o7-machinehum/Blackpants/README.md

# Blackpants
The Blackpants are a carrier board for the [Flipper Blackhat](https://github.com/o7-machinehum/flipper-blackhat). They remove the need for the Flipper Zero itself. This repository was forked from the WHY2025 badge.
