o7-machinehum/Blackpants/docs/a523/A523_hwref/原理图/开发板资料/开发板用户指南/A523_EVB开发板用户指南_V1.0.pdf

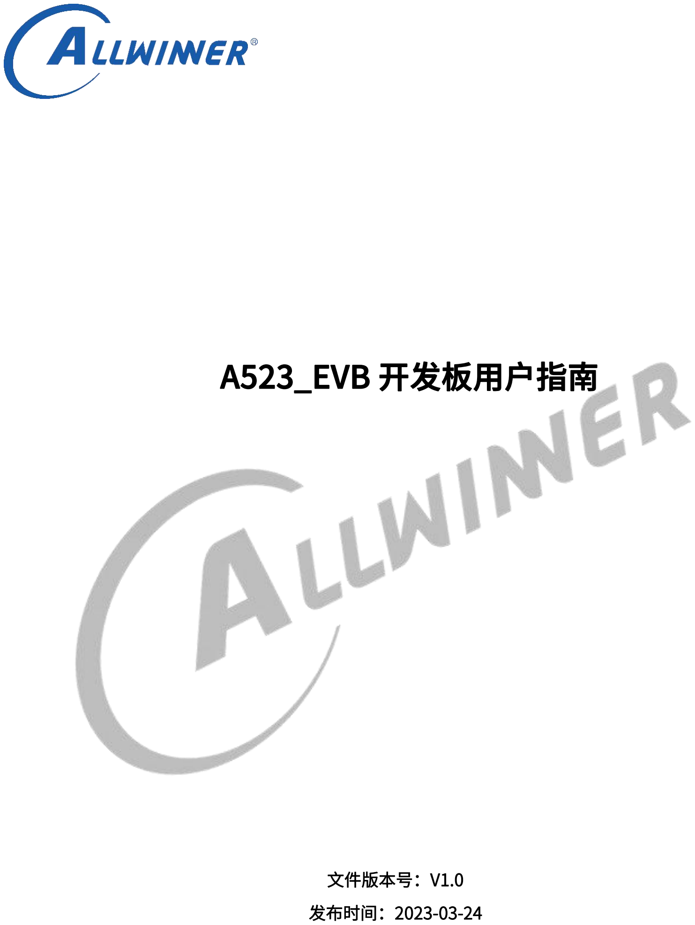
[picture p198: page 1]

# A523_EVB 开发板用户指南

文件版本号：V1.0
发布时间：2023-03-24

文档密级：秘密


版权所有©珠海全志科技股份有限公司。保留一切权利 | i

# 版本历史

版本 | 日期 | 责任人 | 版本描述
1.0 | 2023.3.24 | AW2062 | INIT

密级：秘密

全志科技版权所有，侵权必究
Copyright © 2023 by Allwinner. All rights reserved | Page ii of 42

目录

Copyright © 2023 by Allwinner. All rights reserved | Page iii of 42

Copyright © 2023 by Allwinner. All rights reserved | Page iv of 42

# 图片目录

图 3-1 A523_EVB 开发板功能框图 | 10
图 3-2 A523_EVB 电源拓扑结构 | 11
图 3-3 A523_EVB 正反面接口结构图 | 11
图 4-1 5VDC 电源接口 | 18
图 4-2 5V USB 电源接口 | 18
图 4-3 A55 debug 串口接口线序 | 18
图 4-4 CPUS debug 串口接口线序 | 19
图 4-5 BOOT-SEL 启动选择 | 19
图 4-6 BOOT-SEL 电阻位置 | 20
图 4-7 PhonenixSutit 工具 | 20
图 4-8 uboot 按键和 usb | 21
图 4-9 PhoneixCard 工具 | 22
图 4-10 PhoneixCard 工具制作卡量产 | 22
图 4-11 TF 卡接口 | 23
图 4-12 卡量产烧录打印 | 23
图 4-13 flash 接口 | 23
图 4-14 FLASH 接口原理图图示 | 24
图 4-15 FLASH IO 电平更改 | 25
图 4-16 mipi-CSI 接座 | 26
图 4-17 全志 IMX386 摄像头子板接线图 | 26
图 4-18 摄像头子板电源硬件配置 | 27
图 4-19 IMX319 摄像头模组接线图 | 28
图 4-20 S5K5E8YX 摄像头模组接线图 | 29
图 4-21 JV1 接座原理图图示 | 29
图 4-22 JV6 接座原理图图示 | 29
图 4-23 MIPI-DSI 原理图图示 | 31
图 4-24 配套 LCD 屏与开发板接线图 | 31
图 4-25 CTP 原理图图示 | 32
图 4-26 RGB 屏接口 | 32
图 4-27 RGB 接口原理图图示 | 31

Copyright © 2023 by Allwinner. All rights reserved | Page v of 42

Copyright © 2023 by Allwinner. All rights reserved | Page vi of 42

# 图表目录

Copyright © 2023 by Allwinner. All rights reserved | Page vii of 42

# 表格目录

Copyright © 2023 by Allwinner. All rights reserved | Page 8 of 42

# 1 前言

## 1.1 文档简介

本文档主要用于介绍 A523 开发板的硬件结构特点以及接口说明，方便使用者快速了解和入门使用开发板。

## 1.2 目标读者

本文档主要适用于:
- 硬件设计工程师
- 软件设计工程师
- 技术支持工程师

## 1.3 适用范围

软硬件系统设计领域、产品方案设计领域。

## 1.4 文档约定

标志说明
本文档采用各种醒目的标志来表示在操作过程中应该特别注意的地方，这些标志的含义如下：
标识 | 说明
注意 | 提醒操作中应注意的事项。不当的操作可能会损坏器件，影响可靠性、降低性能等。
说明 | 为准确理解文中指令、正确实施操作而提供的补充或强调信息。

Copyright © 2023 by Allwinner. All rights reserved | Page 9 of 42

# 2 概述

### 2.1 简介

A523 开发板是全志科技专门针对 A523 系列多核处理器芯片开发的演示板，用于给客户展示 A523 强大的多 媒体功能和智能视频处理能力，A523 开发板提供了丰富的接口，客户前期亦可以在 A523 开发板上做前期软件 开发工作。A523 开发板同时为客户硬件设计提供参考，客户只需要对 A523 开发板电路进行增减即可完成硬件 设计。

## 2.2 交付清单

A523 开发板硬件基础交付清单包括：
✓ A523 EVB 单板：A523_EVB_AXP717C_LPDDR4_4X_V2_0
✓ 电源：输入 100V~240V AC，输出 5V，2A，DC 或 Type-C 适配器 ✓ 摄像头子板：V5 CARMERA CONVERT BOARD-V163、EF5046FA-V1.0 ✓ 显示屏模组（不带触摸）：SQ101D-LCD 显示屏模组

## 2.3 其他组件

以下组件不包括在 A523 开发板硬件交付包中,但是客户在调试过程中可能会用到,例如: ✓ 网线
✓ 串口线
✓ 音视频输出线材
✓ SD 卡

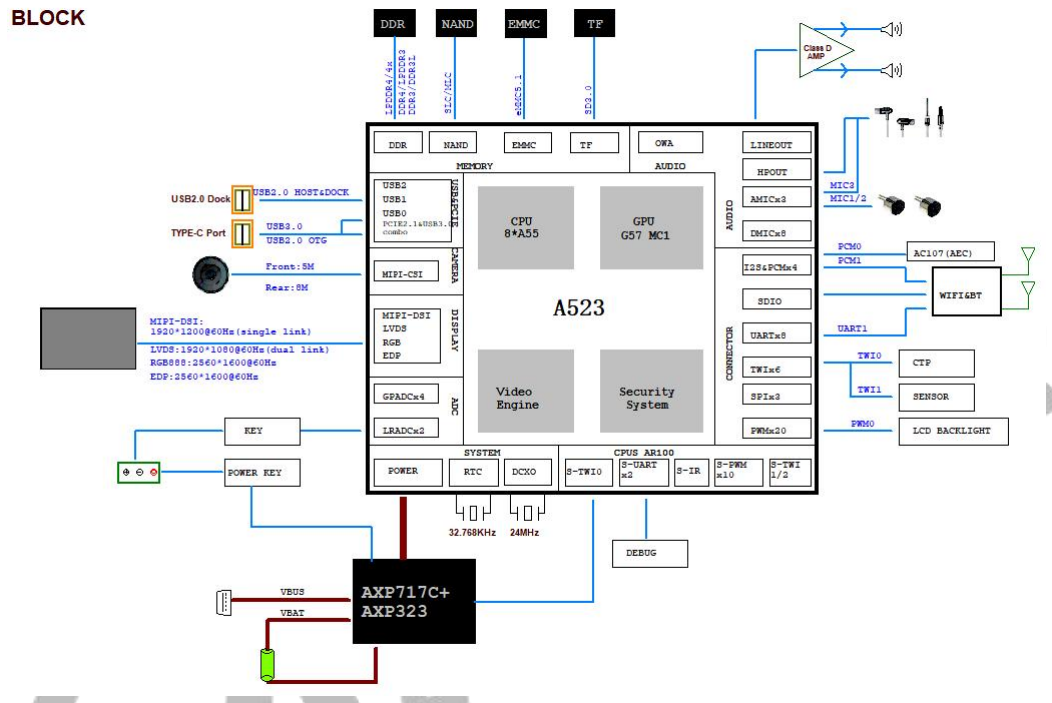
[picture p199: figure]

Copyright © 2023 by Allwinner. All rights reserved | Page 10 of 42

# 3 A523_EVB 开发板硬件介绍

## 3.1 功能框图

A523_EVB 开发板功能框图如图 3-1 所示：
图 3-1 A523_EVB 开发板功能框图

## 3.2 电源拓扑结构

A523_EVB 电源拓扑结构如图 3-2 所示：

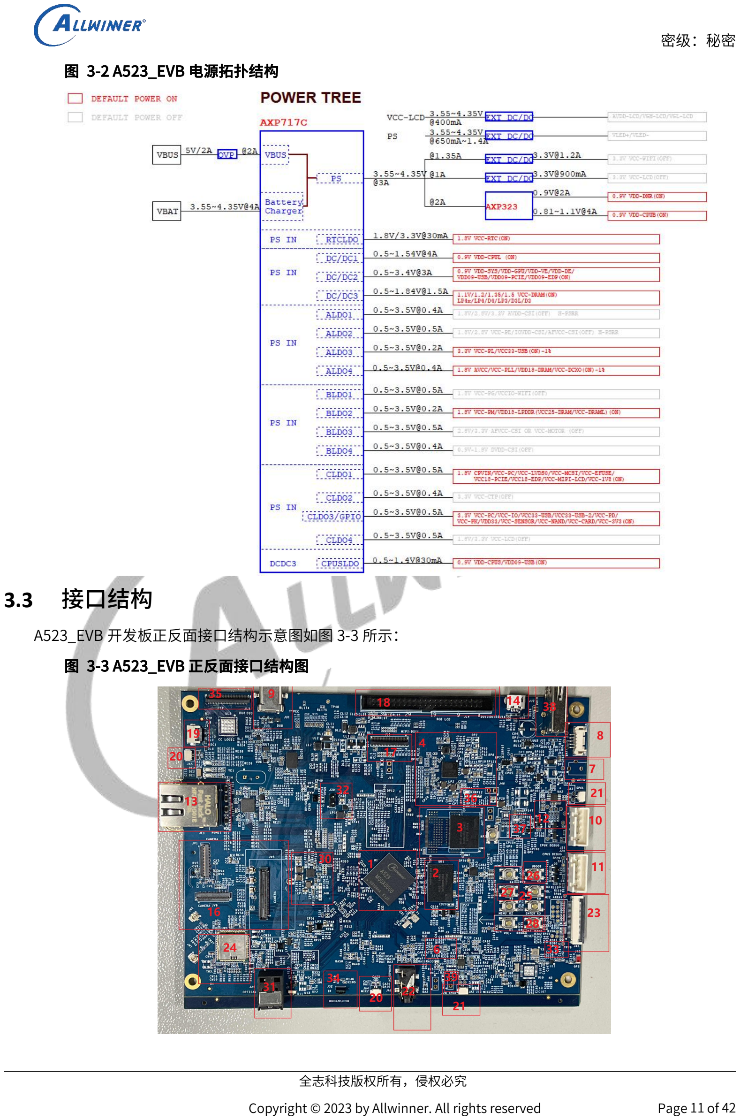
[picture p200: page 12]

Copyright © 2023 by Allwinner. All rights reserved | Page 11 of 42

图 3-2 A523_EVB 电源拓扑结构

## 3.3 接口结构

A523_EVB 开发板正反面接口结构示意图如图 3-3 所示： 图 3-3 A523_EVB 正反面接口结构图

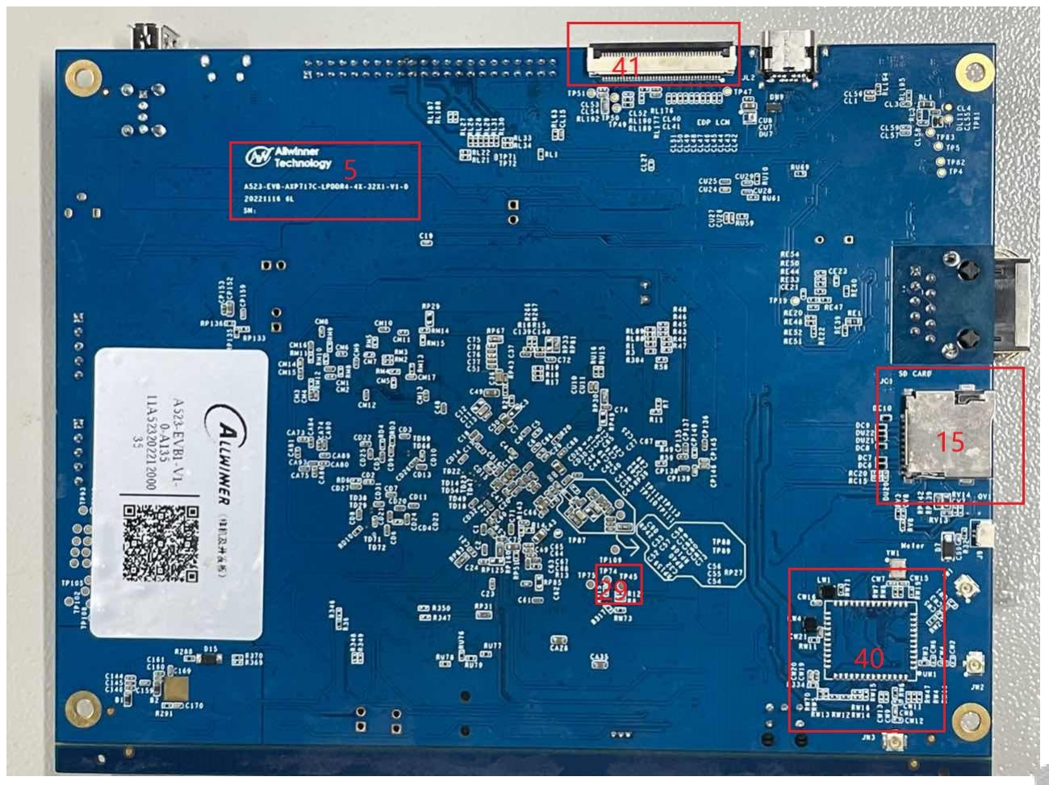
[picture p201: figure]

Copyright © 2023 by Allwinner. All rights reserved | Page 12 of 42

开发板上各接口功能说明如表 3-1 所示：
表格 3-1 A523_EVB 各接口功能说明表
编号 | 说明
1 | SOC 主控 A523 芯片
2 | 16 位 DDR3 颗粒，默认贴 4Gb DDR3
3 | Flash 颗粒，默认贴 GD 256bit SPI NOR
4 | PMU 717C 电源供电区域
5 | 开发板型号丝印以及板编号
6 | G-SENSOR 模块，默认型号 ICM-42670-P
7 | 5V DC 电源接口
8 | 电池接口
9 | TYPE-C 接口，同时可作为 5V 供电接口
10 | UART0，A55 CPUX 调试接口
11 | CPUS 调试接口
12 | JTAG 接口触点(PB 口)
13 | 网口

Copyright © 2023 by Allwinner. All rights reserved | Page 13 of 42
14 | Micro USB 接口
15 | TF 卡接口
16 | MIPI CSI sensor 接口
17 | MIPI DSI LCD 接口
18 | RGB LCD 接口
19 | CTP 接口
20 | 双 MIC
21 | 喇叭接口
22 | LINE-IN 接口
23 | TWI2、CPUS-JTAG、LRADC、DMIC 接口
24 | WIFI 模块(AW869A)
25 | GPADC0 功能按键
26 | UBOOT（FEL）烧录按键
27 | PWRON 按键
28 | RESET 按键
29 | GPADC0~3 接口
30 | AXP323 电源供电区域
31 | OWA 接口
32 | JTAG-SEL 接口
33 | GND 测试接口
34 | IR 接口
35 | 触屏接口
36 | 电源指示灯
37 | 快充指示灯
38 | USBA 接口

## 3.4 GPIO 分配

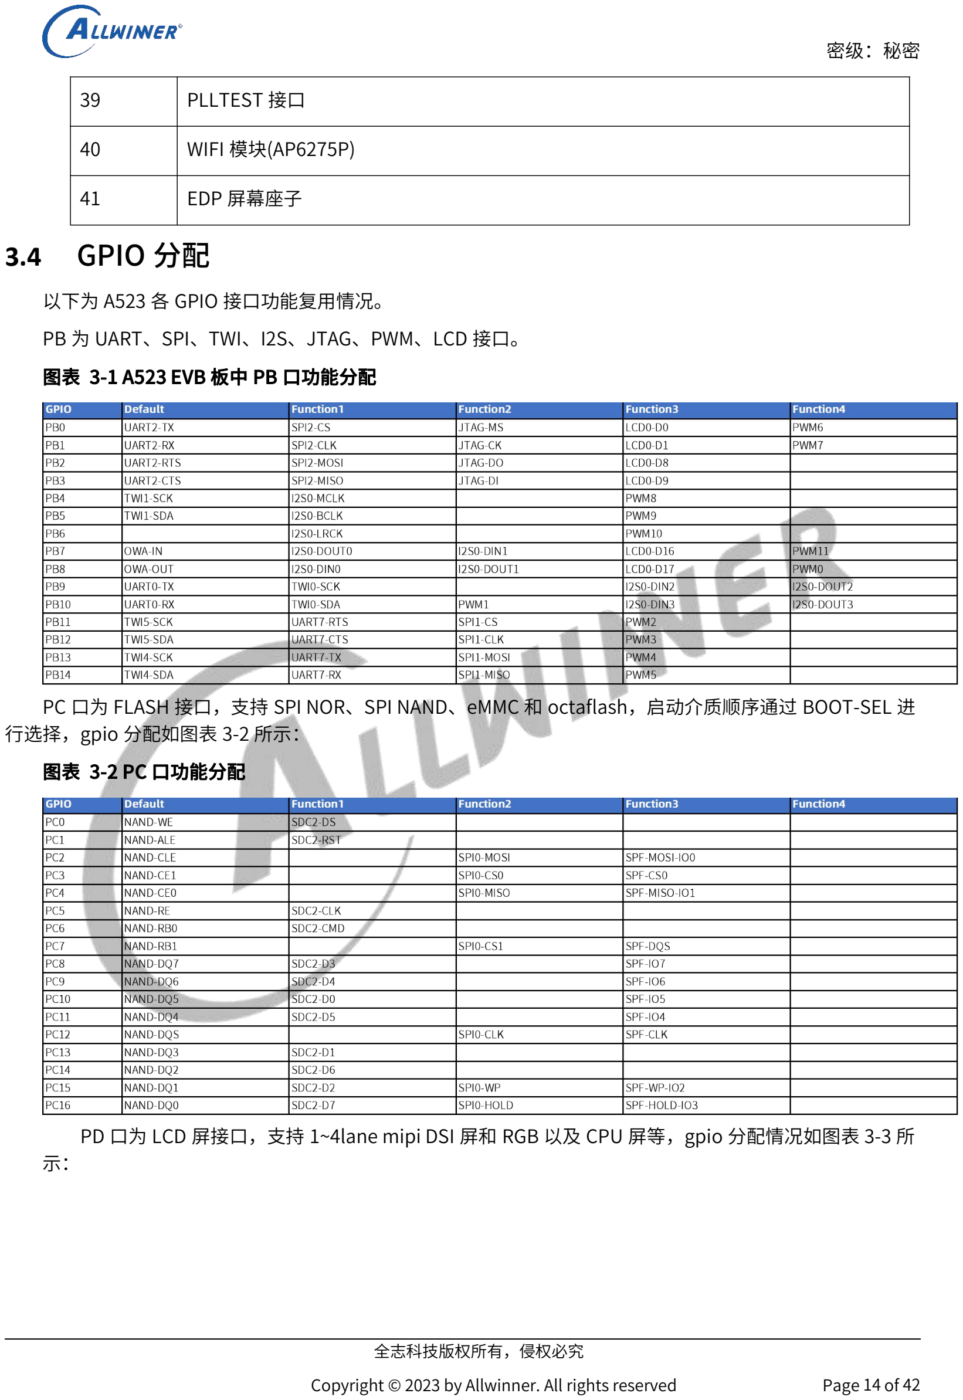
[picture p202: page 15]

Copyright © 2023 by Allwinner. All rights reserved | Page 14 of 42
39 | PLLTEST 接口
40 | WIFI 模块(AP6275P)
41 | EDP 屏幕座子

以下为 A523 各 GPIO 接口功能复用情况。
PB 为 UART、SPI、TWI、I2S、JTAG、PWM、LCD 接口。 图表 3-1 A523 EVB 板中 PB 口功能分配

PC 口为 FLASH 接口，支持 SPI NOR、SPI NAND、eMMC 和 octaflash，启动介质顺序通过 BOOT-SEL 进 行选择，gpio 分配如图表 3-2 所示：
图表 3-2 PC 口功能分配

PD 口为 LCD 屏接口，支持 1~4lane mipi DSI 屏和 RGB 以及 CPU 屏等，gpio 分配情况如图表 3-3 所 示：

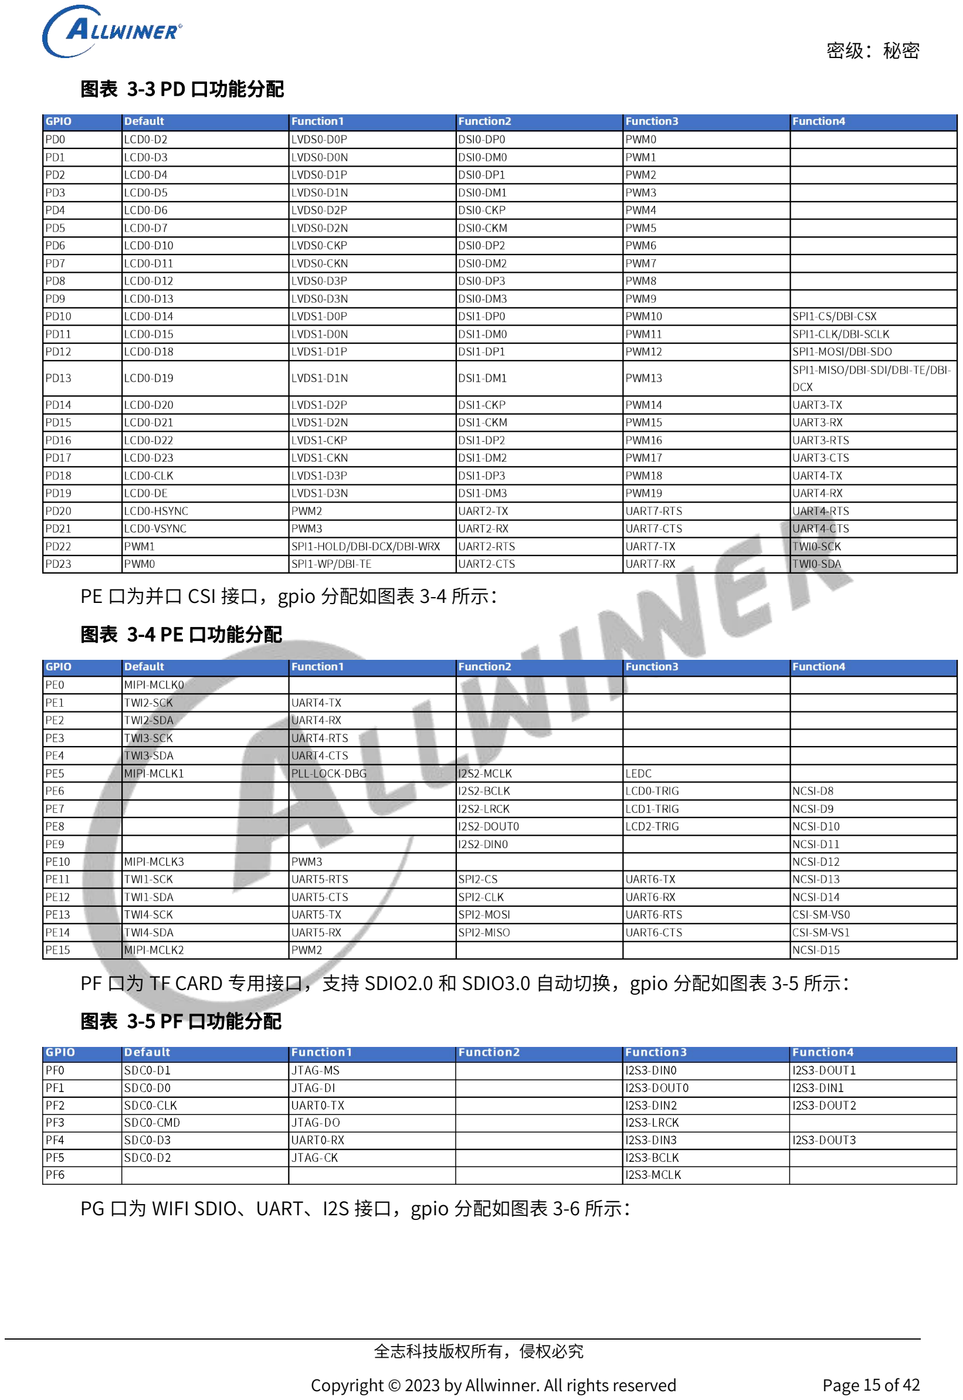
[picture p203: page 16]

Copyright © 2023 by Allwinner. All rights reserved | Page 15 of 42

图表 3-3 PD 口功能分配

PE 口为并口 CSI 接口，gpio 分配如图表 3-4 所示： 图表 3-4 PE 口功能分配

PF 口为 TF CARD 专用接口，支持 SDIO2.0 和 SDIO3.0 自动切换，gpio 分配如图表 3-5 所示： 图表 3-5 PF 口功能分配

PG 口为 WIFI SDIO、UART、I2S 接口，gpio 分配如图表 3-6 所示：

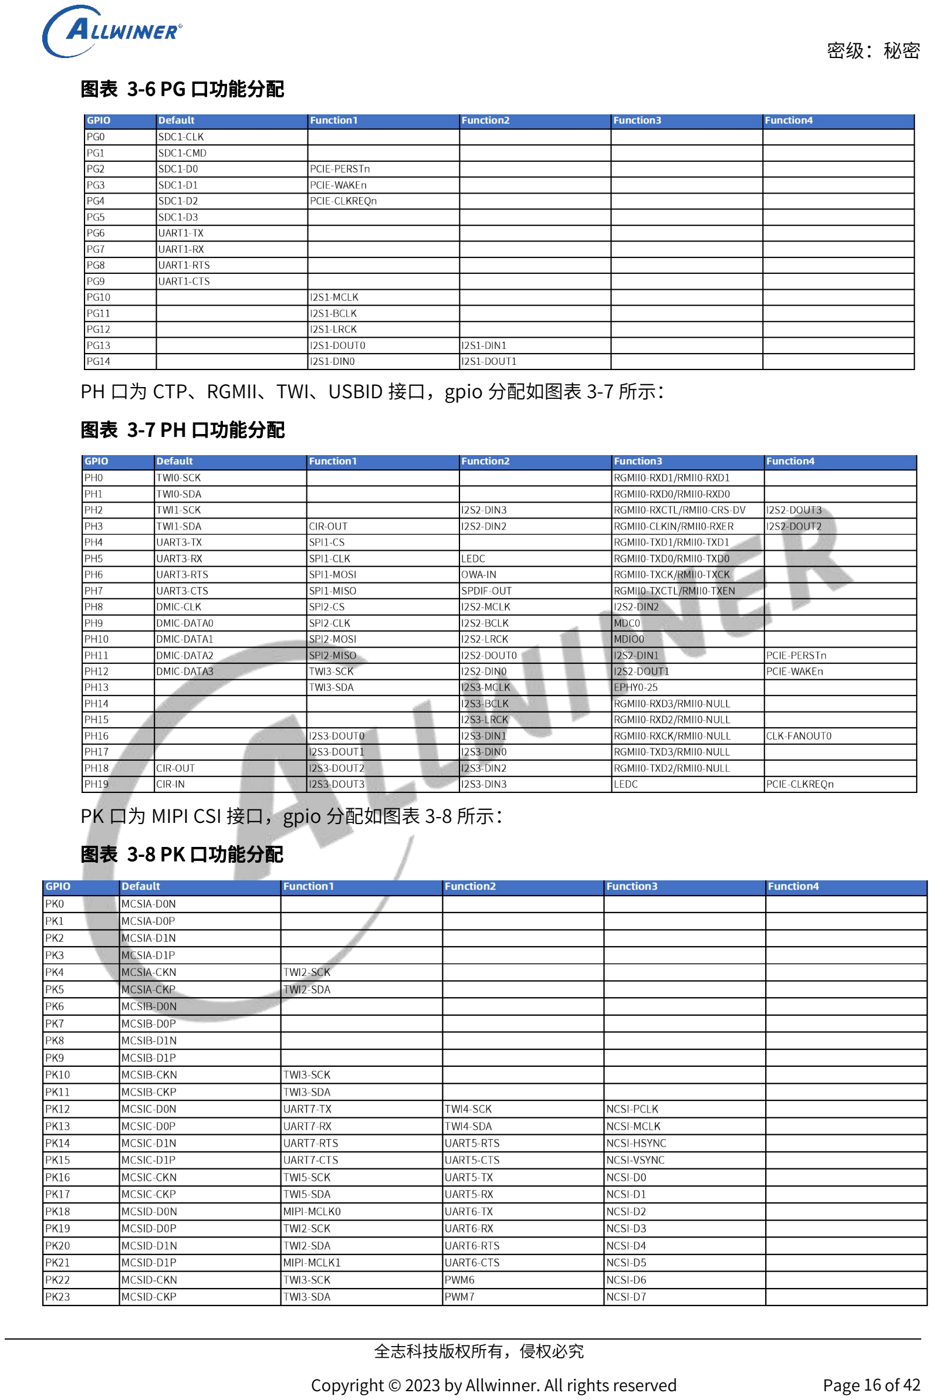
[picture p204: page 17]

Copyright © 2023 by Allwinner. All rights reserved | Page 16 of 42

图表 3-6 PG 口功能分配

PH 口为 CTP、RGMII、TWI、USBID 接口，gpio 分配如图表 3-7 所示： 图表 3-7 PH 口功能分配

PK 口为 MIPI CSI 接口，gpio 分配如图表 3-8 所示： 图表 3-8 PK 口功能分配

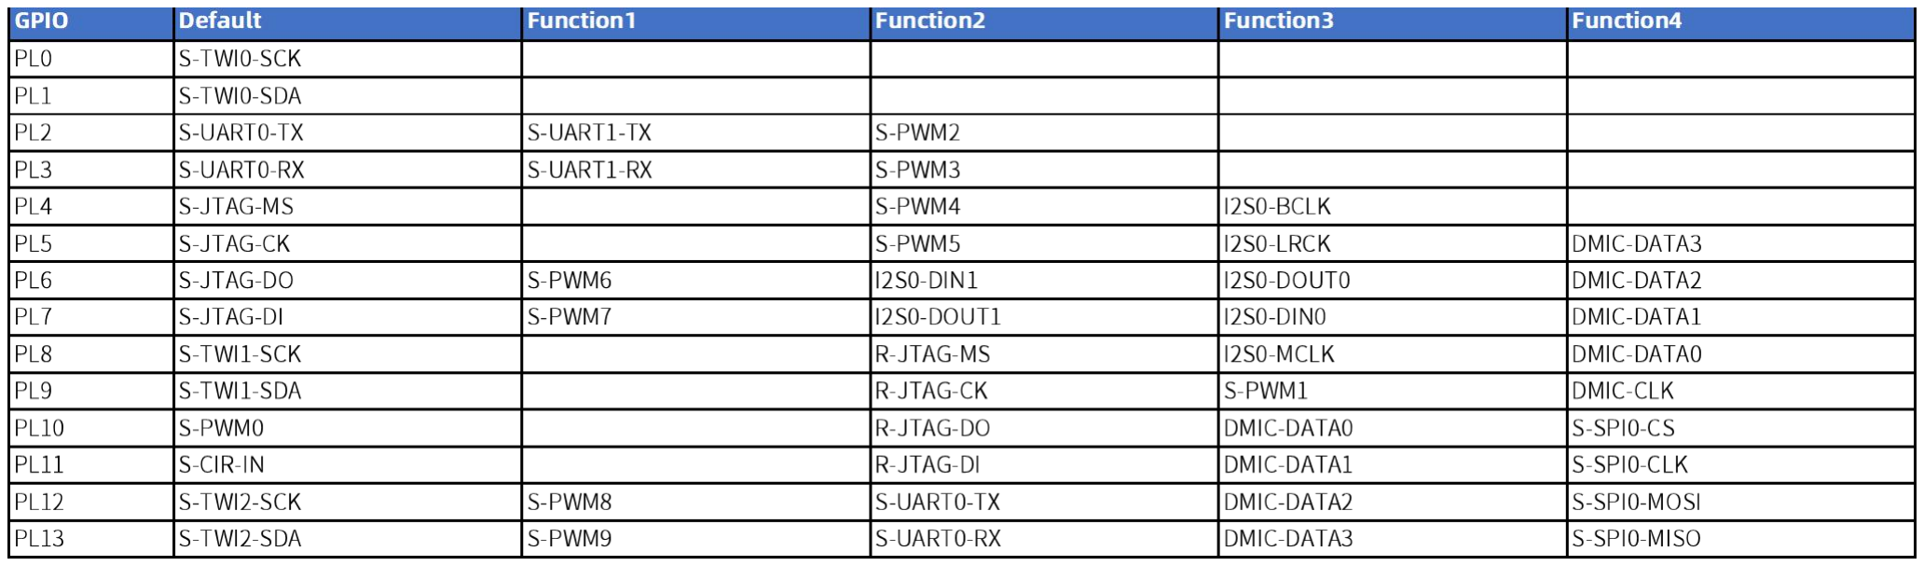
[picture p205: figure]
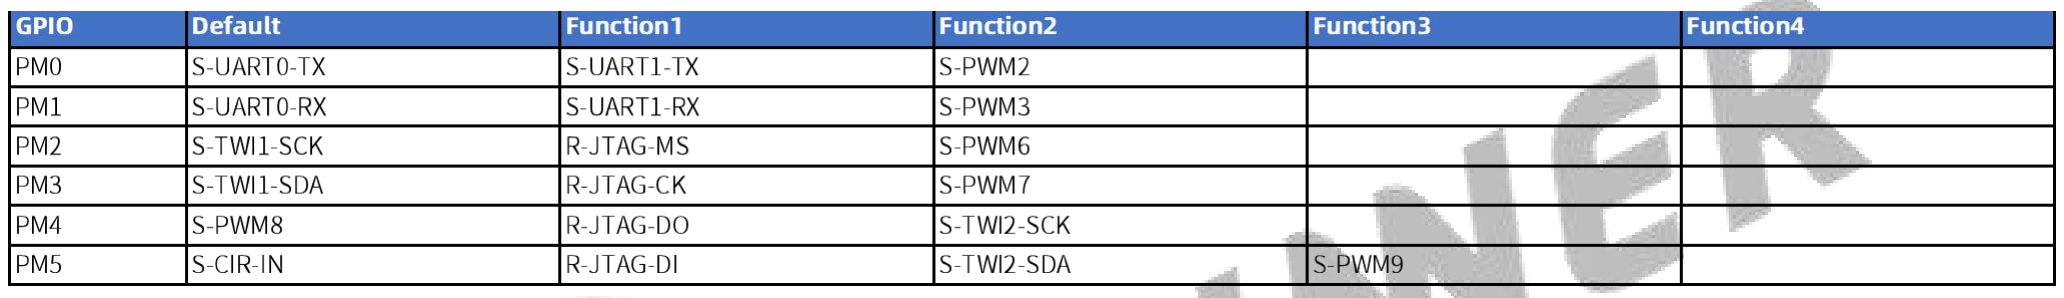
[picture p206: figure]

Copyright © 2023 by Allwinner. All rights reserved | Page 17 of 42

PL 口固定为 3.3V 的 IO 口，可作为外设 3.3V 接口需求，包括 RV 的 debug 接口都默认从 PL 口出，gpio 分配如图表 3-9 所示：
图表 3-9 PL 口功能分配

PM 口为 UART、PWM、中断接口，主要为用作外设唤醒接口，gpio 分配如图表 3-10 所示： 图表 3-10 PM 口功能分配

Copyright © 2023 by Allwinner. All rights reserved | Page 18 of 42

# 4 操作指南

### 4.1 上电

在 5V DC 接口上接 5V 直流电源或者在 5V USB 接口上接 5V 电源可上电开机，接口如图 4-1 和图 4-2 所示： 图 4-1 5VDC 电源接口

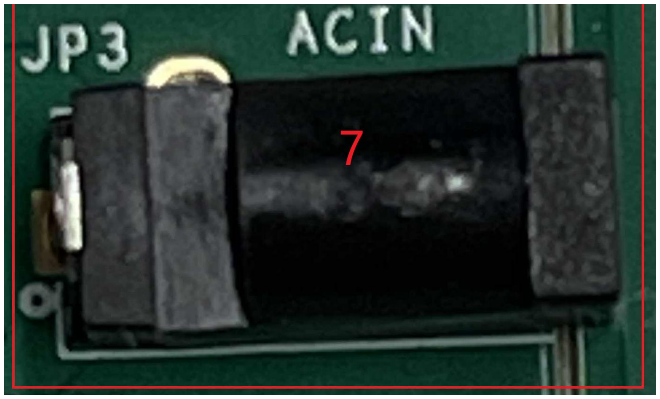
[picture p207: figure]
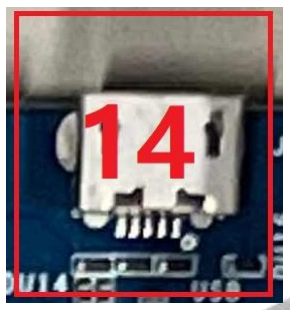
[picture p208: figure]

图 4-2 5V USB 电源接口

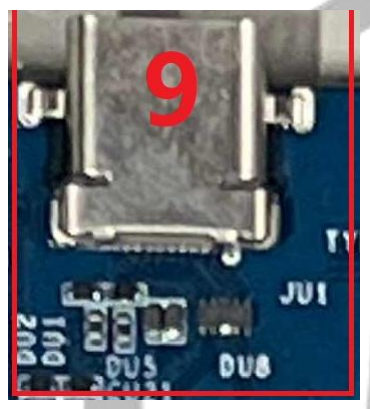
[picture p209: figure]

## 4.2 Debug 串口

UART0 为 A55 的默认 debug 串口，串口线直接接该座子即可，接口线序如图 4-3 所示：
图 4-3 A55 debug 串口接口线序

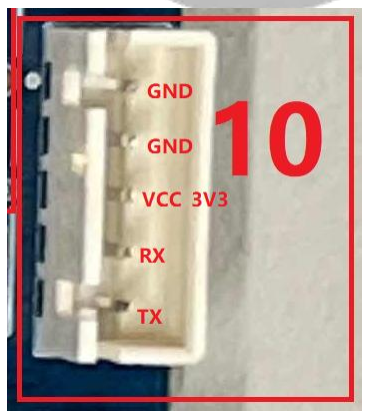
[picture p210: figure]

UART3 为 CPUS 的 debug 串口，接口线序如图 4-4 所示：

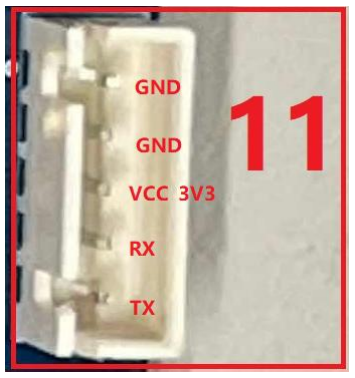
[picture p211: figure]
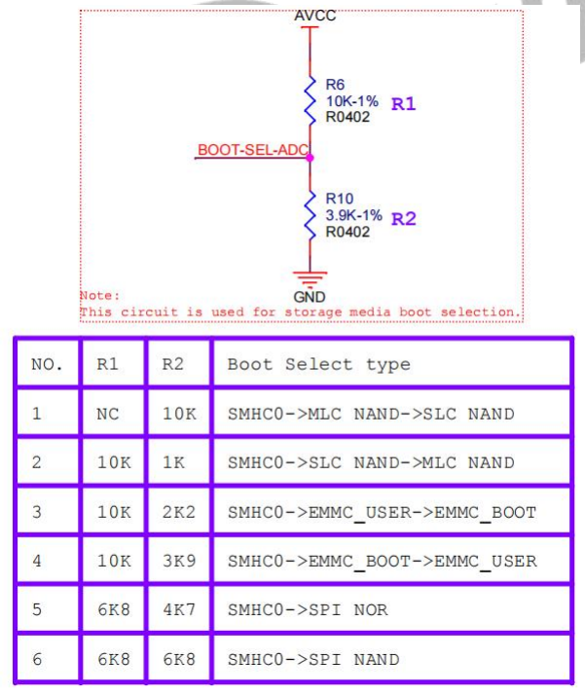
[picture p212: figure]

Copyright © 2023 by Allwinner. All rights reserved | Page 19 of 42

图 4-4 CPUS debug 串口接口线序

## 4.3 启动介质选择

全志开发板兼容 SPI NOR，SPI NAND，eMMC、flash 介质，但不可同时使用，只可同时贴片使用一种 flash 介质。
开发板启动除了以上 flash 介质外也支持通过 SDC0 接口启动即 TF 卡启动，启动介质顺序通过硬件 BOOT-SEL 接口可选择，如图 4-5 所示：
图 4-5 BOOT-SEL 启动选择

对应开发板默认贴第四组参数。

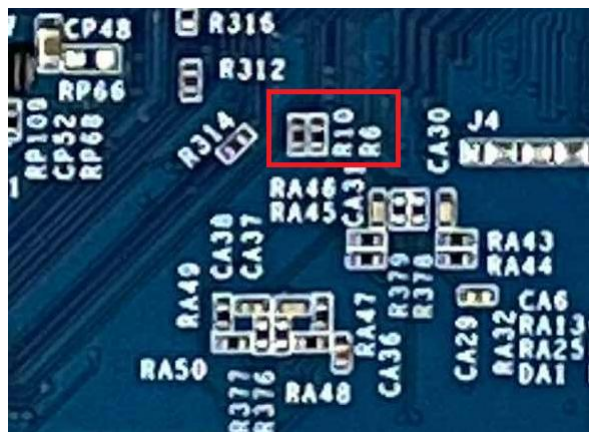
[picture p213: figure]
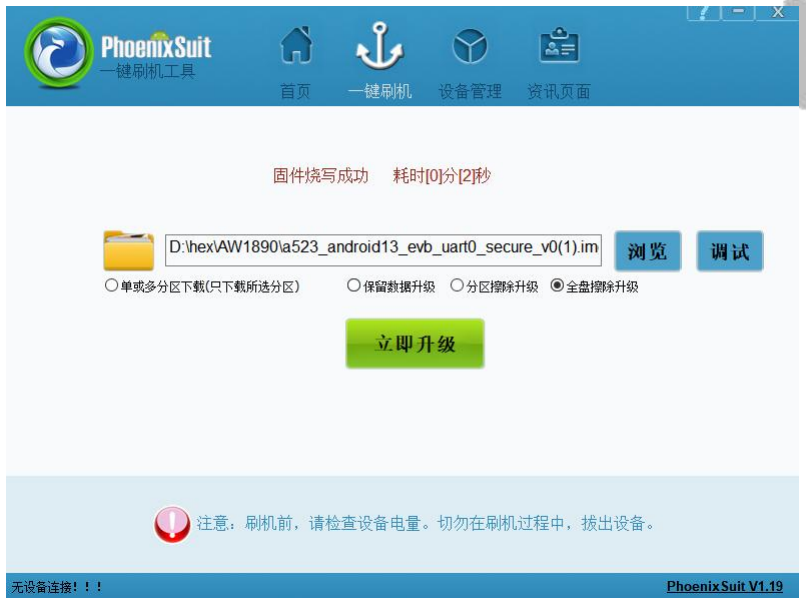
[picture p214: figure]

Copyright © 2023 by Allwinner. All rights reserved | Page 20 of 42

图 4-6 BOOT-SEL 电阻位置

### 4.4 烧录

全志开发板可支持两种软件烧录方式，分别是 usb 烧录和卡量产烧录。

### 4.4.1 USB 烧录

USB 烧录采用全志发布的 PhoenixSuit 工具作为 USB 烧写工具，如图 4-7 所示：
图 4-7 PhonenixSutit 工具

打开软件后选择一键刷机，点击浏览选择对应要烧写的 img 固件。
接着先断开开发板电源，按下 26：UBOOT 按键不要放开，然后使用 miniusb 口的 usb 线接到 14：usb 口 上，并接到电脑 usb 口上，直到电脑工具界面出现进度条后可放开 uboot 按键，等待进度条结束即可烧写成功， 烧写过程中可接着串口查看烧写过程打印。

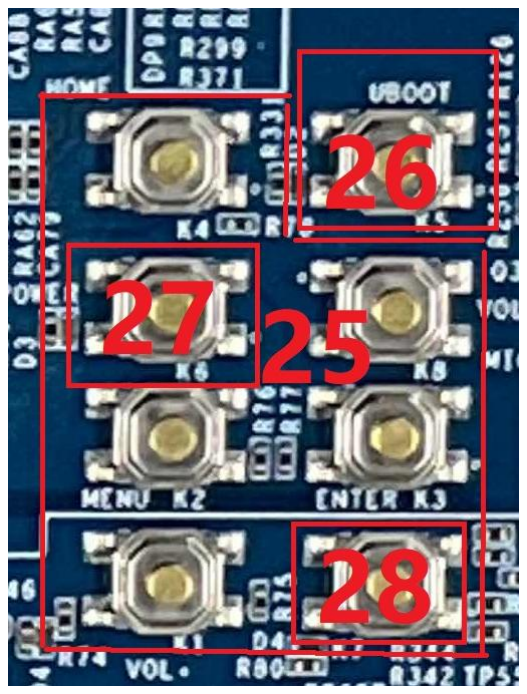
[picture p215: figure]

Copyright © 2023 by Allwinner. All rights reserved | Page 21 of 42

图 4-8 uboot 按键和 usb

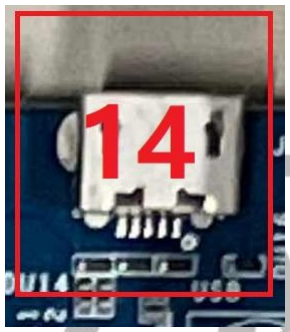
[picture p216: figure]

### 4.4.2 卡量产烧录

卡烧录需要使用全志发布的卡量产工具 PhoneixCard，如图 4-9 所示

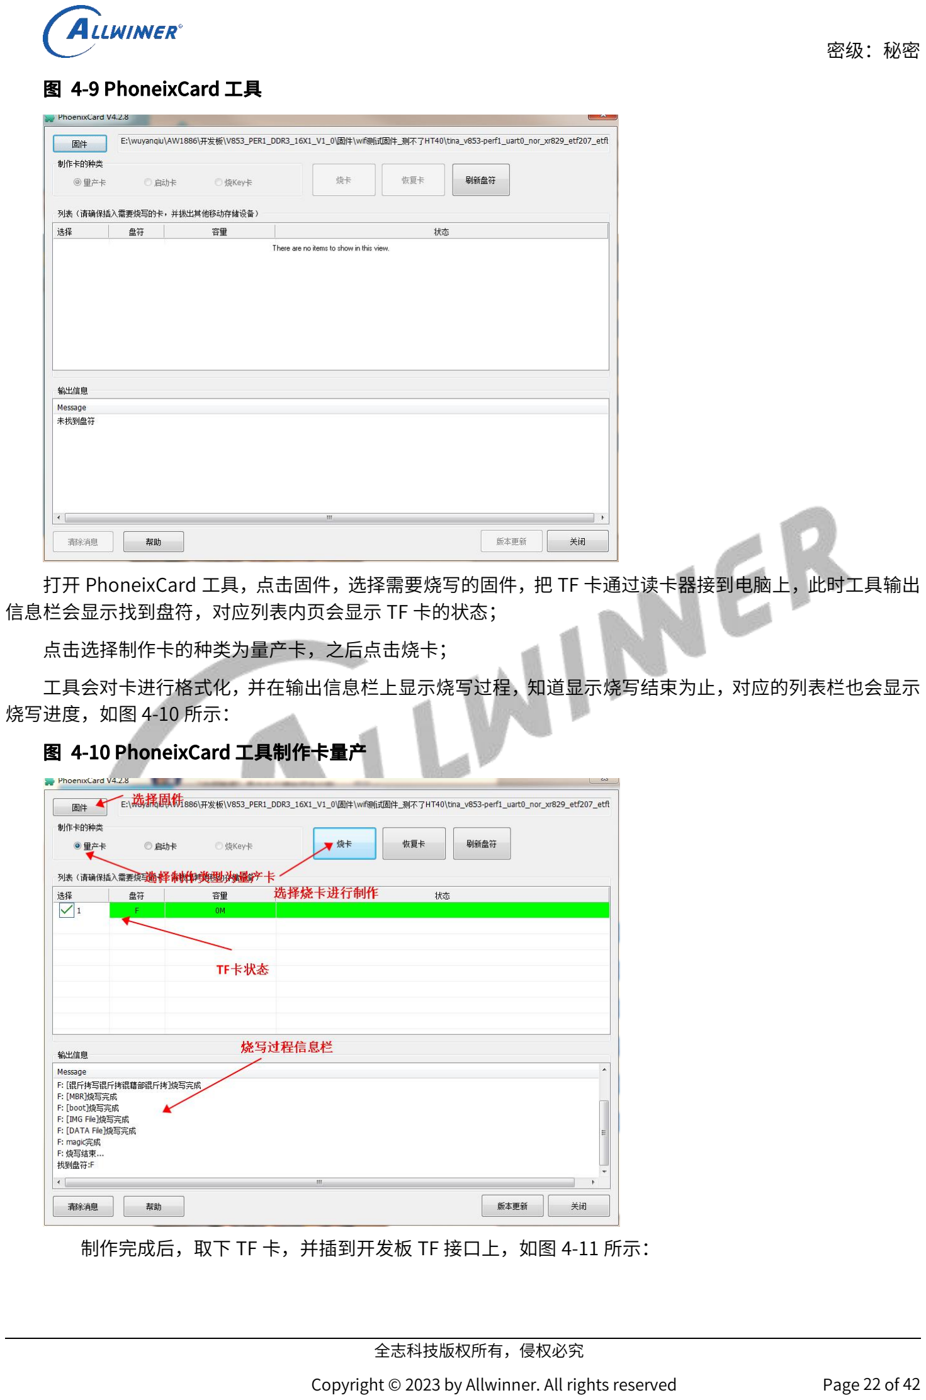
[picture p217: page 23]

Copyright © 2023 by Allwinner. All rights reserved | Page 22 of 42

图 4-9 PhoneixCard 工具

打开 PhoneixCard 工具，点击固件，选择需要烧写的固件，把 TF 卡通过读卡器接到电脑上，此时工具输出 信息栏会显示找到盘符，对应列表内页会显示 TF 卡的状态； 点击选择制作卡的种类为量产卡，之后点击烧卡；
工具会对卡进行格式化，并在输出信息栏上显示烧写过程，知道显示烧写结束为止，对应的列表栏也会显示 烧写进度，如图 4-10 所示：
图 4-10 PhoneixCard 工具制作卡量产

制作完成后，取下 TF 卡，并插到开发板 TF 接口上，如图 4-11 所示：

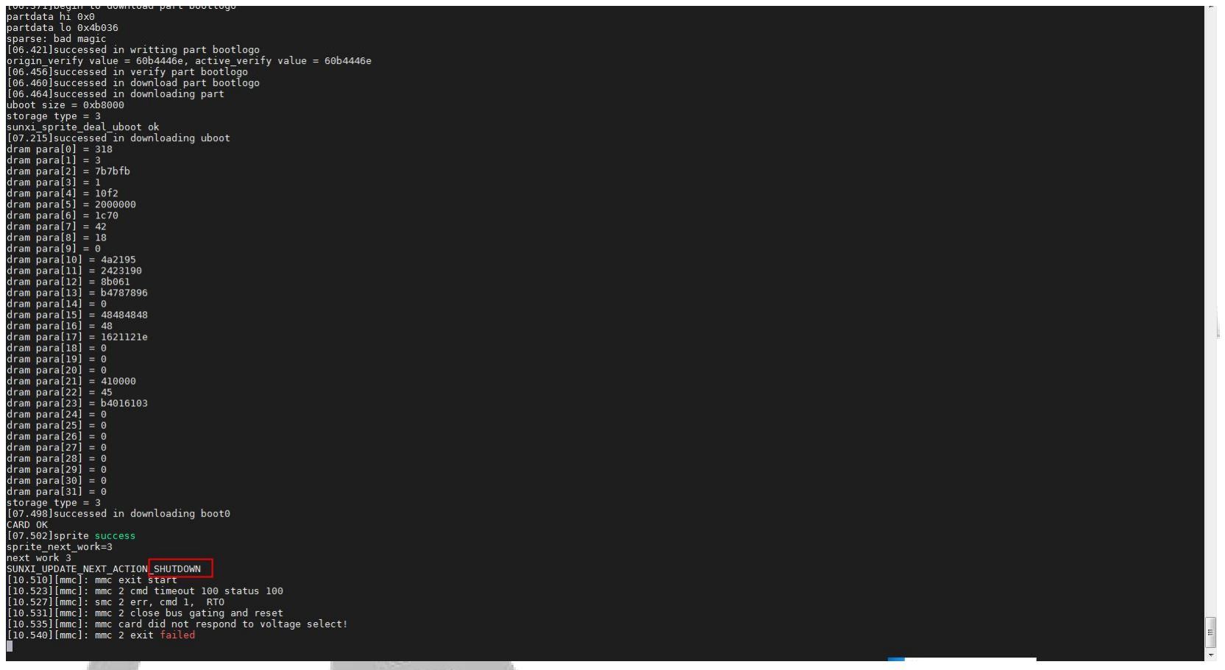
[picture p218: figure]
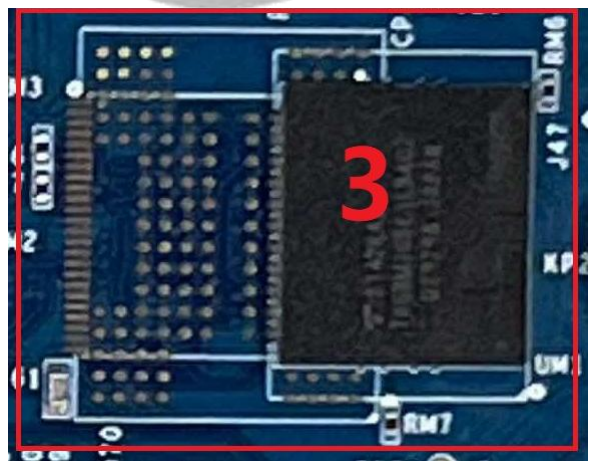
[picture p219: figure]

Copyright © 2023 by Allwinner. All rights reserved | Page 23 of 42

图 4-11 TF 卡接口

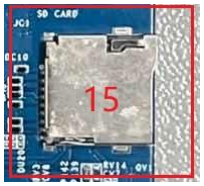
[picture p220: figure]

然后对开发板进行上电，通过开发板的串口，可以看到烧写过程，烧写结束后，串口会有打印 SHUTDOWN 等关机字样，表示已经烧写完成并关机，如图 4-12 所示：
图 4-12 卡量产烧录打印

此时软件固件已经烧写到开发板的 flash 中了，断开电源，并拔除 TF 卡，然后重新上电即可正常开机。

## 4.5 FLASH 接口使用说明

全志开发板 FLASH 接口可以支持三种 flash 类型，分别是 SPI FLASH、eMMC、actaflash 等三种封装形式 的 flash，对应开发板位置如图 3-13 所示：
图 4-13 flash 接口

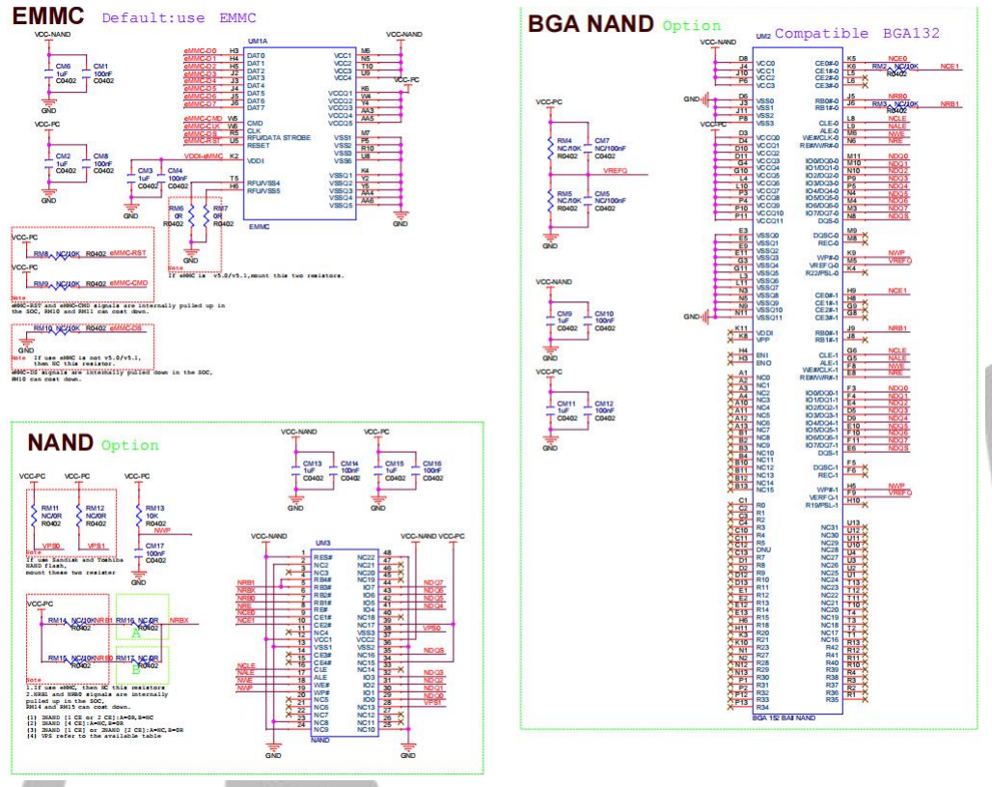
[picture p221: figure]

Copyright © 2023 by Allwinner. All rights reserved | Page 24 of 42

开发板设计同时兼容，但注意不可能同时使用两种及以上的 flash，可根据需要，自行更换所需的 flash 介 质进行开发调试，如图 4-14 所示为开发板 flash 电路设计，值得注意的是使用 eMMC 时，IO 电平会影响 eMMC 速率，50M 速率 IO 电平可 3.3V 和 1.8V，50M 以上速率 IO 电平需固定为 1.8V，开发板上为兼容 SPI FLASH 物 料，默认 IO 电平为 3.3V，因此有 50M 以上速率的 eMMC 验证需求需要更改 VCC-PC 的 IO 电平为 1.8V，如图 4-15 所示，RP13 电阻需移除，RP42 需上件。
图 4-14 FLASH 接口原理图图示

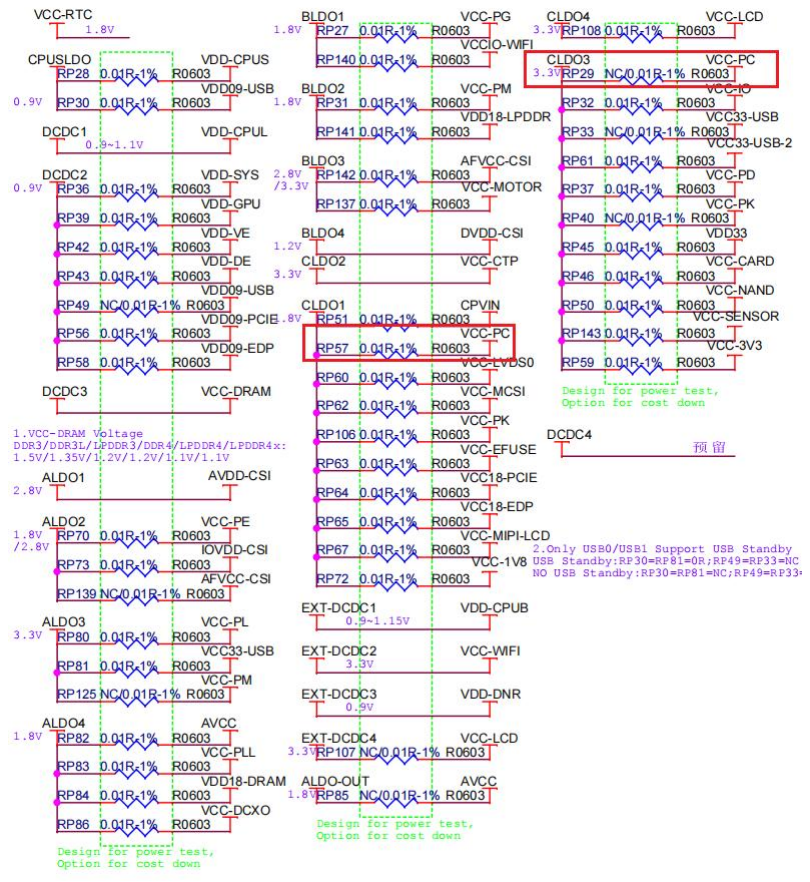
[picture p222: figure]
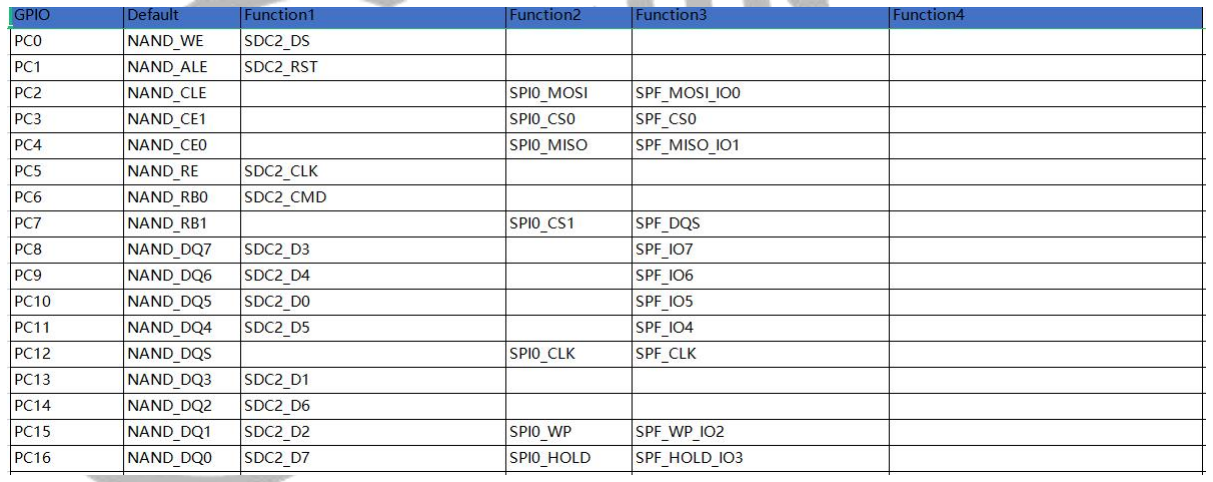
[picture p223: figure]

Copyright © 2023 by Allwinner. All rights reserved | Page 25 of 42

图 4-15 FLASH IO 电平更改

FLASH 接口 gpio 配置如图表 4-1 所示： 图表 4-1 FLASH 接口 gpio 配置

## 4.6 MIPI-CSI 接口使用

全志开发板 MIPI-CSI 接口预留有三个接座用以支持单个摄像头子板，单个摄像头模组和一路 2lane mipi 摄 像头和一路 4lane mipi 摄像头，对应开发板位置如图 4-16 所示：

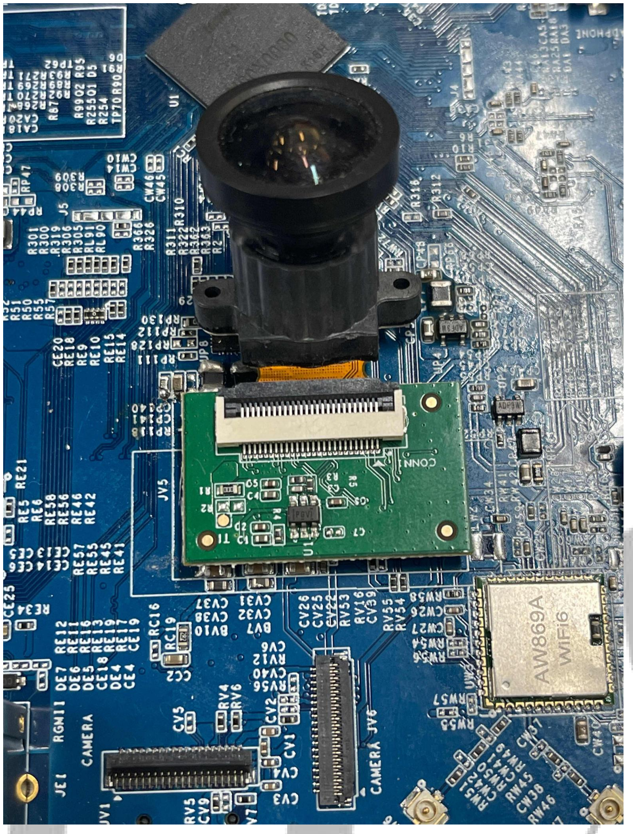
[picture p224: figure]

Copyright © 2023 by Allwinner. All rights reserved | Page 26 of 42

图 4-16 mipi-CSI 接座

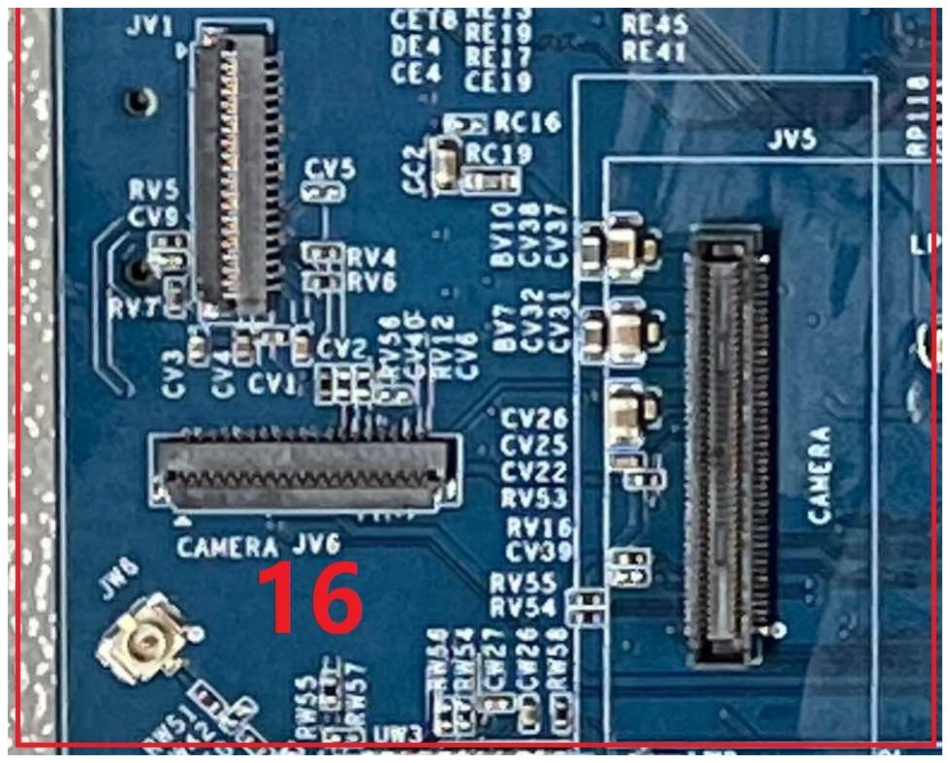
[picture p225: figure]

### 4.6.1 全志配套摄像头子板使用

全志开发板配套的 IMX386 摄像头通过子板与开发板通过连接器连接到 JV5 插座上，连接图如图 4-17 所示： 图 4-17 全志 IMX386 摄像头子板接线图

摄像头子板电源采用的是开发板上的电源供电，因此开发板上要保证 DVDD-CSI、AVDD-CSI、IOVDD-CSI 这三路供电正常，同时不要带电插拔，注意方向，如图 4-18 所示：

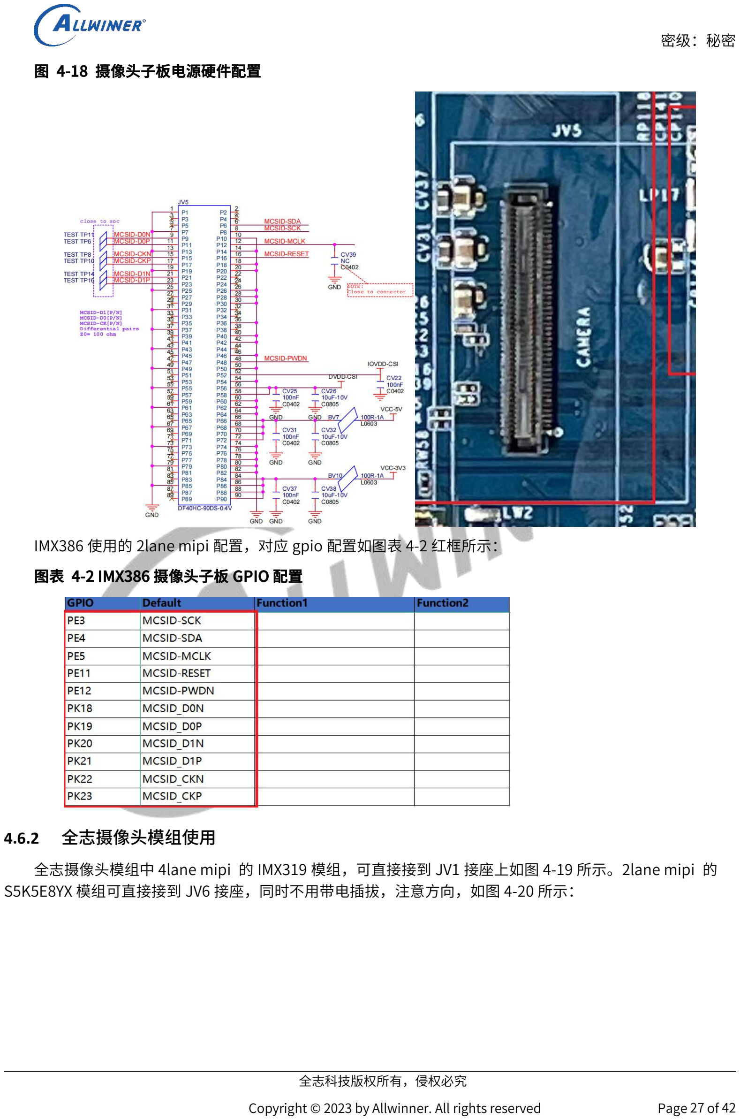
[picture p226: page 28]

Copyright © 2023 by Allwinner. All rights reserved | Page 27 of 42

图 4-18 摄像头子板电源硬件配置

IMX386 使用的 2lane mipi 配置，对应 gpio 配置如图表 4-2 红框所示： 图表 4-2 IMX386 摄像头子板 GPIO 配置

### 4.6.2 全志摄像头模组使用

全志摄像头模组中 4lane mipi 的 IMX319 模组，可直接接到 JV1 接座上如图 4-19 所示。2lane mipi 的 S5K5E8YX 模组可直接接到 JV6 接座，同时不用带电插拔，注意方向，如图 4-20 所示：

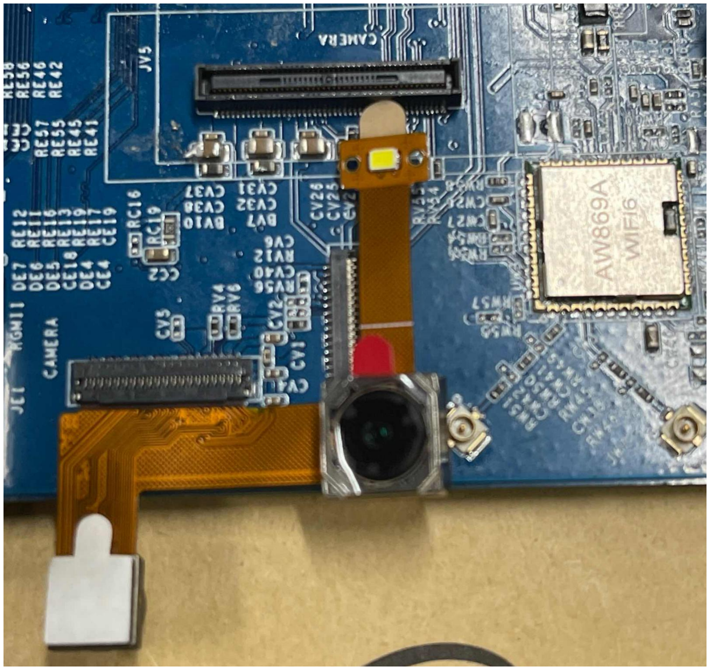
[picture p227: figure]
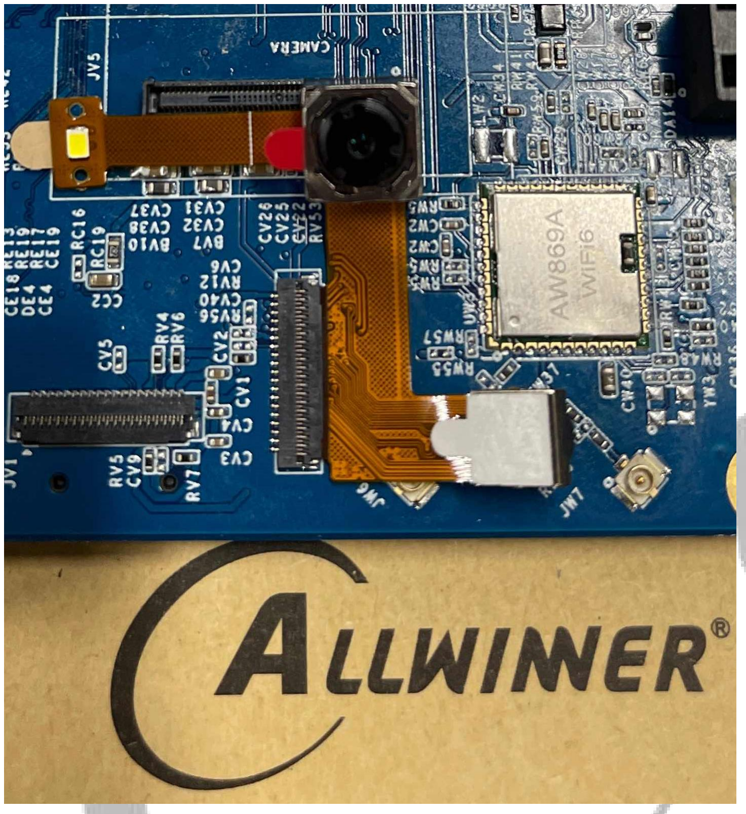
[picture p228: figure]

Copyright © 2023 by Allwinner. All rights reserved | Page 28 of 42

图 4-19 IMX319 摄像头模组接线图

图 4-20 S5K5E8YX 摄像头模组接线图

摄像头模组供电采用开发板上 DVDD-CSI、AVDD-CSI、IOVDD-CSI 供电，软件和硬件上需要保证这三路电 源供电正常，IMX319 摄像头对应接口原理图如图 4-21 所示，S5K5E8YX 摄像头对应接口原理图如图 4-22 所示：

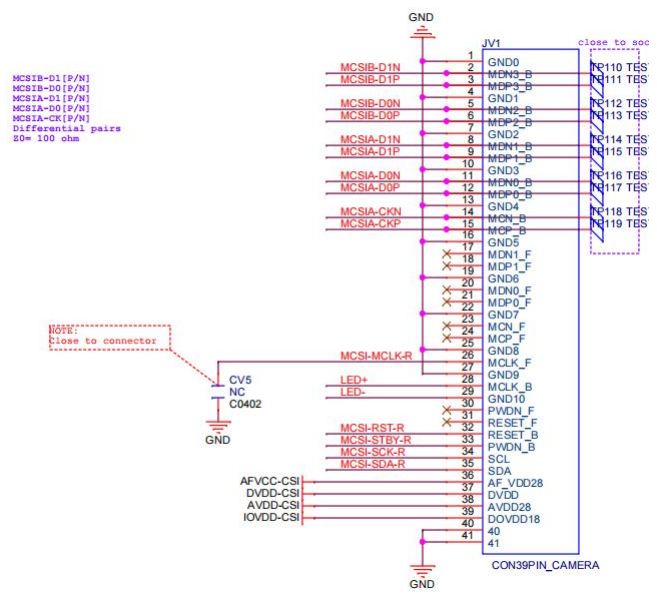
[picture p229: figure]
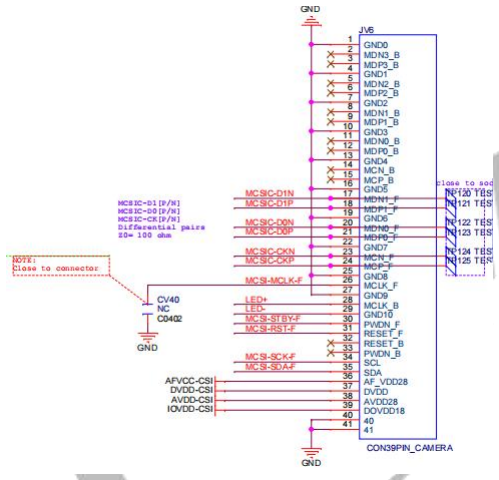
[picture p230: figure]

Copyright © 2023 by Allwinner. All rights reserved | Page 29 of 42

图 4-21 JV1 接座原理图图示

摄像头三路电源供电默认使用 PMU 供电，对应原理图位置如图 4-22 所示： 图 4-22 JV6 接座原理图图示

IMX319 摄像头模组对应 gpio 配置如图表 4-3 绿框所示，S5K5E8YX 摄像头模组如红框所示：

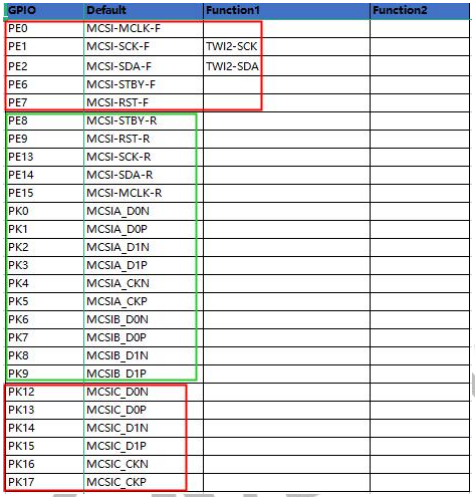
[picture p231: figure]

Copyright © 2023 by Allwinner. All rights reserved | Page 30 of 42

图表 4-3 摄像头模组 gpio 配置

## 4.7 LCD 接口使用

全志开发板 LCD 接口支持 MIPI-DSI 和 RGB 两种接口方式，开发板上默认配套使用的是 MIPI-DSI 屏。

### 4.7.1 MIPI-DSI 接口使用

如图 4-23 所示为开发板 MIPI-DSI 接口原理图，最大可支持 4lane MIPI DSI，但不支持 LVDS。

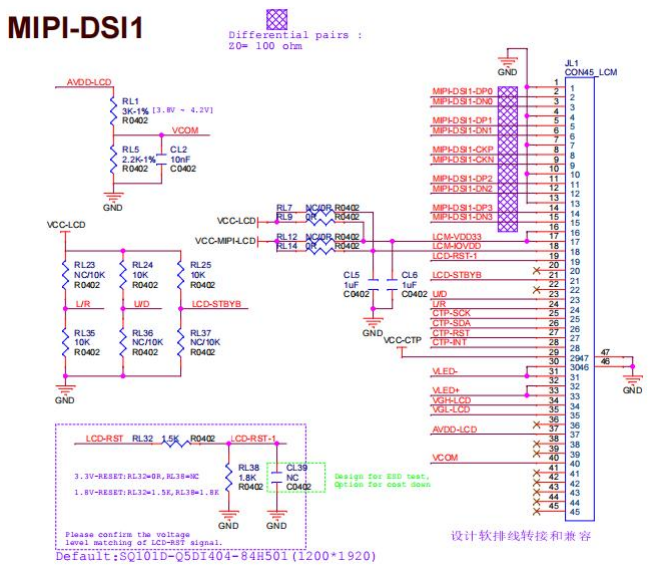
[picture p232: figure]
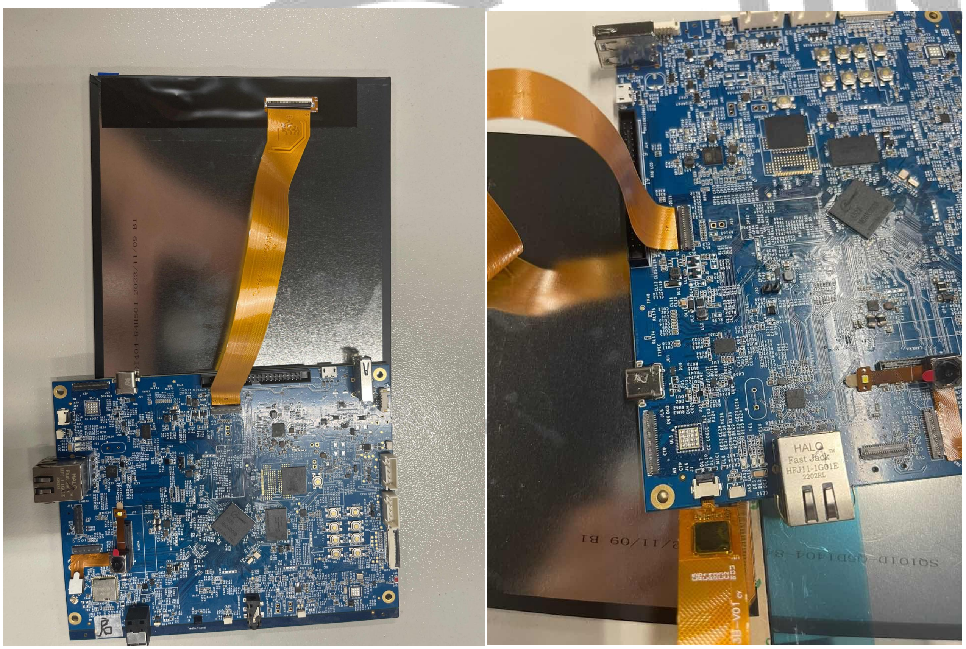
[picture p233: figure]

Copyright © 2023 by Allwinner. All rights reserved | Page 31 of 42

图 4-23 MIPI-DSI 原理图图示

全志开发板配套的屏为 4lane MIPI DSI 接口的屏幕，注意由于屏功耗较大，电脑 usb 口供电能力不足，容 易出现无法开机现象，因此使用该屏时需要使用外部适配器进行供电，与开发板的接线方式如图 4-24 所示，对 应触摸 CTP 部分原理图如图 4-25 所示，注意不要带电插拔，注意方向。
图 4-24 配套 LCD 屏与开发板接线图

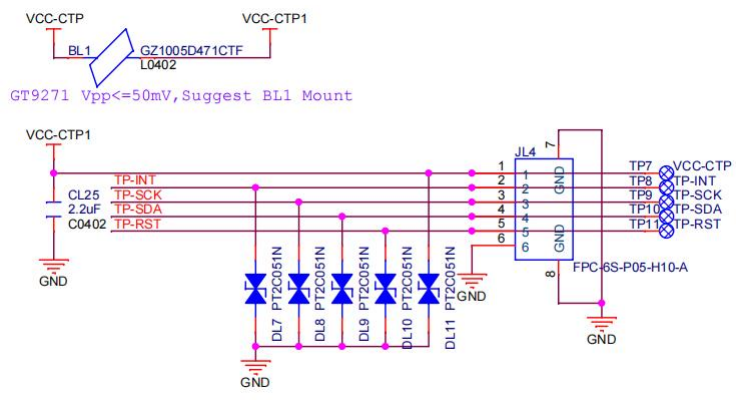
[picture p234: figure]
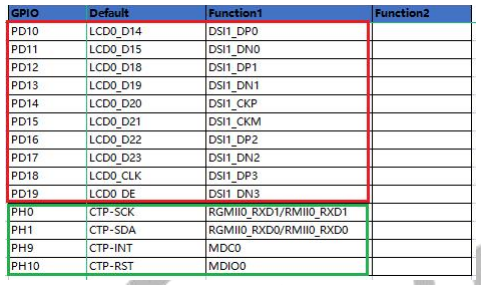
[picture p235: figure]
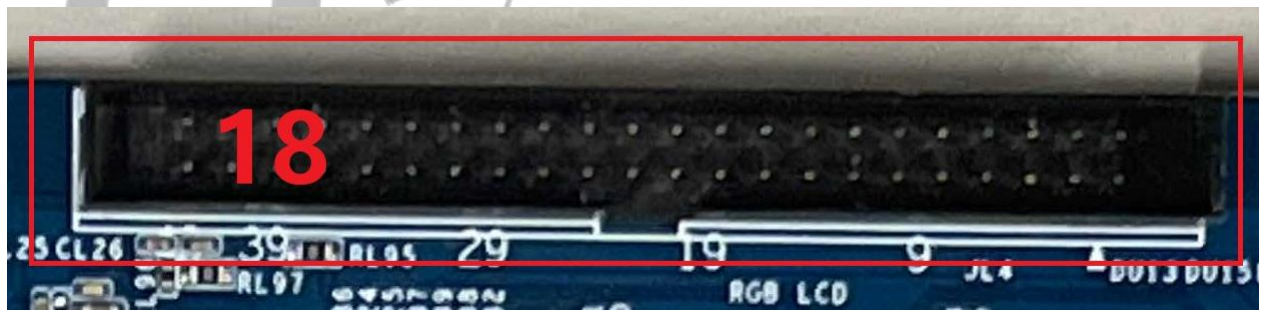
[picture p236: figure]

Copyright © 2023 by Allwinner. All rights reserved | Page 32 of 42

图 4-25 CTP 原理图图示

对应 gpio 配置如图表 4-4 红框所示：
图表 4-4 MIPI-DSI 和 CTP gpio 配置

### 4.7.2 RGB 接口使用

RGB 屏接口在开发板上通过 JL4 座子连接，注意不要带电插拔，注意方向。对应开发板位置如图 4-26 所示： 图 4-26 RGB 屏接口

对应原理图如图 4-27 所示：

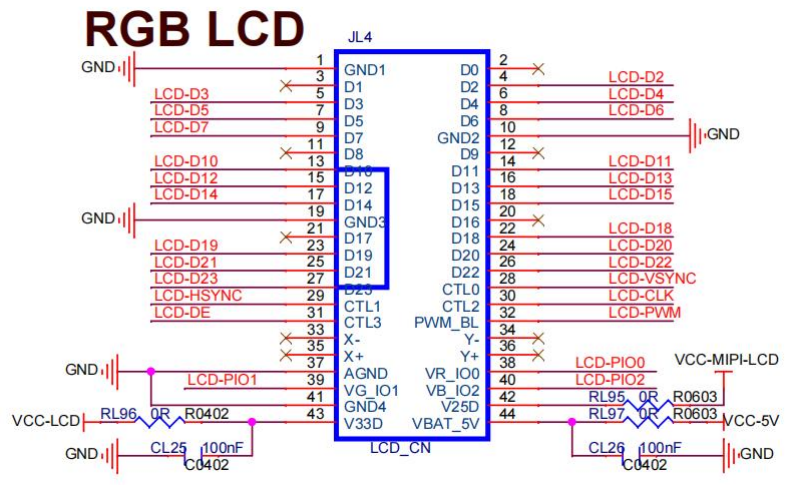
[picture p237: figure]
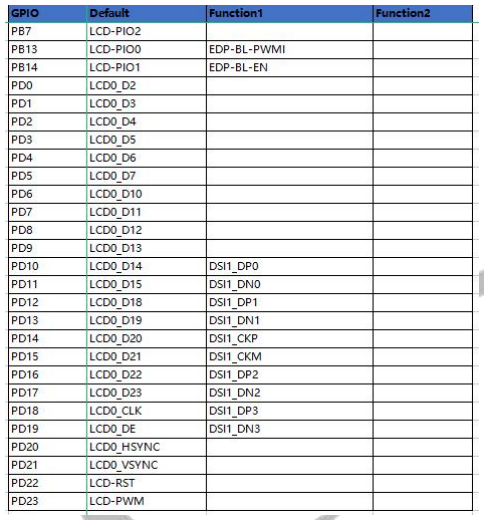
[picture p238: figure]

Copyright © 2023 by Allwinner. All rights reserved | Page 33 of 42

图 4-27 RGB 接口原理图图示

对应 gpio 配置如图表 4-5 所示：
图表 4-5 RGB 屏 gpio 配置

### 4.7.3 EDP 屏接口使用

EDP 屏通过 JL2 座子经过排线和 EDP 屏幕连接，注意不要带电插拔，注意方向。使用时需要将原理图中 EDP LCM 页中的 RL187、RL188 贴上，去掉对应开发板上的位置如图 4-28 所示：

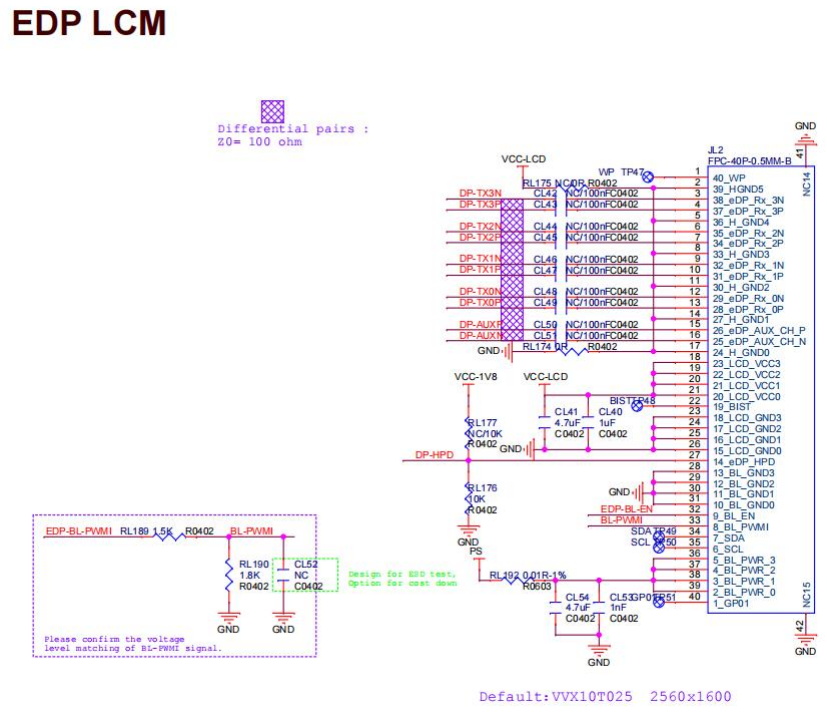
[picture p239: figure]
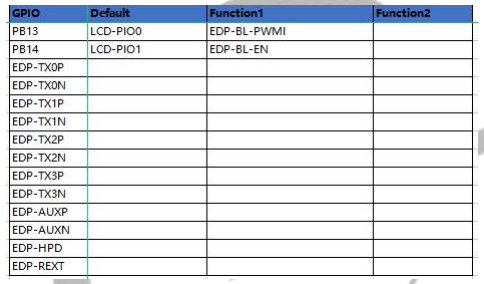
[picture p240: figure]
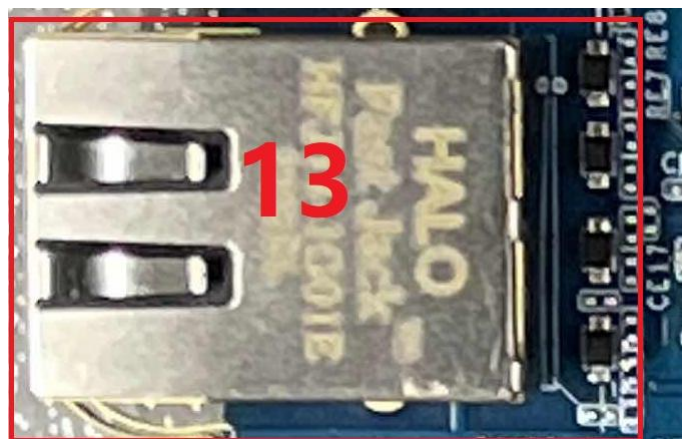
[picture p241: figure]

Copyright © 2023 by Allwinner. All rights reserved | Page 34 of 42

图 4-28 EDP 屏接口

对应 gpio 配置如图表 4-9 所示：
图表 4-6 EDP 屏 gpio 配置

## 4.8 千兆网口使用

全志开发板支持千兆网接口，千兆网接口对应 JE1，使用时需要注意将 RGMII 功能选通电阻 R41 至 R59（见 丝印位号图）贴上，同时去掉表 4-7 中的 Default 功能的连接电阻 R1、R2、R3、RL88、RL89、R310、R311、 R319、R322、R301、R300、R304、R305、R306、R307（见丝印位号图），gpio 配置如图表 4-7 所示：
图 4-29 千兆网接口

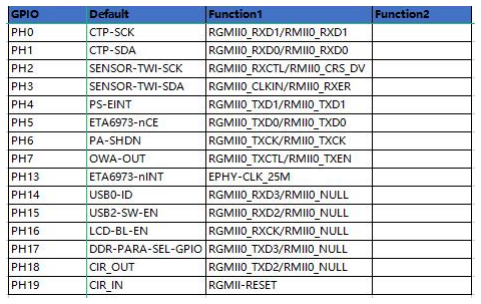
[picture p242: figure]
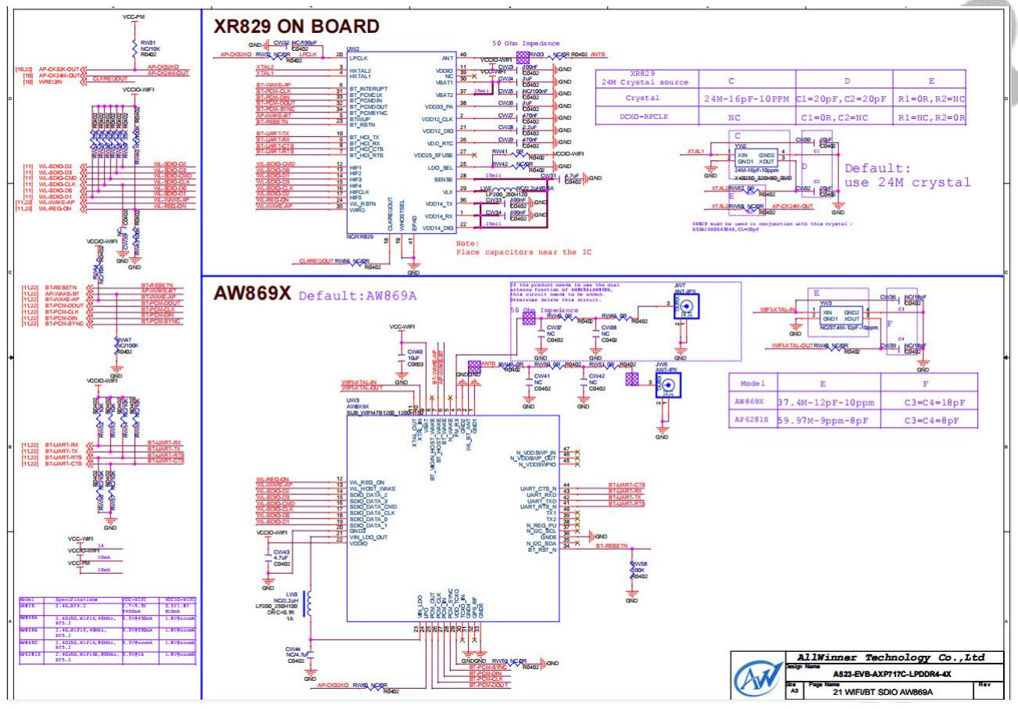
[picture p243: figure]

Copyright © 2023 by Allwinner. All rights reserved | Page 35 of 42

图表 4-7 千兆网 gpio 配置

## 4.9 Wifi 和 BT 使用

全志开发板兼容 XR829 on board 设计以及双频 wifi 模组设计，开发板上默认使用 AW869A，有使用需求时， 根据使用的 wifi 型号设计要求对应修改开发板周边器件，对应设计原理图如图 4-30 所示：
图 4-30 wifi 设计原理图

对应开发板接口位置如图 4-31 所示：

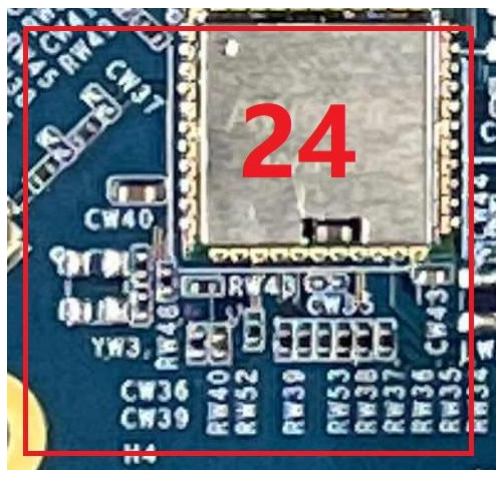
[picture p244: figure]
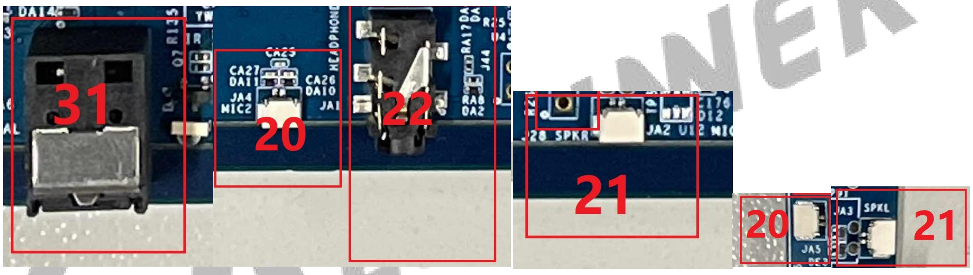
[picture p245: figure]

Copyright © 2023 by Allwinner. All rights reserved | Page 36 of 42

图 4-31 wifi 和 BT 接口

## 4.10 Audio 模块接口

A523 EVB 板上留有两个 MIC 接口、一个 LINE IN，两个 SPEAKER、一个 OWA 接口如图 4-32 所示为开发板 上 Audio 接口位置。
图 4-32 Audio 接口

Audio 模块接口设计如图 4-33 所示，值得注意的是 SPEAKER 开发板上兼容了两种方式，分别是单端和差 分，开发板默认贴片使用差分方式，对应的喇叭接口为 J72。

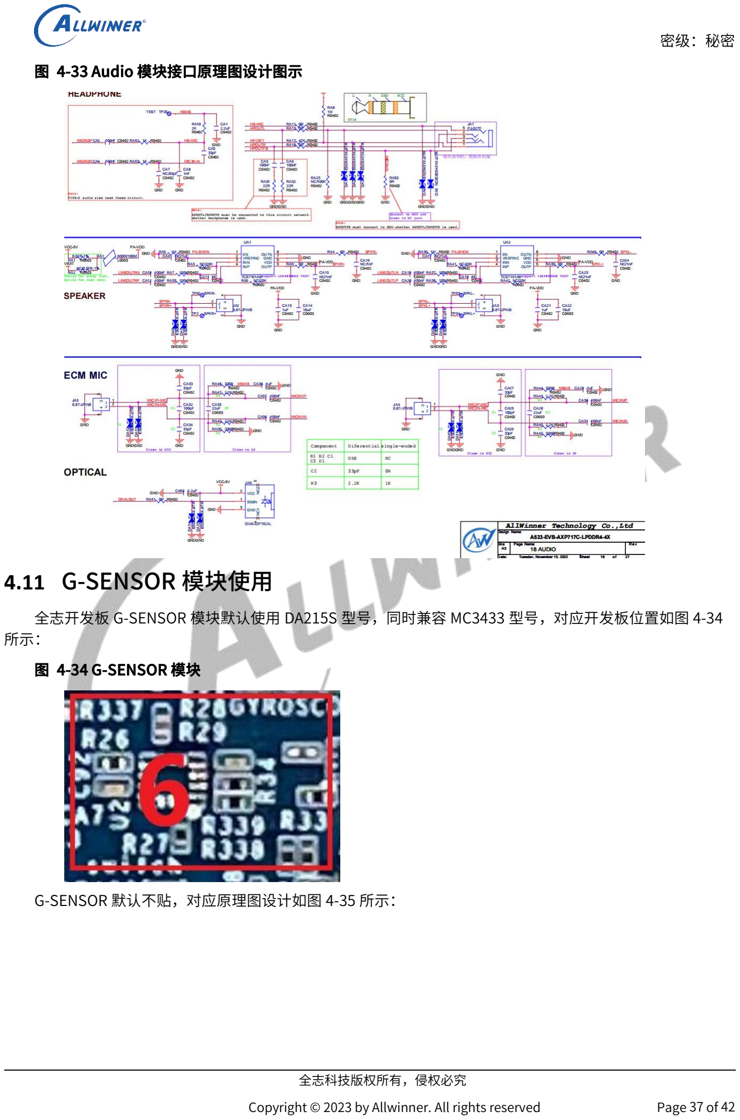
[picture p246: page 38]

Copyright © 2023 by Allwinner. All rights reserved | Page 37 of 42

图 4-33 Audio 模块接口原理图设计图示

## 4.11 G-SENSOR 模块使用

全志开发板 G-SENSOR 模块默认使用 DA215S 型号，同时兼容 MC3433 型号，对应开发板位置如图 4-34 所示：
图 4-34 G-SENSOR 模块

G-SENSOR 默认不贴，对应原理图设计如图 4-35 所示：

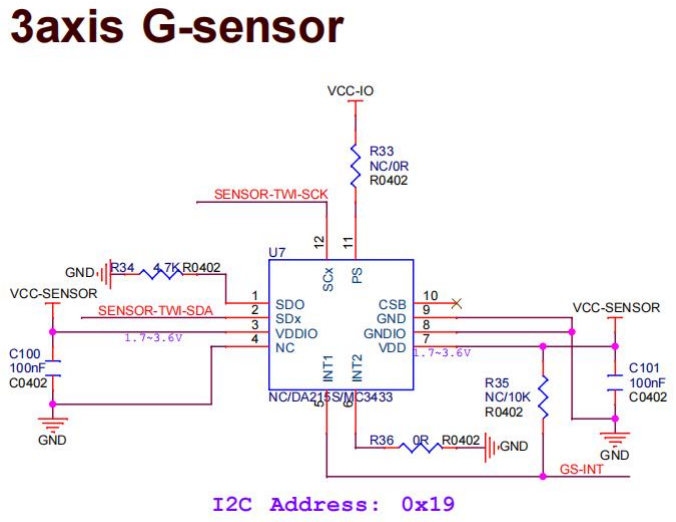
[picture p247: figure]
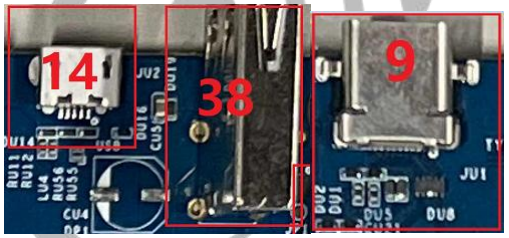
[picture p248: figure]

Copyright © 2023 by Allwinner. All rights reserved | Page 38 of 42

图 4-35 G-SENSOR 模块原理图设计图示

G-SENOR 模块 gpio 配置如图表 4-8 所示：
图表 4-8 G-SENSOR 模块 gpio 配置

## 4.12 USB OTG

A523 EVB 板上有三个 usb 接口，micro USB、Type-A 接口支持 OTG 功能，Type-C 接口支持 Type-C 音频、 快充、正反插等功能，如图 4-36 所示；
图 4-36 USB 接口

图 4-36 中 14、9 接口支持 usb OTG 功能，其中 14 通过 USB-ID 进行识别，若 ID 检测到低电平，则主控识 别为 usb 外设插入，usb0 工作为 Host 模式，此时开发板需要对外部设备进行供电，软件上通过拉高 USB-DRVVBUS 电平，使 usb 口有对外的 5V 供电，注意由于需要 usb 对外部设备供电，因此此模式下开发板必 须通过 5V 电源进行供电，反之，ID 检测到高电平，则 usb0 工作为 Device 模式，开发板无需对外部设备进行 供电，USB-DRVVBUS 电平拉低，此时开发板通过 usb 和 5V 电源供电都可以。Type-C 接口的设备识别通过 CC 逻辑来识别，支持 Type-C 音频对应原理图设计如图 4-37 所示：

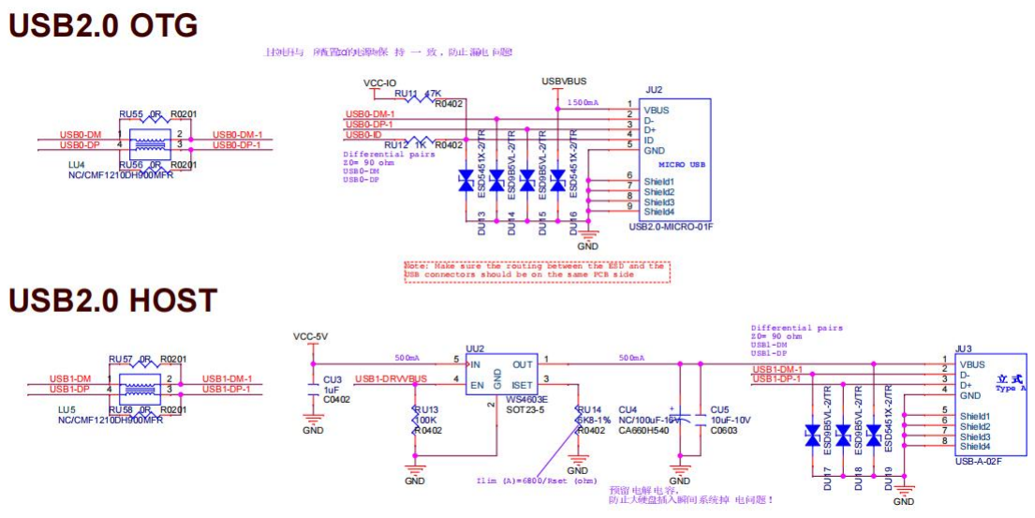
[picture p249: figure]
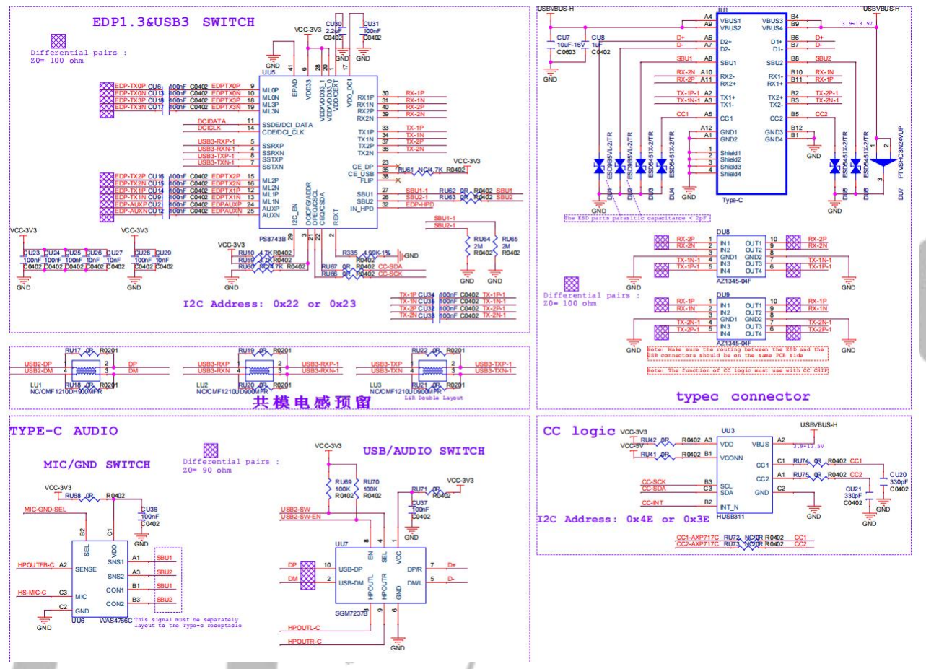
[picture p250: figure]

Copyright © 2023 by Allwinner. All rights reserved | Page 39 of 42

图 4-37 usb 原理图设计图示

Micro USB 的 gpio 配置如图表 4-9 红框所示： 图表 4-9 Micro USB gpio 配置

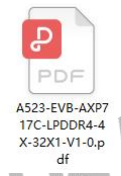
[picture p251: figure]

Copyright © 2023 by Allwinner. All rights reserved | Page 40 of 42

# 5 附件

1.A523_EVB 开发板原理图

2.A523_EVB 开发板 PCB 丝印位号图

Copyright © 2023 by Allwinner. All rights reserved | Page 41 of 42

著作权声明
版权所有©2023 珠海全志科技股份有限公司。保留一切权利。 本文档及内容受著作权法保护，其著作权由珠海全志科技股份有限公司（“全志”）拥有并保留一切权利。 本文档是全志的原创作品和版权财产，未经全志书面许可，任何单位和个人不得擅自摘抄、复制、修改、发表或 传播本文档内容的部分或全部，且不得以任何形式传播。
商标声明
、 | 、 | 、 | （不完全列举）均为珠海全志科技股份有限公司
的商标或者注册商标。在本文档描述的产品中出现的其它商标，产品名称，和服务名称，均由其各自所有人拥有。 免责声明
您购买的产品、服务或特性应受您与珠海全志科技股份有限公司（“全志”）之间签署的商业合同和条款的约束。 本文档中描述的全部或部分产品、服务或特性可能不在您所购买或使用的范围内。使用前请认真阅读合同条款和 相关说明，并严格遵循本文档的使用说明。您将自行承担任何不当使用行为（包括但不限于如超压，超频，超温 使用）造成的不利后果，全志概不负责。
本文档作为使用指导仅供参考。由于产品版本升级或其他原因，本文档内容有可能修改，如有变更，恕不另行通 知。全志尽全力在本文档中提供准确的信息，但并不确保内容完全没有错误，因使用本文档而发生损害（包括但 不限于间接的、偶然的、特殊的损失）或发生侵犯第三方权利事件，全志概不负责。本文档中的所有陈述、信息 和建议并不构成任何明示或暗示的保证或承诺。
本文档未以明示或暗示或其他方式授予全志的任何专利或知识产权。在您实施方案或使用产品的过程中，可能需 要获得第三方的权利许可。请您自行向第三方权利人获取相关的许可。全志不承担也不代为支付任何关于获取第 三方许可的许可费或版税（专利税）。全志不对您所使用的第三方许可技术做出任何保证、赔偿或承担其他义务。
