o7-machinehum/Blackpants/docs/a523/A523_PINOUT_V1.4.xlsx

Sheet: Revision History
Revision History
Revision | Date | Author | Description
1.0 | 2023-03-30 | AWA1896 | Initial Release Version
1.1 | 2023-07-05 | AWA1896 | Update some pin characteristics and signal descriptions.
1.2 | 2023-11-16 | AWA1896 | 1. Add notes for I2S0, I2S2, S-I2S0, DMIC, and S-DMIC signals in section GPIO multiplex function. 2. Update the name of PWM external signals.
1.3 | 2024-03-22 | AWA1896 | 1. Add LCD0-TRIG signal and LCD1-TRIG signal in Sheet "2 GPIO multiplex function". 2. Update unmodified names of PWM external signals in version1.2. 3. Update the description of PCIE0-PERSTN signal in Sheet "3 Signal Description".
1.4 | 2024-07-24 | AWA1896 | Modify "PWM3" to "PWM0-3" in Sheet "2 GPIO multiplex function".

Sheet: 1 Pin Characteristics
Ball#[1] | Pin Name[2] | Type[3] | Ball Reset State[4] | Pull Up/Down[5] | Default Buffer Strength[6] | I/O Power Supply[7]
SDRAM
AF29 | SA0 | O | N/A | N/A | N/A | VCC-DRAM/VCC-DRAML
AC26 | SA1 | O | N/A | N/A | N/A | VCC-DRAM/VCC-DRAML
AE29 | SA2 | O | N/A | N/A | N/A | VCC-DRAM/VCC-DRAML
AG23 | SA3 | O | N/A | N/A | N/A | VCC-DRAM/VCC-DRAML
AD21 | SA4 | O | N/A | N/A | N/A | VCC-DRAM/VCC-DRAML
AF23 | SA5 | O | N/A | N/A | N/A | VCC-DRAM/VCC-DRAML
AJ23 | SA6 | O | N/A | N/A | N/A | VCC-DRAM/VCC-DRAML
AH29 | SA7 | O | N/A | N/A | N/A | VCC-DRAM/VCC-DRAML
AG21 | SA8 | O | N/A | N/A | N/A | VCC-DRAM/VCC-DRAML
AE27 | SA9 | O | N/A | N/A | N/A | VCC-DRAM/VCC-DRAML
AC25 | SA10 | O | N/A | N/A | N/A | VCC-DRAM/VCC-DRAML
AE28 | SA11 | O | N/A | N/A | N/A | VCC-DRAM/VCC-DRAML
AG27 | SA12 | O | N/A | N/A | N/A | VCC-DRAM/VCC-DRAML
AF25 | SA13 | O | N/A | N/A | N/A | VCC-DRAM/VCC-DRAML
AH24 | SA14 | O | N/A | N/A | N/A | VCC-DRAM/VCC-DRAML
AJ25 | SA15 | O | N/A | N/A | N/A | VCC-DRAM/VCC-DRAML
AE23 | SA16 | O | N/A | N/A | N/A | VCC-DRAM/VCC-DRAML
AE26 | SA17 | O | N/A | N/A | N/A | VCC-DRAM/VCC-DRAML
AG25 | SACT | O | N/A | N/A | N/A | VCC-DRAM/VCC-DRAML
AF21 | SBA0 | O | N/A | N/A | N/A | VCC-DRAM/VCC-DRAML
AE21 | SBA1 | O | N/A | N/A | N/A | VCC-DRAM/VCC-DRAML
AJ22 | SBG0 | O | N/A | N/A | N/A | VCC-DRAM/VCC-DRAML
AH23 | SBG1 | O | N/A | N/A | N/A | VCC-DRAM/VCC-DRAML
AH27 | SCKE0 | O | N/A | N/A | N/A | VCC-DRAM/VCC-DRAML
AH26 | SCKP | O | N/A | N/A | N/A | VCC-DRAM/VCC-DRAML
AJ26 | SCKN | O | N/A | N/A | N/A | VCC-DRAM/VCC-DRAML
AJ28 | SCS0 | O | N/A | N/A | N/A | VCC-DRAM/VCC-DRAML
AH28 | SCS1 | O | N/A | N/A | N/A | VCC-DRAM/VCC-DRAML
AA24 | SDQ0 | I/O | N/A | N/A | N/A | VCC-DRAM/VCC-DRAML
AA23 | SDQ1 | I/O | N/A | N/A | N/A | VCC-DRAM/VCC-DRAML
AC28 | SDQ2 | I/O | N/A | N/A | N/A | VCC-DRAM/VCC-DRAML
AD29 | SDQ3 | I/O | N/A | N/A | N/A | VCC-DRAM/VCC-DRAML
AA26 | SDQ4 | I/O | N/A | N/A | N/A | VCC-DRAM/VCC-DRAML
Y28 | SDQ5 | I/O | N/A | N/A | N/A | VCC-DRAM/VCC-DRAML
AA27 | SDQ6 | I/O | N/A | N/A | N/A | VCC-DRAM/VCC-DRAML
Y29 | SDQ7 | I/O | N/A | N/A | N/A | VCC-DRAM/VCC-DRAML
W23 | SDQ8 | I/O | N/A | N/A | N/A | VCC-DRAM/VCC-DRAML
W24 | SDQ9 | I/O | N/A | N/A | N/A | VCC-DRAM/VCC-DRAML
W26 | SDQ10 | I/O | N/A | N/A | N/A | VCC-DRAM/VCC-DRAML
W27 | SDQ11 | I/O | N/A | N/A | N/A | VCC-DRAM/VCC-DRAML
U29 | SDQ12 | I/O | N/A | N/A | N/A | VCC-DRAM/VCC-DRAML
U27 | SDQ13 | I/O | N/A | N/A | N/A | VCC-DRAM/VCC-DRAML
U24 | SDQ14 | I/O | N/A | N/A | N/A | VCC-DRAM/VCC-DRAML
U23 | SDQ15 | I/O | N/A | N/A | N/A | VCC-DRAM/VCC-DRAML
AH21 | SDQ16 | I/O | N/A | N/A | N/A | VCC-DRAM/VCC-DRAML
AJ21 | SDQ17 | I/O | N/A | N/A | N/A | VCC-DRAM/VCC-DRAML
AD19 | SDQ18 | I/O | N/A | N/A | N/A | VCC-DRAM/VCC-DRAML
AF19 | SDQ19 | I/O | N/A | N/A | N/A | VCC-DRAM/VCC-DRAML
AG19 | SDQ20 | I/O | N/A | N/A | N/A | VCC-DRAM/VCC-DRAML
AH18 | SDQ21 | I/O | N/A | N/A | N/A | VCC-DRAM/VCC-DRAML
AJ17 | SDQ22 | I/O | N/A | N/A | N/A | VCC-DRAM/VCC-DRAML
AC17 | SDQ23 | I/O | N/A | N/A | N/A | VCC-DRAM/VCC-DRAML
AC15 | SDQ24 | I/O | N/A | N/A | N/A | VCC-DRAM/VCC-DRAML
AD15 | SDQ25 | I/O | N/A | N/A | N/A | VCC-DRAM/VCC-DRAML
AF15 | SDQ26 | I/O | N/A | N/A | N/A | VCC-DRAM/VCC-DRAML
AG15 | SDQ27 | I/O | N/A | N/A | N/A | VCC-DRAM/VCC-DRAML
AH17 | SDQ28 | I/O | N/A | N/A | N/A | VCC-DRAM/VCC-DRAML
AG17 | SDQ29 | I/O | N/A | N/A | N/A | VCC-DRAM/VCC-DRAML
AF17 | SDQ30 | I/O | N/A | N/A | N/A | VCC-DRAM/VCC-DRAML
AD17 | SDQ31 | I/O | N/A | N/A | N/A | VCC-DRAM/VCC-DRAML
AA29 | SDQM0 | I/O | N/A | N/A | N/A | VCC-DRAM/VCC-DRAML
W28 | SDQM1 | I/O | N/A | N/A | N/A | VCC-DRAM/VCC-DRAML
AH20 | SDQM2 | I/O | N/A | N/A | N/A | VCC-DRAM/VCC-DRAML
AJ16 | SDQM3 | I/O | N/A | N/A | N/A | VCC-DRAM/VCC-DRAML
AB28 | SDQS0P | I/O | N/A | N/A | N/A | VCC-DRAM/VCC-DRAML
AB29 | SDQS0N | I/O | N/A | N/A | N/A | VCC-DRAM/VCC-DRAML
V28 | SDQS1P | I/O | N/A | N/A | N/A | VCC-DRAM/VCC-DRAML
V29 | SDQS1N | I/O | N/A | N/A | N/A | VCC-DRAM/VCC-DRAML
AH19 | SDQS2P | I/O | N/A | N/A | N/A | VCC-DRAM/VCC-DRAML
AJ19 | SDQS2N | I/O | N/A | N/A | N/A | VCC-DRAM/VCC-DRAML
AH15 | SDQS3P | I/O | N/A | N/A | N/A | VCC-DRAM/VCC-DRAML
AJ15 | SDQS3N | I/O | N/A | N/A | N/A | VCC-DRAM/VCC-DRAML
AG28 | SODT0 | O | N/A | N/A | N/A | VCC-DRAM/VCC-DRAML
AG29 | SODT1 | O | N/A | N/A | N/A | VCC-DRAM/VCC-DRAML
AC19 | SRST | O | N/A | N/A | N/A | VCC-DRAM/VCC-DRAML
U25 | SZQ | AI | N/A | N/A | N/A | VCC-DRAM/VCC-DRAML
T20, T21, T22, U21, V21, W21, Y21 | VCC-DRAM | P | N/A | N/A | N/A | N/A
Y14, Y15, Y16, Y17, Y19 | VCC-DRAML | P | N/A | N/A | N/A | N/A
AA21 | VDD18-DRAM | P | N/A | N/A | N/A | N/A
System
E12 | FEL | I | PU | PU | N/A | VCC-IO
F12 | JTAG-SEL | I | PU | PU | N/A | VCC-IO
AE1 | TEST | I | PD | PD | N/A | VCC-RTC
AD11 | NMI | I/O, OD | N/A | N/A | N/A | VCC-RTC
AC11 | RESET | I/O, OD | N/A | N/A | N/A | VCC-RTC
RTC&PLL
AG11 | X32KFOUT | AO, OD | N/A | N/A | N/A | VCC-PM
AH12 | X32KIN | AI | N/A | N/A | N/A | VCC-RTC
AH11 | X32KOUT | AO | N/A | N/A | N/A | VCC-RTC
AD13 | PLLTEST | AO, OD | N/A | N/A | N/A | VCC-PLL
AA10 | VCC-RTC | P | N/A | N/A | N/A | N/A
AB13 | VCC-PLL | P | N/A | N/A | N/A | N/A
DCXO
AH13 | DXIN | AI | N/A | N/A | N/A | VCC-DCXO
AJ13 | DXOUT | AO | N/A | N/A | N/A | VCC-DCXO
AH14 | REFCLK-OUT | AO | N/A | N/A | N/A | VCC-DCXO
AE13 | WREQIN | I | N/A | N/A | N/A | VCC-PG
AA12 | VCC-DCXO | P | N/A | N/A | N/A | N/A
USB2.0 DRD
A18 | USB0-DP | A I/O | N/A | N/A | N/A | VCC33-USB
B18 | USB0-DM | A I/O | N/A | N/A | N/A | VCC33-USB
E18 | USB0-REXT | AO | N/A | N/A | N/A | VCC33-USB
H17 | VCC33-USB | P | N/A | N/A | N/A | N/A
H18 | VCC33-18-USB | P | N/A | N/A | N/A | N/A
H15 | VDD09-USB | P | N/A | N/A | N/A | N/A
USB2.0 Host
D20 | USB1-DP | A I/O | N/A | N/A | N/A | VCC33-USB
E20 | USB1-DM | A I/O | N/A | N/A | N/A | VCC33-USB
D18 | USB1-REXT | AO | N/A | N/A | N/A | VCC33-USB
PCIe2.1&USB3.1 DRD
B17 | USB2-DP | A I/O | N/A | N/A | N/A | VCC33-UAB-2
C17 | USB2-DM | A I/O | N/A | N/A | N/A | VCC33-UAB-2
D16 | USB2-REXT | AO | N/A | N/A | N/A | VCC33-UAB-2
B14 | PCIE-REF-CLKP | A I/O | N/A | N/A | N/A | VCC18-PCIE
C14 | PCIE-REF-CLKN | A I/O | N/A | N/A | N/A | VCC18-PCIE
E14 | PCIE-REXT | AO | N/A | N/A | N/A | VCC18-PCIE
A16 | PCIE-RX0-DP/USB3-RXP | AI | N/A | N/A | N/A | VCC18-PCIE
B16 | PCIE-RX0-DN/USB3-RXN | AI | N/A | N/A | N/A | VCC18-PCIE
B15 | PCIE-TX0-DP/USB3-TXP | AO | N/A | N/A | N/A | VCC18-PCIE
C15 | PCIE-TX0-DN/USB3-TXN | AO | N/A | N/A | N/A | VCC18-PCIE
J15 | VCC33-USB-2 | P | N/A | N/A | N/A | N/A
E16 | VCC33-18-USB-2 | P | N/A | N/A | N/A | N/A
H12 | VCC18-PCIE | P | N/A | N/A | N/A | N/A
H14 | VDD09-PCIE | P | N/A | N/A | N/A | N/A
eDP1.3
B23 | EDP-AUXP | A I/O | N/A | N/A | N/A | VCC18-EDP
C23 | EDP-AUXN | A I/O | N/A | N/A | N/A | VCC18-EDP
E22 | EDP-HPD | AI | N/A | N/A | N/A | VCC18-EDP
D22 | EDP-REXT | AO | N/A | N/A | N/A | VCC18-EDP
B19 | EDP-TX0P | AO | N/A | N/A | N/A | VCC18-EDP
C19 | EDP-TX0N | AO | N/A | N/A | N/A | VCC18-EDP
A20 | EDP-TX1P | AO | N/A | N/A | N/A | VCC18-EDP
B20 | EDP-TX1N | AO | N/A | N/A | N/A | VCC18-EDP
B21 | EDP-TX2P | AO | N/A | N/A | N/A | VCC18-EDP
C21 | EDP-TX2N | AO | N/A | N/A | N/A | VCC18-EDP
A22 | EDP-TX3P | AO | N/A | N/A | N/A | VCC18-EDP
B22 | EDP-TX3N | AO | N/A | N/A | N/A | VCC18-EDP
H20 | VCC18-EDP | P | N/A | N/A | N/A | N/A
H21 | VDD09-EDP | P | N/A | N/A | N/A | N/A
Audio Codec
AA2 | MICIN1P | AI | N/A | N/A | N/A | AVCC
AA1 | MICIN1N | AI | N/A | N/A | N/A | AVCC
AB2 | MICIN2P | AI | N/A | N/A | N/A | AVCC
AB1 | MICIN2N | AI | N/A | N/A | N/A | AVCC
AC2 | MICIN3P | AI | N/A | N/A | N/A | AVCC
AC1 | MICIN3N | AI | N/A | N/A | N/A | AVCC
AD2 | LINEOUTLP | AO | N/A | N/A | N/A | AVCC
AD1 | LINEOUTLN | AO | N/A | N/A | N/A | AVCC
AE2 | LINEOUTRP | AO | N/A | N/A | N/A | AVCC
AE1 | LINEOUTRN | AO | N/A | N/A | N/A | AVCC
AH1 | HPOUTL | AO | N/A | N/A | N/A | CPVIN
AJ2 | HPOUTR | AO | N/A | N/A | N/A | CPVIN
AH2 | HPOUTFB | AI | N/A | N/A | N/A | CPVIN
AF1 | MIC-DET | AI | N/A | N/A | N/A | AVCC
AF2 | HP-DET | AI | N/A | N/A | N/A | AVCC
AG1 | MBIAS | AO | N/A | N/A | N/A | VDD33
AG2 | HBIAS | AO | N/A | N/A | N/A | VDD33
AC4 | VRA1 | AO | N/A | N/A | N/A | AVCC
AC3 | VRA2 | AO | N/A | N/A | N/A | AVCC
AE5 | CPVDD | P | N/A | N/A | N/A | N/A
AC5 | CPVEE | P | N/A | N/A | N/A | N/A
AG3 | CPVIN | P | N/A | N/A | N/A | N/A
W7 | AVCC | P | N/A | N/A | N/A | N/A
AE3 | ALDO-OUT | P | N/A | N/A | N/A | N/A
AA5 | VDD33 | P | N/A | N/A | N/A | N/A
AE4 | VEE | P | N/A | N/A | N/A | N/A
AA4 | VRP | P | N/A | N/A | N/A | N/A
AA3 | AGND | G | N/A | N/A | N/A | N/A
GPADC
W2 | GPADC0 | AI | N/A | N/A | N/A | AVCC
W3 | GPADC1 | AI | N/A | N/A | N/A | AVCC
W4 | GPADC2 | AI | N/A | N/A | N/A | AVCC
W5 | GPADC3 | AI | N/A | N/A | N/A | AVCC
U6 | VCM-ADC | A I/O | N/A | N/A | N/A | AVCC
U7 | VREFN-ADC | P | N/A | N/A | N/A | N/A
W6 | VREFP-ADC | P | N/A | N/A | N/A | N/A
LRADC
Y1 | LRADC0 | AI | N/A | N/A | N/A | AVCC
Y2 | LRADC1 | AI | N/A | N/A | N/A | AVCC
Port B
J24 | PB0 | I/O | Z | PU/PD | 4 mA | VCC-IO
J25 | PB1 | I/O | Z | PU/PD | 4 mA | VCC-IO
H27 | PB2 | I/O | Z | PU/PD | 4 mA | VCC-IO
H28 | PB3 | I/O | Z | PU/PD | 4 mA | VCC-IO
J27 | PB4 | I/O | Z | PU/PD | 4 mA | VCC-IO
J28 | PB5 | I/O | Z | PU/PD | 4 mA | VCC-IO
J29 | PB6 | I/O | Z | PU/PD | 4 mA | VCC-IO
K27 | PB7 | I/O | Z | PU/PD | 4 mA | VCC-IO
K28 | PB8 | I/O | Z | PU/PD | 4 mA | VCC-IO
L24 | PB9 | I/O | Z | PU/PD | 4 mA | VCC-IO
PB10 | PB10 | I/O | Z | PU/PD | 4 mA | VCC-IO
PB11 | PB11 | I/O | Z | PU/PD | 4 mA | VCC-IO
PB12 | PB12 | I/O | Z | PU/PD | 4 mA | VCC-IO
PB13 | PB13 | I/O | Z | PU/PD | 4 mA | VCC-IO
PB14 | PB14 | I/O | Z | PU/PD | 4 mA | VCC-IO
Port C
R24 | PC0 | I/O | Z | PU/PD | 4 mA | VCC-PC
T27 | PC1 | I/O | Z | PU/PD | 4 mA | VCC-PC
N26 | PC2 | I/O | Z | PU/PD | 4 mA | VCC-PC
N25 | PC3 | I/O | Z | PU | 4 mA | VCC-PC
N24 | PC4 | I/O | Z | PU | 4 mA | VCC-PC
T28 | PC5 | I/O | Z | PU/PD | 4 mA | VCC-PC
R29 | PC6 | I/O | Z | PU | 4 mA | VCC-PC
R25 | PC7 | I/O | Z | PU | 4 mA | VCC-PC
R28 | PC8 | I/O | Z | PU/PD | 4 mA | VCC-PC
R27 | PC9 | I/O | Z | PU/PD | 4 mA | VCC-PC
P28 | PC10 | I/O | Z | PU/PD | 4 mA | VCC-PC
P27 | PC11 | I/O | Z | PU/PD | 4 mA | VCC-PC
N29 | PC12 | I/O | Z | PU/PD | 4 mA | VCC-PC
N28 | PC13 | I/O | Z | PU/PD | 4 mA | VCC-PC
N27 | PC14 | I/O | Z | PU/PD | 4 mA | VCC-PC
M28 | PC15 | I/O | Z | PU/PD | 4 mA | VCC-PC
M27 | PC16 | I/O | Z | PU/PD | 4 mA | VCC-PC
N22 | VCC-PC | P | N/A | N/A | N/A | N/A
Port D
A24 | PD0 | I/O | Z | PU/PD | 4 mA | VCC-PD/VCC-LVDS0
B24 | PD1 | I/O | Z | PU/PD | 4 mA | VCC-PD/VCC-LVDS0
A25 | PD2 | I/O | Z | PU/PD | 4 mA | VCC-PD/VCC-LVDS0
B25 | PD3 | I/O | Z | PU/PD | 4 mA | VCC-PD/VCC-LVDS0
A26 | PD4 | I/O | Z | PU/PD | 4 mA | VCC-PD/VCC-LVDS0
B26 | PD5 | I/O | Z | PU/PD | 4 mA | VCC-PD/VCC-LVDS0
A27 | PD6 | I/O | Z | PU/PD | 4 mA | VCC-PD/VCC-LVDS0
B27 | PD7 | I/O | Z | PU/PD | 4 mA | VCC-PD/VCC-LVDS0
A28 | PD8 | I/O | Z | PU/PD | 4 mA | VCC-PD/VCC-LVDS0
B28 | PD9 | I/O | Z | PU/PD | 4 mA | VCC-PD/VCC-LVDS0
C28 | PD10 | I/O | Z | PU/PD | 4 mA | VCC-PD/VCC-LVDS0
C29 | PD11 | I/O | Z | PU/PD | 4 mA | VCC-PD/VCC-LVDS0
D28 | PD12 | I/O | Z | PU/PD | 4 mA | VCC-PD/VCC-LVDS0
D29 | PD13 | I/O | Z | PU/PD | 4 mA | VCC-PD/VCC-LVDS0
E28 | PD14 | I/O | Z | PU/PD | 4 mA | VCC-PD/VCC-LVDS0
E29 | PD15 | I/O | Z | PU/PD | 4 mA | VCC-PD/VCC-LVDS0
E26 | PD16 | I/O | Z | PU/PD | 4 mA | VCC-PD/VCC-LVDS0
E25 | PD17 | I/O | Z | PU/PD | 4 mA | VCC-PD/VCC-LVDS0
F29 | PD18 | I/O | Z | PU/PD | 4 mA | VCC-PD/VCC-LVDS0
F28 | PD19 | I/O | Z | PU/PD | 4 mA | VCC-PD/VCC-LVDS0
G28 | PD20 | I/O | Z | PU/PD | 4 mA | VCC-PD
G29 | PD21 | I/O | Z | PU/PD | 4 mA | VCC-PD
G25 | PD22 | I/O | Z | PU/PD | 4 mA | VCC-PD
G26 | PD23 | I/O | Z | PU/PD | 4 mA | VCC-PD
J23 | VCC-PD | P | N/A | N/A | N/A | N/A
K21 | VCC-LVDS0 | P | N/A | N/A | N/A | N/A
Port E
J1 | PE0 | I/O | Z | PU/PD | 4 mA | VCC-PE
J2 | PE1 | I/O | Z | PU/PD | 4 mA | VCC-PE
K2 | PE2 | I/O | Z | PU/PD | 4 mA | VCC-PE
K1 | PE3 | I/O | Z | PU/PD | 4 mA | VCC-PE
L1 | PE4 | I/O | Z | PU/PD | 4 mA | VCC-PE
L2 | PE5 | I/O | Z | PU/PD | 4 mA | VCC-PE
M1 | PE6 | I/O | Z | PU/PD | 4 mA | VCC-PE
M2 | PE7 | I/O | Z | PU/PD | 4 mA | VCC-PE
J4 | PE8 | I/O | Z | PU/PD | 4 mA | VCC-PE
J5 | PE9 | I/O | Z | PU/PD | 4 mA | VCC-PE
N1 | PE10 | I/O | Z | PU/PD | 4 mA | VCC-PE
N2 | PE11 | I/O | Z | PU/PD | 4 mA | VCC-PE
L4 | PE12 | I/O | Z | PU/PD | 4 mA | VCC-PE
L5 | PE13 | I/O | Z | PU/PD | 4 mA | VCC-PE
N4 | PE14 | I/O | Z | PU/PD | 4 mA | VCC-PE
N5 | PE15 | I/O | Z | PU/PD | 4 mA | VCC-PE
J6 | VCC_PE | P | N/A | N/A | N/A | N/A
Port F
C13 | PF0 | I/O | Z | PU/PD | 4 mA | VCC-IO/VCC-MCSI
B13 | PF1 | I/O | Z | PU/PD | 4 mA | VCC-IO/VCC-MCSI
B12 | PF2 | I/O | Z | PU/PD | 4 mA | VCC-IO/VCC-MCSI
A12 | PF3 | I/O | Z | PU/PD | 4 mA | VCC-IO/VCC-MCSI
C11 | PF4 | I/O | Z | PU/PD | 4 mA | VCC-IO/VCC-MCSI
B11 | PF5 | I/O | Z | PU/PD | 4 mA | VCC-IO/VCC-MCSI
C12 | PF6 | I/O | Z | PU/PD | 4 mA | VCC-IO/VCC-MCSI
Port G
R1 | PG0 | I/O | Z | PU/PD | 4 mA | VCC-PG
R2 | PG1 | I/O | Z | PU | 4 mA | VCC-PG
P3 | PG2 | I/O | Z | PU | 4 mA | VCC-PG
P2 | PG3 | I/O | Z | PU | 4 mA | VCC-PG
T3 | PG4 | I/O | Z | PU | 4 mA | VCC-PG
T2 | PG5 | I/O | Z | PU | 4 mA | VCC-PG
R5 | PG6 | I/O | Z | PU/PD | 4 mA | VCC-PG
U3 | PG7 | I/O | Z | PU/PD | 4 mA | VCC-PG
R4 | PG8 | I/O | Z | PU/PD | 4 mA | VCC-PG
U4 | PG9 | I/O | Z | PU/PD | 4 mA | VCC-PG
U1 | PG10 | I/O | Z | PU/PD | 4 mA | VCC-PG
U2 | PG11 | I/O | Z | PU/PD | 4 mA | VCC-PG
V2 | PG12 | I/O | Z | PU/PD | 4 mA | VCC-PG
V3 | PG13 | I/O | Z | PU/PD | 4 mA | VCC-PG
U5 | PG14 | I/O | Z | PU/PD | 4 mA | VCC-PG
N6 | VCC-PG | P | N/A | N/A | N/A | N/A
Port H
F10 | PH0 | I/O | Z | PU/PD | 4 mA | VCC-IO
E10 | PH1 | I/O | Z | PU/PD | 4 mA | VCC-IO
D10 | PH2 | I/O | Z | PU/PD | 4 mA | VCC-IO
B10 | PH3 | I/O | Z | PU/PD | 4 mA | VCC-IO
A10 | PH4 | I/O | Z | PU/PD | 4 mA | VCC-IO
B9 | PH5 | I/O | Z | PU/PD | 4 mA | VCC-IO
C9 | PH6 | I/O | Z | PU/PD | 4 mA | VCC-IO
F8 | PH7 | I/O | Z | PU/PD | 4 mA | VCC-IO
E8 | PH8 | I/O | Z | PU/PD | 4 mA | VCC-IO
D8 | PH9 | I/O | Z | PU/PD | 4 mA | VCC-IO
B8 | PH10 | I/O | Z | PU/PD | 4 mA | VCC-IO
A8 | PH11 | I/O | Z | PU/PD | 4 mA | VCC-IO
C7 | PH12 | I/O | Z | PU/PD | 4 mA | VCC-IO
B7 | PH13 | I/O | Z | PU/PD | 4 mA | VCC-IO
A6 | PH14 | I/O | Z | PU/PD | 4 mA | VCC-IO
B6 | PH15 | I/O | Z | PU/PD | 4 mA | VCC-IO
A5 | PH16 | I/O | Z | PU/PD | 4 mA | VCC-IO
B5 | PH17 | I/O | Z | PU/PD | 4 mA | VCC-IO
D6 | PH18 | I/O | Z | PU/PD | 4 mA | VCC-IO
E6 | PH19 | I/O | Z | PU/PD | 4 mA | VCC-IO
Port K
A4 | PK0 | I/O | Z | PU/PD | 4 mA | VCC-PK/VCC-MCSI
B4 | PK1 | I/O | Z | PU/PD | 4 mA | VCC-PK/VCC-MCSI
A3 | PK2 | I/O | Z | PU/PD | 4 mA | VCC-PK/VCC-MCSI
B3 | PK3 | I/O | Z | PU/PD | 4 mA | VCC-PK/VCC-MCSI
B2 | PK4 | I/O | Z | PU/PD | 4 mA | VCC-PK/VCC-MCSI
B1 | PK5 | I/O | Z | PU/PD | 4 mA | VCC-PK/VCC-MCSI
C5 | PK6 | I/O | Z | PU/PD | 4 mA | VCC-PK/VCC-MCSI
C4 | PK7 | I/O | Z | PU/PD | 4 mA | VCC-PK/VCC-MCSI
E5 | PK8 | I/O | Z | PU/PD | 4 mA | VCC-PK/VCC-MCSI
E4 | PK9 | I/O | Z | PU/PD | 4 mA | VCC-PK/VCC-MCSI
G5 | PK10 | I/O | Z | PU/PD | 4 mA | VCC-PK/VCC-MCSI
G4 | PK11 | I/O | Z | PU/PD | 4 mA | VCC-PK/VCC-MCSI
C2 | PK12 | I/O | Z | PU/PD | 4 mA | VCC-PK/VCC-MCSI
C1 | PK13 | I/O | Z | PU/PD | 4 mA | VCC-PK/VCC-MCSI
D2 | PK14 | I/O | Z | PU/PD | 4 mA | VCC-PK/VCC-MCSI
D1 | PK15 | I/O | Z | PU/PD | 4 mA | VCC-PK/VCC-MCSI
E2 | PK16 | I/O | Z | PU/PD | 4 mA | VCC-PK/VCC-MCSI
E1 | PK17 | I/O | Z | PU/PD | 4 mA | VCC-PK/VCC-MCSI
F1 | PK18 | I/O | Z | PU/PD | 4 mA | VCC-PK/VCC-MCSI
F2 | PK19 | I/O | Z | PU/PD | 4 mA | VCC-PK/VCC-MCSI
G2 | PK20 | I/O | Z | PU/PD | 4 mA | VCC-PK/VCC-MCSI
G1 | PK21 | I/O | Z | PU/PD | 4 mA | VCC-PK/VCC-MCSI
H2 | PK22 | I/O | Z | PU/PD | 4 mA | VCC-PK/VCC-MCSI
H1 | PK23 | I/O | Z | PU/PD | 4 mA | VCC-PK/VCC-MCSI
J7 | VCC-PK | P | N/A | N/A | N/A | N/A
H10 | VCC-MCSI | P | N/A | N/A | N/A | N/A
Port L
AJ7 | PL0 | I/O | Z | PU | 4 mA | VCC-PL
AH7 | PL1 | I/O | Z | PU | 4 mA | VCC-PL
AJ8 | PL2 | I/O | Z | PU/PD | 4 mA | VCC-PL
AH8 | PL3 | I/O | Z | PU/PD | 4 mA | VCC-PL
AH9 | PL4 | I/O | Z | PU/PD | 4 mA | VCC-PL
AJ9 | PL5 | I/O | Z | PU/PD | 4 mA | VCC-PL
AE9 | PL6 | I/O | Z | PU/PD | 4 mA | VCC-PL
AF9 | PL7 | I/O | Z | PU/PD | 4 mA | VCC-PL
AG10 | PL8 | I/O | Z | PU/PD | 4 mA | VCC-PL
AG9 | PL9 | I/O | Z | PU/PD | 4 mA | VCC-PL
AC9 | PL10 | I/O | Z | PU/PD | 4 mA | VCC-PL
AD9 | PL11 | I/O | Z | PU/PD | 4 mA | VCC-PL
AF7 | PL12 | I/O | Z | PU/PD | 4 mA | VCC-PL
AE7 | PL13 | I/O | Z | PU/PD | 4 mA | VCC-PL
AA9 | VCC-PL | P | N/A | N/A | N/A | N/A
Port M
AJ4 | PM0 | I/O | Z | PU/PD | 4 mA | VCC-PM
AJ3 | PM1 | I/O | Z | PU/PD | 4 mA | VCC-PM
AH5 | PM2 | I/O | Z | PU/PD | 4 mA | VCC-PM
AH4 | PM3 | I/O | Z | PU/PD | 4 mA | VCC-PM
AJ5 | PM4 | I/O | Z | PU/PD | 4 mA | VCC-PM
AH6 | PM5 | I/O | Z | PU/PD | 4 mA | VCC-PM
AC7 | VCC-PM | P | N/A | N/A | N/A | N/A
Power
J12 | VCC-IO | P | N/A | N/A | N/A | N/A
N23 | VCC-EFUSE | P | N/A | N/A | N/A | N/A
Y12 | VDD-CPUS | P | N/A | N/A | N/A | N/A
N16, N18, N19, P15, P16, P18, P19 | VDD-CPUB | P | N/A | N/A | N/A | N/A
T16, T18, U16, U18 | VDD-CPUL | P | N/A | N/A | N/A | N/A
M12, M14, M15 | VDD-SYS | P | N/A | N/A | N/A | N/A
K10, L10 | VDD-VE | P | N/A | N/A | N/A | N/A
K19, L18, L19 | VDD-DE | P | N/A | N/A | N/A | N/A
N8, N10, P9, P10 | VDD-GPU | P | N/A | N/A | N/A | N/A
U9, U10, V9, V10 | VDD-DNR | P | N/A | N/A | N/A | N/A
M19 | VDD-CPUBFB | P | N/A | N/A | N/A | N/A
V16 | VDD-CPULFB | P | N/A | N/A | N/A | N/A
L15 | VDD-SYSFB | P | N/A | N/A | N/A | N/A
W10 | VDD-DNRFB | P | N/A | N/A | N/A | N/A
Ground
A14 | AVSS | G | N/A | N/A | N/A | N/A
C16 | AVSS | G | N/A | N/A | N/A | N/A
C18 | AVSS | G | N/A | N/A | N/A | N/A
C20 | AVSS | G | N/A | N/A | N/A | N/A
C22 | AVSS | G | N/A | N/A | N/A | N/A
D14 | AVSS | G | N/A | N/A | N/A | N/A
F16 | AVSS | G | N/A | N/A | N/A | N/A
F18 | AVSS | G | N/A | N/A | N/A | N/A
F20 | AVSS | G | N/A | N/A | N/A | N/A
F22 | AVSS | G | N/A | N/A | N/A | N/A
H13 | AVSS | G | N/A | N/A | N/A | N/A
H16 | AVSS | G | N/A | N/A | N/A | N/A
H19 | AVSS | G | N/A | N/A | N/A | N/A
J13 | AVSS | G | N/A | N/A | N/A | N/A
J16 | AVSS | G | N/A | N/A | N/A | N/A
J18 | AVSS | G | N/A | N/A | N/A | N/A
J19 | AVSS | G | N/A | N/A | N/A | N/A
A1 | GND | G | N/A | N/A | N/A | N/A
A2 | GND | G | N/A | N/A | N/A | N/A
A29 | GND | G | N/A | N/A | N/A | N/A
B29 | GND | G | N/A | N/A | N/A | N/A
C3 | GND | G | N/A | N/A | N/A | N/A
C6 | GND | G | N/A | N/A | N/A | N/A
C8 | GND | G | N/A | N/A | N/A | N/A
C10 | GND | G | N/A | N/A | N/A | N/A
C24 | GND | G | N/A | N/A | N/A | N/A
C25 | GND | G | N/A | N/A | N/A | N/A
C26 | GND | G | N/A | N/A | N/A | N/A
C27 | GND | G | N/A | N/A | N/A | N/A
D12 | GND | G | N/A | N/A | N/A | N/A
E3 | GND | G | N/A | N/A | N/A | N/A
E24 | GND | G | N/A | N/A | N/A | N/A
E27 | GND | G | N/A | N/A | N/A | N/A
G3 | GND | G | N/A | N/A | N/A | N/A
G6 | GND | G | N/A | N/A | N/A | N/A
G7 | GND | G | N/A | N/A | N/A | N/A
G23 | GND | G | N/A | N/A | N/A | N/A
G24 | GND | G | N/A | N/A | N/A | N/A
G27 | GND | G | N/A | N/A | N/A | N/A
H9 | GND | G | N/A | N/A | N/A | N/A
H11 | GND | G | N/A | N/A | N/A | N/A
J3 | GND | G | N/A | N/A | N/A | N/A
J10 | GND | G | N/A | N/A | N/A | N/A
J22 | GND | G | N/A | N/A | N/A | N/A
J26 | GND | G | N/A | N/A | N/A | N/A
K9 | GND | G | N/A | N/A | N/A | N/A
K12 | GND | G | N/A | N/A | N/A | N/A
K15 | GND | G | N/A | N/A | N/A | N/A
K16 | GND | G | N/A | N/A | N/A | N/A
K18 | GND | G | N/A | N/A | N/A | N/A
L3 | GND | G | N/A | N/A | N/A | N/A
L6 | GND | G | N/A | N/A | N/A | N/A
L7 | GND | G | N/A | N/A | N/A | N/A
L9 | GND | G | N/A | N/A | N/A | N/A
L13 | GND | G | N/A | N/A | N/A | N/A
L16 | GND | G | N/A | N/A | N/A | N/A
L21 | GND | G | N/A | N/A | N/A | N/A
L23 | GND | G | N/A | N/A | N/A | N/A
M9 | GND | G | N/A | N/A | N/A | N/A
M10 | GND | G | N/A | N/A | N/A | N/A
M16 | GND | G | N/A | N/A | N/A | N/A
M21 | GND | G | N/A | N/A | N/A | N/A
N3 | GND | G | N/A | N/A | N/A | N/A
N7 | GND | G | N/A | N/A | N/A | N/A
N12 | GND | G | N/A | N/A | N/A | N/A
N13 | GND | G | N/A | N/A | N/A | N/A
N15 | GND | G | N/A | N/A | N/A | N/A
N21 | GND | G | N/A | N/A | N/A | N/A
P11 | GND | G | N/A | N/A | N/A | N/A
P13 | GND | G | N/A | N/A | N/A | N/A
R3 | GND | G | N/A | N/A | N/A | N/A
R6 | GND | G | N/A | N/A | N/A | N/A
R7 | GND | G | N/A | N/A | N/A | N/A
R15 | GND | G | N/A | N/A | N/A | N/A
R16 | GND | G | N/A | N/A | N/A | N/A
R23 | GND | G | N/A | N/A | N/A | N/A
R26 | GND | G | N/A | N/A | N/A | N/A
T9 | GND | G | N/A | N/A | N/A | N/A
T10 | GND | G | N/A | N/A | N/A | N/A
T12 | GND | G | N/A | N/A | N/A | N/A
T13 | GND | G | N/A | N/A | N/A | N/A
T19 | GND | G | N/A | N/A | N/A | N/A
U12 | GND | G | N/A | N/A | N/A | N/A
U15 | GND | G | N/A | N/A | N/A | N/A
U19 | GND | G | N/A | N/A | N/A | N/A
U20 | GND | G | N/A | N/A | N/A | N/A
U26 | GND | G | N/A | N/A | N/A | N/A
U28 | GND | G | N/A | N/A | N/A | N/A
V12 | GND | G | N/A | N/A | N/A | N/A
V13 | GND | G | N/A | N/A | N/A | N/A
V15 | GND | G | N/A | N/A | N/A | N/A
V18 | GND | G | N/A | N/A | N/A | N/A
V19 | GND | G | N/A | N/A | N/A | N/A
W1 | GND | G | N/A | N/A | N/A | N/A
W8 | GND | G | N/A | N/A | N/A | N/A
W9 | GND | G | N/A | N/A | N/A | N/A
W12 | GND | G | N/A | N/A | N/A | N/A
W14 | GND | G | N/A | N/A | N/A | N/A
W25 | GND | G | N/A | N/A | N/A | N/A
W29 | GND | G | N/A | N/A | N/A | N/A
AA6 | GND | G | N/A | N/A | N/A | N/A
AA7 | GND | G | N/A | N/A | N/A | N/A
AA11 | GND | G | N/A | N/A | N/A | N/A
AA17 | GND | G | N/A | N/A | N/A | N/A
AA18 | GND | G | N/A | N/A | N/A | N/A
AA19 | GND | G | N/A | N/A | N/A | N/A
AA20 | GND | G | N/A | N/A | N/A | N/A
AA25 | GND | G | N/A | N/A | N/A | N/A
AA28 | GND | G | N/A | N/A | N/A | N/A
AC13 | GND | G | N/A | N/A | N/A | N/A
AC21 | GND | G | N/A | N/A | N/A | N/A
AC24 | GND | G | N/A | N/A | N/A | N/A
AC27 | GND | G | N/A | N/A | N/A | N/A
AC29 | GND | G | N/A | N/A | N/A | N/A
AD7 | GND | G | N/A | N/A | N/A | N/A
AD23 | GND | G | N/A | N/A | N/A | N/A
AD28 | GND | G | N/A | N/A | N/A | N/A
AE15 | GND | G | N/A | N/A | N/A | N/A
AE17 | GND | G | N/A | N/A | N/A | N/A
AE19 | GND | G | N/A | N/A | N/A | N/A
AF11 | GND | G | N/A | N/A | N/A | N/A
AF13 | GND | G | N/A | N/A | N/A | N/A
AF28 | GND | G | N/A | N/A | N/A | N/A
AG5 | GND | G | N/A | N/A | N/A | N/A
AG7 | GND | G | N/A | N/A | N/A | N/A
AG12 | GND | G | N/A | N/A | N/A | N/A
AG13 | GND | G | N/A | N/A | N/A | N/A
AG14 | GND | G | N/A | N/A | N/A | N/A
AH3 | GND | G | N/A | N/A | N/A | N/A
AH10 | GND | G | N/A | N/A | N/A | N/A
AH16 | GND | G | N/A | N/A | N/A | N/A
AH22 | GND | G | N/A | N/A | N/A | N/A
AH25 | GND | G | N/A | N/A | N/A | N/A
AJ1 | GND | G | N/A | N/A | N/A | N/A
AJ6 | GND | G | N/A | N/A | N/A | N/A
AJ11 | GND | G | N/A | N/A | N/A | N/A
AJ18 | GND | G | N/A | N/A | N/A | N/A
AJ20 | GND | G | N/A | N/A | N/A | N/A
AJ24 | GND | G | N/A | N/A | N/A | N/A
AJ27 | GND | G | N/A | N/A | N/A | N/A
AJ29 | GND | G | N/A | N/A | N/A | N/A
Others
F14 | NC | N/A | N/A | N/A | N/A | N/A
[1] Ball#: Package ball numbers associated with each signal. [2] Pin Name: The name of the package pin. NC means these pins are not connected. [3] Type: Denotes the signal direction I (Input), O (Output), I/O (Input/Output), OD (Open-Drain), A (Analog), AI (Analog Input), AO (Analog Output), P (Power), G (Ground), N/A (Not Applicable) [4] Ball Reset State: The state of the terminal at reset. PU: Pull Up PD: Pull Down Z: High Impedance N/A: Not Applicable [5] Pull Up/Down: Denotes the presence of an internal pull-up or pull-down resistor. Pull-up and pull-down resistors can be enabled or disabled via software. PU: Internal pullup PD: Internal pulldown PU/PD: Internal pullup and pulldown N/A: Not Applicable [6] Default Buffer Strength: Defines the default drive strength of the associated output buffer. The maximum drive strength of each GPIO is 6 mA. N/A means Not Applicable. [7] I/O Power Supply: The voltage supplies for the IO buffers of the terminal. N/A means Not Applicable.

Sheet: 2 GPIO Multiplex Function
GPIO Groups | Pin Name | IO Type | Function2(1) | Function3(1) | Function4(1) | Function5(1) | Function6(1) | Function14(1)
Port B | PB0 | I/O | UART2-TX | SPI2-CS0 | JTAG-MS |  | PWM0-6 | PB-EINT0
 | PB1 | I/O | UART2-RX | SPI2-CLK | JTAG-CK |  | PWM0-7 | PB-EINT1
 | PB2 | I/O | UART2-RTS | SPI2-MOSI | JTAG-DO |  |  | PB-EINT2
 | PB3 | I/O | UART2-CTS | SPI2-MISO | JTAG-DI |  |  | PB-EINT3
 | PB4 | I/O | TWI1-SCK | I2S0-MCLK(2) |  | PWM0-8 |  | PB-EINT4
 | PB5 | I/O | TWI1-SDA | I2S0-BCLK(2) |  | PWM0-9 |  | PB-EINT5
 | PB6 | I/O |  | I2S0-LRCK(2) |  | PWM0-10 |  | PB-EINT6
 | PB7 | I/O | OWA-IN | I2S0-DOUT0(2) | I2S0-DIN1(2) | LCD0-D16 | PWM0-11 | PB-EINT7
 | PB8 | I/O | OWA-OUT | I2S0-DIN0(2) | I2S0-DOUT1(2) | LCD0-D17 | PWM0-0 | PB-EINT8
 | PB9 | I/O | UART0-TX | TWI0-SCK |  | I2S0-DIN2(2) | I2S0-DOUT2(2) | PB-EINT9
 | PB10 | I/O | UART0-RX | TWI0-SDA | PWM0-1 | I2S0-DIN3(2) | I2S0-DOUT3(2) | PB-EINT10
 | PB11 | I/O | TWI5-SCK | UART7-RTS | SPI1-CS0 | PWM0-2 |  | PB-EINT11
 | PB12 | I/O | TWI5-SDA | UART7-CTS | SPI1-CLK | PWM0-3 |  | PB-EINT12
 | PB13 | I/O | TWI4-SCK | UART7-TX | SPI1-MOSI | PWM0-4 |  | PB-EINT13
 | PB14 | I/O | TWI4-SDA | UART7-RX | SPI1-MISO | PWM0-5 |  | PB-EINT14
Port C | PC0 | I/O | NAND-WE | SDC2-DS |  |  |  | PC-EINT0
 | PC1 | I/O | NAND-ALE | SDC2-RST |  |  |  | PC-EINT1
 | PC2 | I/O | NAND-CLE |  | SPI0-MOSI | SPIF-MOSI |  | PC-EINT2
 | PC3 | I/O | NAND-CE1 |  | SPI0-CS0 | SPIF-CS0 |  | PC-EINT3
 | PC4 | I/O | NAND-CE0 |  | SPI0-MISO | SPIF-MISO |  | PC-EINT4
 | PC5 | I/O | NAND-RE | SDC2-CLK |  |  |  | PC-EINT5
 | PC6 | I/O | NAND-RB0 | SDC2-CMD |  |  |  | PC-EINT6
 | PC7 | I/O | NAND-RB1 |  | SPI0-CS1 | SPIF-DQS |  | PC-EINT7
 | PC8 | I/O | NAND-DQ7 | SDC2-D3 |  | SPIF-D7 |  | PC-EINT8
 | PC9 | I/O | NAND-DQ6 | SDC2-D4 |  | SPIF-D6 |  | PC-EINT9
 | PC10 | I/O | NAND-DQ5 | SDC2-D0 |  | SPIF-D5 |  | PC-EINT10
 | PC11 | I/O | NAND-DQ4 | SDC2-D5 |  | SPIF-D4 |  | PC-EINT11
 | PC12 | I/O | NAND-DQS |  | SPI0-CLK | SPIF-CLK |  | PC-EINT12
 | PC13 | I/O | NAND-DQ3 | SDC2-D1 |  |  |  | PC-EINT13
 | PC14 | I/O | NAND-DQ2 | SDC2-D6 |  |  |  | PC-EINT14
 | PC15 | I/O | NAND-DQ1 | SDC2-D2 | SPI0-WP | SPIF-WP |  | PC-EINT15
 | PC16 | I/O | NAND-DQ0 | SDC2-D7 | SPI0-HOLD | SPIF-HOLD |  | PC-EINT16
Port D | PD0 | I/O | LCD0-D2 | LVDS0-D0P | DSI0-D0P | PWM0-0 |  | PD-EINT0
 | PD1 | I/O | LCD0-D3 | LVDS0-D0N | DSI0-D0N | PWM0-1 |  | PD-EINT1
 | PD2 | I/O | LCD0-D4 | LVDS0-D1P | DSI0-D1P | PWM0-2 |  | PD-EINT2
 | PD3 | I/O | LCD0-D5 | LVDS0-D1N | DSI0-D1N | PWM0-3 |  | PD-EINT3
 | PD4 | I/O | LCD0-D6 | LVDS0-D2P | DSI0-CKP | PWM0-4 |  | PD-EINT4
 | PD5 | I/O | LCD0-D7 | LVDS0-D2N | DSI0-CKN | PWM0-5 |  | PD-EINT5
 | PD6 | I/O | LCD0-D10 | LVDS0-CKP | DSI0-D2P | PWM0-6 |  | PD-EINT6
 | PD7 | I/O | LCD0-D11 | LVDS0-CKN | DSI0-D2N | PWM0-7 |  | PD-EINT7
 | PD8 | I/O | LCD0-D12 | LVDS0-D3P | DSI0-D3P | PWM0-8 |  | PD-EINT8
 | PD9 | I/O | LCD0-D13 | LVDS0-D3N | DSI0-D3N | PWM0-9 |  | PD-EINT9
 | PD10 | I/O | LCD0-D14 | LVDS1-D0P | DSI1-D0P | PWM0-10 | SPI1-CS0/DBI-CSX | PD-EINT10
 | PD11 | I/O | LCD0-D15 | LVDS1-D0N | DSI1-D0N | PWM0-11 | SPI1-CLK/DBI-SCLK | PD-EINT11
 | PD12 | I/O | LCD0-D18 | LVDS1-D1P | DSI1-D1P | PWM0-12 | SPI1-MOSI/DBI-SDO | PD-EINT12
 | PD13 | I/O | LCD0-D19 | LVDS1-D1N | DSI1-D1N | PWM0-13 | SPI1-MISO/DBI-SDI/DBI-TE/DBI-DCX | PD-EINT13
 | PD14 | I/O | LCD0-D20 | LVDS1-D2P | DSI1-CKP | PWM0-14 | UART3-TX | PD-EINT14
 | PD15 | I/O | LCD0-D21 | LVDS1-D2N | DSI1-CKN | PWM0-15 | UART3-RX | PD-EINT15
 | PD16 | I/O | LCD0-D22 | LVDS1-CKP | DSI1-D2P | PWM1-0 | UART3-RTS | PD-EINT16
 | PD17 | I/O | LCD0-D23 | LVDS1-CKN | DSI1-D2N | PWM1-1 | UART3-CTS | PD-EINT17
 | PD18 | I/O | LCD0-CLK | LVDS1-D3P | DSI1-D3P | PWM1-2 | UART4-TX | PD-EINT18
 | PD19 | I/O | LCD0-DE | LVDS1-D3N | DSI1-D3N | PWM1-3 | UART4-RX | PD-EINT19
 | PD20 | I/O | LCD0-HSYNC | PWM0-2 | UART2-TX | UART7-RTS | UART4-RTS | PD-EINT20
 | PD21 | I/O | LCD0-VSYNC | PWM0-3 | UART2-RX | UART7-CTS | UART4-CTS | PD-EINT21
 | PD22 | I/O | PWM0-1 | SPI1-HOLD/DBI-DCX/DBI-WRX | UART2-RTS | UART7-TX | TWI0-SCK | PD-EINT22
 | PD23 | I/O | PWM0-0 | SPI1-WP/DBI-TE | UART2-CTS | UART7-RX | TWI0-SDA | PD-EINT23
Port E | PE0 | I/O | MCSI0-MCLK |  |  |  |  | PE-EINT0
 | PE1 | I/O | TWI2-SCK | UART4-TX |  |  |  | PE-EINT1
 | PE2 | I/O | TWI2-SDA | UART4-RX |  |  |  | PE-EINT2
 | PE3 | I/O | TWI3-SCK | UART4-RTS |  |  |  | PE-EINT3
 | PE4 | I/O | TWI3-SDA | UART4-CTS |  |  |  | PE-EINT4
 | PE5 | I/O | MCSI1-MCLK |  | I2S2-MCLK(3) | LEDC |  | PE-EINT5
 | PE6 | I/O |  |  | I2S2-BCLK(3) | LCD0-TRIG | NCSI-D8 | PE-EINT6
 | PE7 | I/O |  |  | I2S2-LRCK(3) | LCD1-TRIG | NCSI-D9 | PE-EINT7
 | PE8 | I/O |  |  | I2S2-DOUT0(3) |  | NCSI-D10 | PE-EINT8
 | PE9 | I/O |  |  | I2S2-DIN0(3) |  | NCSI-D11 | PE-EINT9
 | PE10 | I/O | MCSI3-MCLK | PWM0-3 |  |  | NCSI-D12 | PE-EINT10
 | PE11 | I/O | TWI1-SCK | UART5-RTS | SPI2-CS0 | UART6-TX | NCSI-D13 | PE-EINT11
 | PE12 | I/O | TWI1-SDA | UART5-CTS | SPI2-CLK | UART6-RX | NCSI-D14 | PE-EINT12
 | PE13 | I/O | TWI4-SCK | UART5-TX | SPI2-MOSI | UART6-RTS | CSI0-XVS-FSYNC | PE-EINT13
 | PE14 | I/O | TWI4-SDA | UART5-RX | SPI2-MISO | UART6-CTS | CSI1-XVS-FSYNC | PE-EINT14
 | PE15 | I/O | MCSI2-MCLK | PWM0-2 |  |  | NCSI-D15 | PE-EINT15
Port F | PF0 | I/O | SDC0-D1 | JTAG-MS |  | I2S3-DIN0 | I2S3-DOUT1 | PF-EINT0
 | PF1 | I/O | SDC0-D0 | JTAG-DI |  | I2S3-DOUT0 | I2S3-DIN1 | PF-EINT1
 | PF2 | I/O | SDC0-CLK | UART0-TX |  | I2S3-DIN2 | I2S3-DOUT2 | PF-EINT2
 | PF3 | I/O | SDC0-CMD | JTAG-DO |  | I2S3-LRCK |  | PF-EINT3
 | PF4 | I/O | SDC0-D3 | UART0-RX |  | I2S3-DIN3 | I2S3-DOUT3 | PF-EINT4
 | PF5 | I/O | SDC0-D2 | JTAG-CK |  | I2S3-BCLK |  | PF-EINT5
 | PF6 | I/O |  |  |  | I2S3-MCLK |  | PF-EINT6
Port G | PG0 | I/O | SDC1-CLK |  |  |  |  | PG-EINT0
 | PG1 | I/O | SDC1-CMD |  |  |  |  | PG-EINT1
 | PG2 | I/O | SDC1-D0 | PCIE0-PERSTN |  |  |  | PG-EINT2
 | PG3 | I/O | SDC1-D1 | PCIE0-WAKEN |  |  |  | PG-EINT3
 | PG4 | I/O | SDC1-D2 | PCIE0-CLKREQN |  |  |  | PG-EINT4
 | PG5 | I/O | SDC1-D3 |  |  |  |  | PG-EINT5
 | PG6 | I/O | UART1-TX |  |  |  |  | PG-EINT6
 | PG7 | I/O | UART1-RX |  |  |  |  | PG-EINT7
 | PG8 | I/O | UART1-RTS |  |  |  |  | PG-EINT8
 | PG9 | I/O | UART1-CTS |  |  |  |  | PG-EINT9
 | PG10 | I/O |  | I2S1-MCLK |  |  |  | PG-EINT10
 | PG11 | I/O |  | I2S1-BCLK |  |  |  | PG-EINT11
 | PG12 | I/O |  | I2S1-LRCK |  |  |  | PG-EINT12
 | PG13 | I/O |  | I2S1-DOUT0 | I2S1-DIN1 |  |  | PG-EINT13
 | PG14 | I/O |  | I2S1-DIN0 | I2S1-DOUT1 |  |  | PG-EINT14
Port H | PH0 | I/O | TWI0-SCK |  |  | RGMII0-RXD1/RMII0-RXD1 |  | PH-EINT0
 | PH1 | I/O | TWI0-SDA |  |  | RGMII0-RXD0/RMII0-RXD0 |  | PH-EINT1
 | PH2 | I/O | TWI1-SCK |  | I2S2-DIN3(3) | RGMII0-RXCTL/RMII0-CRS-DV | I2S2-DOUT3(3) | PH-EINT2
 | PH3 | I/O | TWI1-SDA | IR-TX | I2S2-DIN2(3) | RGMII0-CLKIN/RMII0-RXER | I2S2-DOUT2(3) | PH-EINT3
 | PH4 | I/O | UART3-TX | SPI1-CS0 |  | RGMII0-TXD1/RMII0-TXD1 |  | PH-EINT4
 | PH5 | I/O | UART3-RX | SPI1-CLK | LEDC | RGMII0-TXD0/RMII0-TXD0 |  | PH-EINT5
 | PH6 | I/O | UART3-RTS | SPI1-MOSI | OWA-IN | RGMII0-TXCK/RMII0-TXCK |  | PH-EINT6
 | PH7 | I/O | UART3-CTS | SPI1-MISO | OWA-OUT | RGMII0-TXCTL/RMII0-TXEN |  | PH-EINT7
 | PH8 | I/O | DMIC-CLK(4) | SPI2-CS0 | I2S2-MCLK(3) | I2S2-DIN2(3) |  | PH-EINT8
 | PH9 | I/O | DMIC-DATA0(4) | SPI2-CLK | I2S2-BCLK(3) | RGMII0-MDC |  | PH-EINT9
 | PH10 | I/O | DMIC-DATA1(4) | SPI2-MOSI | I2S2-LRCK(3) | RGMII0-MDIO |  | PH-EINT10
 | PH11 | I/O | DMIC-DATA2(4) | SPI2-MISO | I2S2-DOUT0(3) | I2S2-DIN1(3) | PCIE0-PERSTN | PH-EINT11
 | PH12 | I/O | DMIC-DATA3(4) | TWI3-SCK | I2S2-DIN0(3) | I2S2-DOUT1(3) | PCIE0-WAKEN | PH-EINT12
 | PH13 | I/O |  | TWI3-SDA | I2S3-MCLK | RGMII0-EPHY-25M |  | PH-EINT13
 | PH14 | I/O |  |  | I2S3-BCLK | RGMII0-RXD3/RMII0-NULL |  | PH-EINT14
 | PH15 | I/O |  |  | I2S3-LRCK | RGMII0-RXD2/RMII0-NULL |  | PH-EINT15
 | PH16 | I/O |  | I2S3-DOUT0 | I2S3-DIN1 | RGMII0-RXCK/RMII0-NULL | CLK-FANOUT0 | PH-EINT16
 | PH17 | I/O |  | I2S3-DOUT1 | I2S3-DIN0 | RGMII0-TXD3/RMII0-NULL |  | PH-EINT17
 | PH18 | I/O | IR-TX | I2S3-DOUT2 | I2S3-DIN2 | RGMII0-TXD2/RMII0-NULL |  | PH-EINT18
 | PH19 | I/O | IR-RX | I2S3-DOUT3 | I2S3-DIN3 | LEDC | PCIE0-CLKREQN | PH-EINT19
Port K | PK0 | I/O | MCSIA-D0N |  |  |  |  | PK-EINT0
 | PK1 | I/O | MCSIA-D0P |  |  |  |  | PK-EINT1
 | PK2 | I/O | MCSIA-D1N |  |  |  |  | PK-EINT2
 | PK3 | I/O | MCSIA-D1P |  |  |  |  | PK-EINT3
 | PK4 | I/O | MCSIA-CKN | TWI2-SCK |  |  |  | PK-EINT4
 | PK5 | I/O | MCSIA-CKP | TWI2-SDA |  |  |  | PK-EINT5
 | PK6 | I/O | MCSIB-D0N |  |  |  |  | PK-EINT6
 | PK7 | I/O | MCSIB-D0P |  |  |  |  | PK-EINT7
 | PK8 | I/O | MCSIB-D1N |  |  |  |  | PK-EINT8
 | PK9 | I/O | MCSIB-D1P |  |  |  |  | PK-EINT9
 | PK10 | I/O | MCSIB-CKN | TWI3-SCK |  |  |  | PK-EINT10
 | PK11 | I/O | MCSIB-CKP | TWI3-SDA |  |  |  | PK-EINT11
 | PK12 | I/O | MCSIC-D0N | UART7-TX | TWI4-SCK | NCSI-PCLK |  | PK-EINT12
 | PK13 | I/O | MCSIC-D0P | UART7-RX | TWI4-SDA | NCSI-MCLK |  | PK-EINT13
 | PK14 | I/O | MCSIC-D1N | UART7-RTS | UART5-RTS | NCSI-HSYNC |  | PK-EINT14
 | PK15 | I/O | MCSIC-D1P | UART7-CTS | UART5-CTS | NCSI-VSYNC |  | PK-EINT15
 | PK16 | I/O | MCSIC-CKN | TWI5-SCK | UART5-TX | NCSI-D0 |  | PK-EINT16
 | PK17 | I/O | MCSIC-CKP | TWI5-SDA | UART5-RX | NCSI-D1 |  | PK-EINT17
 | PK18 | I/O | MCSID-D0N | MCSI0-MCLK | UART6-TX | NCSI-D2 |  | PK-EINT18
 | PK19 | I/O | MCSID-D0P | TWI2-SCK | UART6-RX | NCSI-D3 |  | PK-EINT19
 | PK20 | I/O | MCSID-D1N | TWI2-SDA | UART6-RTS | NCSI-D4 |  | PK-EINT20
 | PK21 | I/O | MCSID-D1P | MCSI1-MCLK | UART6-CTS | NCSI-D5 |  | PK-EINT21
 | PK22 | I/O | MCSID-CKN | TWI3-SCK | PWM0-6 | NCSI-D6 |  | PK-EINT22
 | PK23 | I/O | MCSID-CKP | TWI3-SDA | PWM0-7 | NCSI-D7 |  | PK-EINT23
Port L | PL0 | I/O | S-TWI0-SCK |  |  |  |  | PL-EINT0
 | PL1 | I/O | S-TWI0-SDA |  |  |  |  | PL-EINT1
 | PL2 | I/O | S-UART0-TX | S-UART1-TX | MCU-PWM0-0 |  |  | PL-EINT2
 | PL3 | I/O | S-UART0-RX | S-UART1-RX | MCU-PWM0-1 |  |  | PL-EINT3
 | PL4 | I/O | S-JTAG-MS |  | MCU-PWM0-2 | S-I2S0-BCLK(2) |  | PL-EINT4
 | PL5 | I/O | S-JTAG-CK |  | MCU-PWM0-3 | S-I2S0-LRCK(2) | S-DMIC-DATA3(4) | PL-EINT5
 | PL6 | I/O | S-JTAG-DO | MCU-PWM0-4 | S-I2S0-DIN1(2) | S-I2S0-DOUT0(2) | S-DMIC-DATA2(4) | PL-EINT6
 | PL7 | I/O | S-JTAG-DI | MCU-PWM0-5 | S-I2S0-DOUT1(2) | S-I2S0-DIN0(2) | S-DMIC-DATA1(4) | PL-EINT7
 | PL8 | I/O | S-TWI1-SCK |  | S-RJTAG-MS | S-I2S0-MCLK(2) | S-DMIC-DATA0(4) | PL-EINT8
 | PL9 | I/O | S-TWI1-SDA |  | S-RJTAG-CK | S-PWM0-1 | S-DMIC-CLK(4) | PL-EINT9
 | PL10 | I/O | S-PWM0-0 |  | S-RJTAG-DO | S-DMIC-DATA0(4) | S-SPI0-CS0 | PL-EINT10
 | PL11 | I/O | S-IR-RX |  | S-RJTAG-DI | S-DMIC-DATA1(4) | S-SPI0-CLK | PL-EINT11
 | PL12 | I/O | S-TWI2-SCK | MCU-PWM0-6 | S-UART0-TX | S-DMIC-DATA2(4) | S-SPI0-MOSI | PL-EINT12
 | PL13 | I/O | S-TWI2-SDA | MCU-PWM0-7 | S-UART0-RX | S-DMIC-DATA3(4) | S-SPI0-MISO | PL-EINT13
Port M | PM0 | I/O | S-UART0-TX | S-UART1-TX | MCU-PWM0-0 |  |  | PM-EINT0
 | PM1 | I/O | S-UART0-RX | S-UART1-RX | MCU-PWM0-1 |  |  | PM-EINT1
 | PM2 | I/O | S-TWI1-SCK | S-RJTAG-MS | MCU-PWM0-4 |  |  | PM-EINT2
 | PM3 | I/O | S-TWI1-SDA | S-RJTAG-CK | MCU-PWM0-5 |  |  | PM-EINT3
 | PM4 | I/O | MCU-PWM0-6 | S-RJTAG-DO | S-TWI2-SCK |  |  | PM-EINT4
 | PM5 | I/O | S-IR-RX | S-RJTAG-DI | S-TWI2-SDA | MCU-PWM0-7 |  | PM-EINT5
(1) For each GPIO, Function0 is input function; Function1 is output function; Function7 to Function13 are reserved. (2) I2S0 signals and S-I2S0 signals cannot be connected simultaneously. (3)If I2S2 needs to be used, please ensure that the peripheral device connected to I2S2 signals will not be used with eDP interface simultaneously. If you have more questions, please contact Allwinner FAE. (4) DMIC signals and S-DMIC signals cannot be connected simultaneously.

Sheet: 3 Signal Description
Signal Name | Description | Type
Audio Codec
MICIN1P | Microphone Differential Positive Input 1 | AI
MICIN1N | Microphone Differential Negative Input 1 | AI
MICIN2P | Microphone Differential Positive Input 2 | AI
MICIN2N | Microphone Differential Negative Input 2 | AI
MICIN3P | Microphone Differential Positive Input 3 | AI
MICIN3N | Microphone Differential Negative Input 3 | AI
LINEOUTLP | Lineout Left Channel Positive Differential Output | AO
LINEOUTLN | Lineout Left Channel Negative Differential Output | AO
LINEOUTRP | Lineout Right Channel Positive Differential Output | AO
LINEOUTRN | Lineout Right Channel Negative Differential Output | AO
HPOUTL | Headphone Left Output | AO
HPOUTR | Headphone Right Output | AO
HPOUTFB | Pseudo Differential Headphone Ground Reference | AI
MIC-DET | Headphone MIC detect | AI
HP-DET | Headphone Jack detect | AI
MBIAS | First bias voltage output for main microphone | AO
HBIAS | Second bias voltage output for headset microphone | AO
VRA1 | Internal Reference Voltage | AO
VRA2 | Internal Reference Voltage | AO
CPVDD | Analog power for headphone charge pump | P
CPVEE | Charge pump negative voltage output | P
CPVIN | Analog power for LDO | P
AVCC | Power Supply for Analog Part | P
ALDO-OUT | Power Supply for AVCC | P
VDD33 | Power Supply for 3.3V Analog Part | P
VEE | Negative Voltage to Headphone | P
VRP | High Reference Voltage | P
AGND | Analog Ground | G
CIR_RX
IR-RX | Consumer Infrared Receiver | I
S-IR-RX | Consumer infrared Receiver | I
CIR_TX
IR-TX | Consumer Infrared Transmitter | O
DCXO
DXIN | Digital Compensated Crystal Oscillator Input | AI
DXOUT | Digital Compensated Crystal Oscillator Output | AO
REFCLK-OUT | Digital Compensated Crystal Oscillator Clock Fanout | AO
WREQIN | Request signal of REFCLK_OUT | I
VCC-DCXO | Digital Compensated Crystal Oscillator Power Supply | P
DMIC
DMIC-DATA[3:0] | Digital Microphone Data Input | I
DMIC-CLK | Digital Microphone Clock Output | O
S-DMIC-DATA[3:0] | Digital Microphone Data Input | I
S-DMIC-CLK | Digital Microphone Clock Output | O
eDP1.3
EDP-AUXP | AUX channel Positive Input/Output | A I/O
EDP-AUXN | AUX channel Negative Input/Output | A I/O
EDP-HPD | Hot Plug Detection Signal | AI
EDP-REXT | eDP External Reference Resistor | AO
EDP-TX0P | eDP Positive Output of Data Channel0 | AO
EDP-TX0N | eDP Negative Output of Data Channel0 | AO
EDP-TX1P | eDP Positive Output of Data Channel1 | AO
EDP-TX1N | eDP Negative Output of Data Channel1 | AO
EDP-TX2P | eDP Positive Output of Data Channel2 | AO
EDP-TX2N | eDP Negative Output of Data Channel2 | AO
EDP-TX3P | eDP Positive Output of Data Channel3 | AO
EDP-TX3N | eDP Negative Output of Data Channel3 | AO
VCC18-EDP | 1.8V Analog Supply | P
VDD09-EDP | 0.9V Digital Supply | P
GMAC
RGMII0-RXD0/RMII0-RXD0 | RGMII/RMII Receive Data0 | I
RGMII0-RXD1/RMII0-RXD1 | RGMII/RMII Receive Data1 | I
RGMII0-RXD2/RMII0-NULL | RGMII Receive Data2 | I
RGMII0-RXD3/RMII0-NULL | RGMII Receive Data3 | I
RGMII0-RXCK/ RMII0-NULL | RGMII Receive Clock | I
RGMII0-RXCTRL/RMII0-CRS-DV | RGMII Receive Control/RMII Carrier Sense Receive Data Valid | I
RGMII0-CLKIN/RMII0-RXER | RGMII Transmit Clock from External/RMII Receive Error | I
RGMII0-TXD0/RMII0-TXD0 | RGMII/RMII Transmit Data0 | O
RGMII0-TXD1/RMII0-TXD1 | RGMII/RMII Transmit Data1 | O
RGMII0-TXD2/RMII0-NULL | RGMII Transmit Data2 | O
RGMII0-TXD3/RMII0-NULL | RGMII Transmit Data3 | O
RGMII0-TXCK/RMII0-TXCK | RGMII/RMII Transmit Clock | I/O
 | For RGMII, IO type is output;
 | For RMII, IO type is input
RGMII0-TXCTRL/RMII0-TXEN | RGMII Transmit Control/RMII Transmit Enable | O
RGMII0-MDC | RGMII Management Data Clock | O
RGMII0-MDIO | RGMII Management Data Input/ Output | I/O
RGMII0-EPHY-25M | 25 MHz Output for GMAC PHY | O
GPADC
GPADC0 | General Purpose ADC Input Channel 0/ BROM Boot Select | AI
GPADC1 | General Purpose ADC Input Channel 1 | AI
GPADC2 | General Purpose ADC Input Channel 2 | AI
GPADC3 | General Purpose ADC Input Channel 3 | AI
VCM-ADC | External Capacitor Connection | A I/O
VREFP-ADC | GPADC Reference Voltage (Positive) | P
VREFN-ADC | GPADC Reference Voltage (Negative) | P
I2S/PCM
I2S0-DOUT[3:0] | I2S0/PCM0 Serial Data Output Channel [3:0] | O
I2S0-DIN[3:0] | I2S0/PCM0 Serial Data Input Channel [3:0] | I
I2S0-MCLK | I2S0 Master Clock | O
I2S0-LRCK | I2S0/PCM0 Sample Rate Clock/Sync | I/O
I2S0-BCLK | I2S0/PCM0 Bit Rate Clock | I/O
I2S1-DOUT[1:0] | I2S1/PCM1 Serial Data Output Channel [1:0] | O
I2S1-DIN[1:0] | I2S1/PCM1 Serial Data Input Channel [1:0] | I
I2S1-MCLK | I2S1 Master Clock | O
I2S1-LRCK | I2S1/PCM01Sample Rate Clock/Sync | I/O
I2S1-BCLK | I2S1/PCM1 Bit Rate Clock | I/O
I2S2-DOUT[3:0] | I2S2/PCM2 Serial Data Output Channel [3:0] | O
I2S2-DIN[3:0] | I2S2/PCM2 Serial Data Input Channel [3:0] | I
I2S2-MCLK | I2S2 Master Clock | O
I2S2-LRCK | I2S2/PCM2 Sample Rate Clock/Sync | I/O
I2S2-BCLK | I2S2/PCM2 Bit Rate Clock | I/O
I2S3-DOUT[3:0] | I2S3/PCM3 Serial Data Output Channel [3:0] | O
I2S3-DIN[3:0] | I2S3/PCM3 Serial Data Input Channel [3:0] | I
I2S3-MCLK | I2S3 Master Clock | O
I2S3-LRCK | I2S3/PCM3 Sample Rate Clock/Sync | I/O
I2S3-BCLK | I2S3/PCM3 Bit Rate Clock | I/O
S-I2S0-DIN[1:0] | S-I2S0/PCM0 Serial Data Input Channel [1:0] | I
S-I2S0-DOUT[1:0] | S-I2S0/PCM0 Serial Data Output Channel [1:0] | O
S-I2S0-MCLK | S-I2S0 Master Clock | O
S-I2S0-LRCK | S-I2S0/PCM0 Sample Rate Clock/Sync | I/O
S-I2S0-BCLK | S-I2S0/PCM0 Bit Rate Clock | I/O
JTAG
JTAG-MS | ARM CPU JTAG Mode Selection | I
JTAG-CK | ARM CPU JTAG Clock Signal | I
JTAG-DO | ARM CPU JTAG Data Output | O
JTAG-DI | ARM CPU JTAG Data Input | I
S-JTAG-MS | CPUS JTAG Mode Selection | I
S-JTAG-CK | CPUS JTAG Clock Signal | I
S-JTAG-DO | CPUS JTAG Data Output | O
S-JTAG-DI | CPUS JTAG Data Input | I
S-RJTAG-MS | RISC-V JTAG Mode Select | I
S-RJTAG-CK | RISC-V JTAG Clock Signal | I
S-RJTAG-DO | RISC-V JTAG Data Output | O
S-RJTAG-DI | RISC-V JTAG Data Input | I
LEDC
LEDC | Intelligent Control LED Signal Output | O
LRADC
LRADC0 | Low Rate ADC | AI
LRADC1 | Low Rate ADC | AI
MIPI CSI
MCSIA-D0P | MIPI CSI Controller A Data0 Positive Signal | AI
MCSIA-D0N | MIPI CSI Controller A Data0 Negative Signal | AI
MCSIA-D1P | MIPI CSI Controller A Data1 Positive Signal | AI
MCSIA-D1N | MIPI CSI Controller A Data1 Negative Signal | AI
MCSIA-CKP | MIPI CSI Controller A Clock Positive Signal | AI
MCSIA-CKN | MIPI CSI Controller A Clock Negative Signal | AI
MCSI0-MCLK | Master Clock for MIPI Sensor | O
MCSIB-D0P | MIPI CSI Controller B Data0 Positive Signal | AI
MCSIB-D0N | MIPI CSI Controller B Data0 Negative Signal | AI
MCSIB-D1P | MIPI CSI Controller B Data1 Positive Signal | AI
MCSIB-D1N | MIPI CSI Controller B Data1 Negative Signal | AI
MCSIB-CKP | MIPI CSI Controller B Clock Positive Signal | AI
MCSIB-CKN | MIPI CSI Controller B Clock Negative Signal | AI
MCSI1-MCLK | Master Clock for MIPI Sensor | O
MCSIC-D0P | MIPI CSI Controller C Data0 Positive Signal | AI
MCSIC-D0N | MIPI CSI Controller C Data0 Negative Signal | AI
MCSIC-D1P | MIPI CSI Controller C Data1 Positive Signal | AI
MCSIC-D1N | MIPI CSI Controller C Data1 Negative Signal | AI
MCSIC-CKP | MIPI CSI Controller C Clock Positive Signal | AI
MCSIC-CKN | MIPI CSI Controller C Clock Negative Signal | AI
MCSI2-MCLK | Master Clock for MIPI Sensor | O
MCSID-D0P | MIPI CSI Controller D Data0 Positive Signal | AI
MCSID-D0N | MIPI CSI Controller D Data0 Negative Signal | AI
MCSID-D1P | MIPI CSI Controller D Data1 Positive Signal | AI
MCSID-D1N | MIPI CSI Controller D Data1 Negative Signal | AI
MCSID-CKP | MIPI CSI Controller D Clock Positive Signal | AI
MCSID-CKN | MIPI CSI Controller D Clock Negative Signal | AI
MCSI3-MCLK | Master Clock for MIPI Sensor | O
CSI0-XVS-FSYNC | CSI Vertical SYNC/Frame SYNC | I/O
CSI1-XVS-FSYNC | CSI Vertical SYNC/Frame SYNC | I/O
VCC-MCSI | Power Supply for MIPI CSI | P
MIPI DSI
DSI0-D0P | DSI0 Differential Data0 Positive Signal | I/O
DSI0-D0N | DSI0 Differential Data0 Negative Signal | I/O
DSI0-D1P | DSI0 Differential Data1 Positive Signal | O
DSI0-D1N | DSI0 Differential Data1 Negative Signal | O
DSI0-D2P | DSI0 Differential Data2 Positive Signal | O
DSI0-D2N | DSI0 Differential Data2 Negative Signal | O
DSI0-D3P | DSI0 Differential Data3 Positive Signal | O
DSI0-D3N | DSI0 Differential Data3 Negative Signal | O
DSI0-CKP | DSI0 Differential Clock Positive Signal | O
DSI0-CKN | DSI0 Differential Clock Negative Signal | O
DSI1-D0P | DSI1 Differential Data0 Positive Signal | I/O
DSI1-D0N | DSI1 Differential Data0 Negative Signal | I/O
DSI1-D1P | DSI1 Differential Data1 Positive Signal | O
DSI1-D1N | DSI1 Differential Data1 Negative Signal | O
DSI1-D2P | DSI1 Differential Data2 Positive Signal | O
DSI1-D2N | DSI1 Differential Data2 Negative Signal | O
DSI1-D3P | DSI1 Differential Data3 Positive Signal | O
DSI1-D3N | DSI1 Differential Data3 Negative Signal | O
DSI1-CKP | DSI1 Differential Clock Positive Signal | O
DSI1-CKN | DSI1 Differential Clock Negative Signal | O
NAND Flash
NAND-WE | Nand Flash Write Enable | O
NAND-ALE | Nand Flash Address Latch Enable | O
NAND-CLE | Nand Flash Command latch Enable | O
NAND-CE[1:0] | Nand Flash Chip Select | O
NAND-RE | Nand Flash Read Enable | O
NAND-RB[1:0] | Nand Flash Ready/Busy Status Indicator Signal | I
NAND-DQ[7:0] | Nand Flash Data Bit | I/O
NAND-DQS | Nand Flash Data Strobe | I/O
OWA
OWA-IN | One Wire Audio Input | I
OWA-OUT | One Wire Audio Output | O
Parallel CSI
NCSI-PCLK | Parallel CSI Pixel Clock | I
NCSI-MCLK | Parallel CSI Master Clock | O
NCSI-HSYNC | Parallel CSI Horizontal Synchronous | I
NCSI-VSYNC | Parallel CSI Vertical Synchronous | I
NCSI-D[15:0] | Parallel CSI Data Bit | I
PCIe2.1&USB3.1 DRD
USB2-DP | USB2.0 Data Signal DP | A I/O
USB2-DM | USB2.0 Data Signal DM | A I/O
USB2-REXT | USB2.0 External Reference Resistor | AO
PCIE-REF-CLKP | PCIe2.1 Differential Signal REFCLK (Positive) | A I/O
PCIE-REF-CLKN | PCIe2.1 Differential Signal REFCLK (Negative) | A I/O
PCIE-REXT | PCIe2.1 External Reference Resistor | AO
PCIE-RX0-DP/USB3-RXP | PCIe2.1 Differential Signal of RX (Positive)/USB3.1 SuperSpeed Differential Signal of RX (Positive) | AI
PCIE-RX0-DN /USB3-RXN | PCIe2.1 Differential Signal of RX (Negative)/USB3.1 SuperSpeed Differential Signal of RX (Negative) | AI
PCIE-TX0-DP/USB3-TXP | PCIe2.1 Differential Signal of TX (Positive)/USB3.1 SuperSpeed Differential Signal of TX (Positive) | AO
PCIE-TX0-DN/USB3-TXN | PCIe2.1 Differential Signal of TX (Negative)/USB3.1 SuperSpeed Differential Signal of TX (Negative) | AO
PCIE0-PERSTN | PCIe2.1 Fundamental Reset | O
PCIE0-WAKEN | PCIe2.1 Wake Up | I
PCIE0-CLKREQN | PCIe2.1 Clock Request from PCIe Peripheral | I
VCC33-USB-2 | 3.3 V Power Supply for USB2.0 PHY | P
VCC33-18-USB-2 | 3.3 V Power Supply for USB2.0 PHY | P
VCC18-PCIE | 1.8 V Power Supply for PCIe2.1 | P
VDD09-PCIE | 0.9 V Power Supply for PCIe2.1 | P
PWM
PWM0-[15:0] | Pulse Width Modulation Output Channel [15:0] | I/O
PWM1-[3:0] | Pulse Width Modulation Output Channel [3:0] | I/O
S-PWM0-[1:0] | Pulse Width Modulation Output Channel [1:0] | I/O
MCU-PWM0-[7:0] | Pulse Width Modulation Output Channel [7:0] | I/O
RTC&PLL
X32KFOUT | 32.768 kHz clock Fanout | AO,OD
 | Provides low frequency clock for external devices
X32KIN | Clock Input of 32.768 kHz Crystal | AI
X32KOUT | Clock Output of 32.768 kHz Crystal | AO
PLLTEST | PLL Test Signal | AO, OD
VCC-RTC | RTC Power | P
VCC-PLL | Power Supply for System PLL | P
SDRAM
SA[17:0] | DRAM Address Signal to the Memory Device | O
SACT | DRAM Activation Command Output | O
SBA[1:0] | DRAM Bank Address Signal to the Memory Device | O
SBG[1:0] | DRAM Bank Group Address Signal to the Memory Device | O
SCKE | DRAM Clock Enable Signal to the Memory Device | O
SCKN | DRAM Active-Low Clock Signal to the Memory Device | O
SCKP | DRAM Active-High Clock Signal to the Memory Device | O
SCS[1:0] | DRAM Chip Select Signal to the Memory Device | O
SDQ[31:0] | DRAM Bidirectional Data Line to the Memory Device | I/O
SDQM[3:0] | DRAM Data Mask Signal to the Memory Device | I/O
SDQS[3:0]P | DRAM Active-High Bidirectional Data Strobes to the Memory Device | I/O
SDQS[3:0]N | DRAM Active-Low Bidirectional Data Strobes to the Memory Device | I/O
SODT[1:0] | DRAM On-Die Termination Output Signal | O
SRST | DRAM Reset Signal to the Memory Device | O
SZQ | DRAM ZQ Calibration(the signal connects to an external reference resistor which is used to calibrate DRAM input/output buffer) | AI
VCC-DRAM | Power Supply for DRAM IO | P
VCC-DRAML | Power Supply for DRAM IO | P
VDD18-DRAM | DRAM 1.8V Internal PAD Power | P
SPI&SPI_DBI
SPI0-CS[1:0] | SPI0 Chip Select Signal, Low Active | I/O
SPI0-CLK | SPI0 Clock Signal | I/O
 | Provides serial interface timing.
SPI0-MOSI | SPI0 Master Data Out, Slave Data In | I/O
SPI0-MISO | SPI0 Master Data In, Slave Data Out | I/O
SPI0-WP | SPI0 Write Protect, Low Active | I/O
 | Protects the memory area against all program or erase instructions.
 | It also can be used for serial data input and output for SPI Quad Input or Quad Output mode.
SPI0-HOLD | SPI0 Hold Signal | I/O
 | Pauses any serial communication with the device without deselecting or resetting it.
 | It also can be used for serial data input and output for SPI Quad Input or Quad Output mode.
SPI1-CS0 | SPI1 Chip Select Signal, Low Active | I/O
SPI1-CLK | SPI1 Clock Signal | I/O
 | Provides serial interface timing.
SPI1-MOSI | SPI1 Master Data Out, Slave Data In | I/O
SPI1-MISO | SPI1 Master Data In, Slave Data Out | I/O
SPI1-WP | SPI1 Write Protect, Low Active | I/O
 | Protects the memory area against all program or erase instructions.
 | It also can be used for serial data input and output for SPI Quad Input or Quad Output mode.
SPI1-HOLD | SPI1 Hold Signal | I/O
 | Pauses any serial communication with the device without deselecting or resetting it.
 | It also can be used for serial data input and output for SPI Quad Input or Quad Output mode.
SPI2-CS0 | SPI2 Chip Select Signal, Low Active | I/O
SPI2-CLK | SPI2 Clock Signal | I/O
 | Provides serial interface timing.
SPI2-MOSI | SPI2 Master Data Out, Slave Data In | I/O
SPI2-MISO | SPI2 Master Data In, Slave Data Out | I/O
DBI-CSX | Chip Select Signal, Low Active | I/O
DBI-SCLK | Serial Clock Signal | I/O
DBI-SDO | Data Output Signal | I/O
DBI-SDI | Data Input Signal | I/O
 | The data is sampled on the rising edge and the falling edge
DBI-TE | Tearing Effect Input | I/O
 | It is used to capture the external TE signal edge. The rising and falling edge is configurable.
DBI-DCX | DCX pin is the select output signal of data and command. | I/O
 | DCX = 0: register command;
 | DCX = 1: data or parameter.
DBI-WRX | When DBI operates in dual data lane format, the RGB666 format 2 can use WRX to transfer data | I/O
S-SPI0-CS0 | S-SPI0 Chip Select Signal, Low Active | I/O
S-SPI0-CLK | S-SPI0 Clock Signal | I/O
 | Provides serial interface timing.
S-SPI0-MOSI | S-SPI0 Master Data Out, Slave Data In | I/O
S-SPI0-MISO | S-SPI0 Master Data In, Slave Data Out | I/O
SPIFC
SPIF-CS 0 | SPI Peripheral Chip Select Signal, Low Active | O
SPIF-CLK | SPI Master Mode Clock Output | O
SPIF-MOSI | SPI Master Data Out, Slave Data In | I/O
SPIF-MISO | SPI Master Data In, Slave Data Out | I/O
SPIF-DQS | Data Strobe Signal | I
SPIF-D[7:4] | SPI Master Mode Data in Octal Mode | I/O
SPIF-WP | SPI Write Protect, Low Active | I/O
SPIF-HOLD | SPI Hold Signal | I/O
SMHC
SDC0-CMD | Command Signal for SD Card | I/O, OD
SDC0-CLK | Clock for SD Card | O
SDC0-D[3:0] | Data Input and Output for SD Card | I/O
SDC1-CMD | Command Signal for SDIO WIFI | I/O, OD
SDC1-CLK | Clock for SDIO WIFI | O
SDC1-D[3:0] | Data Input and Output for SDIO WIFI | I/O
SDC2-CMD | Command Signal for eMMC | I/O, OD
SDC2-CLK | Clock for eMMC | O
SDC2-D[8:0] | Data Input and Output for eMMC | I/O
SDC2-RST | Reset for eMMC | O
SDC2-DS | Data Strobe for eMMC | I
System
FEL | Boot Select | I
 | Jump to the Try Media Boot process when FEL is high level, or else enter into the mandatory upgrade process.
JTAG-SEL | JTAG mode select | I
 | The signal is used to select the port from which JTAG function outputs.
NMI | Non-Maskable Interrupt | I/O, OD
RESET | Reset Signal (Low Active) | I/O, OD
TCONLCD
LCD0-D[23:0] | LCD Data Input/Output | I/O
LCD0-CLK | LCD Clock | O
 | The pixel data are synchronized by this clock
LCD0-VSYNC | LCD Vertical Sync | O
 | It indicates one new frame
LCD0-HSYNC | LCD Horizontal Sync | O
 | It indicates one new scan line
LCD0-DE | LCD Data Output Enable | O
LCD0-TRIG | LCD0 Sync It is input from peripherals for sync | I
LCD1-TRIG | LCD1 Sync It is input from peripherals for sync | I
LVDS0-D[3:0]P | LVDS0 Positive Port of Data Channel [3:0] | AO
LVDS0-D[3:0]N | LVDS0 Negative Port of Data Channel [3:0] | AO
LVDS0-CKP | LVDS0 Positive Port of Clock | AO
LVDS0-CKN | LVDS0 Negative Port of Clock | AO
LVDS1-D[3:0]P | LVDS1 Positive Port of Data Channel [3:0] | AO
LVDS1-D[3:0]N | LVDS1 Negative Port of Data Channel [3:0] | AO
LVDS1-CKP | LVDS1 Positive Port of Clock | AO
LVDS1-CKN | LVDS1 Negative Port of Clock | AO
TWI
TWI0-SCK | TWI0 Serial Clock Signal | I/O
TWI0-SDA | TWI0 Serial Data Signal | I/O
TWI1-SCK | TWI1 Serial Clock Signal | I/O
TWI1-SDA | TWI1 Serial Data Signal | I/O
TWI2-SCK | TWI2 Serial Clock Signal | I/O
TWI2-SDA | TWI2 Serial Data Signal | I/O
TWI3-SCK | TWI3 Serial Clock Signal | I/O
TWI3-SDA | TWI3 Serial Data Signal | I/O
TWI4-SCK | TWI4 Serial Clock Signal | I/O
TWI4-SDA | TWI4 Serial Data Signal | I/O
TWI5-SCK | TWI5 Serial Clock Signal | I/O
TWI5-SDA | TWI5 Serial Data Signal | I/O
S-TWI0-SCK | S-TWI0 Serial Clock Signal | I/O
S-TWI0-SDA | S-TWI0 Serial Data Signal | I/O
S-TWI1-SCK | S-TWI1 Serial Clock Signal | I/O
S-TWI1-SDA | S-TWI1 Serial Data Signal | I/O
S-TWI2-SCK | S-TWI2 Serial Clock Signal | I/O
S-TWI2-SDA | S-TWI2 Serial Data Signal | I/O
USB2.0 DRD
USB0-DP | USB2.0 Data Signal DP | A I/O
USB0-DM | USB2.0 Data Signal DM | A I/O
USB0-REXT | USB2.0 External Reference Resistor | AO
VCC33-USB | 3.3 V Analog Power Supply for USB2.0 DRD and USB2.0 Host | P
VCC33-18-USB | 3.3 V Analog Power Supply for USB2.0 DRD and USB2.0 Host | P
VDD09-USB | 0.9V USB Digital Power Supply | p
USB2.0 Host
USB1-DP | USB2.0 Data Signal DP | A I/O
USB1-DM | USB2.0 Data Signal DM | A I/O
USB1-REXT | USB2.0 External Reference Resistor | AO
UART
UART0-TX | UART0 Data Transmitter | O
UART0-RX | UART0 Data Receiver | I
UART1-TX | UART1 Data Transmitter | O
UART1-RX | UART1 Data Receiver | I
UART1-CTS | UART1 Data Clear to Send | I
UART1-RTS | UART1 Data Request to Send | O
UART2-TX | UART2 Data Transmitter | O
UART2-RX | UART2 Data Receiver | I
UART2-CTS | UART2 Data Clear to Send | I
UART2-RTS | UART2 Data Request to Send | O
UART3-TX | UART3 Data Transmitter | O
UART3-RX | UART3 Data Receiver | I
UART3-CTS | UART3 Data Clear to Send | I
UART3-RTS | UART3 Data Request to Send | O
UART4-TX | UART4 Data Transmitter | O
UART4-RX | UART4 Data Receiver | I
UART4-CTS | UART4 Data Clear to Send | I
UART4-RTS | UART4 Data Request to Send | O
UART5-TX | UART5 Data Transmitter | O
UART5-RX | UART5 Data Receiver | I
UART5-CTS | UART5 Data Clear to Send | I
UART5-RTS | UART5 Data Request to Send | O
UART6-TX | UART6 Data Transmitter | O
UART6-RX | UART6 Data Receiver | I
UART6-CTS | UART6 Data Clear to Send | I
UART6-RTS | UART6 Data Request to Send | O
UART7-TX | UART7 Data Transmitter | O
UART7-RX | UART7 Data Receiver | I
UART7-CTS | UART7 Data Clear to Send | I
UART7-RTS | UART7 Data Request to Send | O
S-UART0-TX | S-UART0 Data Transmitter | O
S-UART0-RX | S-UART0 Data Receiver | I
S-UART1-TX | S-UART1 Data Transmitter | O
S-UART1-RX | S-UART1 Data Receiver | I

Sheet: 4 Pin Map
 | 1 | 2 | 3 | 4 | 5 | 6 | 7 | 8 | 9 | 10 | 11 | 12 | 13 | 14 | 15 | 16 | 17 | 18 | 19 | 20 | 21 | 22 | 23 | 24 | 25 | 26 | 27 | 28 | 29
A | GND | GND | PK2 | PK0 | PH16 | PH14 |  | PH11 |  | PH4 |  | PF3 |  | AVSS |  | PCIE-RX0-DP/USB3-RXP |  | USB0-DP |  | EDP-TX1P |  | EDP-TX3P |  | PD0 | PD2 | PD4 | PD6 | PD8 | GND | 1
B | PK5 | PK4 | PK3 | PK1 | PH17 | PH15 | PH13 | PH10 | PH5 | PH3 | PF5 | PF2 | PF1 | PCIE-REF-CLKP | PCIE-TX0-DP/USB3-TXP | PCIE-RX0-DN/USB3-RXN | USB2-DP | USB0-DM | EDP-TX0P | EDP-TX1N | EDP-TX2P | EDP-TX3N | EDP-AUXP | PD1 | PD3 | PD5 | PD7 | PD9 | GND | 2
C | PK13 | PK12 | GND | PK7 | PK6 | GND | PH12 | GND | PH6 | GND | PF4 | PF6 | PF0 | PCIE-REF-CLKN | PCIE-TX0-DN/USB3-TXN | AVSS | USB2-DM | AVSS | EDP-TX0N | AVSS | EDP-TX2N | AVSS | EDP-AUXN | GND | GND | GND | GND | PD10 | PD11 | 3
D | PK15 | PK14 |  |  |  | PH18 |  | PH9 |  | PH2 |  | GND |  | AVSS |  | USB2-REXT |  | USB1-REXT |  | USB1-DP |  | EDP-REXT |  |  |  |  |  | PD12 | PD13 | 4
E | PK17 | PK16 | GND | PK9 | PK8 | PH19 |  | PH8 |  | PH1 |  | FEL |  | PCIE-REXT |  | VCC33-18-USB-2 |  | USB0-REXT |  | USB1-DM |  | EDP-HPD |  | GND | PD17 | PD16 | GND | PD14 | PD15 | 5
F | PK18 | PK19 |  |  |  |  |  | PH7 |  | PH0 |  | JTAG-SEL |  | NC |  | AVSS |  | AVSS |  | AVSS |  | AVSS |  |  |  |  |  | PD19 | PD18 | 6
G | PK21 | PK20 | GND | PK11 | PK10 | GND | GND |  |  |  |  |  |  |  |  |  |  |  |  |  |  |  | GND | GND | PD22 | PD23 | GND | PD20 | PD21 | 7
H | PK23 | PK22 |  |  |  |  |  |  | GND | VCC-MCSI | GND | VCC18-PCIE | AVSS | VDD09-PCIE | VDD09-USB | AVSS | VCC33-USB | VCC33-18-USB | AVSS | VCC18-EDP | VDD09-EDP |  |  |  |  |  | PB2 | PB3 |  | 8
J | PE0 | PE1 | GND | PE8 | PE9 | VCC-PE | VCC-PK |  |  | GND |  | VCC-IO | AVSS |  | VCC33-USB-2 | AVSS |  | AVSS | AVSS |  |  | GND | VCC-PD | PB0 | PB1 | GND | PB4 | PB5 | PB6 | 9
K | PE3 | PE2 |  |  |  |  |  |  | GND | VDD-VE |  | GND |  |  | GND | GND |  | GND | VDD-DE |  | VCC-LVDS0 |  |  |  |  |  | PB7 | PB8 |  | 10
L | PE4 | PE5 | GND | PE12 | PE13 | GND | GND |  | GND | VDD-VE |  |  | GND |  | VDD-SYSFB | GND |  | VDD-DE | VDD-DE |  | GND |  | GND | PB9 | PB10 | PB11 | PB12 | PB13 | PB14 | 11
M | PE6 | PE7 |  |  |  |  |  |  | GND | GND |  | VDD-SYS |  | VDD-SYS | VDD-SYS | GND |  |  | VDD-CPUBFB |  | GND |  |  |  |  |  | PC16 | PC15 |  | 12
N | PE10 | PE11 | GND | PE14 | PE15 | VCC-PG | GND | VDD-GPU |  | VDD-GPU |  | GND | GND |  | GND | VDD-CPUB |  | VDD-CPUB | VDD-CPUB |  | GND | VCC-PC | VCC-EFUSE | PC4 | PC3 | PC2 | PC14 | PC13 | PC12 | 13
P |  | PG3 | PG2 |  |  |  |  |  | VDD-GPU | VDD-GPU | GND |  | GND |  | VDD-CPUB | VDD-CPUB |  | VDD-CPUB | VDD-CPUB |  |  |  |  |  |  |  | PC11 | PC10 |  | 14
R | PG0 | PG1 | GND | PG8 | PG6 | GND | GND |  |  |  |  |  |  |  | GND | GND |  |  |  |  |  |  | GND | PC0 | PC7 | GND | PC9 | PC8 | PC6 | 15
T |  | PG5 | PG4 |  |  |  |  |  | GND | GND |  | GND | GND |  |  | VDD-CPUL |  | VDD-CPUL | GND | VCC-DRAM | VCC-DRAM | VCC-DRAM |  |  |  |  | PC1 | PC5 |  | 16
U | PG10 | PG11 | PG7 | PG9 | PG14 | VCM-ADC | VREFN-ADC |  | VDD-DNR | VDD-DNR |  | GND |  |  | GND | VDD-CPUL |  | VDD-CPUL | GND | GND | VCC-DRAM |  | SDQ15 | SDQ14 | SZQ | GND | SDQ13 | GND | SDQ12 | 17
V |  | PG12 | PG13 |  |  |  |  |  | VDD-DNR | VDD-DNR |  | GND | GND |  | GND | VDD-CPULFB |  | GND | GND |  | VCC-DRAM |  |  |  |  |  |  | SDQS1P | SDQS1N | 18
W | GND | GPADC0 | GPADC1 | GPADC2 | GPADC3 | VREFP-ADC | AVCC | GND | GND | VDD-DNRFB |  | GND |  | GND |  |  |  |  |  |  | VCC-DRAM |  | SDQ8 | SDQ9 | GND | SDQ10 | SDQ11 | SDQM1 | GND | 19
Y | LRADC0 | LRADC1 |  |  |  |  |  |  |  |  |  | VDD-CPUS |  | VCC-DRAML | VCC-DRAML | VCC-DRAML | VCC-DRAML |  | VCC-DRAML |  | VCC-DRAM |  |  |  |  |  |  | SDQ5 | SDQ7 | 20
AA | MICIN1N | MICIN1P | AGND | VRP | VDD33 | GND | GND |  | VCC-PL | VCC-RTC | GND | VCC-DCXO |  |  |  |  | GND | GND | GND | GND | VDD18-DRAM |  | SDQ1 | SDQ0 | GND | SDQ4 | SDQ6 | GND | SDQM0 | 21
AB | MICIN2N | MICIN2P |  |  |  |  |  |  |  |  |  |  | VCC-PLL |  |  |  |  |  |  |  |  |  |  |  |  |  |  | SDQS0P | SDQS0N | 22
AC | MICIN3N | MICIN3P | VRA2 | VRA1 | CPVEE |  | VCC-PM |  | PL10 |  | RESET |  | GND |  | SDQ24 |  | SDQ23 |  | SRST |  | GND |  |  | GND | SA10 | SA1 | GND | SDQ2 | GND | 23
AD | LINEOUTLN | LINEOUTLP |  |  |  |  | GND |  | PL11 |  | NMI |  | PLLTEST |  | SDQ25 |  | SDQ31 |  | SDQ18 |  | SA4 |  | GND |  |  |  |  | GND | SDQ3 | 24
AE | LINEOUTRN | LINEOUTRP | ALDO-OUT | VEE | CPVDD |  | PL13 |  | PL6 |  | TEST |  | WREQIN |  | GND |  | GND |  | GND |  | SBA1 |  | SA16 |  |  | SA17 | SA9 | SA11 | SA2 | 25
AF | MIC-DET | HP-DET |  |  |  |  | PL12 |  | PL7 |  | GND |  | GND |  | SDQ26 |  | SDQ30 |  | SDQ19 |  | SBA0 |  | SA5 |  | SA13 |  |  | GND | SA0 | 26
AG | MBIAS | HBIAS | CPVIN |  | GND |  | GND |  | PL9 | PL8 | X32KFOUT | GND | GND | GND | SDQ27 |  | SDQ29 |  | SDQ20 |  | SA8 |  | SA3 |  | SACT |  | SA12 | SODT0 | SODT1 | 27
AH | HPOUTL | HPOUTFB | GND | PM3 | PM2 | PM5 | PL1 | PL3 | PL4 | GND | X32KOUT | X32KIN | DXIN | REFCLK-OUT | SDQS3P | GND | SDQ28 | SDQ21 | SDQS2P | SDQM2 | SDQ16 | GND | SBG1 | SA14 | GND | SCKP | SCKE0 | SCS1 | SA7 | 28
AJ | GND | HPOUTR | PM1 | PM0 | PM4 | GND | PL0 | PL2 | PL5 |  | GND |  | DXOUT |  | SDQS3N | SDQM3 | SDQ22 | GND | SDQS2N | GND | SDQ17 | SBG0 | SA6 | GND | SA15 | SCKN | GND | SCS0 | GND | 29

Sheet: Declaration
Copyright©2024 Allwinner Technology Co.,Ltd. All Rights Reserved. This documentation is the original work and copyrighted property of Allwinner Technology Co.,Ltd (“Allwinner”). No part of this document may be reproduced, modify, publish or transmitted in any form or by any means without prior written consent of Allwinner. Trademarks and Permissions Allwinner and the Allwinner logo (incomplete enumeration) are trademarks of Allwinner Technology Co.,Ltd. All other trademarks, trade names, product or service names mentioned in this document are the property of their respective owners. Important Notice and Disclaimer The purchased products, services and features are stipulated by the contract made between Allwinner Technology Co.,Ltd (“Allwinner”) and the customer. All or part of the products, services and features described in this document may not be within the purchase scope or the usage scope. Please read the terms and conditions of the contract and relevant instructions carefully before using, and follow the instructions in this documentation strictly. Allwinner assumes no responsibility for the consequences of improper use (including but not limited to overvoltage, overclock, or excessive temperature). The information in this document is provided just as a reference or typical applications, and is subject to change without notice. Every effort has been made in the preparation of this document to ensure accuracy of the contents. Allwinner is not responsible for any damage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
