o7-machinehum/Blackpants/ee/integrated/AXP/pinout.csv

part | pin | name | type | unit | x | y
AXP323 | 1 | DCDC2 | input | 1 | 25.4 | -38.1
AXP323 | 2 | VIN3 | power_in | 1 | -25.4 | -60.96
AXP323 | 3 | LX3 | passive | 1 | 25.4 | -60.96
AXP323 | 4 | DCDC3 | input | 1 | 25.4 | -68.58
AXP323 | 5 | SDA | bidirectional | 1 | -25.4 | -96.52
AXP323 | 6 | SCL | bidirectional | 1 | -25.4 | -101.6
AXP323 | 7 | RTCLDO | power_out | 1 | 25.4 | -101.6
AXP323 | 8 | VREF | passive | 1 | 25.4 | -111.76
AXP323 | 9 | GND | power_in | 1 | -25.4 | -106.68
AXP323 | 10 | NC | no_connect | 1 | -25.4 | -111.76
AXP323 | 11 | IRQ | bidirectional | 1 | -25.4 | -91.44
AXP323 | 12 | DLDO1 | power_out | 1 | 25.4 | -91.44
AXP323 | 13 | PWROK | bidirectional | 1 | -25.4 | -86.36
AXP323 | 14 | PWRON | input | 1 | -25.4 | -81.28
AXP323 | 15 | ALDO1 | power_out | 1 | 25.4 | -81.28
AXP323 | 16 | DCDC1 | input | 1 | 25.4 | -7.62
AXP323 | 17 | VIN1 | power_in | 1 | -25.4 | 0.0
AXP323 | 18 | LX1 | passive | 1 | 25.4 | 0.0
AXP323 | 19 | LX2 | passive | 1 | 25.4 | -30.48
AXP323 | 20 | VIN2 | power_in | 1 | -25.4 | -30.48
AXP323 | 21 | EP | power_in | 1 | -25.4 | -109.22
AXP717C | 1 | PWROK | bidirectional | 1 | 25.4 | -48.26
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
