o7-machinehum/Blackpants/docs/a523/A523_hwref/PCB参考/硬件DDR模板&叠层文件/A523-REF-LPDDR4-342BALL-S6L-V2-0/Changlist_20240327.txt

20240329
1、修正V1_0中SoC端ZQ上拉VCC-DRAML为VCC-DRAM
