o7-machinehum/Blackpants/docs/a523/A523_eMMC_支持列表.xls

Sheet: 1-封面
 | Allwinner Technology
 | eMMC Support List
 | V1.139
2023-03-29

Sheet: 2-Note
• Note Introduction
Status | Description
D/S | Datasheet Supported but Need Sample to Full Test
S/T | Sample Full Test Passed and Supported
√ | Supported and Mass Production
X | Not Supported
(Blank) | Not Recommended or in Testing
A3 | Automotive AEC-Q100 Grade3
A2 | Automotive AEC-Q100 Grade2
A1 | Automotive AEC-Q100 Grade1
I | Industrial Grade
C | Commercial Grade

Sheet: 3-补丁
• Attention
This support list is based on the specified SD/eMMC driver version which includes sdk version and eMMC patch.
IC | SD/eMMC Version | SDK Version | eMMC_patch
H3 | V1.01 | homlet4.4.2-h3-v1.0rc2 | NO
 | V2.01 | H3-linux4.4
 | V 3.01 | H3-linux4.9
R333 | V1.01 | R333-linux4.9 | NO
H8 | V1.00 | H8 V1.0 | NO
 | v2.01 | H8 linux4.4
A83 | V1.01 | A83-android4.4.4-v0.9rc1 | NO
A80 | V1.01 | A80-v1.0-onda-rc3 | NO
A23 | V1.10 | A23-Android4.2-V2.0 | A23_Android4.2_V2.0_Android4.4_V1.0&V2.0_emmc_patch_20140525
 |  | A23-Android4.4-V1.0
 |  | A23-Android4.4-V2.0
A31(S) | V1.60 | A31(S)-Android4.4 | A31(S)_Android4.4_V4.4&V4.5&V4.6_nand2.0&emmc_patch_20140707.tar.gz
 |  | A31(S)-Android4.2 | A31(S)_Android4.2_V3.0&V3.2&V3.3_nand2.0&emmc_patch_20140625.tar.gz
A33 | V1.01 | A33-Android4.4.2-V1.0 | NO
 | V2.01 | A33-Android7.1.2 | A33_Android7.1.2&emmc_patch_20170424&avoid_host_dat0_busy_state_isnot_consistent_with_cmd13_prg_state.patch
A20 | V1.60 | A20-Homlet-Android4.2.2-SDK V2.1rc3 | A20_homlet-sugar42-v2.1_update_mmc_driver_2015-10-10.rar
A64 | V1.01 | exdroid-6.0.1_r3-a64-v2.0rc2 | NO
 | V2.01 | A64-linux4.4 | NO
 | V3.01 | A64-linux4.9 | NO
G102/G202 | V1.01 |  | NO
V40/A20E | V1.01 |  | NO
 | V2.01 | T3-linux4.9 | NO
H5 | V1.01 |  | NO
H6 | V1.01 |  | NO
 | V2.01 | H6-linux4.9 | NO
A63 | V1.01 |  | NO
 | V2.01 | A63-linux4.9 | NO
V5 | V1.01 |  | NO
T7 | V1.01 |  | NO
 | V2.01 | linux4.9 | NO
A50 | V1.01 | A50-linux4.9 | NO
C600 | V1.01 | c600-linux3.10 | NO
V316 | V1.01 | v316-linux4.9 | NO
H616 | V1.01 | H616-linux4.9；H616-Uboot2018 | NO
T507 | V1.01 | T507-linux4.9；T507-Uboot2018 | NO
A100 | V1.01 | A100-linux4.9；A100-Uboot2018 | NO
R329 | V1.01 | R329-linux4.9；R329-Uboot2018 | NO

Sheet: 4-器件列表
• Support List
Vendor | Capacity (B) | Part Number | eMMC /SD | Cell&Process | Pkg Size (mm) | Grade | Operating Temperature (Deg.C) | A523 | Remark
 |  |  |  |  |  |  |  | V1.01
 |  |  |  |  |  |  |  | linux 5.15
Samsung | 8G | KLM8G1WE4A-A001 | v4.41 |  | 12*16-BGA169 |  |  |  | EOL
 | 16G | KLMAG2WE4A-A001 | v4.41 |  | 12*16-BGA169 |  |  |  | EOL
 | 4G | KLM4G1FE3B-B001 | v4.41 |  | 11.5*13-BGA153 |  |  |  | EOL
 | 4G | KLM4G1YEMD-B031 | v5.0 | TLC/19nm | 11.5*13-BGA153 |  |  |  | EOL
 | 8G | KLM8G1WEMB-B031 | v5.0 | TLC/19nm | 11.5*13-BGA153 |  |  |  | EOL
 | 16G | KLMAG2WEMB-B031 | v5.0 | TLC/19nm | 11.5*13-BGA153 |  |  |  | EOL
 | 32G | KLMBG4WEBC-B031 | v5.0 | TLC/19nm | 11.5*13-BGA153 |  |  |  | EOL
 | 16G | KLMAG2GEAC-B031 | v5.0 | MLC/19nm | 11.5*13-BGA153 |  |  |  | EOL
 | 8G | KLM8G1GEAC-B031 | v5.0 | MLC/19nm | 11.5*13-BGA153 |  |  |  | EOL
 | 4G | KLM4G1FEAC-B031 | v5.0 | MLC/19nm | 11*10-BGA153 |  |  |  | EOL
 | 32G | KLMBG4GEAC-B031 | v5.0 | MLC/19nm | 11.5*13-BGA153 |  |  |  | EOL
 | 32G | KLMBG4GE2A-A001 | V4.5 | MLC | 12*16-BGA169 |  |  |  | EOL
 | 16G | KLMAG2GEND-B031 | v5.0 | MLC/16nm | 11.5*13-BGA153 |  | -25~+85 | S/T
 | 32G | KLMBG4GEND-B031 | v5.0 | MLC/16nm | 11.5*13-BGA153 |  | -25~+85 | S/T
 | 8G | KLM8G1WEPD-B031 | v5.0 | TLC/16nm | 11.5*13-BGA153 |  | -25~+85 | S/T
 | 16G | KLMAG2WEPD-B031 | v5.0 | TLC/16nm | 11.5*13-BGA153 |  | -25~+85 | S/T
 | 32G | KLMBG4WEBD-B031 | v5.0 | TLC/16nm | 11.5*13-BGA153 |  | -25~+85 | S/T
 | 64G | KLMCG8GEND-B031 | v5.0 | MLC/16nm | 11.5*13-BGA153 |  | -25~+85 | S/T
 | 8G | KLM8G1GEND-B031 | v5.0 | MLC/16nm | 11.5*13-BGA153 |  | -25~+85 | S/T
 | 64G | KLMCG8WEBD-B031 | v5.0 | TLC/16nm | 11.5*13-BGA153 |  | -25~+85 | S/T
 | 4G | KLM4G1FEPD-B031 | v5.0 | MLC/16nm | 11*10-BGA153 |  | -25~+85 | S/T
 | 8G | KLM8G1GEME-B041 | v5.1 | MLC/14nm | 11.5*13-BGA153 |  | -25~+85 | S/T
 | 16G | KLMAG1JENB-B041 | v5.1 | MLC/14nm | 11.5*13-BGA153 |  | -25~+85 | S/T
 | 32G | KLMBG2JENB-B041 | v5.1 | MLC/14nm | 11.5*13-BGA153 |  | -25~+85 | S/T
 | 64G | KLMCG4JENB-B041 | v5.1 | MLC/14nm | 11.5*13-BGA153 |  | -25~+85 | S/T
 | 8G | KLM8G1GETF-B041 | v5.1 | MLC/14nm | 11.5*13-BGA153 |  | -25~+85 | S/T
 | 16G | KLMAG1JETD-B041 | v5.1 | MLC/14nm | 11.5*13-BGA153 |  | -25~+85 | S/T
 | 32G | KLMBG2JETD-B041 | v5.1 | MLC/14nm | 11.5*13-BGA153 |  | -25~+85 | S/T
 | 64G | KLMCG4JETD-B041 | v5.1 | MLC/14nm | 11.5*13-BGA153 |  | -25~+85 | S/T
 | 8G | KLM8G1GESD-B04P | v5.1 | MLC/16nm | 11.5*13-BGA153 | A3 | -40 ~ +85 | S/T
 | 16G | KLMAG2GESD-B04P | v5.1 | MLC/16nm | 11.5*13-BGA153 | A3 | -40 ~ +85
 | 8G | KLM8G1GEUF-B04P | v5.1 |  | 11.5*13-BGA153 | A3 | -40 ~ +85 | S/T
 | 16G | KLMAG2GEUF-B04P | v5.1 |  | 11.5*13-BGA153 | A3 | -40 ~ +85 | S/T
 | 64G | KLMCG2UCTB-B041 | v5.1 |  | 11.5*13-BGA153 |  | -40 ~ +85
Sandisk | 8G | SDIN7DP2-8G | v4.5 |  | 11.5*13-BGA153 |  | -25~+85 |  | EOL
 | 16G | SDIN7DU2-16G | v4.41 |  | 11.5*13-BGA153 |  | -25~+85 |  | EOL
 | 4G | SDIN7DP2-4G | v4.5 |  | 11.5*13-BGA153 |  | -25~+85 |  | EOL
 | 8G | SDIN8DE1-8G | v4.5 | MLC/19nm | 11.5*13-BGA153 |  | -25~+85 |  | EOL
 | 8G | SDIN8DE2-8G | v4.5 | MLC/19nm | 11.5*13-BGA153 |  | -25~+85 |  | EOL
 | 8G | SDIN8DR1-8G | v4.51 | TLC/1Ynm | 11.5*13-BGA153 |  |  |  | EOL
 | 16G | SDIN8DR1-16G | v4.51 | TLC/1Ynm | 11.5*13-BGA153 |  |  |  | EOL
 | 4G | SDIN8DE2-4G | v4.51 | MLC/19nm | 11.5*13-BGA153 |  | -25~+85 |  | EOL
 | 8G | SDIN7DU2-8G | v4.41 |  | 11.5*13-BGA153 |  | -25~+85 |  | EOL
 | 16G | SDIN7DP4-16G | V4.51 | MLC | 11.5*13-BGA153 |  | -25~+85 |  | EOL
 | 16G | SDIN8DE4-16G | v4.51 | MLC/19nm | 11.5*13-BGA153 |  | -25~+85 |  | EOL
 | 16G | SDIN8DE2-16G | v4.51 | MLC/19nm | 11.5*13-BGA153 |  | -25~+85 |  | EOL
 | 32G | SDIN8DE4-32G | v4.51 | MLC/19nm | 11.5*13-BGA153 |  | -25~+85 |  | EOL
 | 16G | SDIN9DW4-16G | v5.0 | MLC/19nm | 11.5*13-BGA153 |  | -25~+85 |  | EOL
 | 32G | SDIN9DW4-32G | v5.0 | MLC/19nm | 11.5*13-BGA153 |  | -25~+85 |  | EOL
 | 64G | SDIN9DW4-64G | v5.1 | MLC/20nm | 11.5*13-BGA154 |  | -25~+85 |  | EOL
 | 32G | SDIN9DS2-32G | v5.0 | TLC/1Ynm | 11.5*13-BGA153 |  | -25~+85 |  | IO电压不支持3.3V,EOL
 | 16G | SDIN9DS2-16G | v5.0 | TLC/1Ynm | 11.5*13-BGA153 |  | -25~+85 |  | IO电压不支持3.3V,EOL
 | 32G | SDINADF4-32G-L | v5.1 | TLC/1Ynm | 11.5*13-BGA153 |  |  |  | IO电压不支持3.3V
 | 8G | SDIN9DS2-8G | v5.0 | TLC/1Ynm | 11.5*13-BGA153 |  | -25~+85 |  | IO电压不支持3.3V,EOL
 | 32G | SDINADF4-32G-H | v5.1 | TLC/15nm | 11.5*13-BGA153 |  | -25~+85 |  | IO电压不支持3.3V
 | 16G | SDINADF4-16G-H | v5.1 | TLC/15nm | 11.5*13-BGA153 |  | -25~+85 |  | IO电压不支持3.3V
 | 8G | SDIN8DE1-8G-XI | v4.51 | MLC/1xnm | 11.5*13-BGA153 | I | -40 ~ +85 |  | EOL
 | 8G | SDIN8DE2-8G-XA | v4.51 | MLC/1xnm | 11.5*13-BGA153 | A3 | -40 ~ +85 |  | EOL
 | 8G | SDIN8DE1-8G-I | v4.51 | MLC/1xnm | 11.5*13-BGA153 | I | -40 ~ +85 |  | EOL
 | 8G | SDIN8DE2-8G-A | v4.51 | MLC/1xnm | 11.5*13-BGA153 | A3 | -40 ~ +85 |  | EOL
 | 8G | SDINBDG4-8G | v5.1 | MLC/1znm | 11.5*13-BGA153 |  |  | S/T
 | 8G | SDINBDG4-8G-B | v5.1 | MLC/1znm | 11.5*13-BGA153
 | 16G | SDINBDG4-16G | v5.1 | MLC/1znm | 11.5*13-BGA153
 | 32G | SDINBDG4-32G | v5.1 | MLC/1znm | 11.5*13-BGA153 |  |  | S/T
 | 64G | SDINBDG4-64G | v5.1 | MLC/1znm | 11.5*13-BGA153 |  |  | S/T
 | 16G | SDINBDG4-16G-H | v5.1 | MLC/1znm | 11.5*13-BGA153
 | 32G | SDINBDG4-32G-H | v5.1 | MLC/1znm | 11.5*13-BGA153 |  |  | S/T
 | 32G | SDINBDA4-32G | v5.1 | 3D TLC | 11.5*13-BGA153 |  |  | S/T
 | 64G | SDINBDA4-64G | v5.1 | 3D TLC | 11.5*13-BGA153 |  |  | S/T
 | 16G | SDINBDG4-16G-XA | v5.1 | MLC | 11.5*13-BGA153 | A3 | -40 ~ +85 | S/T
 | 16G | SDINBDA6-16G | v5.0 | 3D TLC | 11.5*13-BGA153 |  | -25 ~ +85 | S/T
 | 32G | SDINBDA6-32G | v5.1 | 3D TLC | 11.5*13-BGA153 |  | -25 ~+85 | S/T
 | 16G | SDINBDA2-16G | v5.1 | 3D TLC | 11.5*13-BGA153 |  | -25 ~+85
 | 32G | SDINBDV4-32G | v5.1 | 96L X3 TLC | 11.5*13-BGA153 |  | -25 ~+85
 | 64G | SDINBDV4-64G | v5.1 | 96L X3 TLC | 11.5*13-BGA153 |  | -25 ~+85
 | 128G | SDINBDV4-128G | v5.1 | 96L X3 TLC | 11.5*13-BGA153 |  | -25 ~+85
Micron | 4G | 3EA28-JW878 (MTFC4GLWAM-WT) | v4.5 |  | 11.5*13-BGA153 |  |  |  | EOL
 | 8G | 3CA28-JW879 (MTFC8GLWAM-WT) | v4.5 |  | 11.5*13-BGA153 |  |  |  | EOL
 | 4G | 1UA18-JW729 (MTFC4GMTEA-WT) | v4.41 |  | 11.5*13-BGA153 |  |  |  | EOL
 | 8G | 2GA28-JW686 (MTFC8GLSEA-IT) | v4.41 |  | 11.5*13-BGA153 |  |  |  | EOL
 | 8G | 3ZA28-JWA48 (MTFC8GACAAEA-WT) | v4.51 | MLC | 11.5*13-BGA153 |  | -30 ~ +85 | S/T
 | 4G | 3ZA28-JWA49 (MTFC4GACAAEA-WT) | v4.51 | MLC | 11.5*13-BGA153 |  | -30 ~ +85 | S/T
 | 8G | 5QA27-JY995 (MTFC8GAKAJCN-1WMT) | v5.0 | MLC | 11.5*13-BGA153 |  |  | S/T
 | 4G | 6FA27-JY976 (MTFC4GACAJCN-1MWT) | v5.0 | MLC | 11.5*13-BGA153 |  |  | S/T
 | 16G | 6FA28-JWB74 (MTFC16GAKAECN-2MWT) | v5.0 | MLC | 11.5*13-BGA153
 | 32G | 5SA28-JWB79 (MTFC32GAKAECN-3MWT) | v5.0 | MLC | 11.5*13-BGA153 |  |  | S/T
 | 64G | MTFC64GANALAM-WT | v5.1
Toshiba | 4G | THGBM5G5A1JBAIR | v4.5 | MLC/19nm | 11.5*13-BGA153 |  |  |  | EOL
 | 8G | THGBM5G6A2JBAIR | v4.5 | MLC/19nm | 11.5*13-BGA153 |  |  |  | EOL
 | 16G | THGBMAG7A2JBAIR | v4.5 | 19nm | 11.5*13-BGA153 |  |  |  | EOL
 | 4G | THGBMAG5A1JBAIR | v4.5 | MLC/19nm | 11.5*13-BGA153 |  |  |  | EOL
 | 16G | THGBMBG7D4KBAIR | v5.0 | A19nm | 11.5*13-BGA153 |  |  |  | EOL
 | 32G | THGBMBG8D4KBAIR | v5.0 | MLC/A19nm | 11.5*13-BGA153 |  |  |  | EOL
 | 8G | THGBMBG6D1KBAIL | v5.0 | MLC/A19nm | 11.5*13-BGA153 |  |  |  | EOL
 | 16G | THGBMBG7D2KBAIL | v5.0 | MLC/A19nm | 11.5*13-BGA153 |  |  |  | EOL
 | 16G | THGBM5G7A2JBAIM | v5.0 |  | 11.5*13-BGA153
 | 32G | THGBM5G8A4JBAIM | v5.0 |  | 11.5*13-BGA153 |  |  | S/T
 | 16G | THGBM6G7T2JBAIM | v4.41 |  | 11.5*13-BGA153 |  |  | S/T
 | 8G | THGBM6G6T1JBAIR | v4.41 |  | 11.5*13-BGA153 |  |  | S/T
 | 16G | THGBM5G7A2JBAIR | v4.5 | MLC/19nm | 11.5*13-BGA153 |  |  |  | EOL
 | 16G | THGBMFG7C1LBAIL | v5.0 | MLC/15nm | 11.5*13-BGA153
 | 4G | THGBMBG5D1KBAIL | v5.0 | MLC/A19nm | 11.5*13-BGA153 |  | -25~+85 | S/T
 | 32G | THGBMFG8C2LBAIL | v5.0 | MLC/15nm | 11.5*13-BGA153 |  |  | S/T
 | 8G | THGBMFG6C1LBAIL | v5.0 | MLC/15nm | 11.5*13-BGA153 |  | -25~+85 | S/T
 | 4G | THGBMDG5D1LBAIL | v5.1 | MLC/15nm | 11.5*13-BGA153 |  | -25~+85
 | 8G | THGBMHG6C1LBAIL | v5.1 | MLC/15nm | 11.5*13-BGA153 |  | -25~+85 | S/T
 | 16G | THGBMHG7C1LBAIL | v5.1 | MLC/15nm | 11.5*13-BGA153 |  | -25~+85 | S/T
 | 32G | THGBMHG8C2LBAIL | v5.1 | MLC/15nm | 11.5*13-BGA153 |  | -25~+85 | S/T
 | 64G | THGBMHG9C4LBAIL | v5.1 | MLC/15nm | 11.5*13-BGA153 |  | -25~+85 | S/T
 | 16G | THGBMAG7C2LBAW7 | v5.1 | MLC/15nm | 11.5*13-BGA153 | I | -40 ~ +85 | S/T
 | 16G | THGBMHG7C2LBAAR | v5.1 | MLC/15nm | 11.5*13-BGA153 | A3 | -40 ~ +85 | S/T
 | 8G | THGBMHG6C1LBAWL | v5.1 | MLC | 11.5*13-BGA153 | I | -40 ~ +85
 | 16G | THGBMHG7C2LBAW7 | v5.1 |  | 11.5*13-BGA153 | I | -40 ~ +85 | S/T
 | 4G | THGBMNG5D1LBAIL | V5.0 | MLC/15nm | 11.5*13-BGA153 |  |  | S/T
 | 8G | THGBMJG6C1LBAU7 | V5.1 |  | 11.5*13-BGA153 | I | -40 ~ +85
 | 8G | THGBMJG6C1LBAIL | V5.1 |  | 11.5*13-BGA153 |  | -25~+85
 | 8G | THGBMHG6C1LBAW6 | v5.1 | MLC | 11.5*13-BGA153 | I | -40 ~ +85
KIOXIA | 16G | THGAMRG7T13BAIL | v5.1 |  | 11.5*13-BGA153 |  | -25~+85 |  | eMMC not support 3.3V
 | 32G | THGAMRG8T13BAIL | v5.1 |  | 11.5*13-BGA153 |  |  |  | eMMC not support 3.3V
 | 64G | THGAMRG9T23BAIL | v5.1 |  | 11.5*13-BGA153 |  |  |  | eMMC not support 3.3V
 | 128G | THGAMRT0T43BAIR | v5.1 |  | 11.5*13-BGA153 |  |  |  | eMMC not support 3.3V
 | 64G | THGAMRG9T23BAA8 | v5.1 |  | 11.5*13-BGA153 | A3 | -40 ~ +85 |  | eMMC not support 3.3V
 | 4G | THGBMTG5D1LBAIL | v5.0 |  | 11.5*13-BGA153 | C | -25~+85
 | 64G | THGAMSG9T24BAIL | v5.1 | 3D TLC/BiCS4 | 11.5*13-BGA153 |  |  |  | eMMC not support 3.3V
SKhynix | 4G | H26M31003GMR | v4.51 | MLC/20nm | 11.5*13-BGA153 |  |  |  | EOL
 | 8G | H26M42003GMR | v4.51 | MLC/20nm | 11.5*13-BGA153 |  |  |  | EOL
 | 16G | H26M52003EQR | v4.51 | MLC/20nm | 12*16-BGA169 |  |  |  | EOL
 | 8G | H26M41103HPR | v5.0 | MLC/16nm | 11.5*13-BGA153 |  |  |  | EOL,LTB：Jun. 30th, 2019
 | 16G | H26M52103FMR | v5.0 | MLC/16nm | 11.5*13-BGA153 |  |  |  | EOL,LTB：Jun. 30th, 2019
 | 4G | H26M31001HPR | v4.5 | MLC/16nm | 11.5*13-BGA153 |  |  |  | EOL,LTB：Jun. 30th, 2019
 | 32G | H26M64103EMR | v5.0 | MLC/16nm | 11.5*13-BGA153 |  |  |  | EOL,LTB：Jun. 30th, 2019
 | 8G | H26M41103HPRL | v5.0 | MLC/16nm | 11.5*13-BGA153 |  |  |  | EOL,LTB：Jun. 30th, 2019
 | 8G | H26T43001HPR | v5.0 | TLC/16nm | 11.5*13-BGA153 |  |  |  | EOL
 | 16G | H26T55001FPR | v5.0 | TLC/16nm | 11.5*13-BGA153 |  |  |  | EOL
 | 32G | H26T65001EMR | v5.0 | TLC/16nm | 11.5*13-BGA153 |  |  |  | EOL
 | 16G | H26M52208FPR | v5.1 | MLC/16nm | 11.5*13-BGA153 |  |  |  | EOL,LTB：Jun. 30th, 2019
 | 8G | H26M41204HPR | v5.1 | MLC/16nm | 11.5*13-BGA153 |  |  |  | EOL
 | 32G | H26M64208EMR | v5.1 | MLC/16nm | 11.5*13-BGA153 |  |  |  | EOL,LTB：Jun. 30th, 2019
 | 32G | H26M64208EMRA | v5.1 |  | 11.5*13*1.0-153FBGA
 | 32G | H26M64208EMRQ | v5.1 |  | 11.5*13*1.0-153FBGA
 | 8G | H26M41208HPR | v5.1 | MLC/16nm | 11.5*13-BGA153 |  |  | S/T
 | 64G | H26M78208CMR | v5.1 | MLC/16nm | 11.5*13-BGA153 |  |  |  | EOL,LTB：Jun. 30th, 2019
 | 16G | H26M51002HPR | v5.1 | 3D V2 MLC | 11.5*13-BGA153
 | 32G | H26M62002GMR | v5.1 | 3D V2 MLC | 11.5*13-BGA153
 | 16G | H26M52208FPRI | v5.1 | MLC/1ynm | 11.5*13-BGA153 | I | -40 ~ +85
 | 16G | H26M51002KPR | v5.1 |  | 11.5*13*0.8-BGA153 |  |  |  | eMMC not support 3.3V
 | 32G | H26M62002JPR | v5.1 |  | 11.5*13*0.8-BGA153 |  |  |  | eMMC not support 3.3V
 | 8G | H26M41208HPRI | v5.1 | 1ynm/MLC | 11.5*13-BGA153 | I | -40 ~ +95 | S/T
 | 32G | H26M41208EMRA | v5.1 | 1ynm/MLC | 11.5*13-BGA153 | A3 | -40 ~ +95
Kingston | 4G | KE44B26BN | v4.41 |  | 12*16-BGA169 |  |  |  | EOL
 | 8G | KE4CV3H5A | v4.41 |  | 11.5*13-BGA153 |  |  |  | EOL
 | 16G | KE4CV4H5A | v4.41 |  | 11.5*13-BGA153 |  |  |  | EOL
 | 8G | KE4CN3K6A | v4.5 |  | 12*16-BGA169 |  |  |  | EOL
 | 4G | KE4CN2H5A | v4.5 |  | 11.5*13-BGA153 |  |  |  | EOL
 | 16G | KE4CN4K6A | v4.5 |  | 12*16-BGA169 |  |  |  | EOL
 | 16G | EMMC16G-V100 | v5.0 |  | 11.5*13-BGA153 |  |  |  | EOL
 | 8G | EMMC08G-V100 | v5.0 |  | 11.5*13-BGA153 |  |  |  | EOL
 | 8G | EMMC08G-M325 | v5.1 | MLC/15nm | 11.5*13-BGA153 |  |  | S/T
 | 8G | EMMC08G-ML36 | v5.1
 | 8G | EMMC08G-T227 | v5.0 | TLC/15nm | 11.5*13-BGA153 |  |  |  | Date code greater than 1627 (1st Jul)
 | 32G | EMMC32G-T527 | v5.0 | TLC/15nm | 11.5*13-BGA153 |  |  |  | EOL,Date code greater than 1627 (1st Jul)
 | 16G | EMMC16G-T527 | v5.0 | TLC/15nm | 11.5*13-BGA153 |  |  |  | EOL,Date code greater than 1627 (1st Jul)
 | 16G | EMMC16G-M525 | v5.1 | MLC/15nm | 11.5*13-BGA153
 | 4G | EMMC04G-M627 | v5.1 | MLC/15nm | 11.5*13-BGA153 |  | -25~+85 |  | Date code greater than 1627 (1st Jul)
 | 8G | EMMC08G-M728 | v5.0 | 3D MLC | 11.5*13-BGA153 |  |  | S/T
 | 16G | EMMC16G-W525 | v5.0 | MLC/T15nm | 11.5*13-BGA153 | I | -40 ~ +85 | S/T | Industrial
 | 32G | EMMC32G-W525 | v5.0 | MLC/T15nm | 11.5*13-BGA153 | I | -40 ~ +85 | S/T | Industrial
 | 64G | EMMC64G-W525 | v5.0 | MLC/T15nm | 11.5*13-BGA153 | I | -40 ~ +85 | S/T | Industrial
 | 16G | EMMC16G-TB28 | v5.1 | 3D TLC | 11.5*13-BGA153 |  |  | S/T
 | 4G | EMMC04G-MK27 | v5.0 |  | 11.5*13-BGA153
FORESEE | 32G | NCEFEH58-32G | V4.51 | MLC/16nm | 11.5*13.5-BGA153 |  |  |  | EOL
 | 8G | NCFSES78-08G | SD 2.0 | TLC/21nm | 11.5*13.5-BGA153 |  |  |  | EOL
 | 16G | NCEFEH58-16G | V4.51 | MLC/16nm | 11.5*13.5-BGA153 |  |  |  | EOL
 | 4G | NCEFES88-04G | v4.51 | TLC/21nm | 11.5*13.5-BGA153 |  |  |  | EOL
 | 8G | NCEFES78-08G | v4.51 | TLC/21nm | 11.5*13.5-BGA153 |  |  |  | EOL
 | 8G | NCFSESA8-08G | SD 2.0 | TLC/19nm | 11.5*13.5-BGA153 |  |  |  | fSD, EOL
 | 16G | NCEFBS98-16G | v4.5 | TLC/19nm | 12*16-BGA169 |  |  |  | 注1
 | 4G | NCEFEM48-04G | v4.5 | MLC/20nm | 11.5*13.5-BGA153
 | 16G | NCEMAH59-16G | v5.0 | MLC/16nm | 11.5*13-BGA153 |  |  | S/T
 | 32G | NCEMAH59-32G | v5.0 | MLC/16nm | 11.5*13-BGA153
 | 16G | NCEMBS99-16G | v5.0 | TLC/19nm | 12*16-BGA169
 | 32G | NCEMBS99-32G | v5.0 | TLC/19nm | 12*16-BGA169
 | 8G | NCEFAT28-08G | v4.51 | TLC/19nm | 11.5*13-BGA153 |  |  |  | 注1
 | 32G | NCEMBSF9-32G | v5.0 | TLC/16nm | 12*16-BGA169
 | 16G | NCEMBSF9-16G | v5.0 | TLC/16nm | 12*16-BGA169
 | 8G | NCEMASD9-08G | v5.0 | TLC/16nm | 11.5*13-BGA153 |  |  |  | 仅支持PRV版本4.3及之后版本
 | 16G | NCEMBD39-16G | v5.0 | MLC/15nm | 12*16-BGA169
 | 16G | NCEMAD6B-16G | v5.1 | TLC/15nm | 11.5*13-BGA153
 | 8G | NCEMAD7B-08G | v5.0 | TLC/15nm | 11.5*13-BGA153
 | 8G | NCEMAM6G-08G | v5.1 | MLC/16nm | 11.5*13-BGA153 |  |  | S/T
 | 16G | NCEMASKG-16G | v5.1 | TLC/14nm | 11.5*13-BGA153 |  |  | S/T
 | 32G | FSEWASLG-32G | v5.1 |  | 11.5*13-BGA153 | I | -40 ~ +85
 | 16G | NCEMAD99-16G | v5.0 |  | 11.5*13-BGA153
 | 32G | NCEMASLD-32G | v5.1 |  | 11.5*13.5-BGA153 | C | -25 ~ +85
 | 16G | NCEMAD9D-16G | v5.1 |  | 11.5*13.5-BGA153
 | 32G | FSEIASLD-32G | v5.1 |  | 11.5*13.5-BGA153 |  | -25~+85
 | 8G | NCEMAD9D-8G | v5.1 |  | 11.5*13.5-BGA153
 | 8G | FEMDNN008G-08A39 | v5.1 |  | FBGA 11.5*13.5*1.0 |  | -25~+85
 | 8G | FEMDRM008G-58A39 | v5.1 |  |  |  | -25~+85
 | 16G | FEMDNN016G-58A43 | v5.1 |  | FBGA 11.5*13.5*1.0 |  | -25~+85
 | 4G | FEMDNN004G-58A42 | v5.1 |  | FBGA 11.5*13.5*0.8 |  | -25~+85
 | 32G | FEMDNN032G-58A46 | v5.1 |  | FBGA 11.5*13.5*1.0 |  | -25~+85
 | 32G | FEMDRM032G-A3A55 | v5.1 |  | FBGA 11.5*13.5*1.0 |  | -25~+85
 | 128G | FEMDNN128G-A3A44 | v5.1 |  | FBGA 11.5*13.5*1.0 |  | -25~+85
AcSip | 8G | NCMMCS08G | v4.5 |  | 12*16-BGA169
 | 16G | NCMMCS16G | v4.5 |  | 12*16-BGA169
AVEXIR | 16G | AVEC016G-FA6 | v4.5 |  | 11.5*13-BGA153 |  |  | S/T
EUDAR | 8G | EMS1ASCBT1FC008 | v4.51 |  | 11.5*13-BGA153
 | 16G | EMS1ASCBT2FC016 | v4.51 |  | 11.5*13-BGA153
 | 16G | EMB1CTTD41FC016 | v5.1 |  | 11.5*13-BGA153
 | 32G | EMB1CTTD51FC032 | v5.1 |  | 11.5*13-BGA153
Barun | 4G | BEM04M5B50XA-A3CT | v4.51 | MLC/20nm | 11.5*13-BGA153 |  |  |  | EOL
 | 4G | BEM04S2B60XA-A3CT | v4.51 | TLC/19nm | 11.5*13-BGA153 |  |  |  | EOL
 | 8G | BEM08S1B60XA-A3CT | v4.51 | TLC/19nm | 11.5*13-BGA153 |  |  |  | EOL
 | 16G | BSB16GCDRS4EM-01 | v4.51 | TLC/16nm | 11.5*13-BGA153 |  | -25~+85 | S/T
 | 8G | BSA08GCDRS4EM-01 | v4.51 | TLC/16nm | 11.5*13-BGA153 |  | -25~+85 | S/T
 | 16G | BTA16GCFHAEET | v5.1 | TLC/15nm | 11.5*13-BGA153
Ramaxel | 16G | REMKDM316GDBB | v5.0 | MLC | 11.5*13-BGA153
 | 8G | REMKDM308GSBB | v5.0 | MLC | 11.5*13-BGA153
 | 16G | REMSAT416GDBB | v5.0 | TLC/A19nm | 11.5*13-BGA153 |  |  | S/T
 | 8G | REMSAT408GSBB | v5.0 | TLC/A19nm | 11.5*13-BGA153
 | 8G | REMPBT808GSBB | v5.0 | TLC/15nm | 11.5*13-BGA153 |  |  | S/T
 | 16G | REMPBT716GSBB | v5.0 | TLC/15nm | 11.5*13-BGA153 |  |  | S/T
Spansion/ SkyHigh | 8G | 40410081B1B1W00 | v4.51 | MLC | 11.5*13-BGA153 |  | -25~+85 |  | EOL,LTB:2016-10-5
 | 16G | 40410161B1B1W01 | v4.51 | MLC | 11.5*13-BGA153 |  | -25~+85 |  | EOL,LTB:2016-10-5
Gigadevice | 8G | GD9E8MUYNM-MA00 | v5.0 | MLC | 11.5*13-BGA153
 | 8G | GD9E8M00YNI | v5.0 | MLC | 11.5*13-BGA153
 | 4G | GD9E4M00YNI | v5.0 | MLC | 11.5*13-BGA153
 | 8G | GD9E8T00GNM-05 | v5.1 | TLC/T16nm | 11.5*13-BGA153
FDI | 4G | MC1M04M1L3AB | v4.51 | MLC | 11.5*13-BGA153 |  |  | S/T
 | 8G | MC1M08M2L3AB | v4.51 | MLC | 11.5*13-BGA153 |  |  | S/T
 | 16G | MC1M16M4L3AB | v4.51 | MLC | 11.5*13-BGA153 |  |  | S/T
SiS | 8G | TC008000AA | v5.0 | TLC/S16nm | 11.5*13-BGA153 |  |  |  | Don't support when EXT_CSD[261:254]=0x44010000000
 | 8G | MC008000AA | v5.0 | MLC/H16nm | 11.5*13-BGA153
 | 16G | MC016000AA | v5.0 | MLC/H16nm | 11.5*13-BGA153
 | 32G | MC032000AA | v5.0 | MLC/H16nm | 11.5*13-BGA153
Dosilicon | 16G | FMR16C1D0A-SB | v5.0 | H3D V2 MLC | 11.5*13-BGA153 |  |  | S/T
JSC | 32G | JSMC32BUA2HYAEA | v5.0 | H3D V2 MLC | 11.5*13-BGA153 |  |  | S/T
 | 16G | JSMC16AUA2HYAEA | v5.0 | H3D V2 MLC | 11.5*13-BGA153 |  |  | S/T
 | 8G | JSMC08AUM1ASAEA-H5 | v5.1 |  | 11.5*13-BGA153
ESSENCORE | 16G | ENEAGQ8BE1MR-HB | v5.1 |  |  |  | -20 ~ +60
 | 8G | I3E-8GTH7CMRE | v5.0 | MLC/T16nm | 11.5*13-BGA153
EOREX | 32G | EMMF5BA-032G | v5.1 |  | 11.5*13-BGA153
Biwin | 4G | BWCMARD11G04G | v5.0 |  |  |  | -25 ~ +85
 | 8G | BWCTASC11G08G | V5.0 |  | 9*11-BGA153
 | 8G | BWCMMQ511G08G | V5.0 |  | 11.5*13-BGA153
 | 16G | BWCTAK611G16G | V5.0 |  | 11.5*13-BGA153
 | 64G | BWCTARV11X64G | V5.1 |  | 11.5*13-BGA153 |  | -25 ~ +85
 | 8G | BWCE28NH-08G | V5.0 |  | 11.5*13*0.9
MXIC | 8G | MX52LM08A11XVI | V5.1 | MLC | 11.5*13-BGA153 | I | -40 ~ +85
TOPDISK | 16G | A121-16G | V5.1 |  | 11.5*13-BGA153
 | 32G | A132-32G | V5.1 |  | 11.5*13-BGA153
UniIC | 32G | UNMEN05GC1C31AS | v5.1 | 3D TLC | 11.5*13-BGA153 | C | -25 ~ +85 | S/T
 | 64G | UNMEN06GC2C31AS | v5.1 | 3D TLC | 11.5*13-BGA153 | C | -25 ~ +85
Artmem | 8G | AT70B08GT05C | v5.1 | 2D TLC/15nm | 11.5*13-BGA153 |  |  |  | 非工业
 | 16G | AT70B16G4T02C | v5.1 | 3D TLC/Bics3 | 11.5*13-BGA153 |  |  |  | 非工业
 | 16G | AT70B16G4T05C | v5.1 | 3D TLC/Bics3 | 11.5*13-BGA153 |  |  |  | 非工业
 | 32G | AT70B32GT01C | v5.1 | 3D TLC/Bics3 | 11.5*13-BGA153 |  |  |  | 非工业
 | 64G | AT70B64GT01C | v5.1 | 3D TLC/Bics3 | 11.5*13-BGA153 |  |  |  | 非工业
 | 16G | AT70B16G3S02C | v5.1 | 2D MLC/K9GDGD8U0B | 11.5*13-BGA153 |  |  |  | 非工业
 | 16G | AT70B16G3S06F | v5.1 |  | 11.5*13-BGA153
 | 32G | AT70B32G3S01C | v5.1 | 3D TLC/K9AFGD8H0A | 11.5*13-BGA153 |  |  |  | 非工业
 | 8G | AT70B08G3Y02F | v5.1 |  | 11.5x13x0.92 |  | -40 ~ +85
 | 8G | AT70B08G3Y02F2 | v5.1 |  |  |  | -40 ~ +85
 | 16G | AT70B16G3Y02F | v5.1 |  | 11.5x13x0.92 |  | -40 ~ +85
 | 8G | AT70B08G3S03F | v5.1 | MLC | 11.5*13-BGA153
 | 16G | AT70B16G4T06F | v5.1 |  | 11.5*13-BGA153
 | 16G | AT70B16GS10F | v5.1
 | 16G | AT70B16G4S10F | v5.1
 | 8G | AT70B8GY02F | v5.1
 | 32G | AT70B32G4Y01F | v5.1 |  | 11.5*13-BGA153 |  | -25 ~ +85
 | 64G | AT70B64G4Y01F | v5.1 |  | 11.5*13-BGA153 |  | -25 ~ +85
ISOCOM | 32G | MEMA032G-M0S00 | v5.1 |  | 11.5*13-BGA153 |  | -25 ~ +85
SCY | 4GB | E04GDML31ABE00 | v5.1 |  |  |  | -25 ~ +85
 | 32G | E32GDDF11ABE00 | v5.1 | TLC | 11.5*13-BGA153 |  | -25 ~ +85
YMTC | 32G | YMEC6A2TB1A2C3 | v5.1 | MLC | 11.5*13-BGA153 |  | -25 ~ +85
 | 64G | YMEC7A2TB2A2C3 | v5.1 | MLC | 11.5*13-BGA153 |  | -25 ~ +85
 | 64G | YMEC7B0TE1A2C3 | v5.1 | 3D TLC | 11.5*13-BGA153 |  | -25 ~ +85
 | 128G | YMEC8B0TE2A2C3 | v5.1 | 3D TLC | 11.5*13-BGA153 |  | -25 ~ +85
SkyHigh | 4G | S40FC004C1B1C | v5.1 | MLC | 11.5*13-BGA153 | I | -40 ~ +85
Konka Kowin | 8G | KAS03111 | v5.1 |  | 11.5*13-BGA153 |  | -25 ~ +85
 | 16G | KASG5111 | v5.1 |  | 11.5*13-BGA153 |  | -25 ~ +85
SiliconGo | 32G | SGM8100C-Y02BBG | v5.1 |  | 11.5*13-BGA153 |  | -40 ~ +85
 | 16G | SGM8000C-S21BAG | v5.1 |  | 11.5*13-BGA153 | I | -40 ~ +85
Core Storage | 8G | CME4A0TD-08GA | v5.1 | pMLC | FBGA153 11.5 x 13 x 1.0 |  | -40 ~ +85
Metorage | 32G | MIE3032CH7 | v5.1 |  | BGA153 |  | -25 ~ +85
 | 64G | MIE3064CH7 | v5.1 |  | BGA153 |  | -25 ~ +85
 | 8G | MPE3008EH7 | v5.1 | pSLC | BGA153 |  | -40 ~ +85
 | 16G | MPE3016EH7 | v5.1 | pSLC | BGA153 |  | -25 ~ +85
GOKE | 8G | XPA72EA0E-008 | v5.1 | MLC | 11.5*13-BGA153 |  | -25 ~ +85
 | 32G | XPB73EA0E-032 | v5.1 | TLC | 11.5*13-BGA153 |  | -25 ~ +85
HIKSEMI | 16G | HSEMSES2S2B16G | v5.1 |  | 11.5*13-BGA153 |  | -25 ~ +85
 | 32G | HSEMSDS6S2B32G | v5.1 |  | 11.5*13-BGA153 |  | -25 ~ +85
NanoWell | 64G | NW-EM064G | v5.1 |  | 11.5*13-BGA153 |  | -25 ~ +85
 | 128G | NW-EM128G | v5.1 |  | 11.5*13-BGA153 |  | -25 ~ +85
HKCS | 16G | D016C1YJCD-E00 | v5.1 |  |  |  | -25 ~ +85
 | 32G | D032C1YJCD-E00 | v5.1 |  |  |  | -25 ~ +85
注1：支持该eMMC需要将各环节MMC驱动更新到最新，并修改sys_config.fex让该eMMC工作在SDR模式下。

Sheet: 5-声明
• Declaration
This document is the original work and copyrighted property of Allwinner Technology (“Allwinner”). Reproduction in whole or in part must obtain the written approval of Allwinner and give clear acknowledgement to the copyright owner.
The information furnished by Allwinner is believed to be accurate and reliable. Allwinner reserves the right to make changes in circuit design and/or specifications at any time without notice. Allwinner does not assume any responsibility and liability for its use. Nor for any infringements of patents or other rights of the third parties which may result from its use. No license is granted by implication or otherwise under any patent or patent rights of Allwinner. This datasheet neither states nor implies warranty of any kind, including fitness for any particular application.
