o7-machinehum/Blackpants/docs/a523/Allwinnertech A523 DRAM Support List V1.3.xls

Sheet: Version History
Version | Date | Section/ Page | Author | Changes compared to previous issue
V1.0 | 2023-04-27 |  | LiJinbo | Initial version 1.Add support list for A523 2.update LPDDR4: H9HCNNNBKUMLXR-NEX、FLXC2004G-N1、KZDB42CAM-MD supported 3.update LPDDR4X: H9HCNNNBKUMLXR-NEX supported
V1.1 | 2023-05-21 |  | LiJinbo | 1.update LPDDR4: FLXC2004G-30、RS512M32LM4D2BDS-53BT、RS1G32LV4D2BDS-53BT、CXDB5CCBM-MJ-A、HG4XD04G-C2JA supported
V1.2 | 2023-06-02 |  | LiJinbo | 1.update LPDDR4: CXDBBCCBM-MK-B、KALXX5S43AY2-T40
V1.3 | 2023-06-26 |  | LiJinbo | 1.update LPDDR4: KALXX4S43AY2-T40、NT6AN512T32AV-J2、NT6AN1024F32AV-J2、GDB2D32MJ0-42M7、SM1G32Z32MD2DNQ-PG、SM1G32Z42MD2DNQ-PG A523 supported 2.update LPDDR4: CXDB3ABAM-MK-A，DDR4: H5AN8G6NDJR、EM60E16NWBB

Sheet: A523 DRAM Support List
Allwinnertech A523 DRAM Support List
General Description:
1.The purpose of this document is the guide of DDR seclection for customer using our solution.
2.There are some DDRs that not mentioned here. Since DDR is an universal device. So you can test it by yourself before mass production or send the sample to us for testing.
3. Since DDR is high speed device. Please directly copy AW PCB DRAM Part Template and follow our PCB Layout Guide.
Abbr. and Definition of Status:
 | Symbol | Definition |  |  |  | Abbr. | Definition
 | X | Do Not Support |  |  |  | STA | test status
 | D/S | Datasheet Support |  |  |  | freq | max frequency for MP. '/c' means compatible template
 | S/T | Sample Tested
 | √ | Sample Tested and Mass Production |  |  |  | STD | verification standard C: commercial; T: industrial
 | NOTE | Part Number 标暗灰代表EOL
Vendor | Part Number | Type | package | Density | Organization | A523
 |  |  |  |  |  | STA | Freq | STD
Hynix | H5AN8G6NDJR | DDR4 | FBGA96 | 8Gb | 512M×16
 | H9HCNNNBKUMLXR-NEX | LPDDR4 | FBGA200 | 16Gb | 512M×16×2CH | S/T | 1200 | C
 | H9HCNNNBKUMLXR-NEX | LPDDR4X | FBGA200 | 16Gb | 512M×16×2CH | S/T | 1200 | C
江波龙 | FLXC2004G-N1 | LPDDR4 | FBGA200 | 32Gb | 1G×16×2CH | S/T | 1200 | C
 | FLXC2004G-30 | LPDDR4 | FBGA200 | 32Gb | 1G×16×2CH | S/T | 1200 | C
晶存Rayson | RS512M32LM4D2BDS-53BT | LPDDR4 | FBGA200 | 16Gb | 512M×32 | S/T | 1200 | C
 | RS1G32LV4D2BDS-53BT | LPDDR4 | FBGA200 | 32Gb | 1G×32 | S/T | 1200 | C
长鑫CXMT | CXDB5CCBM-MJ-A | LPDDR4 | FBGA200 | 32Gb | 512M×16×2CH×2CS | S/T | 1200 | C
 | CXDBBCCBM-MK-B | LPDDR4 | FBGA200 | 24Gb | 384M×16×2CH×2CS | S/T | 1200 | C
 | CXDB3ABAM-MK-A | LPDDR4 | FBGA200 | 8Gb | 256M×16×2CH
宏芯宇 | HG4XD04G-C2JA | LPDDR4 | FBGA200 | 32Gb | 512M×32×2CH | S/T | 1200 | C
康盈KOWIN | KALXX5S43AY2-T40 | LPDDR4 | FBGA200 | 32Gb | 512M×16×2CH×2CS | S/T | 1200 | C
 | KALXX4S43AY2-T40 | LPDDR4 | FBGA200 | 16Gb | 256M×16×2CH×2CS | S/T | 1200 | C
南亚Nanya | NT6AN1024F32AV-J2 | LPDDR4 | FBGA200 | 32Gb | 1G×16×2CH | S/T | 1200 | C
 | NT6AN512T32AV-J2 | LPDDR4 | FBGA200 | 16Gb | 512M×16×2CH | S/T | 1200 | C
Kazoom | KZDB42CAM-MD | LPDDR4 | FBGA200 | 32Gb | 512M×32×2CS | S/T | 1200 | C
晶凯 | GDB2D32MJ0-42M7 | LPDDR4 | FBGA200 | 32Gb | 1G×16×2CH | S/T | 1200 | C
钰创Etron | EM60E16NWBB | DDR4 | FBGA96 | 4Gb | 256M×16
Micron | SM1G32Z32MD2DNQ-PG | LPDDR4 | FBGA200 | 32Gb | 1G×32 | S/T | 1200 | C
 | SM1G32Z42MD2DNQ-PG | LPDDR4 | FBGA200 | 32Gb | 1G×32 | S/T | 1200 | C
