o7-machinehum/Blackpants/docs/a523/A523_hwref/硬件checklist/全志客户PCB设计Checklist_V2.0.xlsx

Sheet: 版本管理
版本历史
版本 | 日期 | 修订人 | 审核人 | 版本描述
2.0 | 2022-04-12 | AWA1798 |  | 发布初版本
文档说明： 本文档用于指导客户PCB layout 设计进行自我检查，另外本司还有关于《PCB设计guide》，对于pcb 设计细节都有进行详细说明，用于指导客户如何设计，请详细查阅。

Sheet: PCB checklist
全志XXX 硬件平台客户PCB设计Checklist
客户名称 |  |  | 级别 | 总数 | "不通过"数量 | "不涉及"数量 | 通过率
文档名称 |  |  | 建议 | 9 | 0 | 0 | 100.00% | ”建议“：建议执行，”不满足“需要说明
设计者 |  |  | 规则 | 54 | 2 | 0 | 96.30% | ”规则“：原则要求强制执行，”不满足“需要详细说，且专家审核通过
审核人
审核结论 |  | 通过
分类 | 编号 | 检查项 | 级别 | 自检结论 | “不满足”说明 |  |  | 客户专家检查 | 备注说明
基本要求 | 1 | DRAM layout 设计是否完全复制全志公司提供的模板。走线、过孔、线宽线距、包地、电源平面、GND平面、阻容摆放都完全复制模板设计。 | 规则 | 满足 |  |  |  | 不通过
 | 2 | 如果DDR模板需改动，请先与全志工程师联系，确认修改满足全志DRAM设计guide，并通过SIPI仿真 | 规则 | 满足 |  |  |  | 不通过
 | 3 | PCB 的叠层参数与阻抗控制符合《全志叠层设计》说明。 | 规则 | 满足 |  |  |  | 通过
SOC | 4 | BGA 焊盘采用十字形连接，不要与GND铜箔全连接，焊接时防止散热过快，导致虚焊。（电源 ball 除外） | 建议 | 满足 |  |  |  | 通过
 | 5 | 晶振尽量靠近 IC 摆放，使 X24MI 和 X24MO 走线小于 600mil。 | 规则 | 满足 |  |  |  | 通过
 | 6 | 晶振及其走线区域的外围和相邻层，用 GND 屏蔽保护。晶体及其走线区域的相邻层，禁止其它走线。 | 规则 | 满足 |  |  |  | 通过
电源 | 7 | VDD_SYS，VDD_CPU，VDD_DRAM铜箔尽量宽，换层过孔是否足够，一般定义1oz铜厚，宽度40mil铜箔可通过1A电流，V8X16的Via过0.5A电流。 | 规则 | 满足 |  |  |  | 通过
 | 8 | VDD-CPUFB、VDD-SYSFB 为电压反馈信号，远离板边及远离 DDR、CSI、SD、CARD 等干扰信号走线，走 Power 层沿其电源平面一起走到负载。如果与其他信号并排走，需要包地保护或 8mil 间距。 | 规则 | 满足 |  |  |  | 通过
 | 9 | 电源芯片的位置摆放合理，靠近负载。 | 规则 | 满足 |  |  |  | 通过
 | 10 | Charger，DCDC(Buck, Boost)，LDO的相关电容，电感，采样电阻摆放靠近相关Pin。 | 规则 | 满足 |  |  |  | 通过
 | 11 | VBUS,ACIN，DCDC，Charger,LDO等功率走线铺大铜箔。 | 规则 | 满足 |  |  |  | 通过
 | 12 | Charger，DCDC的LX网络铺铜合理。 | 规则 | 满足 |  |  |  | 通过
 | 13 | 电压，电流反馈避开LX网络和其它跳变信号。 | 规则 | 满足 |  |  |  | 通过
WIFI BT GPS | 14 | 原理图布局天线馈线的匹配电容电阻，使馈线平滑，最短。无分支，无过孔，少拐角 | 规则 | 满足 |  |  |  | 通过
 | 15 | 天线传输线需尽量短，平顺，拐角处需走弧度线，需隔层参考的话注意相邻层挖空，WIFI天线尽量远离DRAM走线，高速信号及时钟信号，变化比较大的电源信号。 | 规则 | 满足 |  |  |  | 通过
 | 16 | 使用PCB走线作天线，请确保天线走线附近区域完全净空，净空区大于50mm²。天线本体至少距周围的金属1cm以上。 | 规则 | 满足 |  |  |  | 通过
 | 17 | GPS电路位置，远离电源、DDR、LCD电路、摄像头、马达、SPEAKER等易产生干扰的模块，间距至少20mm。 | 规则 | 满足 |  |  |  | 通过
 | 18 | TCXO对温度敏感，尽量远离PMU、CPU、PA、散热器等发热体。TCXO靠近GPS BB摆放。 | 规则 | 满足 |  |  |  | 通过
 | 19 | TCXO下方各层都必须净空 ( Bottom层除外 ) ，Bottom层以“网格形状”覆地，并且“网格形状”入地点要少一些，TCXO接地管脚单点入地 | 规则 | 满足 |  |  |  | 通过
eMMC | 20 | CLK和DS信号做包地处理，如果不能包地则保持12mil间距。 | 规则 | 满足 |  |  |  | 通过
 | 21 | D0~D7、DS相对CLK等长控制≤300mil； | 规则 | 满足 |  |  |  | 通过
 | 22 | CLK 串接 33R 电阻靠近主控摆放，串阻与主控 CLK 连接走线距离≤300mil。 | 规则 | 满足 |  |  |  | 通过
 | 23 | DS 下拉电阻靠近 EMMC 摆放。下拉电阻引入桩线长度≤200mil。 | 规则 | 满足 |  |  |  | 通过
 | 24 | 走线阻抗50 +/-10% ohm。参考平面完整。保持8mil间距。 | 规则 | 满足 |  |  |  | 通过
NAND | 25 | RE、WE、DQS信号做包地处理，如果不能包地则保持12mil间距。 | 建议 | 满足 |  |  |  | 通过
 | 26 | D0~D7、RE、WE相对于DQS等长控制≤300mil； | 规则 | 满足 |  |  |  | 通过
 | 27 | RE、WE、DQS信号串接电阻靠近主控摆放，串阻与主控 连接走线距离≤300mil。 | 规则 | 满足 |  |  |  | 通过
 | 28 | DS 下拉电阻靠近 EMMC 摆放。下拉电阻引入桩线长度≤200mil。 | 规则 | 满足 |  |  |  | 通过
 | 29 | 走线阻抗50 +/-10% ohm。参考平面完整。保持8mil间距。 | 规则 | 满足 |  |  |  | 通过
SD-SDIO | 30 | CLK做包地处理，如果不能包地则保持8mil间距。 | 建议 | 满足 |  |  |  | 通过
 | 31 | D0~D3相对CLK等长控制<500mil； | 规则 | 满足 |  |  |  | 通过
 | 32 | CLK 串接 电阻靠近主控摆放，串阻与主控 CLK 连接走线距离≤300mil。 | 规则 | 满足 |  |  |  | 通过
 | 33 | 走线阻抗50 +/-10% ohm。参考平面完整。保持2W间距。 | 规则 | 满足 |  |  |  | 通过
音频 | 34 | AVCC、VRP、VRA1、VRA2和AGND接地电容、电阻靠近主控摆放。 | 规则 | 满足 |  |  |  | 通过
 | 35 | AGND铜箔宽度≥20mil，AGND接地电阻连接到GND平面的过孔≥2个。 | 规则 | 满足 |  |  |  | 通过
 | 36 | CPVDD、CPVEE、VPP、VEE走线宽度≥10mil，长度≤300mil。 | 规则 | 满足 |  |  |  | 通过
 | 37 | CPVEE与VEE的走线在电容处形成星形连接，CPVDD与VPP的走线在电容处形成星型连接。 | 规则 | 满足 |  |  |  | 通过
 | 38 | MICxP、MICxN，类差分走线，线宽4mil，线距4mil，包地。 | 规则 | 满足 |  |  |  | 通过
 | 39 | MBIAS、HBIAS与MICxP/MICxN并行走线，线宽10mil。包地。 | 规则 | 满足 |  |  |  | 通过
 | 40 | LINEINL/R 、AXIL/R、FMINL/R 每队L、R信号分别包地，线宽4mil。走线及过孔远离高速信号及时钟信号。 | 规则 | 满足 |  |  |  | 通过
 | 41 | SPOLP/N 、SPORP/N、LINEOUTP/N、PHONEINP/N、PHONEOUTP/N每队P、N信号分别类差分走线，线宽4mil，线距4mil，包地。 | 规则 | 满足 |  |  |  | 通过
 | 42 | EAROUTP/N，信号类差分走线，线宽10mil，线距4mil，包地。 | 规则 | 满足 |  |  |  | 通过
 | 43 | HPL、HPCOM、HPCOMFB、HPR整组包地，线宽10 mil。HPL、HPR在两旁，HPCOM、HPCOMFB在中间，走线及过孔远离高速信号及时钟信号。 | 规则 | 满足 |  |  |  | 通过
CSI（非MIPI) | 44 | PCLK的对地电容靠近主控，串联电阻靠近模组； | 建议 | 满足 |  |  |  | 通过
 | 45 | MCLK的对地电容靠近模组，串联电阻靠近主控； | 建议 | 满足 |  |  |  | 通过
 | 46 | Hsync的对地电容靠近主控； | 规则 | 满足 |  |  |  | 通过
 | 47 | Vsync、Hsync、Data串联电阻靠近模组； | 建议 | 满足 |  |  |  | 通过
 | 48 | PCLK单线包地，如果不能包地则保持12mil间距。 | 规则 | 满足 |  |  |  | 通过
USB2.0 |  | 去耦电容和滤波电容，需要靠近IC摆放，接口ESD器件靠近连接器端摆放，且ESD器件与连接器的传输线长度要小于等于500mils。SS_TX串接的电容应靠近IC端摆放。 | 建议 | 满足 |  |  |  | 通过
USB3.0 | 51 | SSRX长度匹配调整处应靠近接口连接器；SSTX调整处应靠近SOC端。具体阻抗，等长需求见阻抗，等长需求表。 | 规则 | 满足 |  |  |  | 通过
EPHY | 52 | 变压器靠近RJ45座子摆放，以太网LED灯靠近座子摆放。RJ45及变压器下面所有层不铺铜，掏空距离40-80mil。 | 建议 | 满足 |  |  |  | 通过
 | 53 | 内置EPHY：RTX电阻，VCC-EPHY电容，VDD-EPHY电容靠近主控摆放。 | 建议 | 满足 |  |  |  | 通过
 | 54 | 外挂100M PHY ：PWFBOUT上连接电感电容靠近PHY芯片PWFBOUT管脚摆放。PWFBIN连接的电容靠近PHY芯片PWFBIN管脚摆放。 | 规则 | 满足 |  |  |  | 通过
 | 55 | 外挂1000M PHY： 1）REGOUT连接的电感，靠近PHY芯片摆放。 2）VDDREG连接的电容，靠近PHY芯片摆放。 3）RXCLK，CLK125滤波电路靠近PHY芯片摆放。 4）TXCLK滤波电路靠近主控摆放。 | 规则 | 满足 |  |  |  | 通过
RGB LVDS | 56 | 在RGB,LCD座子的附近，注意不要有一些往外凸出的接口，如VGA接口，CVBS接口，12V/5V电源接口，开关等接口。注意ESD元件摆放，参考平面完整，具体阻抗，等长需求见阻抗，等长需求表。 | 规则 | 满足 |  |  |  | 通过
MIPI | 57 | 在MIPI座子的附近，注意不要有一些往外凸出的接口，如VGA接口，CVBS接口，12V/5V电源接口，开关等接口。注意ESD元件摆放，参考平面完整，具体阻抗，等长需求见阻抗，等长需求表。 | 规则 | 满足 |  |  |  | 通过
eDP | 58 | 在EDP座子的附近，注意不要有一些往外凸出的接口，如VGA接口，CVBS接口，12V/5V电源接口，开关等接口。注意ESD元件摆放，参考平面完整，具体阻抗，等长需求见阻抗，等长需求表。 | 规则 | 满足 |  |  |  | 通过
ESD | 59 | CPU、DRAM、晶振器件远离外部金属接口≥20mm。 | 规则 | 满足 |  |  |  | 通过
 | 60 | 关键信号（RESET/NMI/Clock等）单线包地，远离板边≥50mil。避免与外部接口信号（USB/HDMI/SD/HP等）相邻并行走线。 | 规则 | 满足 |  |  |  | 通过
 | 61 | reset单线包地，1nF电容靠近主控摆放，电容接地端需用过孔加强连接。 | 规则 | 满足 |  |  |  | 通过
 | 62 | TOP层在CPU/DDR/晶体的外面预留屏蔽罩焊盘。BOTTOM层在CPU和DDR走线外面预留屏蔽罩焊盘。屏蔽罩的各边良好接地。 | 规则 | 满足 |  |  |  | 通过
 | 63 | 两层板时，尽量将走线放在TOP层，各模块CLK单线包地，各模块DATA两两包地。减少BOTTOM层走线，保持BOTTOM地平面的完整性。 | 规则 | 满足 |  |  |  | 通过
 | 64 | 四层板以上时，DDR走线不要走在BOTTOM层。 | 规则 | 满足 |  |  |  | 通过

Sheet: 阻抗，等长需求表
阻抗，等长需求表
 | 名称 需求 | 阻抗 ohm | 等长和长度需求 | 间距 | VIA | 元件底下掏空 | 级别 | 自检结论 | “不满足”说明 | 专家检查人 | 专家检查结论 | 备注说明
高速线阻抗，等长需求表 | USB2.0 | 90 | 对内<50mil，总长≤6000mil | 其它>10mil | ≤2 | 否 | 规则 | 满足 |  |  | 不通过
 | USB3.0 | 90 |  | 组内和其它>20mil， | ≤2 | 是 | 规则 | 满足 |  |  | 通过
 |  |  | USB3.0 TX,RX 对内≤5mil，总长≤5000mil | 板边≥50mil |  |  | 规则 | 满足 |  |  | 通过
 | PCIE2.1 | 100 | 对内≤5mil，总长≤5000mil | 组内和其它>20mil， | ≤2 | 是 | 规则 | 满足 |  |  | 通过
 |  |  |  | 板边≥50mil |  |  | 规则 | 满足 |  |  | 通过
 | MIPI-DSI |  | 对内<10mil，对间<160mil(1080P) | ≥15mil | ≤2 | 否 | 规则 | 满足 |  |  | 通过
 | MIPI-CSI | 100 | 对内<5mil，对间≤300mil | ≥15mil | clk≤2 | 否 | 规则 | 满足 |  |  | 通过
 | EDP | 100 | 对内≤5mil，总长≤3000mil | ≥12mil，包地 | ≤2 | 否 | 规则 | 满足 |  |  | 通过
 | LCD/LVDS | 100 |  | ≥10mil | ≤2 | 否 | 规则 | 满足 |  |  | 通过
 |  |  | 对内<10mil，对间<180mil（1080P) |  |  |  | 规则 | 满足 |  |  | 通过
 |  |  |  |  |  |  | 规则 | 满足 |  |  | 通过
 |  |  | 对内<20mil，对间<450mil(720P) |  |  |  | 规则 | 满足 |  |  | 通过
 | 内置EPHY | 100 | 对内<20mil，对间<200mil | ≥8mil | ≤2 | 否 | 规则 | 满足 |  |  | 通过
低速线阻抗，等长需求表 | NAND | 50 | ≤2000mil;D0~D7、RE、WE相对DQS等长控制≤300mil | ≥8mil | D0~D7上使用过孔的数量尽量相同 | 否 | 规则 | 满足 |  |  | 通过
 |  |  |  |  |  |  | 规则 | 满足 |  |  | 通过
 | EMMC | 50 | ≤2000mil;D0~D7、DS、CMD相对CLK等长控制≤300mil | ≥8mil | D0~D7上使用过孔的数量尽量相同 | 否 | 规则 | 满足 |  |  | 通过
 |  |  |  |  |  |  | 规则 | 满足 |  |  | 通过
 | SDIO | 50 | D0~D3、CMD相对CLK等长控制≤300mil | ≥8mil | D0~D3上使用过孔的数量尽量相同 | 否 | 规则 | 满足 |  |  | 通过
 | SD CARD | 50 | D0~D3、CMD相对CLK等长控制<500mil | ≥8mil | D0~D3上使用过孔的数量尽量相同 | 否 | 规则 | 满足 |  |  | 通过
