o7-machinehum/Blackpants/hardware/step/f32q_20pin_asm.stp

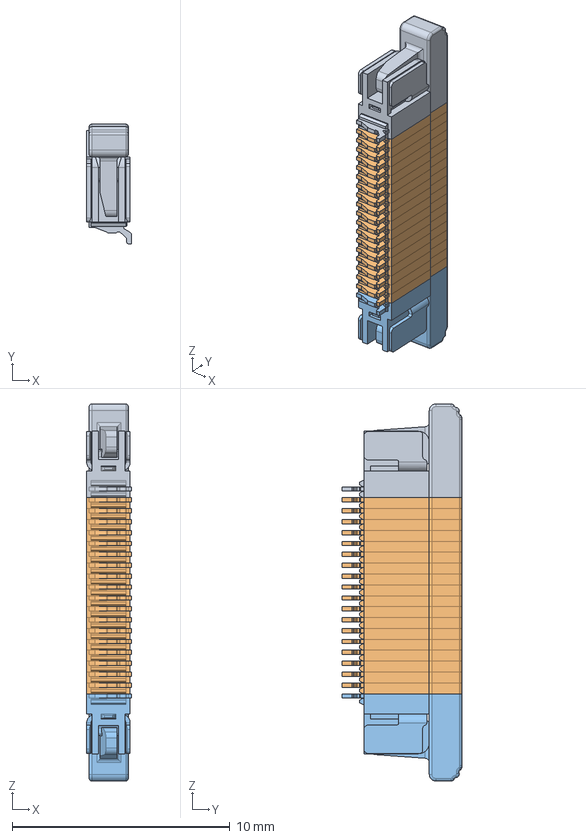
[picture p252: CAD file, 2025-09-18]
hardware/step/f32q_20pin_asm.stp
2.05 x 5.50 x 17.3 mm
F32Q_L
F32Q_M x 18
F32Q_R
