o7-machinehum/Blackpants/Spacer/lasercut/FINAL/lasercut_small_p2.dxf

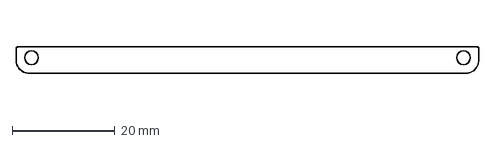
[picture p253: CAD file, 2025-07-25]
Spacer/lasercut/FINAL/lasercut_small_p2.dxf
90.0 x 5.10 mm
