o7-machinehum/Blackpants/hardware/step/usb1046-xx-0190-l-b-x_revb1.step

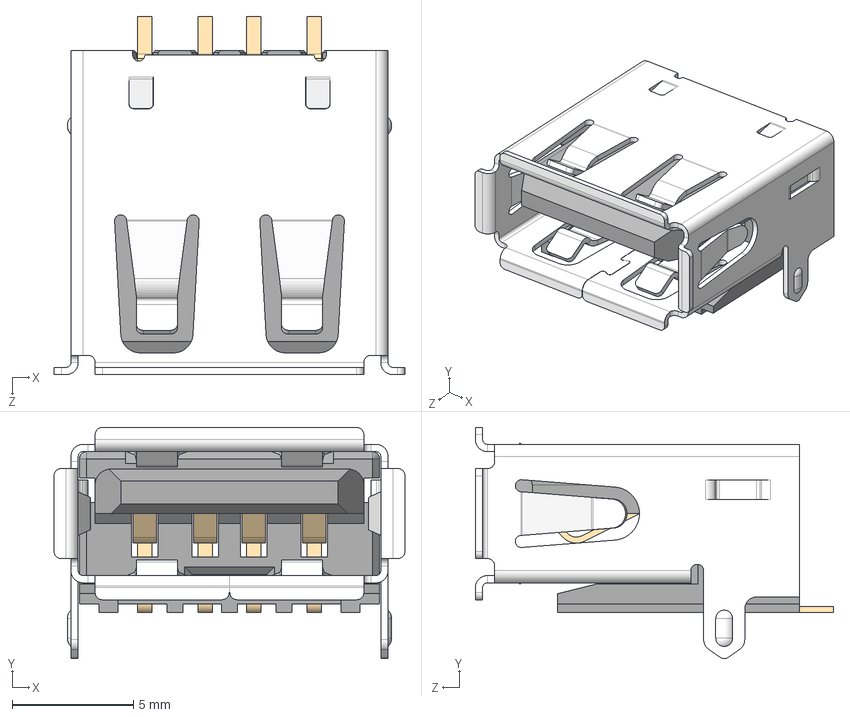
[picture p254: CAD file, 2025-09-15]
hardware/step/usb1046-xx-0190-l-b-x_revb1.step
14.5 x 9.55 x 14.8 mm
INS
USB1046 shell
USB1046 Contact x 4
