o7-machinehum/Blackpants/Spacer/lasercut/FINAL/lasercut_small_p1.dxf

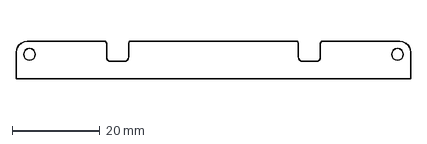
[picture p255: CAD file, 2025-07-25]
Spacer/lasercut/FINAL/lasercut_small_p1.dxf
90.0 x 8.58 mm
