o7-machinehum/Blackpants/hardware/step/M20-7911042R.STEP

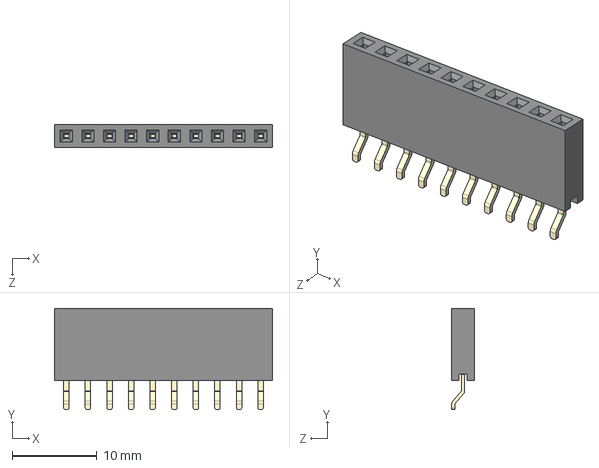
[picture p256: CAD file, 2025-08-21]
hardware/step/M20-7911042R.STEP
25.6 x 11.9 x 2.65 mm
