o7-machinehum/Blackpants/hardware/step/M20-7910842R.STEP

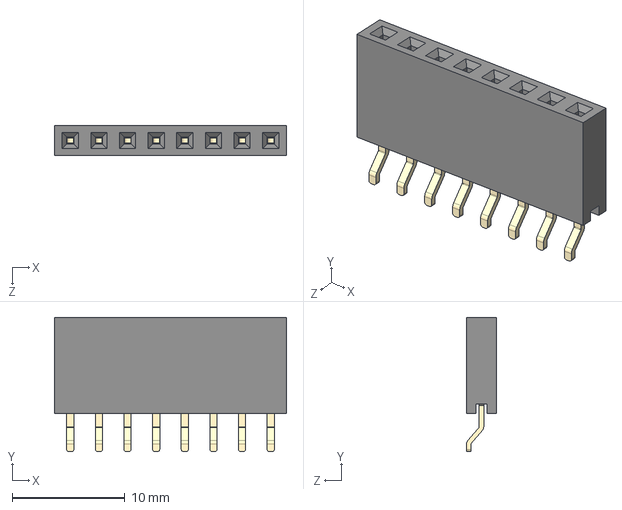
[picture p257: CAD file, 2025-08-21]
hardware/step/M20-7910842R.STEP
20.6 x 11.9 x 2.65 mm
