o7-machinehum/Blackpants/docs/EVB-USB2514B-FS_A1EvaluationBoardSchematicPDF.pdf

# EVB-USB2514B-FS

Customer Evaluation Design for USB2514,

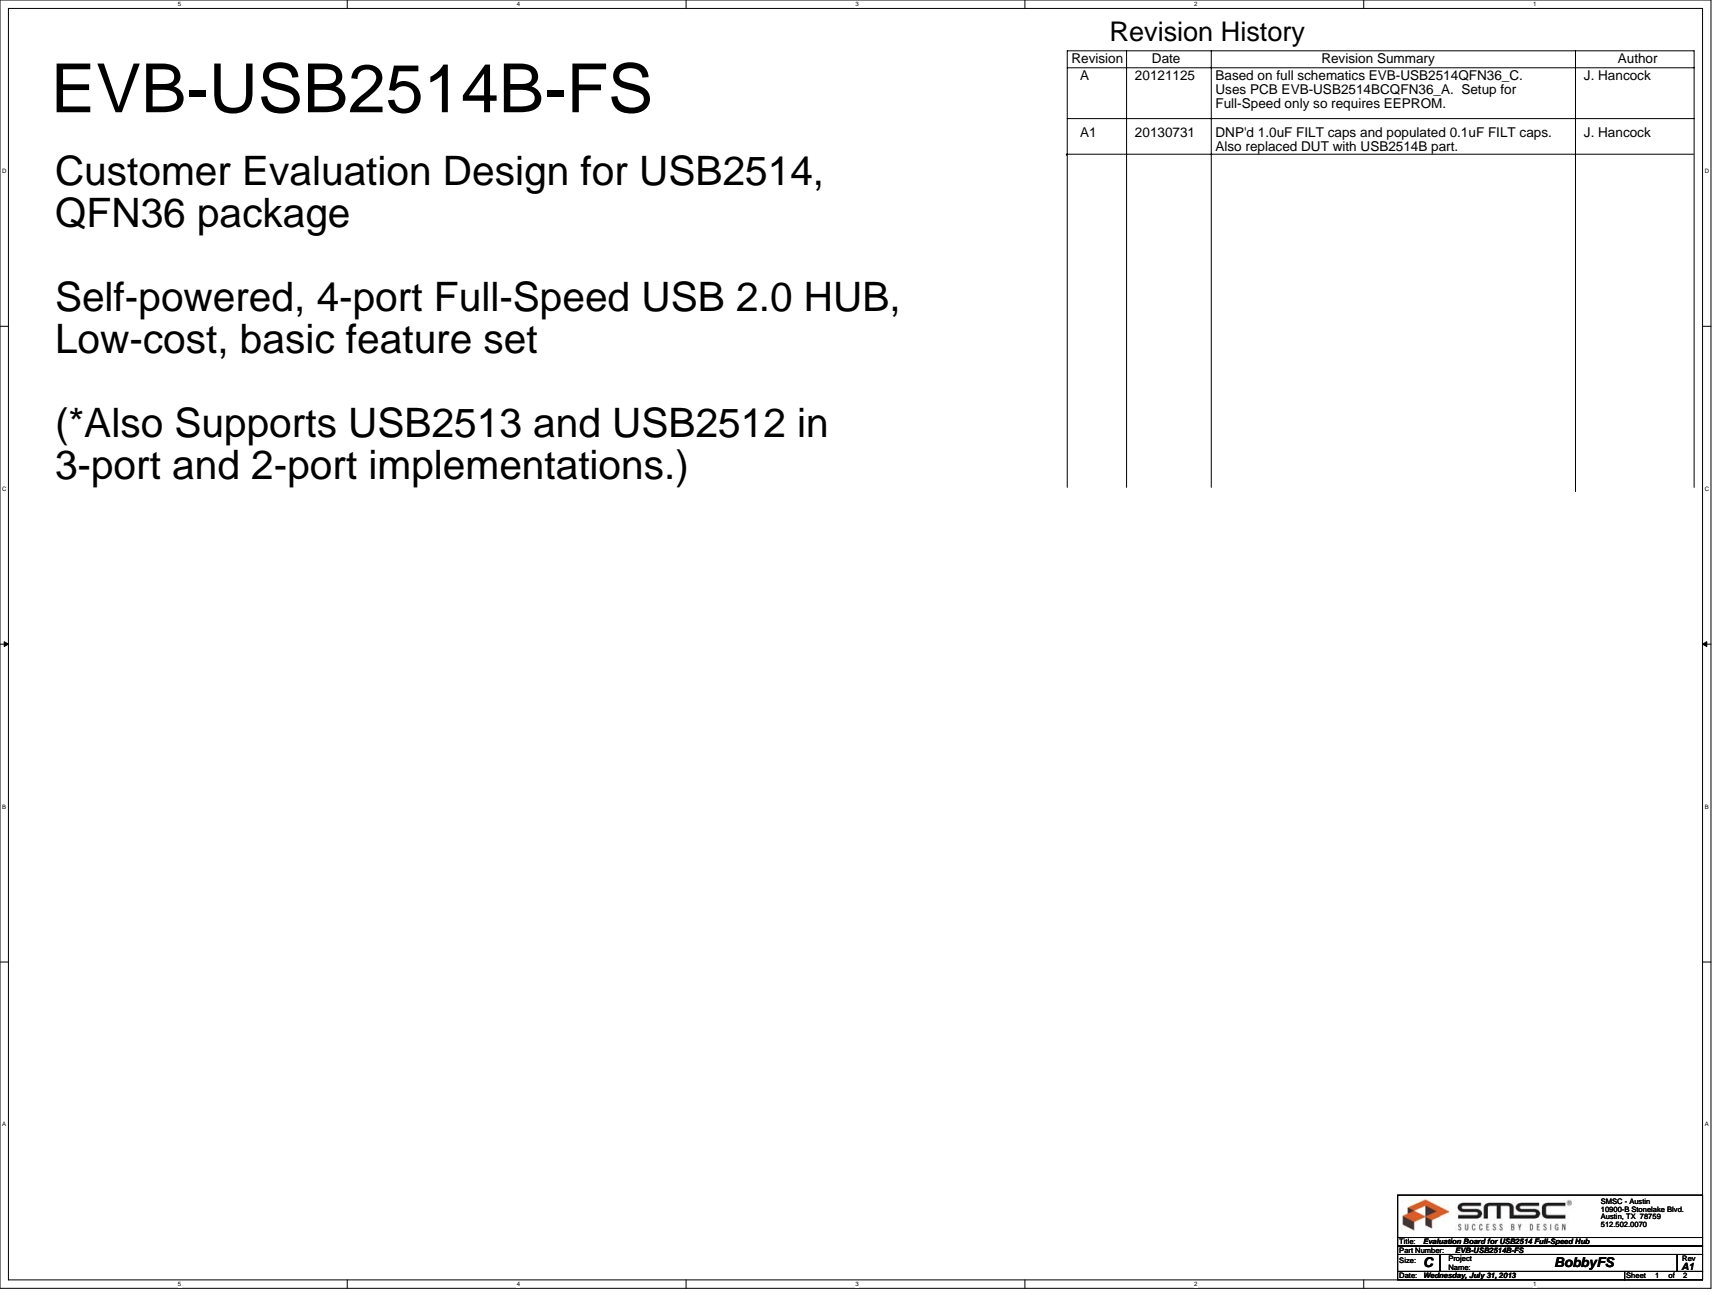
[picture p282: page 1]
Revision History; SMSC - Austin 10900-B Stonelake Blvd. Austin, TX 78759 512.502.0070; EVB-USB2514B-FS

Revision | Date | Revision Summary | Author
A | 20121125 | Based on full schematics EVB-USB2514QFN36_C. Uses PCB EVB-USB2514BCQFN36_A. Setup for Full-Speed only so requires EEPROM. | J. Hancock

A1 | 20130731 | DNP'd 1.0uF FILT caps and populated 0.1uF FILT caps. Also replaced DUT with USB2514B part. | J. Hancock

QFN36 package
Self-powered, 4-port Full-Speed USB 2.0 HUB,
Low-cost, basic feature set
(*Also Supports USB2513 and USB2512 in
3-port and 2-port implementations.)

Title:
Evaluation Board for USB2514 Full-Speed Hub
Part Number:

Size: Size: Size: C C C | Project Project Project BobbyFS BobbyFS BobbyFS Name: Name: Name: | Rev Rev Rev A1 A1 A1

Date: Date: Date: Wednesday, July 31, 2013 Wednesday, July 31, 2013 Wednesday, July 31, 2013 | Sheet Sheet Sheet 1 1 1 of of of 2 2 2

## Optional

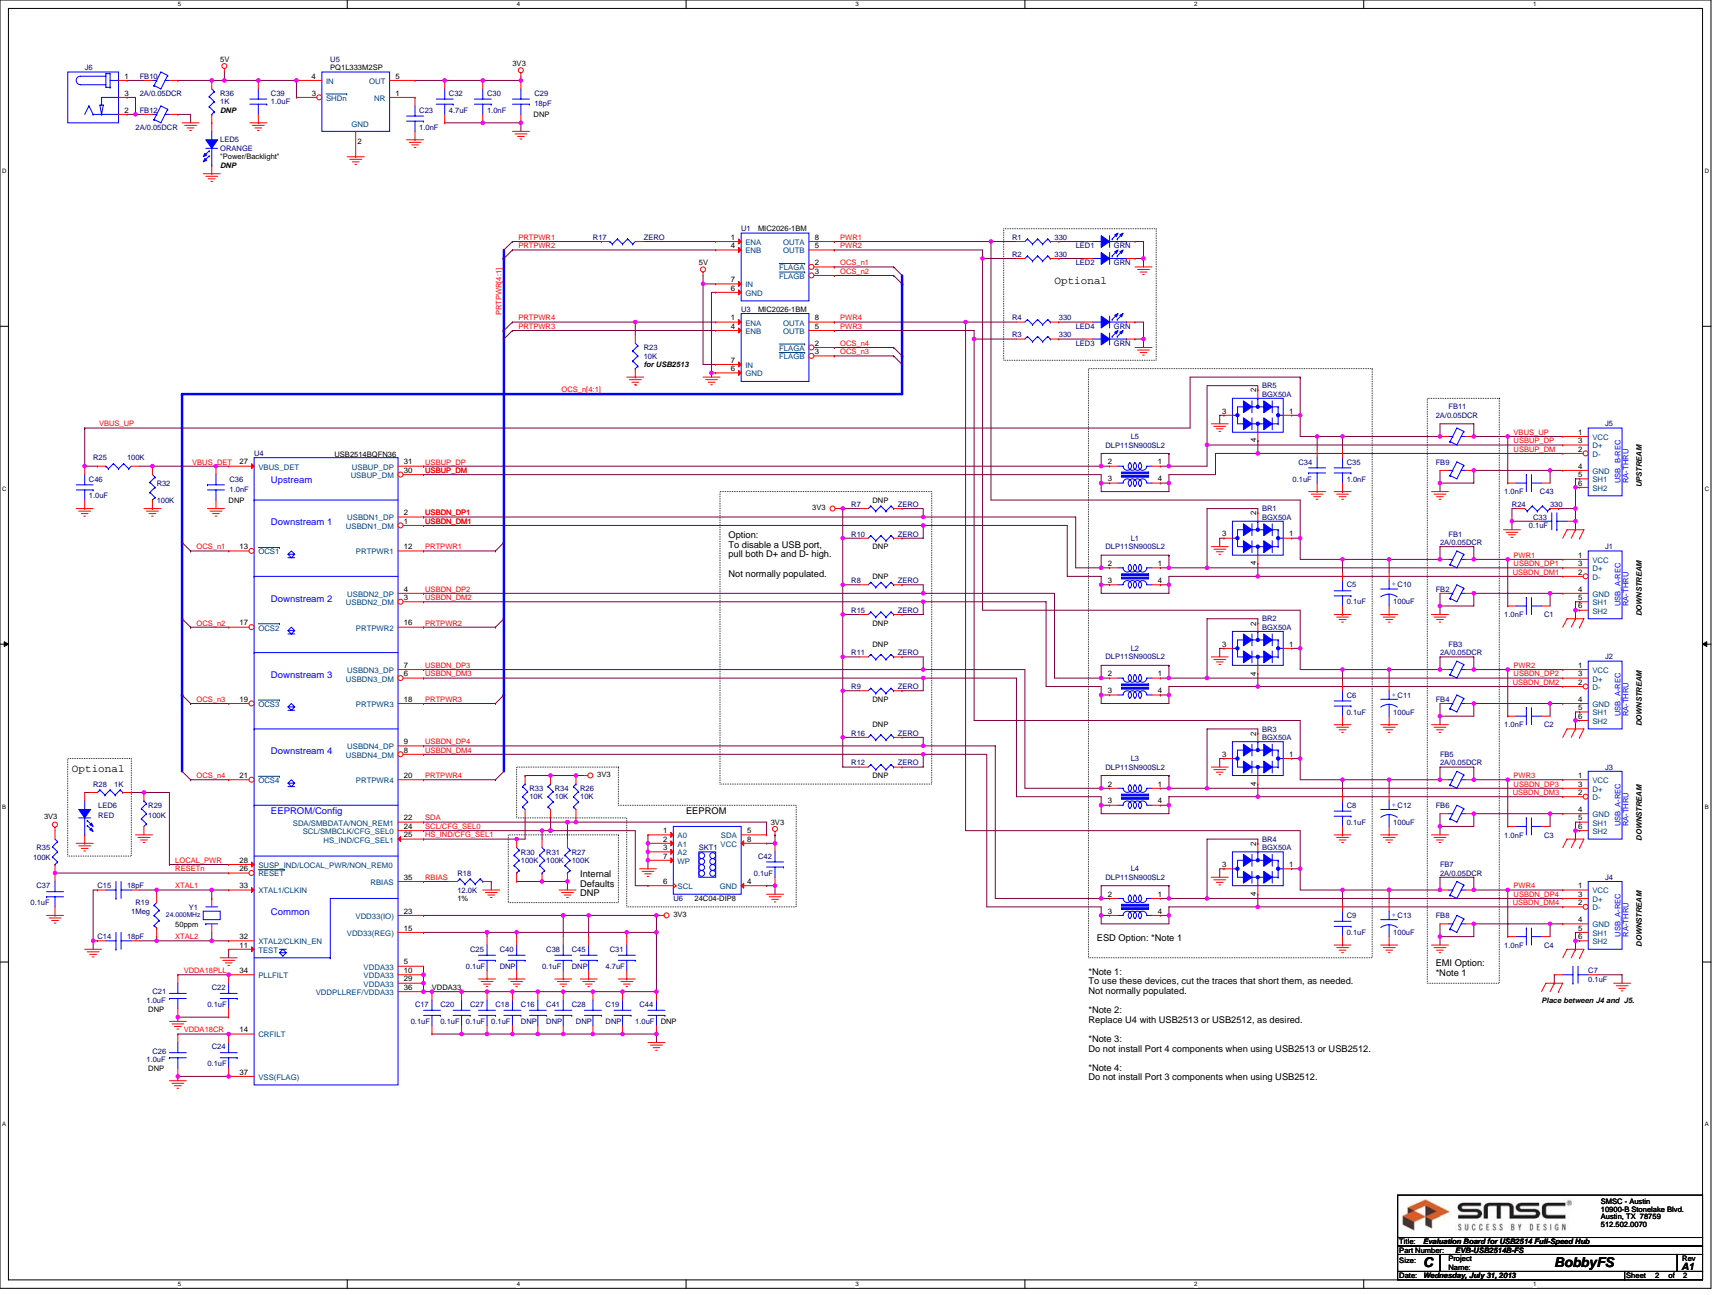
[picture p283: page 2]

USBUP_DM | GND 4 SH1 5

Option:
To disable a USB port,
pull both D+ and D- high.
Not normally populated.

DOWNSTREAM DOWNSTREAM

USBDN_DM4

DNP

USBDN_DM3 | GND 4 SH1 5

*Note 1:
To use these devices, cut the traces that short them, as needed.
*Note 2:
Replace U4 with USB2513 or USB2512, as desired.
*Note 3:
Do not install Port 4 components when using USB2513 or USB2512.

*Note 4:
Do not install Port 3 components when using USB2512.

Title:
Evaluation Board for USB2514 Full-Speed Hub
Part Number:

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

Date: Date: Date: Wednesday, July 31, 2013 Wednesday, July 31, 2013 Wednesday, July 31, 2013 | Sheet Sheet Sheet 2 2 2 of of of 2 2 2
