o7-machinehum/Blackpants/hardware/out/R0.1/blackpants.pdf

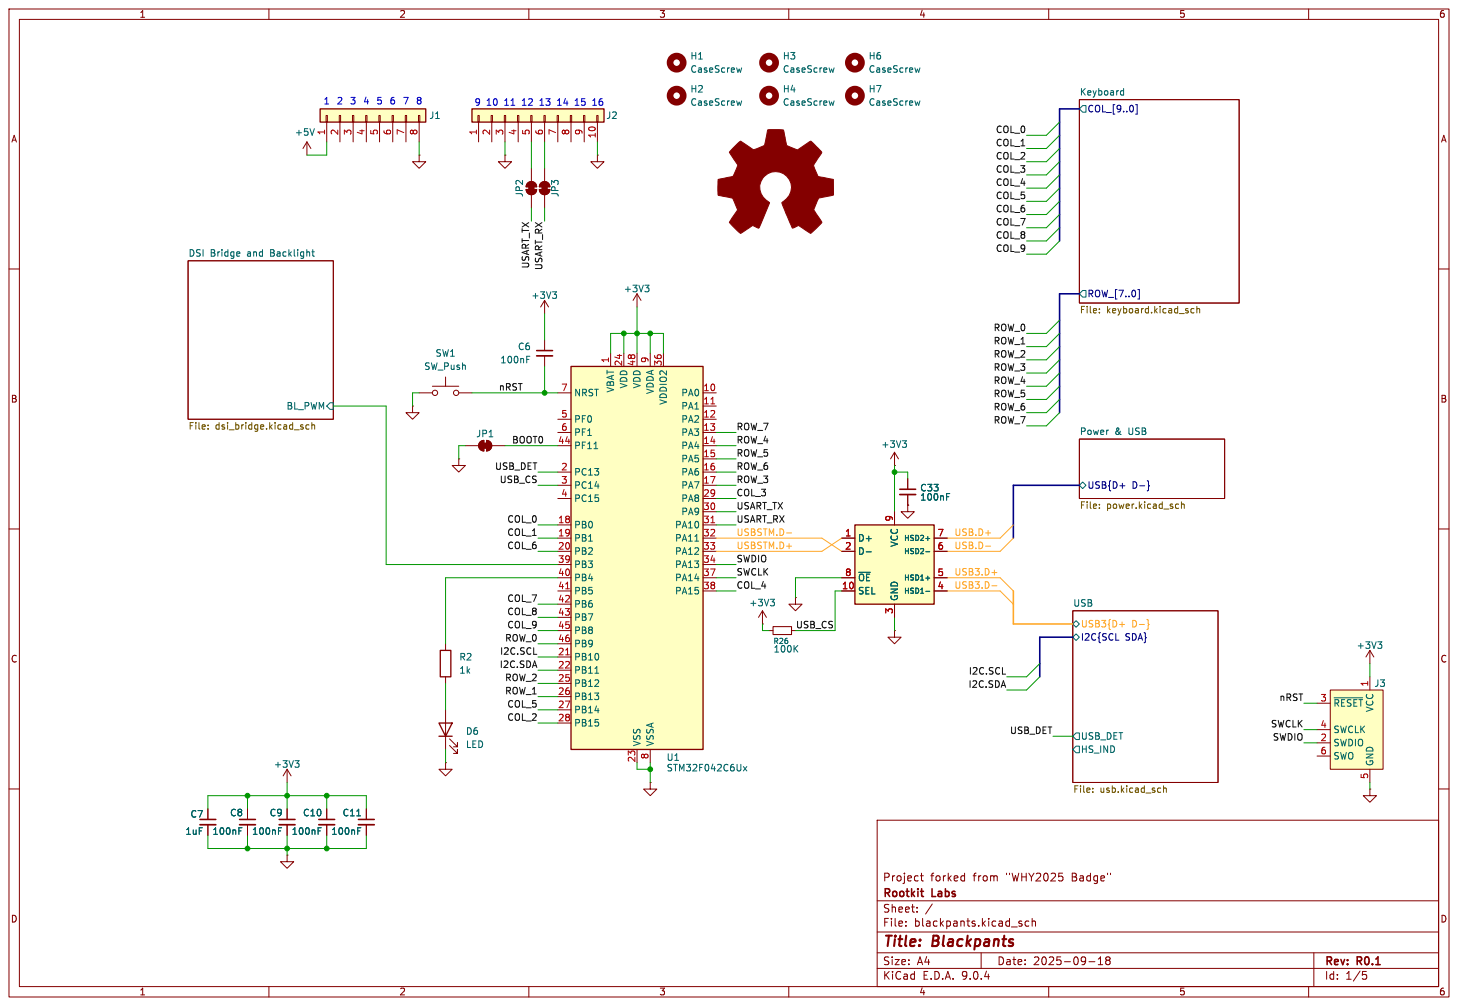
[picture p284: page 1]

DSI Bridge and Backlight File: dsi_bridge.kicad_sch

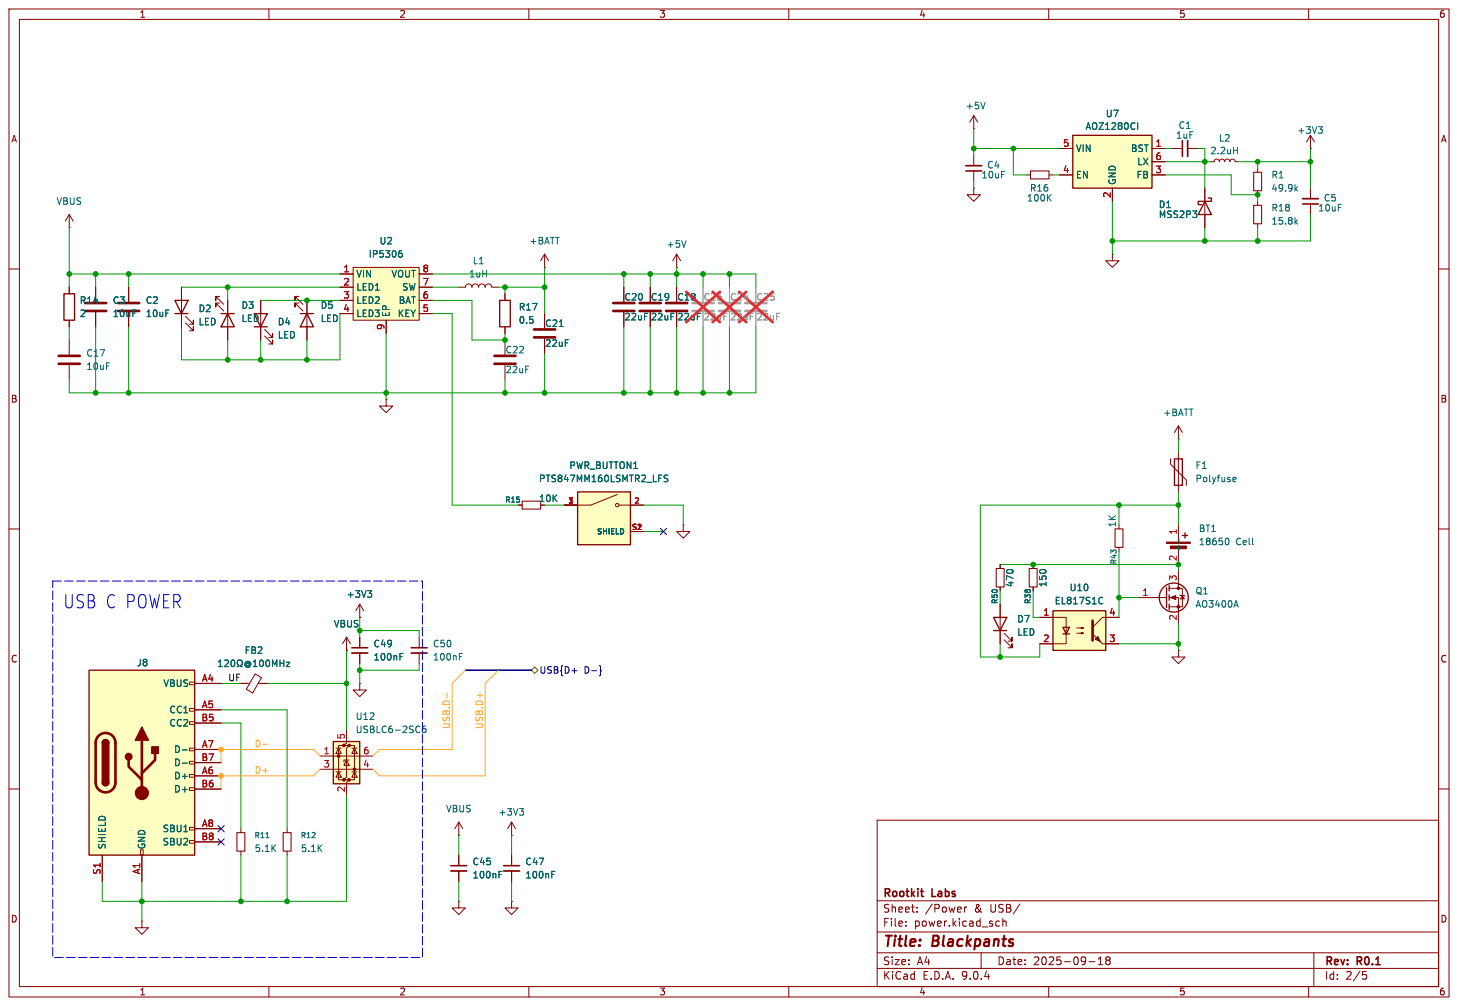
[picture p285: page 2]

9 VOUT 8 SW 7 BAT 6 KEY 5 R17

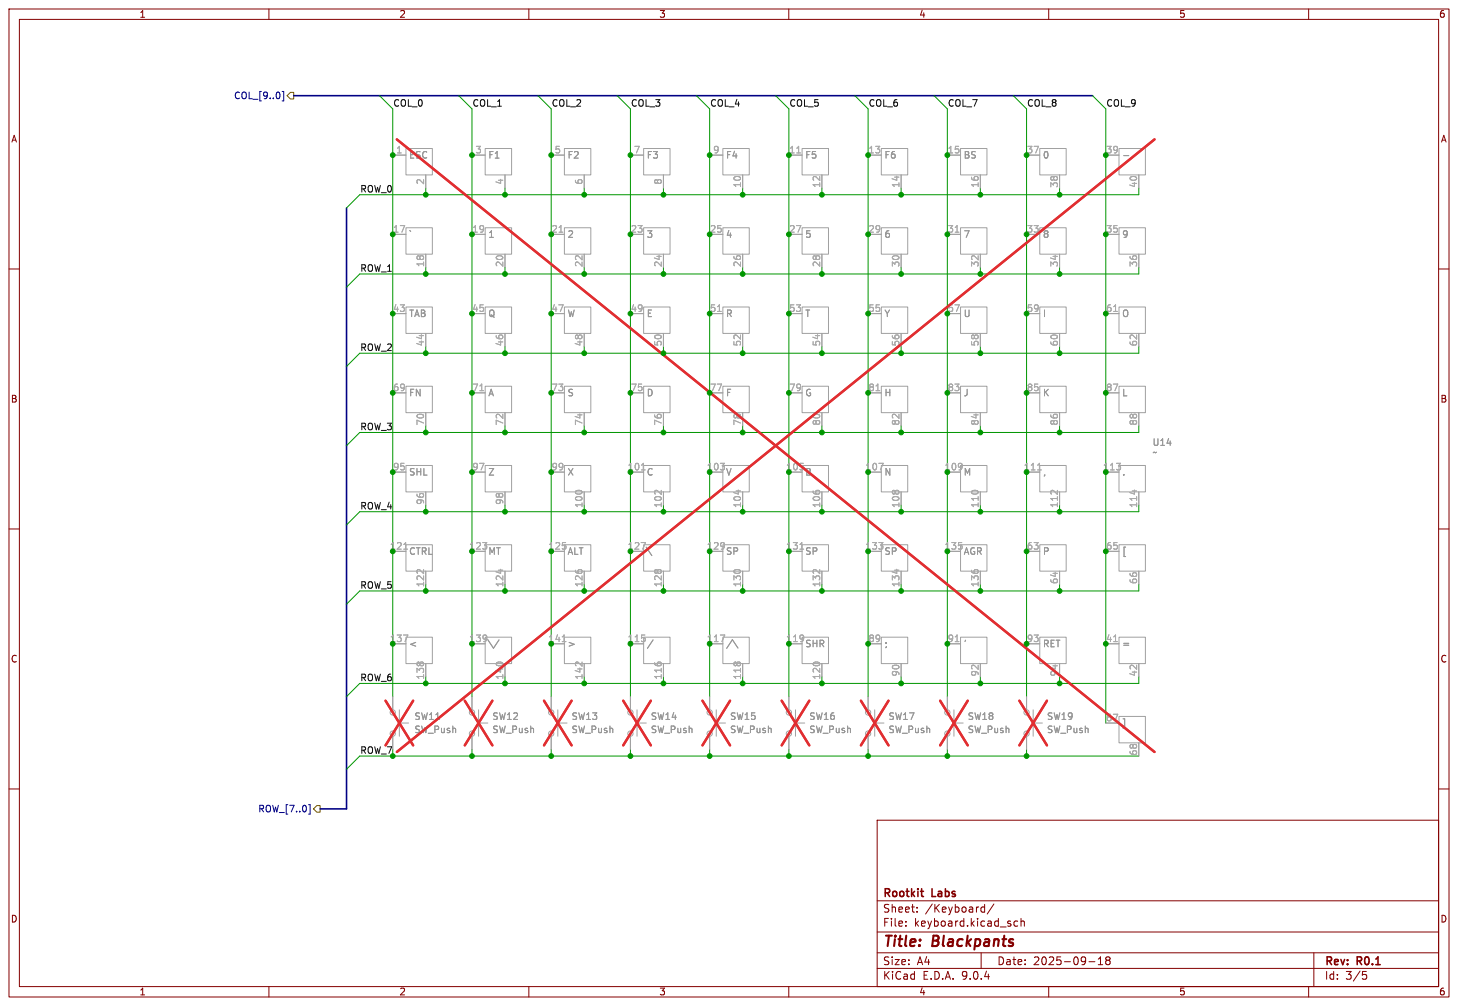
[picture p286: page 3]

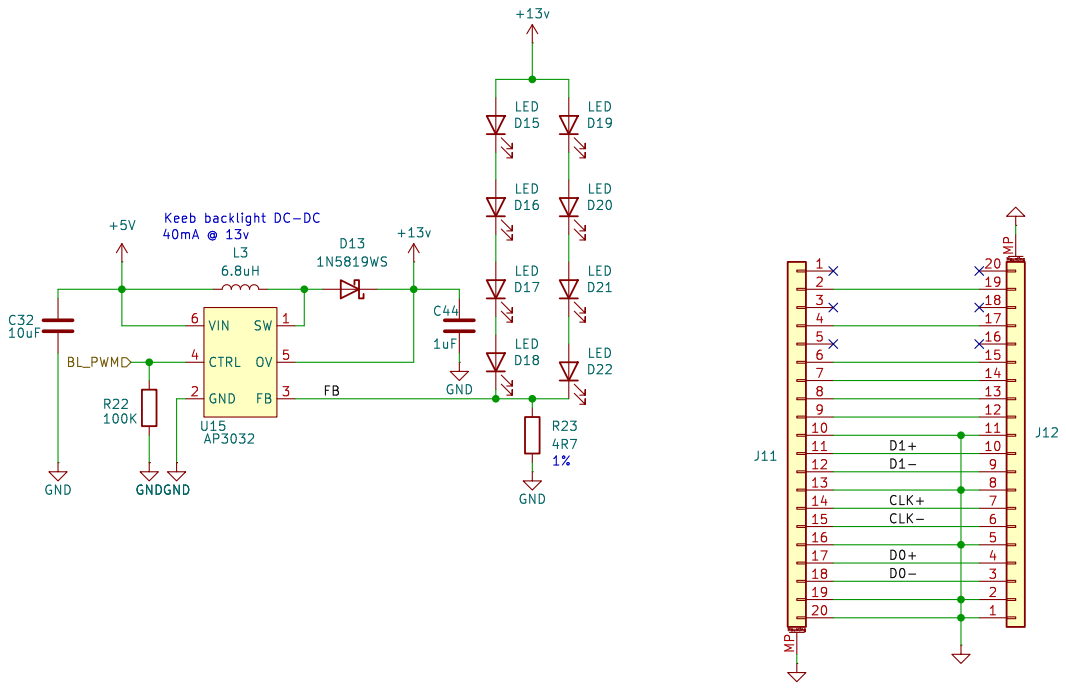
[picture p287: page 4]

11 | 10
12 | 9
13 | 8
14 | 7
15 | 6
16 | 5
17 | 4
18 | 3
19 | 2

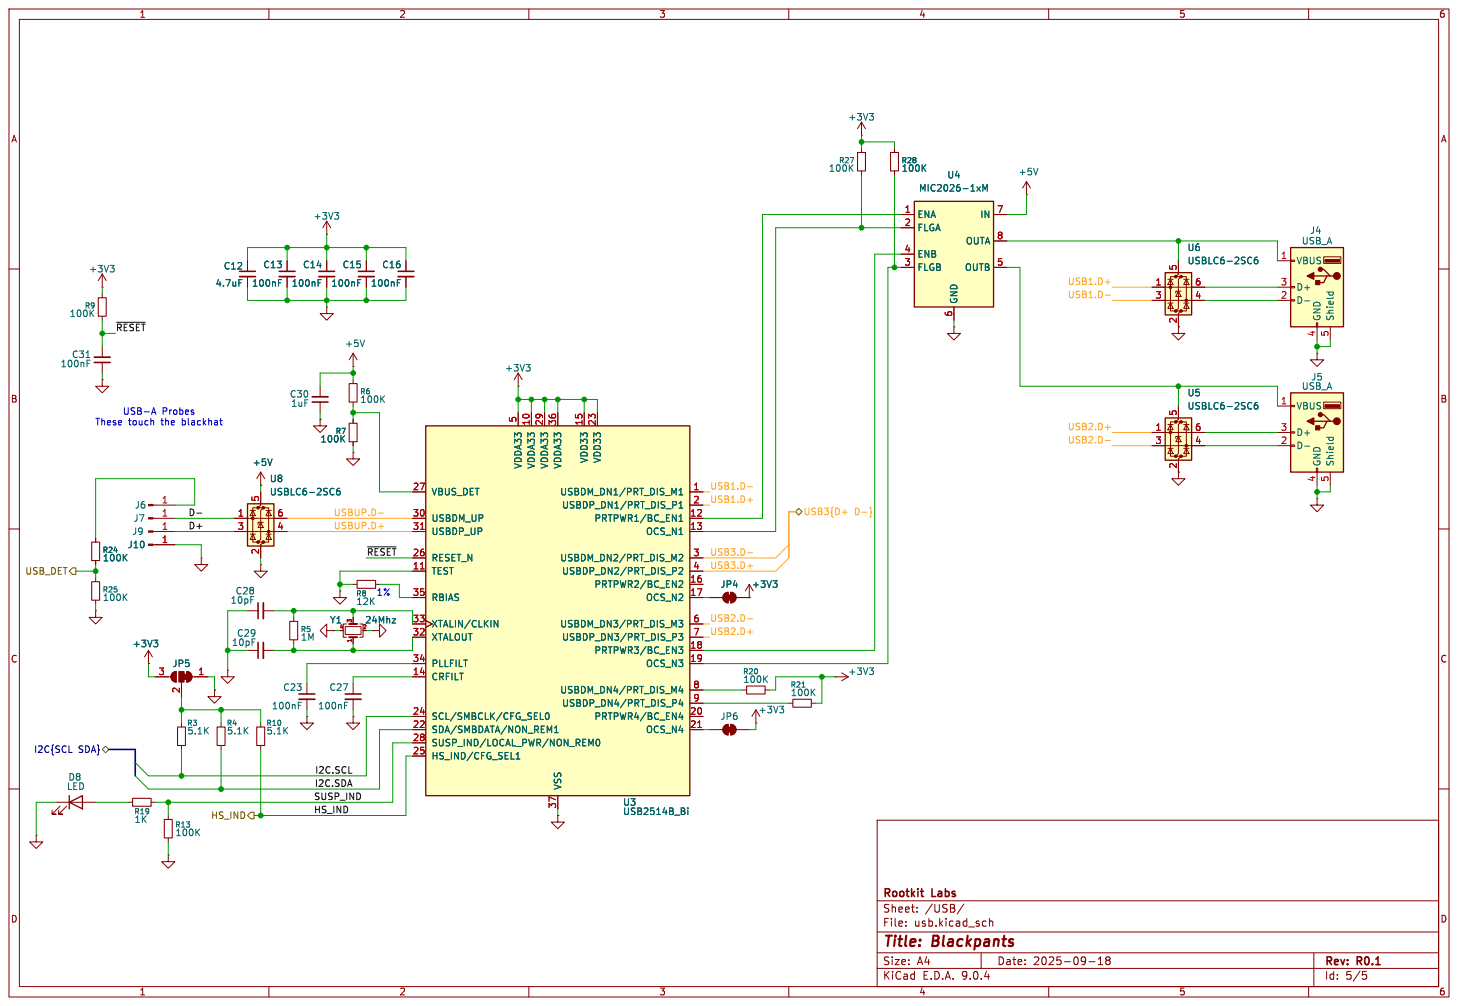
[picture p288: page 5]
