o7-machinehum/Blackpants/ee/integrated/AXP/review.pdf

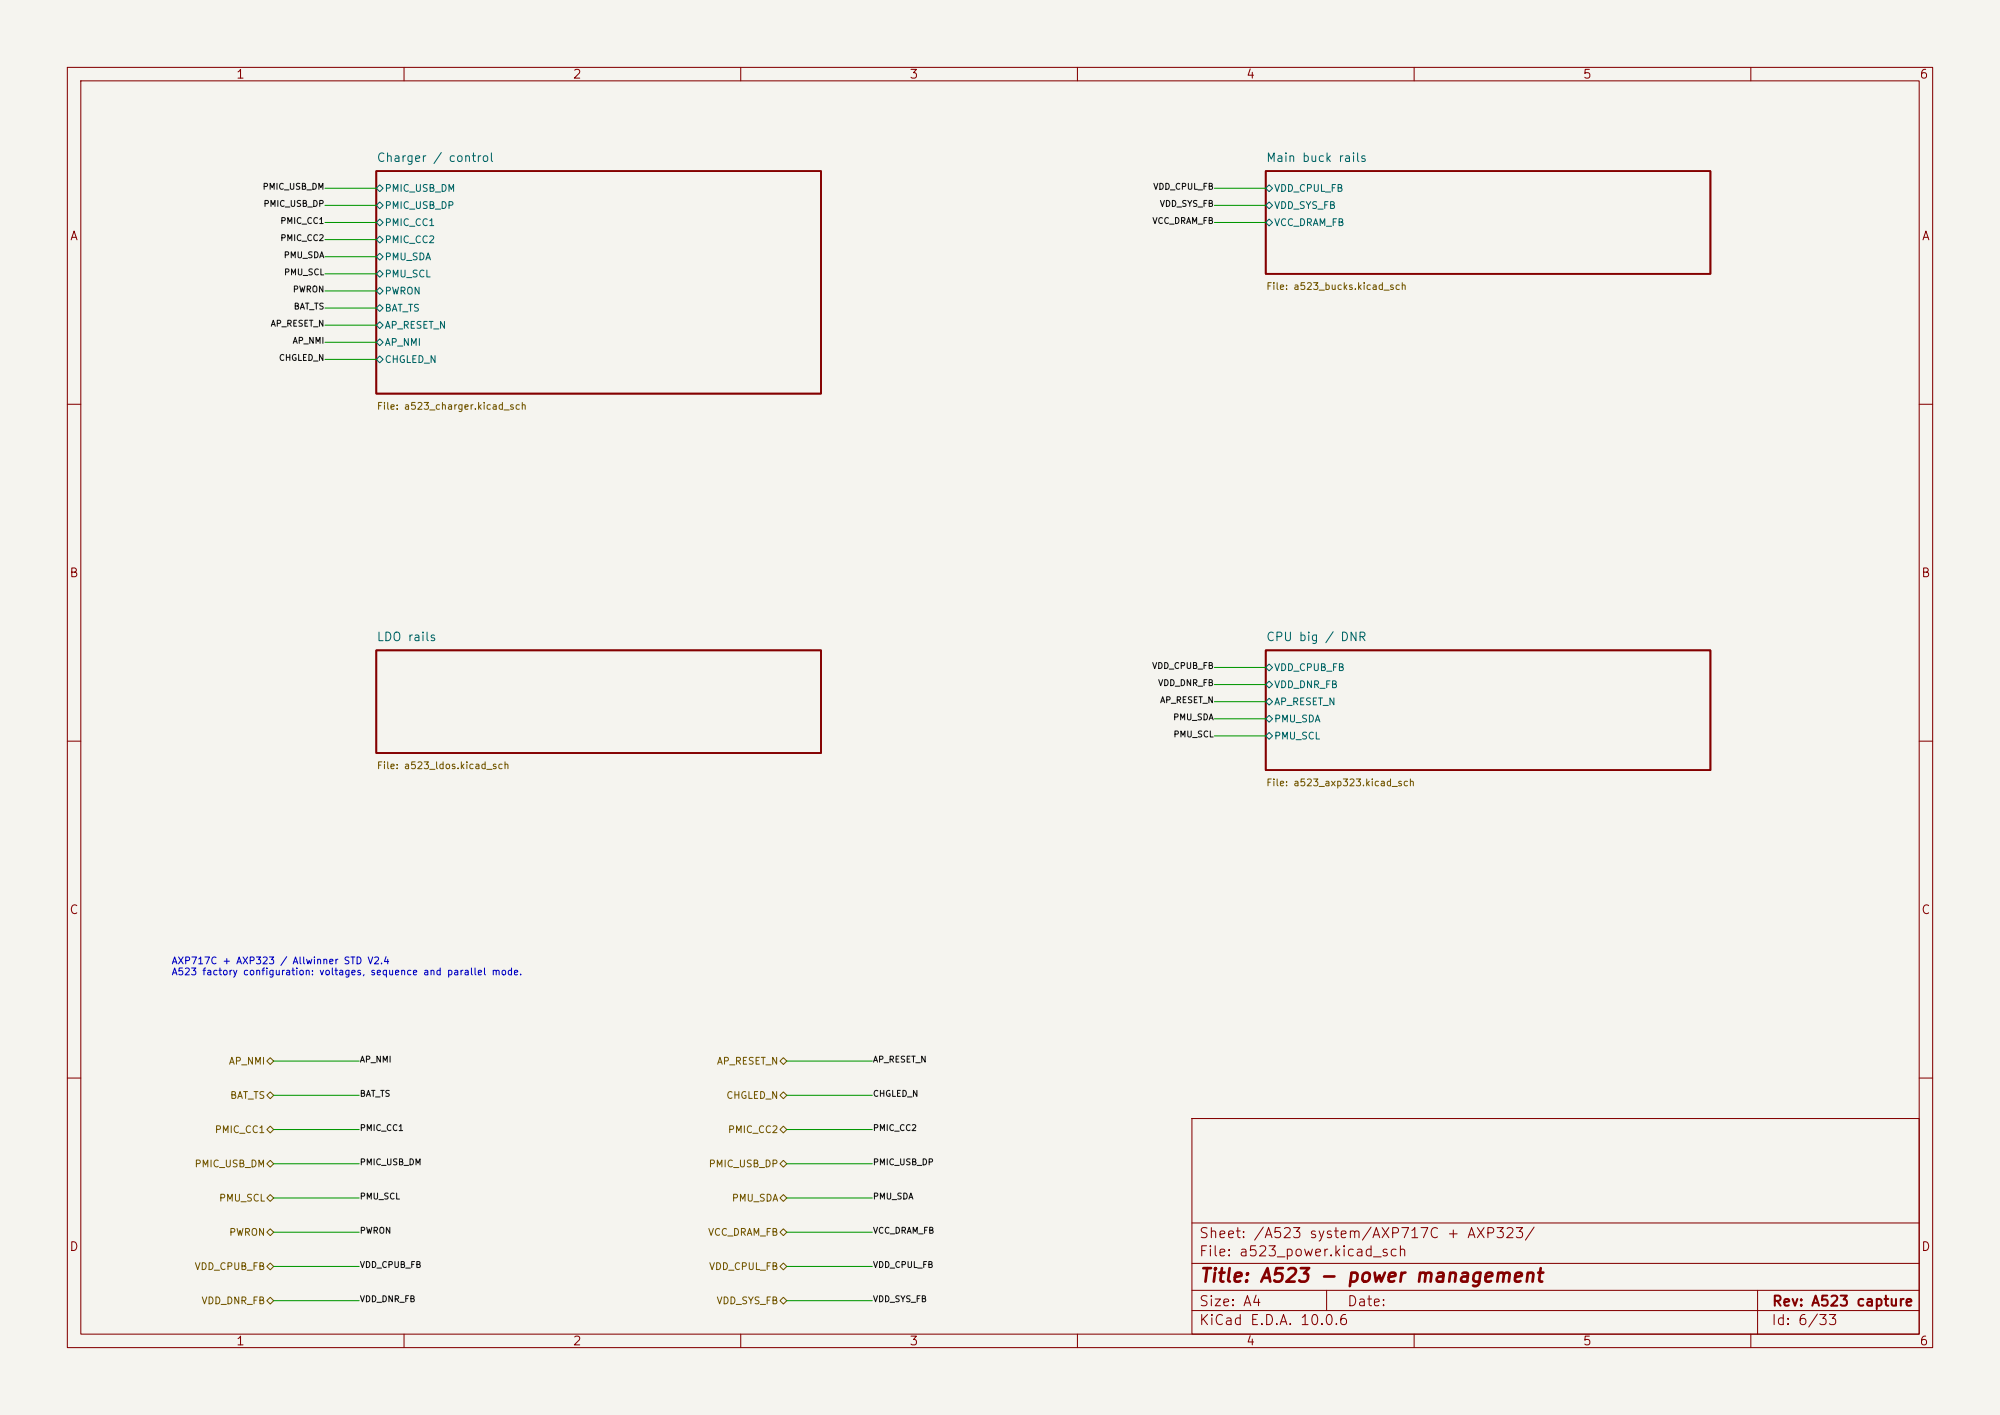
[picture p289: page 1]

AP_NMI CHGLED_N Charger / control File: a523_charger.kicad_sch LDO rails

AXP717C + AXP323 / Allwinner STD V2.4
A523 factory configuration: voltages, sequence and parallel mode.

Size: A4 | Rev: A523 capture
KiCad E.D.A. 10.0.6 | Id: 6/33

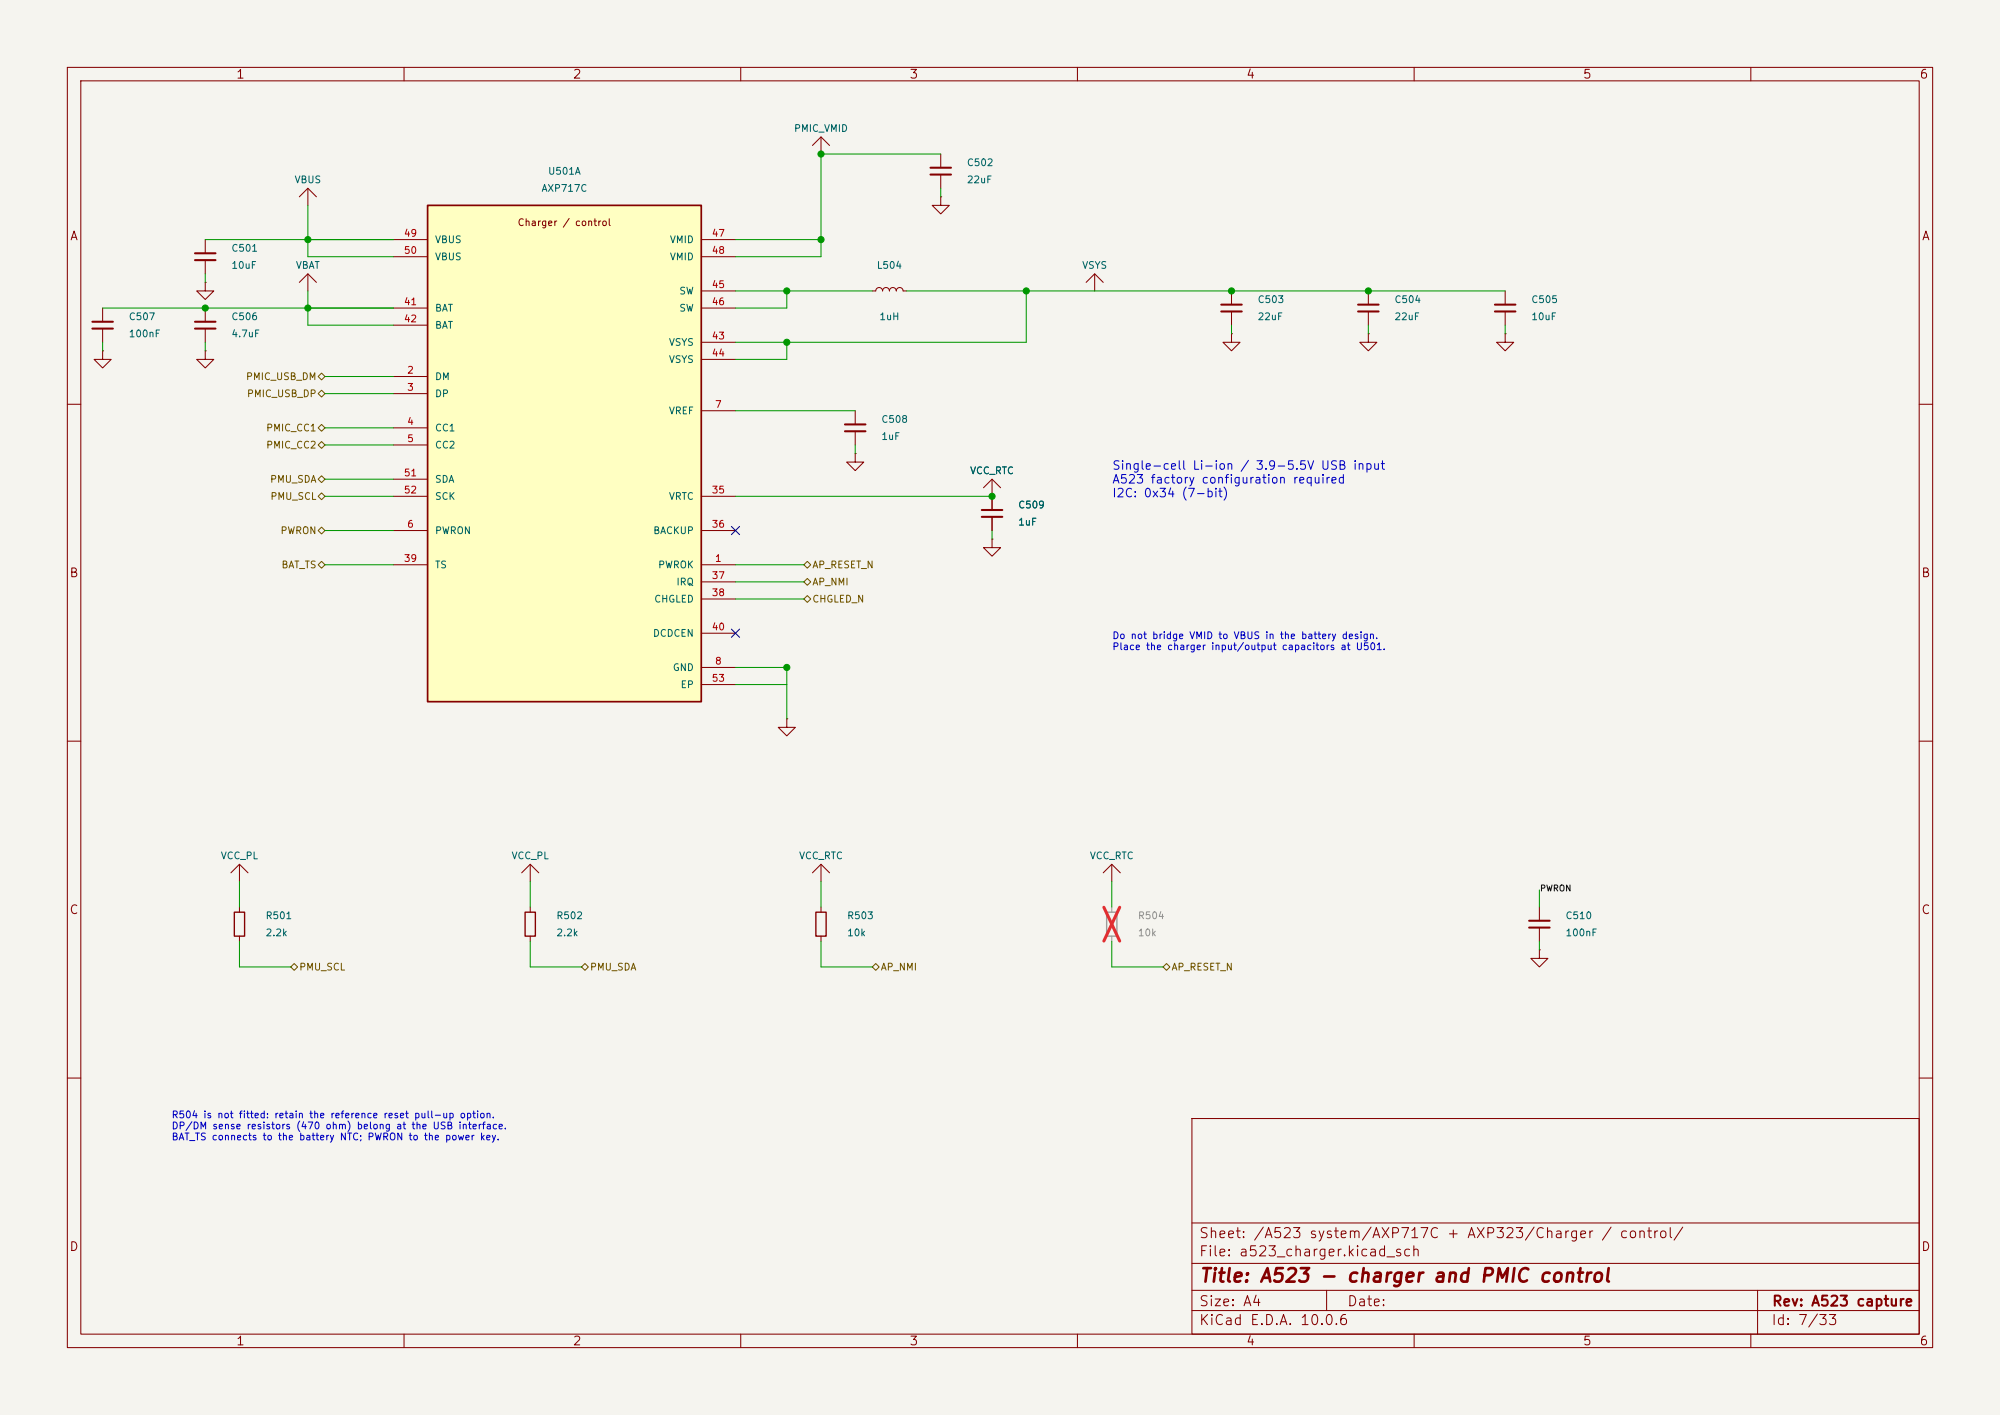
[picture p290: page 2]

Single-cell Li-ion / 3.9-5.5V USB input A523 factory configuration required

I2C: 0x34 (7-bit) Do not bridge VMID to VBUS in the battery design. Place the charger input/output capacitors at U501. C509

PWRON R504 is not fitted: retain the reference reset pull-up option. DP/DM sense resistors (470 ohm) belong at the USB interface. BAT_TS connects to the battery NTC; PWRON to the power key.

Sheet: /A523 system/AXP717C + AXP323/Charger / control/
File: a523_charger.kicad_sch
Title: A523 - charger and PMIC control

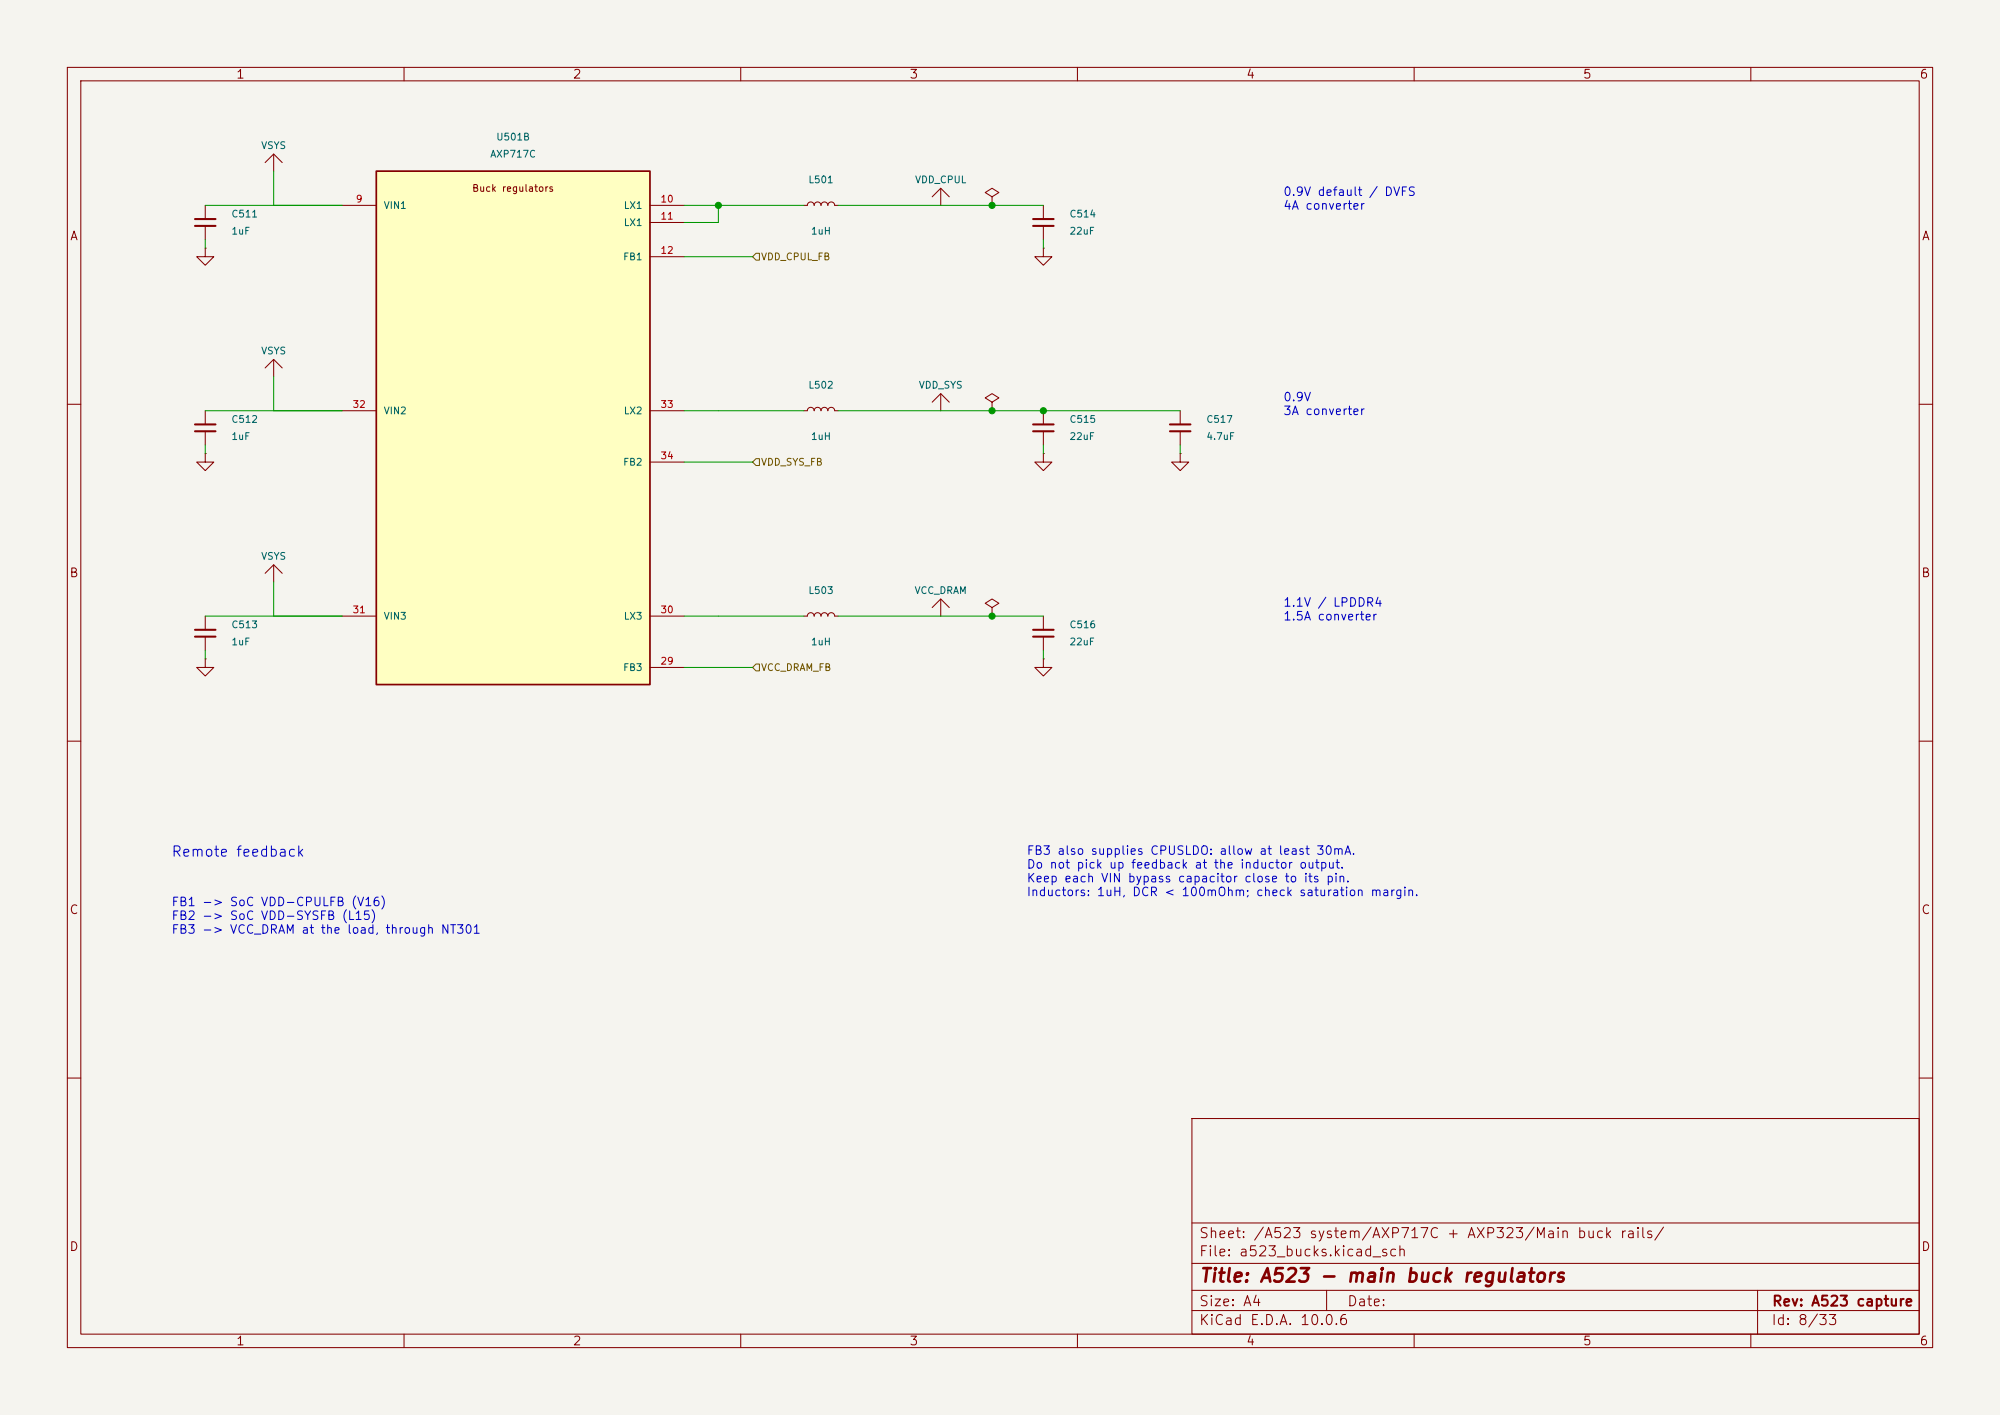
[picture p291: page 3]

4A converter FB1 -> SoC VDD-CPULFB (V16) FB2 -> SoC VDD-SYSFB (L15) FB3 -> VCC_DRAM at the load, through NT301

1.5A converter FB3 also supplies CPUSLDO: allow at least 30mA. Do not pick up feedback at the inductor output.

Keep each VIN bypass capacitor close to its pin.
Inductors: 1uH, DCR < 100mOhm; check saturation margin.

Sheet: /A523 system/AXP717C + AXP323/Main buck rails/
File: a523_bucks.kicad_sch
Title: A523 - main buck regulators

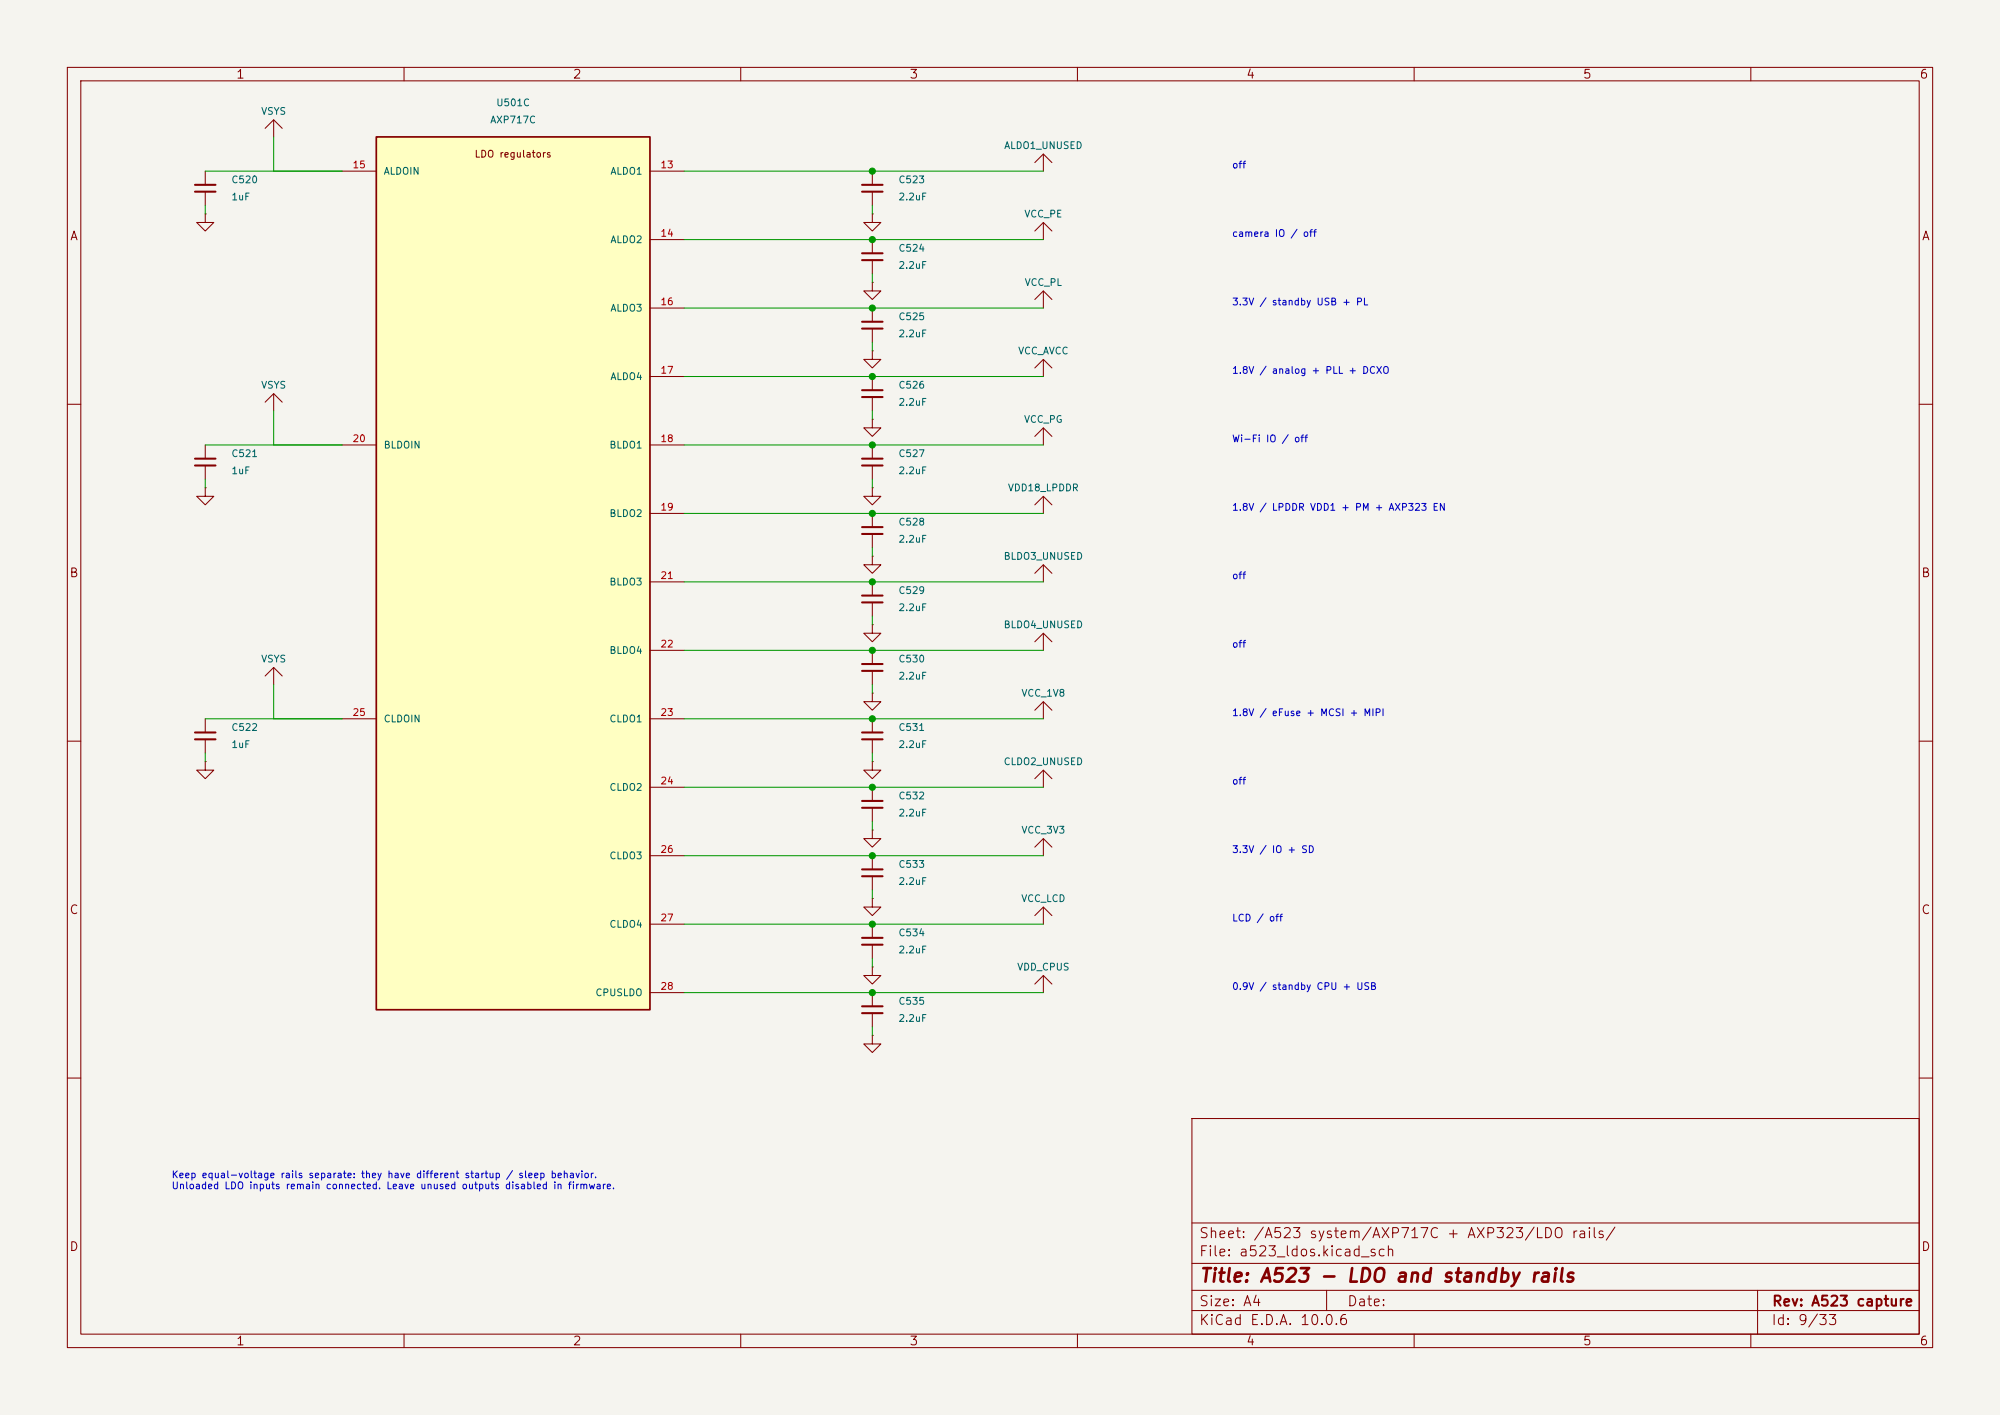
[picture p292: page 4]

VCC_PL ALDO1_UNUSED
off 1.8V / analog + PLL + DCXO

camera IO / off off

3.3V / standby USB + PL Wi-Fi IO / off 1.8V / LPDDR VDD1 + PM + AXP323 EN

Keep equal-voltage rails separate: they have different startup / sleep behavior. Unloaded LDO inputs remain connected. Leave unused outputs disabled in firmware.

Sheet: /A523 system/AXP717C + AXP323/LDO rails/
File: a523_ldos.kicad_sch
Title: A523 - LDO and standby rails

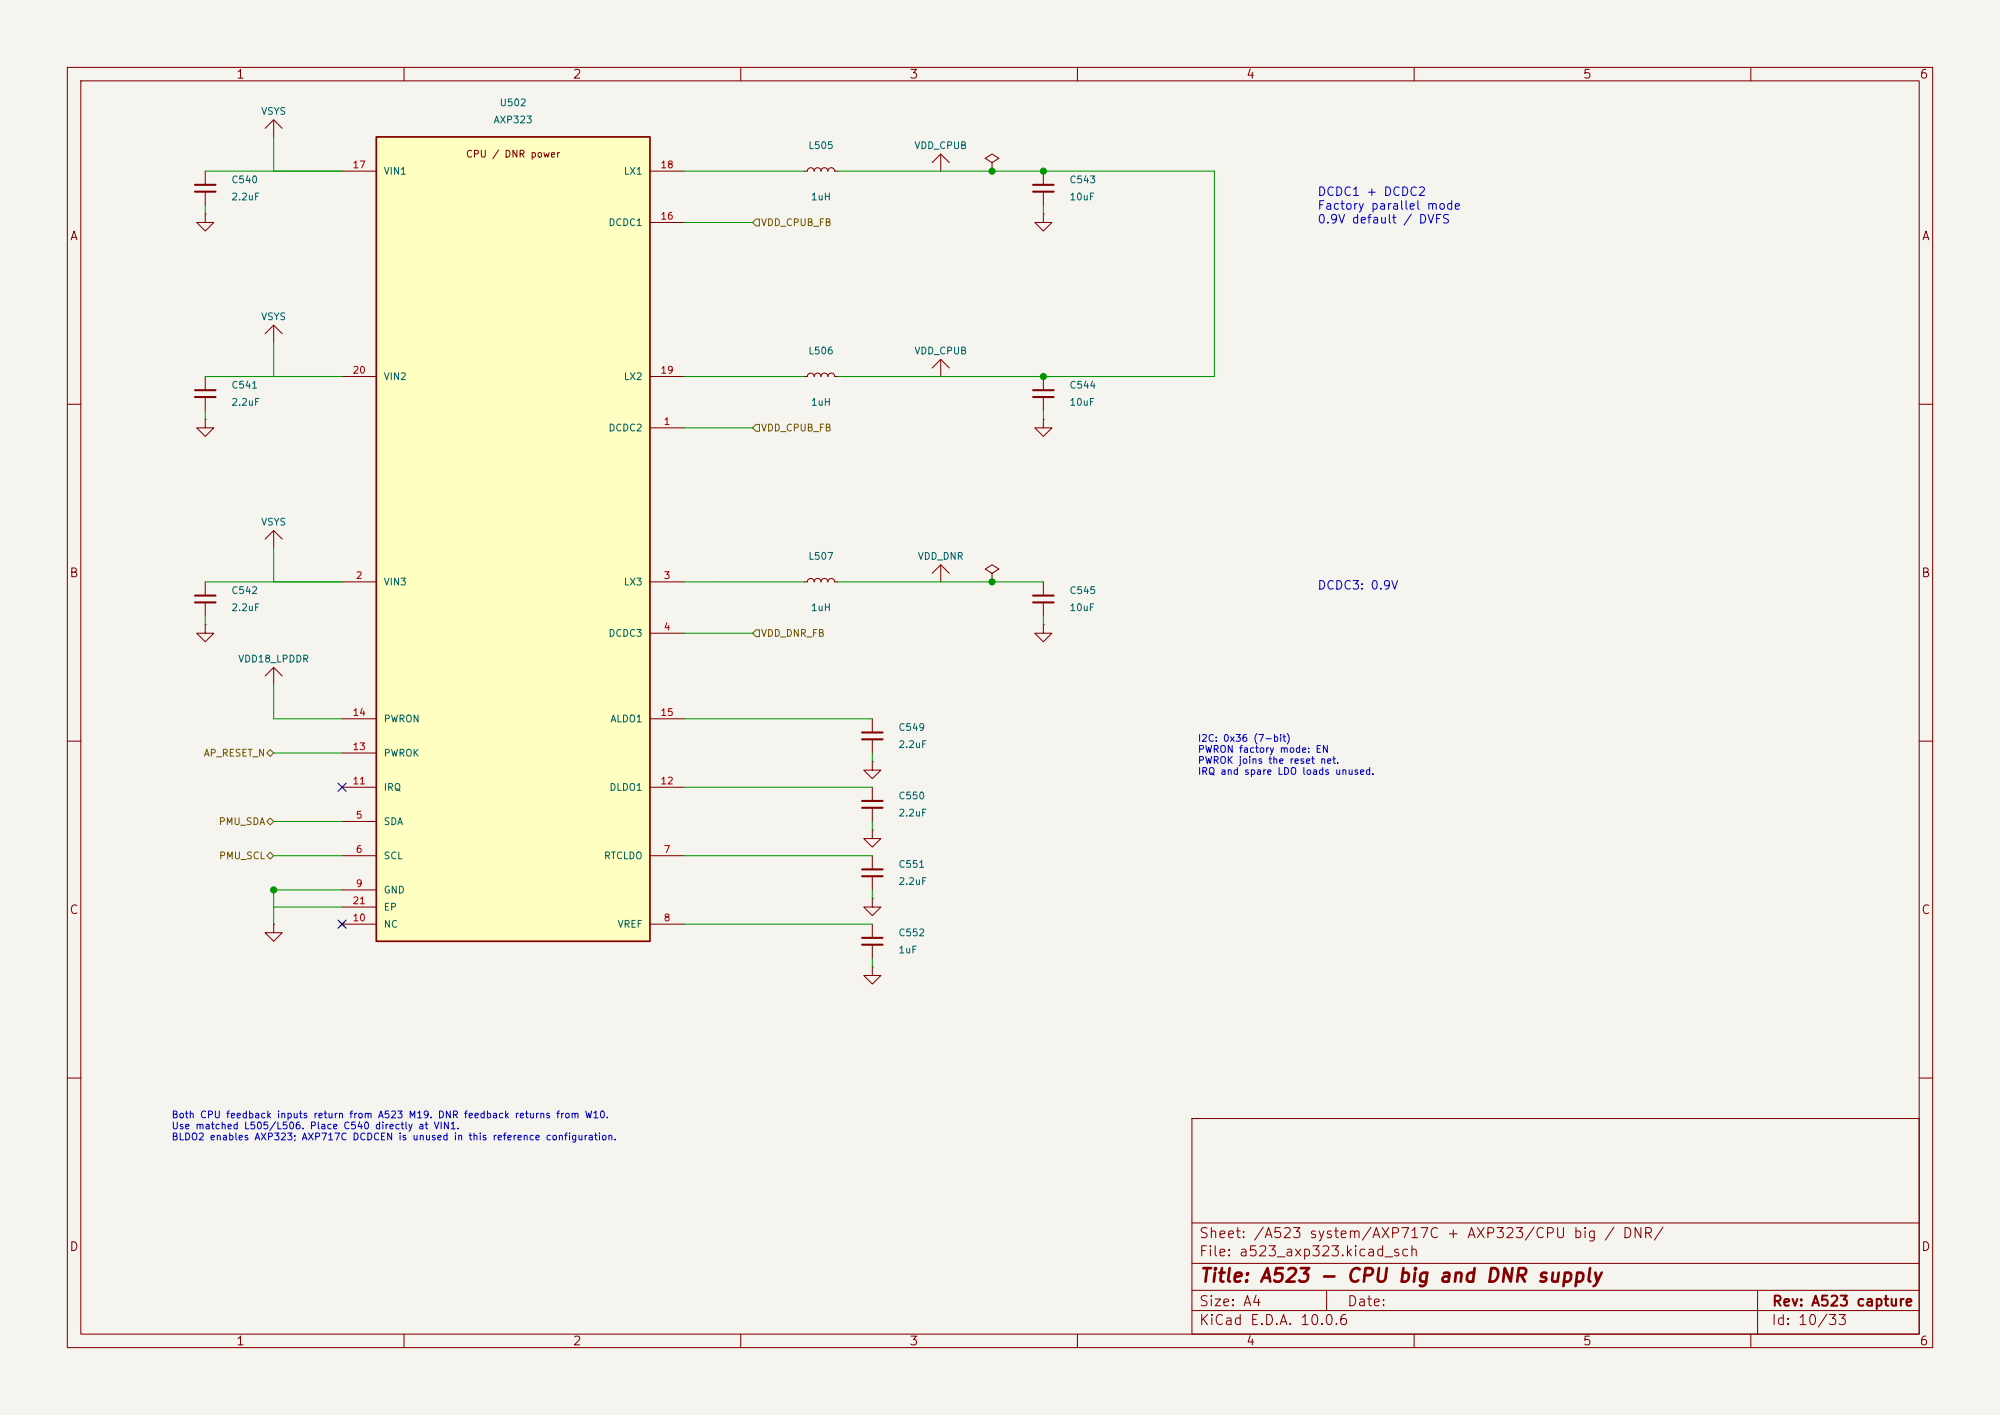
[picture p293: page 5]

VDD_CPUB
Factory parallel mode 0.9V default / DVFS DCDC3: 0.9V

I2C: 0x36 (7-bit) PWRON factory mode: EN

PWROK joins the reset net.
IRQ and spare LDO loads unused.

Both CPU feedback inputs return from A523 M19. DNR feedback returns from W10. Use matched L505/L506. Place C540 directly at VIN1. BLDO2 enables AXP323; AXP717C DCDCEN is unused in this reference configuration.

Sheet: /A523 system/AXP717C + AXP323/CPU big / DNR/
File: a523_axp323.kicad_sch
Title: A523 - CPU big and DNR supply
