o7-machinehum/Blackpants/ee/integrated/capture/review.pdf

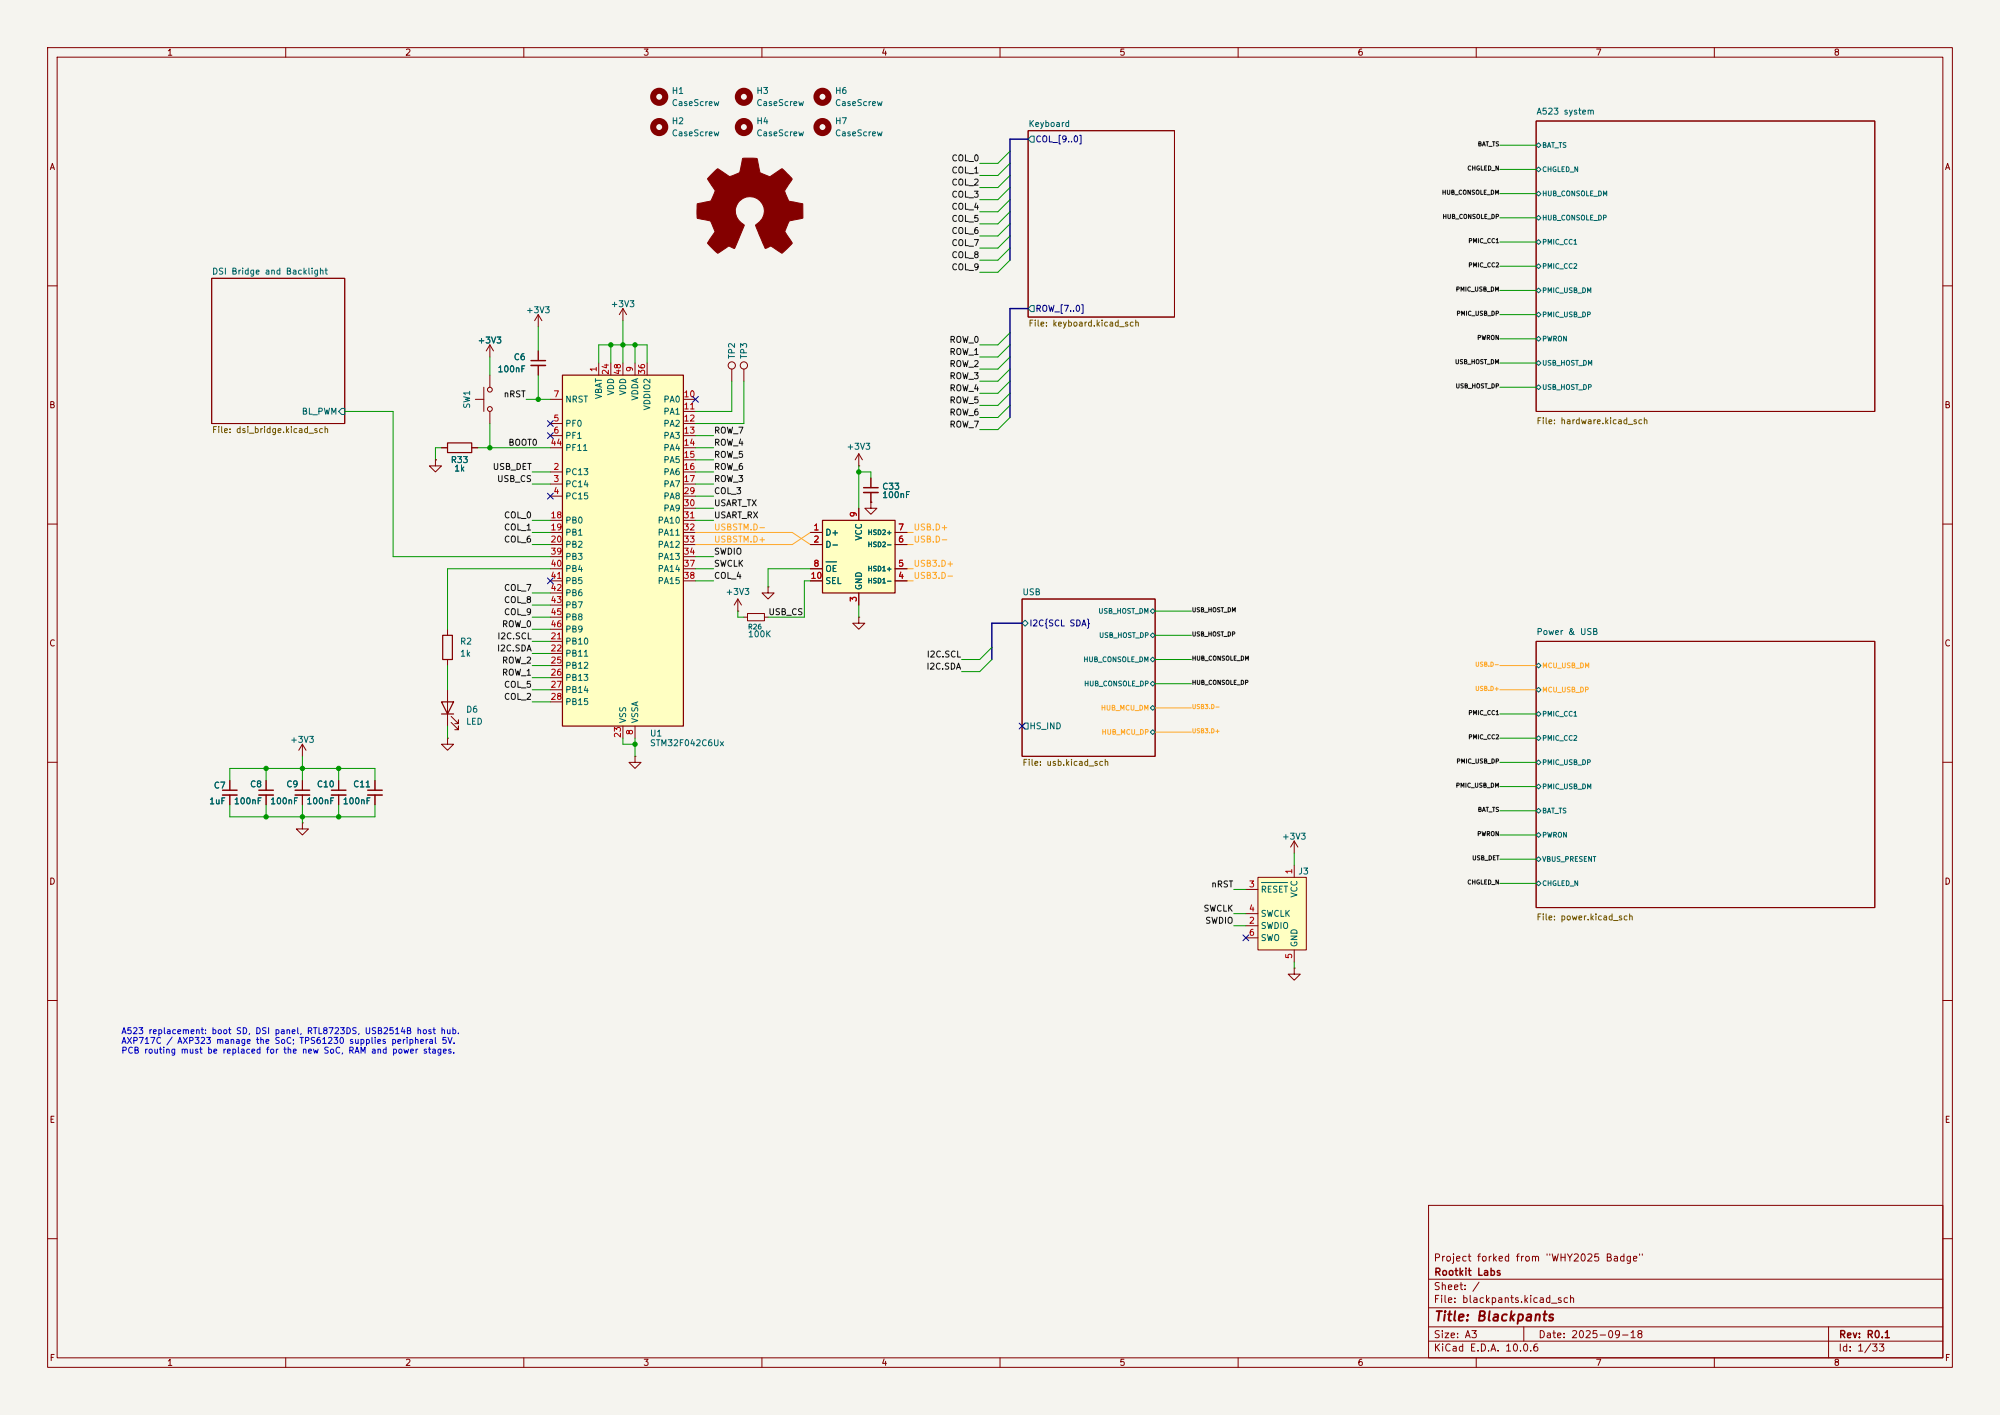
[picture p294: page 1]

DSI Bridge and Backlight File: dsi_bridge.kicad_sch

A523 replacement: boot SD, DSI panel, RTL8723DS, USB2514B host hub. AXP717C / AXP323 manage the SoC; TPS61230 supplies peripheral 5V. PCB routing must be replaced for the new SoC, RAM and power stages. C11

Project forked from "WHY2025 Badge"
Rootkit Labs
Sheet: /
File: blackpants.kicad_sch
Title: Blackpants

Size: A3 | Rev: R0.1 | F Date: 2025-09-18
KiCad E.D.A. 10.0.6 | Id: 1/33

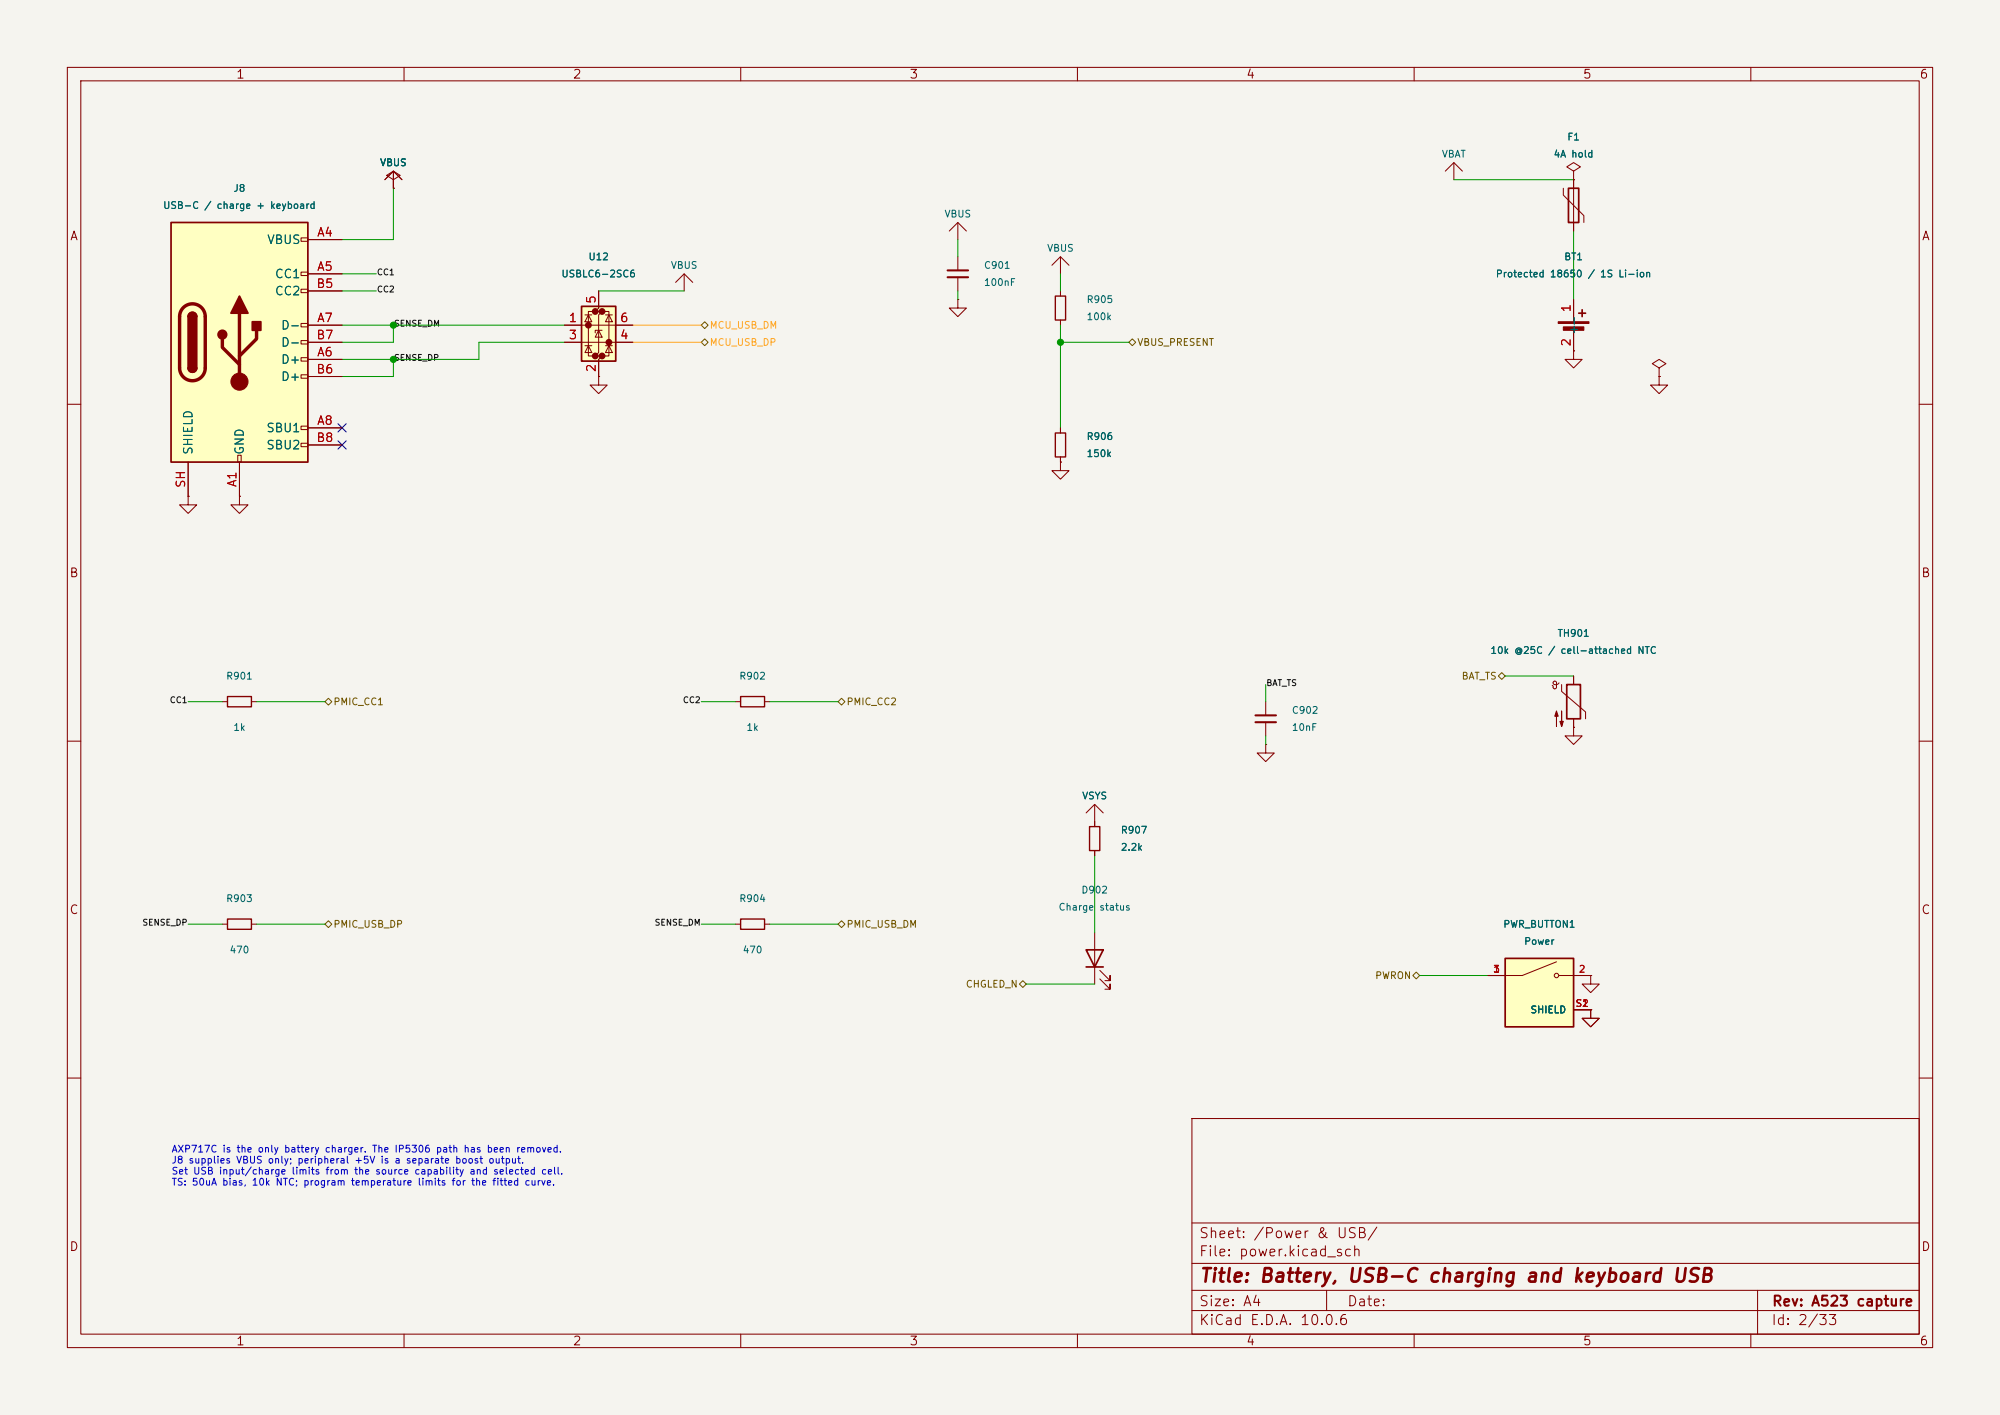
[picture p295: page 2]

J8 USB-C / charge + keyboard GND A1

AXP717C is the only battery charger. The IP5306 path has been removed. J8 supplies VBUS only; peripheral +5V is a separate boost output. Set USB input/charge limits from the source capability and selected cell. TS: 50uA bias, 10k NTC; program temperature limits for the fitted curve.

Sheet: /Power & USB/
File: power.kicad_sch
Title: Battery, USB-C charging and keyboard USB

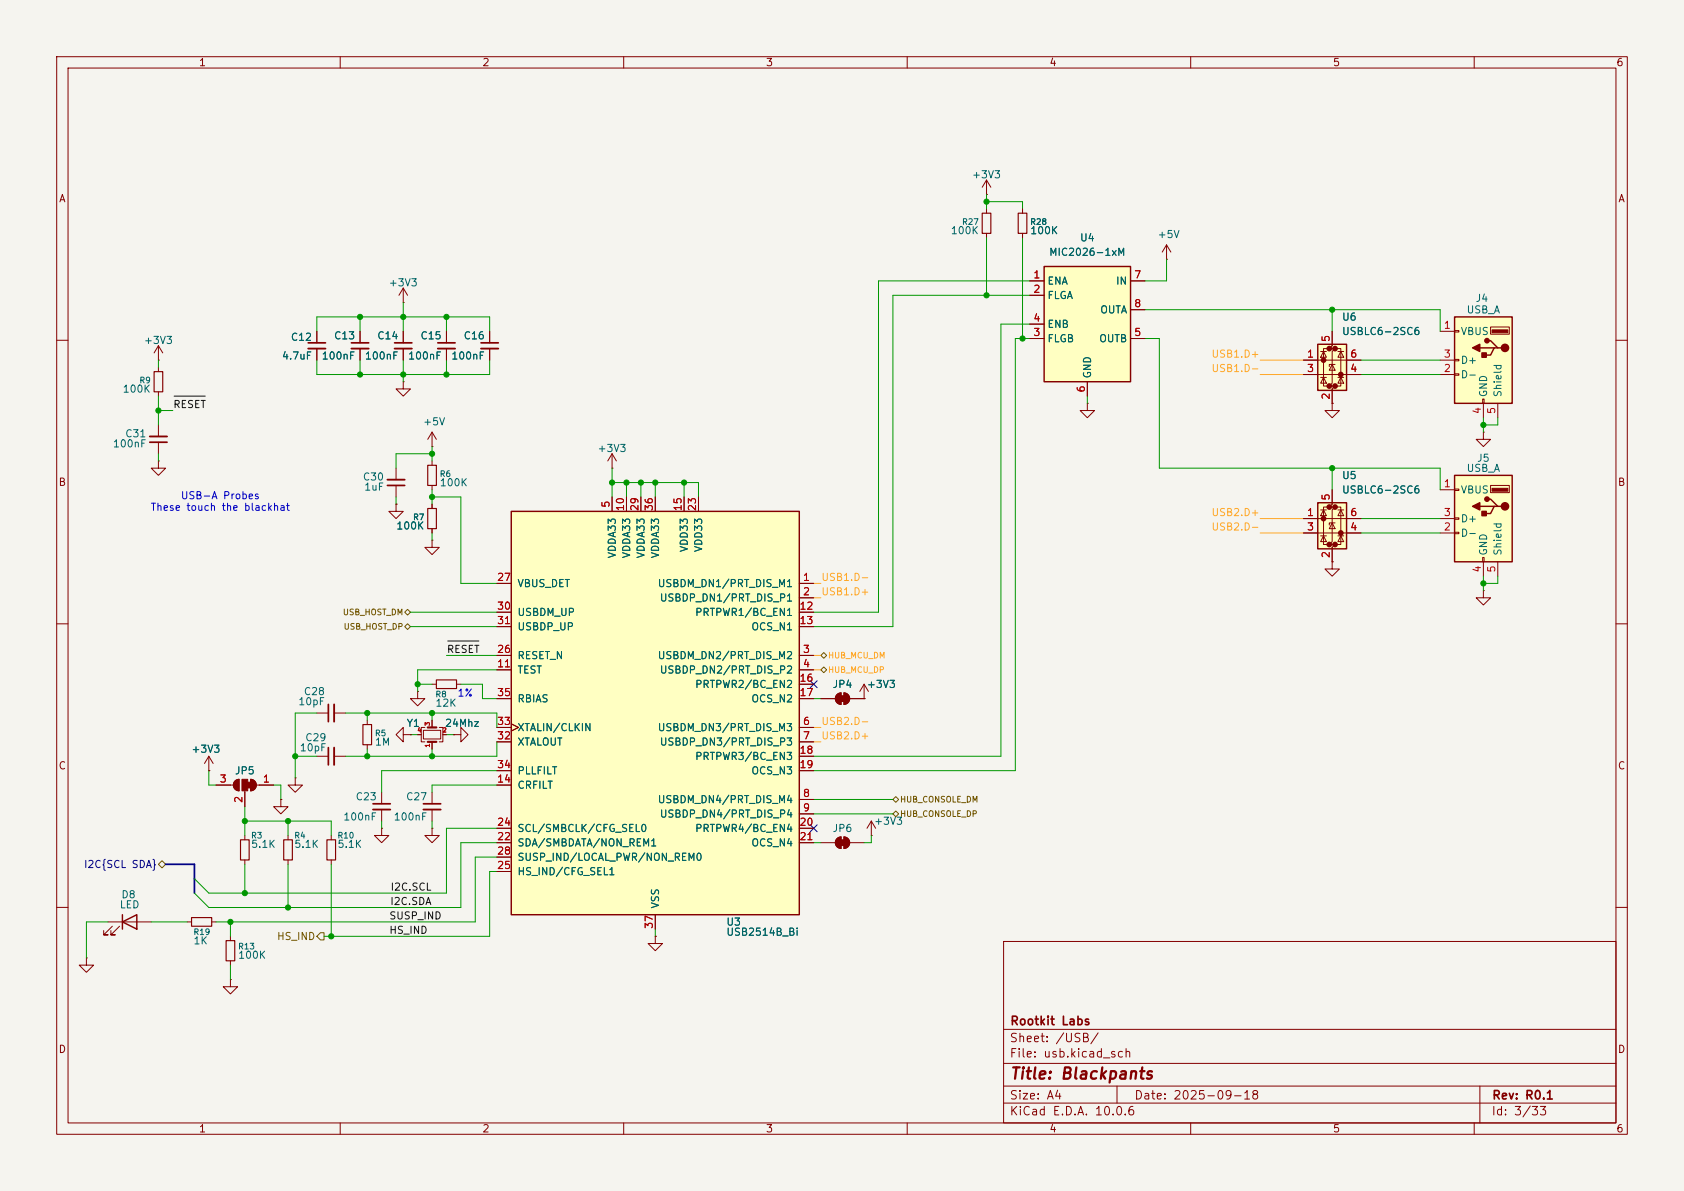
[picture p296: page 3]

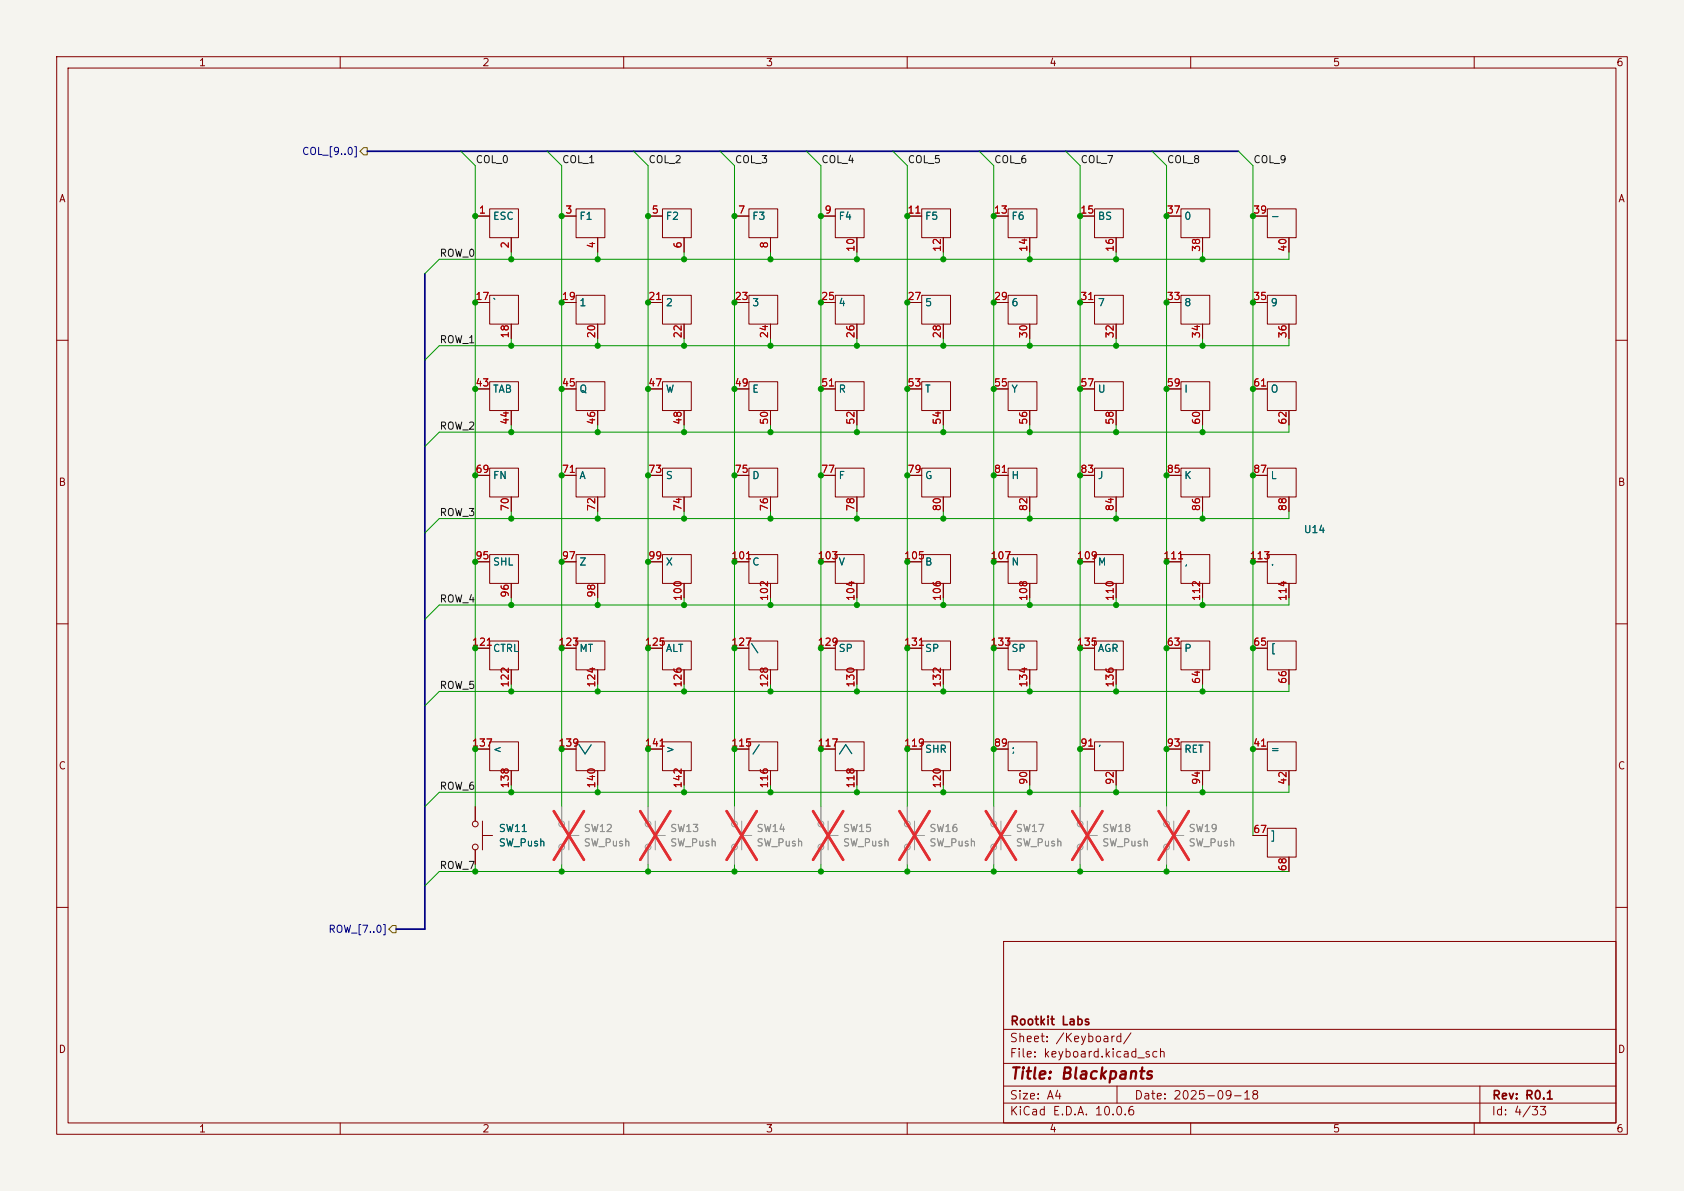
[picture p297: page 4]

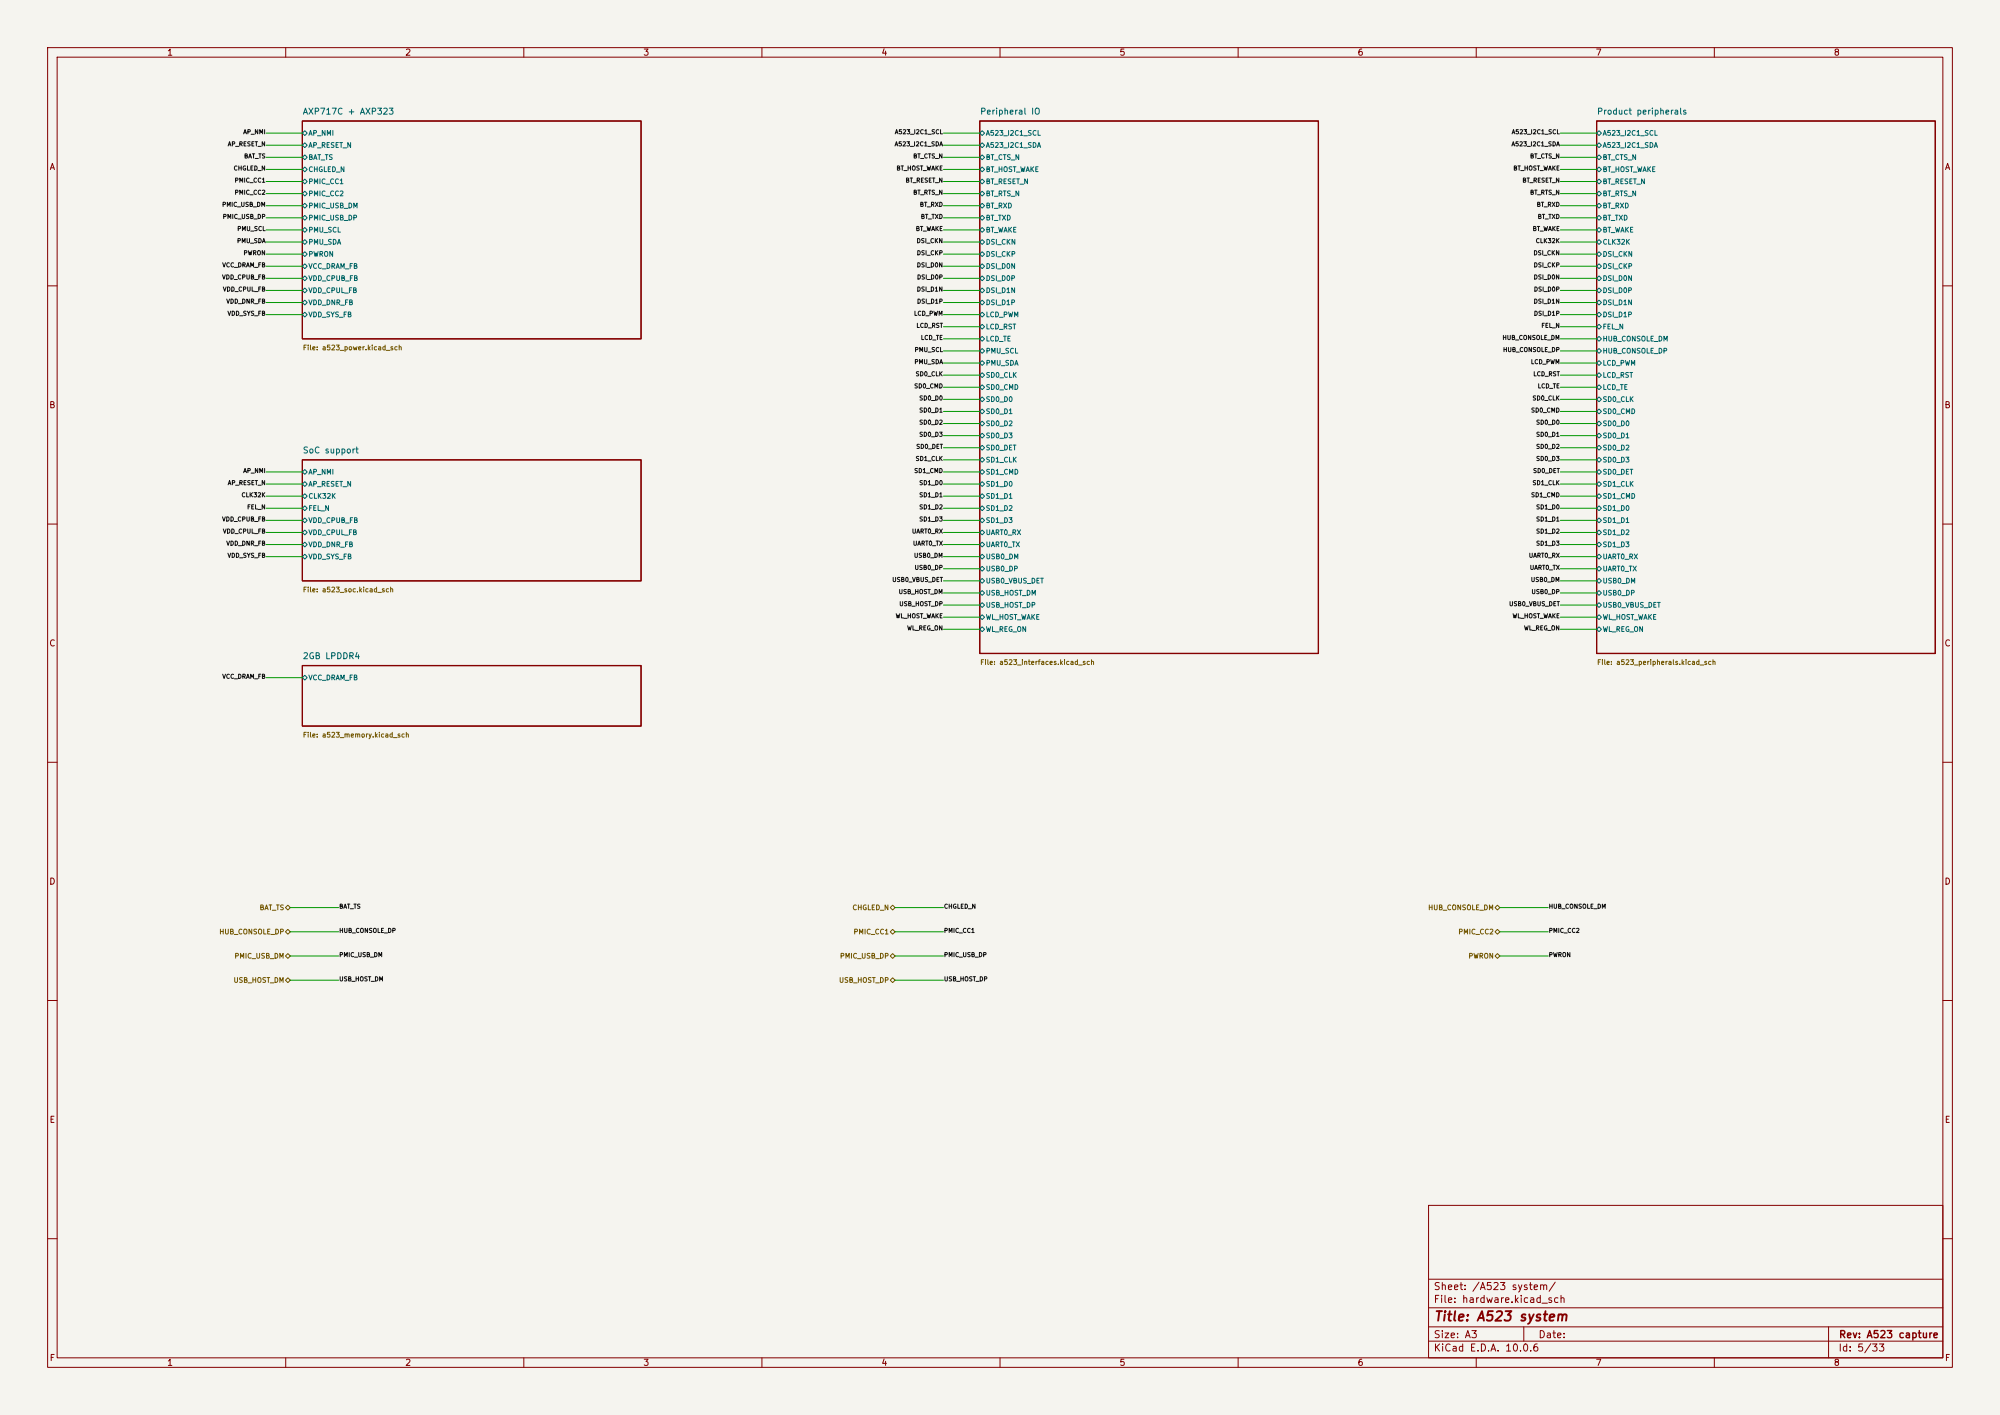
[picture p298: page 5]


AP_NMI CHGLED_N Charger / control File: a523_charger.kicad_sch LDO rails

AXP717C + AXP323 / Allwinner STD V2.4
A523 factory configuration: voltages, sequence and parallel mode.

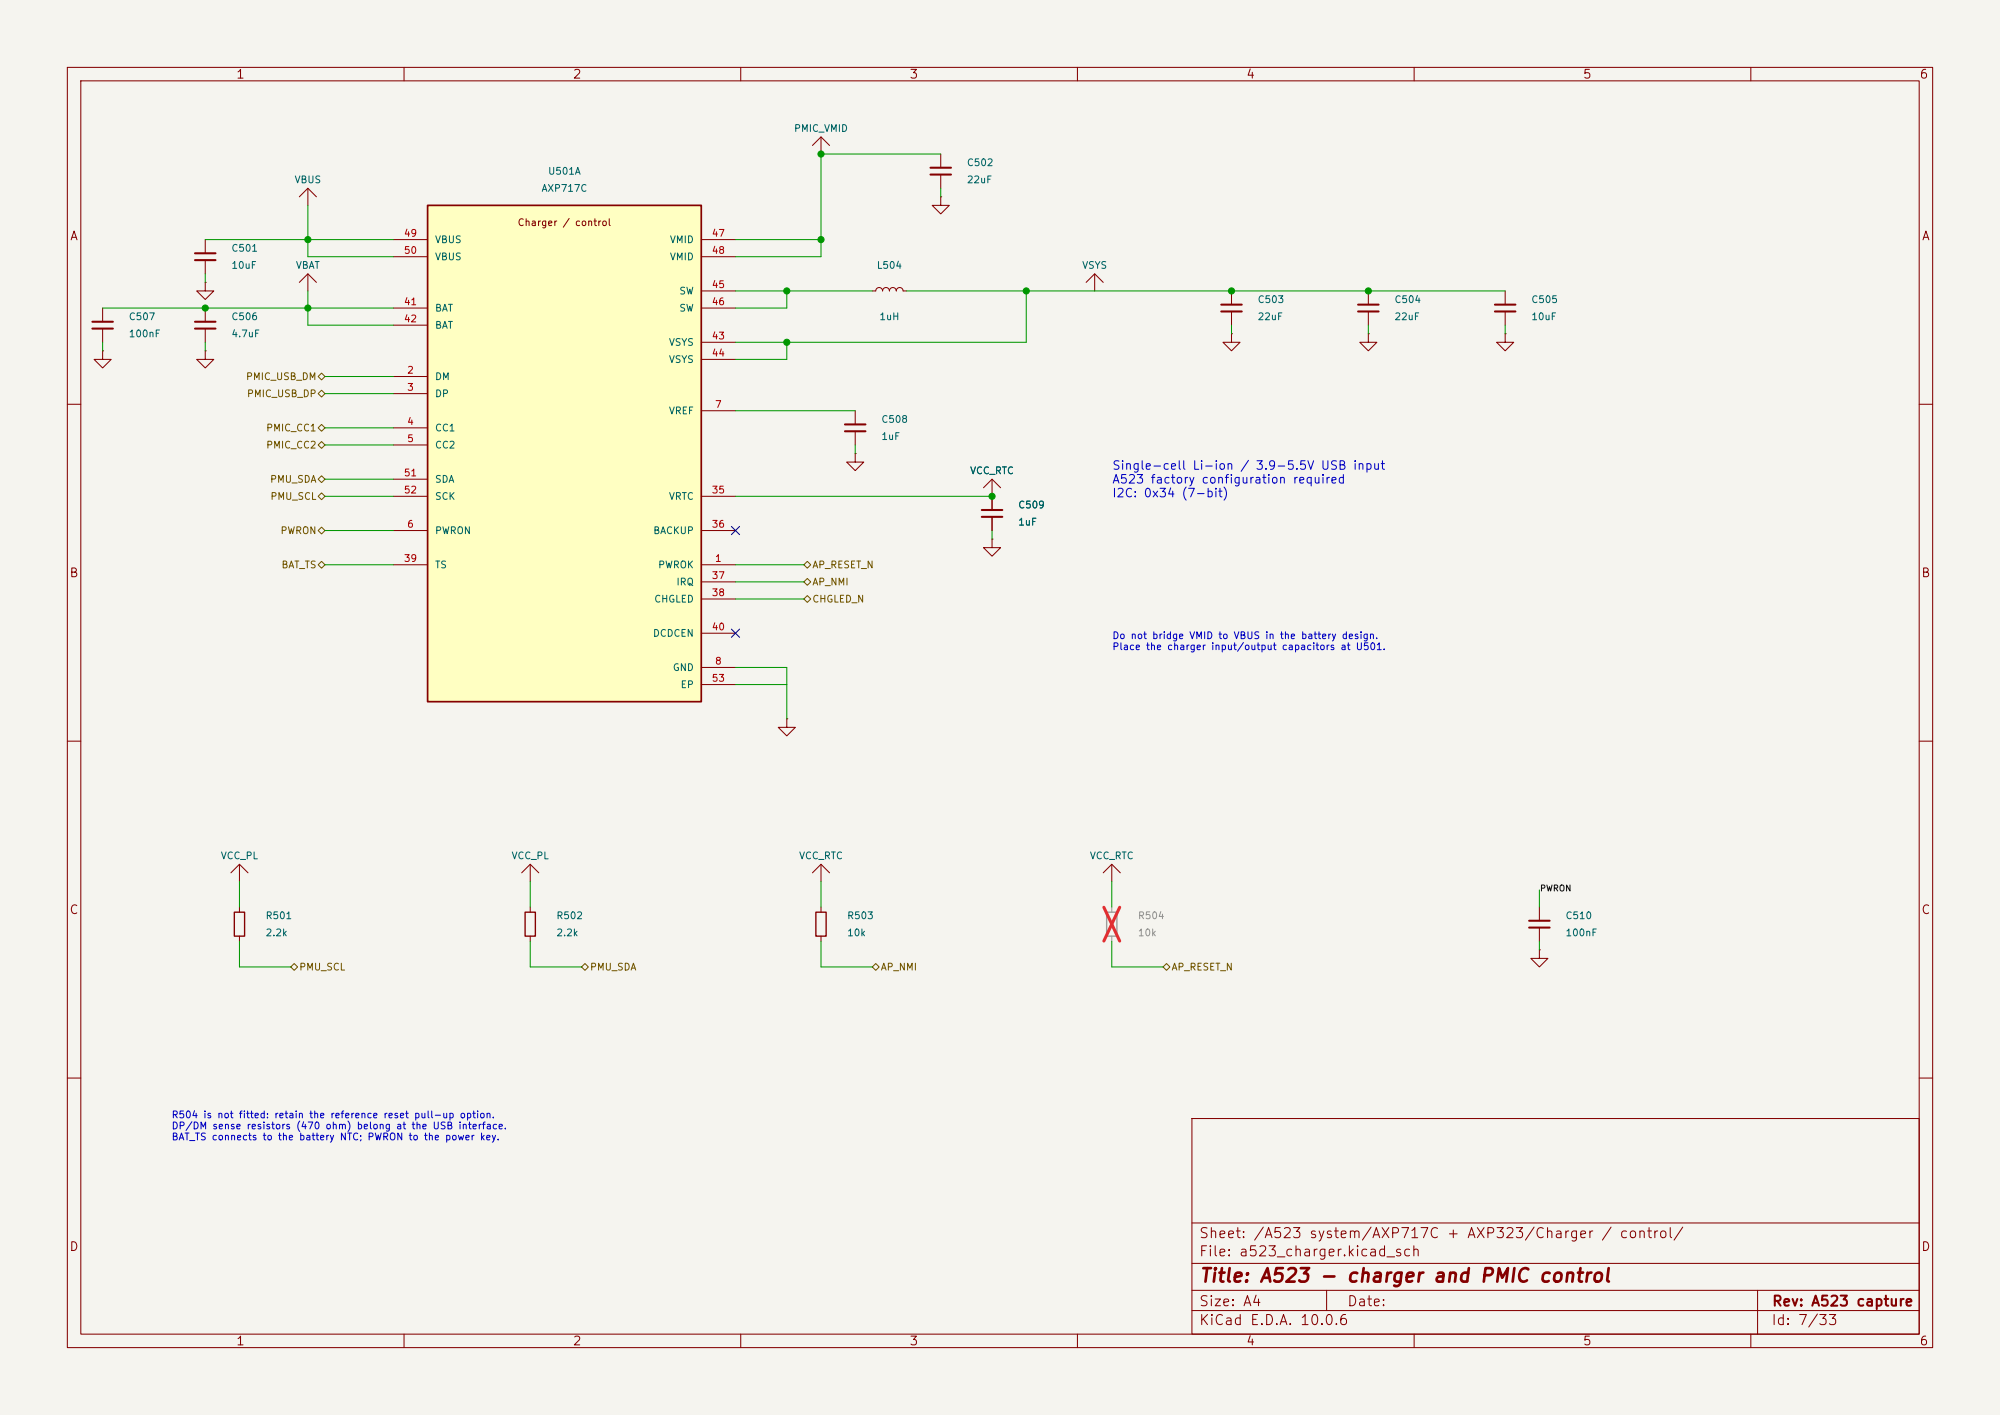
[picture p299: page 7]

Do not bridge VMID to VBUS in the battery design. Place the charger input/output capacitors at U501. Single-cell Li-ion / 3.9-5.5V USB input A523 factory configuration required

Sheet: /A523 system/AXP717C + AXP323/Charger / control/
File: a523_charger.kicad_sch
Title: A523 - charger and PMIC control

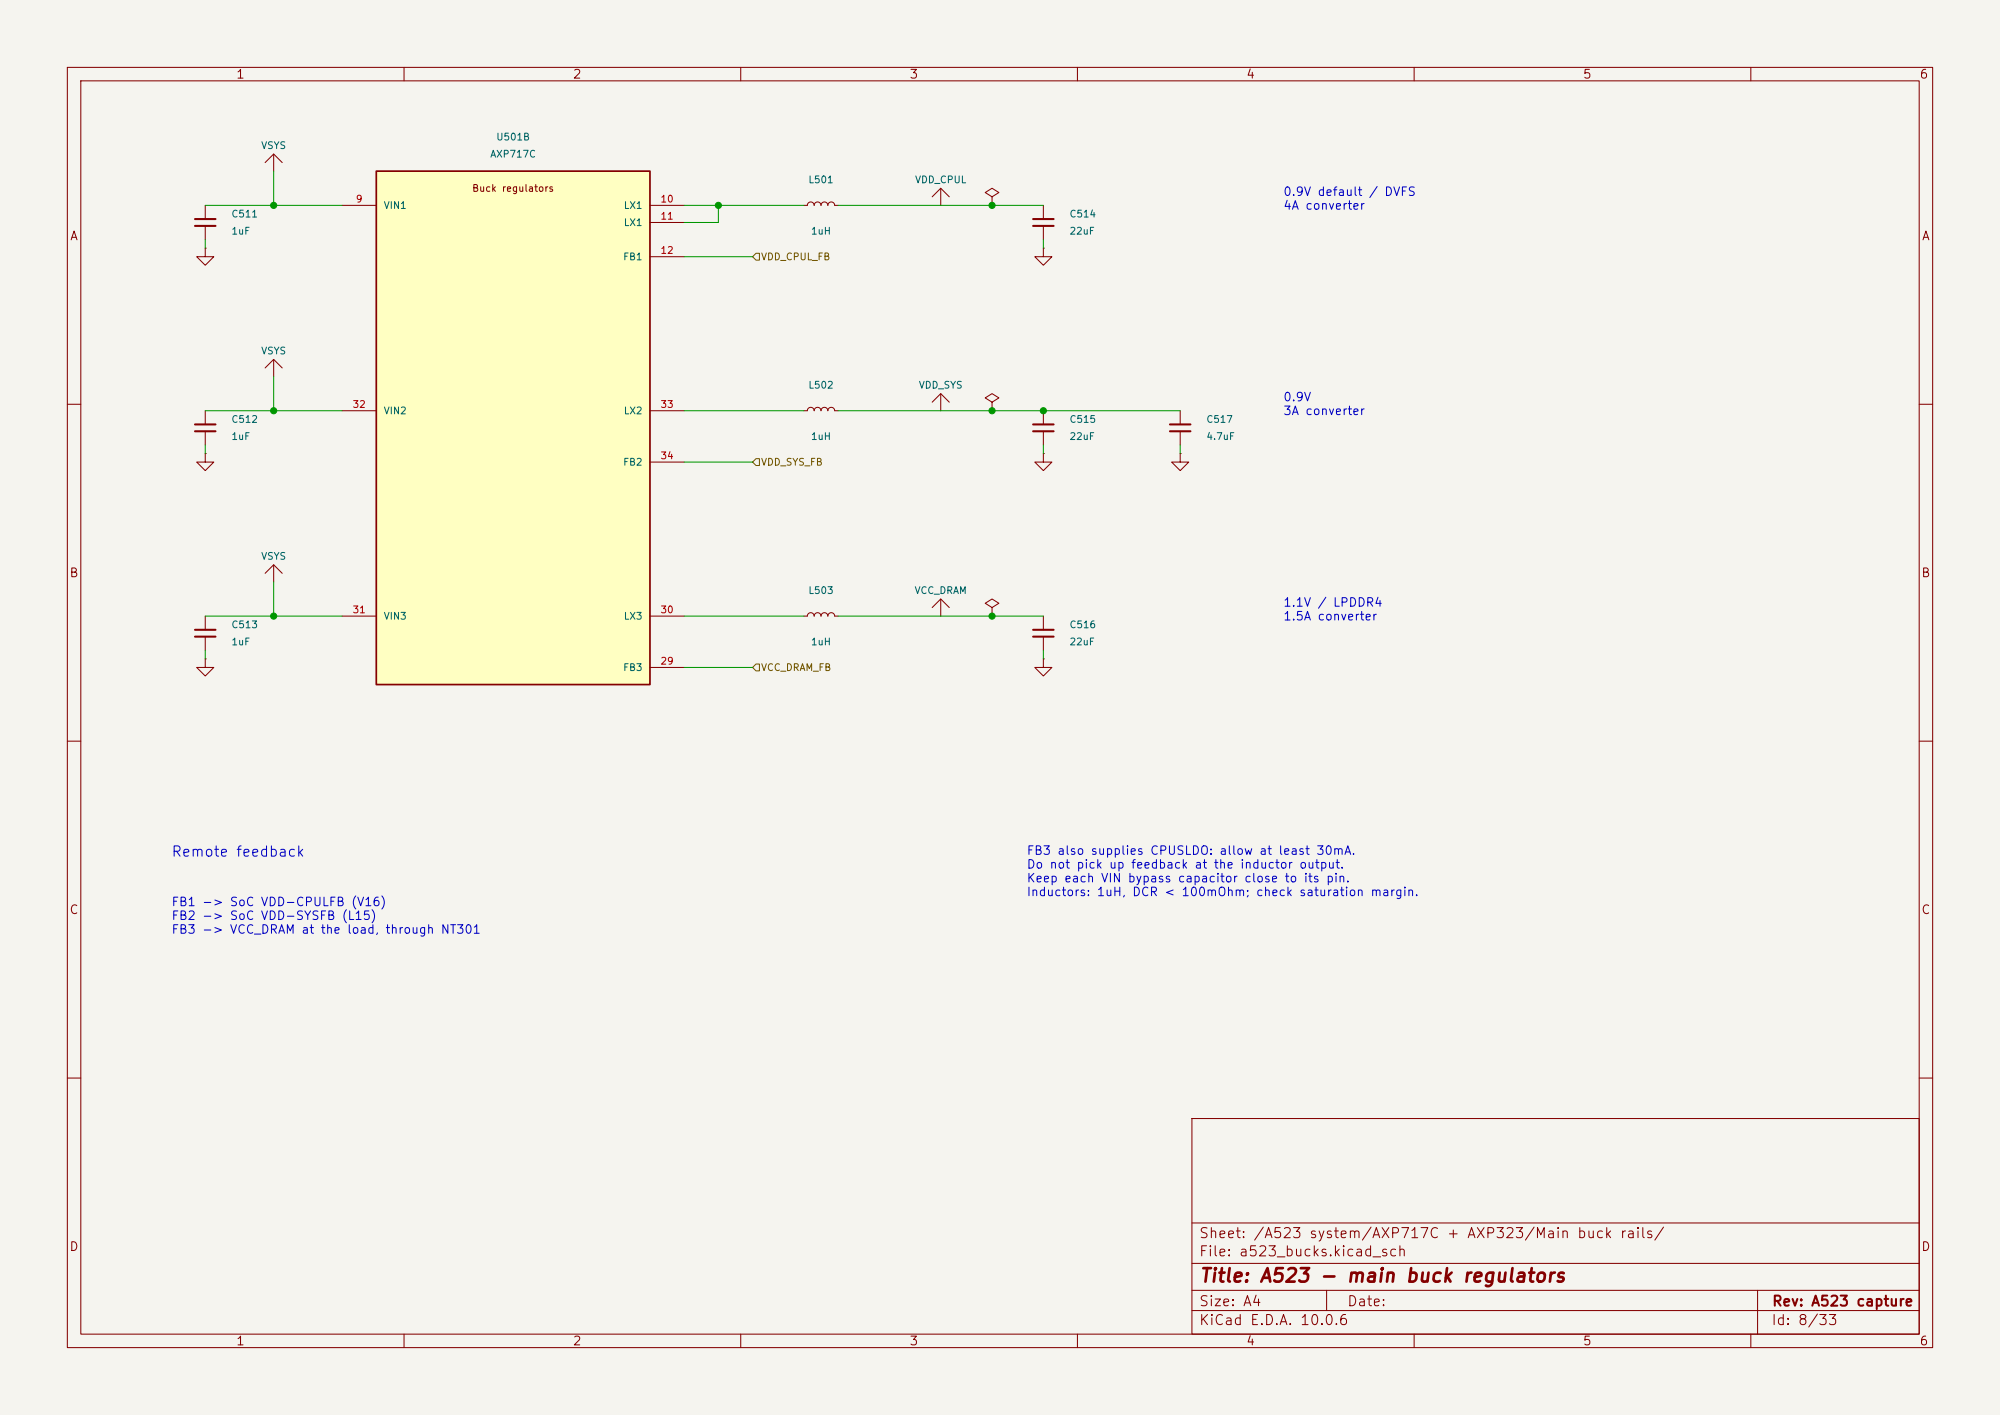
[picture p300: page 8]

1.5A converter FB3 also supplies CPUSLDO: allow at least 30mA. Do not pick up feedback at the inductor output.

Keep each VIN bypass capacitor close to its pin.
Inductors: 1uH, DCR < 100mOhm; check saturation margin.

FB1 -> SoC VDD-CPULFB (V16) FB2 -> SoC VDD-SYSFB (L15) FB3 -> VCC_DRAM at the load, through NT301

Sheet: /A523 system/AXP717C + AXP323/Main buck rails/
File: a523_bucks.kicad_sch
Title: A523 - main buck regulators

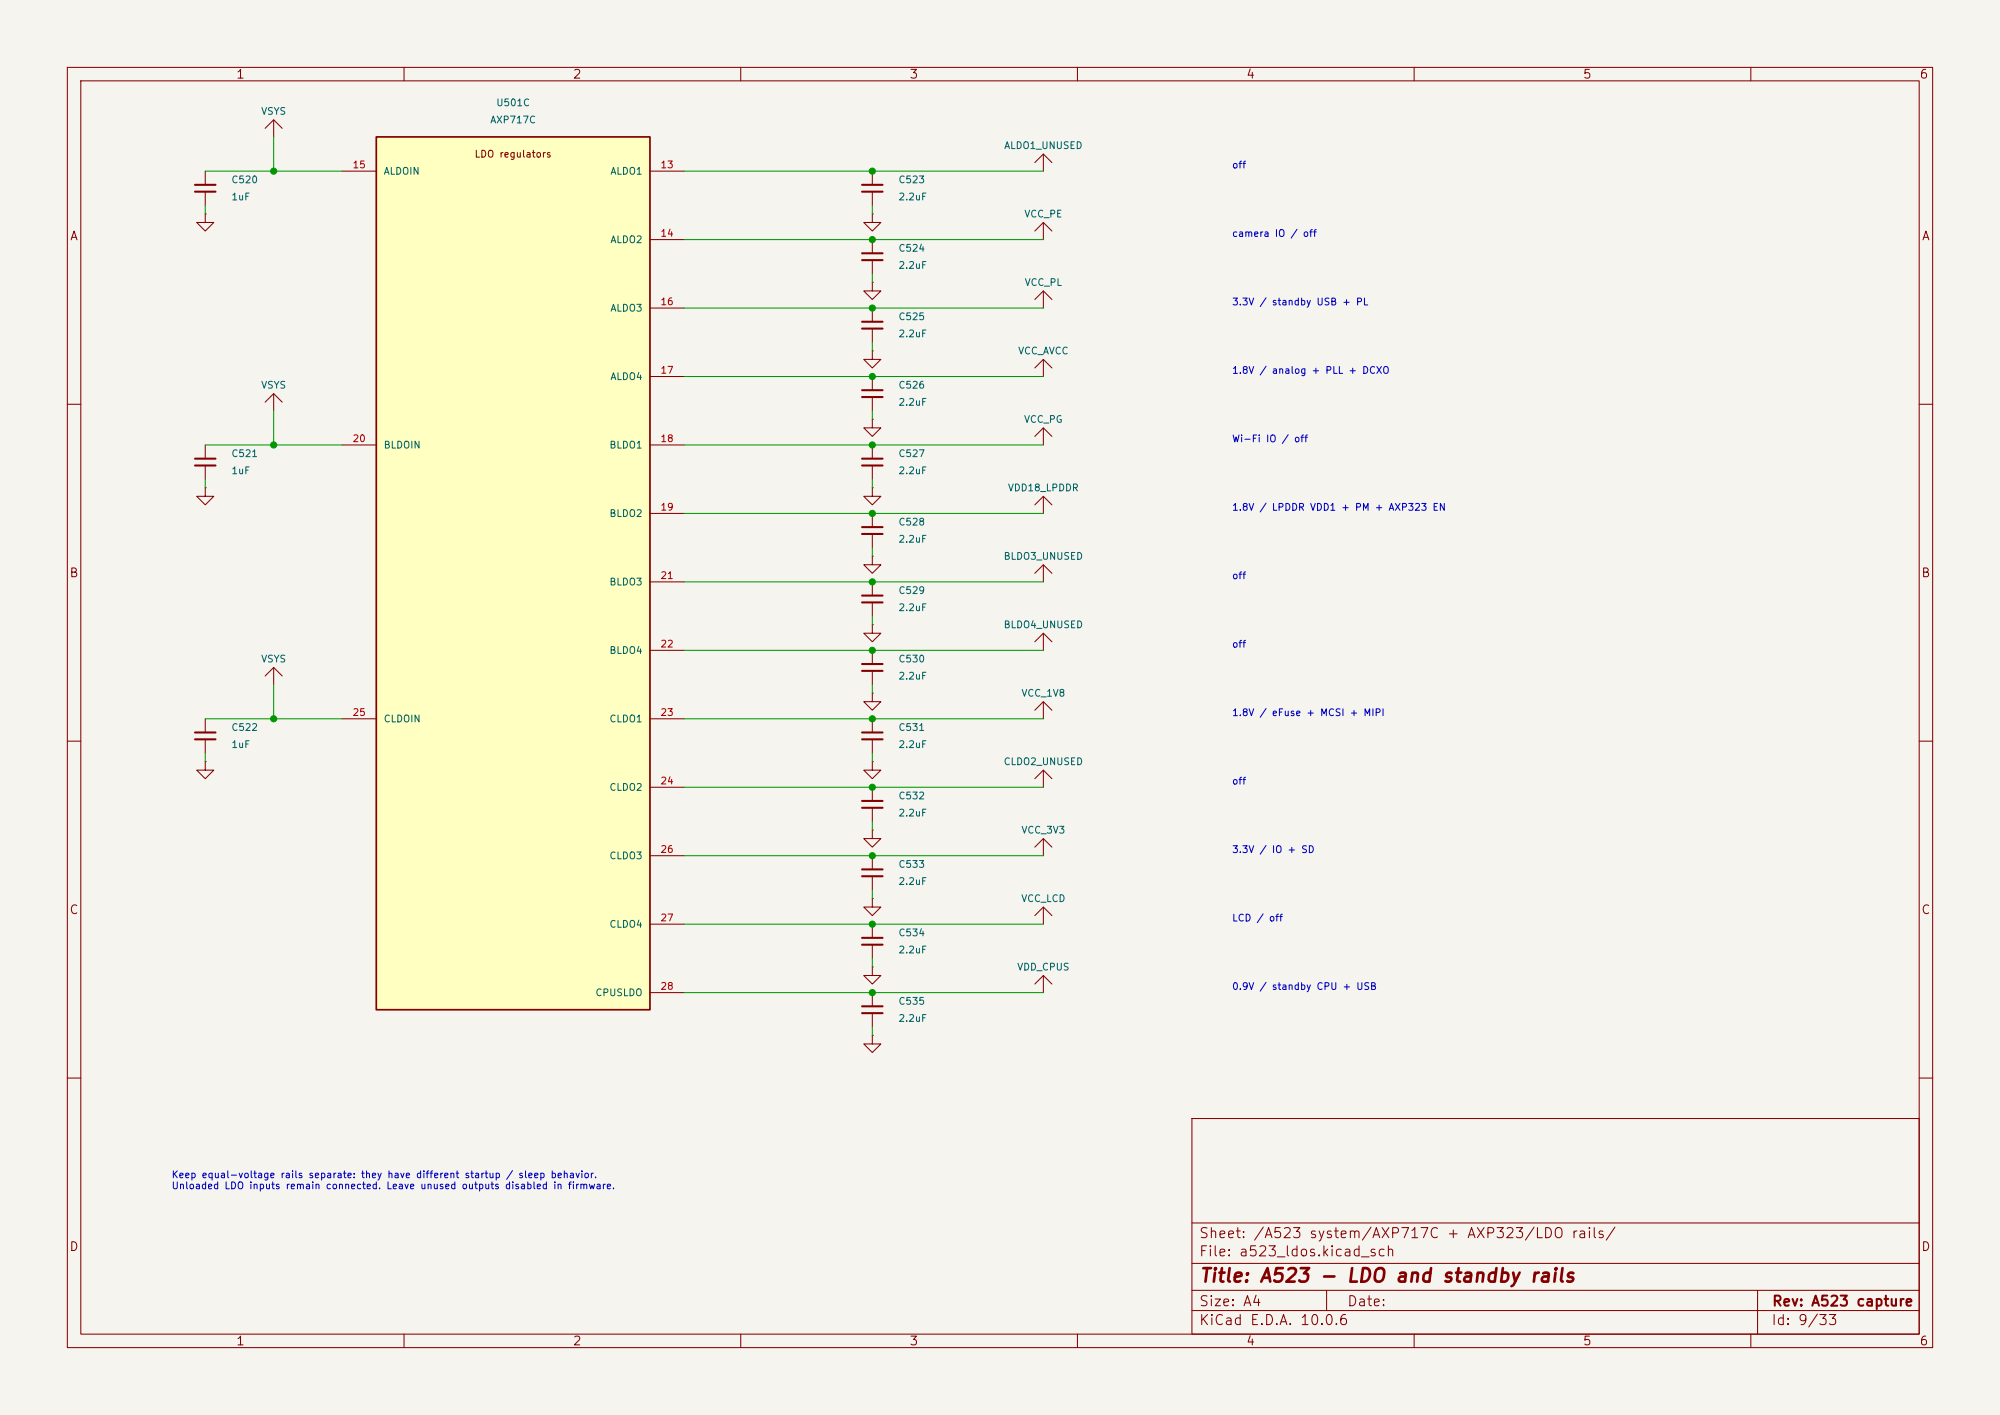
[picture p301: page 9]

off camera IO / off 1.8V / analog + PLL + DCXO

3.3V / standby USB + PL Wi-Fi IO / off off 1.8V / LPDDR VDD1 + PM + AXP323 EN

VCC_PG
off off 1.8V / eFuse + MCSI + MIPI 0.9V / standby CPU + USB

Sheet: /A523 system/AXP717C + AXP323/LDO rails/
File: a523_ldos.kicad_sch
Title: A523 - LDO and standby rails

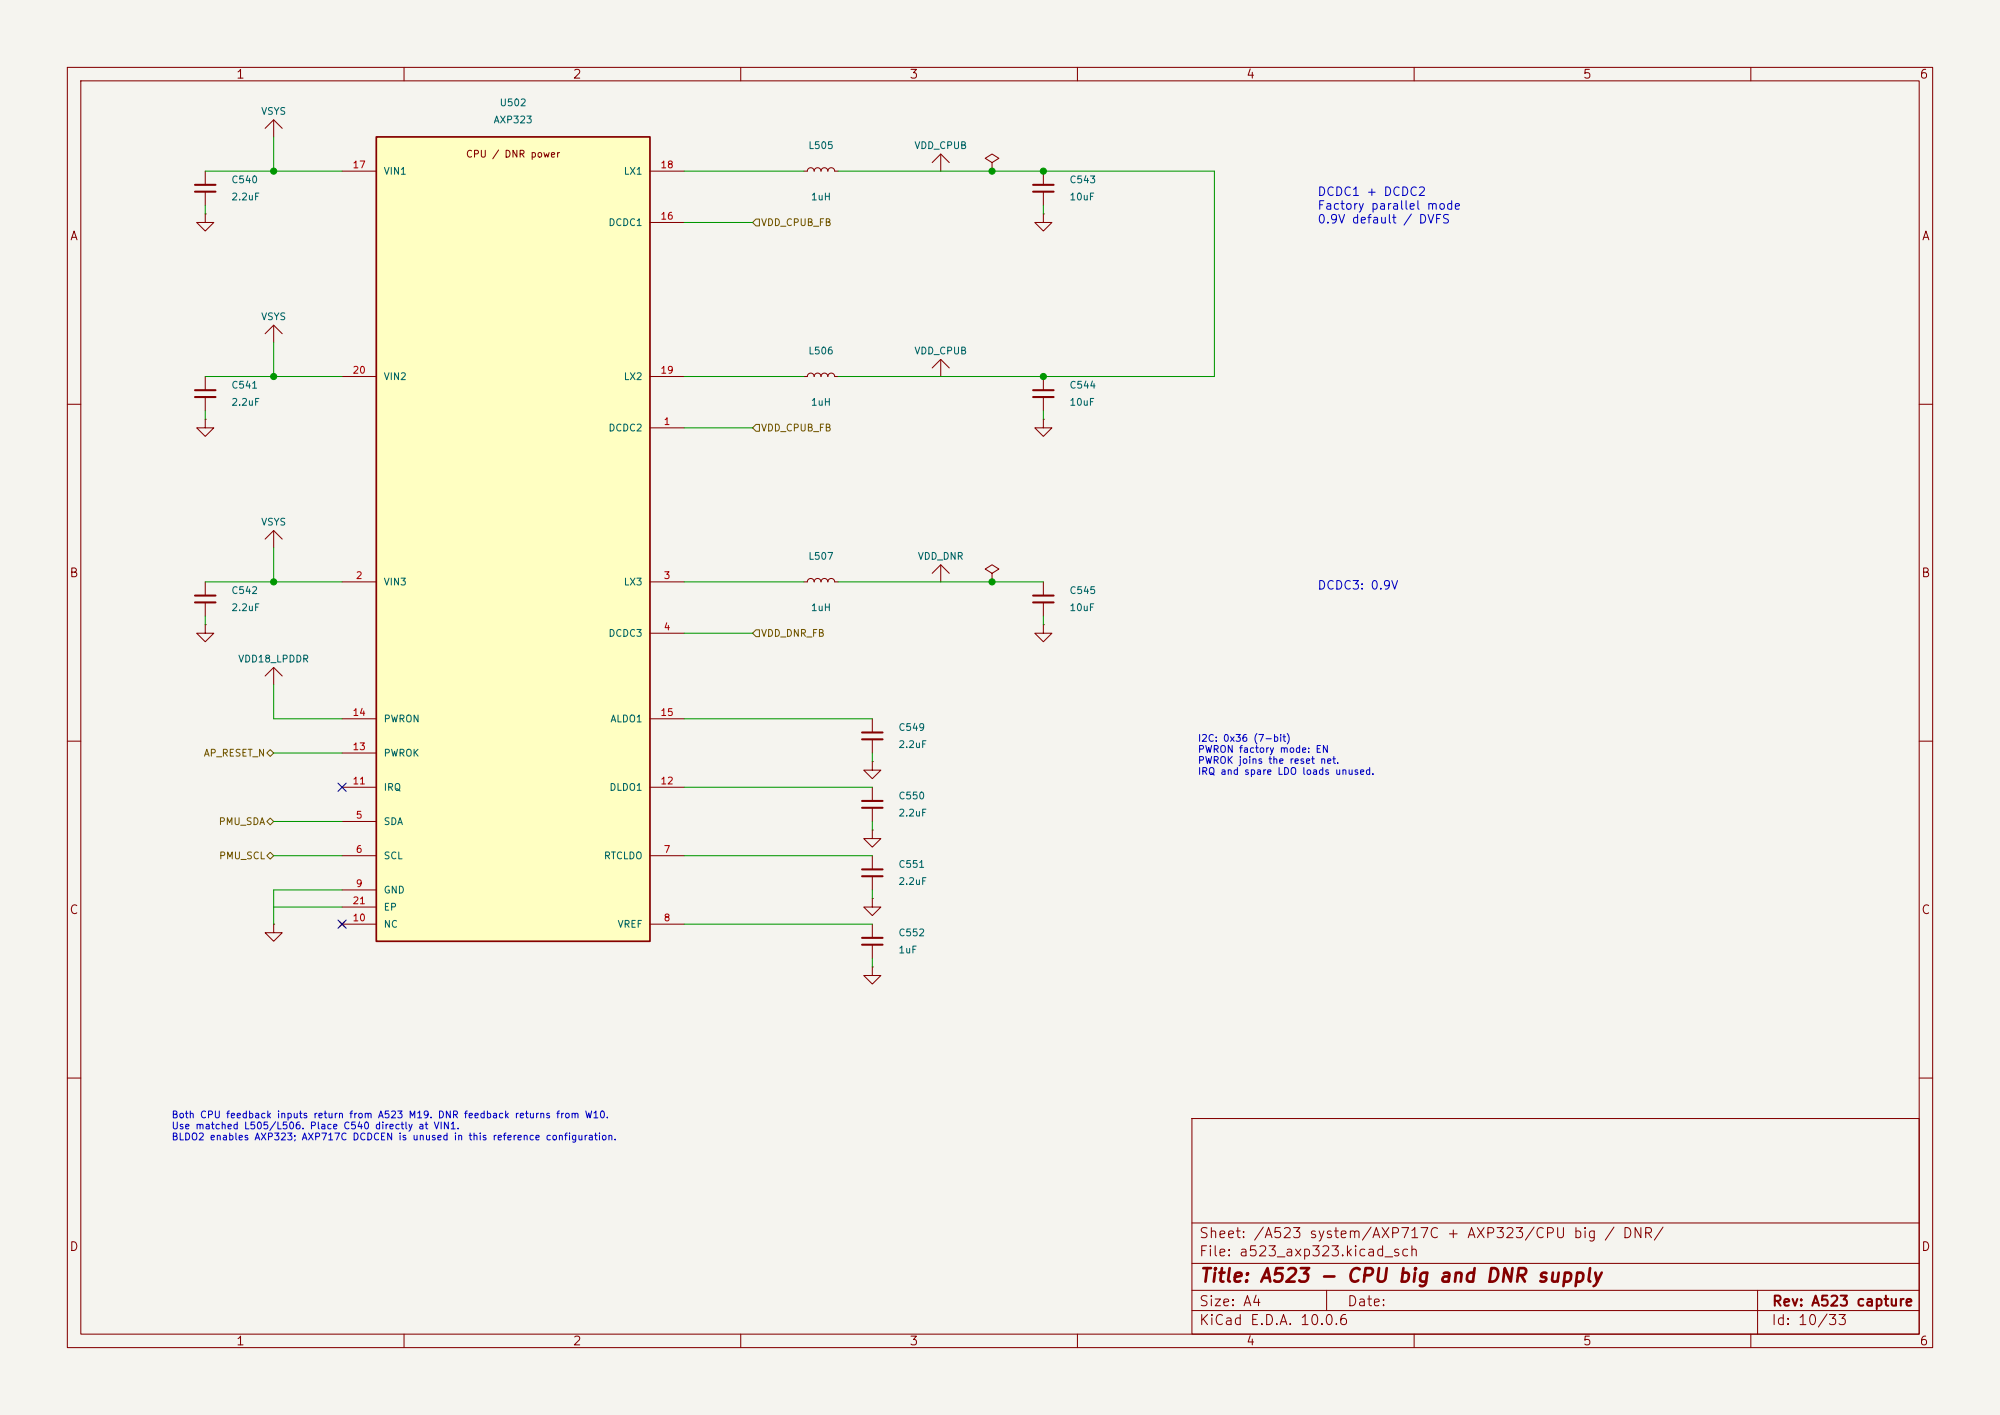
[picture p302: page 10]

IRQ and spare LDO loads unused. DCDC3: 0.9V DCDC1 + DCDC2

Factory parallel mode 0.9V default / DVFS

I2C: 0x36 (7-bit) PWRON factory mode: EN

PWROK joins the reset net.

PMU_SCL PMU_SDA Both CPU feedback inputs return from A523 M19. DNR feedback returns from W10. Use matched L505/L506. Place C540 directly at VIN1. BLDO2 enables AXP323; AXP717C DCDCEN is unused in this reference configuration.

Sheet: /A523 system/AXP717C + AXP323/CPU big / DNR/
File: a523_axp323.kicad_sch
Title: A523 - CPU big and DNR supply

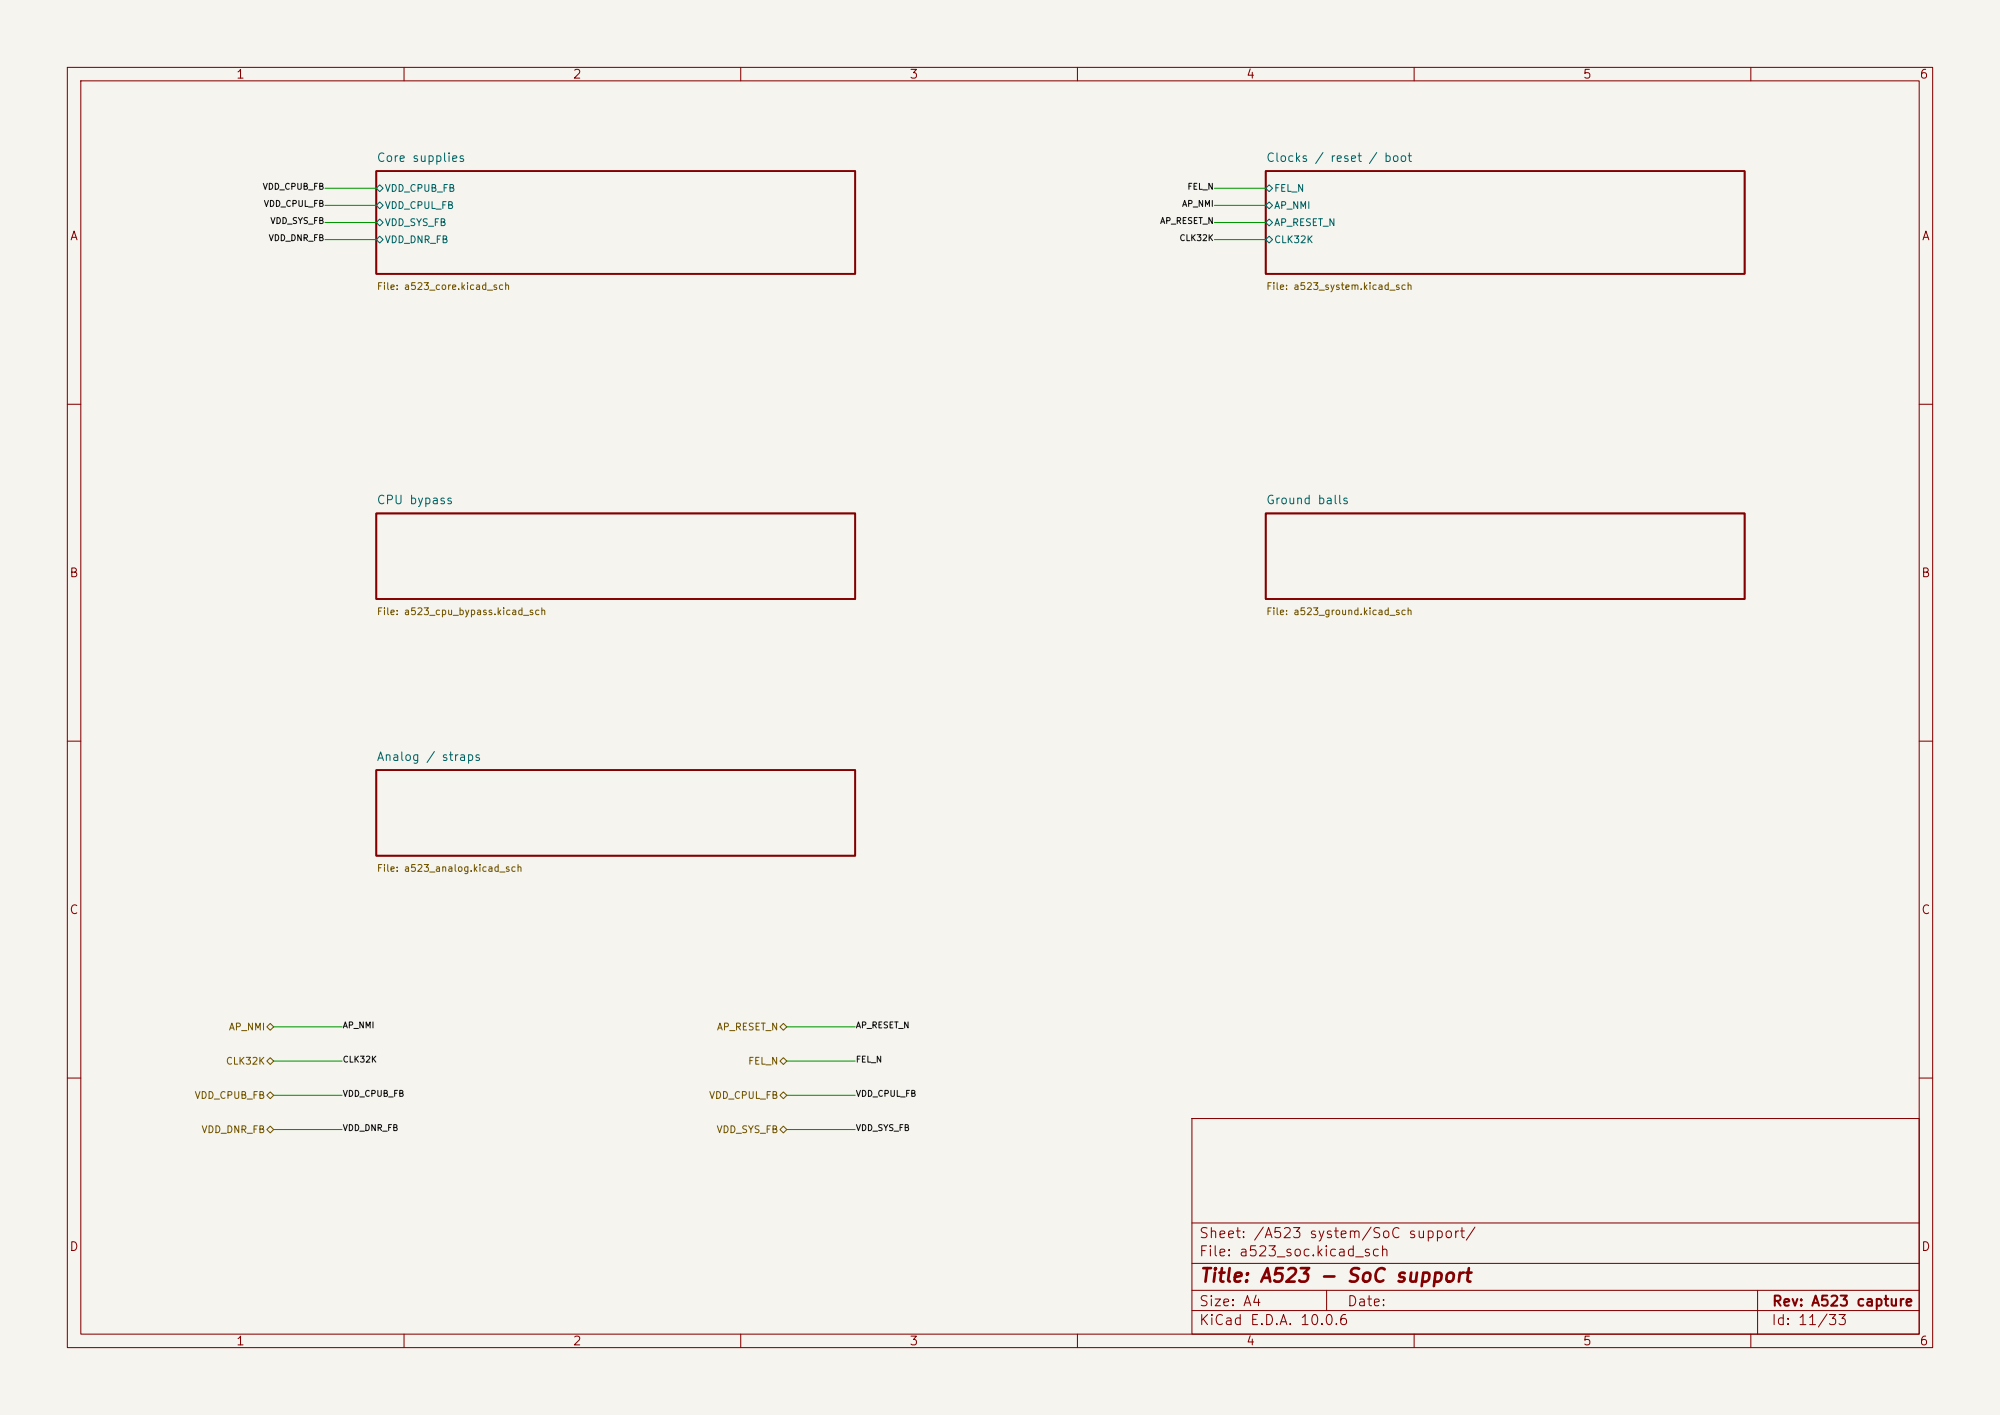
[picture p303: page 11]

CLK32K Clocks / reset / boot File: a523_system.kicad_sch Ground balls

Sheet: /A523 system/SoC support/
File: a523_soc.kicad_sch
Title: A523 - SoC support

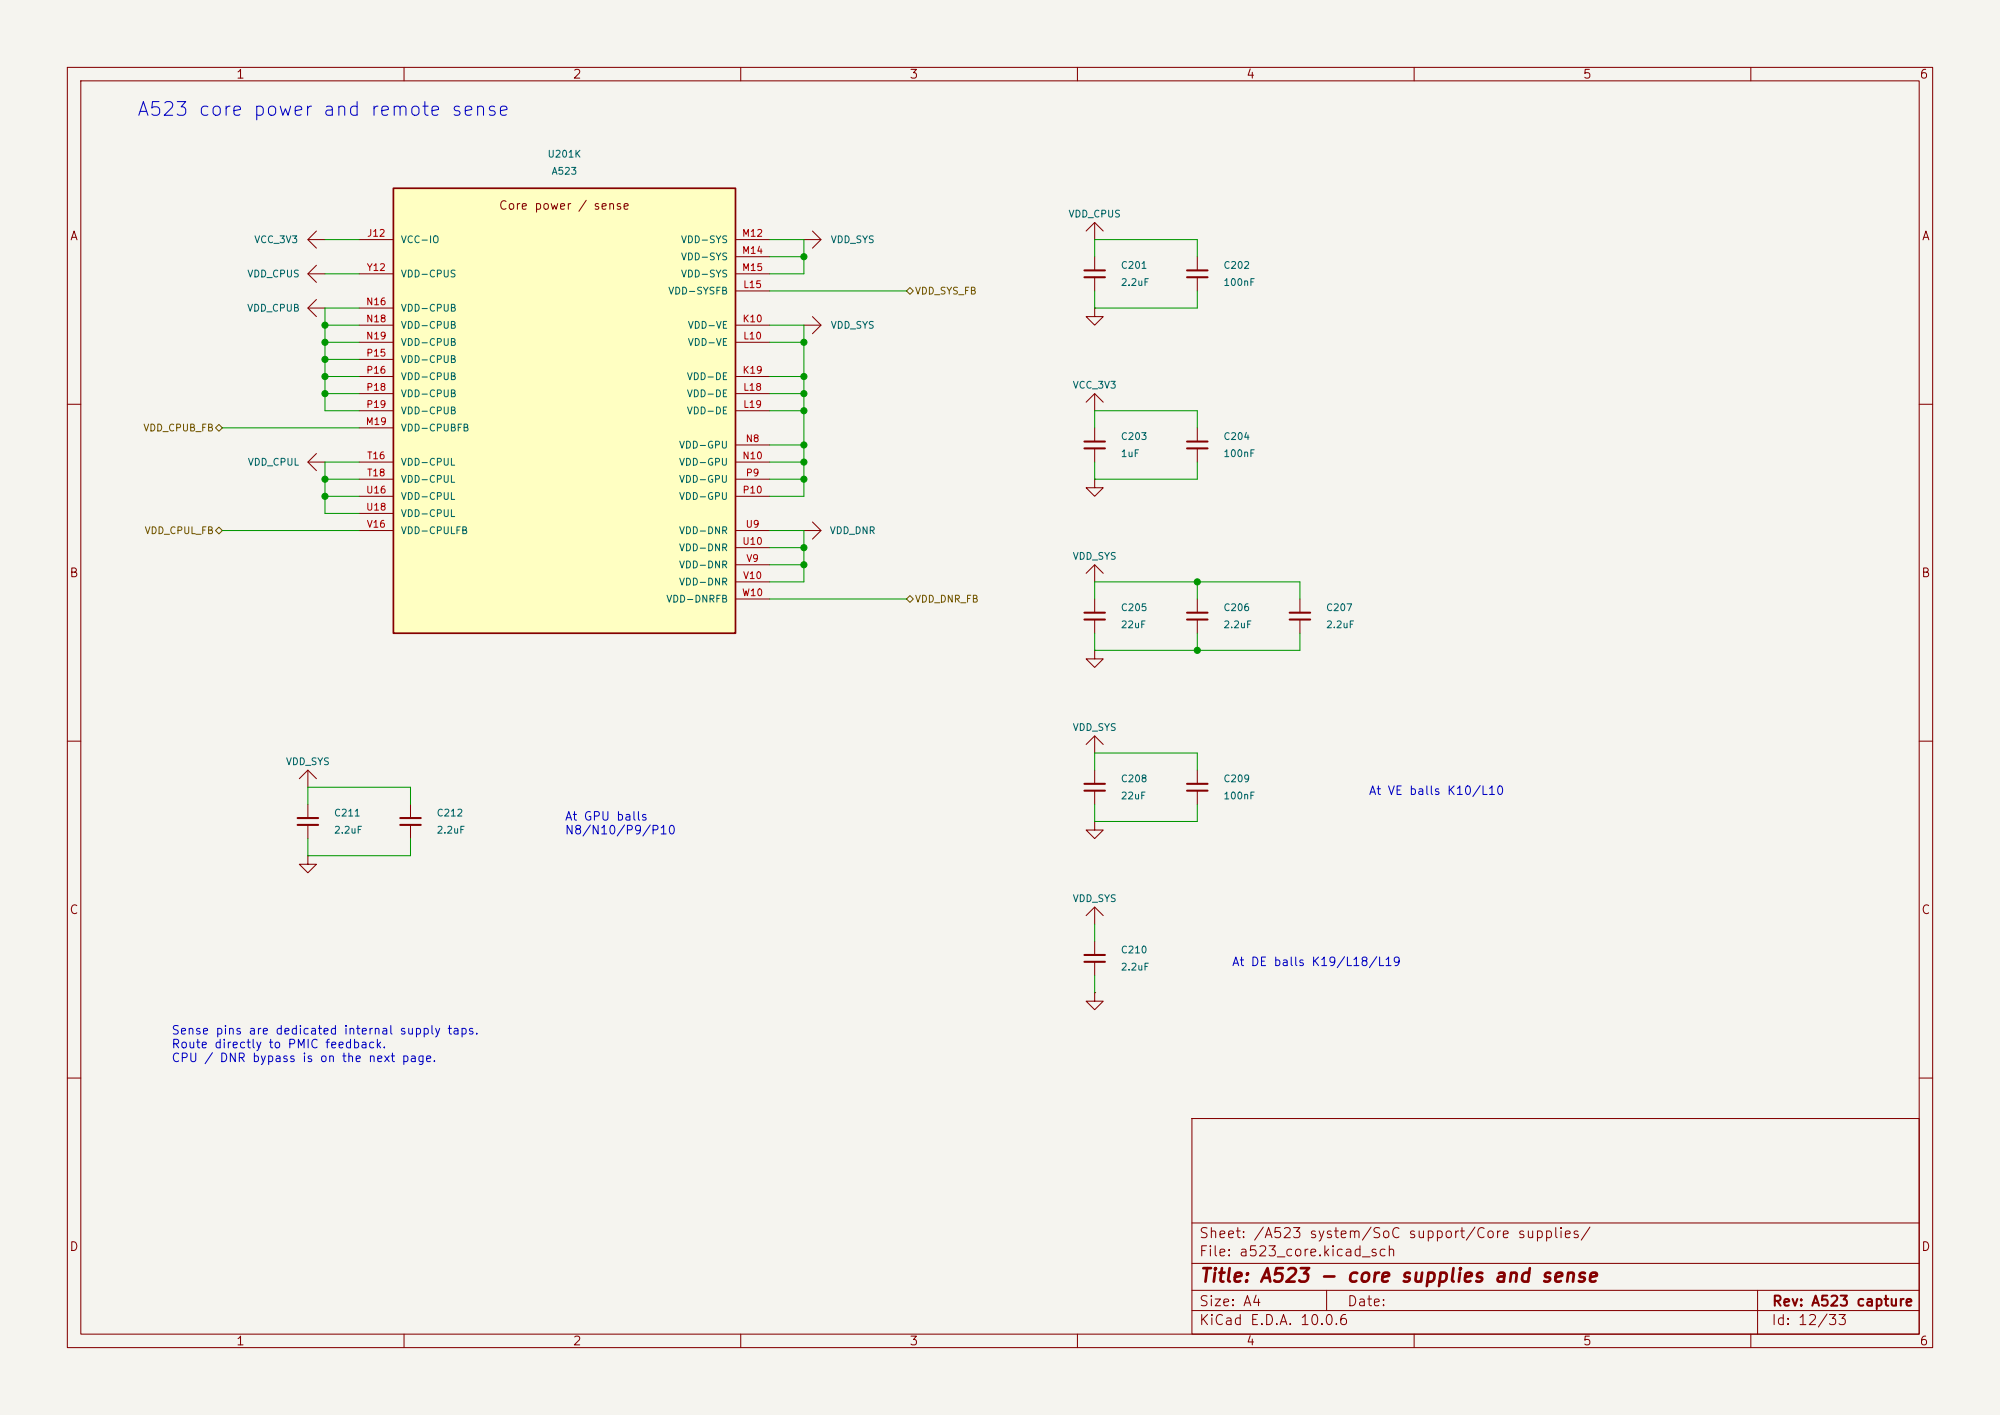
[picture p304: page 12]

VDD_CPUB_FB A523 core power and remote sense

Sheet: /A523 system/SoC support/Core supplies/
File: a523_core.kicad_sch
Title: A523 - core supplies and sense

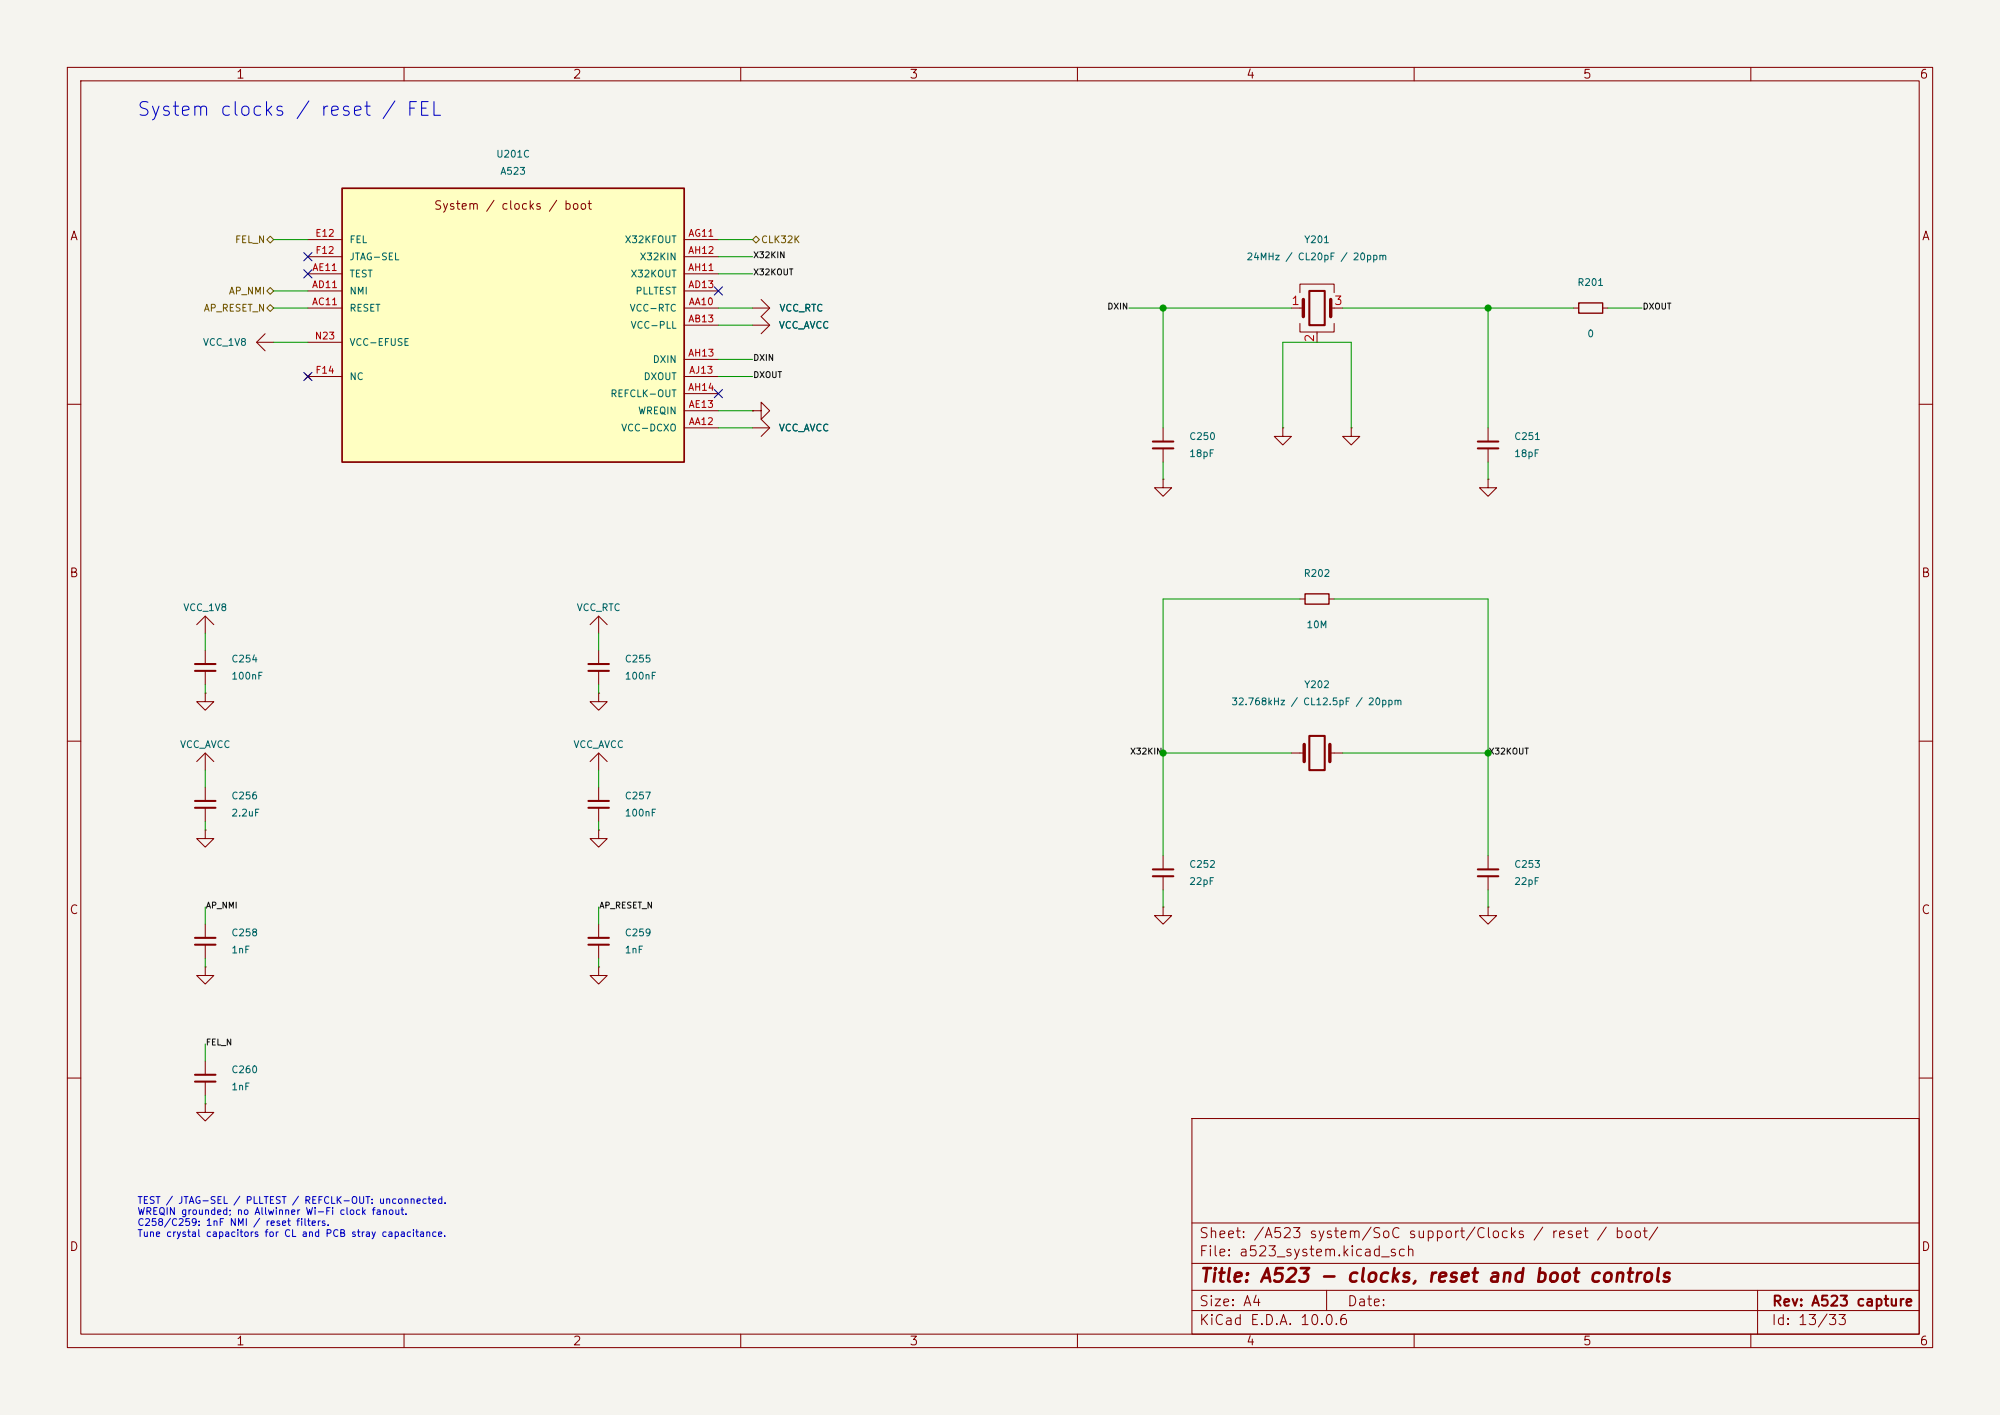
[picture p305: page 13]

System clocks / reset / FEL

TEST / JTAG-SEL / PLLTEST / REFCLK-OUT: unconnected. WREQIN grounded; no Allwinner Wi-Fi clock fanout. C258/C259: 1nF NMI / reset filters. Tune crystal capacitors for CL and PCB stray capacitance.

Sheet: /A523 system/SoC support/Clocks / reset / boot/
File: a523_system.kicad_sch
Title: A523 - clocks, reset and boot controls

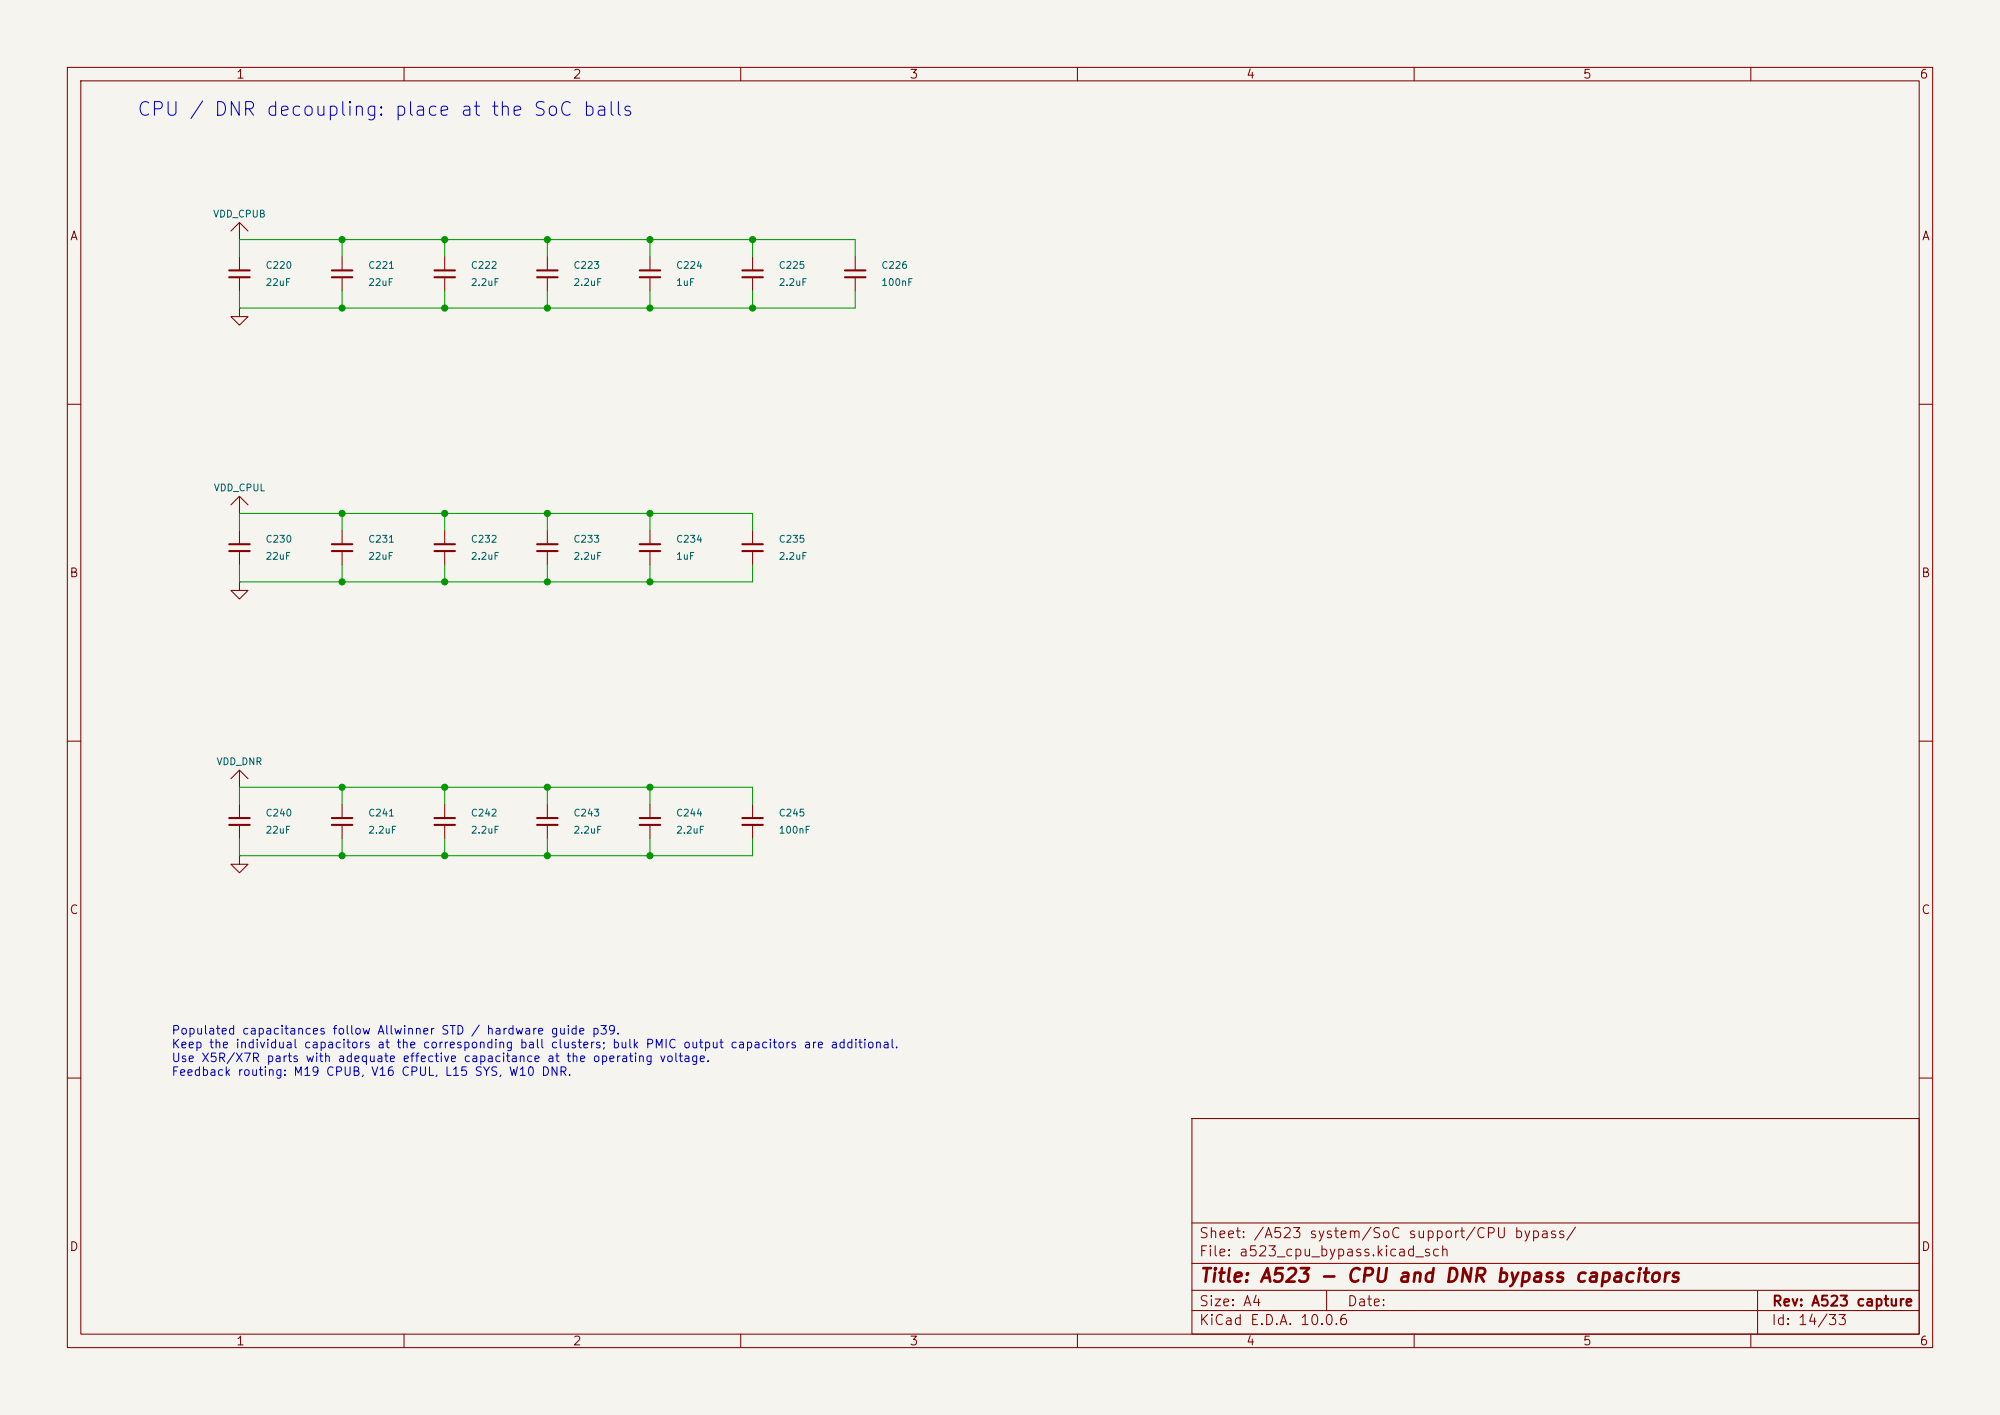
[picture p306: page 14]

22uF CPU / DNR decoupling: place at the SoC balls

Populated capacitances follow Allwinner STD / hardware guide p39.
Keep the individual capacitors at the corresponding ball clusters; bulk PMIC output capacitors are additional. Use X5R/X7R parts with adequate effective capacitance at the operating voltage. Feedback routing: M19 CPUB, V16 CPUL, L15 SYS, W10 DNR.

Sheet: /A523 system/SoC support/CPU bypass/
File: a523_cpu_bypass.kicad_sch
Title: A523 - CPU and DNR bypass capacitors

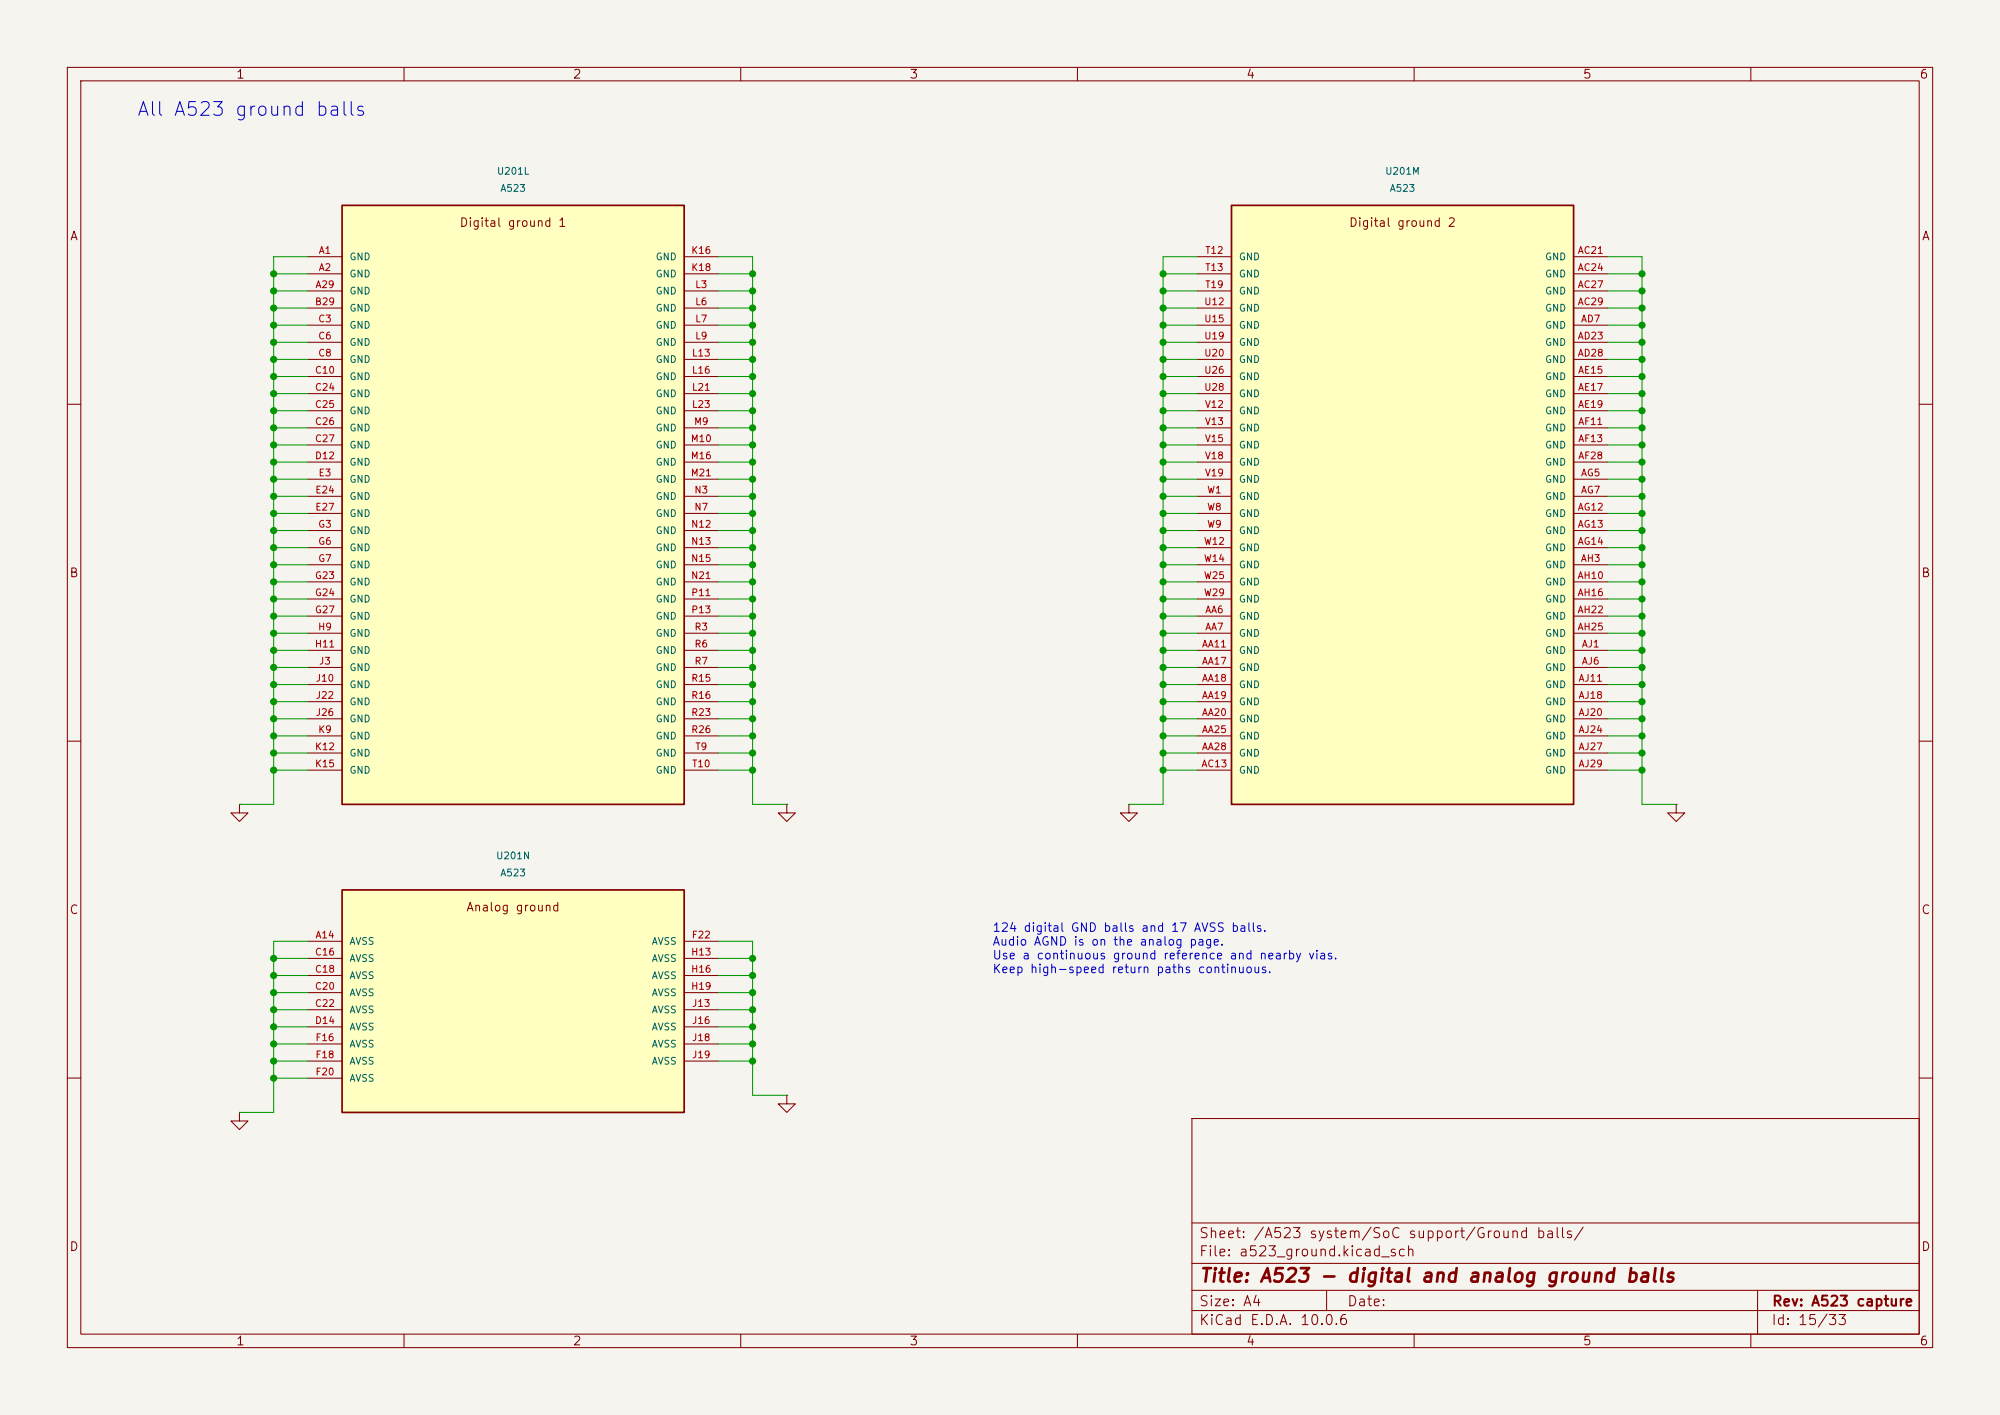
[picture p307: page 15]

Sheet: /A523 system/SoC support/Ground balls/
File: a523_ground.kicad_sch
Title: A523 - digital and analog ground balls

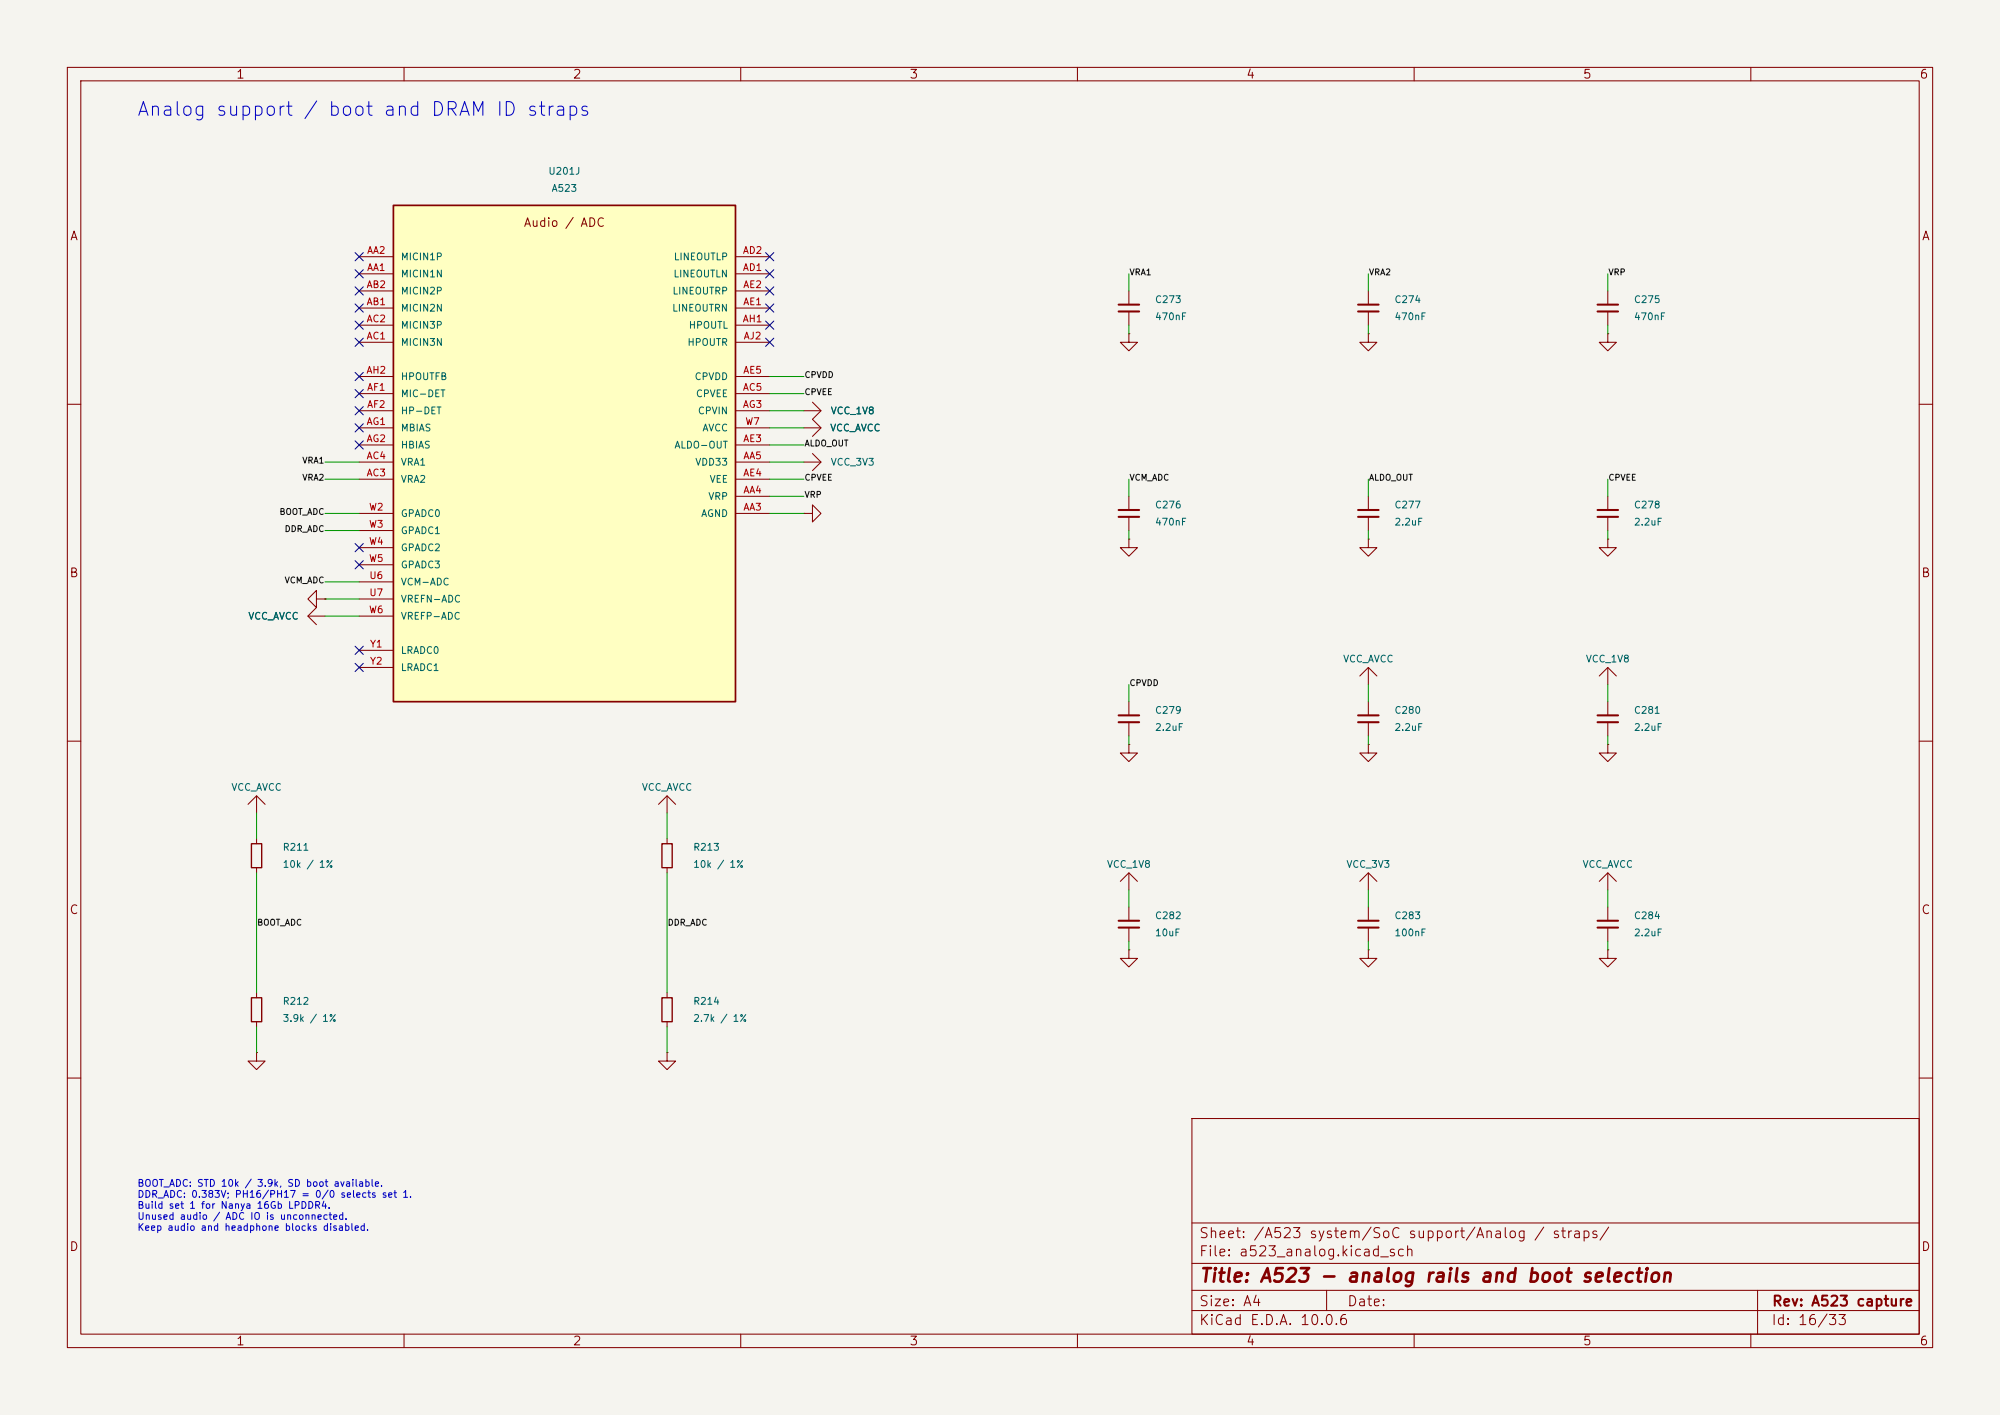
[picture p308: page 16]

CPVEE Analog support / boot and DRAM ID straps

BOOT_ADC: STD 10k / 3.9k, SD boot available. DDR_ADC: 0.383V; PH16/PH17 = 0/0 selects set 1. Build set 1 for Nanya 16Gb LPDDR4. Unused audio / ADC IO is unconnected. Keep audio and headphone blocks disabled.

Sheet: /A523 system/SoC support/Analog / straps/
File: a523_analog.kicad_sch
Title: A523 - analog rails and boot selection

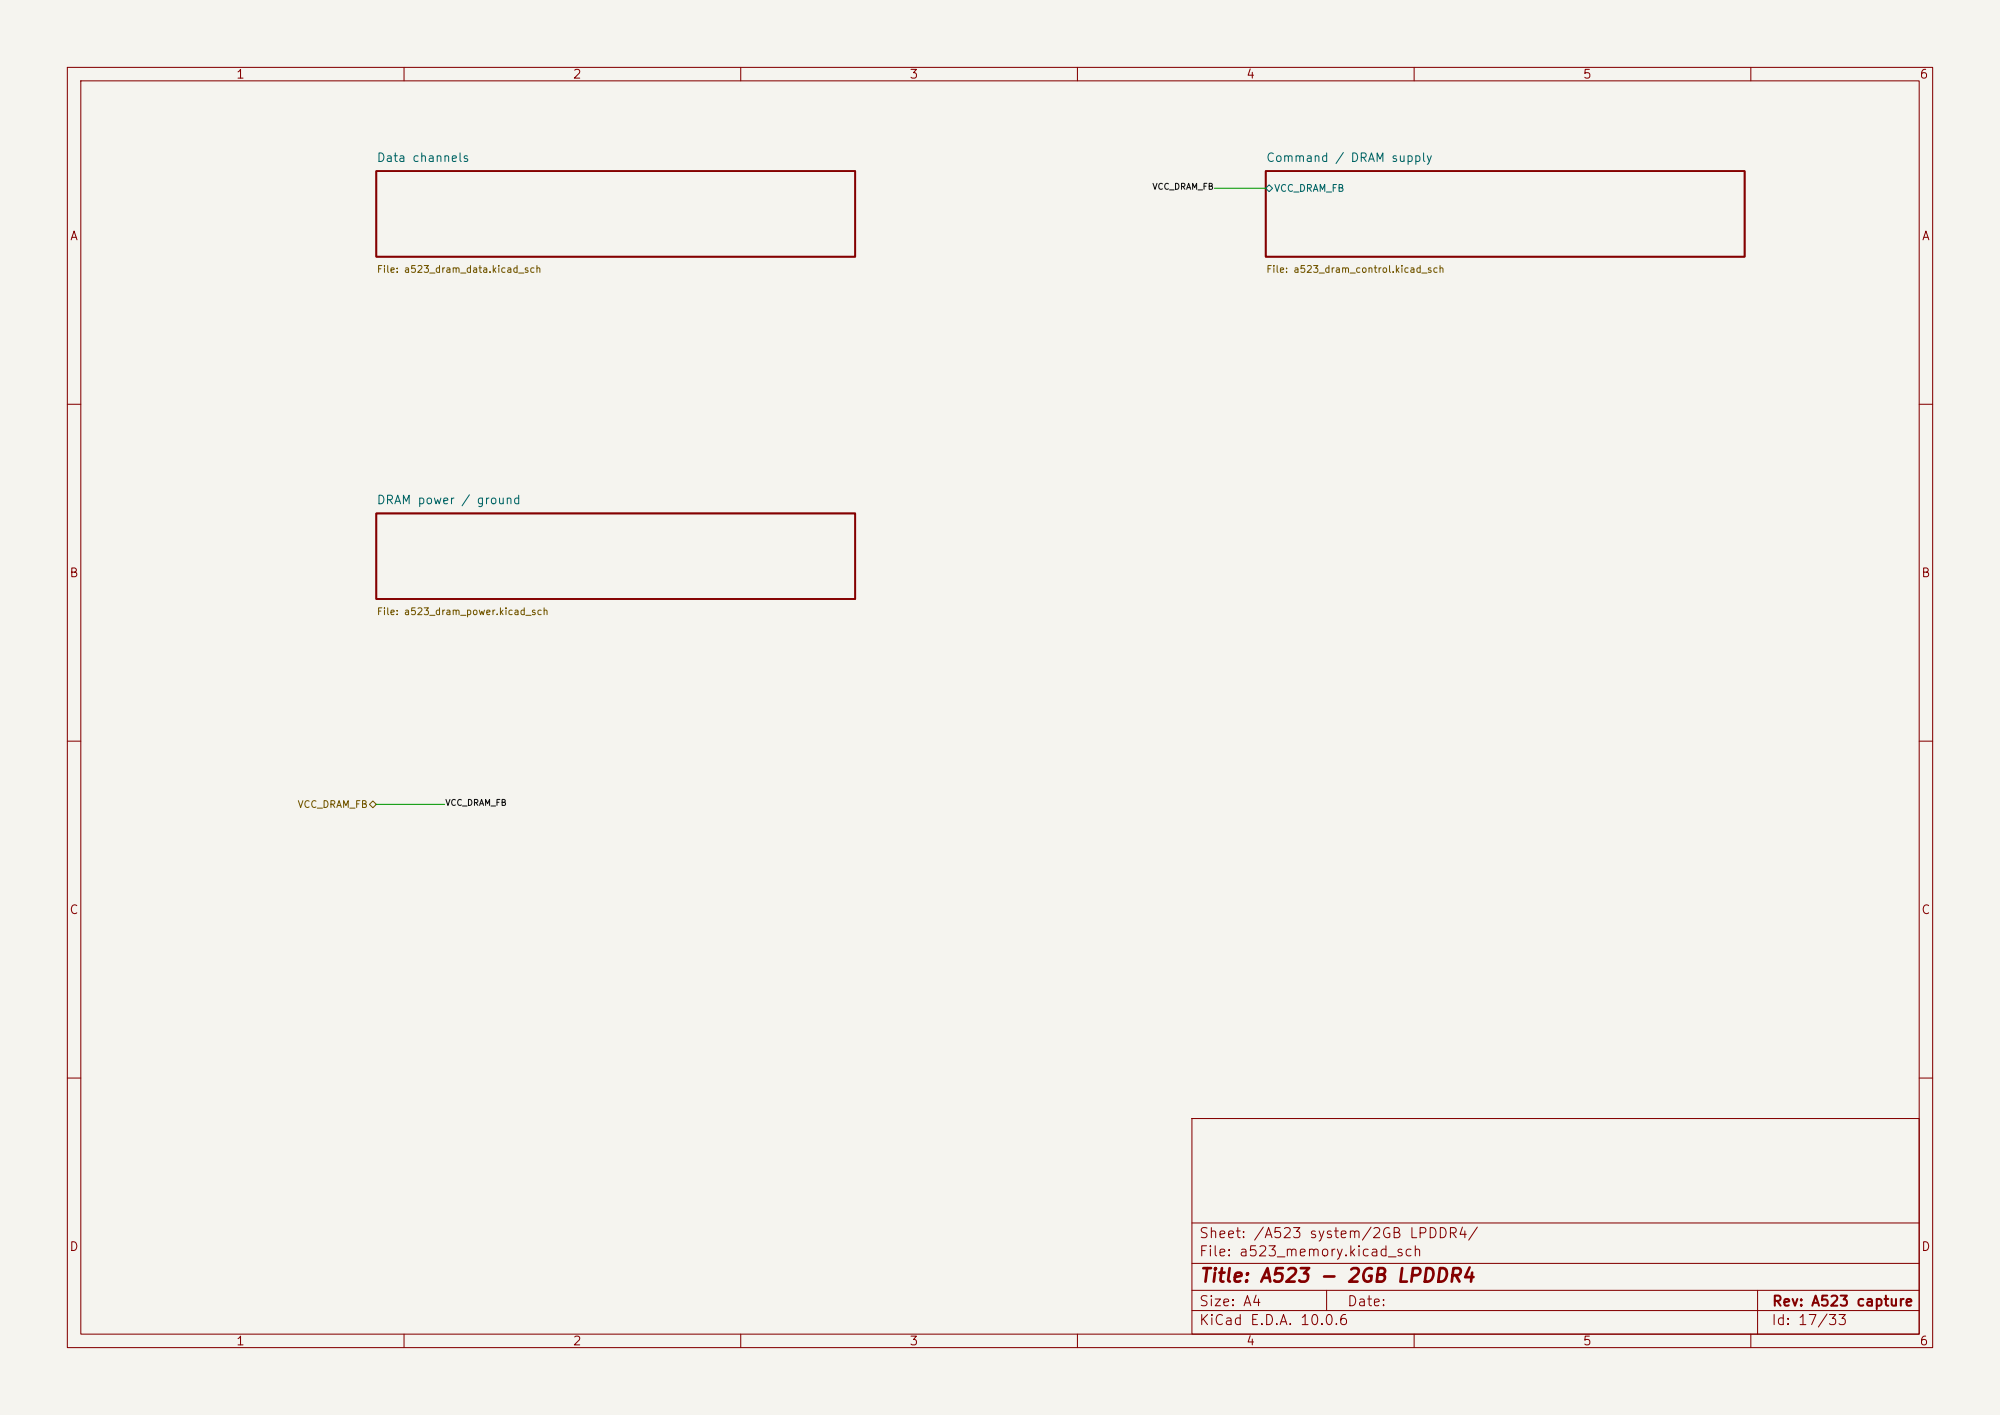
[picture p309: page 17]

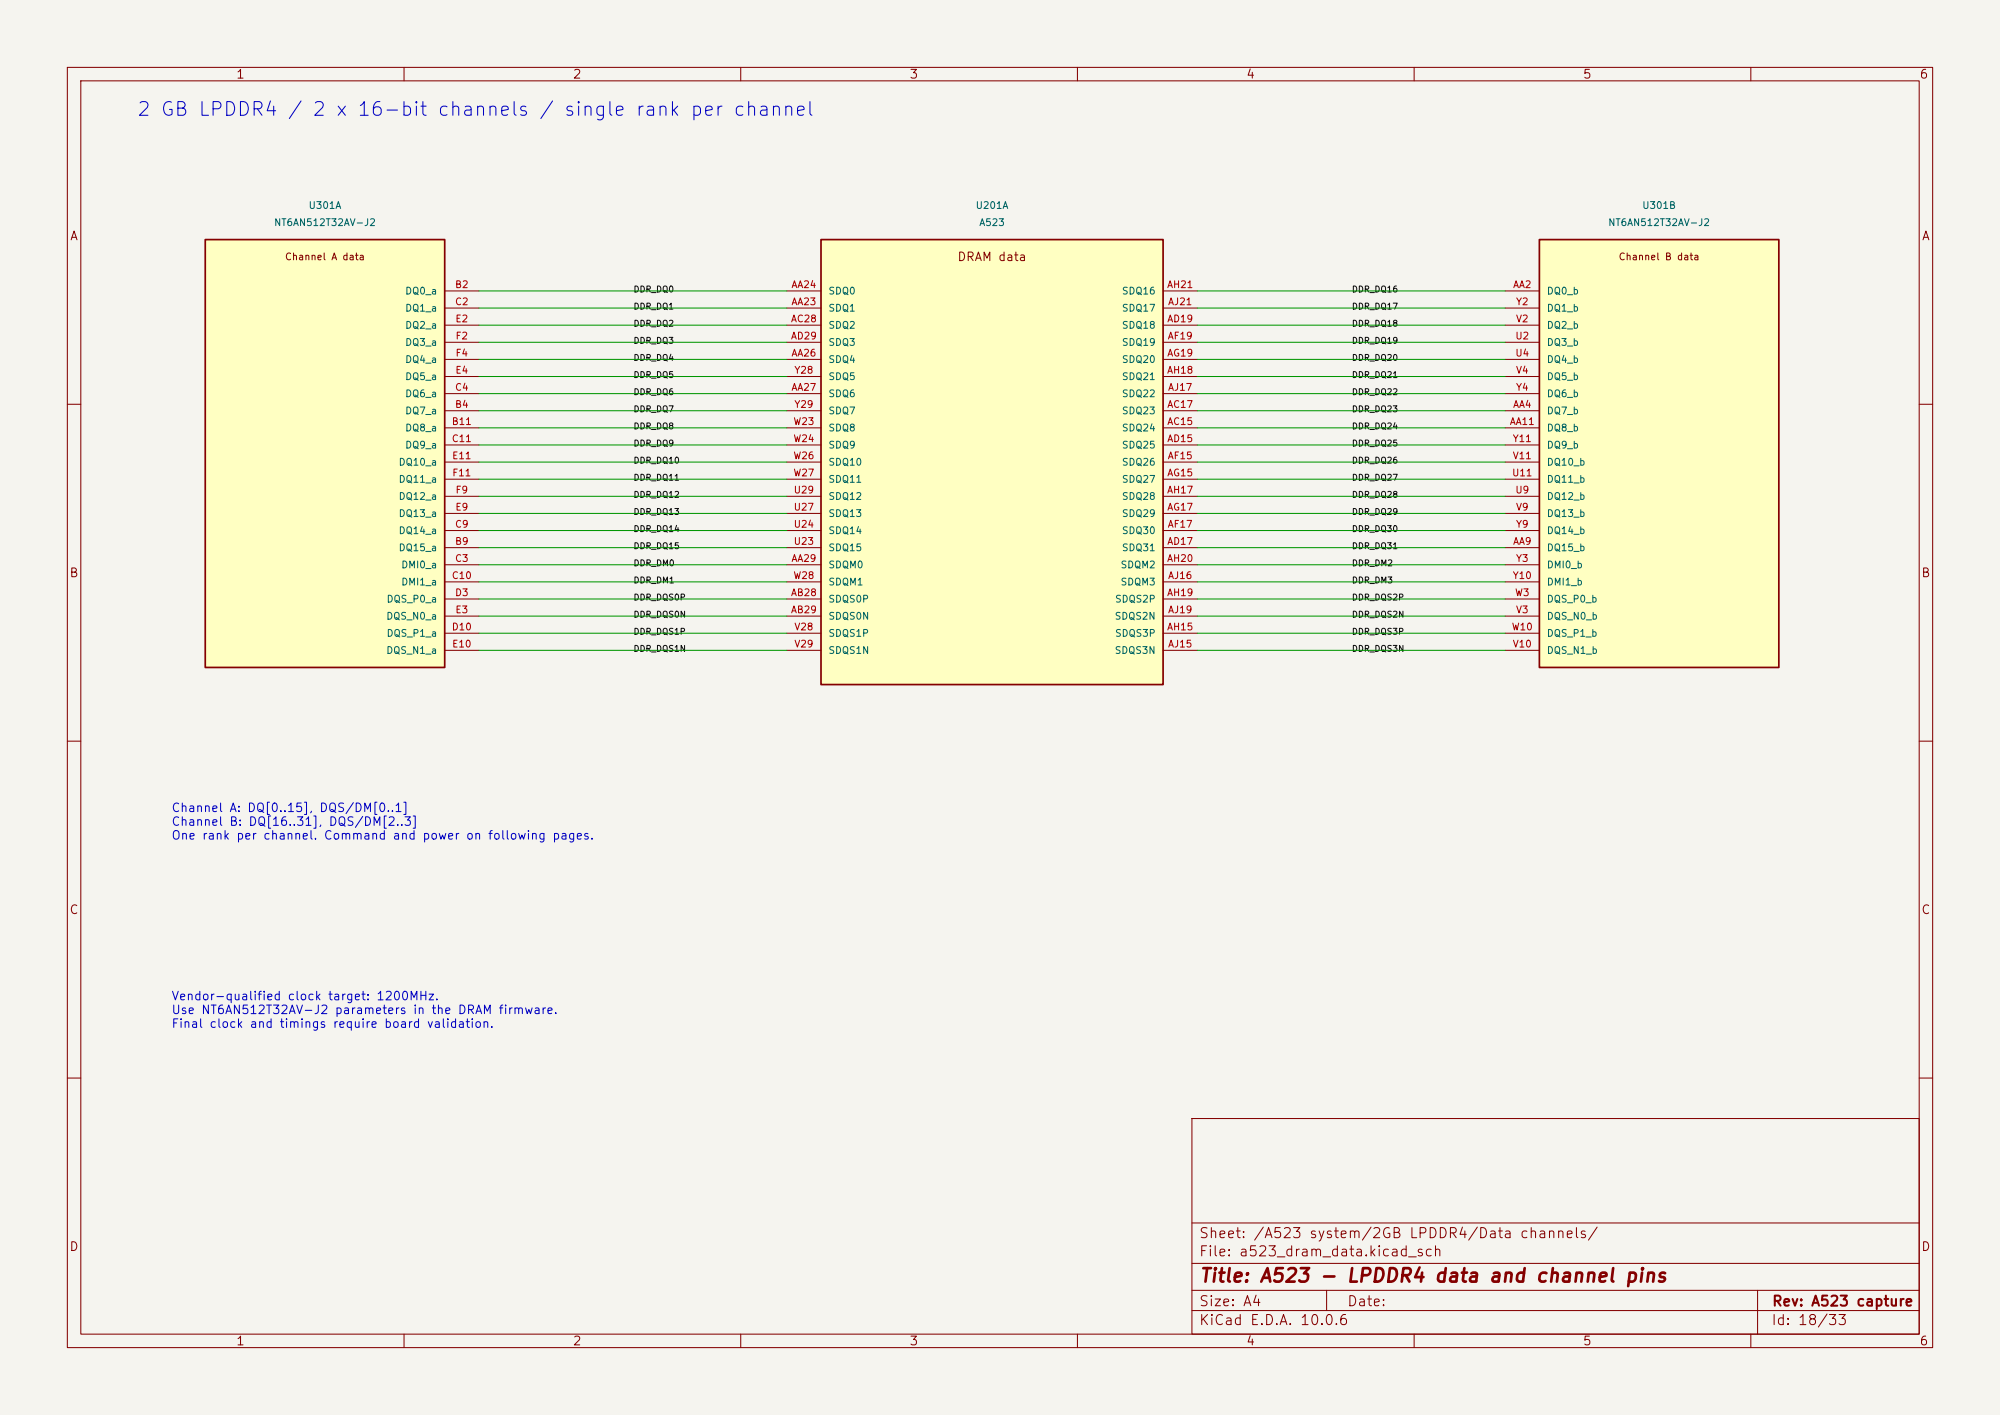
[picture p310: page 18]

2 GB LPDDR4 / 2 x 16-bit channels / single rank per channel Channel A: DQ[0..15], DQS/DM[0..1] Channel B: DQ[16..31], DQS/DM[2..3] One rank per channel. Command and power on following pages.

DDR_DM1 DDR_DQ13 DDR_DQ15 DDR_DQ14 Vendor-qualified clock target: 1200MHz. Use NT6AN512T32AV-J2 parameters in the DRAM firmware. Final clock and timings require board validation.

DDR_DQS0P | SDQS0P AB28 | DDR_DQS2P

DDR_DQS1P | SDQS1P V28 | DDR_DQS3P

Sheet: /A523 system/2GB LPDDR4/Data channels/
File: a523_dram_data.kicad_sch
Title: A523 - LPDDR4 data and channel pins

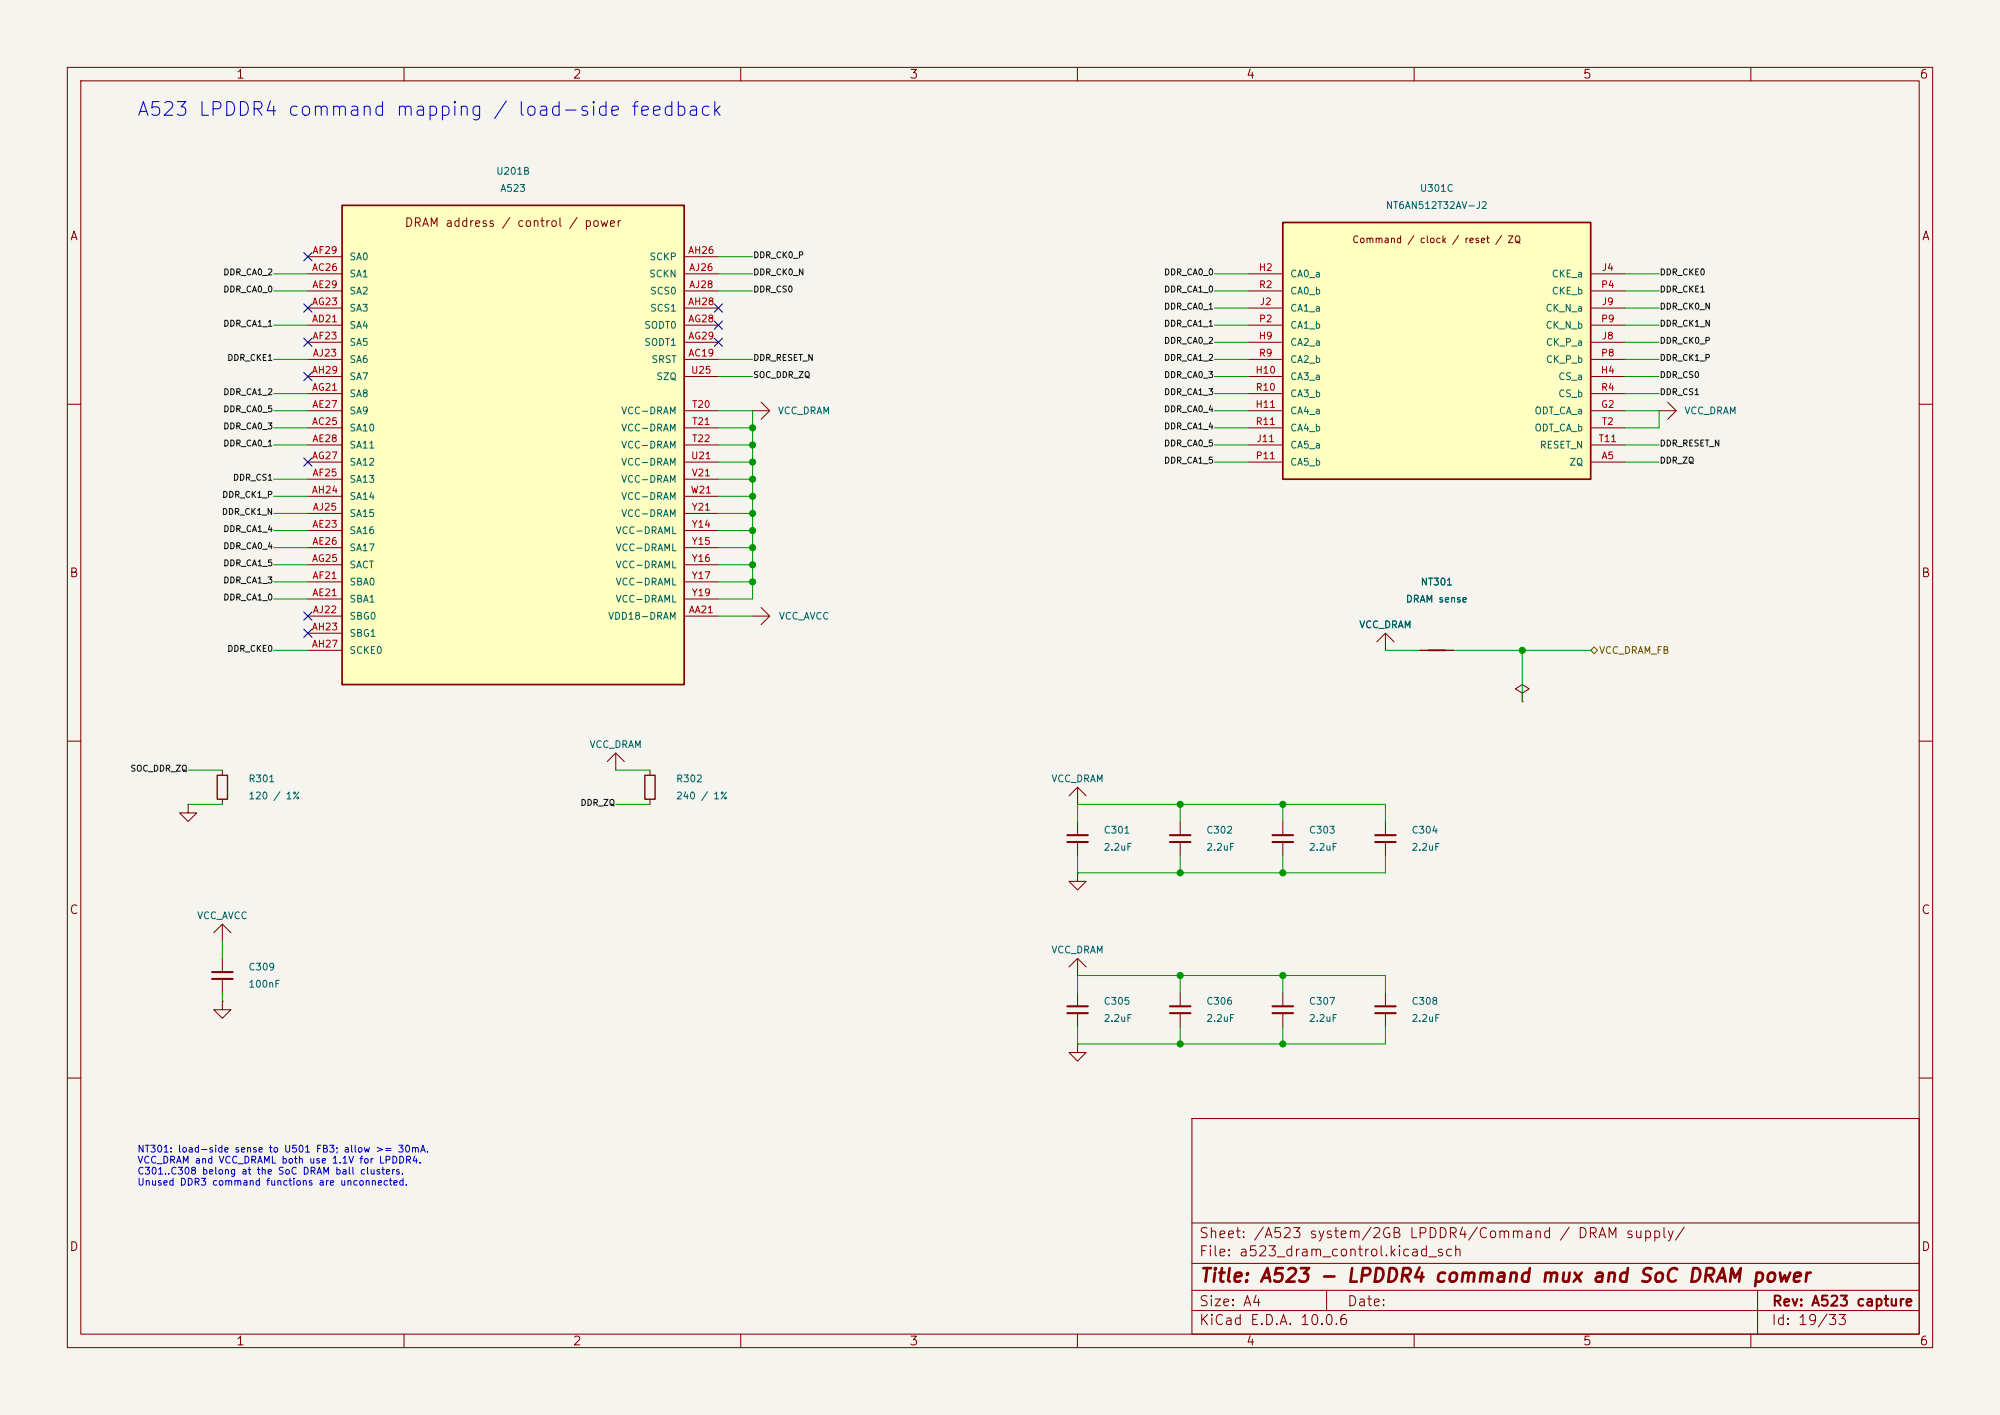
[picture p311: page 19]

DDR_CS0 DDR_CA0_1 DDR_CA0_3 DDR_CA0_2 A523 LPDDR4 command mapping / load-side feedback

Command / clock / reset / ZQ

NT301: load-side sense to U501 FB3; allow >= 30mA. VCC_DRAM and VCC_DRAML both use 1.1V for LPDDR4. C301..C308 belong at the SoC DRAM ball clusters. Unused DDR3 command functions are unconnected.

Sheet: /A523 system/2GB LPDDR4/Command / DRAM supply/
File: a523_dram_control.kicad_sch
Title: A523 - LPDDR4 command mux and SoC DRAM power

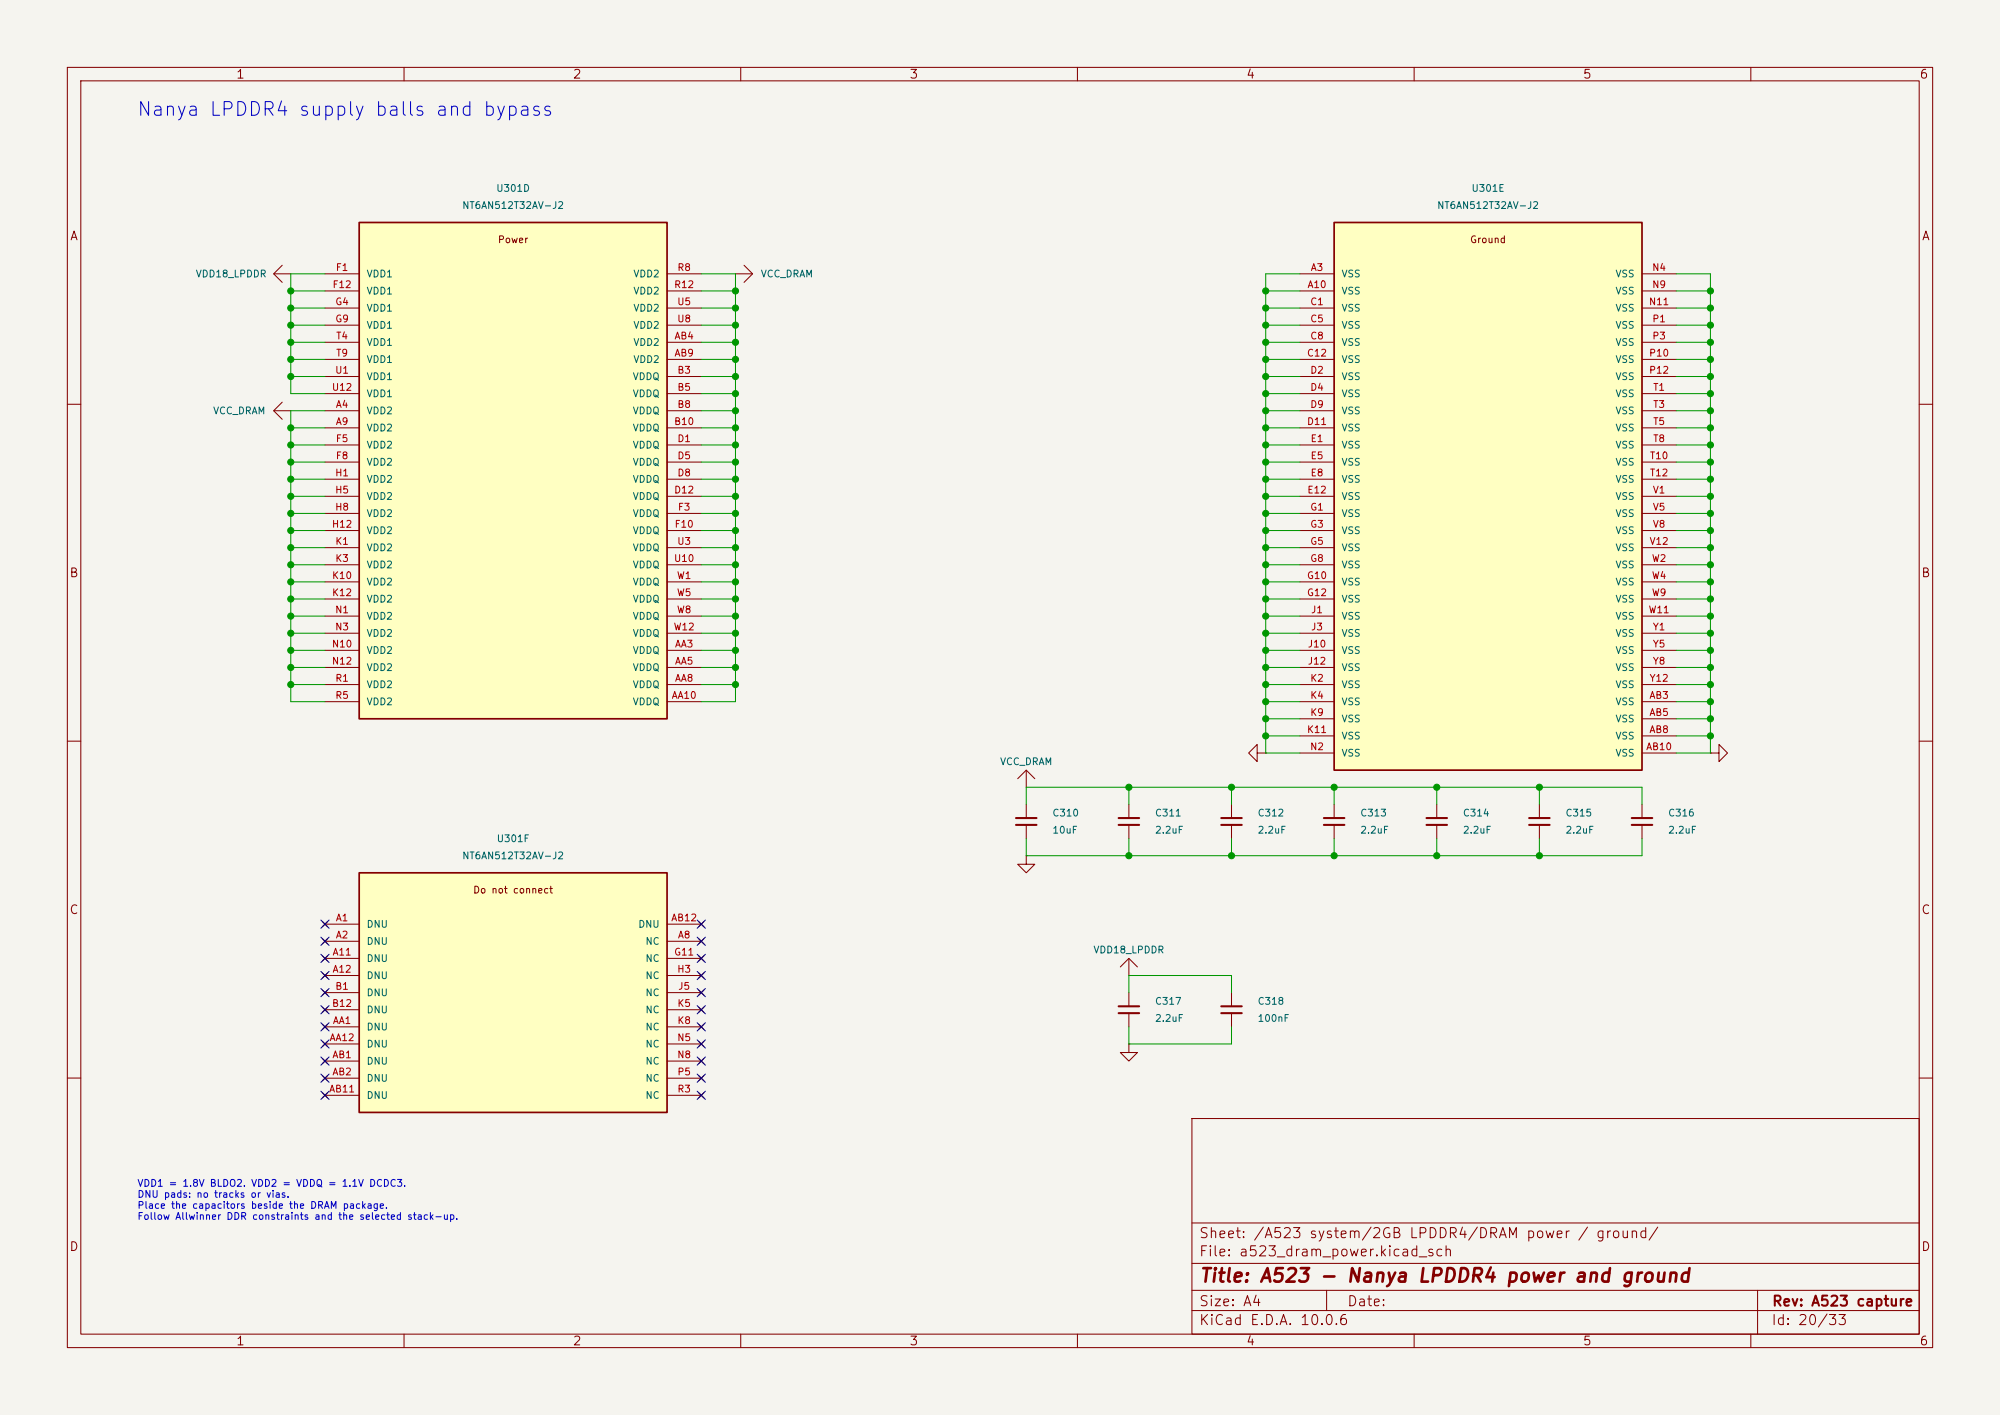
[picture p312: page 20]

100nF Nanya LPDDR4 supply balls and bypass

VDD1 = 1.8V BLDO2. VDD2 = VDDQ = 1.1V DCDC3. DNU pads: no tracks or vias. Place the capacitors beside the DRAM package. Follow Allwinner DDR constraints and the selected stack-up.

Sheet: /A523 system/2GB LPDDR4/DRAM power / ground/
File: a523_dram_power.kicad_sch
Title: A523 - Nanya LPDDR4 power and ground

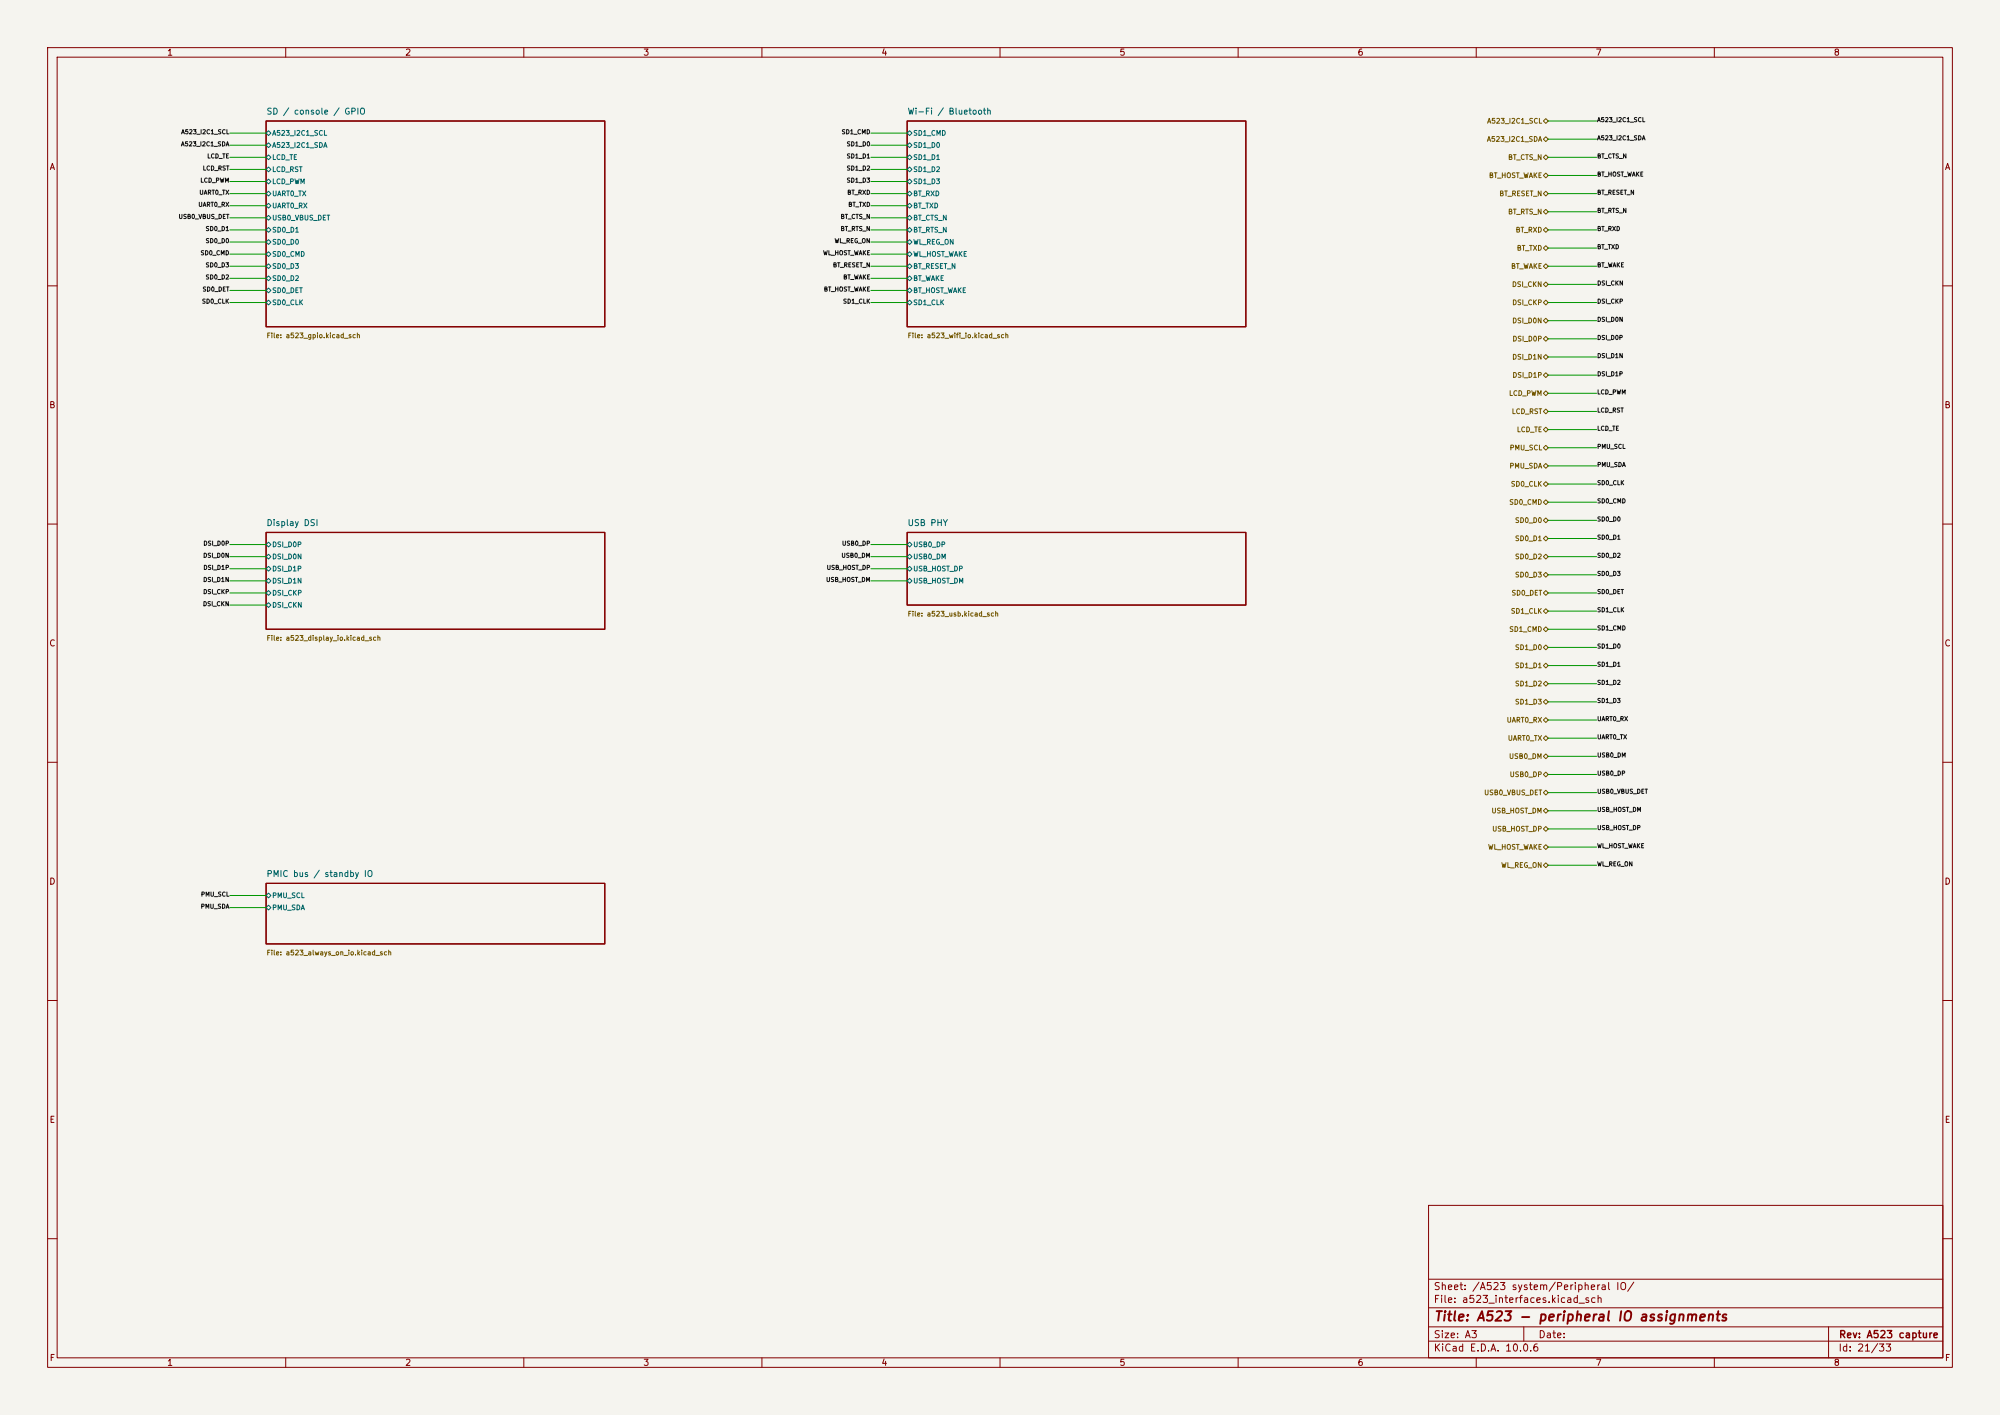
[picture p313: page 21]

File: a523_usb.kicad_sch PMU_SCL PMU_SDA PMIC bus / standby IO

Sheet: /A523 system/Peripheral IO/
File: a523_interfaces.kicad_sch
Title: A523 - peripheral IO assignments

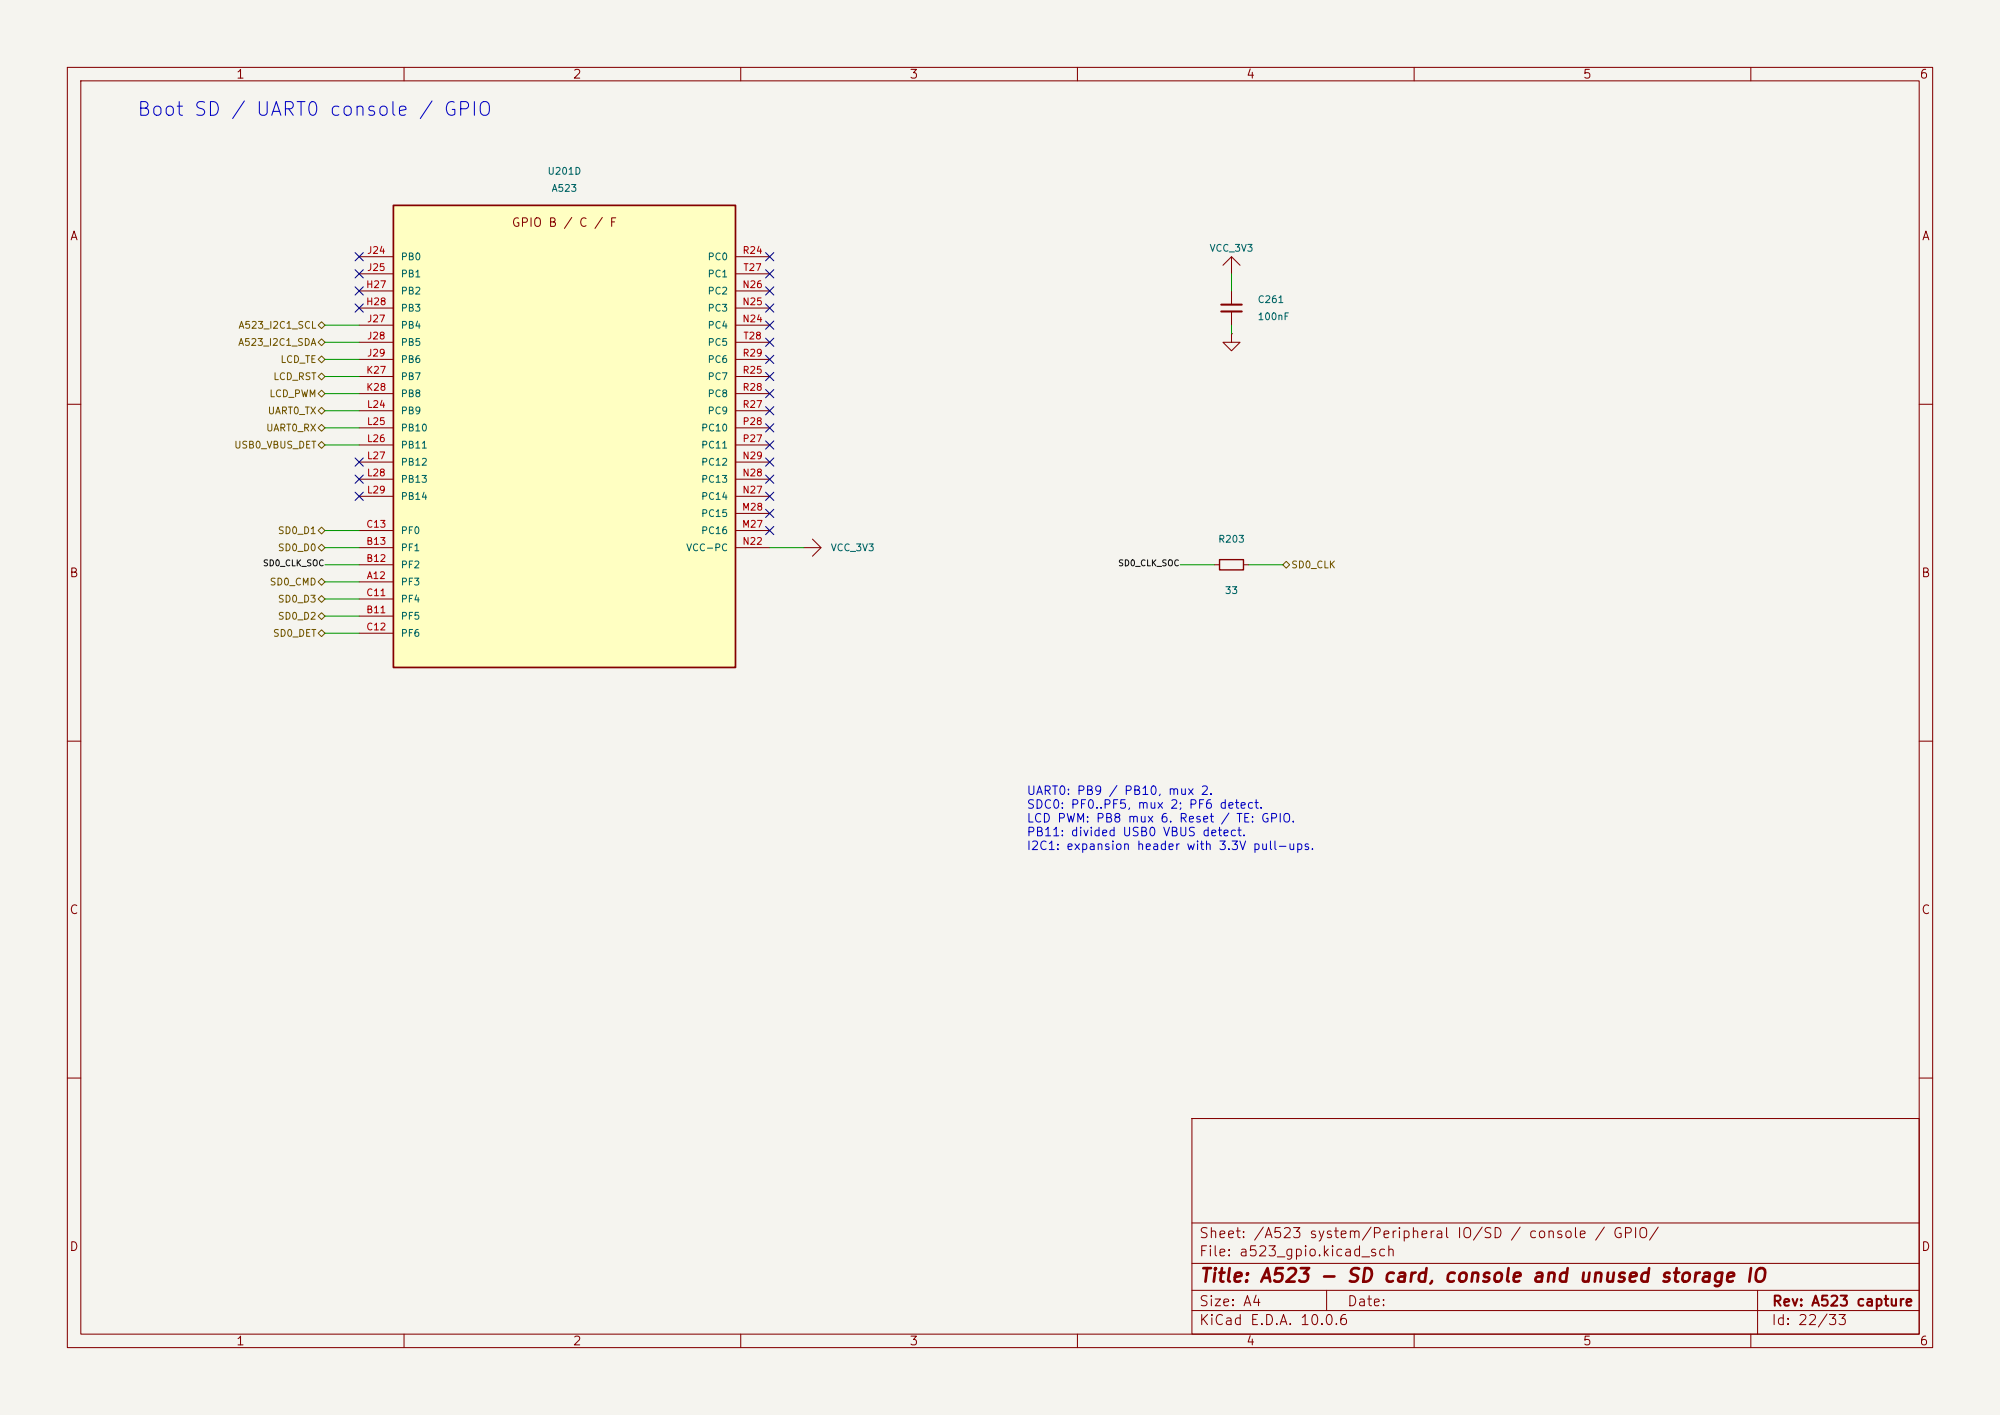
[picture p314: page 22]

Boot SD / UART0 console / GPIO

I2C1: expansion header with 3.3V pull-ups.

Sheet: /A523 system/Peripheral IO/SD / console / GPIO/
File: a523_gpio.kicad_sch
Title: A523 - SD card, console and unused storage IO

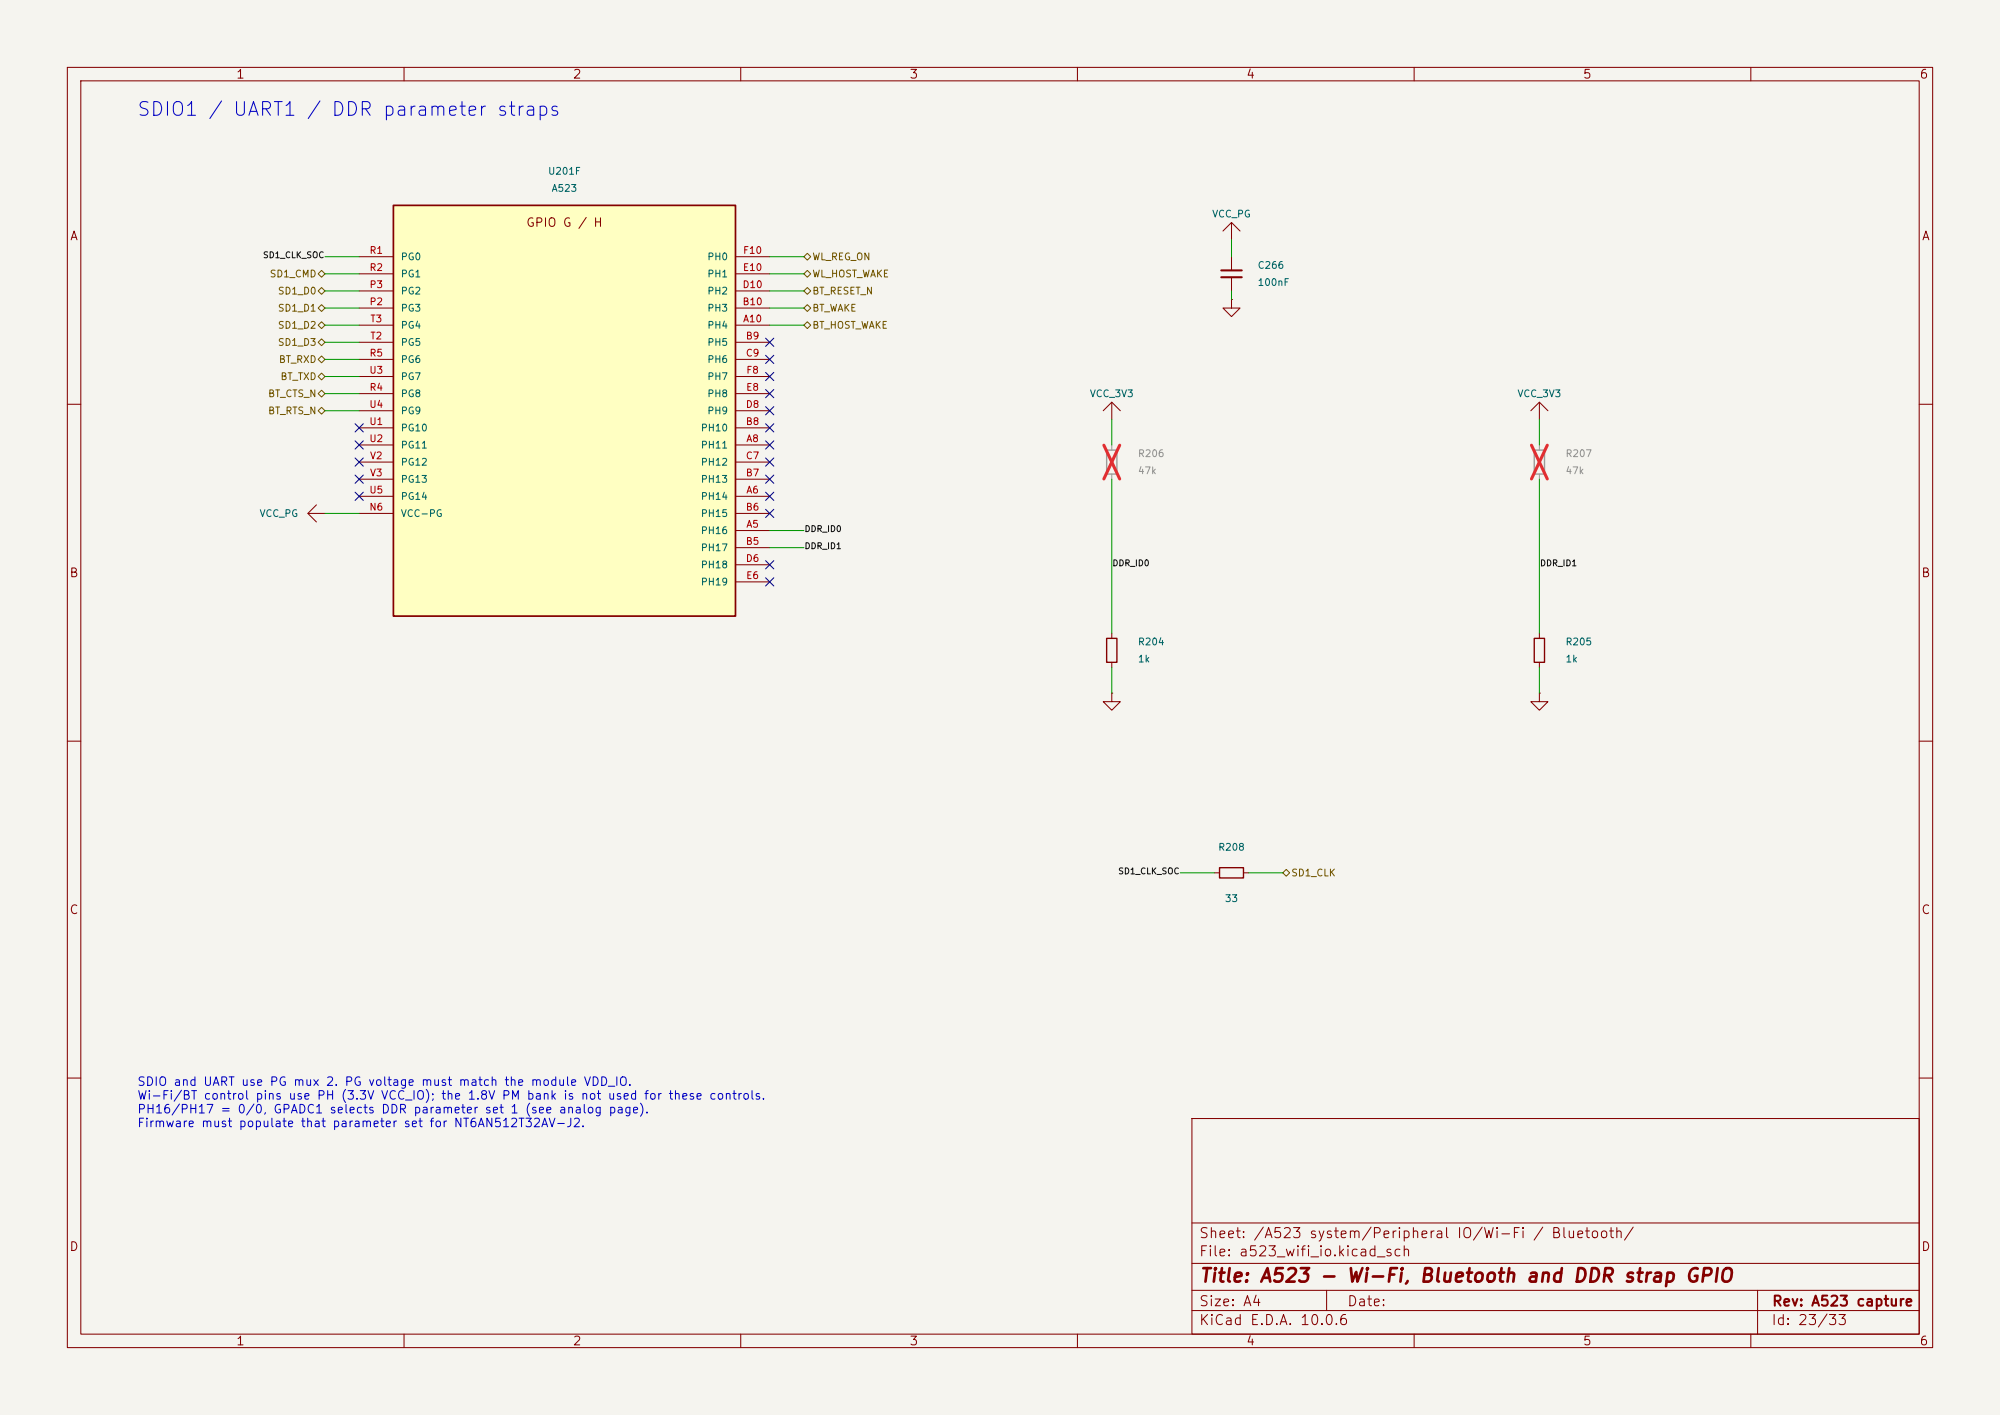
[picture p315: page 23]

SDIO and UART use PG mux 2. PG voltage must match the module VDD_IO. Wi-Fi/BT control pins use PH (3.3V VCC_IO); the 1.8V PM bank is not used for these controls. PH16/PH17 = 0/0, GPADC1 selects DDR parameter set 1 (see analog page). Firmware must populate that parameter set for NT6AN512T32AV-J2.

Sheet: /A523 system/Peripheral IO/Wi-Fi / Bluetooth/
File: a523_wifi_io.kicad_sch
Title: A523 - Wi-Fi, Bluetooth and DDR strap GPIO

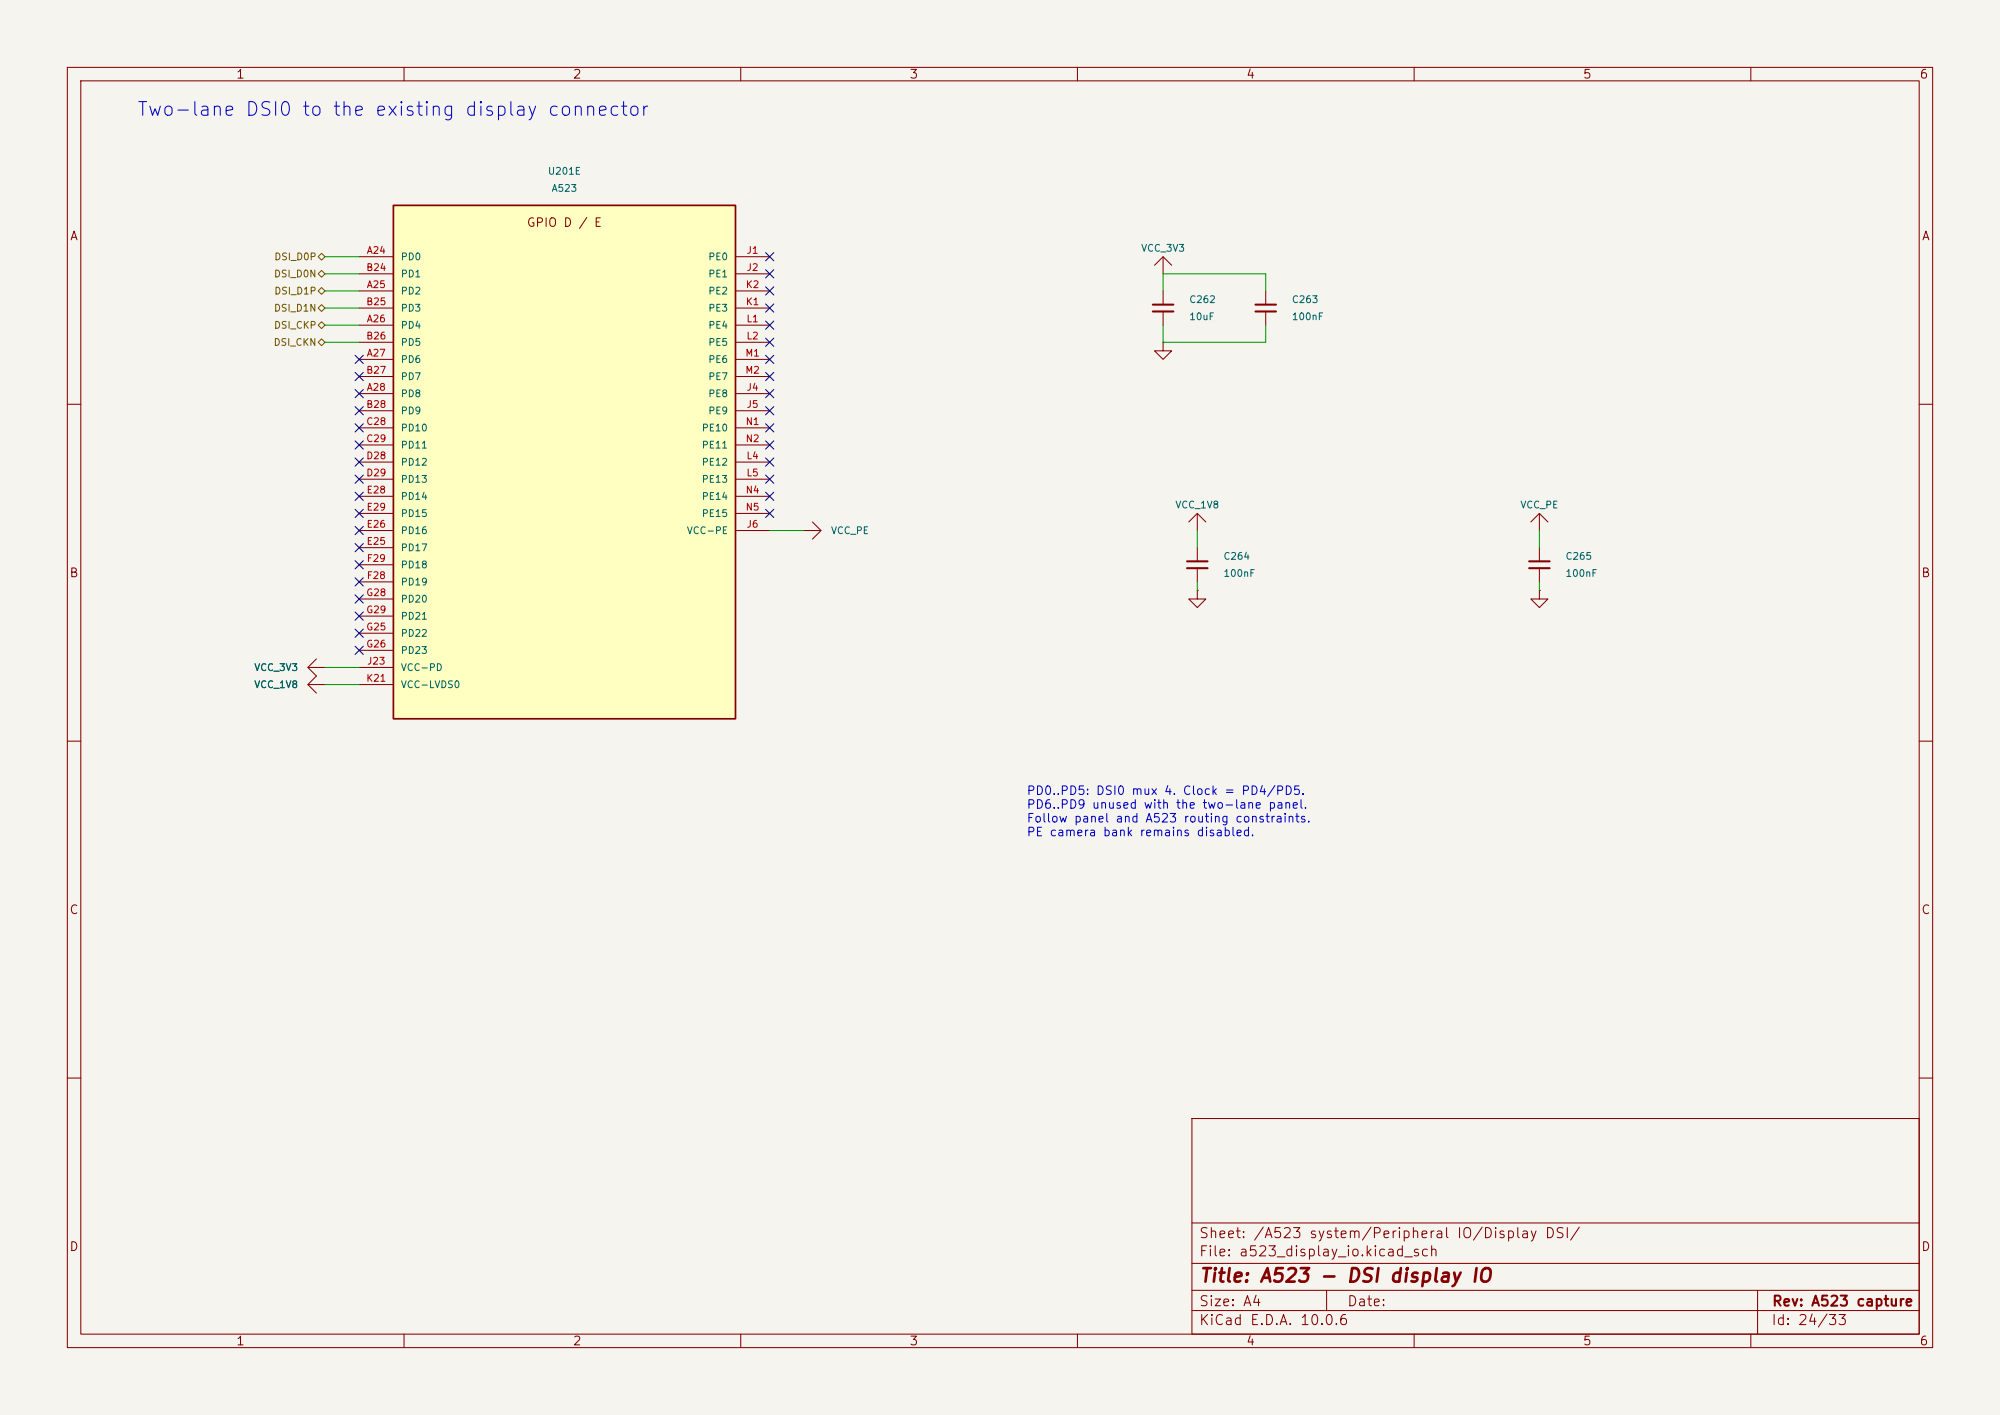
[picture p316: page 24]

Sheet: /A523 system/Peripheral IO/Display DSI/
File: a523_display_io.kicad_sch
Title: A523 - DSI display IO

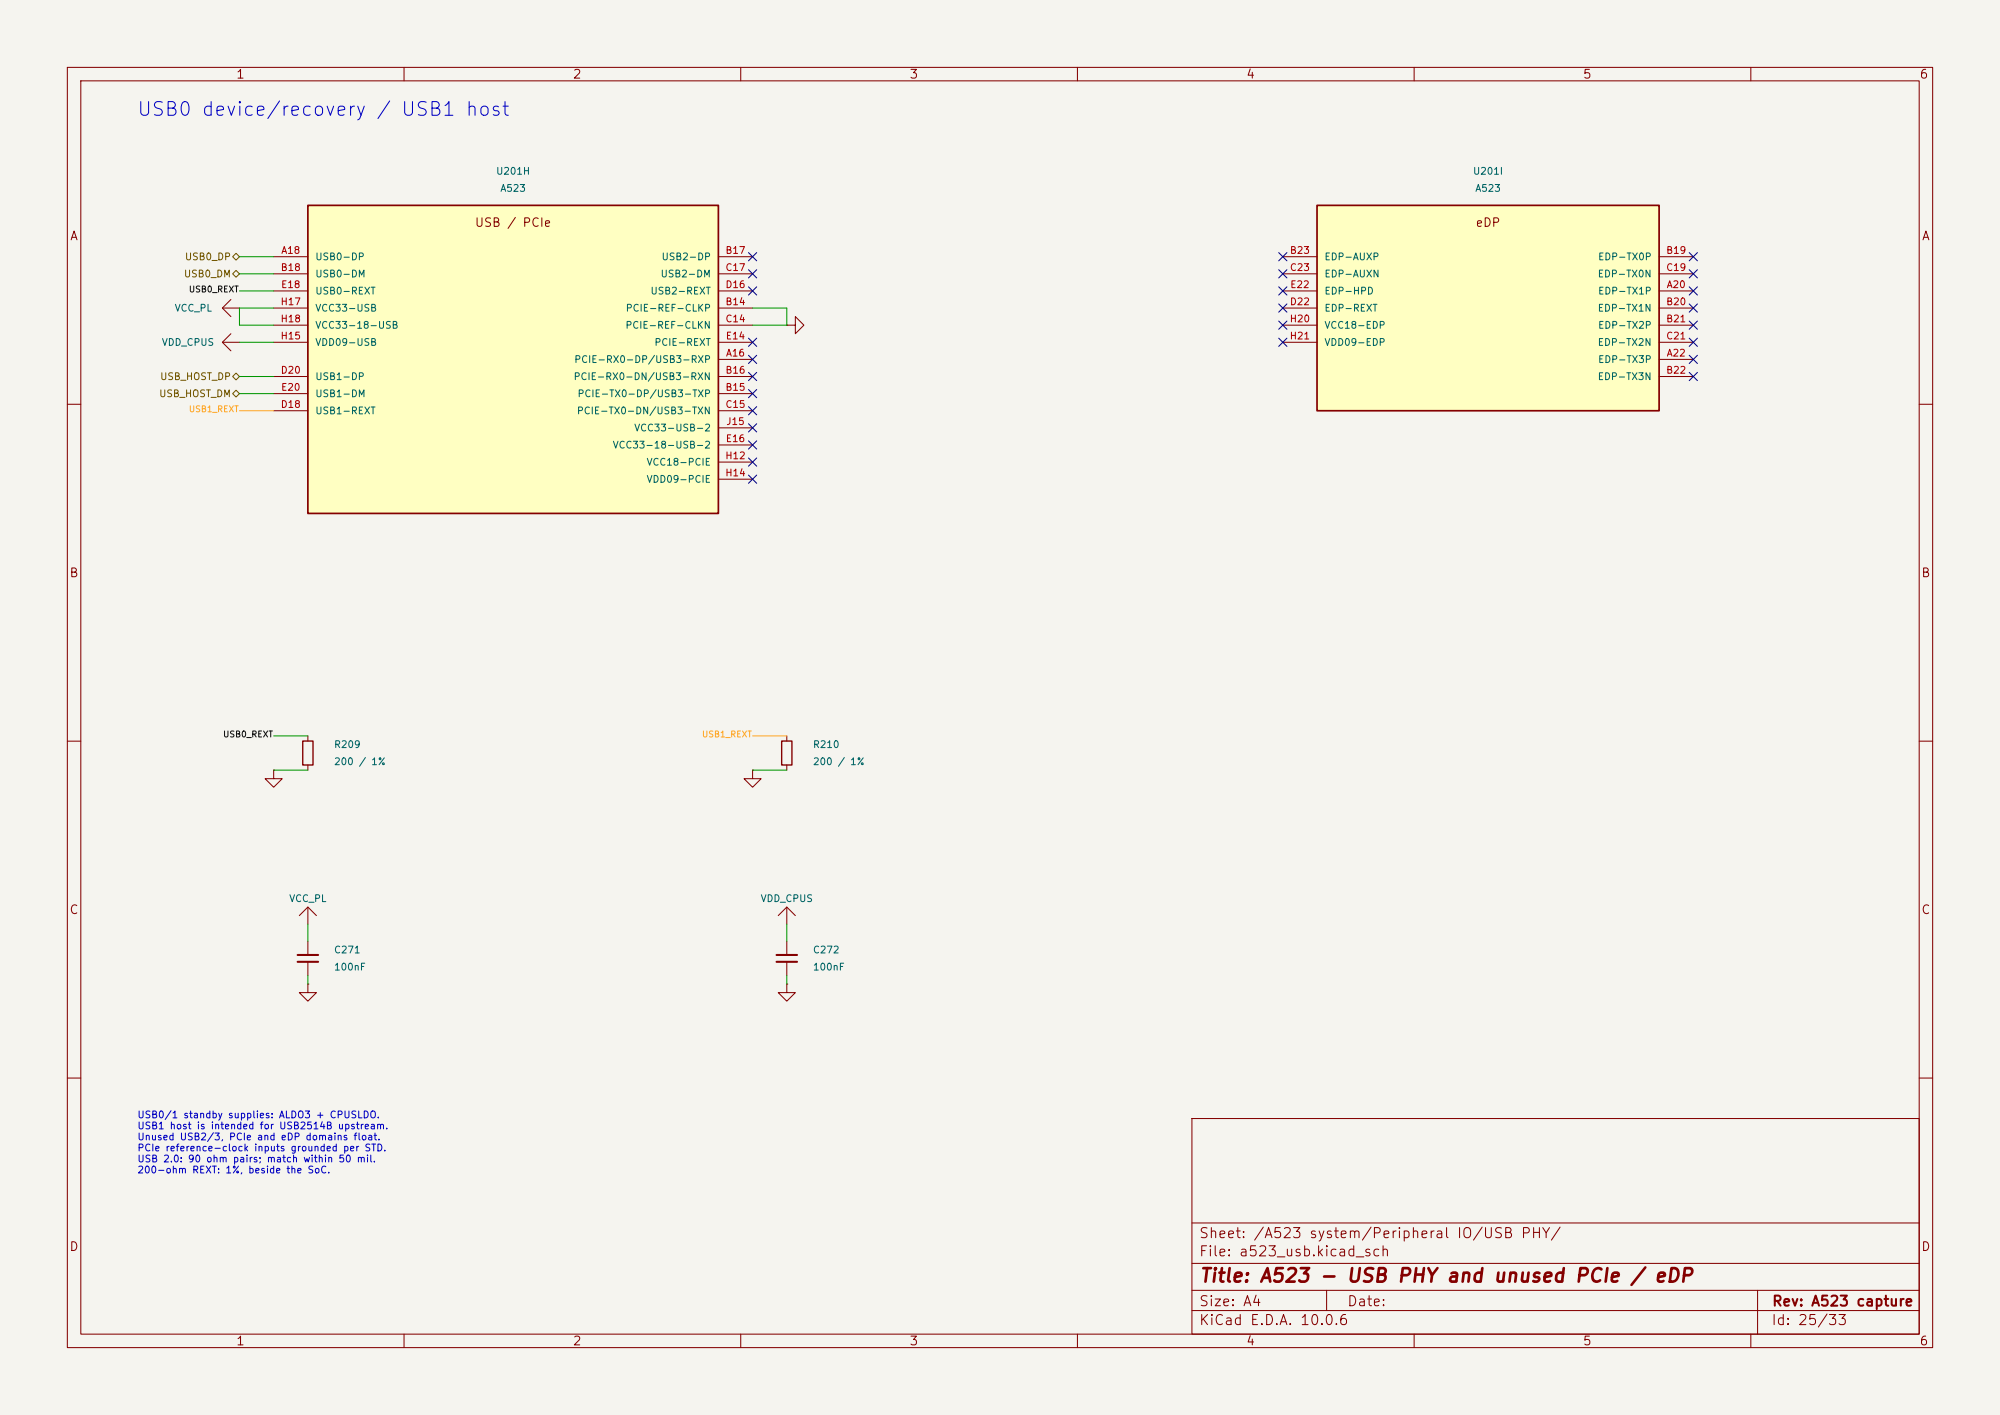
[picture p317: page 25]

USB0/1 standby supplies: ALDO3 + CPUSLDO. USB1 host is intended for USB2514B upstream. Unused USB2/3, PCIe and eDP domains float. PCIe reference-clock inputs grounded per STD. USB 2.0: 90 ohm pairs; match within 50 mil. 200-ohm REXT: 1%, beside the SoC.

Sheet: /A523 system/Peripheral IO/USB PHY/
File: a523_usb.kicad_sch
Title: A523 - USB PHY and unused PCIe / eDP

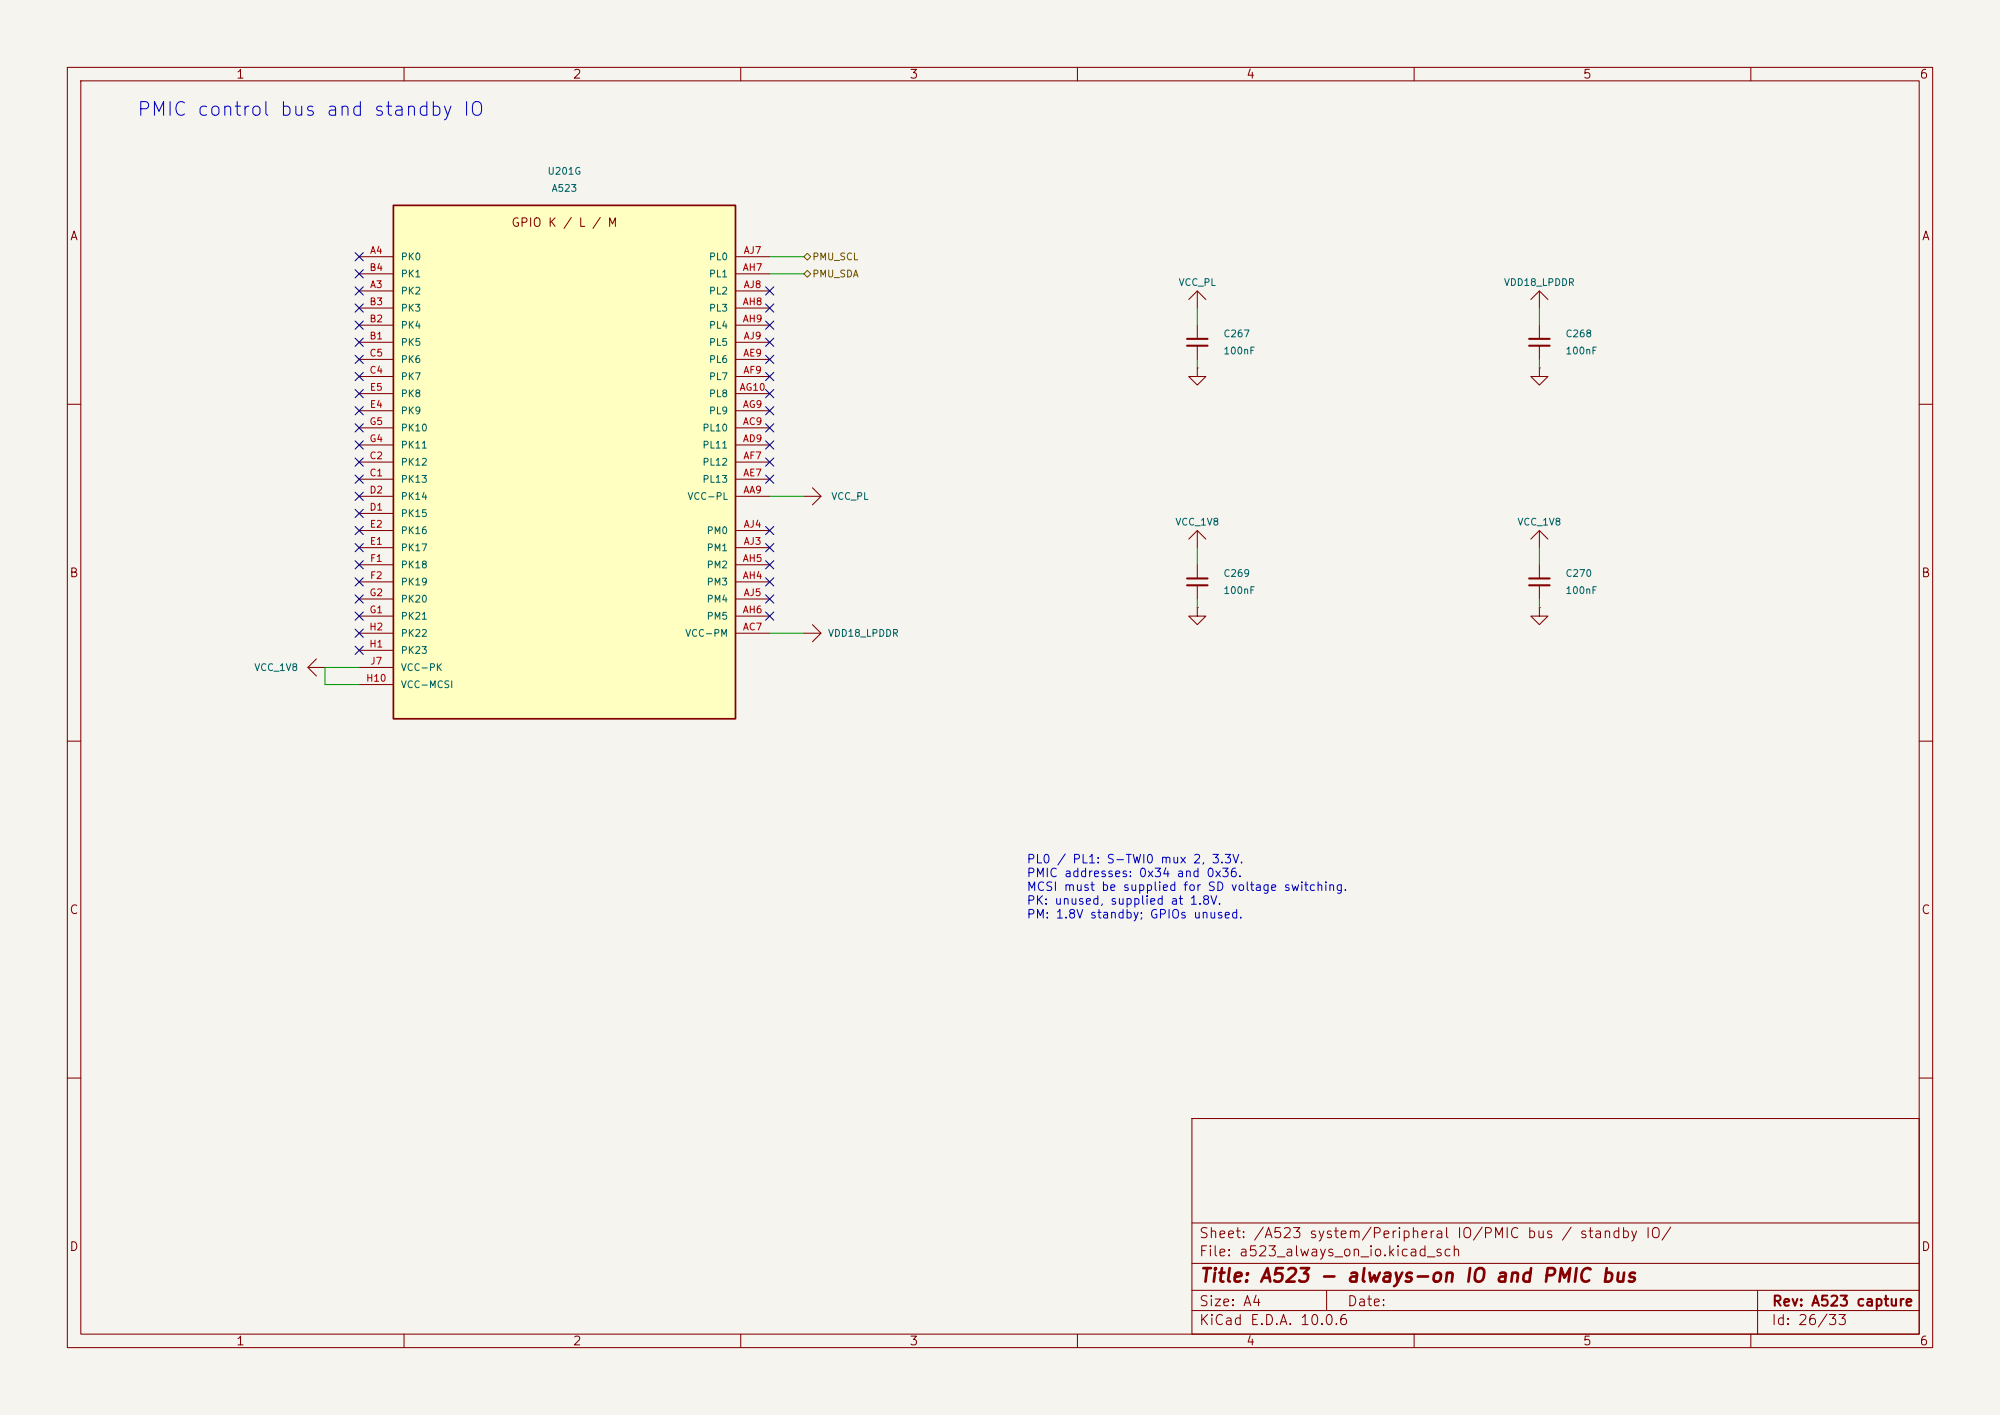
[picture p318: page 26]

PMU_SCL PMU_SDA PMIC control bus and standby IO

PL0 / PL1: S-TWI0 mux 2, 3.3V. PMIC addresses: 0x34 and 0x36. MCSI must be supplied for SD voltage switching. PK: unused, supplied at 1.8V. PM: 1.8V standby; GPIOs unused.

Sheet: /A523 system/Peripheral IO/PMIC bus / standby IO/
File: a523_always_on_io.kicad_sch
Title: A523 - always-on IO and PMIC bus

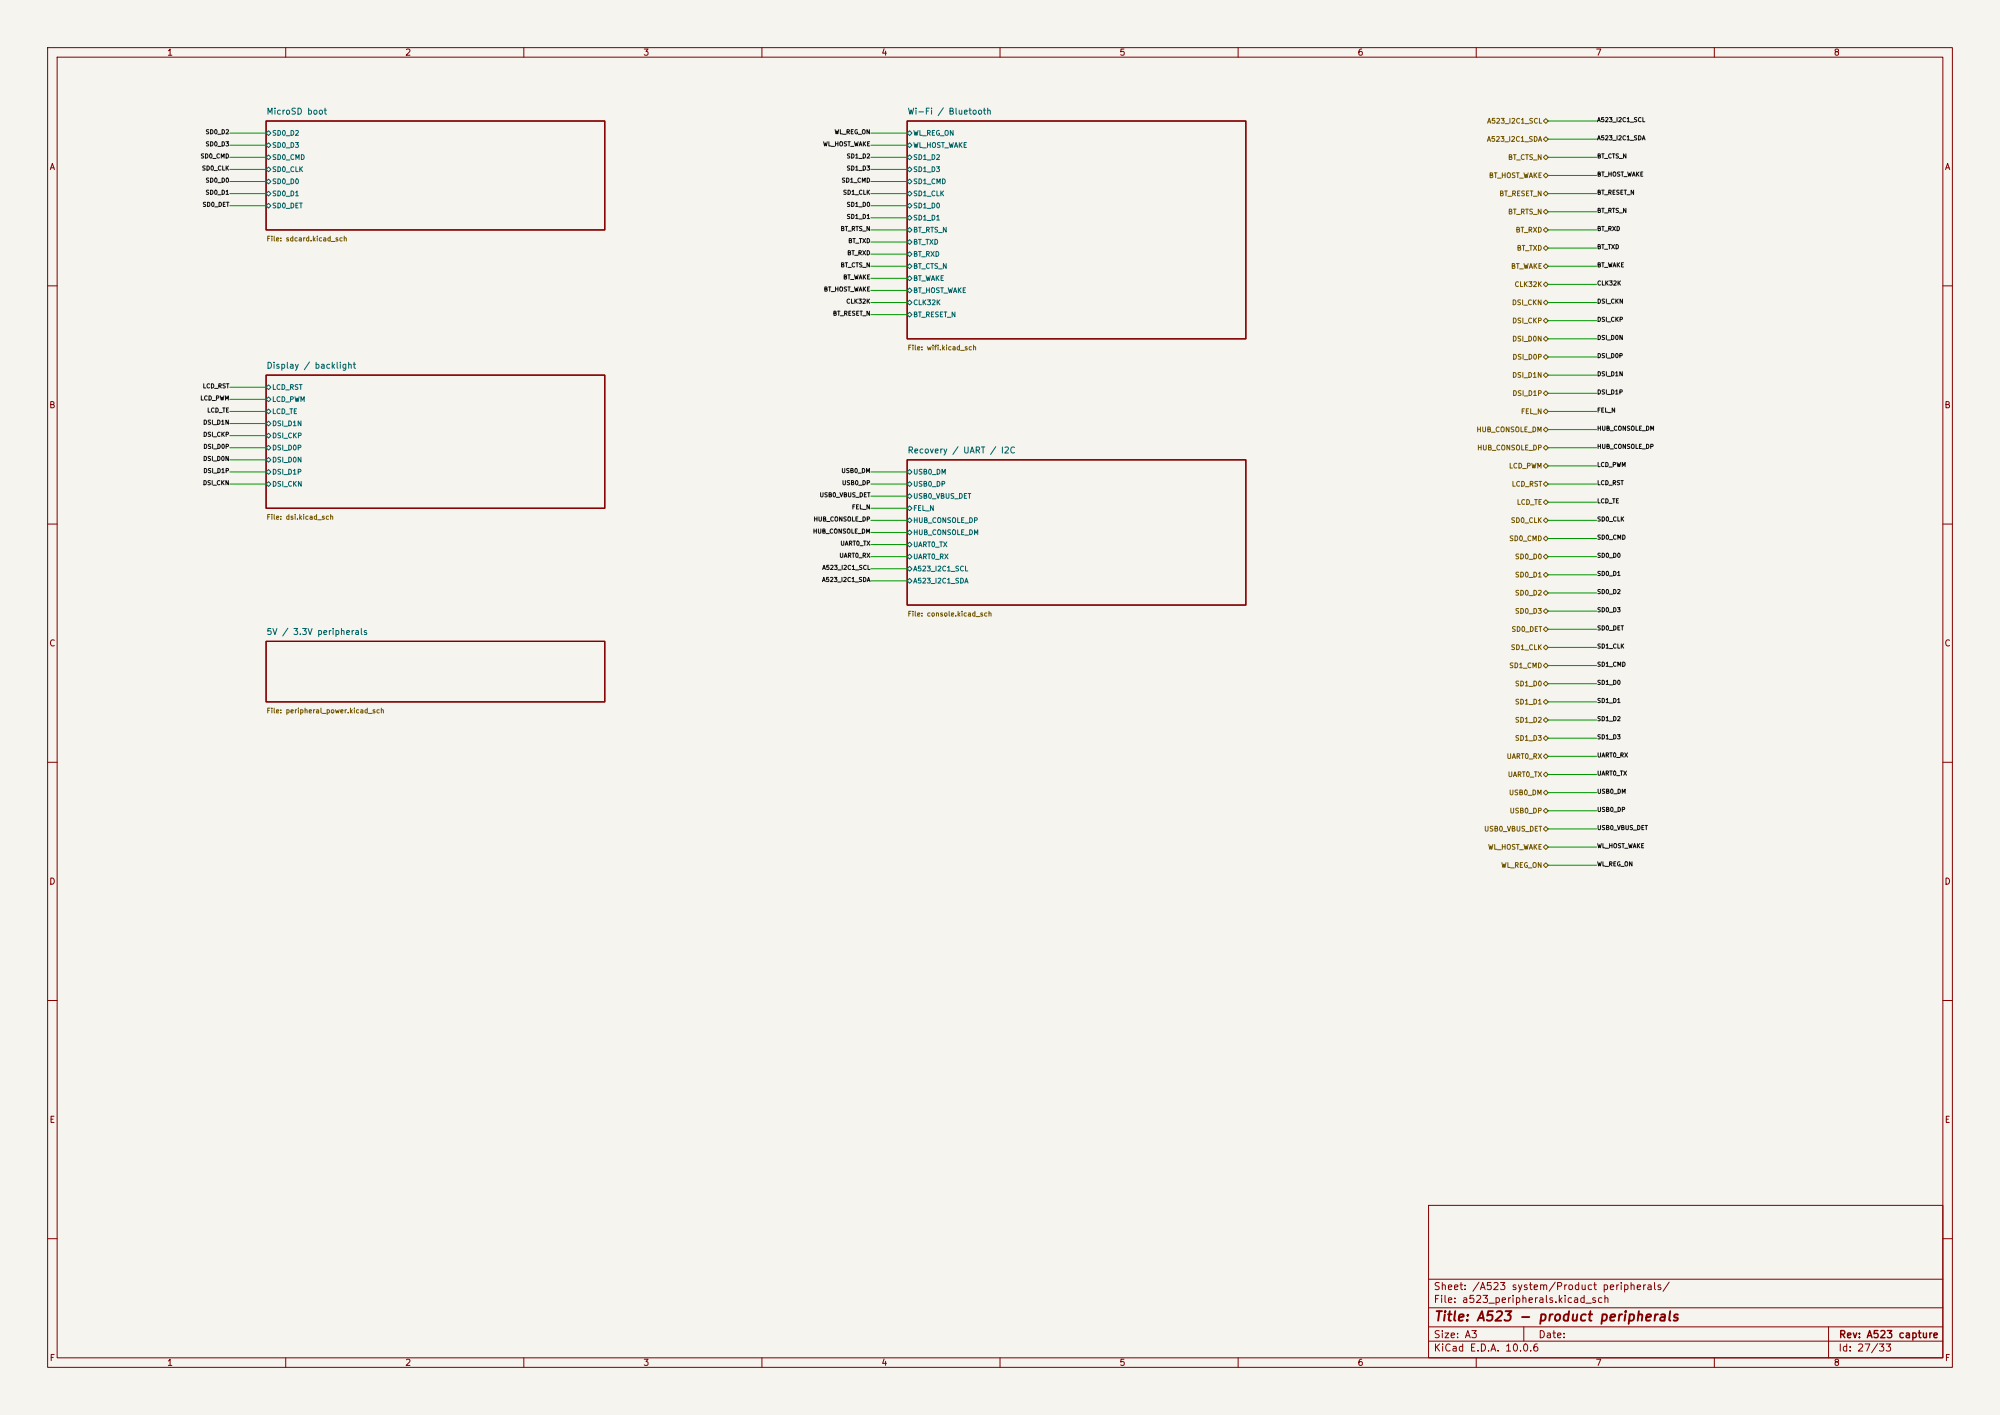
[picture p319: page 27]

SD0_DET MicroSD boot File: sdcard.kicad_sch 5V / 3.3V peripherals
SD0_D2 DSI_D0P

DSI_CKN Display / backlight File: dsi.kicad_sch

Sheet: /A523 system/Product peripherals/
File: a523_peripherals.kicad_sch
Title: A523 - product peripherals

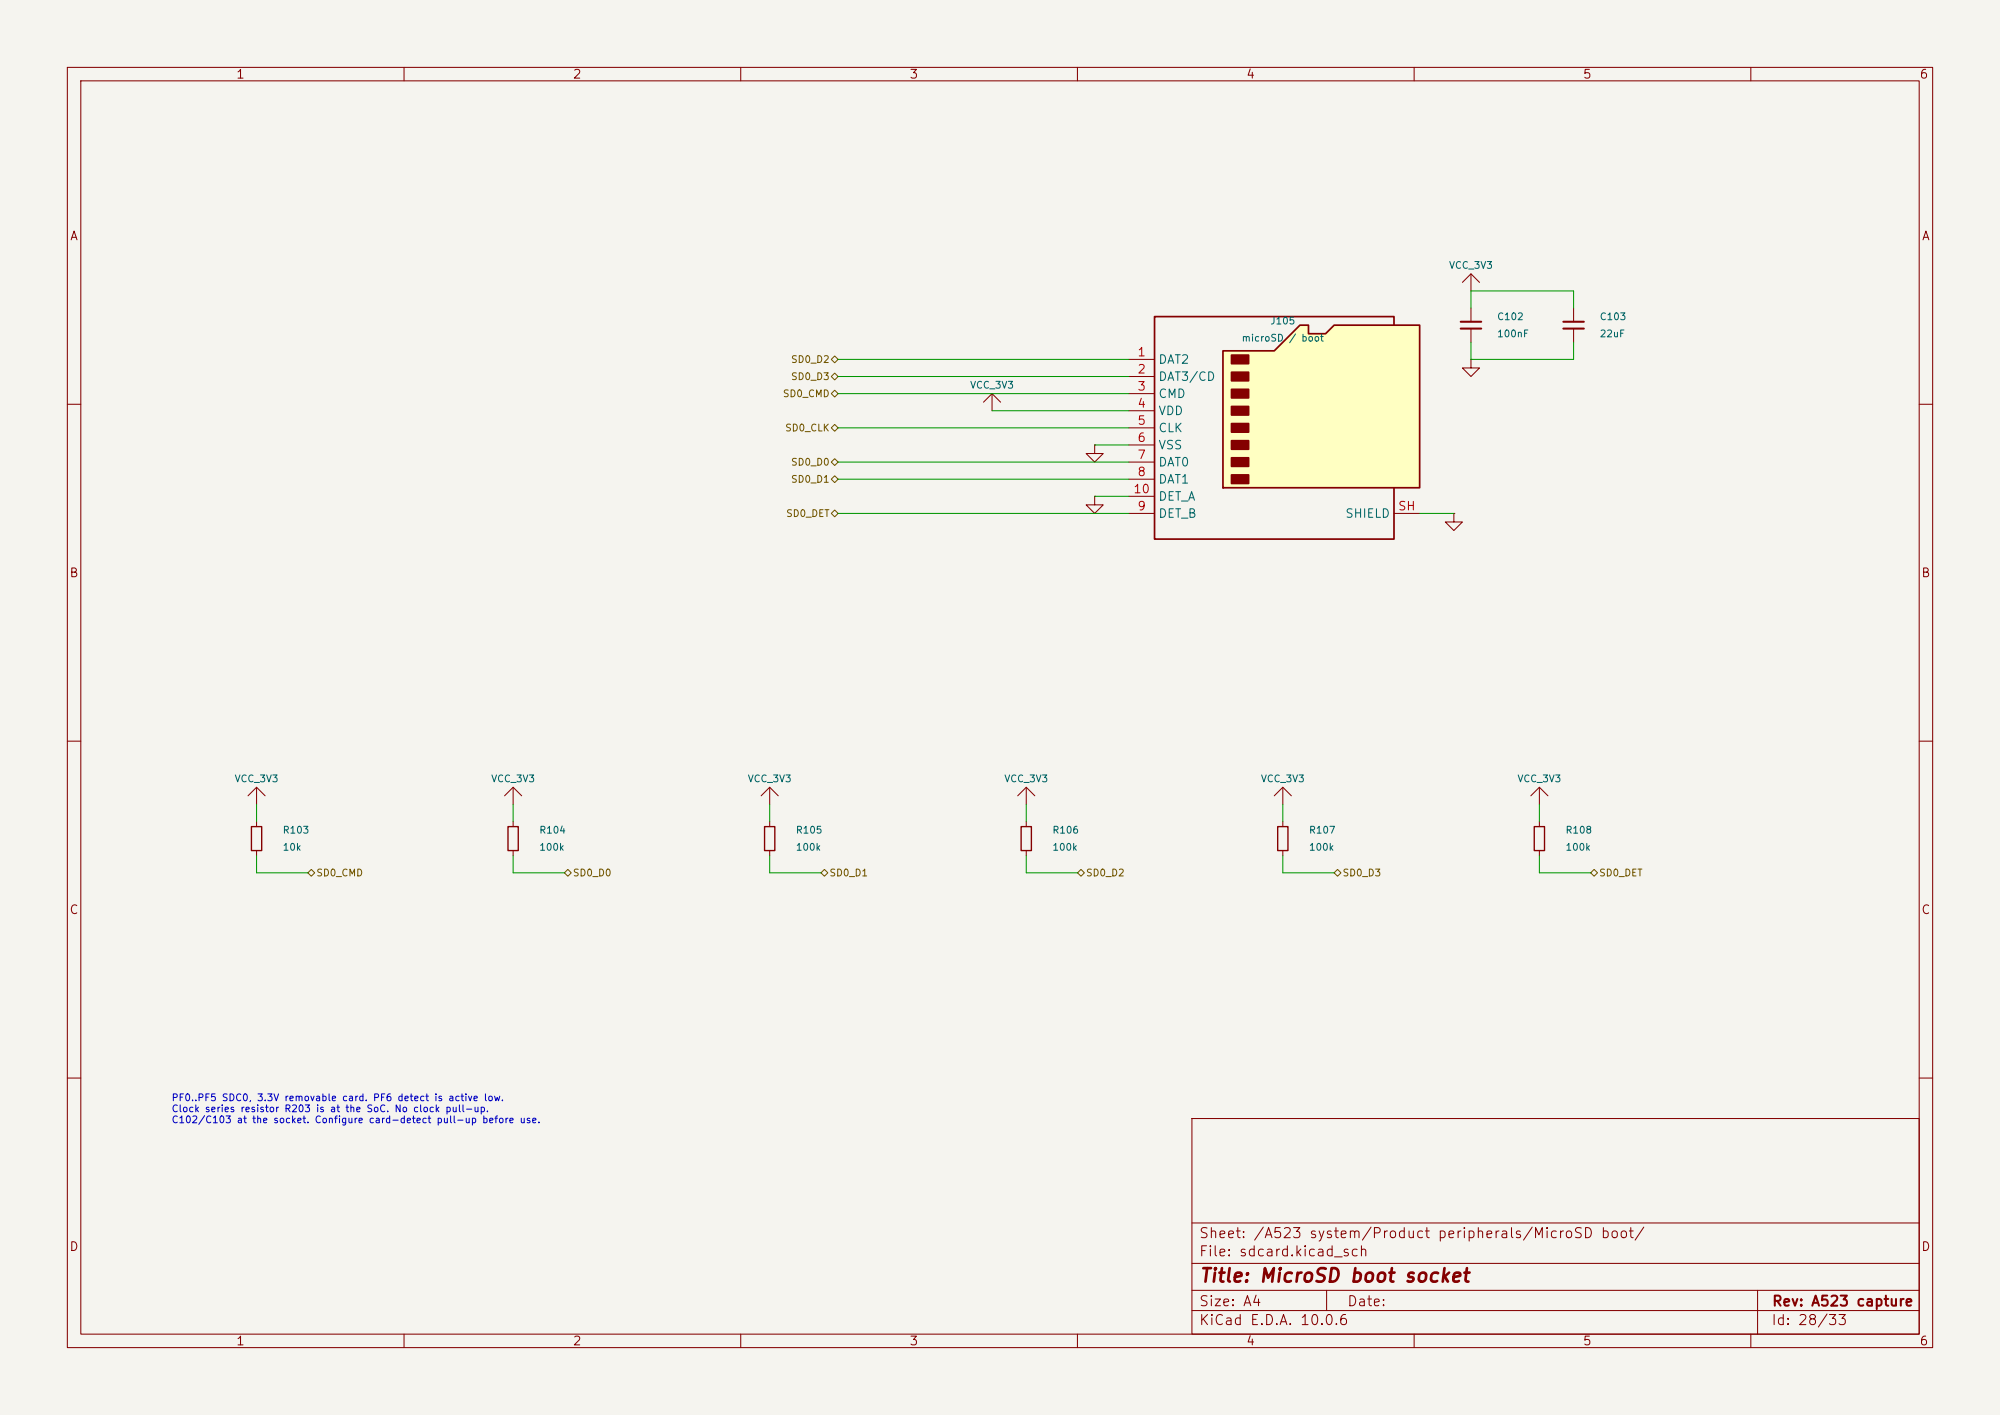
[picture p320: page 28]

PF0..PF5 SDC0, 3.3V removable card. PF6 detect is active low. Clock series resistor R203 is at the SoC. No clock pull-up. C102/C103 at the socket. Configure card-detect pull-up before use.

Sheet: /A523 system/Product peripherals/MicroSD boot/
File: sdcard.kicad_sch
Title: MicroSD boot socket

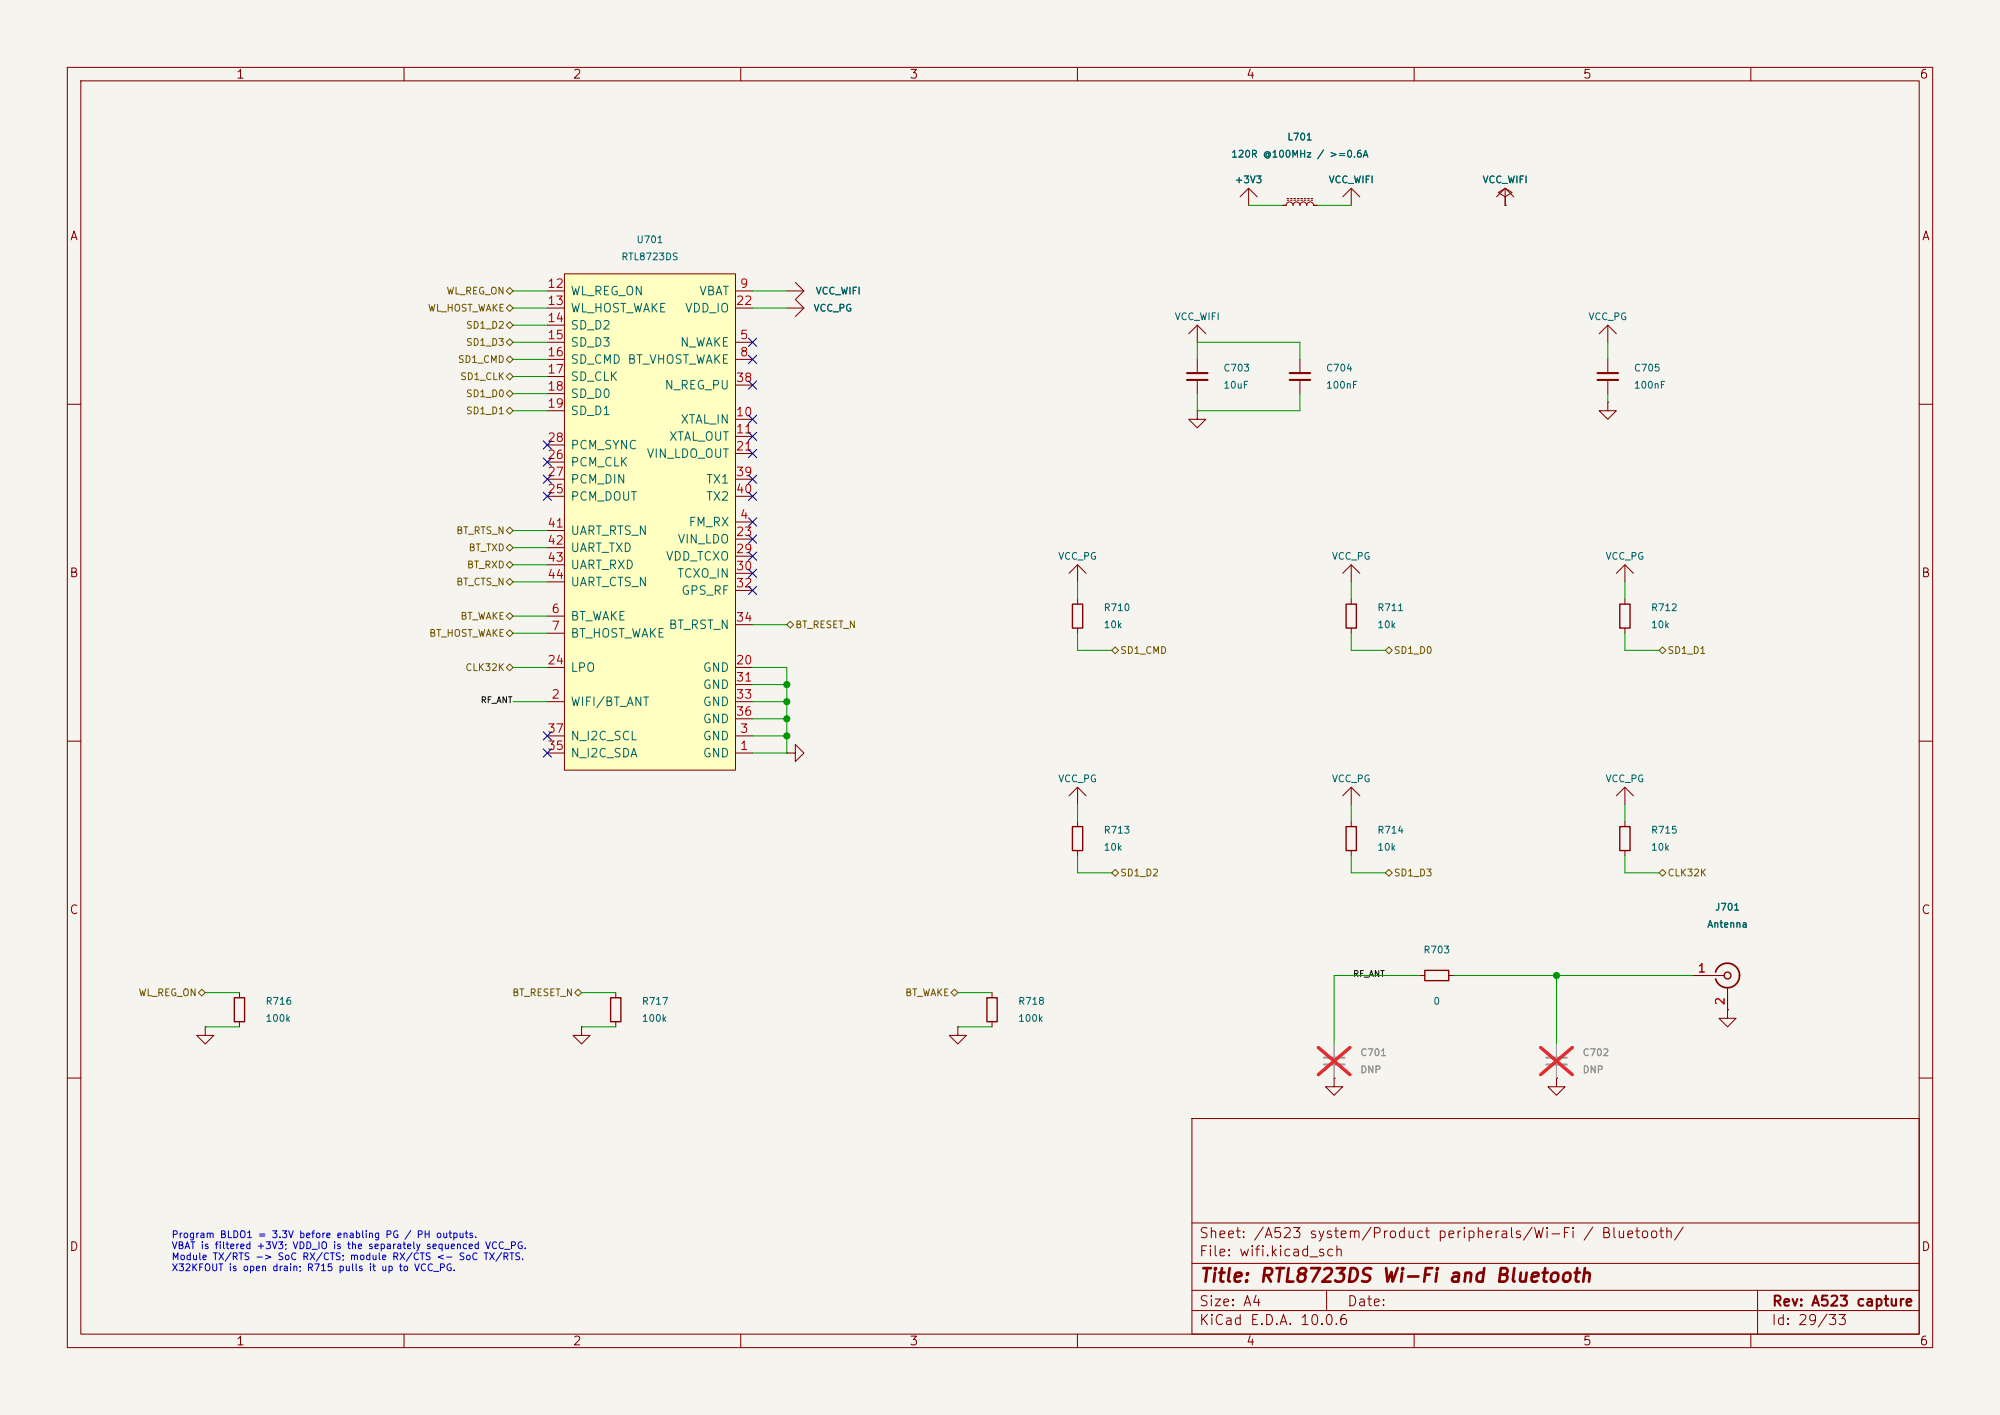
[picture p321: page 29]

Sheet: /A523 system/Product peripherals/Wi-Fi / Bluetooth/
File: wifi.kicad_sch
Title: RTL8723DS Wi-Fi and Bluetooth

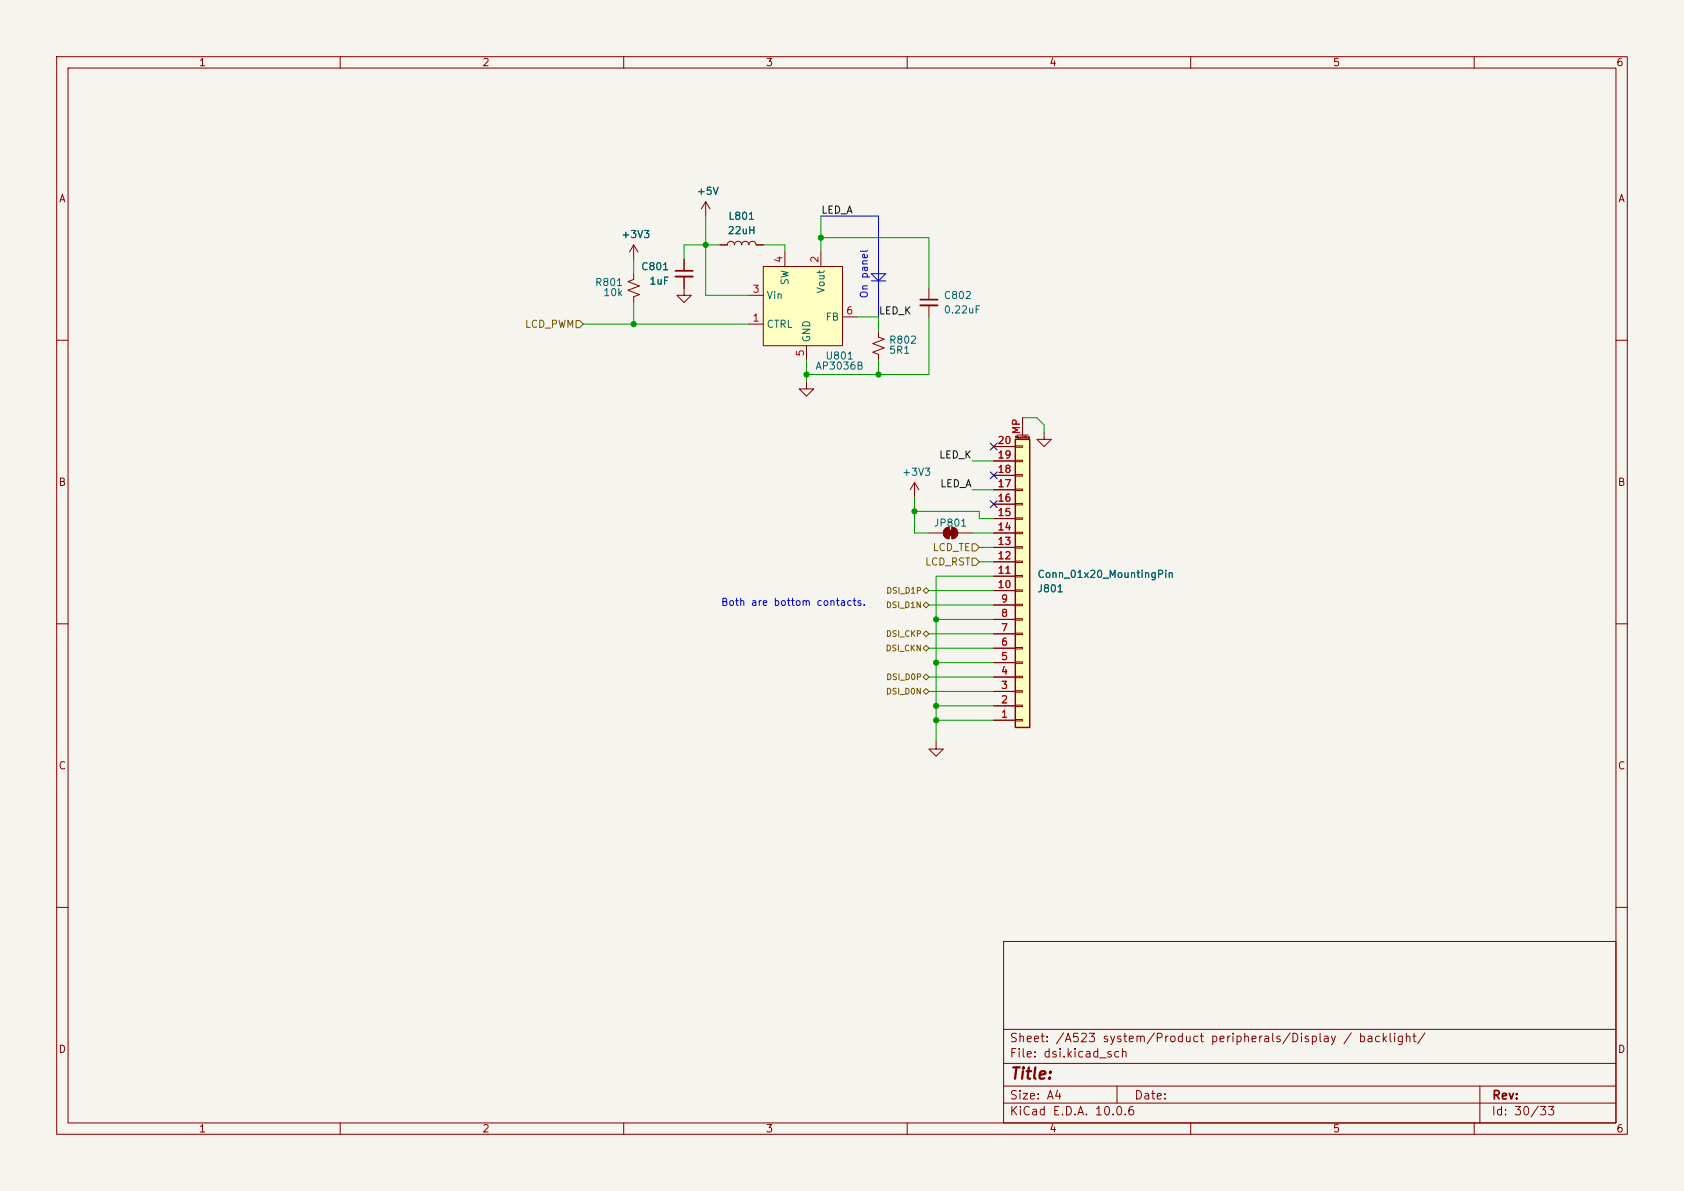
[picture p322: page 30]

LED_K On panel Both are bottom contacts. +3V3C801

Sheet: /A523 system/Product peripherals/Display / backlight/
File: dsi.kicad_sch
Title:

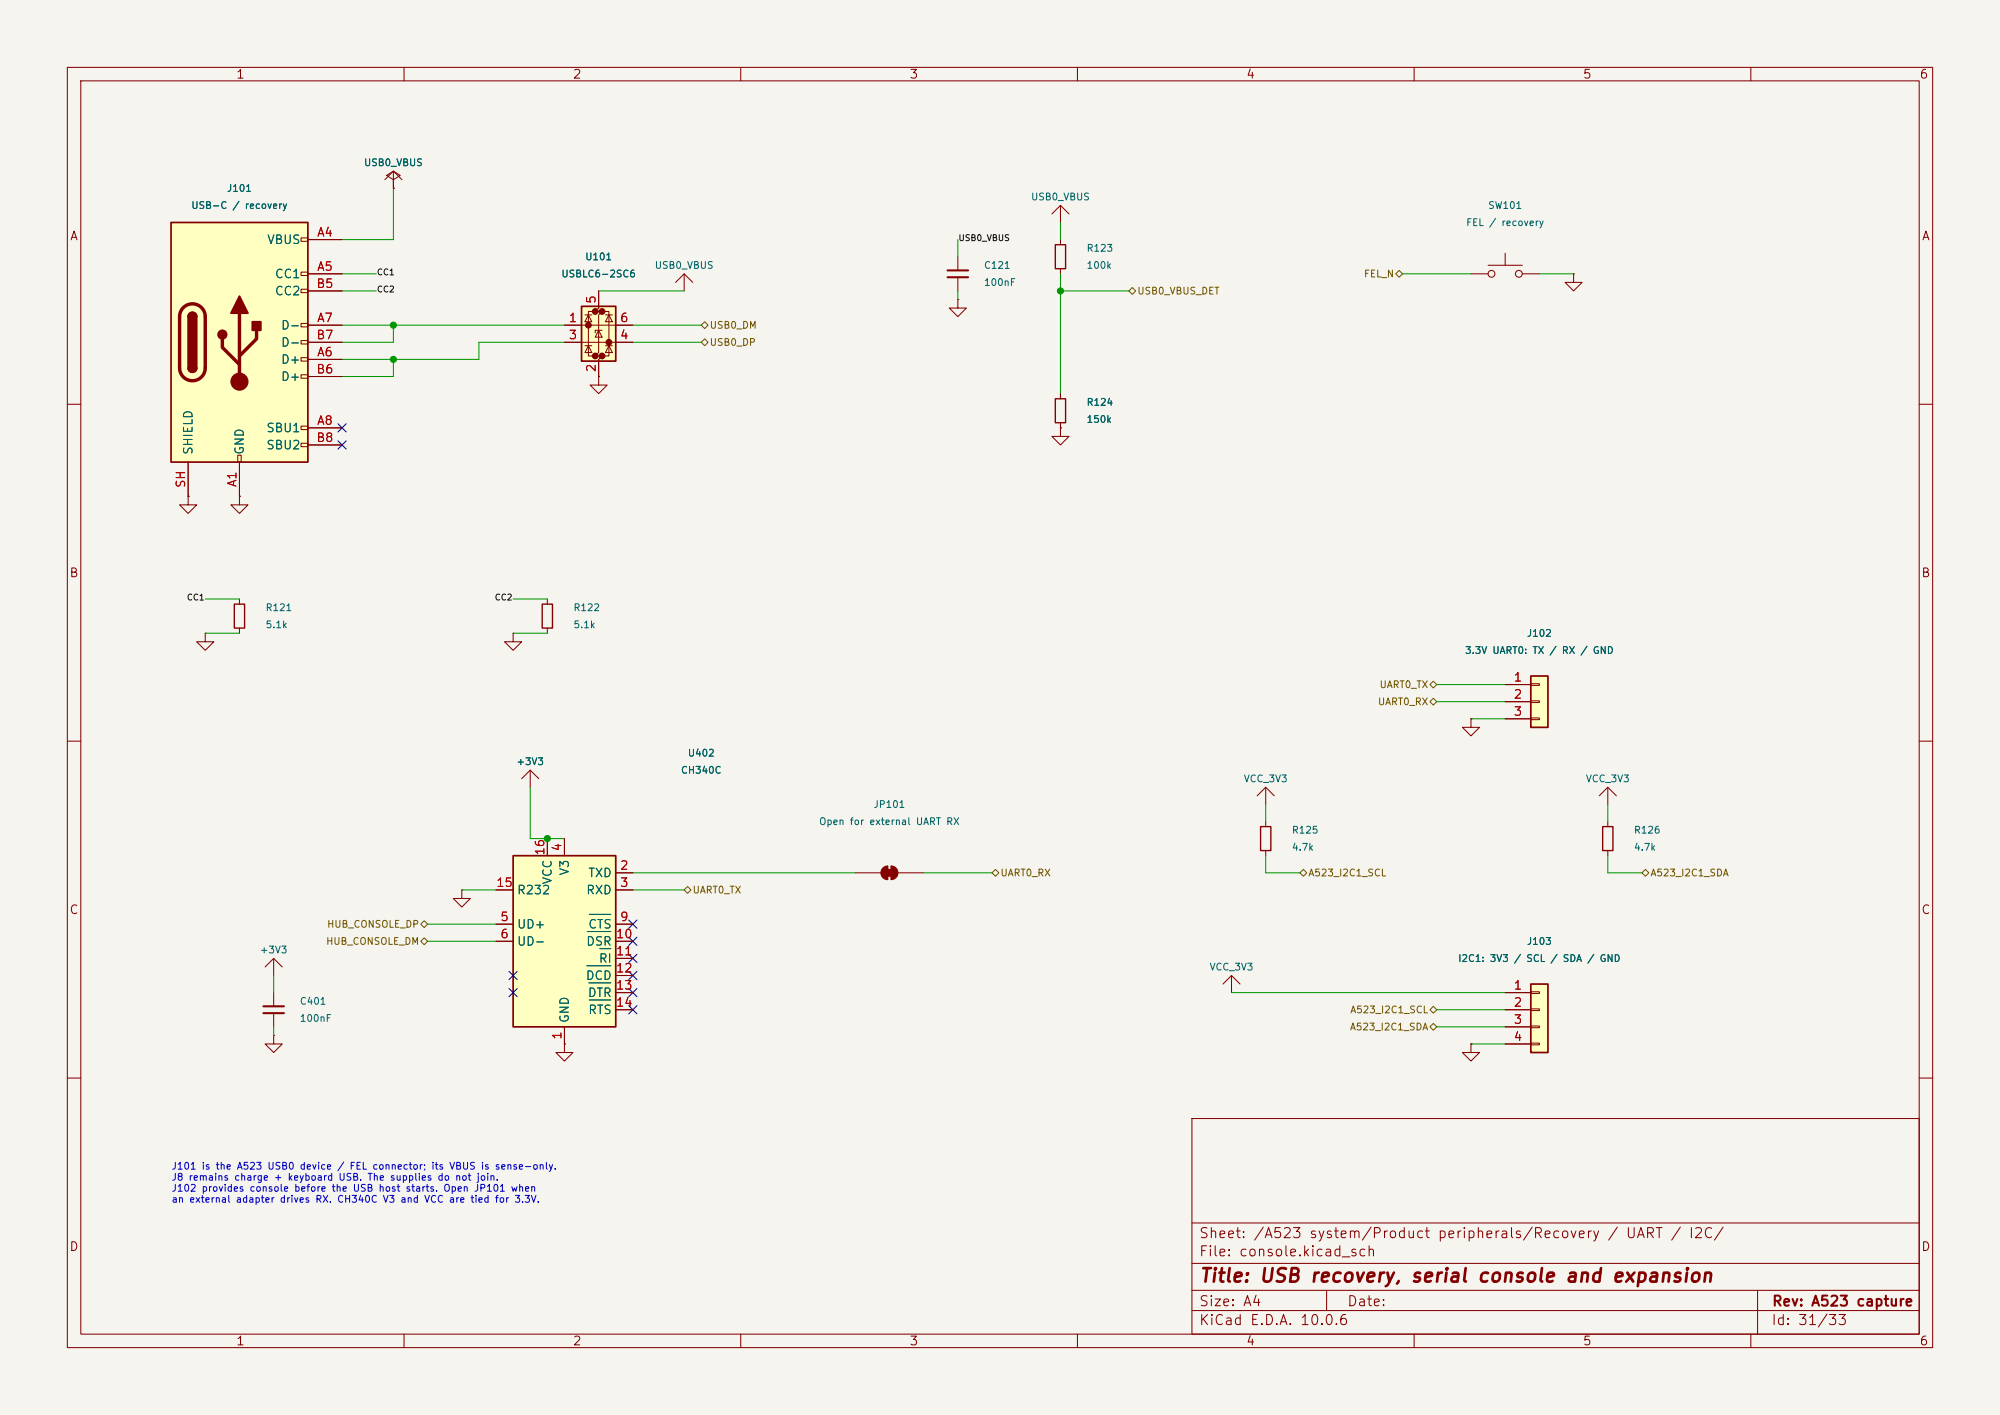
[picture p323: page 31]

JP101 Open for external UART RX

4 UD+ 5 UD- 6 CTS 9 DSR 10 RI 11 DCD 12 DTR 13 RTS 14 R232 15 VCC 16

J101 is the A523 USB0 device / FEL connector; its VBUS is sense-only. J8 remains charge + keyboard USB. The supplies do not join. J102 provides console before the USB host starts. Open JP101 when

an external adapter drives RX. CH340C V3 and VCC are tied for 3.3V.

Sheet: /A523 system/Product peripherals/Recovery / UART / I2C/
File: console.kicad_sch
Title: USB recovery, serial console and expansion

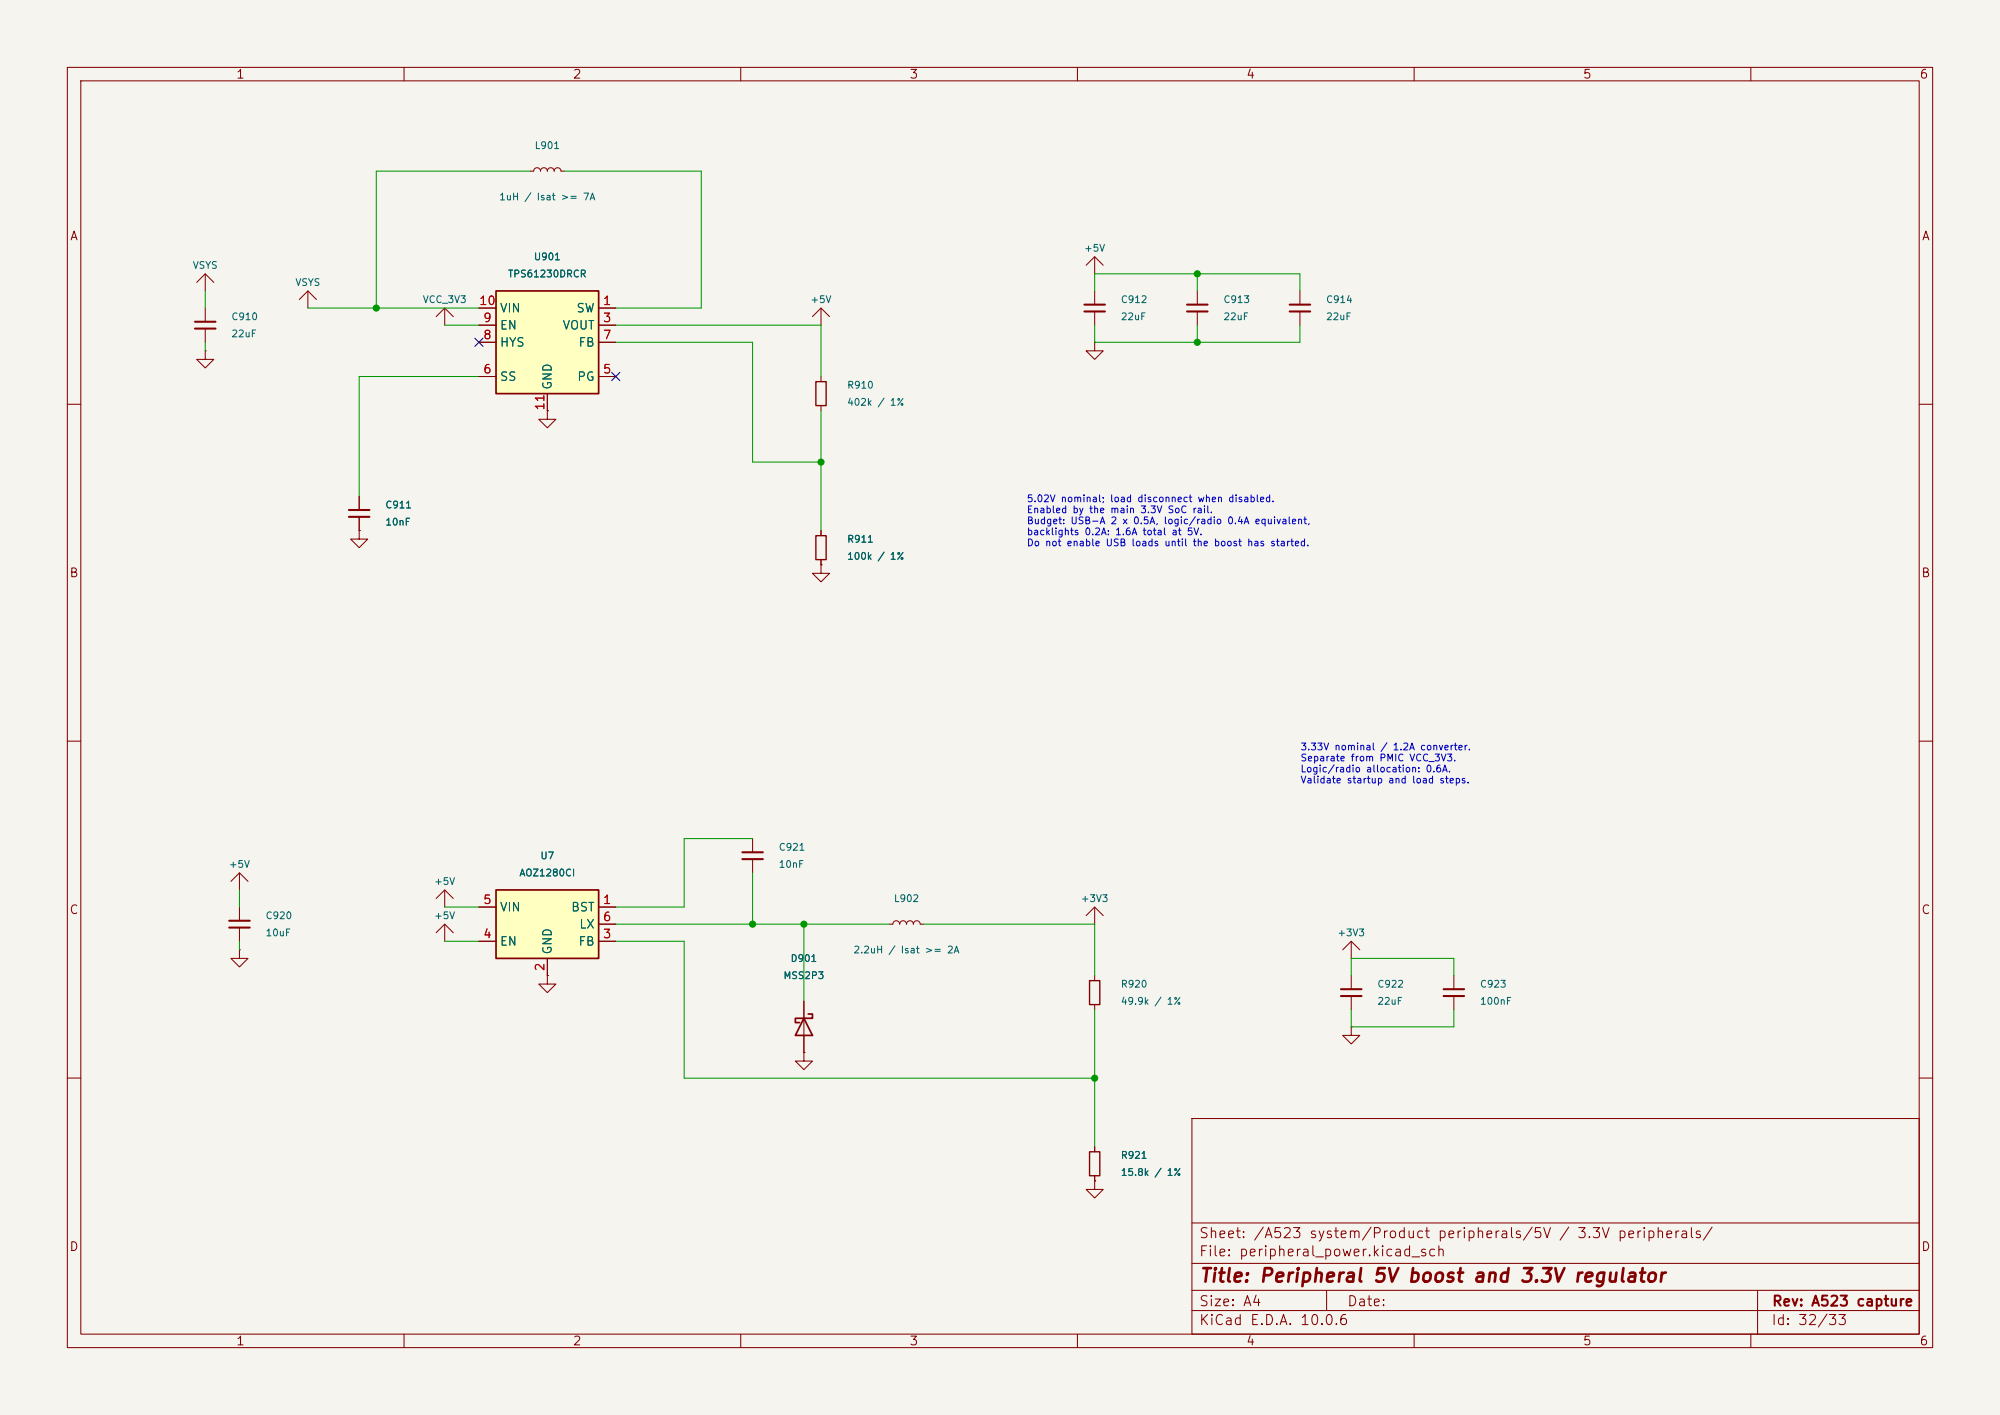
[picture p324: page 32]

5.02V nominal; load disconnect when disabled. Enabled by the main 3.3V SoC rail. Budget: USB-A 2 x 0.5A, logic/radio 0.4A equivalent, backlights 0.2A: 1.6A total at 5V. Do not enable USB loads until the boost has started. 3.33V nominal / 1.2A converter. Separate from PMIC VCC_3V3. Logic/radio allocation: 0.6A. Validate startup and load steps. R911

Sheet: /A523 system/Product peripherals/5V / 3.3V peripherals/
File: peripheral_power.kicad_sch
Title: Peripheral 5V boost and 3.3V regulator

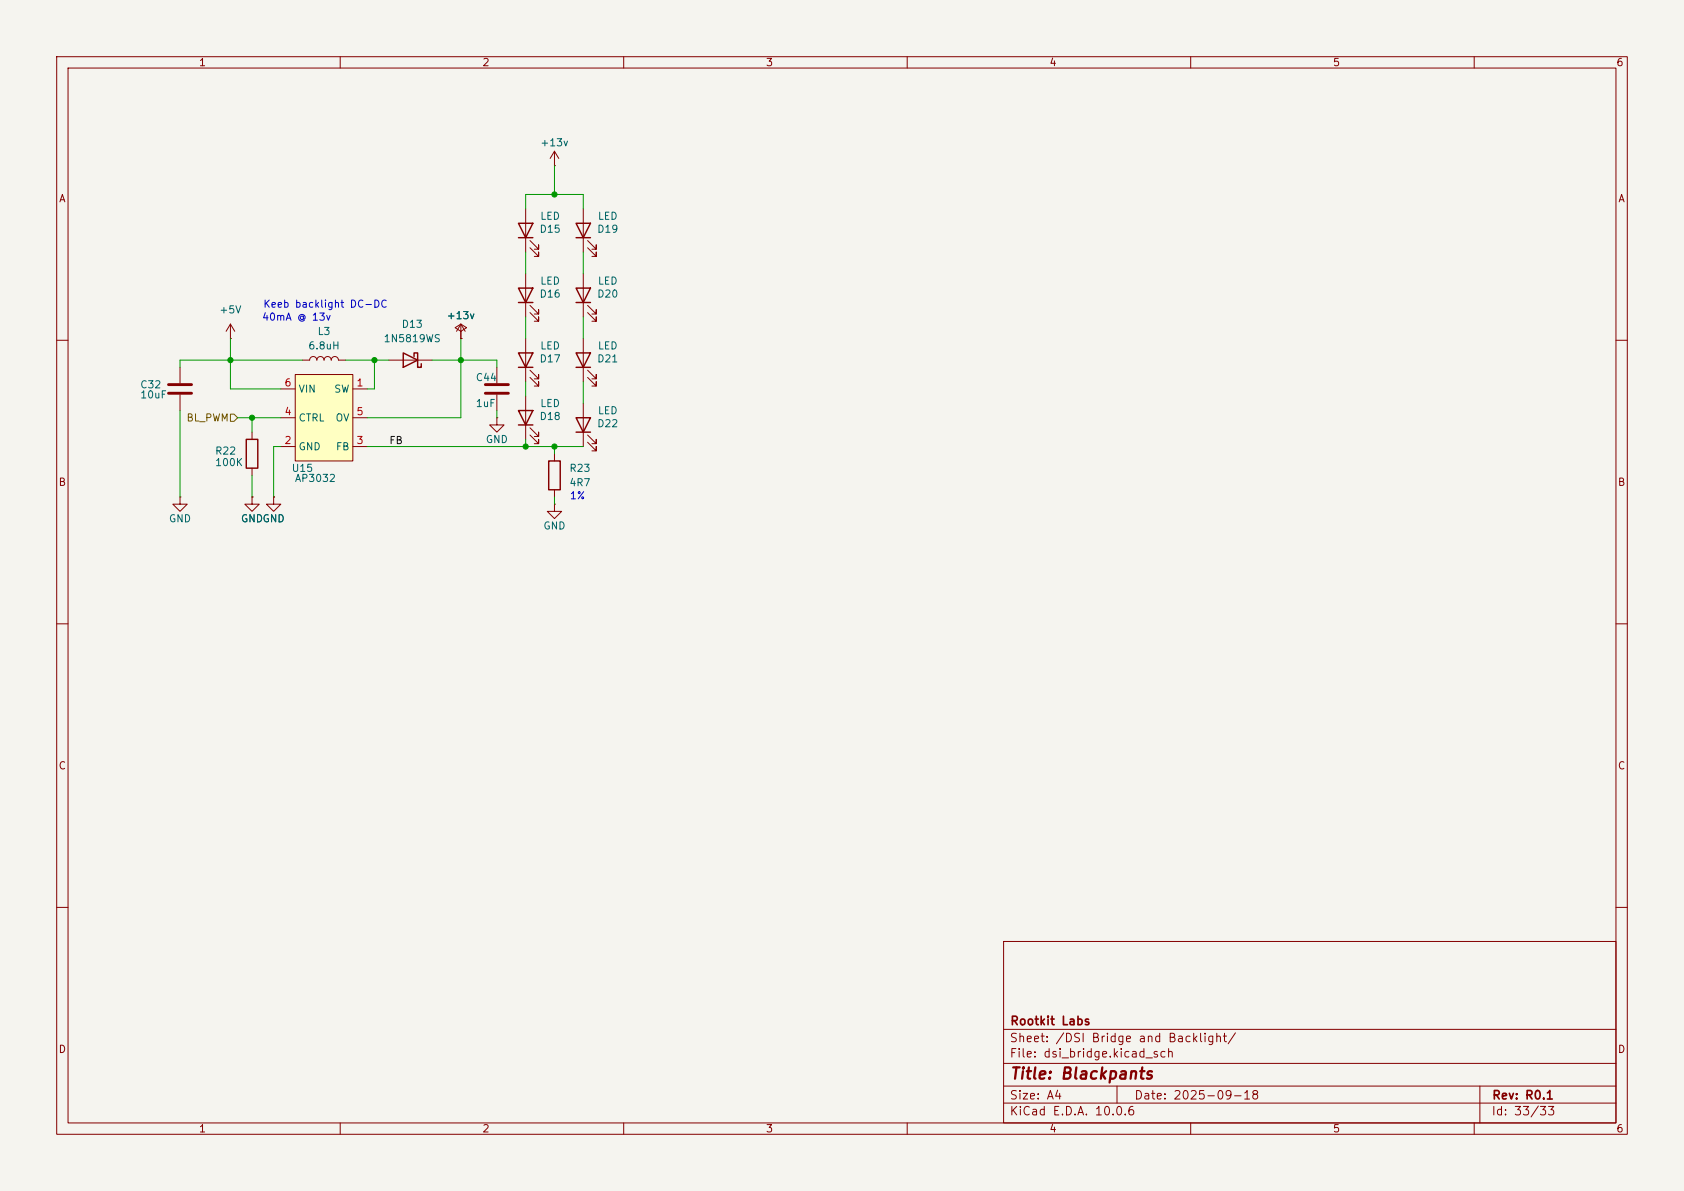
[picture p325: page 33]

Rootkit Labs
Sheet: /DSI Bridge and Backlight/
File: dsi_bridge.kicad_sch
Title: Blackpants
