o7-machinehum/Blackpants/docs/a523/A523_hwref/原理图/标案原理图/a523_std_axp717c_axp323_lpddr4_240712.pdf

# Index：

# Page1

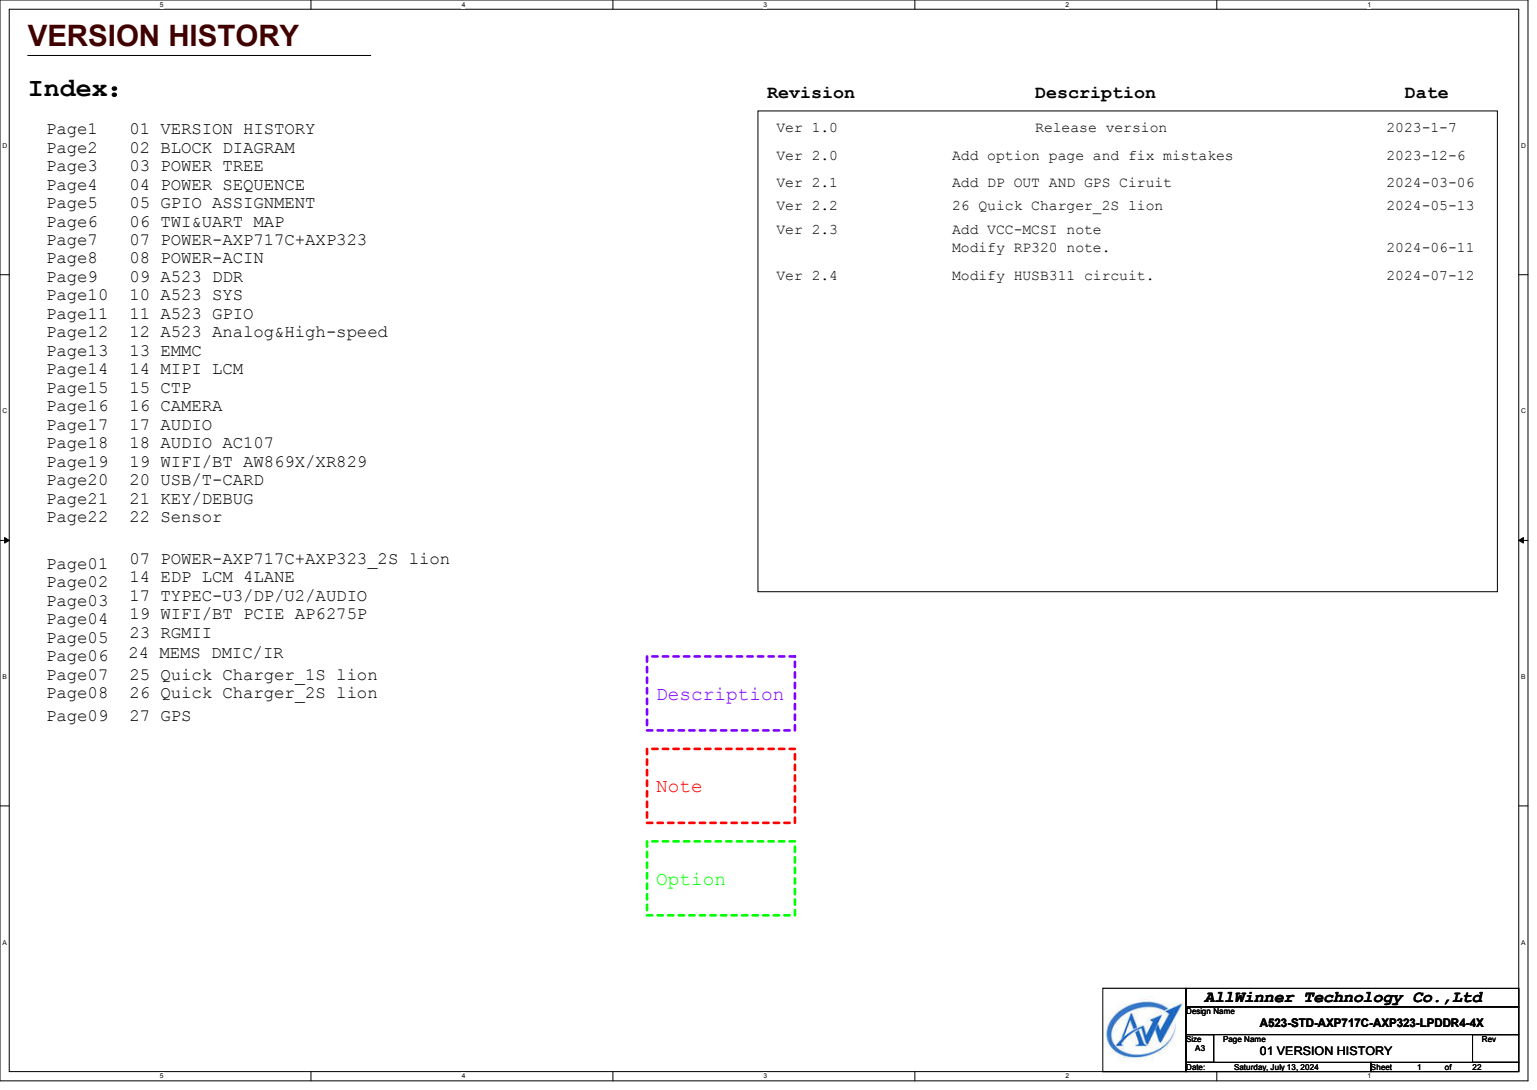
[picture p326: page 1]
VERSION HISTORY; Revision; Description; Date; 01 VERSION HISTORY; Ver 1.0; Release version; Page2 Page3 Page4 Page5 Page6 Page7 Page8 Page9 Page10; Page12; Page11; Page13 Page14 Page15; Page17; Page16; Page18 Page19 Page20 Page21 Page22; Note; Option; Ver 2.0; Add option page and fix mistakes; Page06 Page07 Page08; Page01; Page03 Page04 Page05; Page02; Ver 2.1; Add DP OUT AND GPS Ciruit; Page09; 27 GPS; Ver 2.2; 26 Quick Charger_2S lion; Ver 2.3; Add VCC-MCSI note; Modify RP320 note.; Ver 2.4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

02 BLOCK DIAGRAM
03 POWER TREE
04 POWER SEQUENCE
05 GPIO ASSIGNMENT
06 TWI&UART MAP
07 POWER-AXP717C+AXP323
08 POWER-ACIN
09 A523 DDR
10 A523 SYS
11 A523 GPIO
12 A523 Analog&High-speed
13 EMMC
14 MIPI LCM
15 CTP
16 CAMERA
17 AUDIO
18 AUDIO AC107
19 WIFI/BT AW869X/XR829
20 USB/T-CARD
21 KEY/DEBUG
22 Sensor

07 POWER-AXP717C+AXP323_2S lion
14 EDP LCM 4LANE
17 TYPEC-U3/DP/U2/AUDIO
19 WIFI/BT PCIE AP6275P
23 RGMII
24 MEMS DMIC/IR
25 Quick Charger_1S lion
26 Quick Charger_2S lion

AllWinner Technology Co.,Ltd

# BLOCK

## DDR

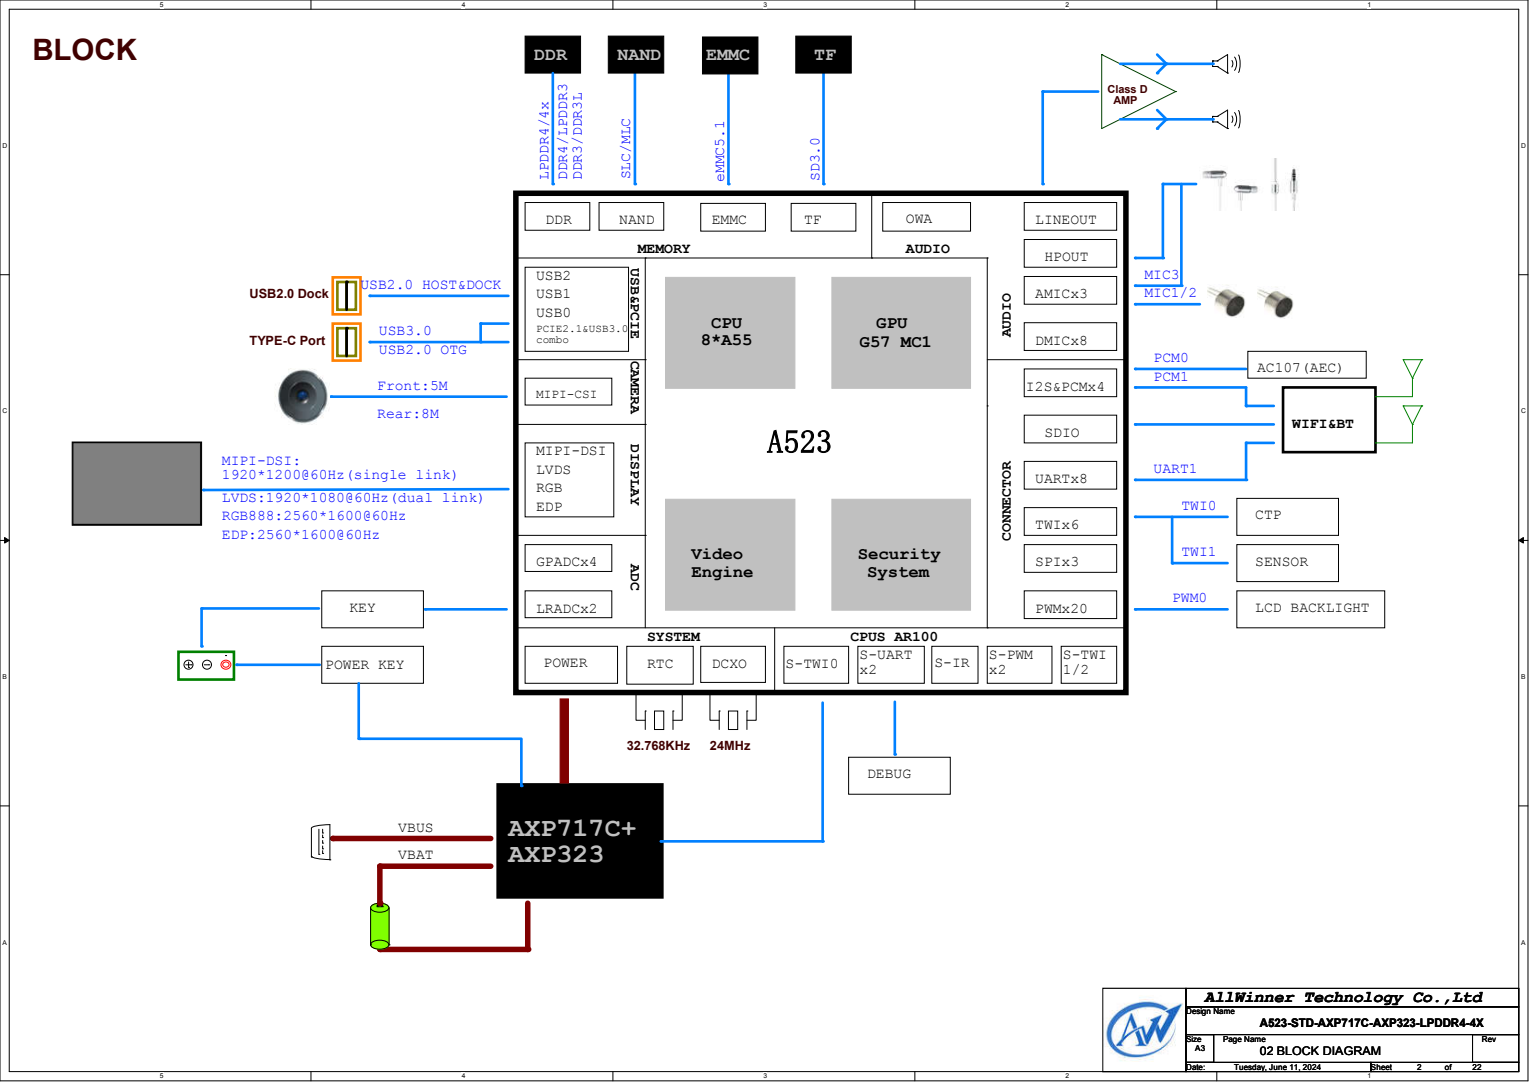
[picture p327: page 2]
CPU 8*A55; GPU G57 MC1; Video Engine; Security System; AXP717C+ AXP323; NAND; EMMC; GPADCx4; LVDS; MIPI-CSI; POWER; RTC; DCXO; SDIO; USB0; USB1; TWIx6; UARTx8; SPIx3; LRADCx2; SENSOR; DMICx8; HPOUT; AMICx3; LINEOUT; S-UART x2; S-PWM x2; I2S&PCMx4; S-TWI 1/2 S-IR; TYPE-C Port; USB2.0 OTG; DDR; Front:5M; MIPI-DSI: 1920*1200@60Hz(single link); LVDS:1920*1080@60Hz(dual link); RGB; MIPI-DSI; KEY; POWER KEY; VBAT; VBUS; 32.768KHz; 24MHz; MEMORY; AUDIO; CPUS AR100; CONNECTOR; DEBUG; Class D AMP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

ADC DISPLAY CAMERA USB&PCIE

AllWinner Technology Co.,Ltd

# DEFAULT POWER ON

# DEFAULT POWER OFF

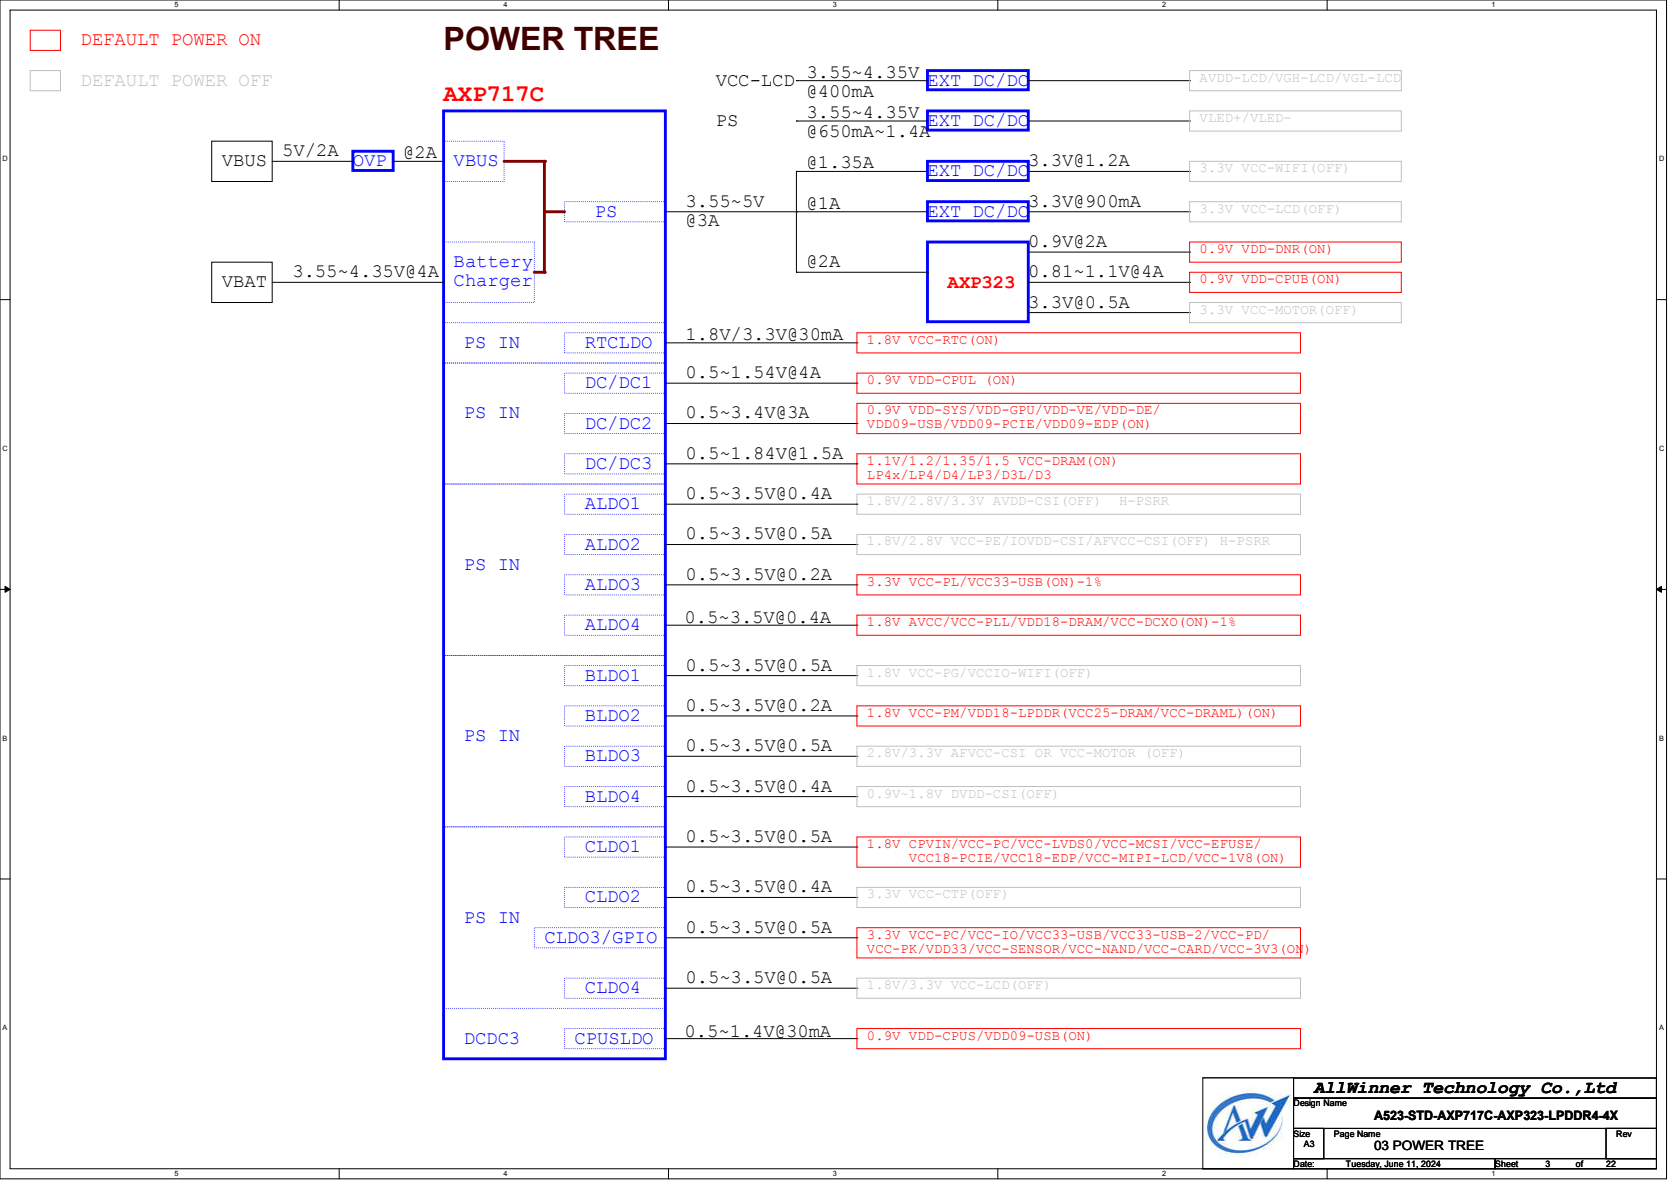
[picture p328: page 3]
VBUS; Battery Charger; ALDO1; ALDO3; ALDO2; BLDO2; BLDO3; CLDO1; BLDO4; CLDO2; CLDO3/GPIO; AXP717C; BLDO1; CPUSLDO; RTCLDO; 3.55~4.35V@4A VBAT; DCDC3; ALDO4; CLDO4; 1.8V/2.8V/3.3V AVDD-CSI(OFF); H-PSRR; 3.3V VCC-PC/VCC-IO/VCC33-USB/VCC33-USB-2/VCC-PD/; 3.3V VCC-WIFI(OFF); OVP 5V/2A; 3.3V@900mA EXT DC/DC; 3.3V VCC-LCD(OFF); VCC-LCD; VLED+/VLED-; POWER TREE; 3.3V VCC-MOTOR(OFF); 03 POWER TREE; Tuesday, June 11, 2024

EXT DC/DC

AVDD-LCD/VGH-LCD/VGL-LCD

0.9V VDD-DNR(ON) 0.9V@2A

0.9V VDD-CPUB(ON) 0.81~1.1V@4A AXP323

1.8V VCC-RTC(ON)

0.9V VDD-CPUL (ON)

0.9V VDD-SYS/VDD-GPU/VDD-VE/VDD-DE/
VDD09-USB/VDD09-PCIE/VDD09-EDP(ON)

1.1V/1.2/1.35/1.5 VCC-DRAM(ON)

1.8V/2.8V VCC-PE/IOVDD-CSI/AFVCC-CSI(OFF) H-PSRR

3.3V VCC-PL/VCC33-USB(ON)-1%

1.8V AVCC/VCC-PLL/VDD18-DRAM/VCC-DCXO(ON)-1%

1.8V VCC-PG/VCCIO-WIFI(OFF)

1.8V VCC-PM/VDD18-LPDDR(VCC25-DRAM/VCC-DRAML)(ON)

2.8V/3.3V AFVCC-CSI OR VCC-MOTOR (OFF) 0.5~3.5V@0.5A

0.9V~1.8V DVDD-CSI(OFF)

1.8V CPVIN/VCC-PC/VCC-LVDS0/VCC-MCSI/VCC-EFUSE/

VCC18-PCIE/VCC18-EDP/VCC-MIPI-LCD/VCC-1V8(ON)

3.3V VCC-CTP(OFF)

VCC-PK/VDD33/VCC-SENSOR/VCC-NAND/VCC-CARD/VCC-3V3(ON)

1.8V/3.3V VCC-LCD(OFF)

0.9V VDD-CPUS/VDD09-USB(ON)

AllWinner Technology Co.,Ltd

# POWER SEQUENCE

## 1.8V VCC-RTC(ON)

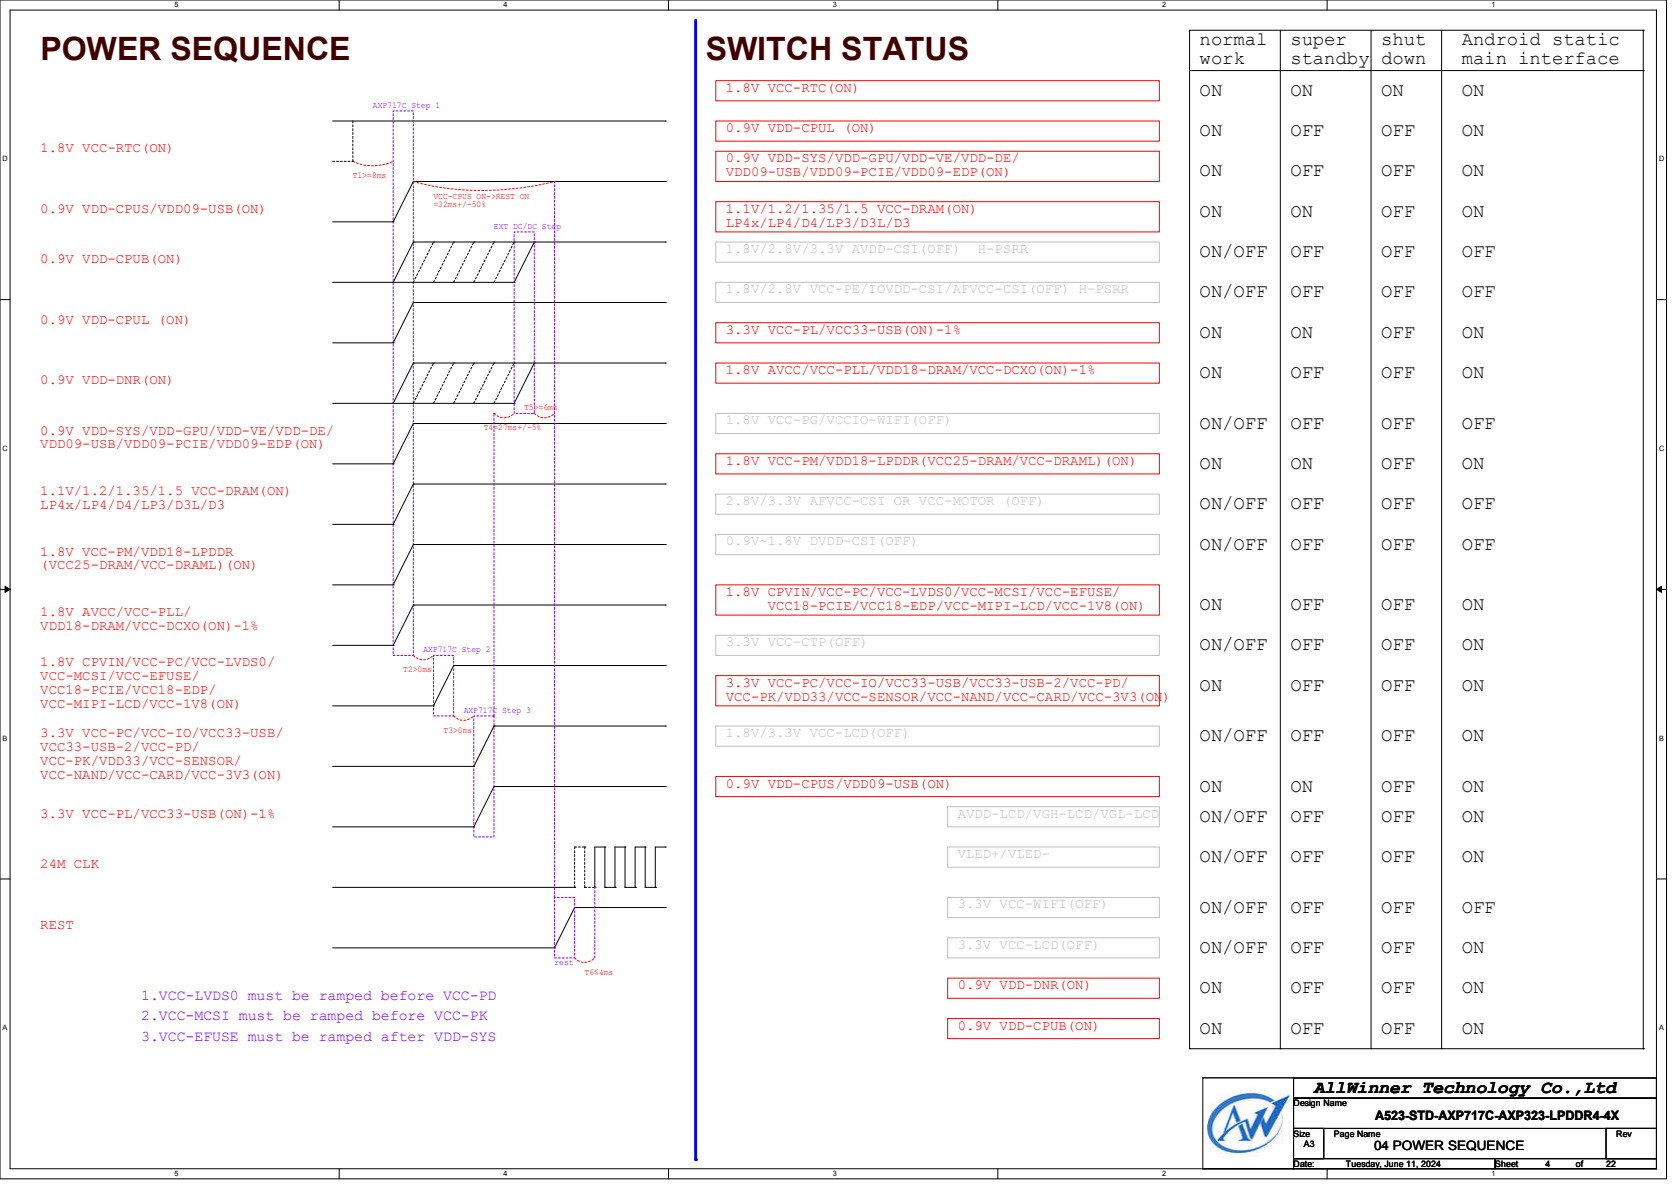
[picture p329: page 4]
REST; 24M CLK; AXP717C Step 1; AXP717C Step 2; AXP717C Step 3; rest; SWITCH STATUS; super; standby; normal work; shut down; Android static main interface; ON/OFF; OFF; VLED+/VLED-; 1.8V/2.8V/3.3V AVDD-CSI(OFF); H-PSRR; 04 POWER SEQUENCE; Tuesday, June 11, 2024

1.8V VCC-RTC(ON)

0.9V VDD-CPUL (ON)

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

VCC-CPUS ON->REST ON

0.9V VDD-CPUS/VDD09-USB(ON)

1.1V/1.2/1.35/1.5 VCC-DRAM(ON)

EXT DC/DC Step

0.9V VDD-CPUB(ON)

1.8V/2.8V VCC-PE/IOVDD-CSI/AFVCC-CSI(OFF) H-PSRR

3.3V VCC-PL/VCC33-USB(ON)-1%

0.9V VDD-DNR(ON)

1.8V AVCC/VCC-PLL/VDD18-DRAM/VCC-DCXO(ON)-1%

1.8V VCC-PG/VCCIO-WIFI(OFF)

1.8V VCC-PM/VDD18-LPDDR(VCC25-DRAM/VCC-DRAML)(ON)

2.8V/3.3V AFVCC-CSI OR VCC-MOTOR (OFF)

1.8V VCC-PM/VDD18-LPDDR
(VCC25-DRAM/VCC-DRAML)(ON)

0.9V~1.8V DVDD-CSI(OFF)

1.8V CPVIN/VCC-PC/VCC-LVDS0/VCC-MCSI/VCC-EFUSE/

1.8V AVCC/VCC-PLL/
VDD18-DRAM/VCC-DCXO(ON)-1%

VCC18-PCIE/VCC18-EDP/VCC-MIPI-LCD/VCC-1V8(ON)

3.3V VCC-CTP(OFF)

1.8V CPVIN/VCC-PC/VCC-LVDS0/
VCC-MCSI/VCC-EFUSE/
VCC18-PCIE/VCC18-EDP/
VCC-MIPI-LCD/VCC-1V8(ON)

3.3V VCC-PC/VCC-IO/VCC33-USB/VCC33-USB-2/VCC-PD/
VCC-PK/VDD33/VCC-SENSOR/VCC-NAND/VCC-CARD/VCC-3V3(ON)

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

1.8V/3.3V VCC-LCD(OFF)

AVDD-LCD/VGH-LCD/VGL-LCD

3.3V VCC-WIFI(OFF)

3.3V VCC-LCD(OFF)

1.VCC-LVDS0 must be ramped before VCC-PD
2.VCC-MCSI must be ramped before VCC-PK
3.VCC-EFUSE must be ramped after VDD-SYS

AllWinner Technology Co.,Ltd

# GPIO ASSIGNMENT

PIN | Define | CFG | Function

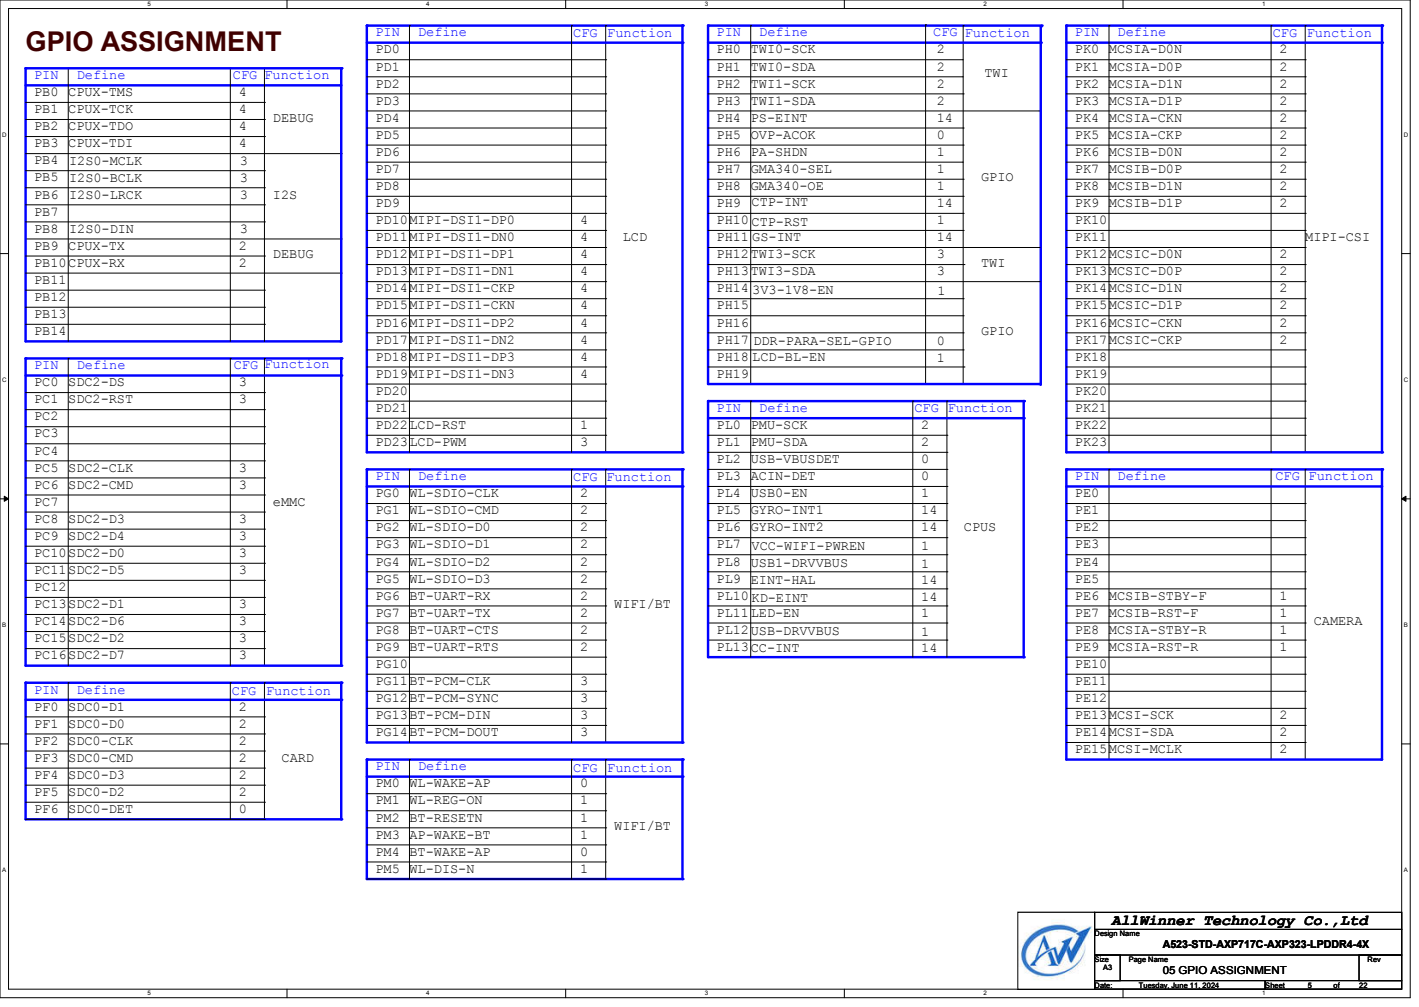
[picture p330: page 5]
CPUX-RX; PIN; Define; CFG; Function; MCSIA-D0P; MCSIA-D0N; MIPI-CSI; MCSIA-D1P; MCSIA-D1N; MCSIA-CKP; MCSIA-CKN; MCSIB-D0N; MCSIB-D0P; MCSIB-D1N; MCSIB-D1P; MCSIC-D0P; MCSIC-D0N; MCSIC-D1P; MCSIC-D1N; MCSIC-CKP; MCSIC-CKN; MIPI-DSI1-DN0; MIPI-DSI1-DP0; LCD; LCD-RST; LCD-PWM; MIPI-DSI1-DP1; MIPI-DSI1-DN1; MIPI-DSI1-CKP; MIPI-DSI1-CKN; MIPI-DSI1-DN2; MIPI-DSI1-DP2; MIPI-DSI1-DP3; MIPI-DSI1-DN3; TWI; GPIO; CTP-RST; CTP-INT; GS-INT; PA-SHDN; TWI0-SDA; TWI1-SCK; TWI0-SCK; TWI1-SDA; PS-EINT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

PB0 | CPUX-TMS | 4 | DEBUG
PB1 | CPUX-TCK | 4
PB2 | CPUX-TDO | 4
PB3 | CPUX-TDI | 4
PB4 | I2S0-MCLK | 3 | I2S
PB5 | I2S0-BCLK | 3
PB6 | I2S0-LRCK | 3
PB7
PB8 | I2S0-DIN | 3
PB9 | CPUX-TX | 2 | DEBUG

PB11
PB12
PB13
PB14

DDR-PARA-SEL-GPIO

PIN | Define | CFG | Function
PC0 | SDC2-DS | 3 | eMMC
PC1 | SDC2-RST | 3
PC2
PC3
PC4
PC5 | SDC2-CLK | 3
PC6 | SDC2-CMD | 3
PC7
PC8 | SDC2-D3 | 3
PC9 | SDC2-D4 | 3
PC10 | SDC2-D0 | 3
PC11 | SDC2-D5 | 3
PC12
PC13 | SDC2-D1 | 3
PC14 | SDC2-D6 | 3
PC15 | SDC2-D2 | 3
PC16 | SDC2-D7 | 3

PMU-SCK
PMU-SDA
USB-VBUSDET
ACIN-DET
USB0-EN
GYRO-INT1
GYRO-INT2
VCC-WIFI-PWREN
USB1-DRVVBUS
EINT-HAL
KD-EINT
LED-EN

WL-SDIO-CLK
WL-SDIO-CMD
WL-SDIO-D0
WL-SDIO-D1
WL-SDIO-D2
WL-SDIO-D3
BT-UART-RX
BT-UART-TX
BT-UART-CTS
BT-UART-RTS

PG10 | | | | | PE10
PG11 | BT-PCM-CLK | 3 | | | PE11
PG12 | BT-PCM-SYNC | 3 | | | PE12
PG13 | BT-PCM-DIN | 3 | | | PE13 | MCSI-SCK | 2
PG14 | BT-PCM-DOUT | 3 | | | PE14 | MCSI-SDA | 2

PF0 | SDC0-D1 | 2 | CARD
PF1 | SDC0-D0 | 2
PF2 | SDC0-CLK | 2
PF3 | SDC0-CMD | 2
PF4 | SDC0-D3 | 2
PF5 | SDC0-D2 | 2
PF6 | SDC0-DET | 0

PE15 | MCSI-MCLK | 2

PIN | Define | CFG | Function | AllWinner Technology Co.,Ltd AllWinner Technology Co.,Ltd AllWinner Technology Co.,Ltd 05 GPIO ASSIGNMENT 05 GPIO ASSIGNMENT 05 GPIO ASSIGNMENT Tuesday, June 11, 2024 Tuesday, June 11, 2024 Tuesday, June 11, 2024 5 5 5 22 22 22
PM0 | WL-WAKE-AP | 0 | WIFI/BT
PM1 | WL-REG-ON | 1
PM2 | BT-RESETN | 1
PM3 | AP-WAKE-BT | 1
PM4 | BT-WAKE-AP | 0
PM5 | WL-DIS-N | 1

# TWI1

PD

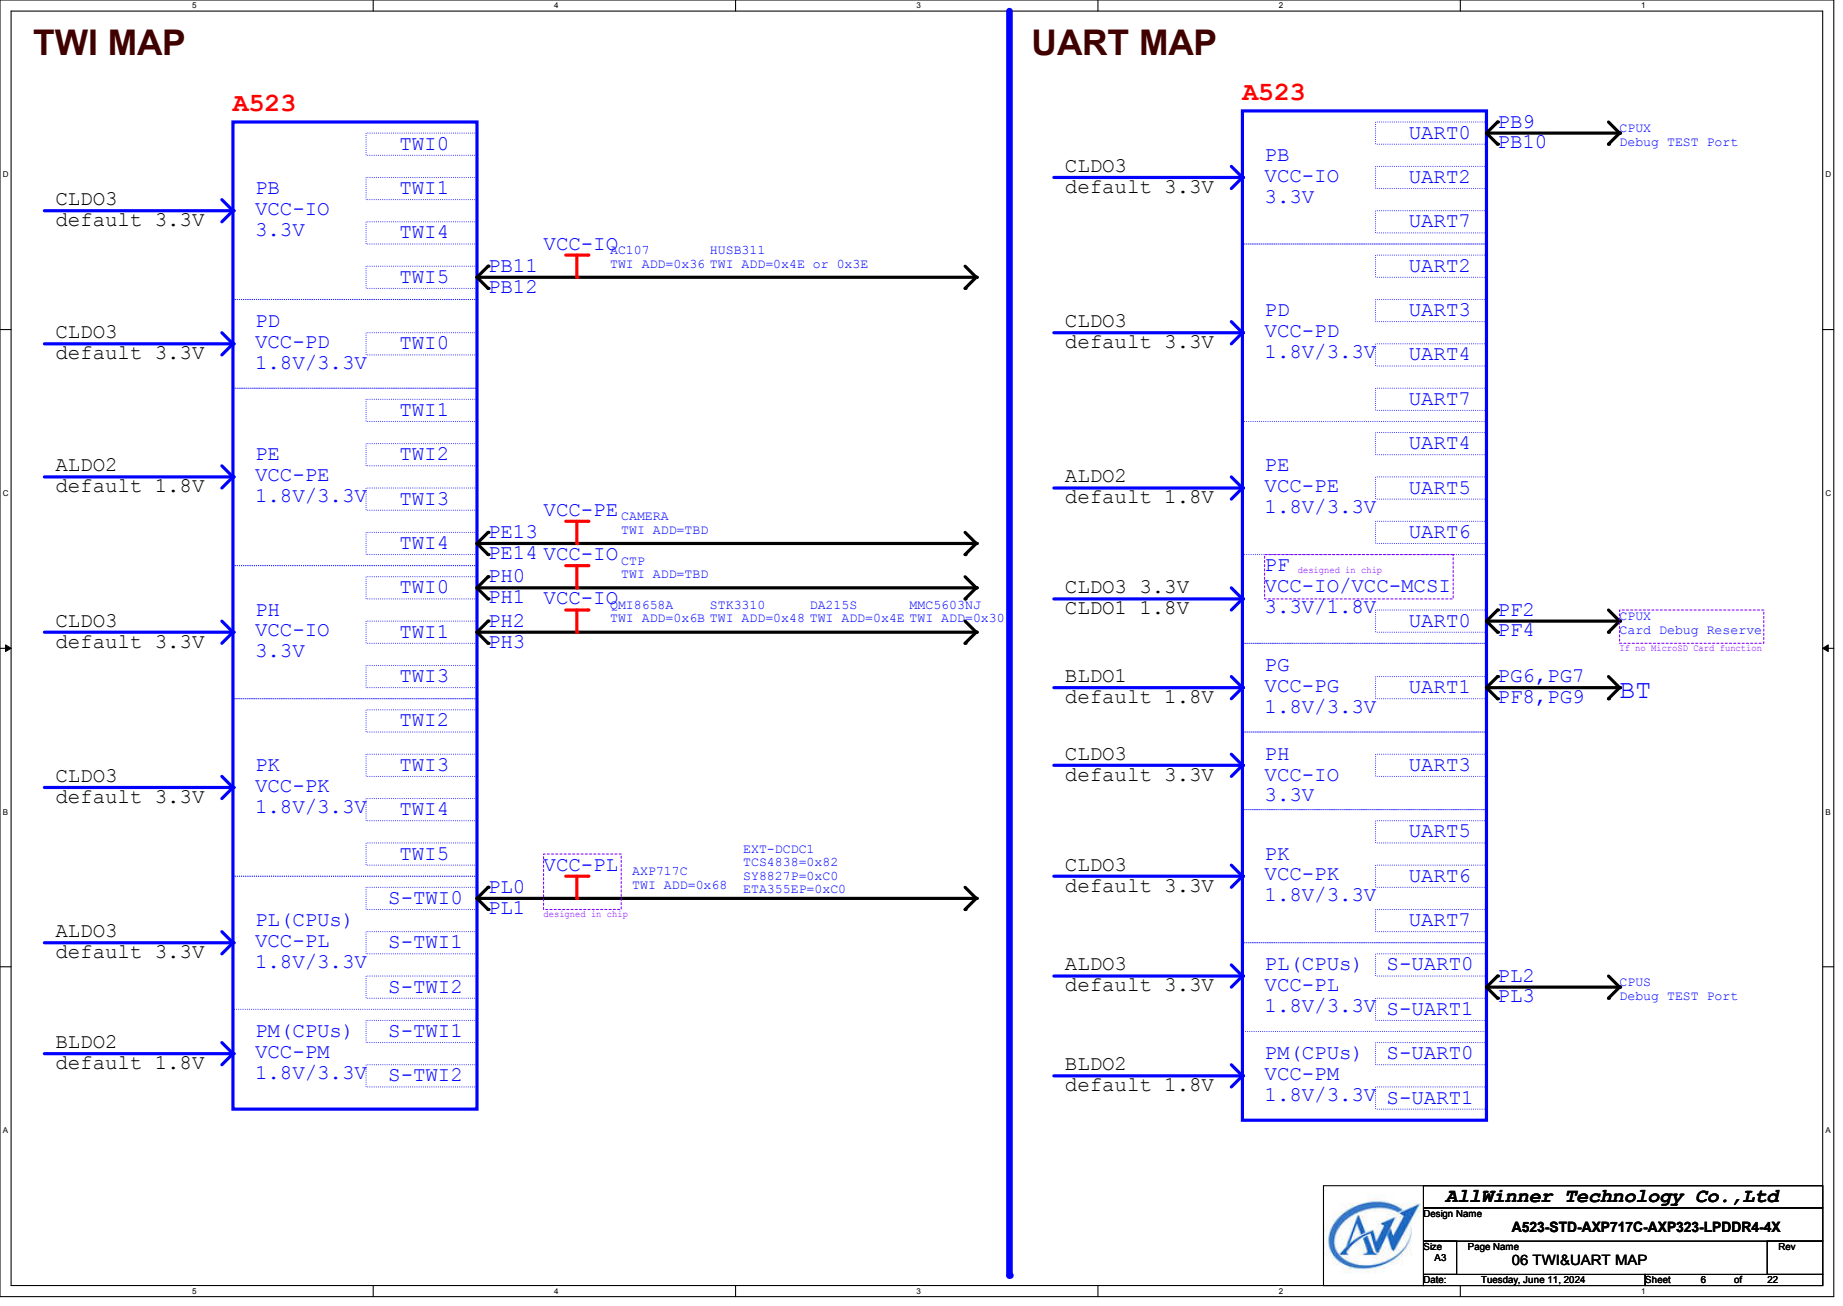
[picture p331: page 6]
VCC-PD 1.8V/3.3V; PH VCC-IO 3.3V; TWI1; TWI3; TWI2; TWI0; TWI4; TWI MAP; CLDO3; default 3.3V; TWI5; PB VCC-IO 3.3V; TWI0 CLDO3 default 3.3V; PE VCC-PE 1.8V/3.3V; ALDO2 default 1.8V; CLDO3 default 3.3V; PK VCC-PK 1.8V/3.3V; S-TWI1; S-TWI2; S-TWI0; PL(CPUs) VCC-PL 1.8V/3.3V; PM(CPUs) VCC-PM 1.8V/3.3V; ALDO3 default 3.3V; BLDO2 default 1.8V; PE13 PE14 PH0 PH1 VCC-IO PH2 PH3; VCC-PL; AXP717C TWI ADD=0x68; EXT-DCDC1 TCS4838=0x82 SY8827P=0xC0 ETA355EP=0xC0; UART2; PD VCC-PD 1.8V/3.3V; UART7; UART5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

Debug TEST Port

HUSB311
TWI ADD=0x4E or 0x3E

CAMERA
TWI ADD=TBD

CTP

VCC-IO/VCC-MCSI

designed in chip

Card Debug Reserve

If no MicroSD Card function

AllWinner Technology Co.,Ltd

06 TWI&UART MAP

# PMIC BAT

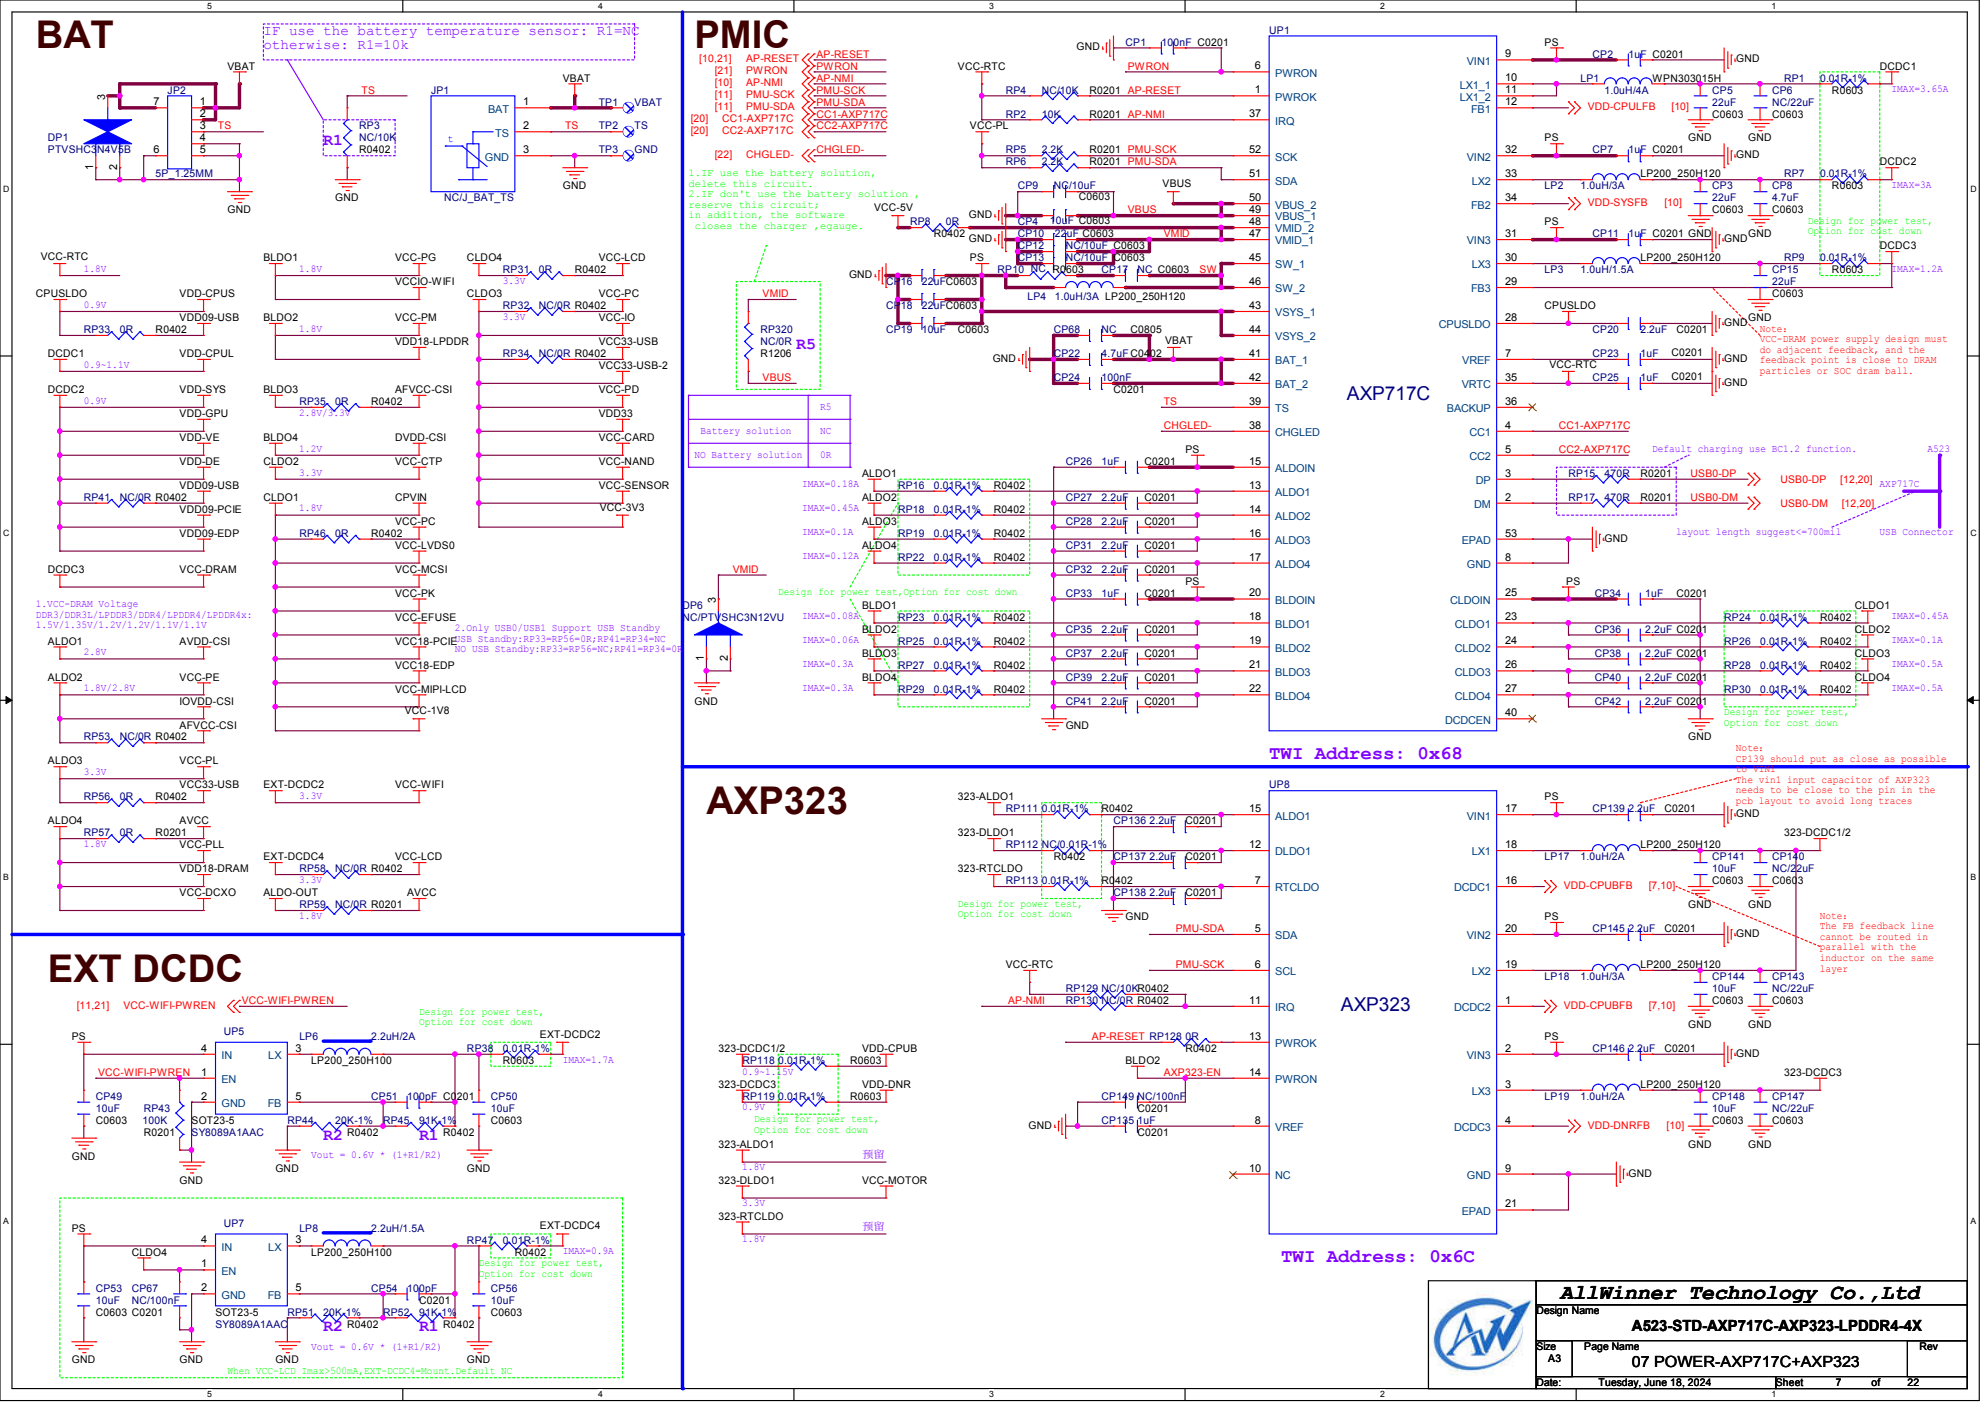
[picture p332: page 7]

IF use the battery temperature sensor: R1=NC
otherwise: R1=10k

1.IF use the battery solution,
delete this circuit.
2.IF don't use the battery solution ,
reserve this circuit;
in addition, the software
closes the charger ,egauge.

Design for power test,
Option for cost down

Note：
VCC-DRAM power supply design must
do adjacent feedback, and the
feedback point is close to DRAM
particles or SOC dram ball.

Default charging use BC1.2 function.

Design for power test,Option for cost down

2.Only USB0/USB1 Support USB Standby
USB Standby:RP33=RP56=0R;RP41=RP34=NC
NO USB Standby:RP33=RP56=NC;RP41=RP34=0R

CP139 should put as close as possible
to VIN1
The vin1 input capacitor of AXP323
needs to be close to the pin in the
pcb layout to avoid long traces
GND

The FB feedback line
cannot be routed in
parallel with the
inductor on the same
layer

AllWinner Technology Co.,Ltd

When VCC-LCD Imax>500mA,EXT-DCDC4=Mount.Default NC

# PMIC BAT

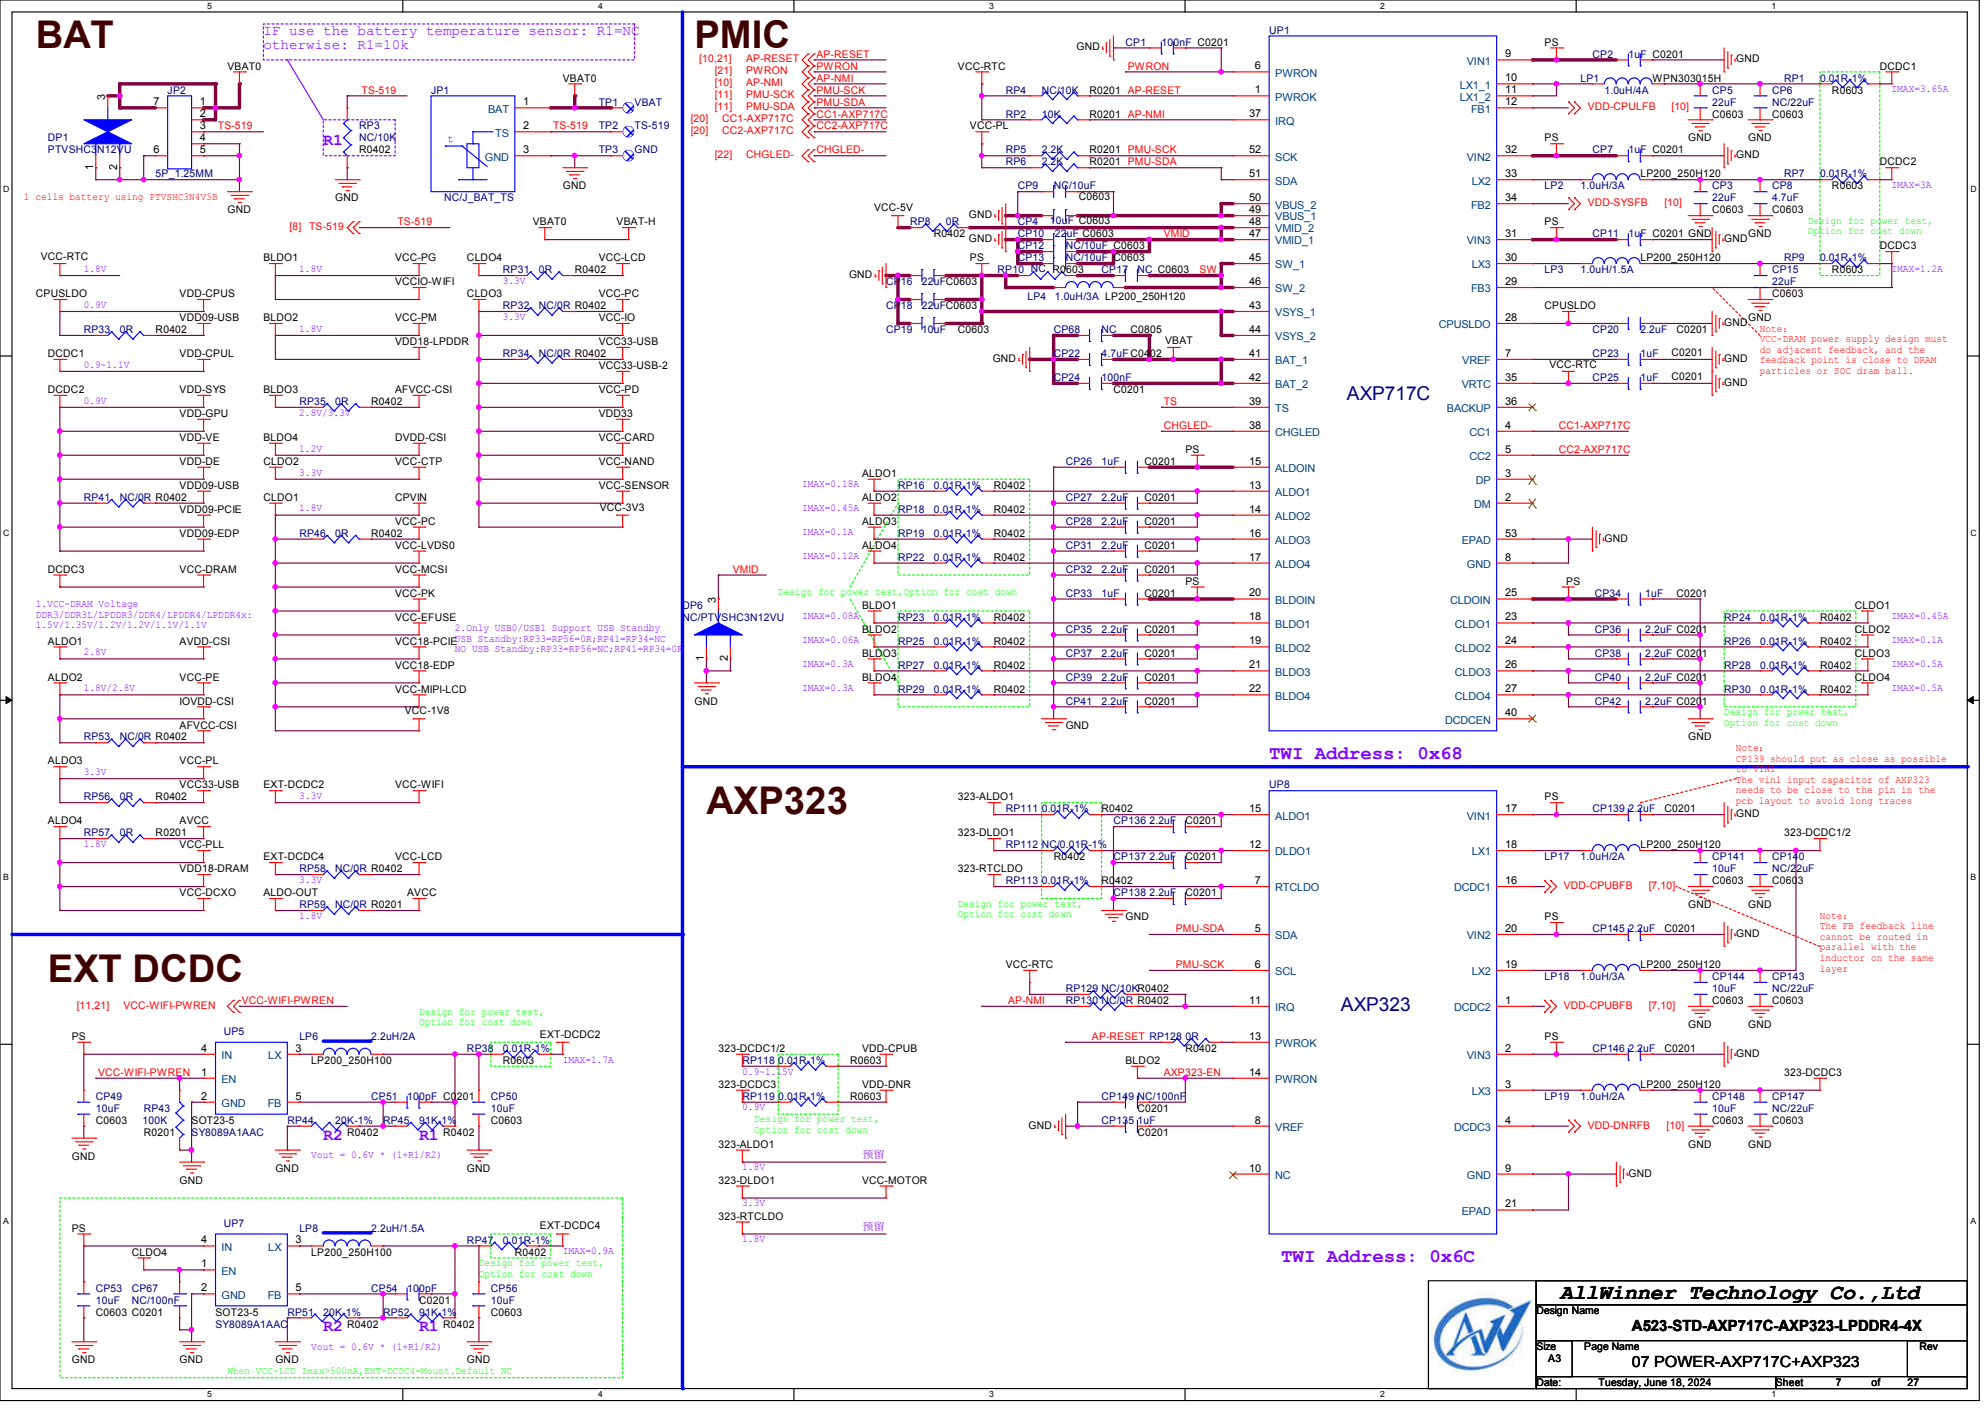
[picture p333: page 8]

IF use the battery temperature sensor: R1=NC
otherwise: R1=10k

Design for power test,
Option for cost down

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

Design for power test,Option for cost down

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

The FB feedback line
cannot be routed in
parallel with the
inductor on the same
layer

AllWinner Technology Co.,Ltd

When VCC-LCD Imax>500mA,EXT-DCDC4=Mount.Default NC

D

Circuit | ACIN | NOT ACIN,Support OVP

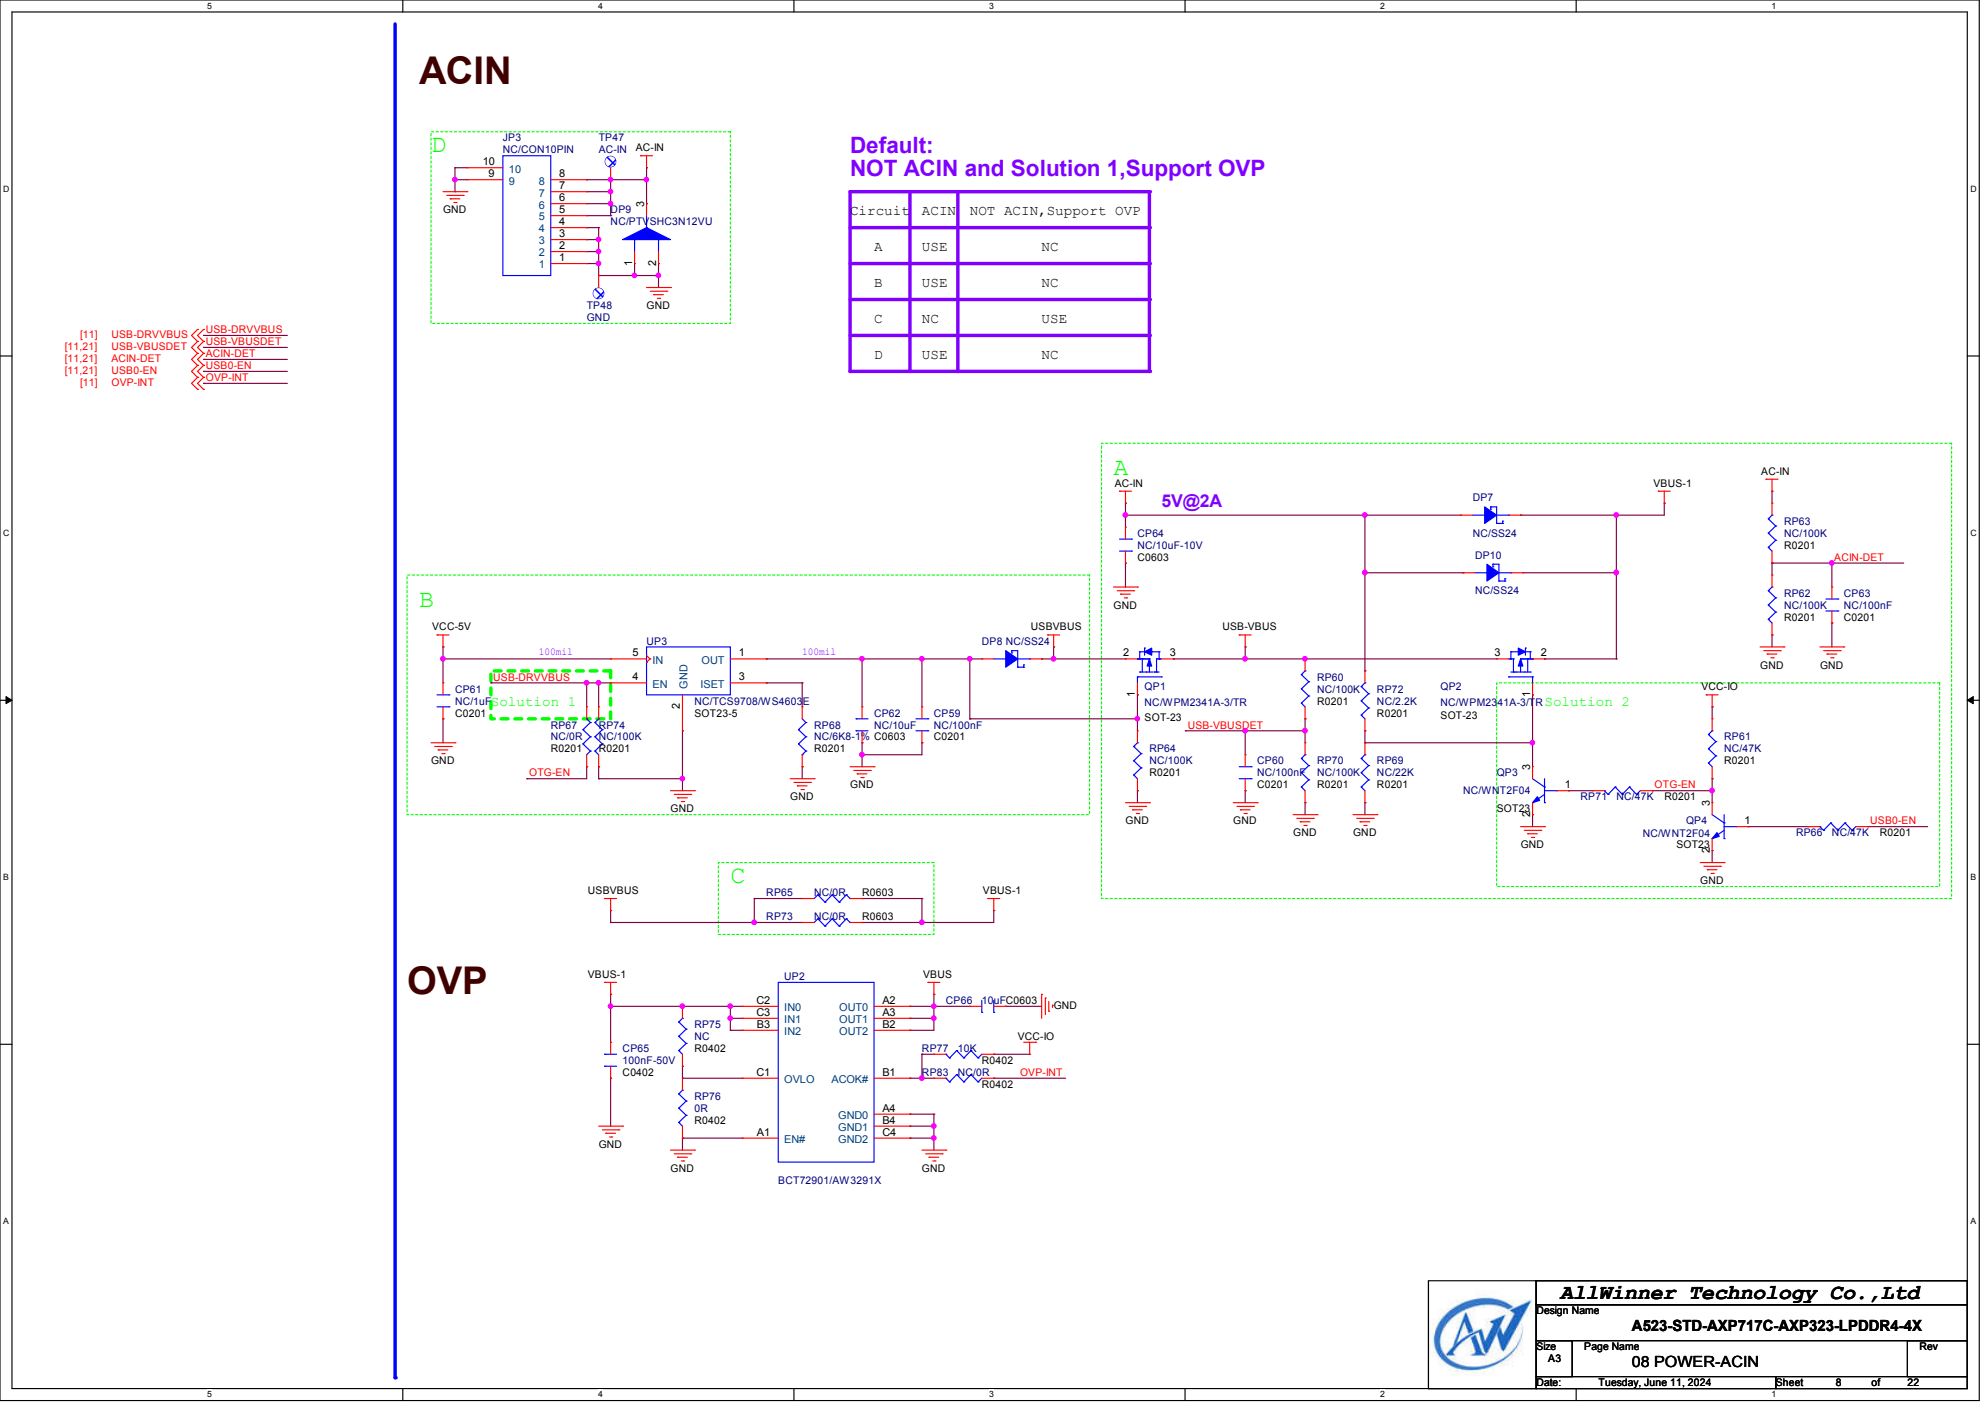
[picture p334: page 9]

Default:
NOT ACIN and Solution 1,Support OVP

A | USE | NC

B | USE | NC

C | NC | USE

D | USE | NC

AllWinner Technology Co.,Ltd

# LPDDR4-4X

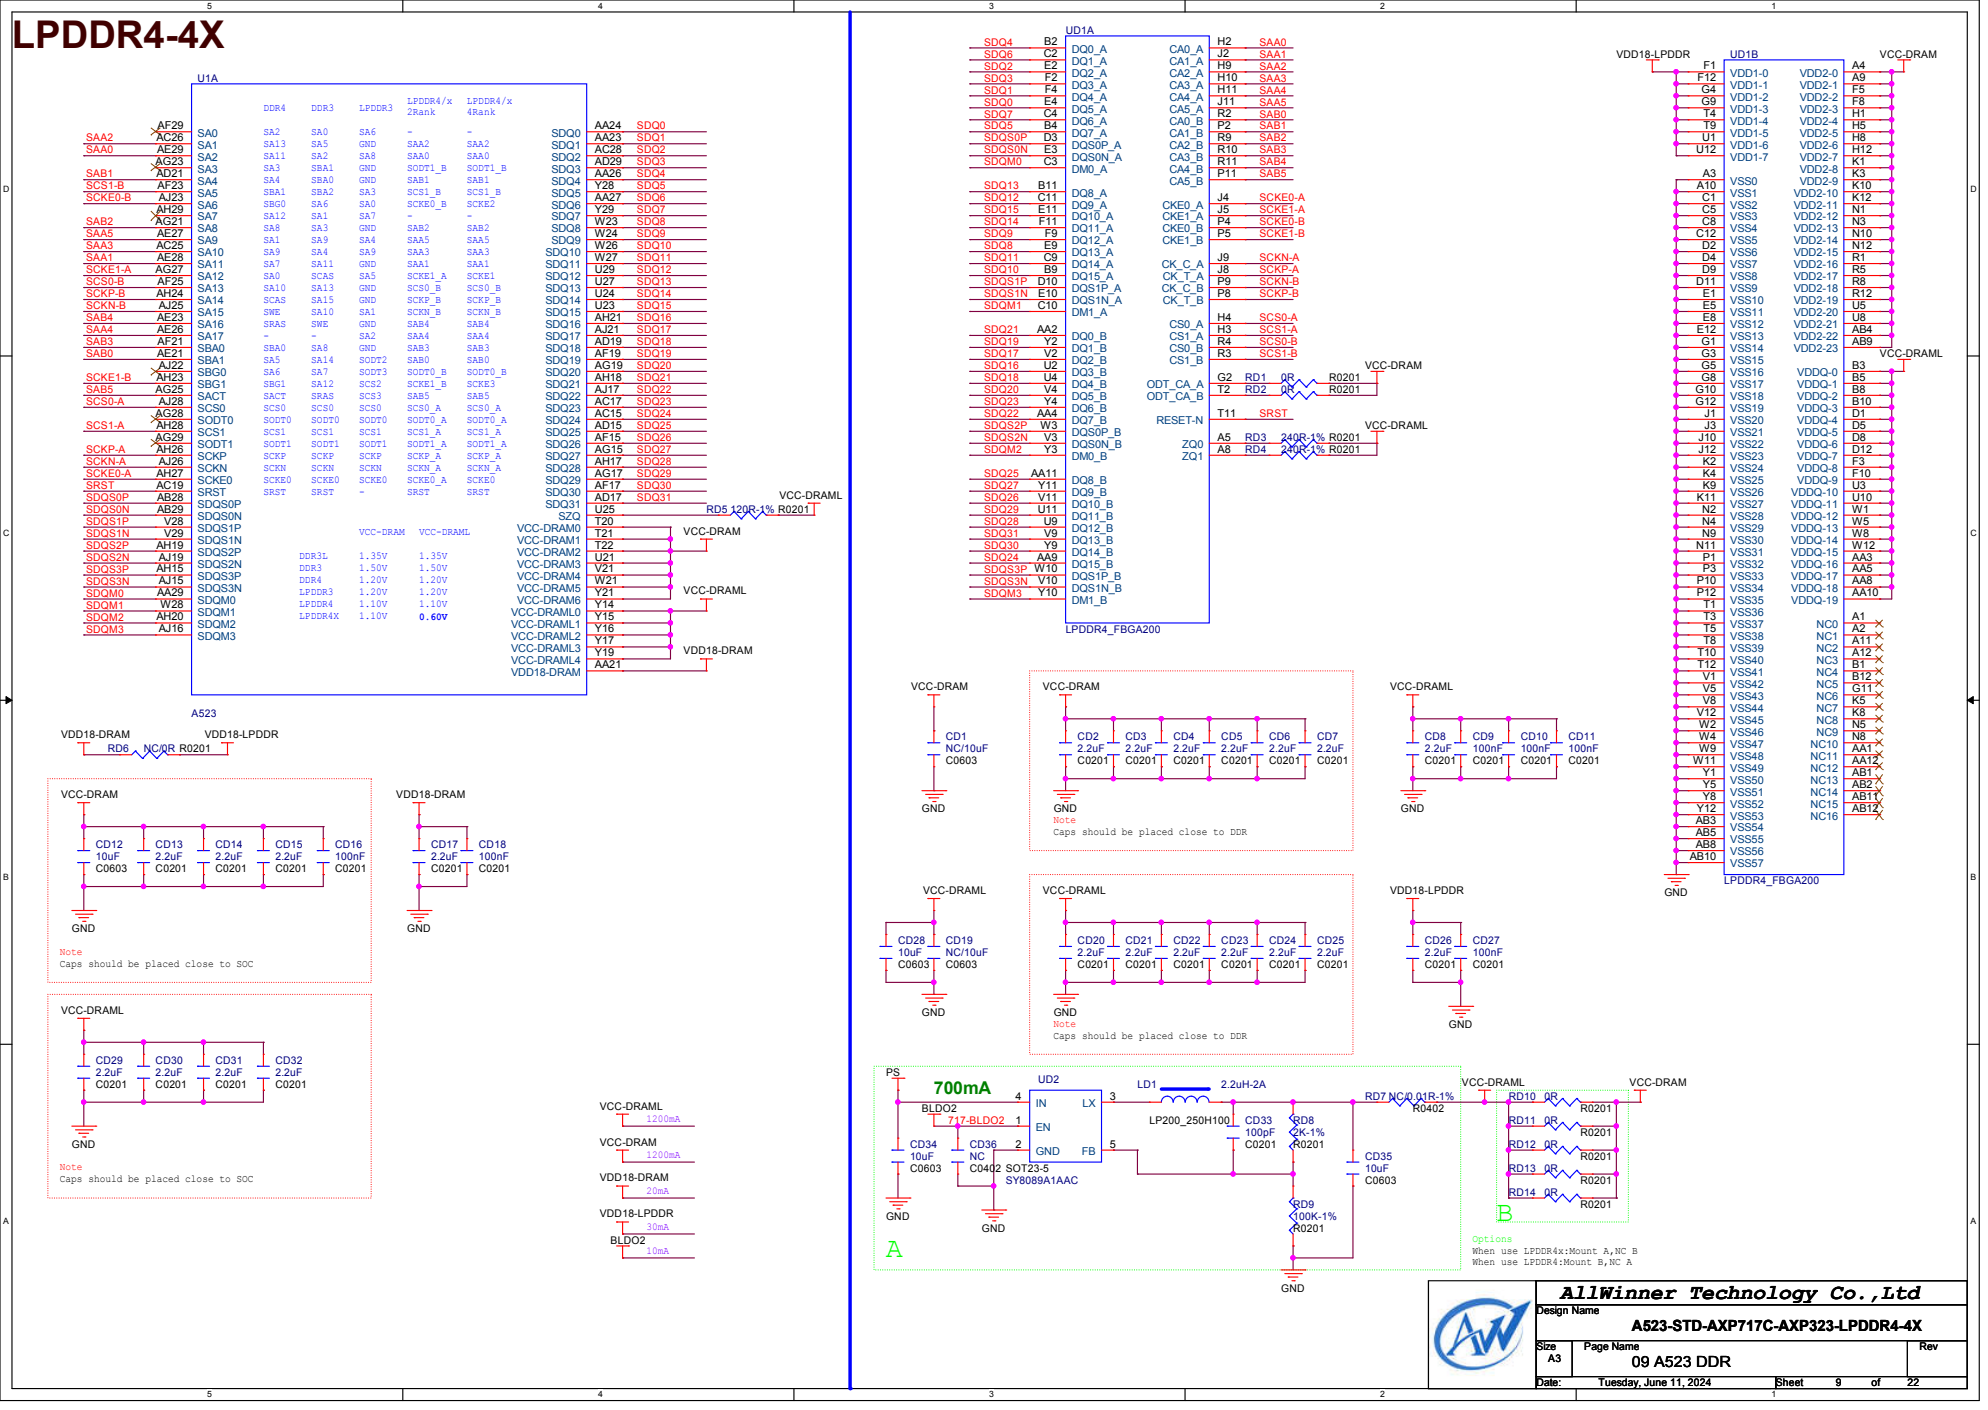
[picture p335: page 10]

GND
Note
Caps should be placed close to DDR

Caps should be placed close to SOC

When use LPDDR4:Mount B,NC A

AllWinner Technology Co.,Ltd

SYS | CORE POWER

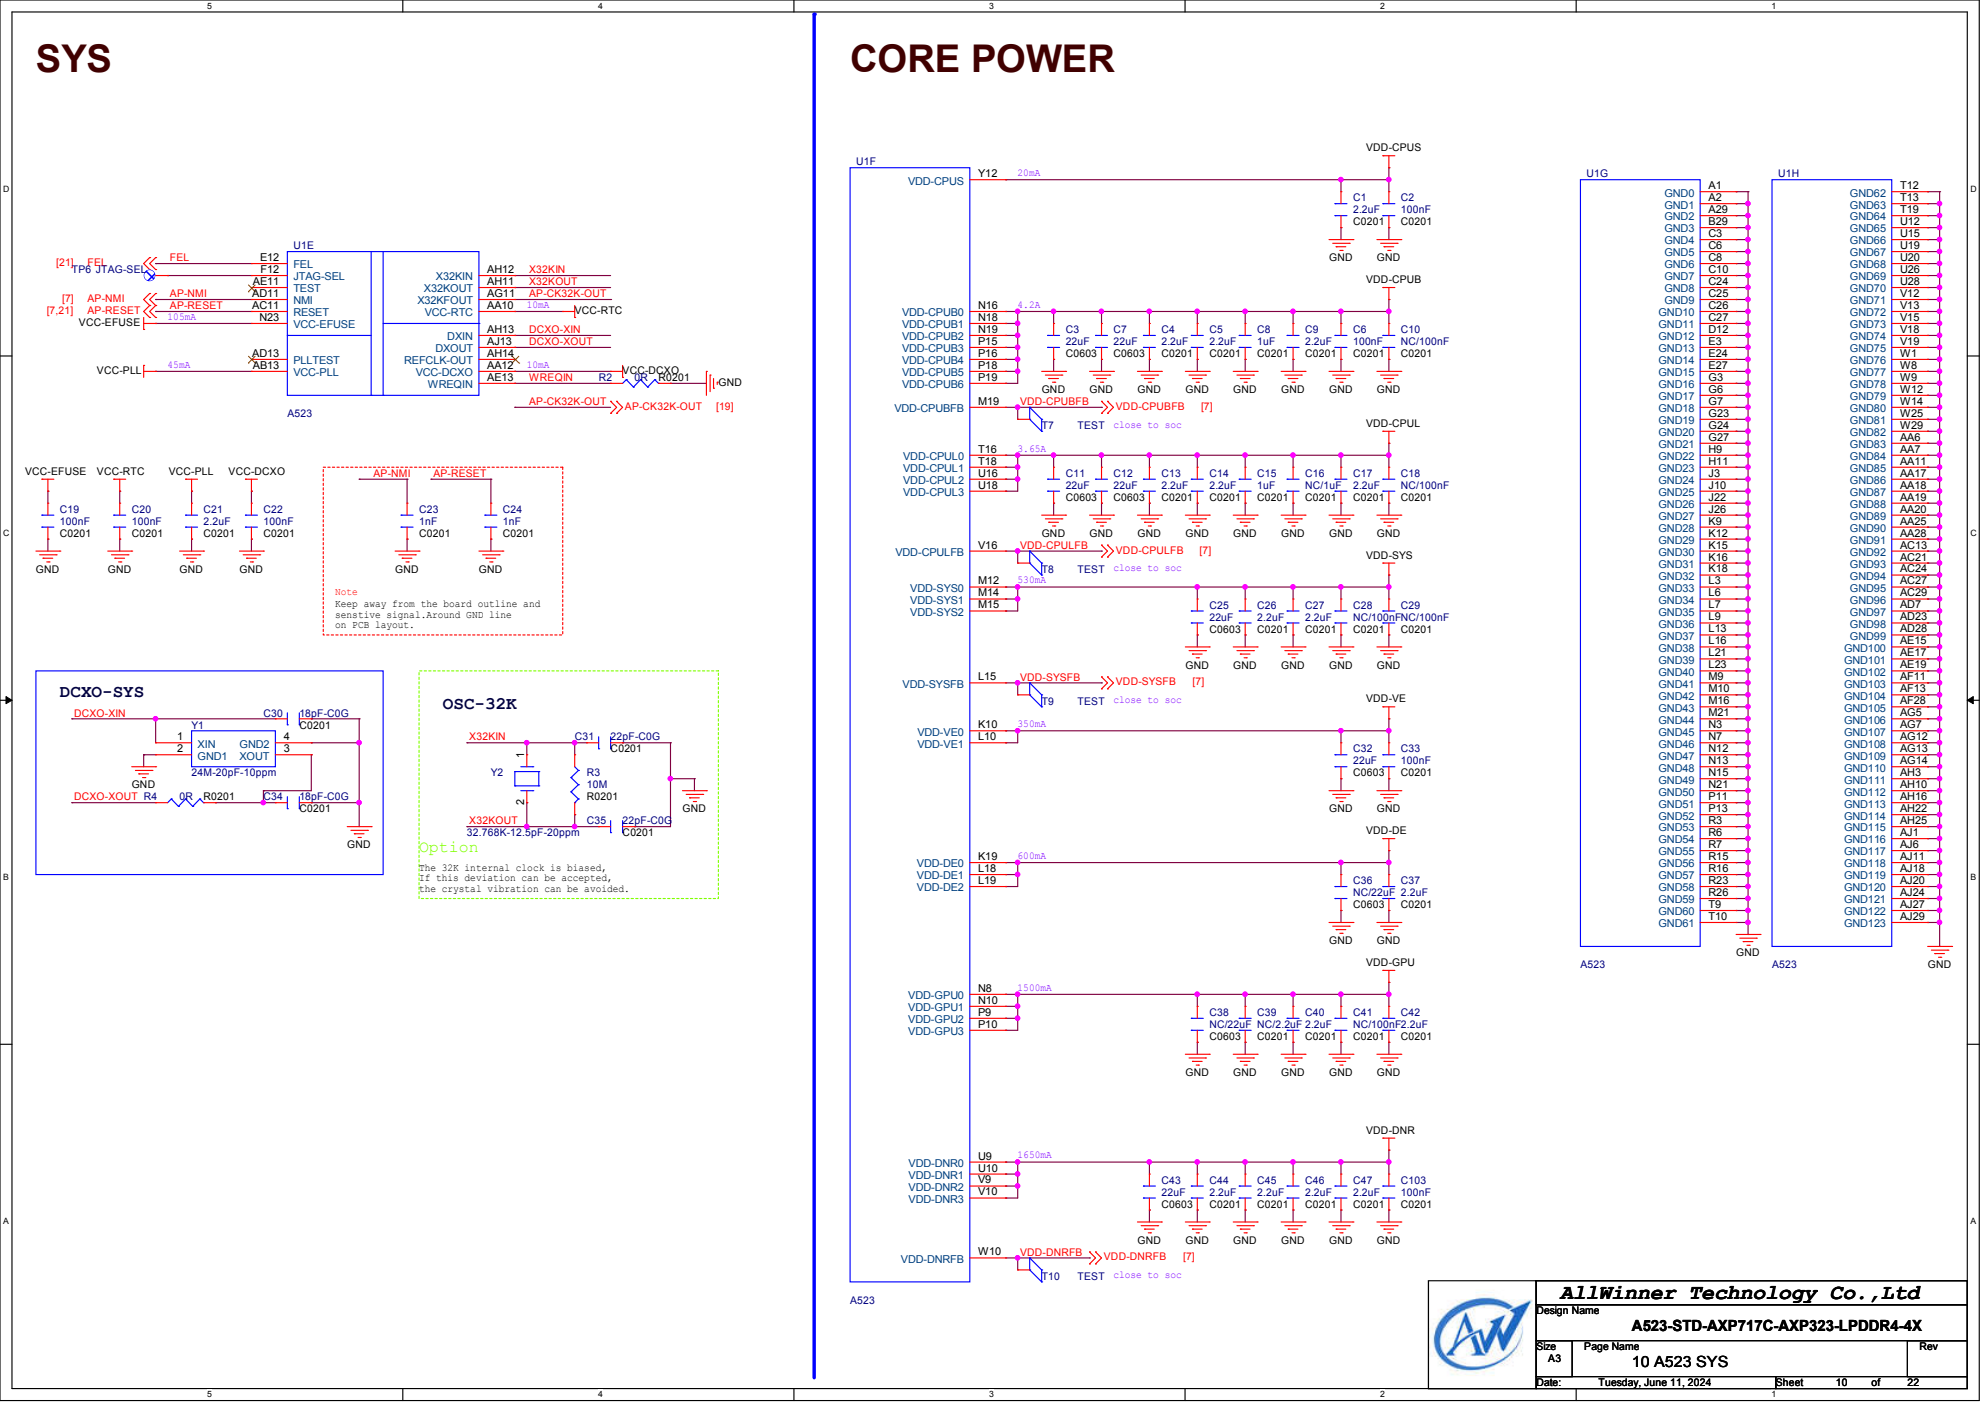
[picture p336: page 11]

Note
Keep away from the board outline and
senstive signal.Around GND line
on PCB layout.

The 32K internal clock is biased,
If this deviation can be accepted,
the crystal vibration can be avoided.

AllWinner Technology Co.,Ltd

# GPIO

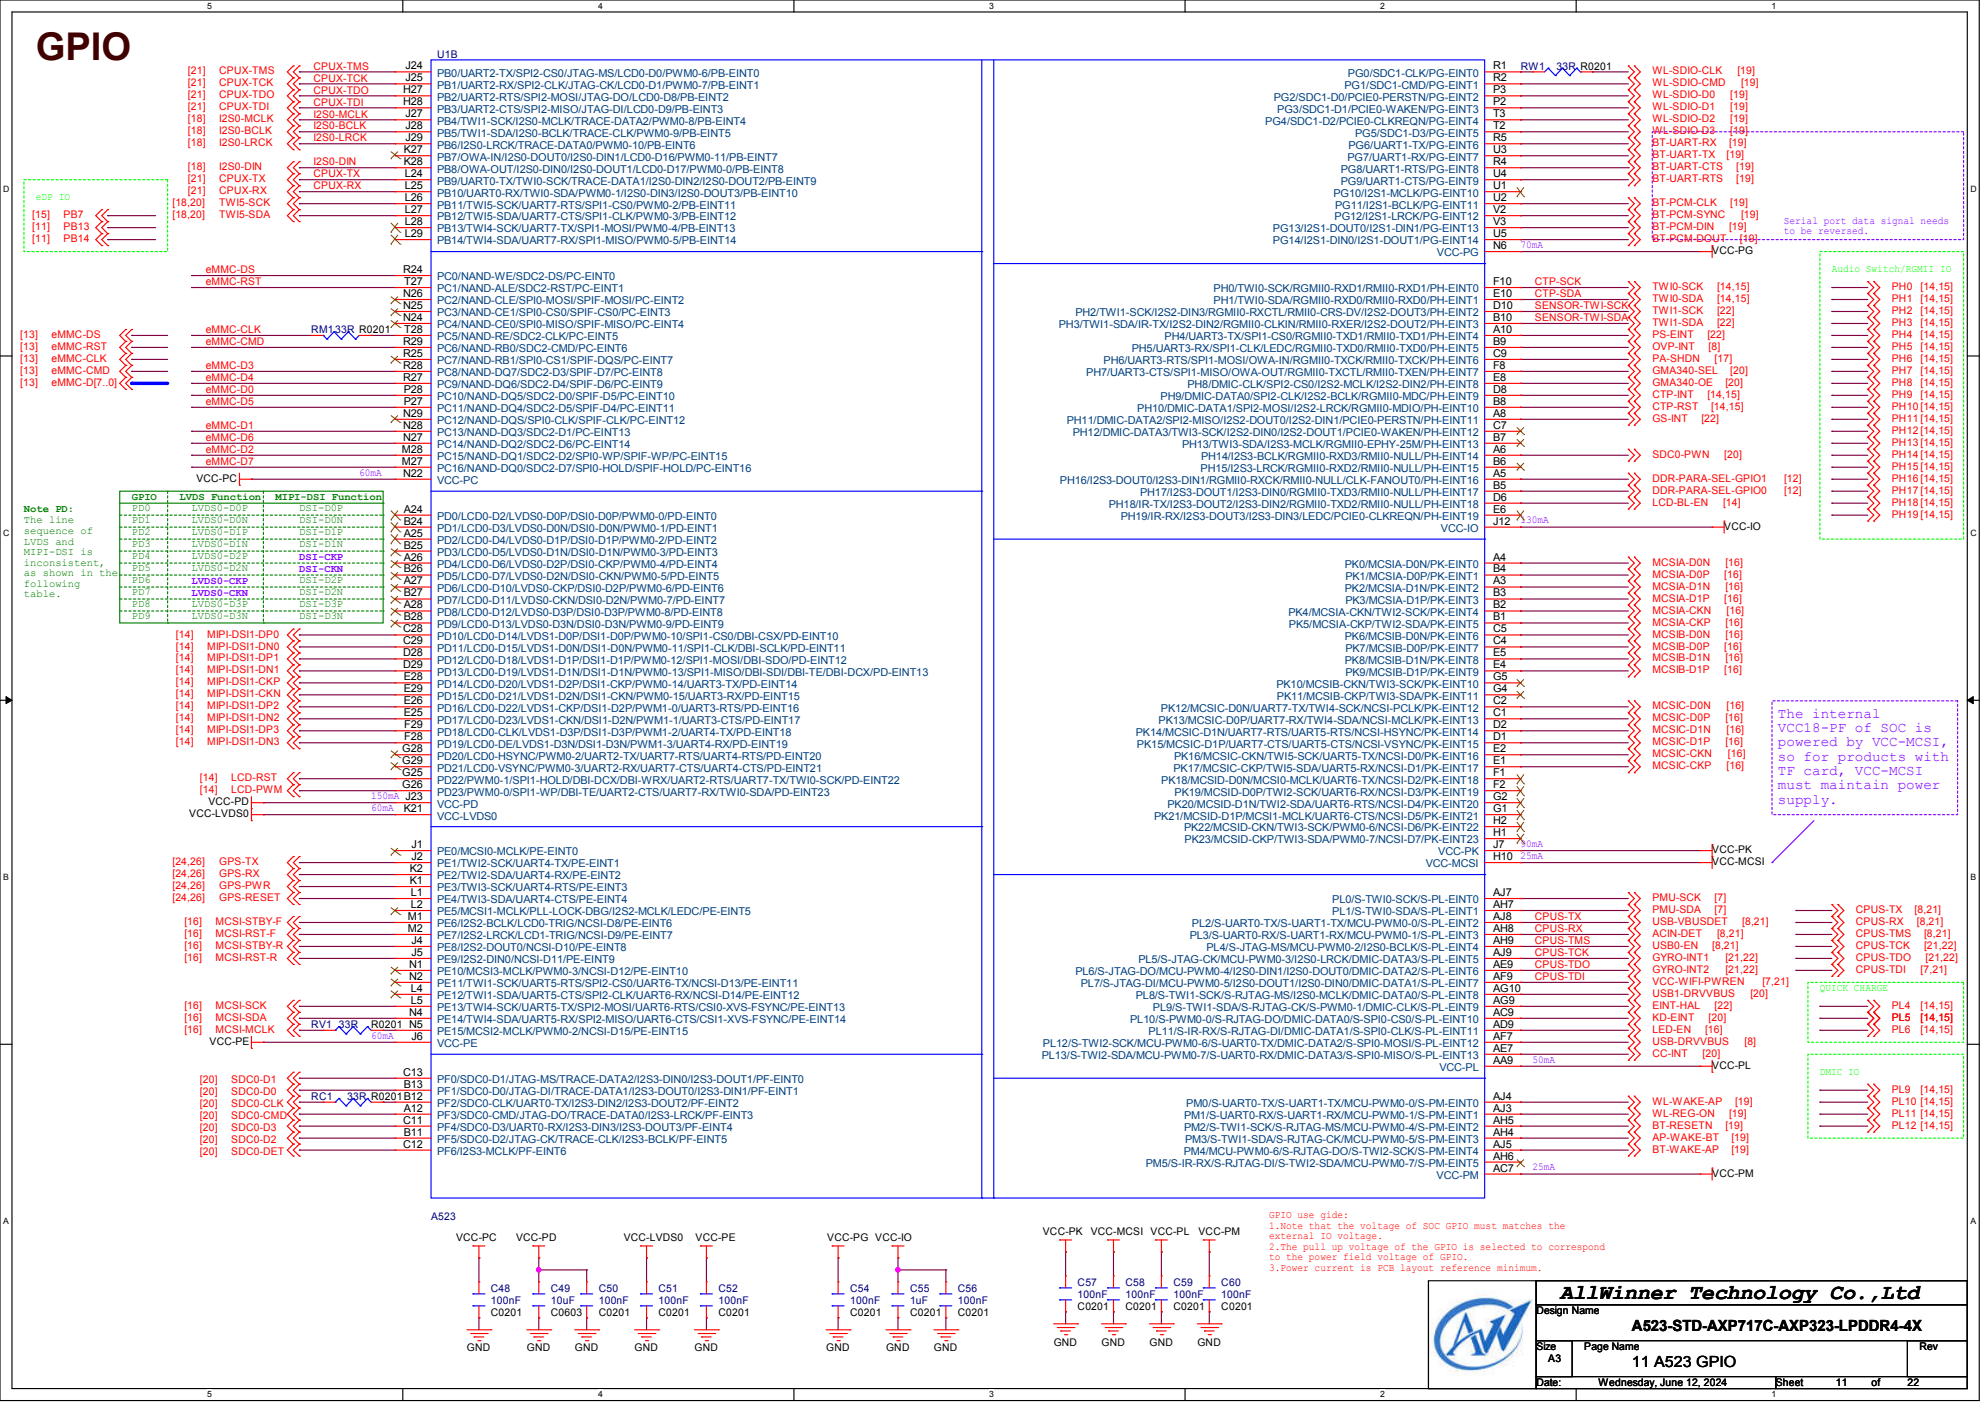
[picture p337: page 12]

PB0/UART2-TX/SPI2-CS0/JTAG-MS/LCD0-D0/PWM0-6/PB-EINT0 J24
PB1/UART2-RX/SPI2-CLK/JTAG-CK/LCD0-D1/PWM0-7/PB-EINT1 J25
PB2/UART2-RTS/SPI2-MOSI/JTAG-DO/LCD0-D8/PB-EINT2 H27
PB3/UART2-CTS/SPI2-MISO/JTAG-DI/LCD0-D9/PB-EINT3 H28
PB4/TWI1-SCK/I2S0-MCLK/TRACE-DATA2/PWM0-8/PB-EINT4 J27
PB5/TWI1-SDA/I2S0-BCLK/TRACE-CLK/PWM0-9/PB-EINT5 J28
PB6/I2S0-LRCK/TRACE-DATA0/PWM0-10/PB-EINT6 J29
PB7/OWA-IN/I2S0-DOUT0/I2S0-DIN1/LCD0-D16/PWM0-11/PB-EINT7 K27
PB8/OWA-OUT/I2S0-DIN0/I2S0-DOUT1/LCD0-D17/PWM0-0/PB-EINT8 K28
PB9/UART0-TX/TWI0-SCK/TRACE-DATA1/I2S0-DIN2/I2S0-DOUT2/PB-EINT9 L24
PB10/UART0-RX/TWI0-SDA/PWM0-1/I2S0-DIN3/I2S0-DOUT3/PB-EINT10 L25
PB11/TWI5-SCK/UART7-RTS/SPI1-CS0/PWM0-2/PB-EINT11 L26
PB12/TWI5-SDA/UART7-CTS/SPI1-CLK/PWM0-3/PB-EINT12 L27
PB13/TWI4-SCK/UART7-TX/SPI1-MOSI/PWM0-4/PB-EINT13 L28
PB14/TWI4-SDA/UART7-RX/SPI1-MISO/PWM0-5/PB-EINT14 L29

Serial port data signal needs
to be reversed.

PC0/NAND-WE/SDC2-DS/PC-EINT0 R24
PC1/NAND-ALE/SDC2-RST/PC-EINT1 T27
PC2/NAND-CLE/SPI0-MOSI/SPIF-MOSI/PC-EINT2 N26
PC3/NAND-CE1/SPI0-CS0/SPIF-CS0/PC-EINT3 N25
PC4/NAND-CE0/SPI0-MISO/SPIF-MISO/PC-EINT4 N24
PC5/NAND-RE/SDC2-CLK/PC-EINT5 T28
PC6/NAND-RB0/SDC2-CMD/PC-EINT6 R29
PC7/NAND-RB1/SPI0-CS1/SPIF-DQS/PC-EINT7 R25
PC8/NAND-DQ7/SDC2-D3/SPIF-D7/PC-EINT8 R28
PC9/NAND-DQ6/SDC2-D4/SPIF-D6/PC-EINT9 R27
PC10/NAND-DQ5/SDC2-D0/SPIF-D5/PC-EINT10 P28
PC11/NAND-DQ4/SDC2-D5/SPIF-D4/PC-EINT11 P27
PC12/NAND-DQS/SPI0-CLK/SPIF-CLK/PC-EINT12 N29
PC13/NAND-DQ3/SDC2-D1/PC-EINT13 N28
PC14/NAND-DQ2/SDC2-D6/PC-EINT14 N27
PC15/NAND-DQ1/SDC2-D2/SPI0-WP/SPIF-WP/PC-EINT15 M28
PC16/NAND-DQ0/SDC2-D7/SPI0-HOLD/SPIF-HOLD/PC-EINT16 M27
VCC-PC N22

Audio Switch/RGMII IO

Note PD:
The line
sequence of
LVDS and
MIPI-DSI is
inconsistent,
as shown in the
following
table.

PD0/LCD0-D2/LVDS0-D0P/DSI0-D0P/PWM0-0/PD-EINT0 A24
PD1/LCD0-D3/LVDS0-D0N/DSI0-D0N/PWM0-1/PD-EINT1 B24
PD2/LCD0-D4/LVDS0-D1P/DSI0-D1P/PWM0-2/PD-EINT2 A25
PD3/LCD0-D5/LVDS0-D1N/DSI0-D1N/PWM0-3/PD-EINT3 B25
PD4/LCD0-D6/LVDS0-D2P/DSI0-CKP/PWM0-4/PD-EINT4 A26
PD5/LCD0-D7/LVDS0-D2N/DSI0-CKN/PWM0-5/PD-EINT5 B26
PD6/LCD0-D10/LVDS0-CKP/DSI0-D2P/PWM0-6/PD-EINT6 A27
PD7/LCD0-D11/LVDS0-CKN/DSI0-D2N/PWM0-7/PD-EINT7 B27
PD8/LCD0-D12/LVDS0-D3P/DSI0-D3P/PWM0-8/PD-EINT8 A28
PD9/LCD0-D13/LVDS0-D3N/DSI0-D3N/PWM0-9/PD-EINT9 B28
PD10/LCD0-D14/LVDS1-D0P/DSI1-D0P/PWM0-10/SPI1-CS0/DBI-CSX/PD-EINT10 C28
PD11/LCD0-D15/LVDS1-D0N/DSI1-D0N/PWM0-11/SPI1-CLK/DBI-SCLK/PD-EINT11 C29
PD12/LCD0-D18/LVDS1-D1P/DSI1-D1P/PWM0-12/SPI1-MOSI/DBI-SDO/PD-EINT12 D28
PD13/LCD0-D19/LVDS1-D1N/DSI1-D1N/PWM0-13/SPI1-MISO/DBI-SDI/DBI-TE/DBI-DCX/PD-EINT13 D29
PD14/LCD0-D20/LVDS1-D2P/DSI1-CKP/PWM0-14/UART3-TX/PD-EINT14 E28
PD15/LCD0-D21/LVDS1-D2N/DSI1-CKN/PWM0-15/UART3-RX/PD-EINT15 E29
PD16/LCD0-D22/LVDS1-CKP/DSI1-D2P/PWM1-0/UART3-RTS/PD-EINT16 E26
PD17/LCD0-D23/LVDS1-CKN/DSI1-D2N/PWM1-1/UART3-CTS/PD-EINT17 E25
PD18/LCD0-CLK/LVDS1-D3P/DSI1-D3P/PWM1-2/UART4-TX/PD-EINT18 F29
PD19/LCD0-DE/LVDS1-D3N/DSI1-D3N/PWM1-3/UART4-RX/PD-EINT19 F28
PD20/LCD0-HSYNC/PWM0-2/UART2-TX/UART7-RTS/UART4-RTS/PD-EINT20 G28
PD21/LCD0-VSYNC/PWM0-3/UART2-RX/UART7-CTS/UART4-CTS/PD-EINT21 G29
PD22/PWM0-1/SPI1-HOLD/DBI-DCX/DBI-WRX/UART2-RTS/UART7-TX/TWI0-SCK/PD-EINT22 G25
PD23/PWM0-0/SPI1-WP/DBI-TE/UART2-CTS/UART7-RX/TWI0-SDA/PD-EINT23 G26
VCC-PD J23
VCC-LVDS0 K21

The internal
VCC18-PF of SOC is
powered by VCC-MCSI,
so for products with
TF card, VCC-MCSI
must maintain power
supply.

PE0/MCSI0-MCLK/PE-EINT0 J1
PE1/TWI2-SCK/UART4-TX/PE-EINT1 J2
PE2/TWI2-SDA/UART4-RX/PE-EINT2 K2
PE3/TWI3-SCK/UART4-RTS/PE-EINT3 K1
PE4/TWI3-SDA/UART4-CTS/PE-EINT4 L1
PE5/MCSI1-MCLK/PLL-LOCK-DBG/I2S2-MCLK/LEDC/PE-EINT5 L2
PE6/I2S2-BCLK/LCD0-TRIG/NCSI-D8/PE-EINT6 M1
PE7/I2S2-LRCK/LCD1-TRIG/NCSI-D9/PE-EINT7 M2
PE8/I2S2-DOUT0/NCSI-D10/PE-EINT8 J4
PE9/I2S2-DIN0/NCSI-D11/PE-EINT9 J5
PE10/MCSI3-MCLK/PWM0-3/NCSI-D12/PE-EINT10 N1
PE11/TWI1-SCK/UART5-RTS/SPI2-CS0/UART6-TX/NCSI-D13/PE-EINT11 N2
PE12/TWI1-SDA/UART5-CTS/SPI2-CLK/UART6-RX/NCSI-D14/PE-EINT12 L4
PE13/TWI4-SCK/UART5-TX/SPI2-MOSI/UART6-RTS/CSI0-XVS-FSYNC/PE-EINT13 L5
PE14/TWI4-SDA/UART5-RX/SPI2-MISO/UART6-CTS/CSI1-XVS-FSYNC/PE-EINT14 N4
PE15/MCSI2-MCLK/PWM0-2/NCSI-D15/PE-EINT15 N5
VCC-PE J6

PF0/SDC0-D1/JTAG-MS/TRACE-DATA2/I2S3-DIN0/I2S3-DOUT1/PF-EINT0 C13
PF1/SDC0-D0/JTAG-DI/TRACE-DATA1/I2S3-DOUT0/I2S3-DIN1/PF-EINT1 B13
PF2/SDC0-CLK/UART0-TX/I2S3-DIN2/I2S3-DOUT2/PF-EINT2 B12
PF3/SDC0-CMD/JTAG-DO/TRACE-DATA0/I2S3-LRCK/PF-EINT3 A12
PF4/SDC0-D3/UART0-RX/I2S3-DIN3/I2S3-DOUT3/PF-EINT4 C11
PF5/SDC0-D2/JTAG-CK/TRACE-CLK/I2S3-BCLK/PF-EINT5 B11
PF6/I2S3-MCLK/PF-EINT6 C12

GPIO use gide:
1.Note that the voltage of SOC GPIO must matches the
external IO voltage.
2.The pull up voltage of the GPIO is selected to correspond
to the power field voltage of GPIO.
3.Power current is PCB layout reference minimum.

AllWinner Technology Co.,Ltd

# Audio&ADC

R1

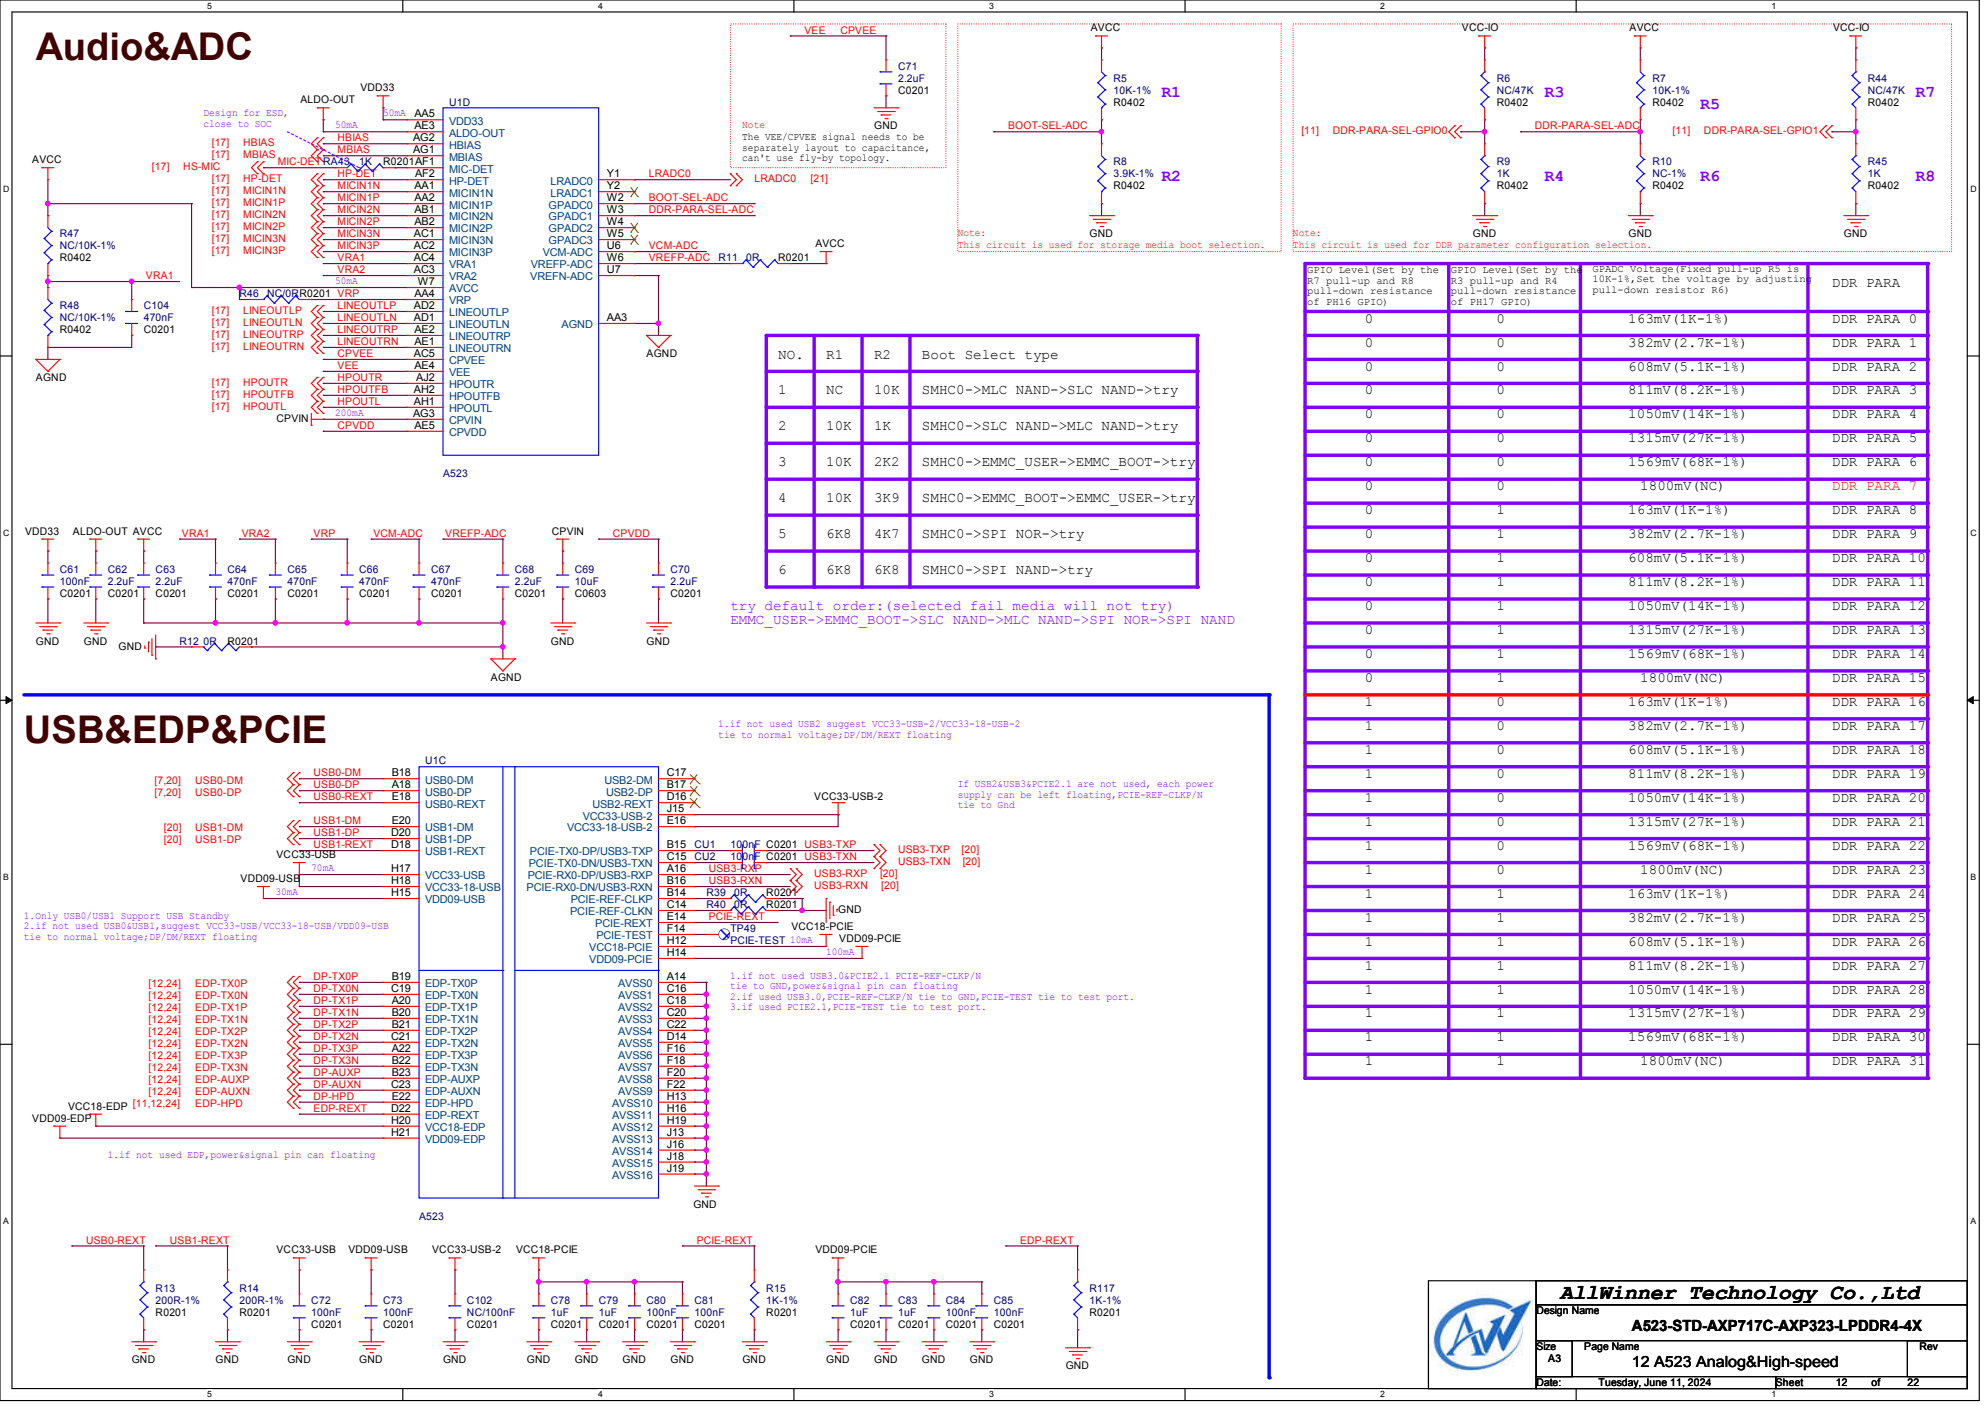
[picture p338: page 13]

Note
The VEE/CPVEE signal needs to be
separately layout to capacitance,
can't use fly-by topology.

BOOT-SEL-ADC
DDR-PARA-SEL-ADC

Note:
This circuit is used for storage media boot selection.

This circuit is used for DDR parameter configuration selection.

GPIO Level(Set by the R7 pull-up and R8 pull-down resistance of PH16 GPIO) | GPIO Level(Set by the R3 pull-up and R4 pull-down resistance of PH17 GPIO) | GPADC Voltage(Fixed pull-up R5 is 10K-1%,Set the voltage by adjusting pull-down resistor R6) | DDR PARA

0 | 0 | 163mV(1K-1%) | DDR PARA 0

1 | NC | 10K | SMHC0->MLC NAND->SLC NAND->try

0 | 0 | 811mV(8.2K-1%) | DDR PARA 3

SMHC0->SLC NAND->MLC NAND->try

0 | 0 | 1315mV(27K-1%) | DDR PARA 5

3 | 10K | 2K2 | SMHC0->EMMC_USER->EMMC_BOOT->try

0 | 0 | 1569mV(68K-1%) | DDR PARA 6

0 | 1 | 163mV(1K-1%) | DDR PARA 8

5 | 6K8 | 4K7 | SMHC0->SPI NOR->try

0 | 1 | 382mV(2.7K-1%) | DDR PARA 9

0 | 1 | 811mV(8.2K-1%) | DDR PARA 11

try default order:(selected fail media will not try)
EMMC_USER->EMMC_BOOT->SLC NAND->MLC NAND->SPI NOR->SPI NAND

0 | 1 | 1050mV(14K-1%) | DDR PARA 12

0 | 1 | 1315mV(27K-1%) | DDR PARA 13

0 | 1 | 1569mV(68K-1%) | DDR PARA 14

0 | 1 | 1800mV(NC) | DDR PARA 15

1 | 0 | 163mV(1K-1%) | DDR PARA 16

1.if not used USB2 suggest VCC33-USB-2/VCC33-18-USB-2
tie to normal voltage;DP/DM/REXT floating

1 | 0 | 382mV(2.7K-1%) | DDR PARA 17

1 | 0 | 608mV(5.1K-1%) | DDR PARA 18

1 | 0 | 811mV(8.2K-1%) | DDR PARA 19

If USB2&USB3&PCIE2.1 are not used, each power
supply can be left floating,PCIE-REF-CLKP/N
tie to Gnd

1.Only USB0/USB1 Support USB Standby
2.if not used USB0&USB1,suggest VCC33-USB/VCC33-18-USB/VDD09-USB

1 | 1 | 608mV(5.1K-1%) | DDR PARA 26

1.if not used USB3.0&PCIE2.1 PCIE-REF-CLKP/N
tie to GND,power&signal pin can floating
2.if used USB3.0,PCIE-REF-CLKP/N tie to GND,PCIE-TEST tie to test port.
3.if used PCIE2.1,PCIE-TEST tie to test port.

1 | 1 | 811mV(8.2K-1%) | DDR PARA 27

1.if not used EDP,power&signal pin can floating

AllWinner Technology Co.,Ltd

# EMMC Default:use EMMC

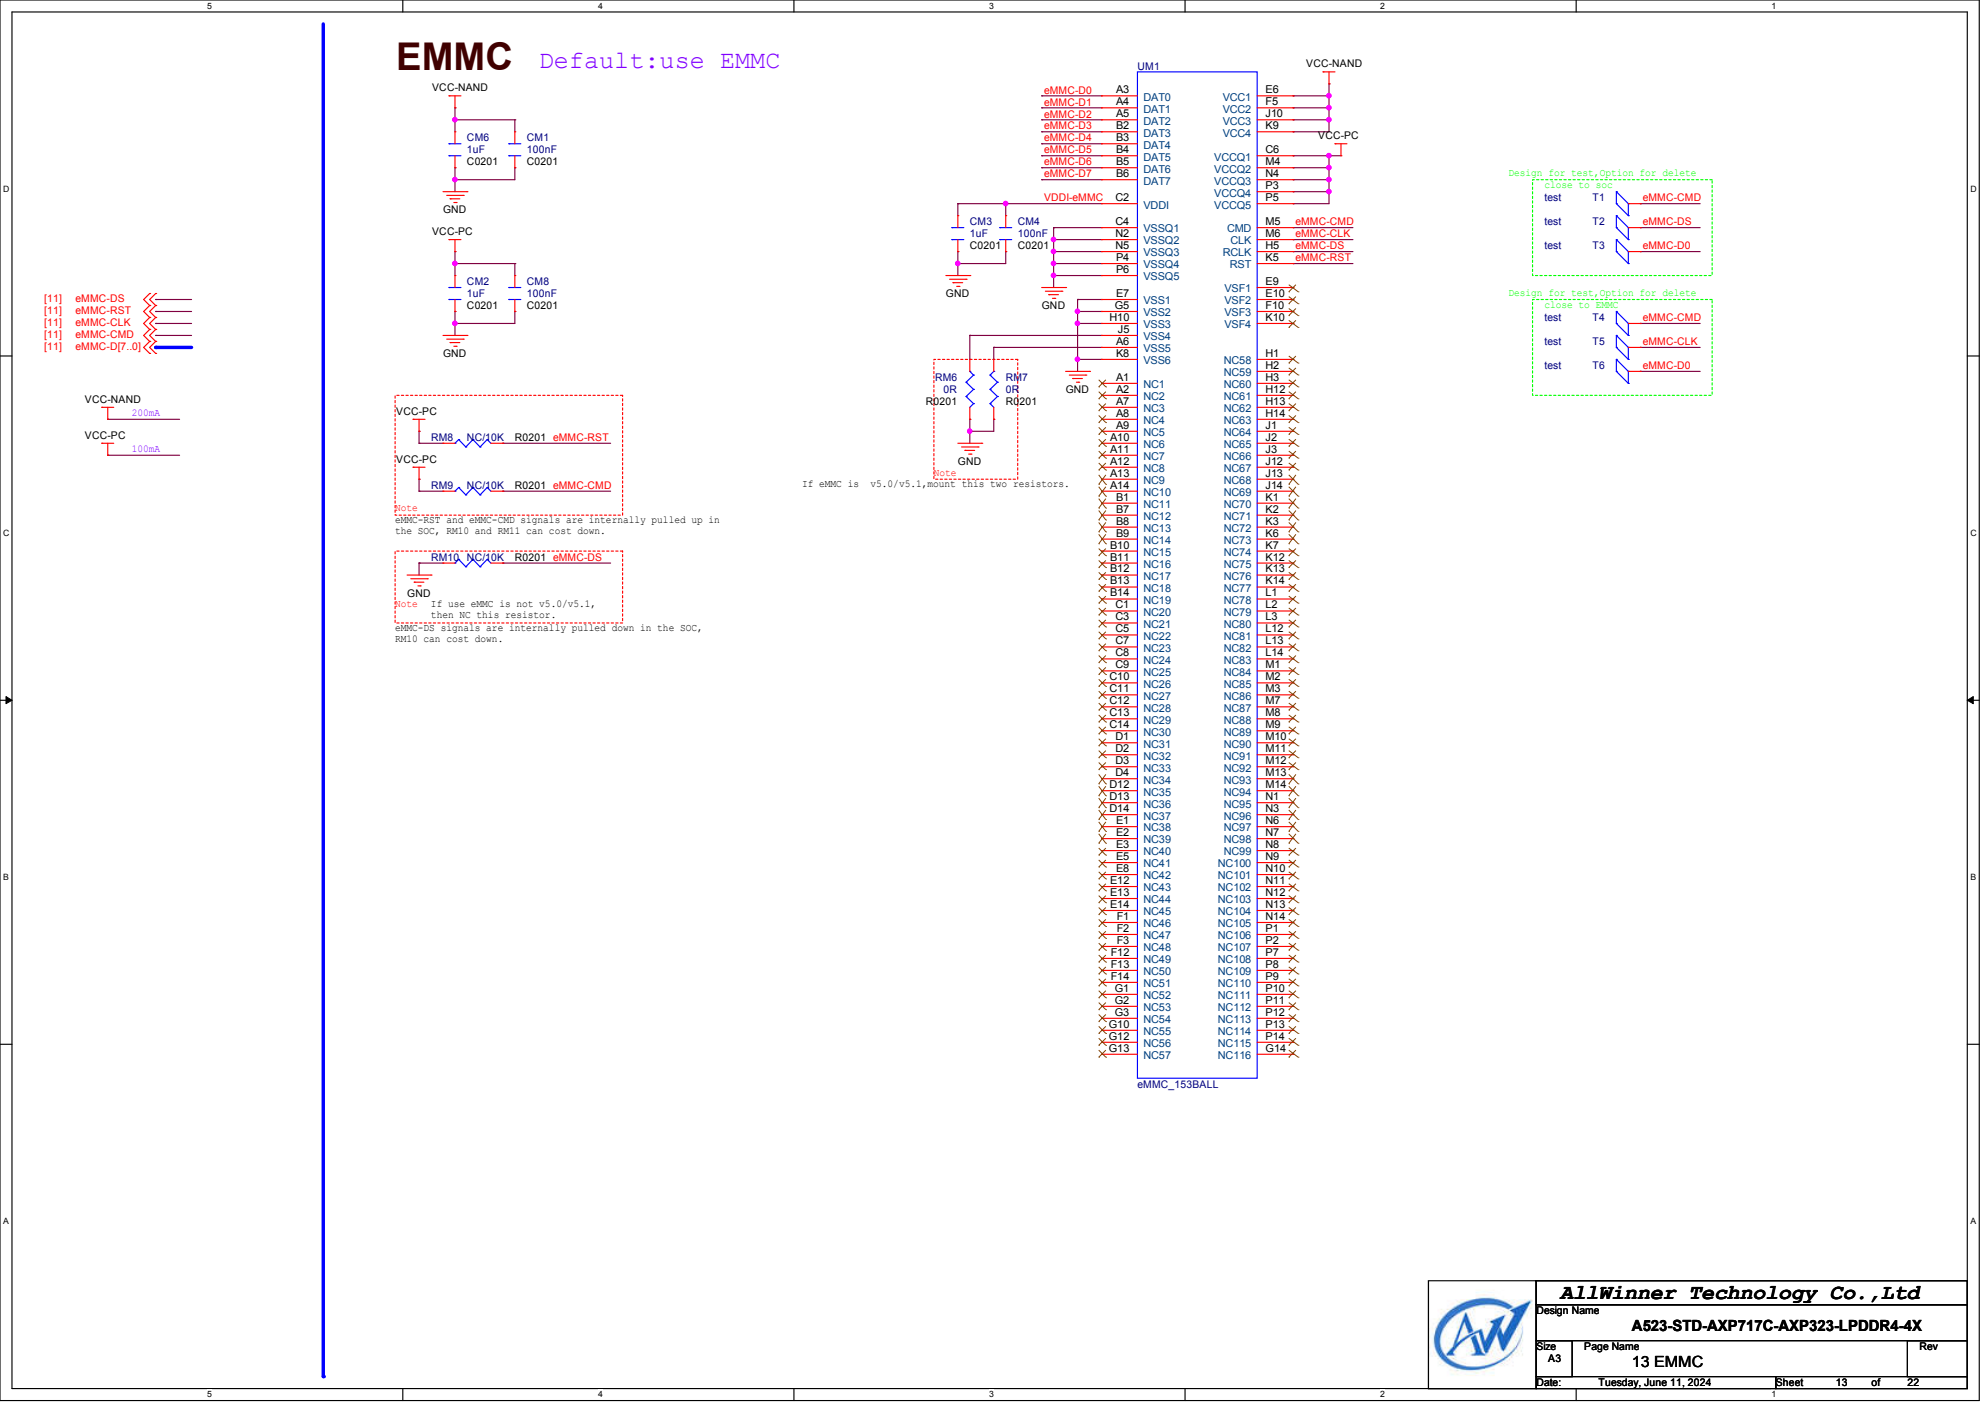
[picture p339: page 14]

Design for test,Option for delete

Note
eMMC-RST and eMMC-CMD signals are internally pulled up in
the SOC, RM10 and RM11 can cost down.

then NC this resistor.

eMMC-DS signals are internally pulled down in the SOC,
RM10 can cost down.

AllWinner Technology Co.,Ltd

# LCD

### Differential pairs :

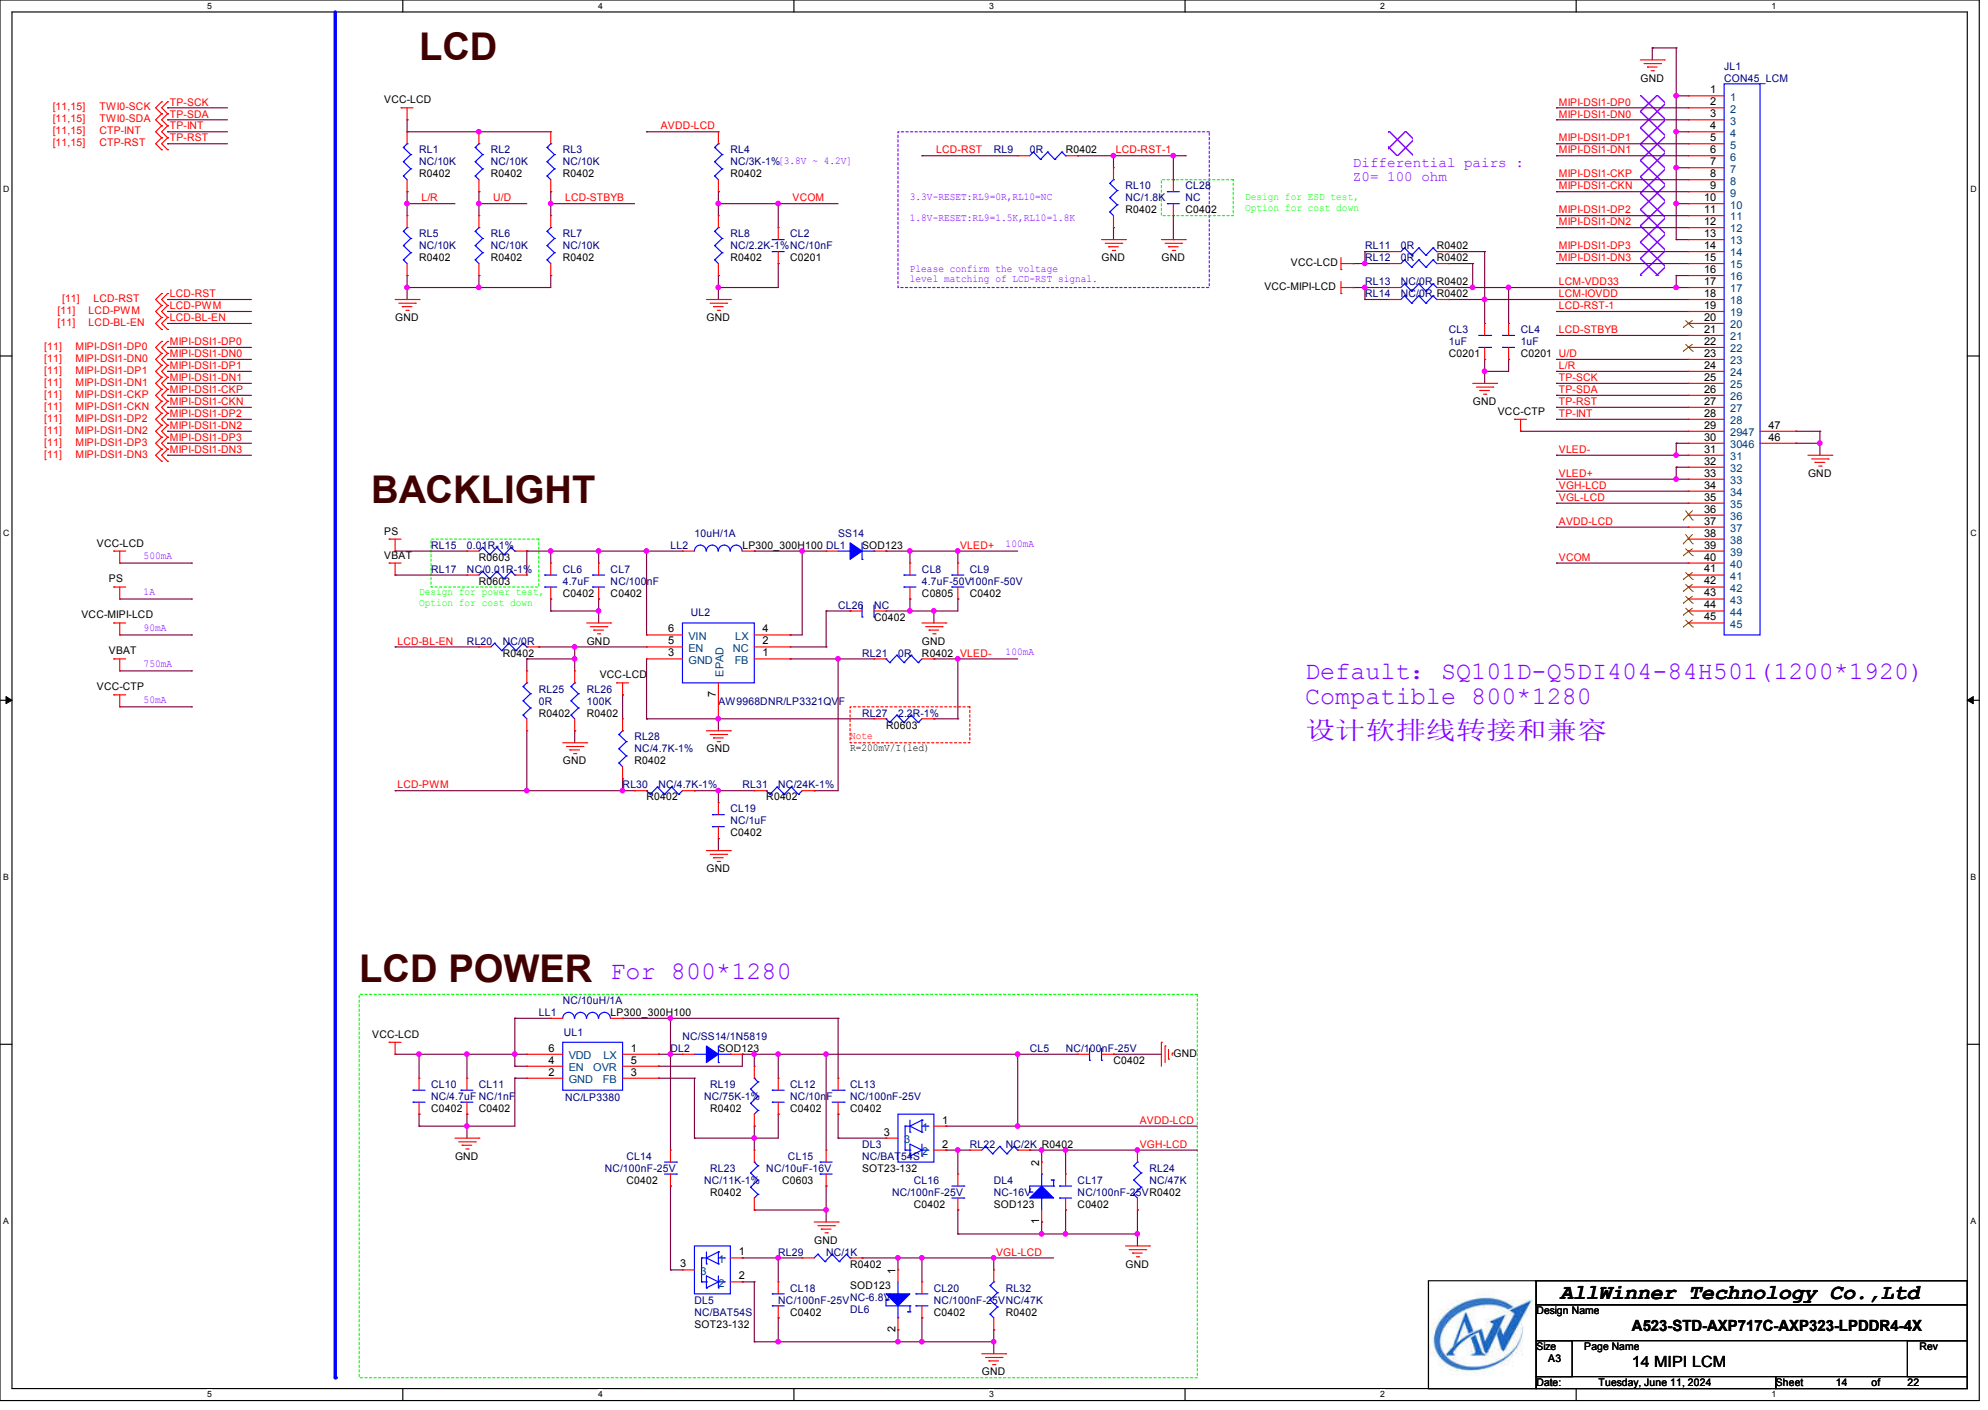
[picture p340: page 15]
LCD POWER; For 800*1280; 设计软排线转接和兼容; Default：SQ101D-Q5DI404-84H501(1200*1920); Compatible 800*1280; Z0= 100 ohm; 3.3V-RESET:RL9=0R,RL10=NC; 1.8V-RESET:RL9=1.5K,RL10=1.8K; Note R=200mV/I(led); BACKLIGHT; VGH-LCD; VGL-LCD; AVDD-LCD; TP-SDA; TP-SCK; TP-RST; TP-INT; LCM-IOVDD; LCM-VDD33; MIPI-DSI1-DP0; MIPI-DSI1-DP1; MIPI-DSI1-DN0; MIPI-DSI1-DN1; MIPI-DSI1-CKP; MIPI-DSI1-DP2; MIPI-DSI1-CKN; MIPI-DSI1-DN2; MIPI-DSI1-DP3 MIPI-DSI1-DN3; LCD-RST-1; LCD-STBYB; TP-SCK TP-SDA; VLED-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

Design for ESD test,
Option for cost down

Please confirm the voltage
level matching of LCD-RST signal.

[11] LCD-RST
[11] LCD-PWM
[11] LCD-BL-EN

LCD-RST
LCD-PWM
LCD-BL-EN

VCC-MIPI-LCD

Design for power test,

AllWinner Technology Co.,Ltd

# EDP LCM

### Differential pairs :

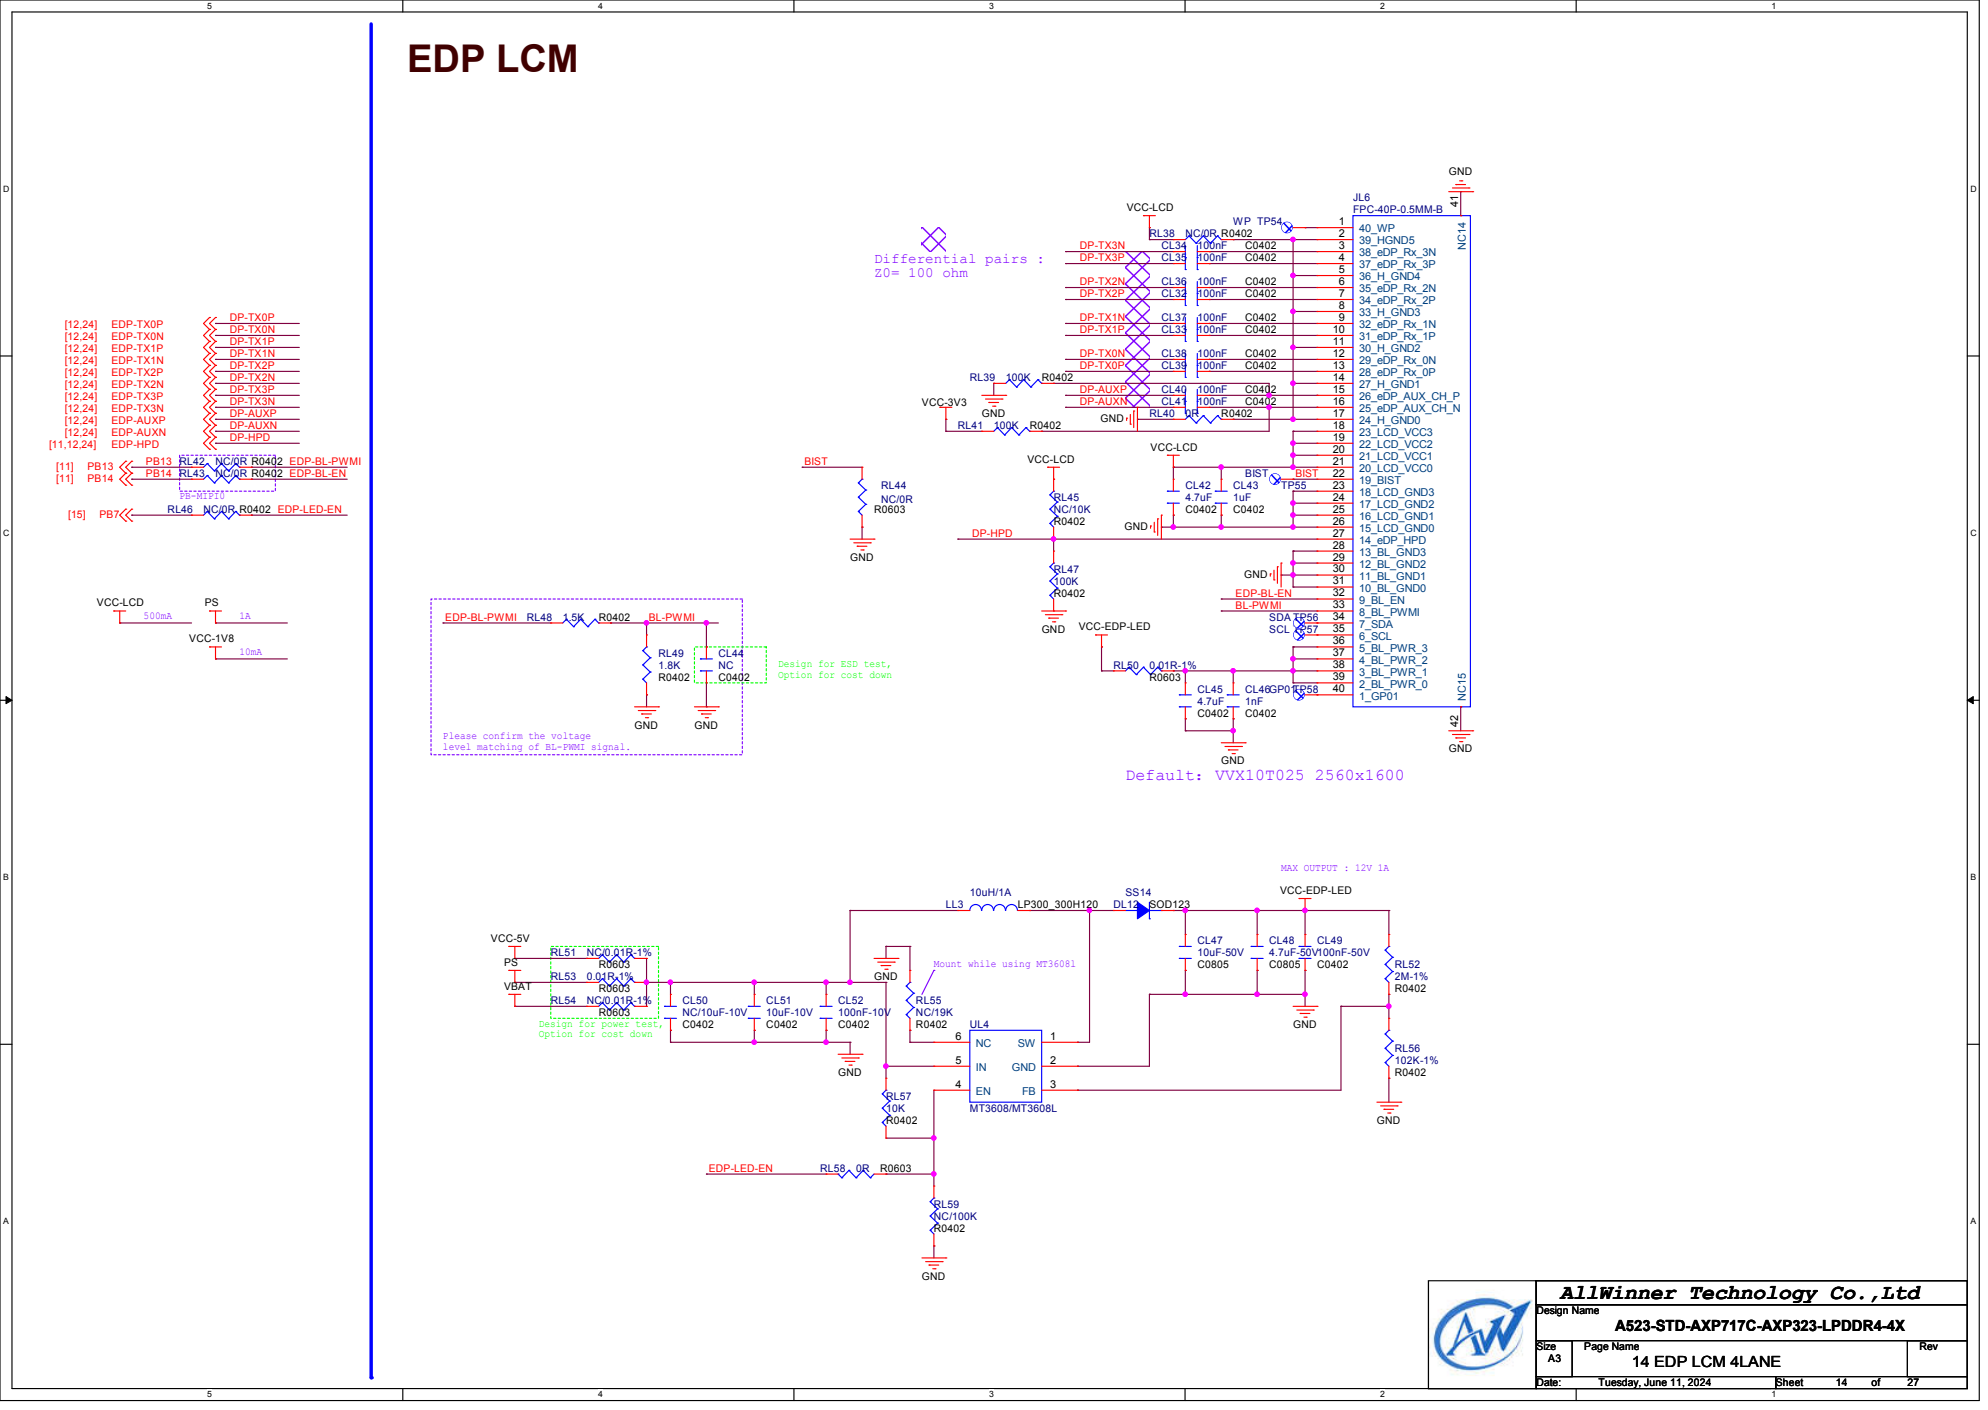
[picture p341: page 16]

Design for ESD test,
Option for cost down

Please confirm the voltage
level matching of BL-PWMI signal.

Design for power test,

AllWinner Technology Co.,Ltd

# CTP

Circuit | GSL3676 | BL3676

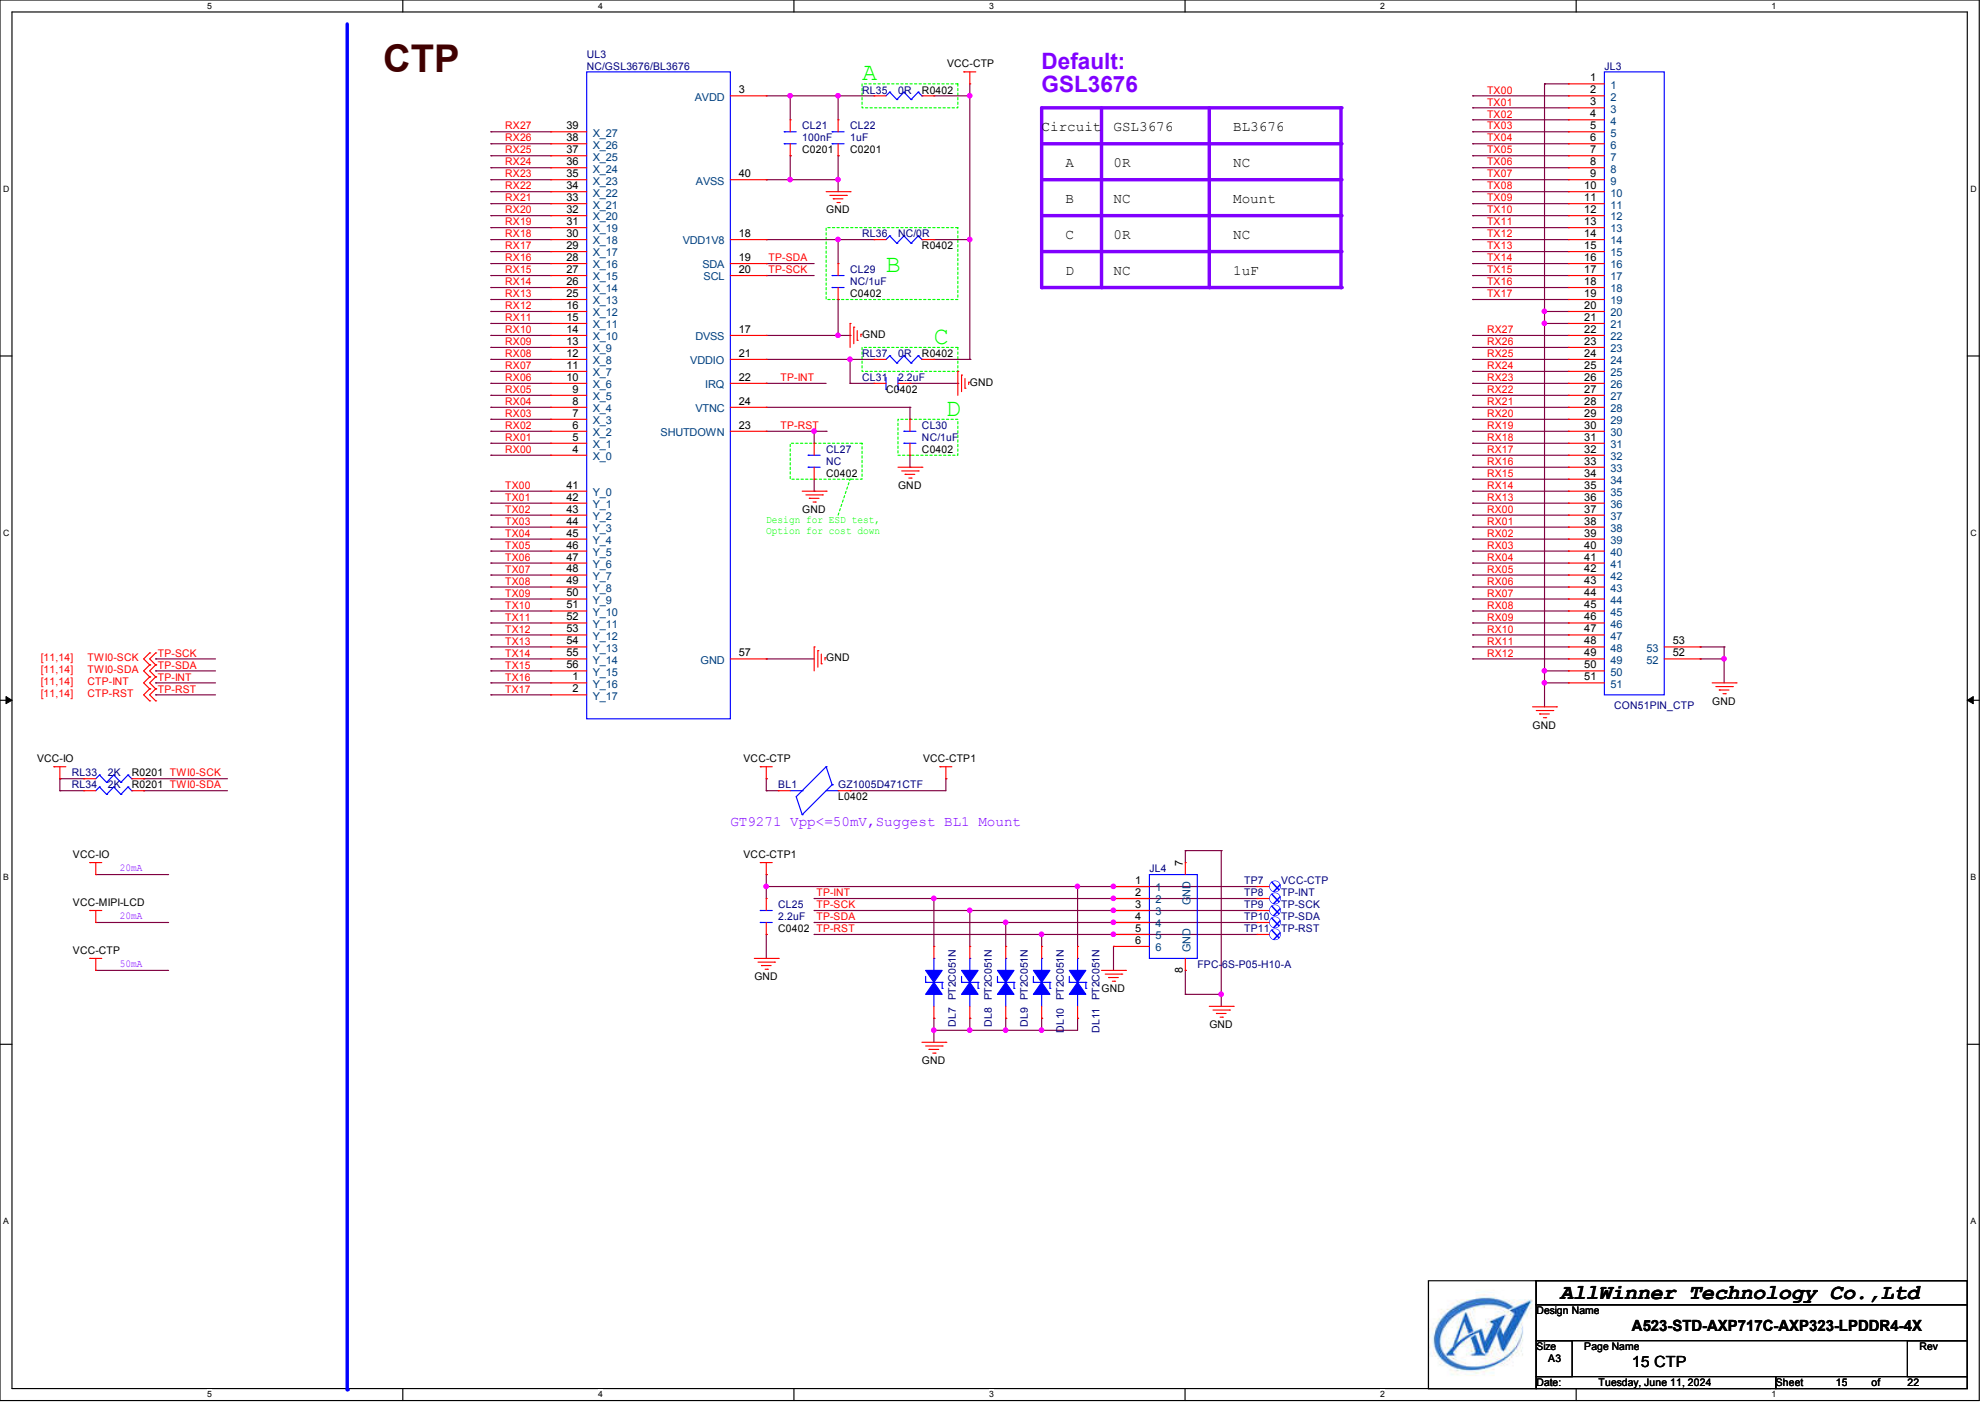
[picture p342: page 17]

B | NC | Mount

Design for ESD test,
Option for cost down

AllWinner Technology Co.,Ltd

# CAMERA

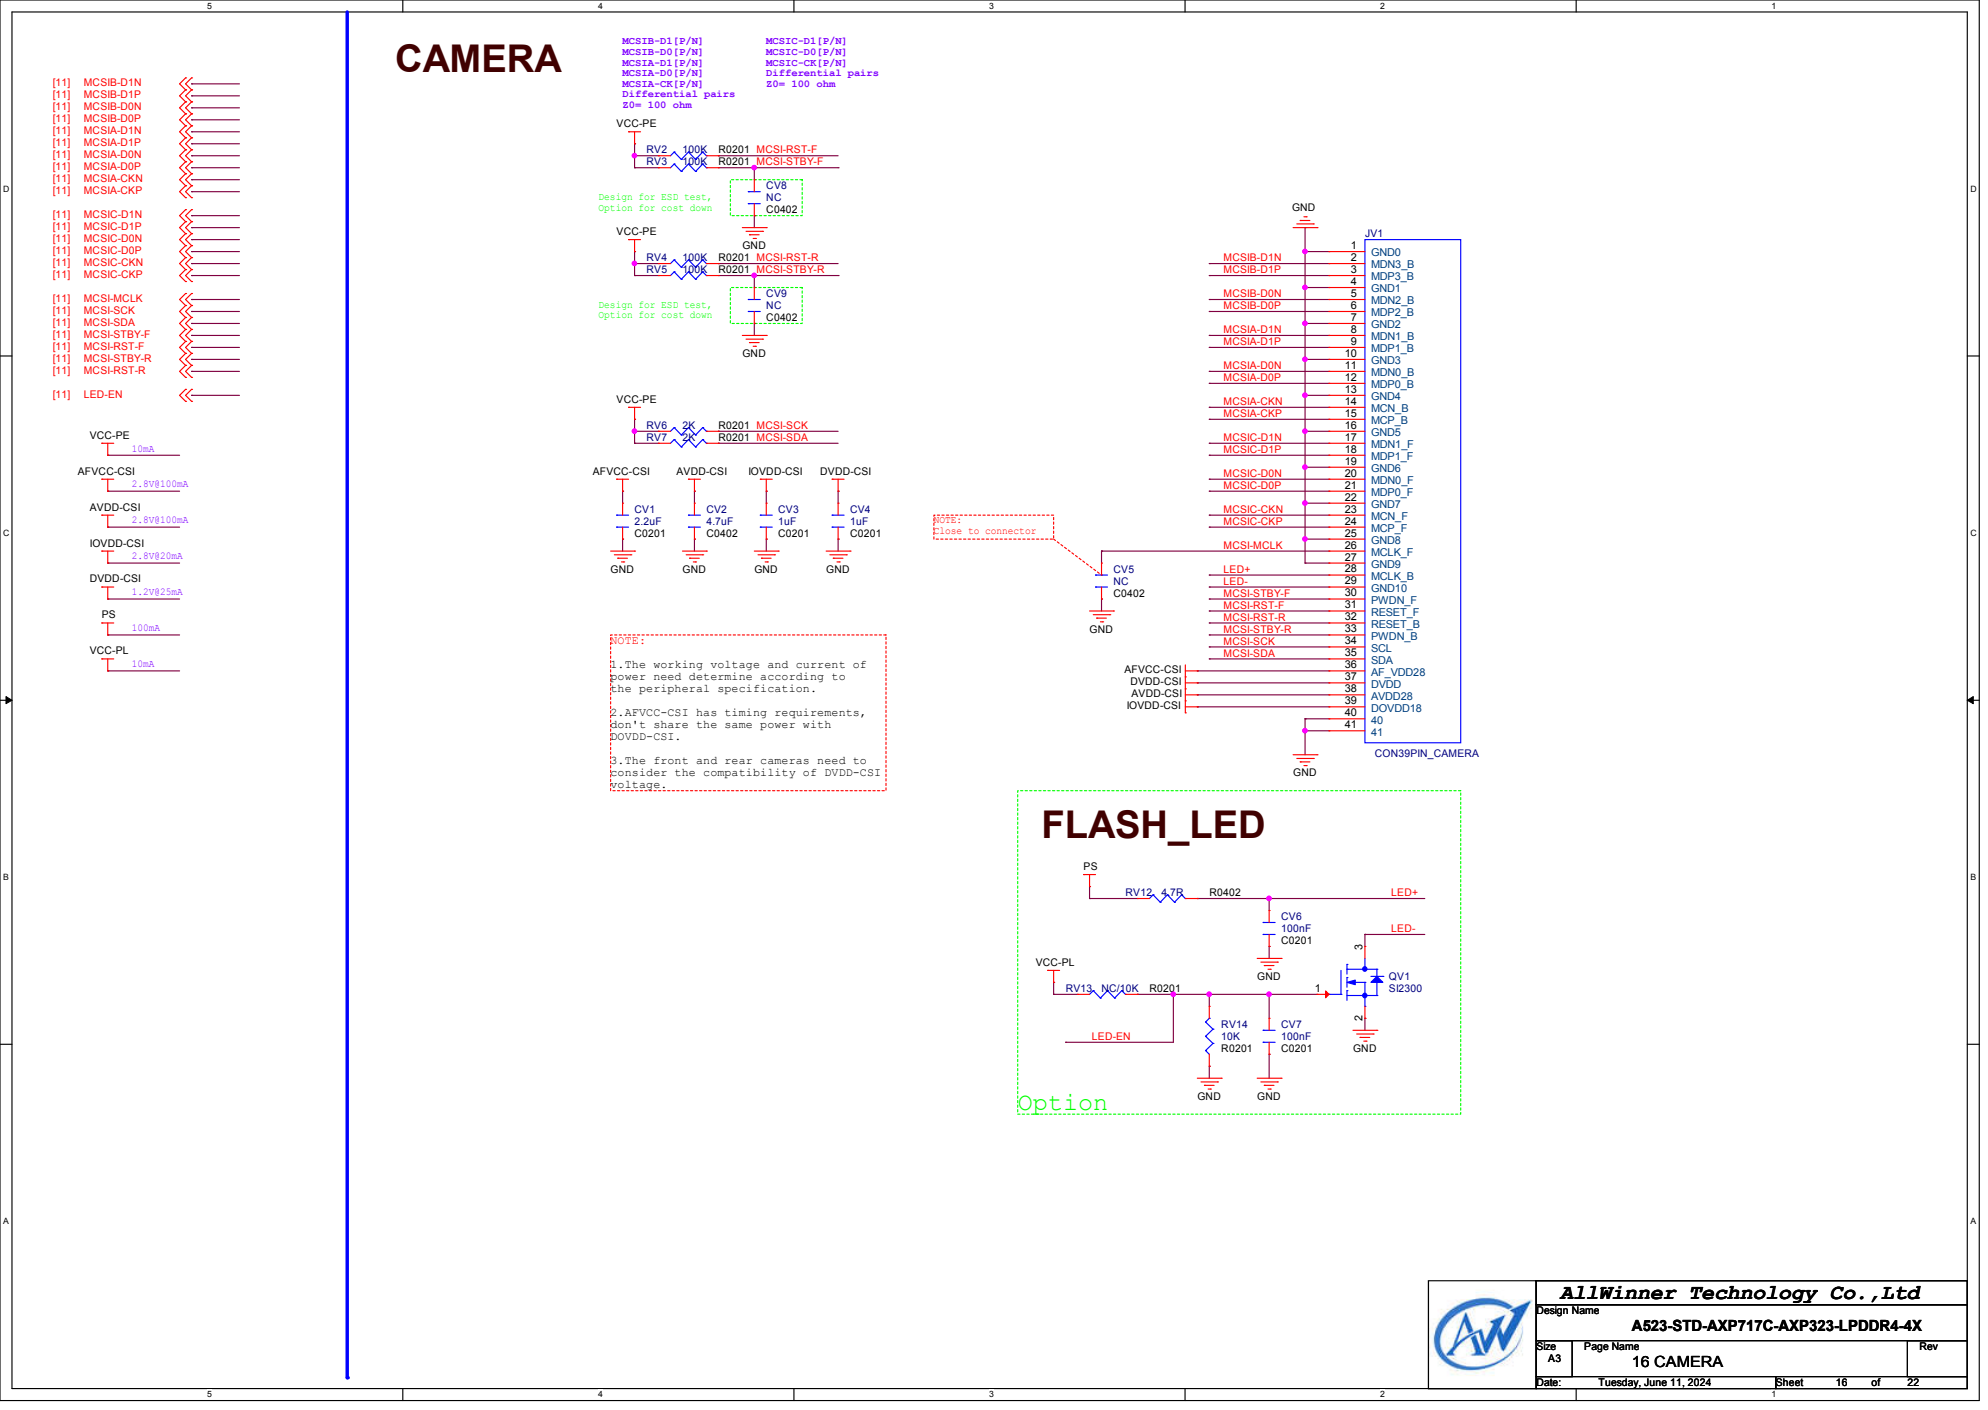
[picture p343: page 18]
MCSIB-D1[P/N] MCSIB-D0[P/N] MCSIA-D1[P/N] MCSIA-D0[P/N] MCSIA-CK[P/N] Differential pairs Z0= 100 ohm; MCSIC-D1[P/N] MCSIC-D0[P/N] MCSIC-CK[P/N] Differential pairs Z0= 100 ohm; NOTE:; FLASH_LED; Option; MCSIB-D1N MCSIB-D1P; MCSIB-D0N MCSIB-D0P; MCSIA-D1N MCSIA-D1P; MCSIA-D0N MCSIA-D0P; MCSIA-CKN MCSIA-CKP; MCSIC-D1N MCSIC-D1P; MCSIC-D0N MCSIC-D0P; MCSIC-CKN MCSIC-CKP; MCSI-MCLK; MCSI-STBY-F MCSI-RST-F MCSI-RST-R MCSI-STBY-R MCSI-SCK MCSI-SDA; LED+ LED-; MCSI-RST-F MCSI-STBY-F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

Design for ESD test,
Option for cost down

NOTE:
Close to connector

1.The working voltage and current of
power need determine according to
the peripheral specification.

2.AFVCC-CSI has timing requirements,
don't share the same power with
DOVDD-CSI.

3.The front and rear cameras need to
consider the compatibility of DVDD-CSI
voltage.

AllWinner Technology Co.,Ltd

# HEADPHONE

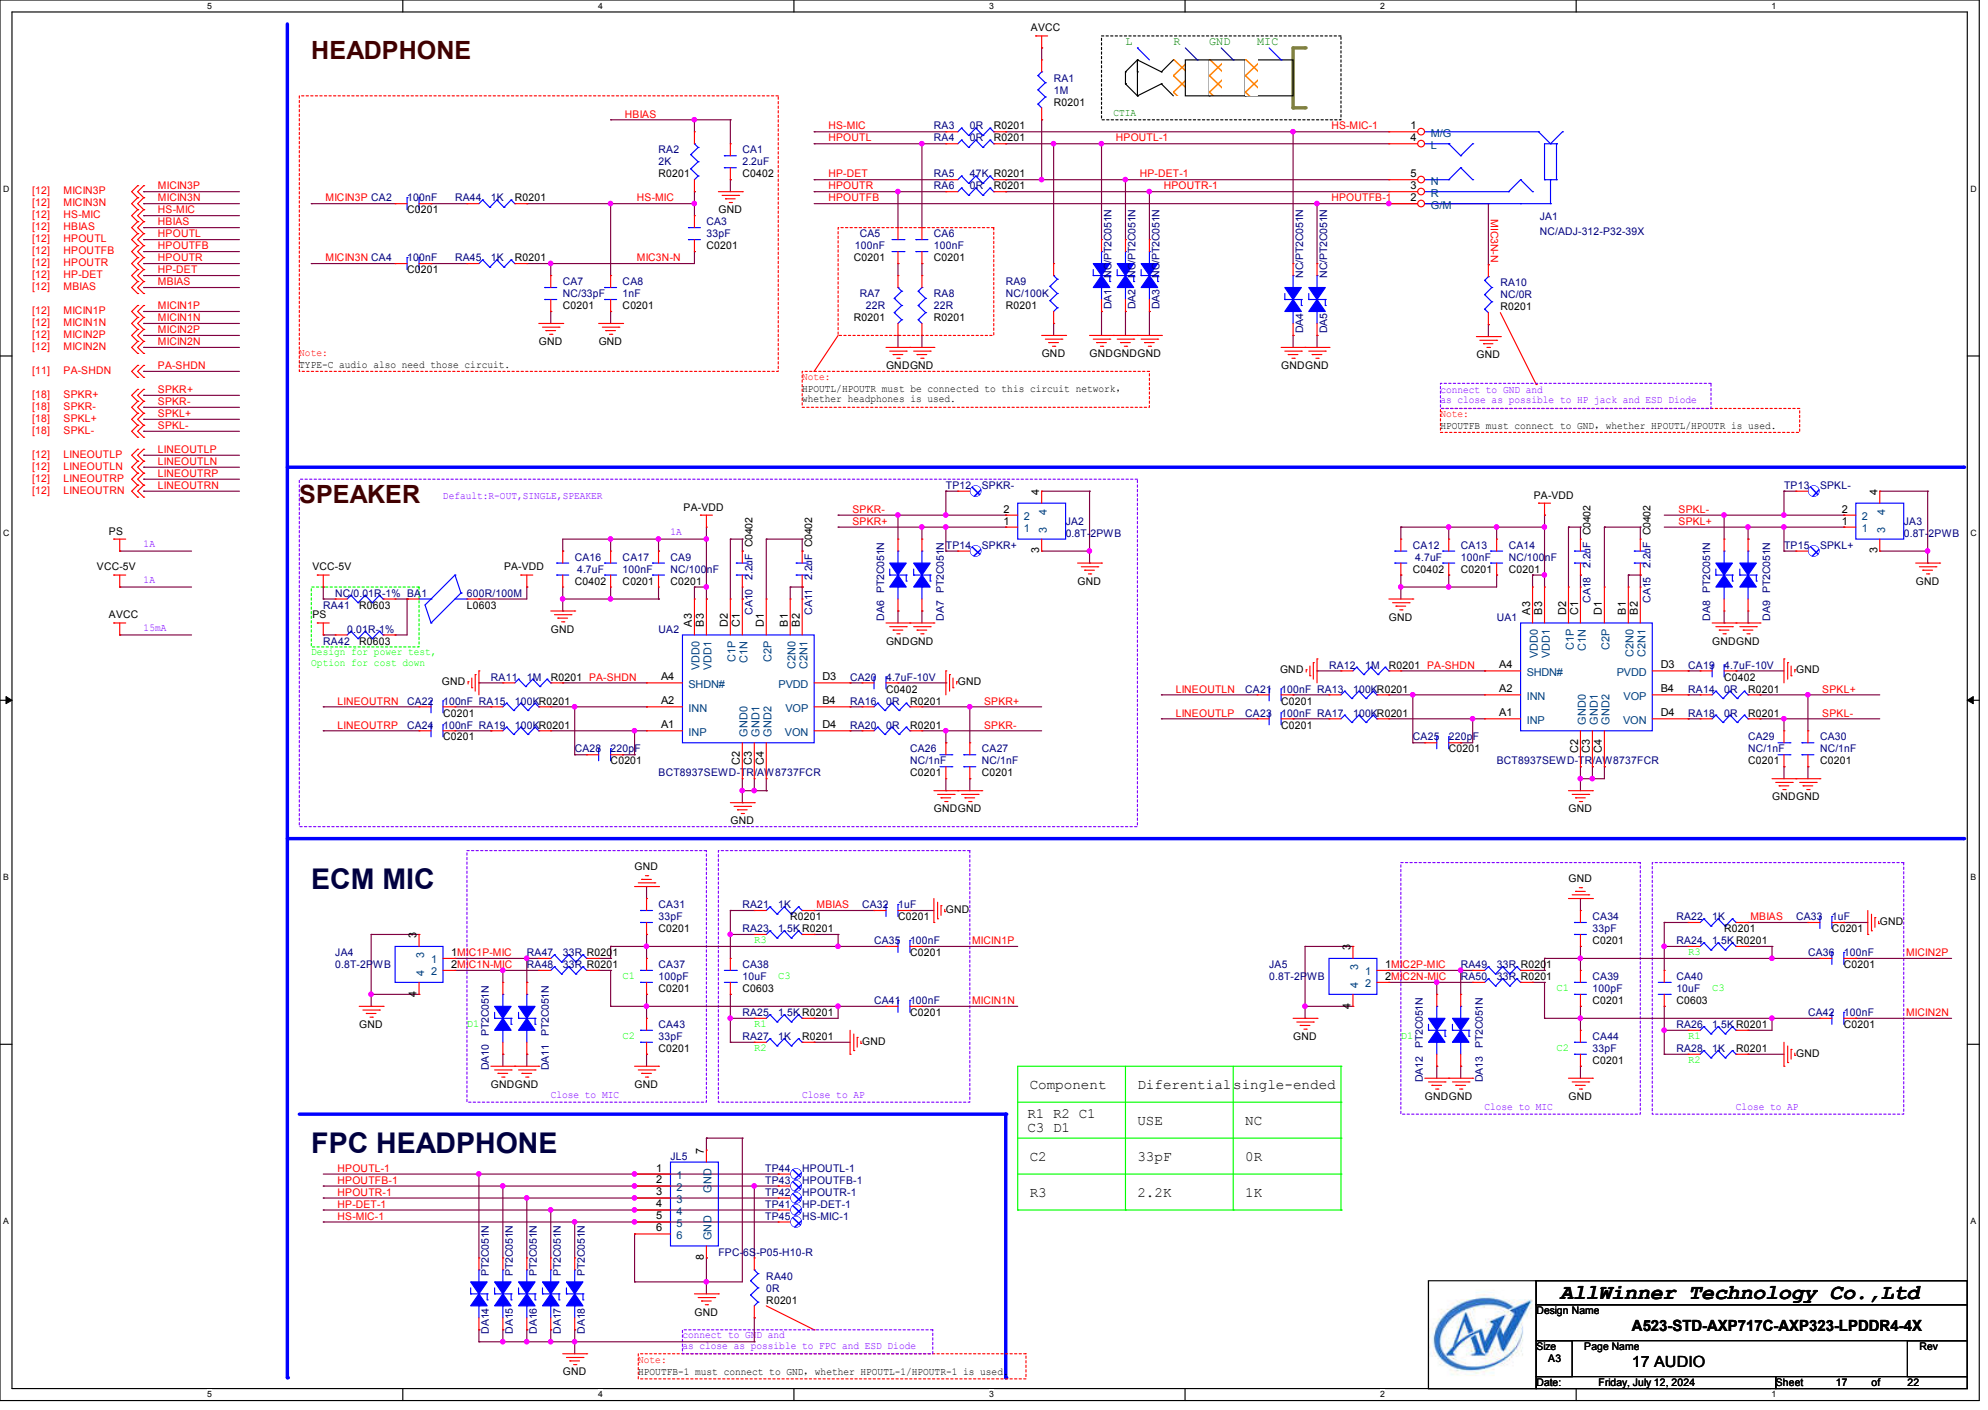
[picture p344: page 19]

Note:
TYPE-C audio also need those circuit.

HPOUTL/HPOUTR must be connected to this circuit network，
whether headphones is used.

connect to GND and
as close as possible to HP jack and ESD Diode
HPOUTFB must connect to GND，whether HPOUTL/HPOUTR is used.

SPEAKER Default:R-OUT,SINGLE,SPEAKER

Design for power test,
Option for cost down

Component | Diferentialsingle-ended

C3 D1 | USE | NC R1 R2 C1

AllWinner Technology Co.,Ltd

as close as possible to FPC and ESD Diode

HPOUTFB-1 must connect to GND，whether HPOUTL-1/HPOUTR-1 is used.

# TYPEC

# TYPE-C AUDIO

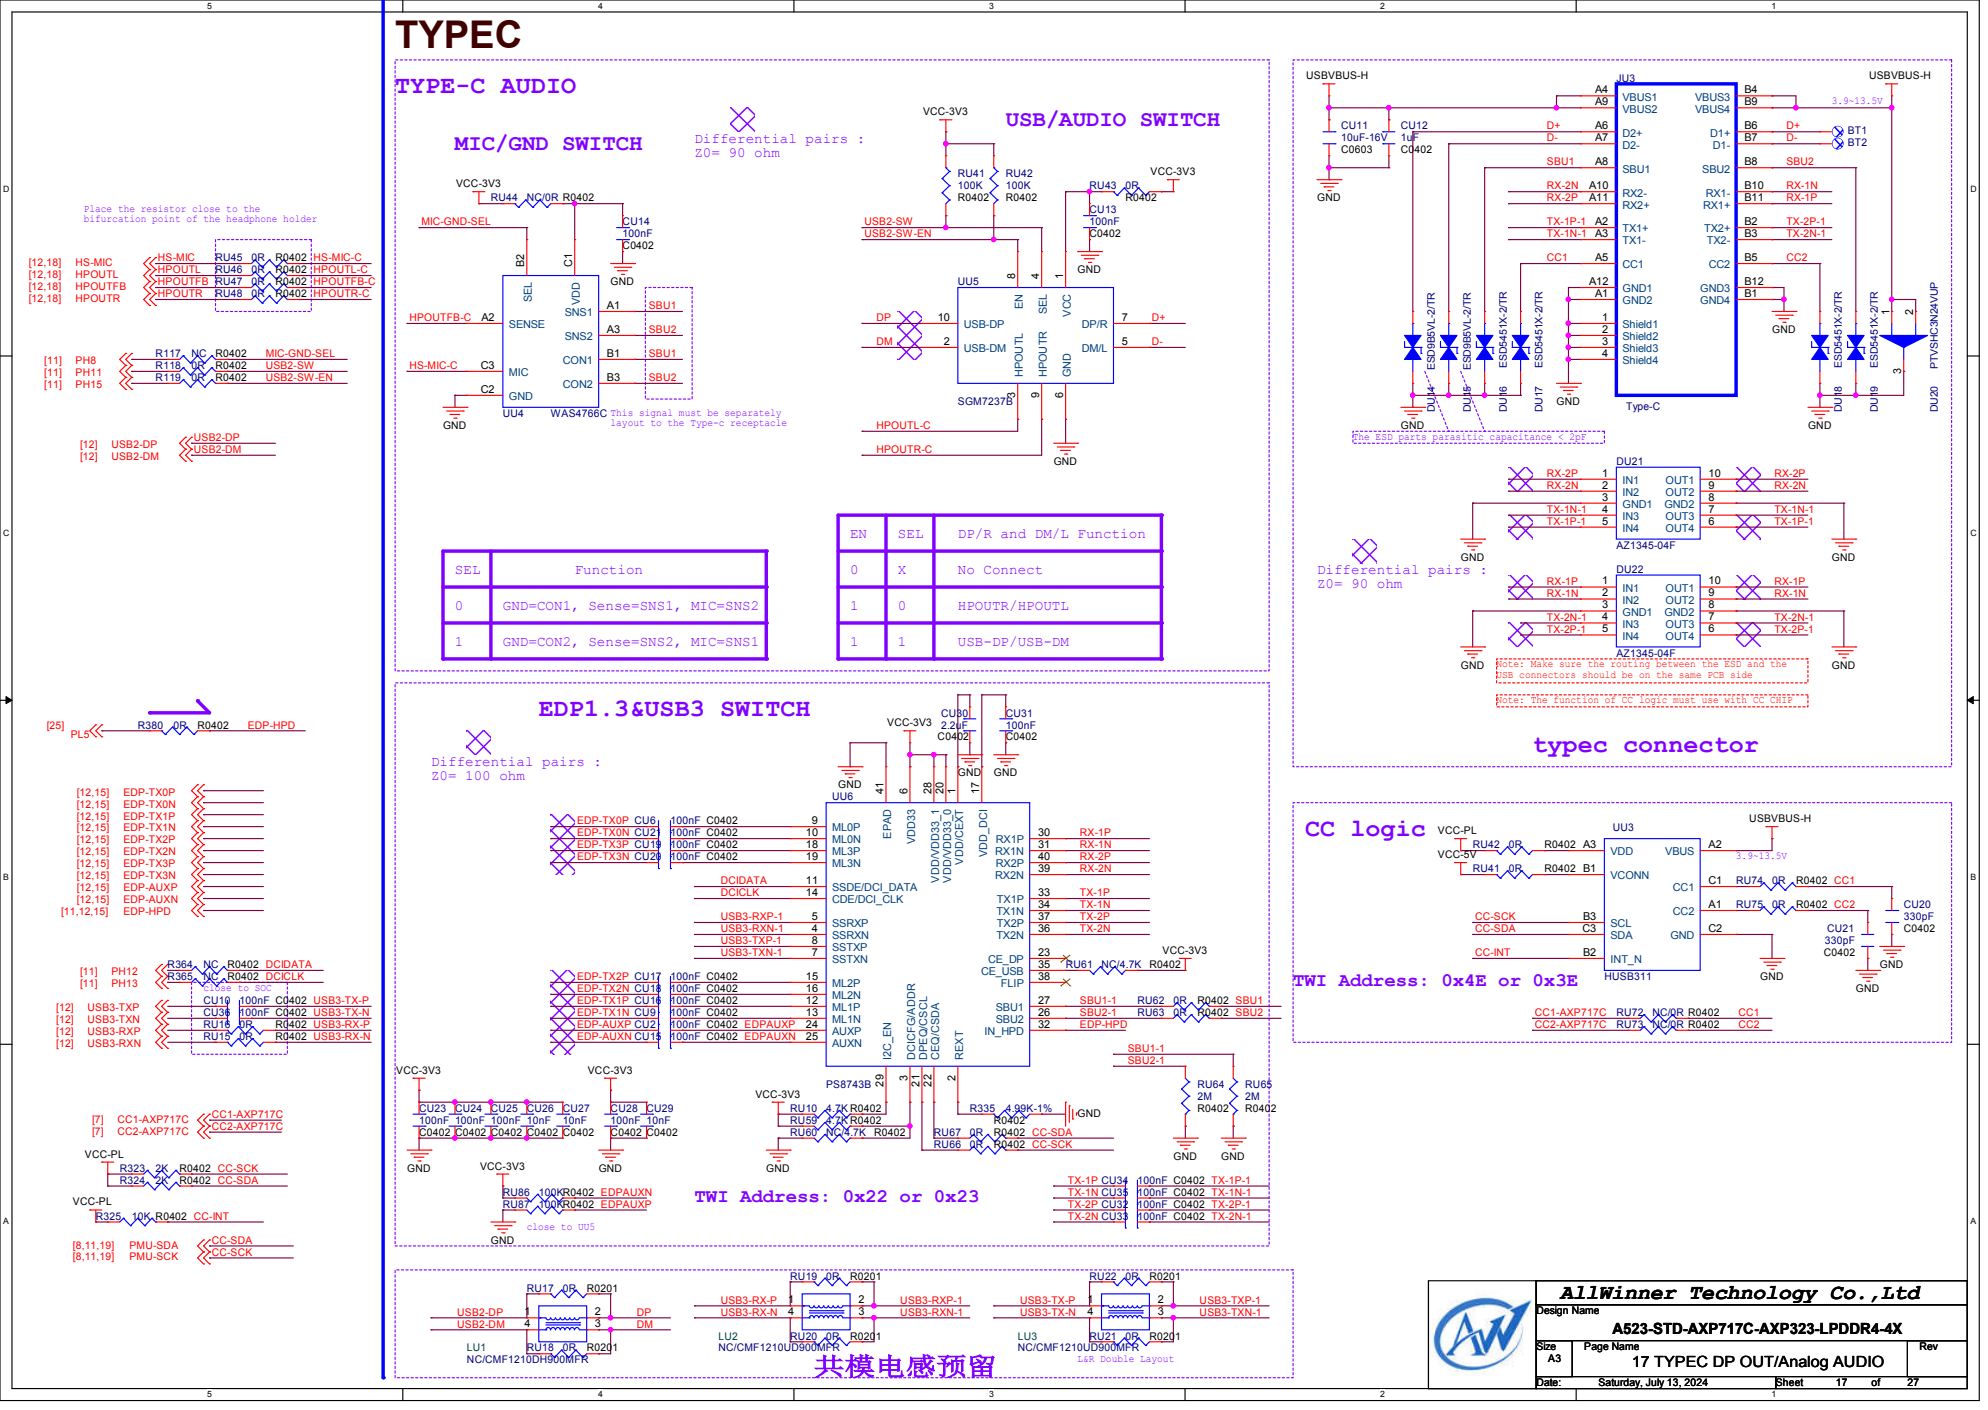
[picture p345: page 20]

Place the resistor close to the
bifurcation point of the headphone holder

This signal must be separately
layout to the Type-c receptacle

The ESD parts parasitic capacitance < 2pF

DP/R and DM/L Function

Note: Make sure the routing between the ESD and the
USB connectors should be on the same PCB side

Note: The function of CC logic must use with CC CHIP
typec connector

AllWinner Technology Co.,Ltd

17 TYPEC DP OUT/Analog AUDIO

# Default:Use AC107

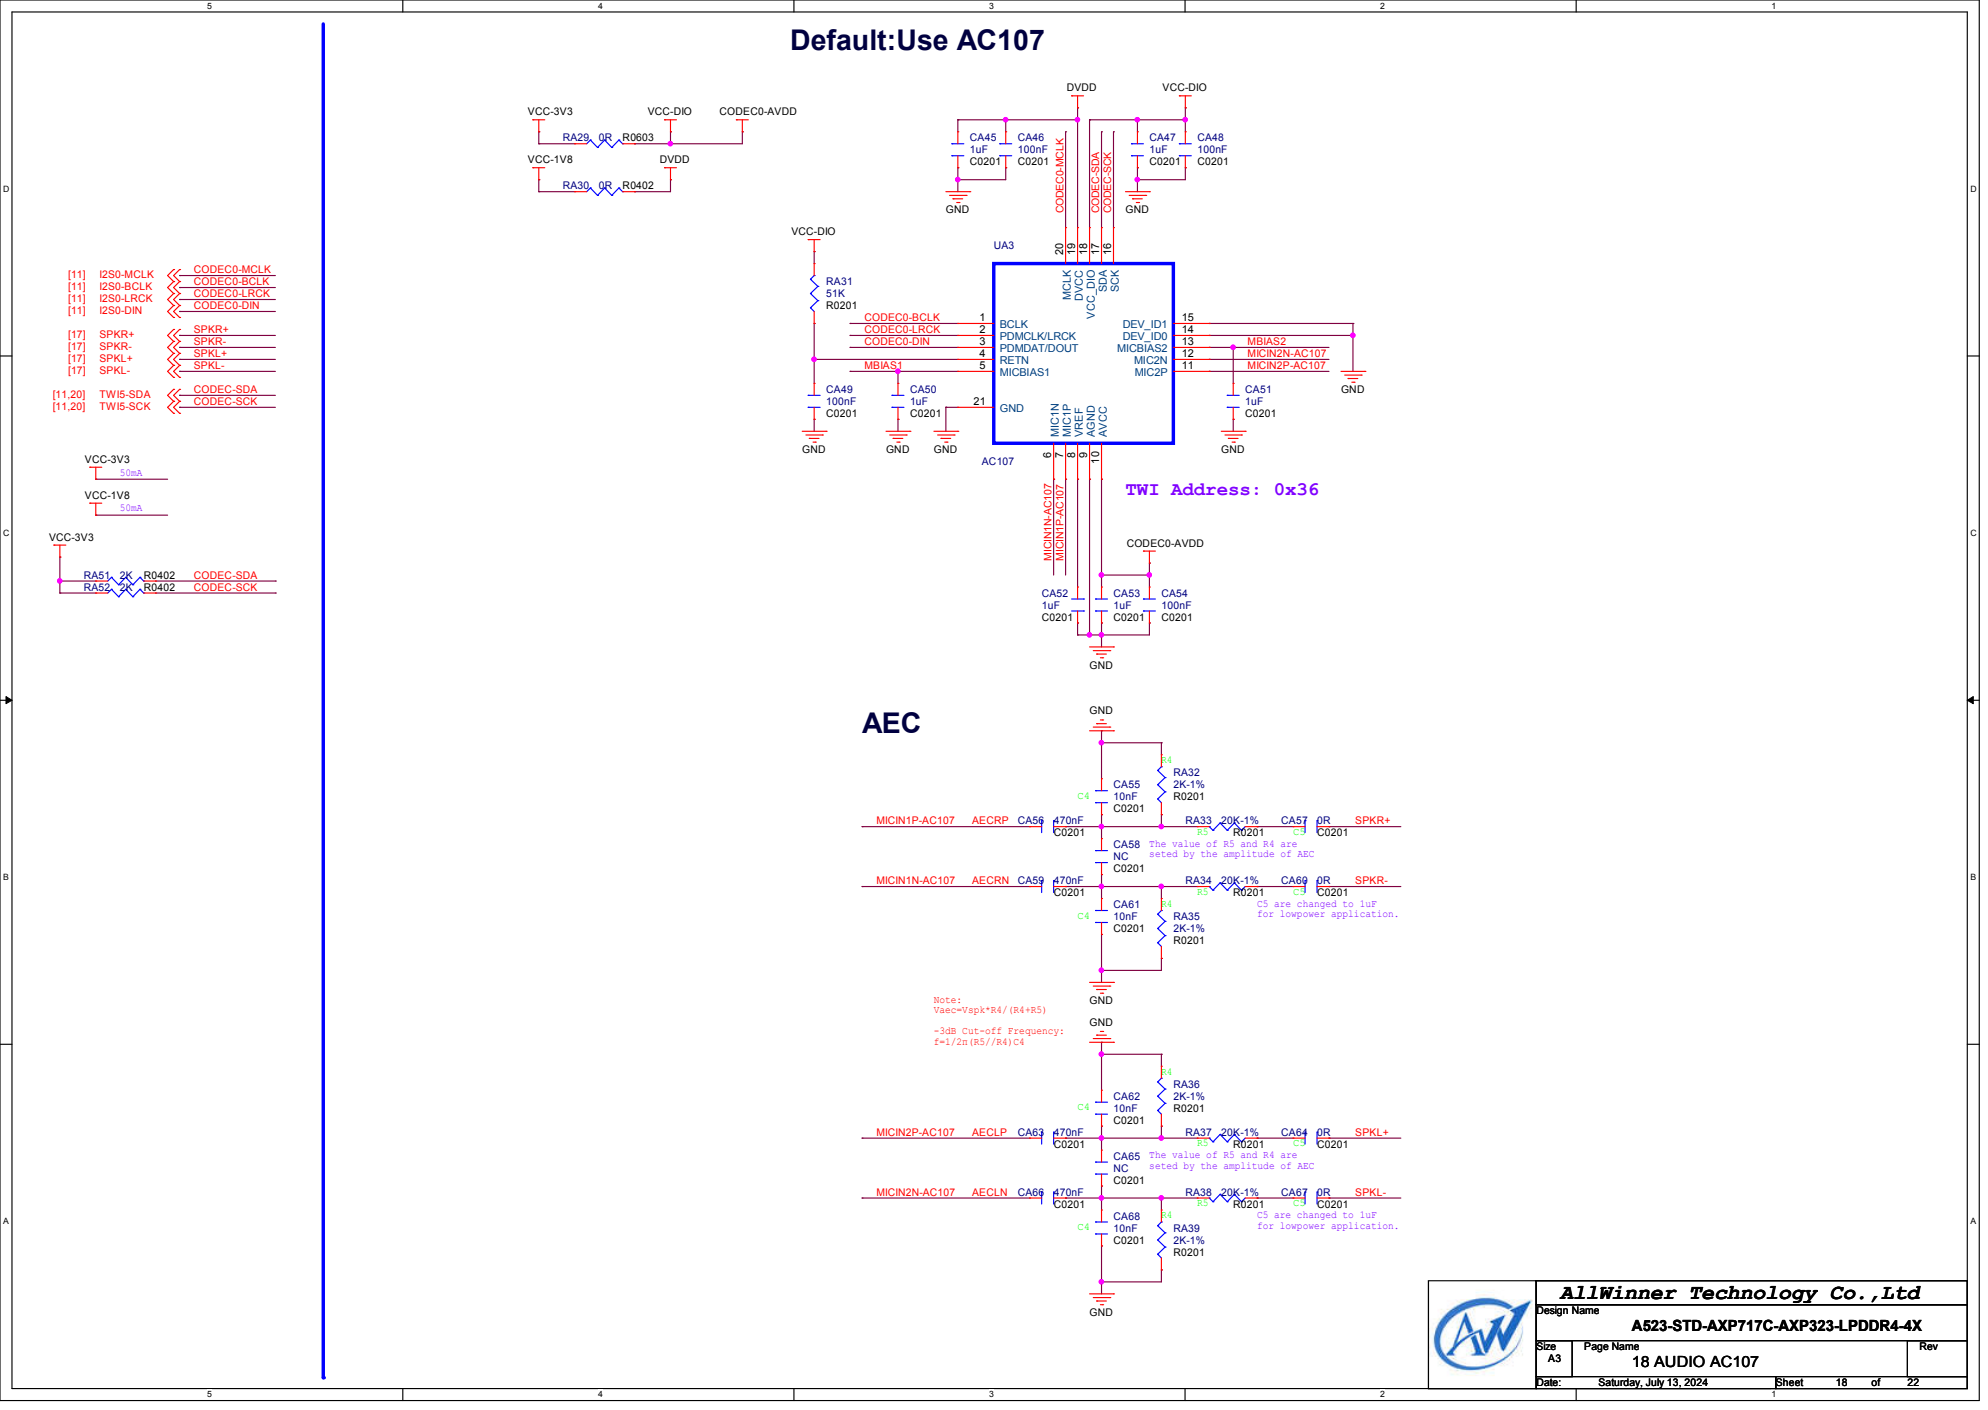
[picture p346: page 21]

The value of R5 and R4 are
seted by the amplitude of AEC

AllWinner Technology Co.,Ltd

### 50 Ohm Impedance

# XR829 ON BOARD

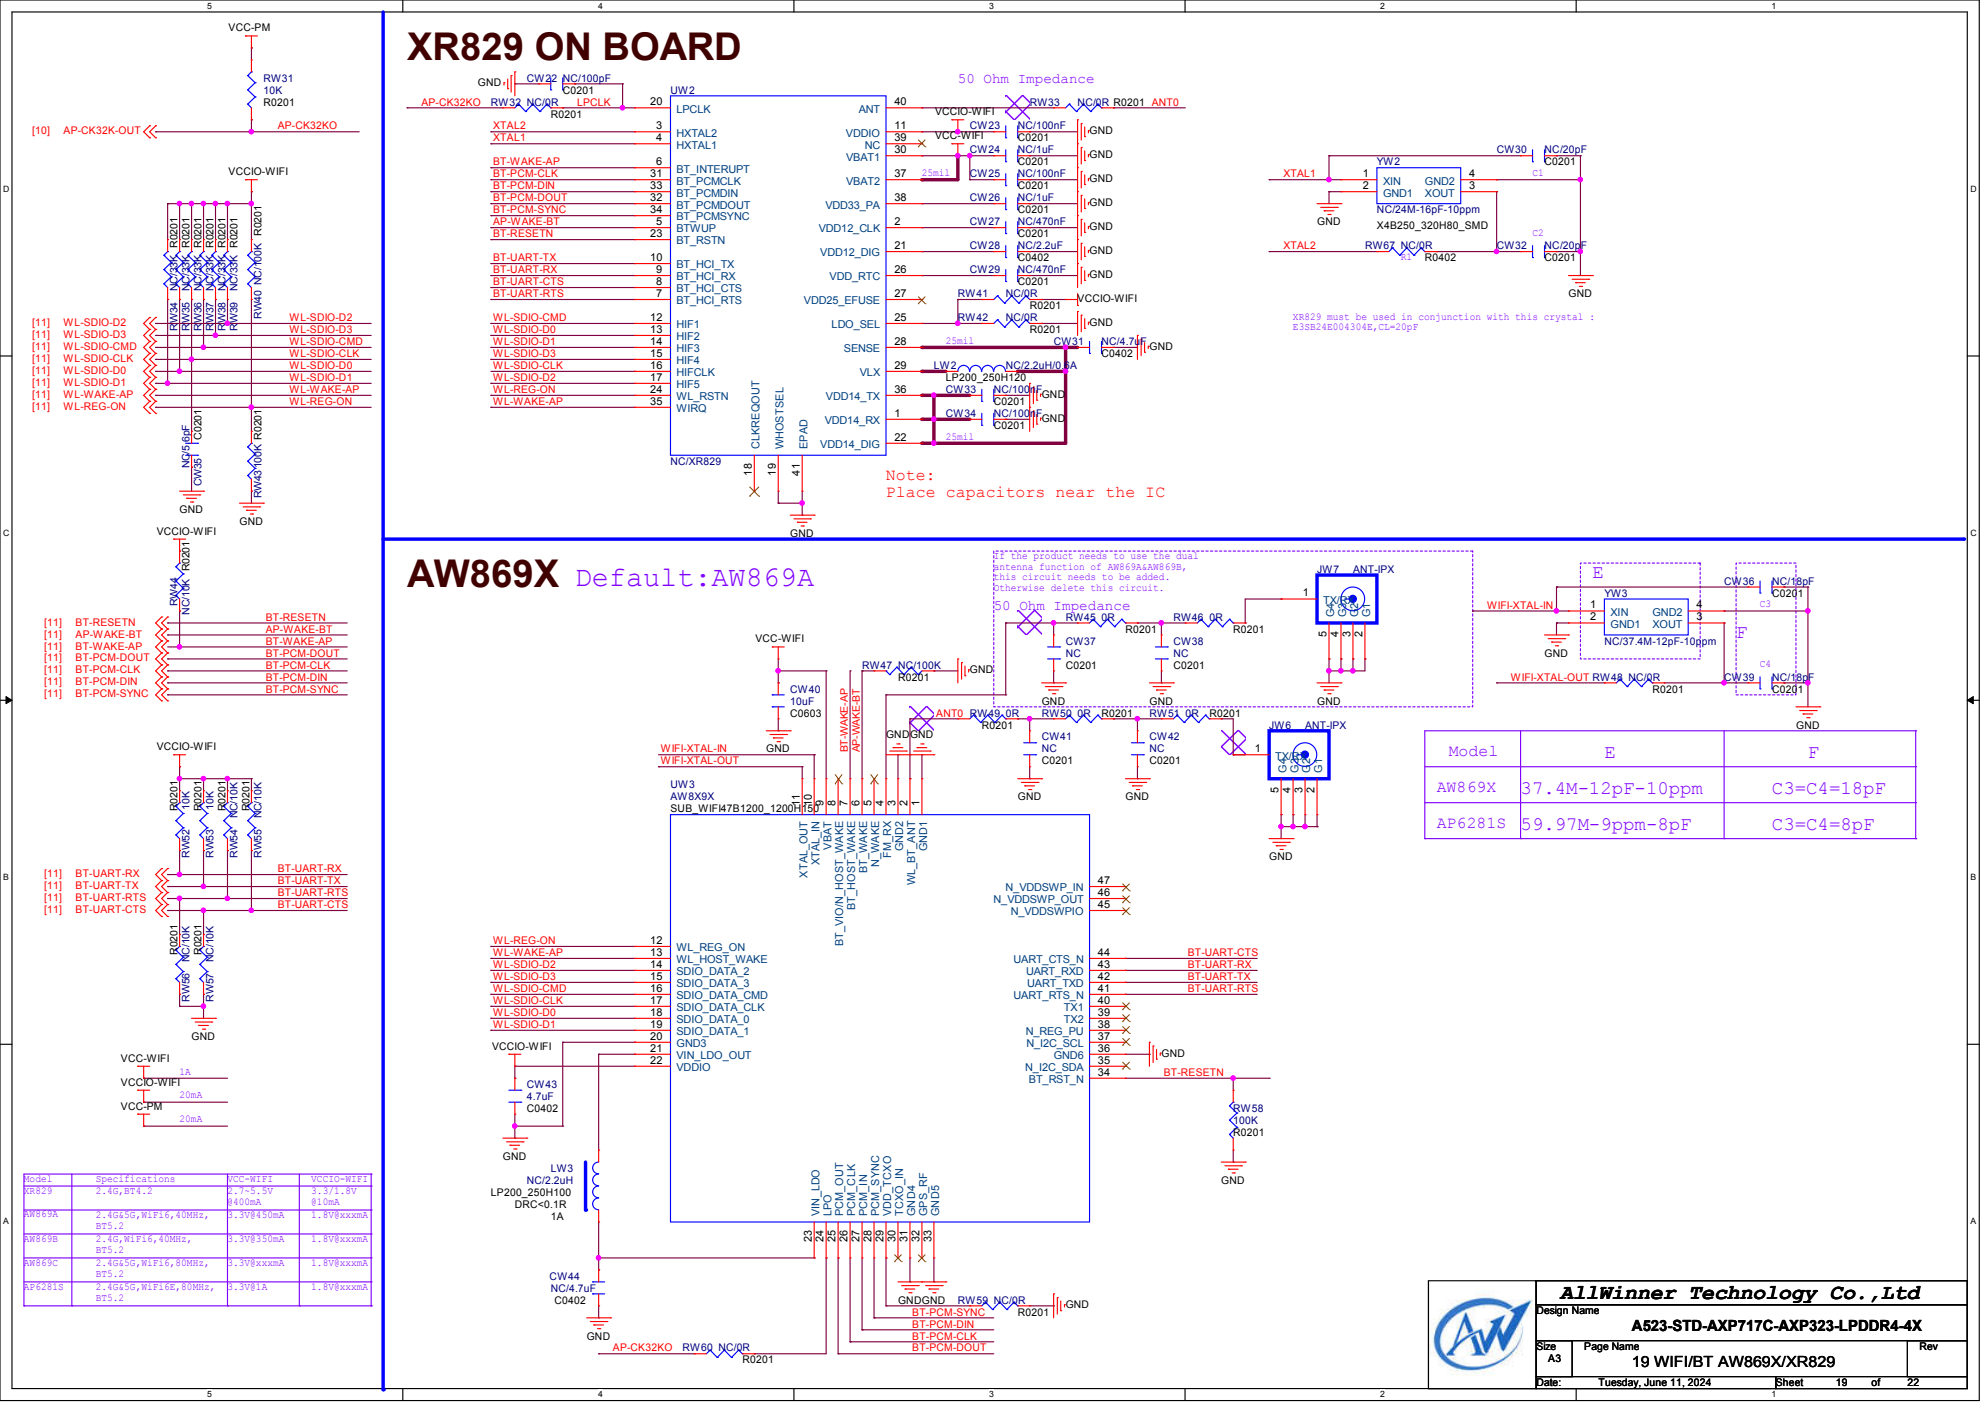
[picture p347: page 22]

XR829 must be used in conjunction with this crystal :

Note:
Place capacitors near the IC

If the product needs to use the dual
antenna function of AW869A&AW869B,

Model | E | F

AW869X | 37.4M-12pF-10ppm | C3=C4=18pF

AP6281S | 59.97M-9ppm-8pF | C3=C4=8pF

Model | Specifications | VCC-WIFI | VCCIO-WIFI
XR829 | 2.4G,BT4.2 | @400mA 2.7~5.5V | 3.3/1.8V @10mA

AW869A | 2.4G&5G,WiFi6,40MHz, BT5.2 | 3.3V@450mA | 1.8V@xxxmA

AW869B | 2.4G,WiFi6,40MHz, BT5.2 | 3.3V@350mA | 1.8V@xxxmA

AllWinner Technology Co.,Ltd

### 50 Ohm Impedance 50 Ohm Impedance

# AP6275P

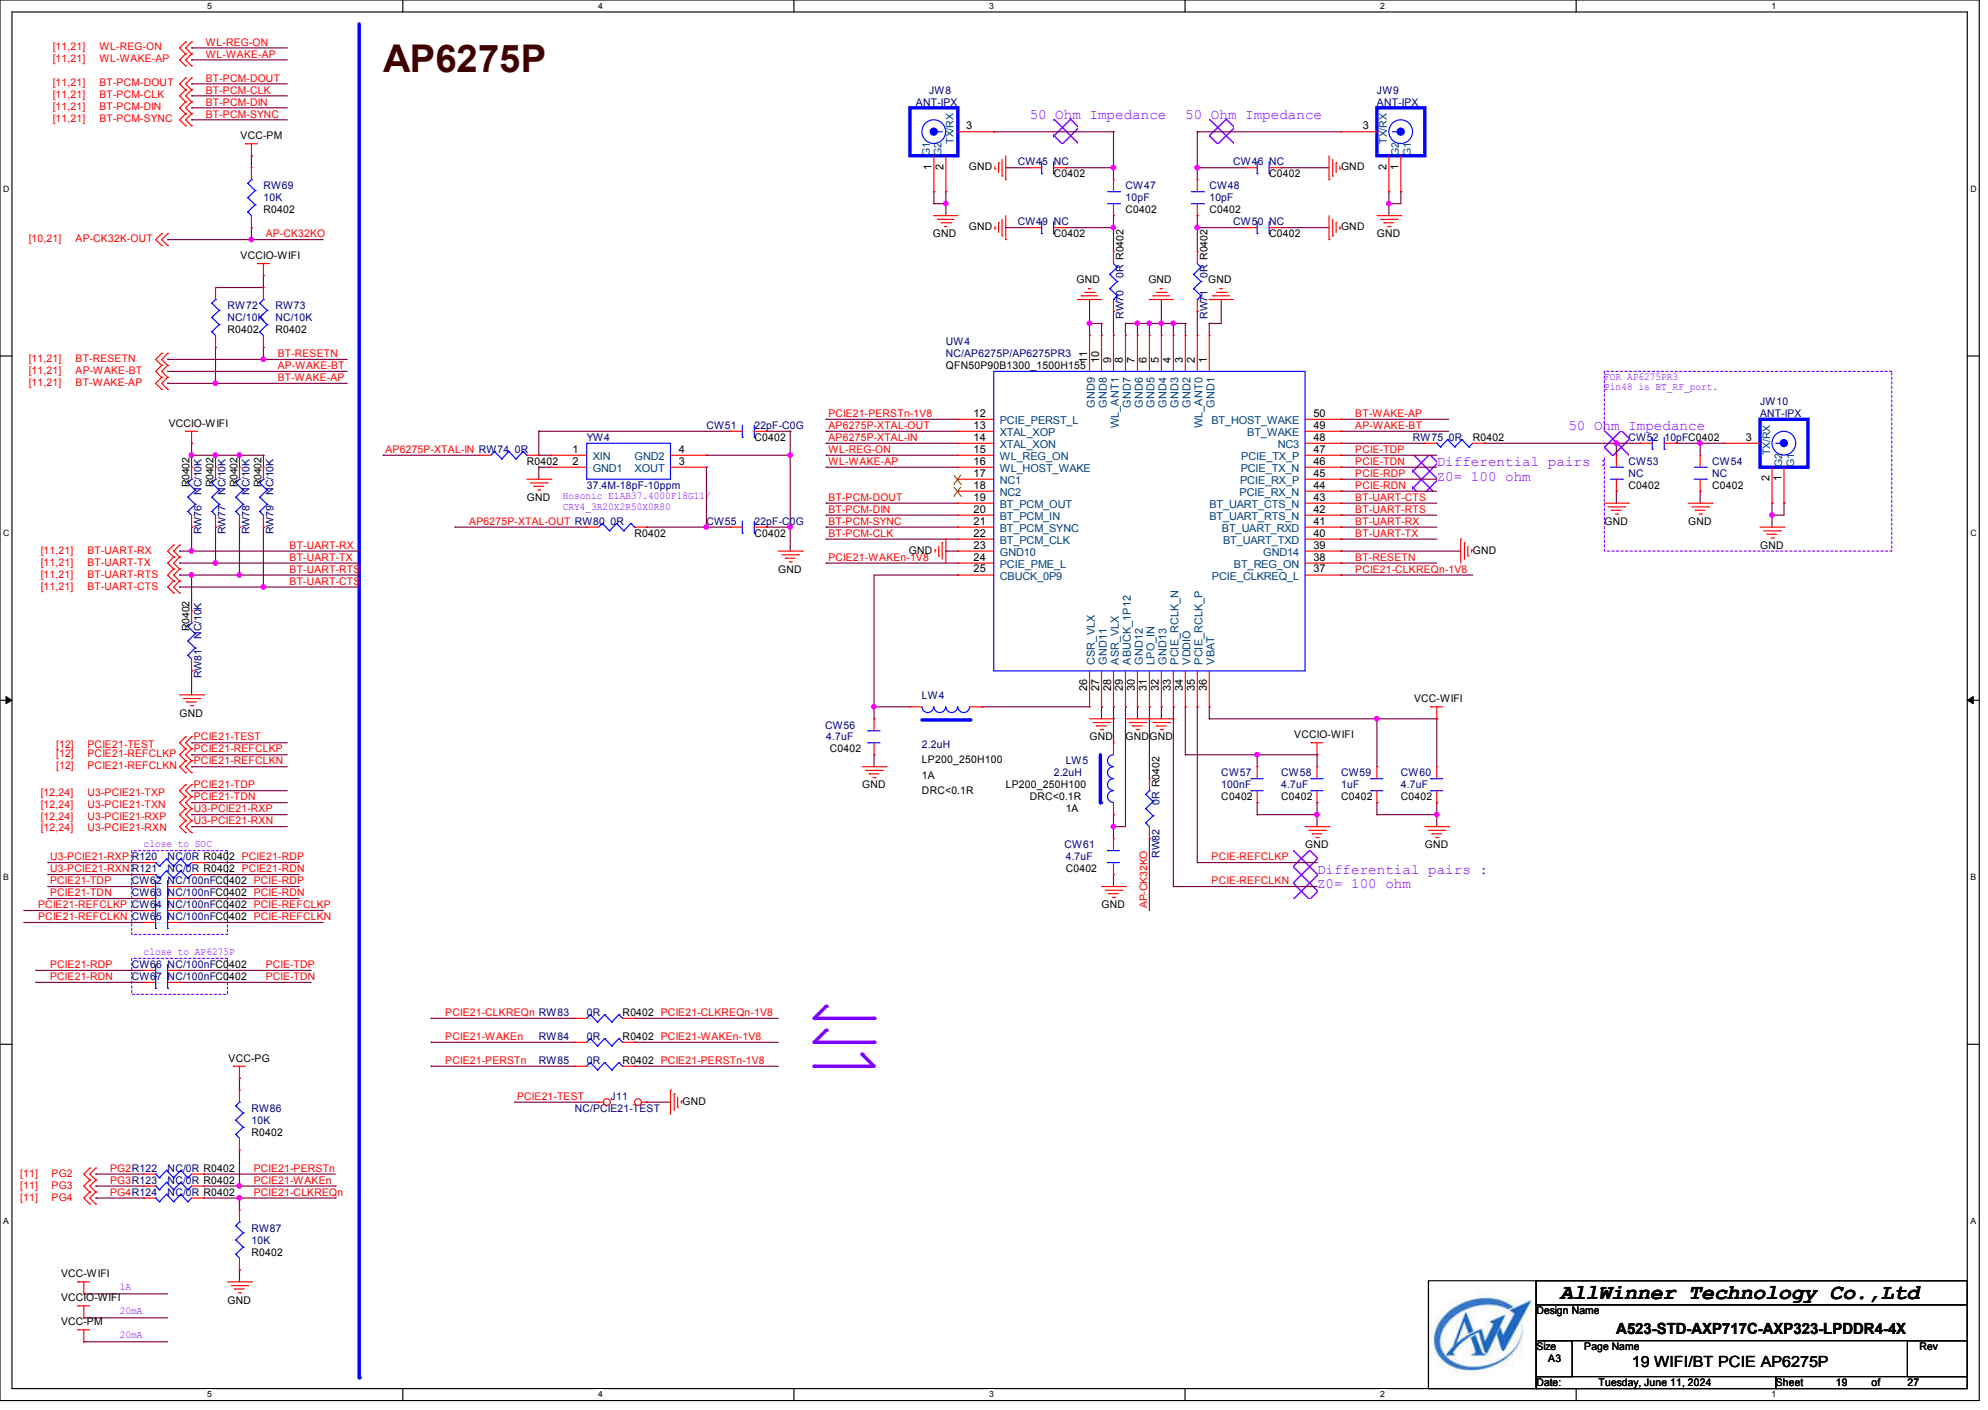
[picture p348: page 23]

AllWinner Technology Co.,Ltd

# USB3.0 HOST&USB2.0 OTG

### Differential pairs :

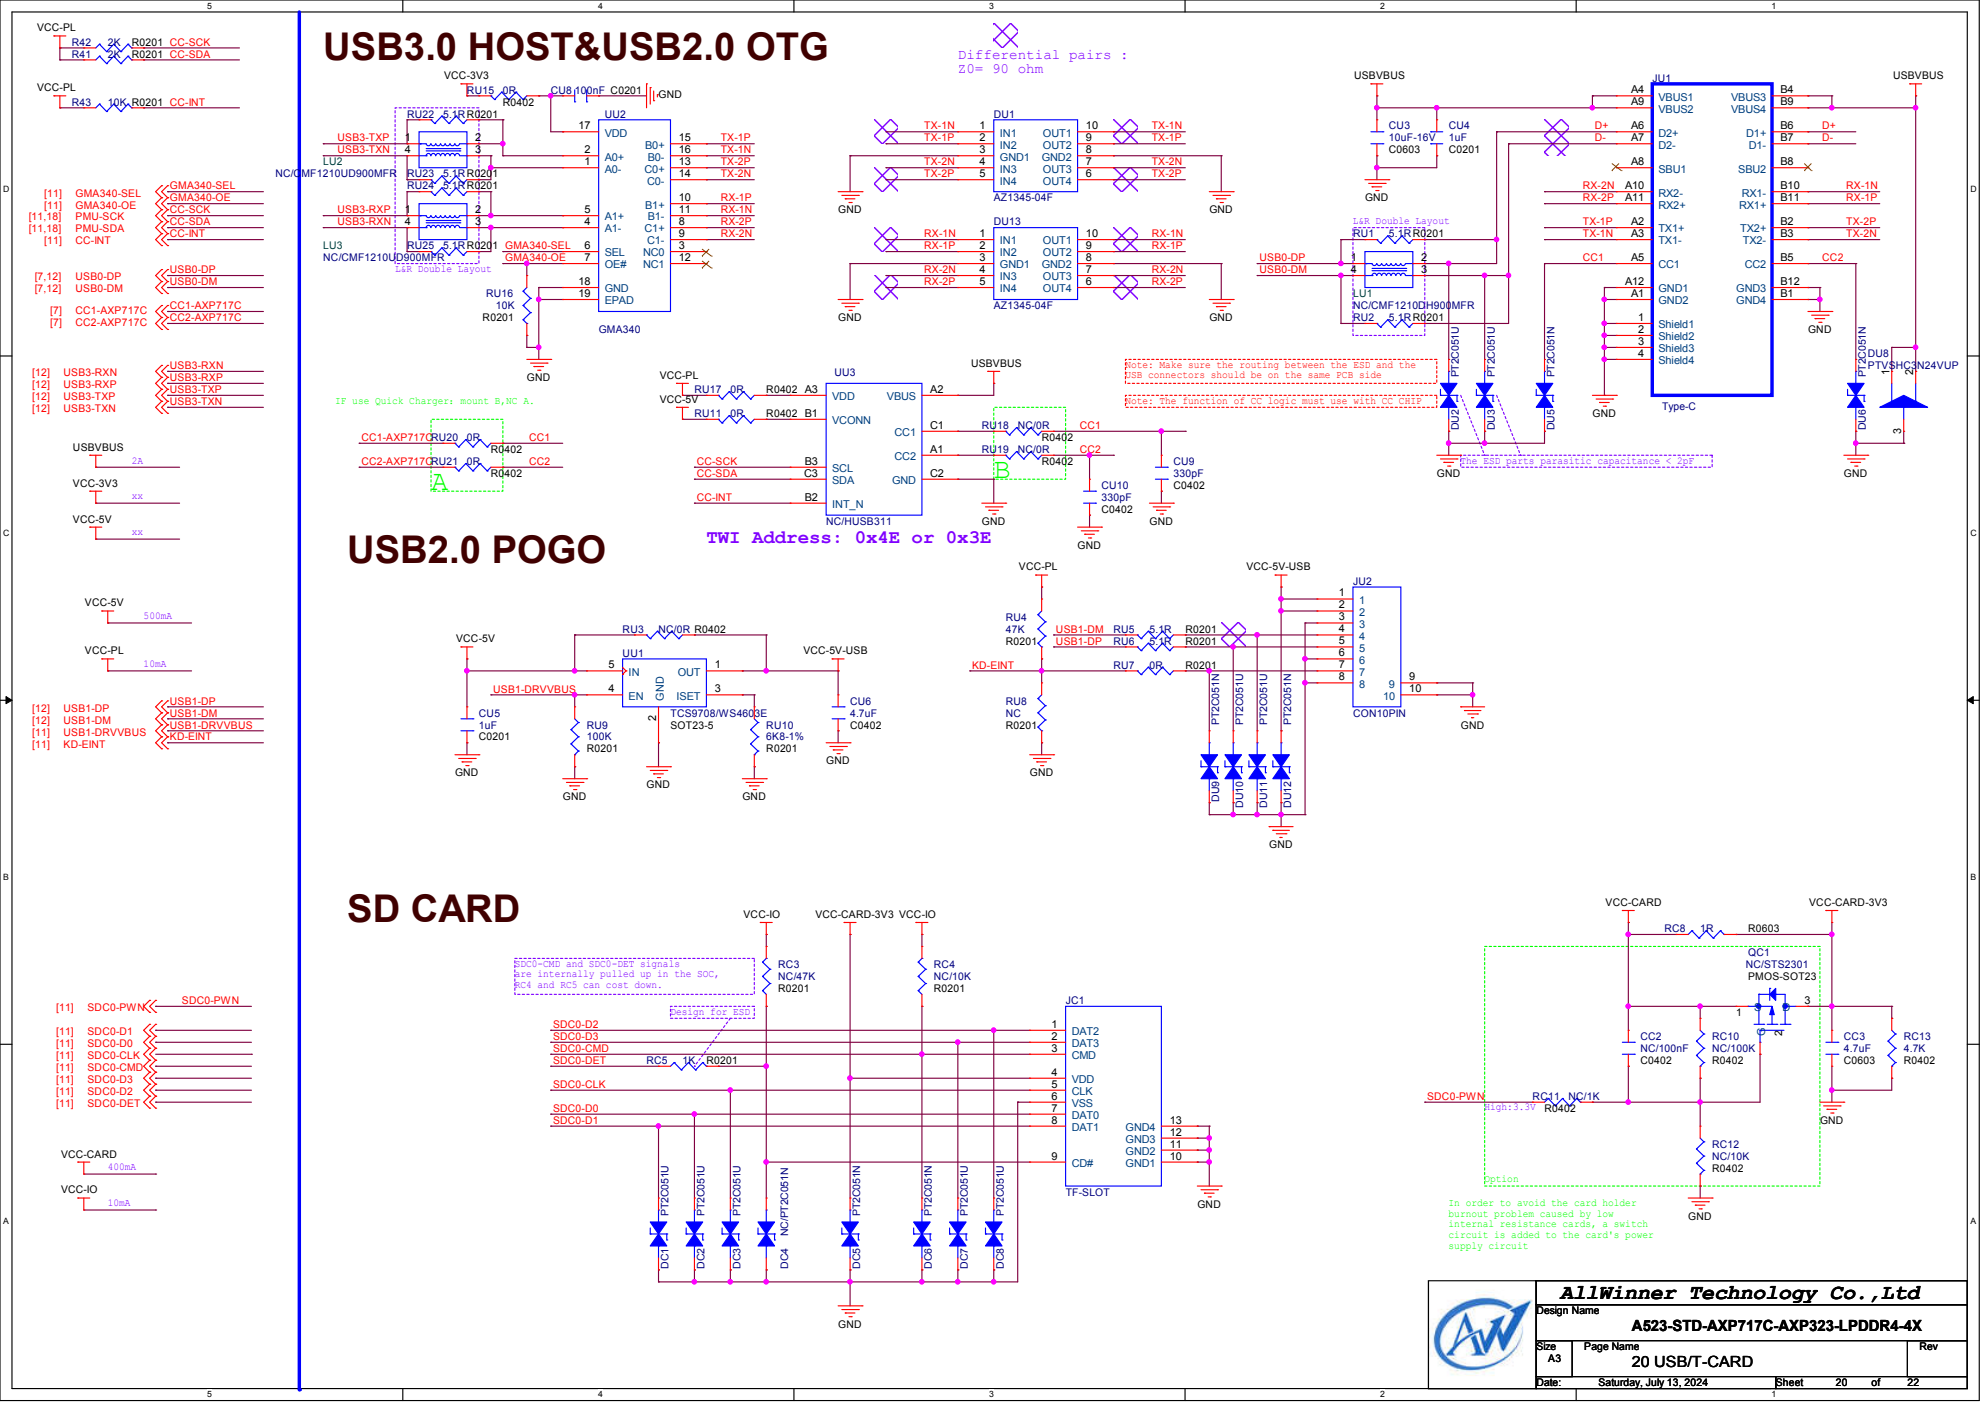
[picture p349: page 24]
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

IF use Quick Charger：mount B,NC A.

Note: The function of CC logic must use with CC CHIP

The ESD parts parasitic capacitance < 2pF

SDC0-CMD and SDC0-DET signals
are internally pulled up in the SOC,
RC4 and RC5 can cost down.

In order to avoid the card holder
burnout problem caused by low
internal resistance cards, a switch
circuit is added to the card's power
supply circuit

AllWinner Technology Co.,Ltd

# KEY

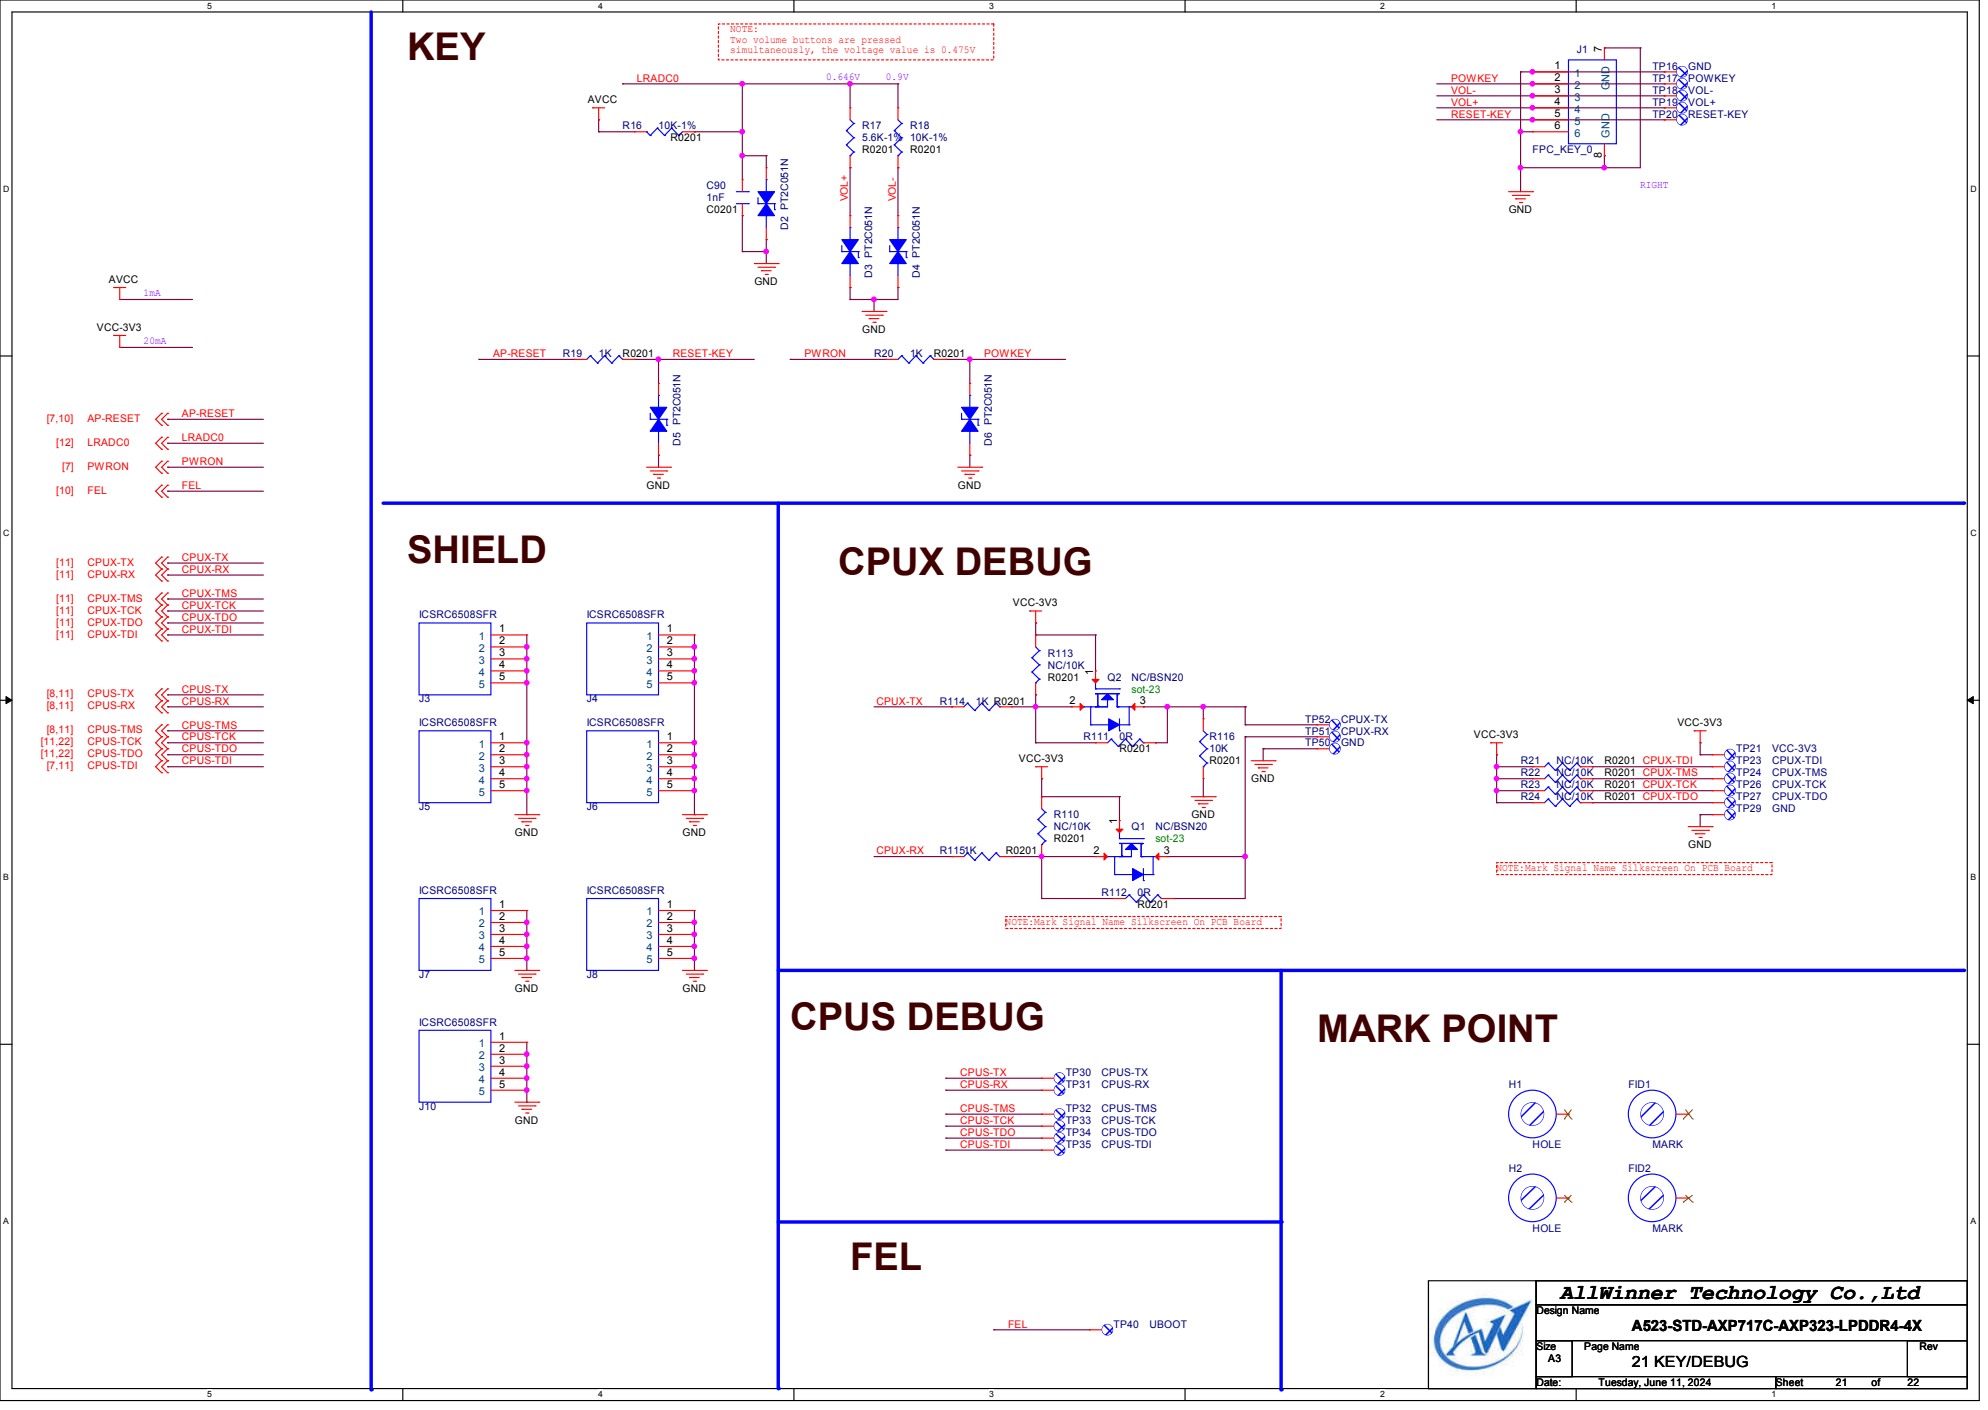
[picture p350: page 25]

NOTE:
Two volume buttons are pressed
simultaneously, the voltage value is 0.475V

NOTE:Mark Signal Name Silkscreen On PCB Board

AllWinner Technology Co.,Ltd

# Gyroscope Hall switch

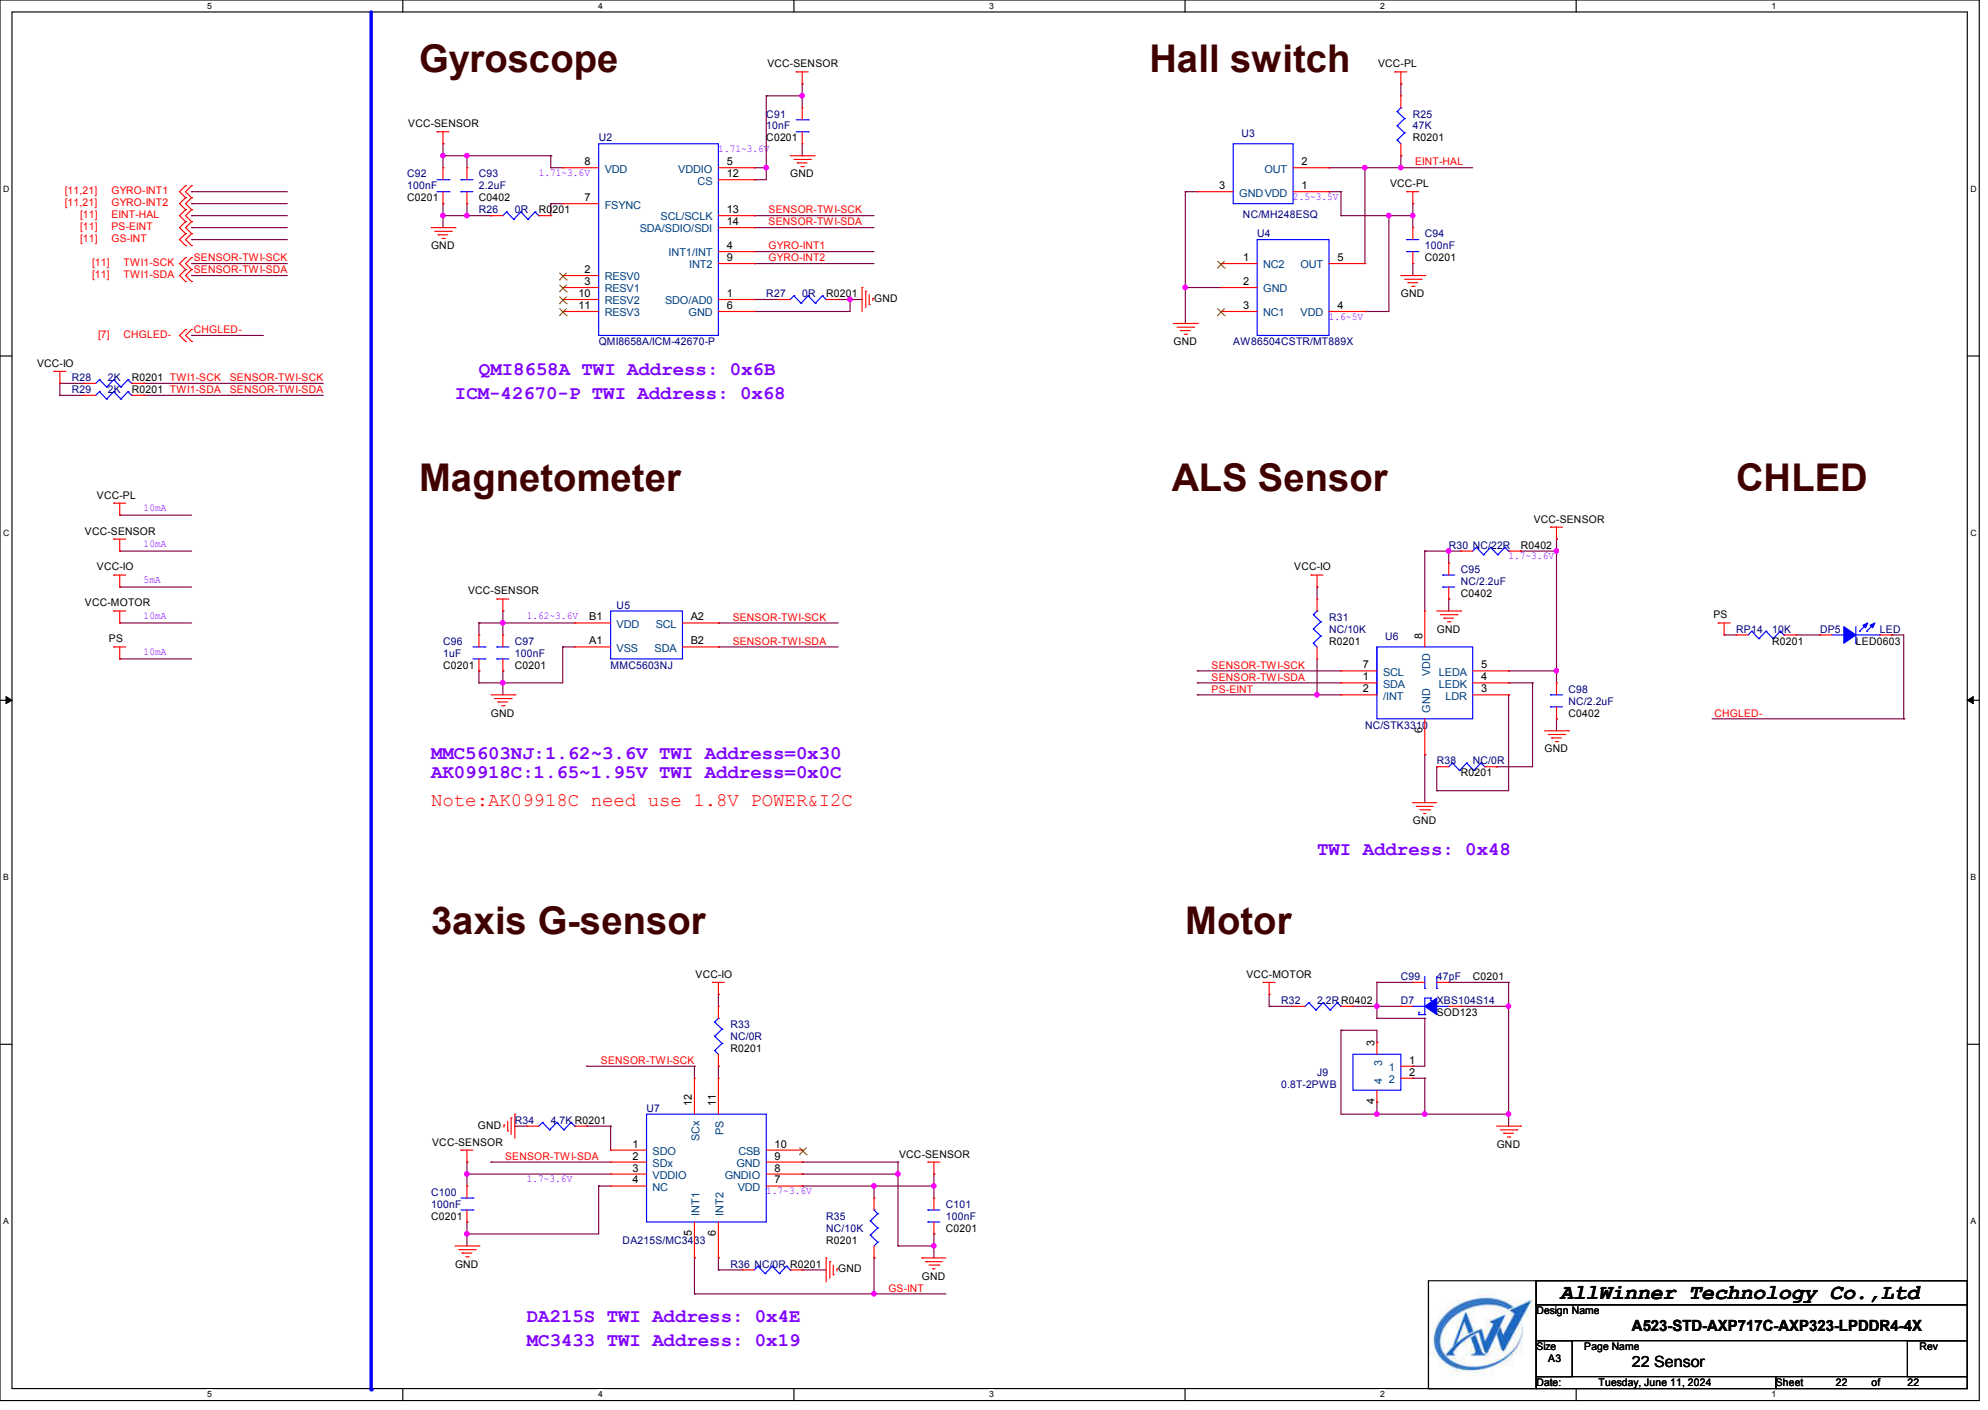
[picture p351: page 26]

TWI1-SCK SENSOR-TWI-SCK
TWI1-SDA SENSOR-TWI-SDA

MMC5603NJ:1.62~3.6V TWI Address=0x30
AK09918C:1.65~1.95V TWI Address=0x0C
Note:AK09918C need use 1.8V POWER&I2C

AllWinner Technology Co.,Ltd

For LDO mode | For SWR mode

# RGMII

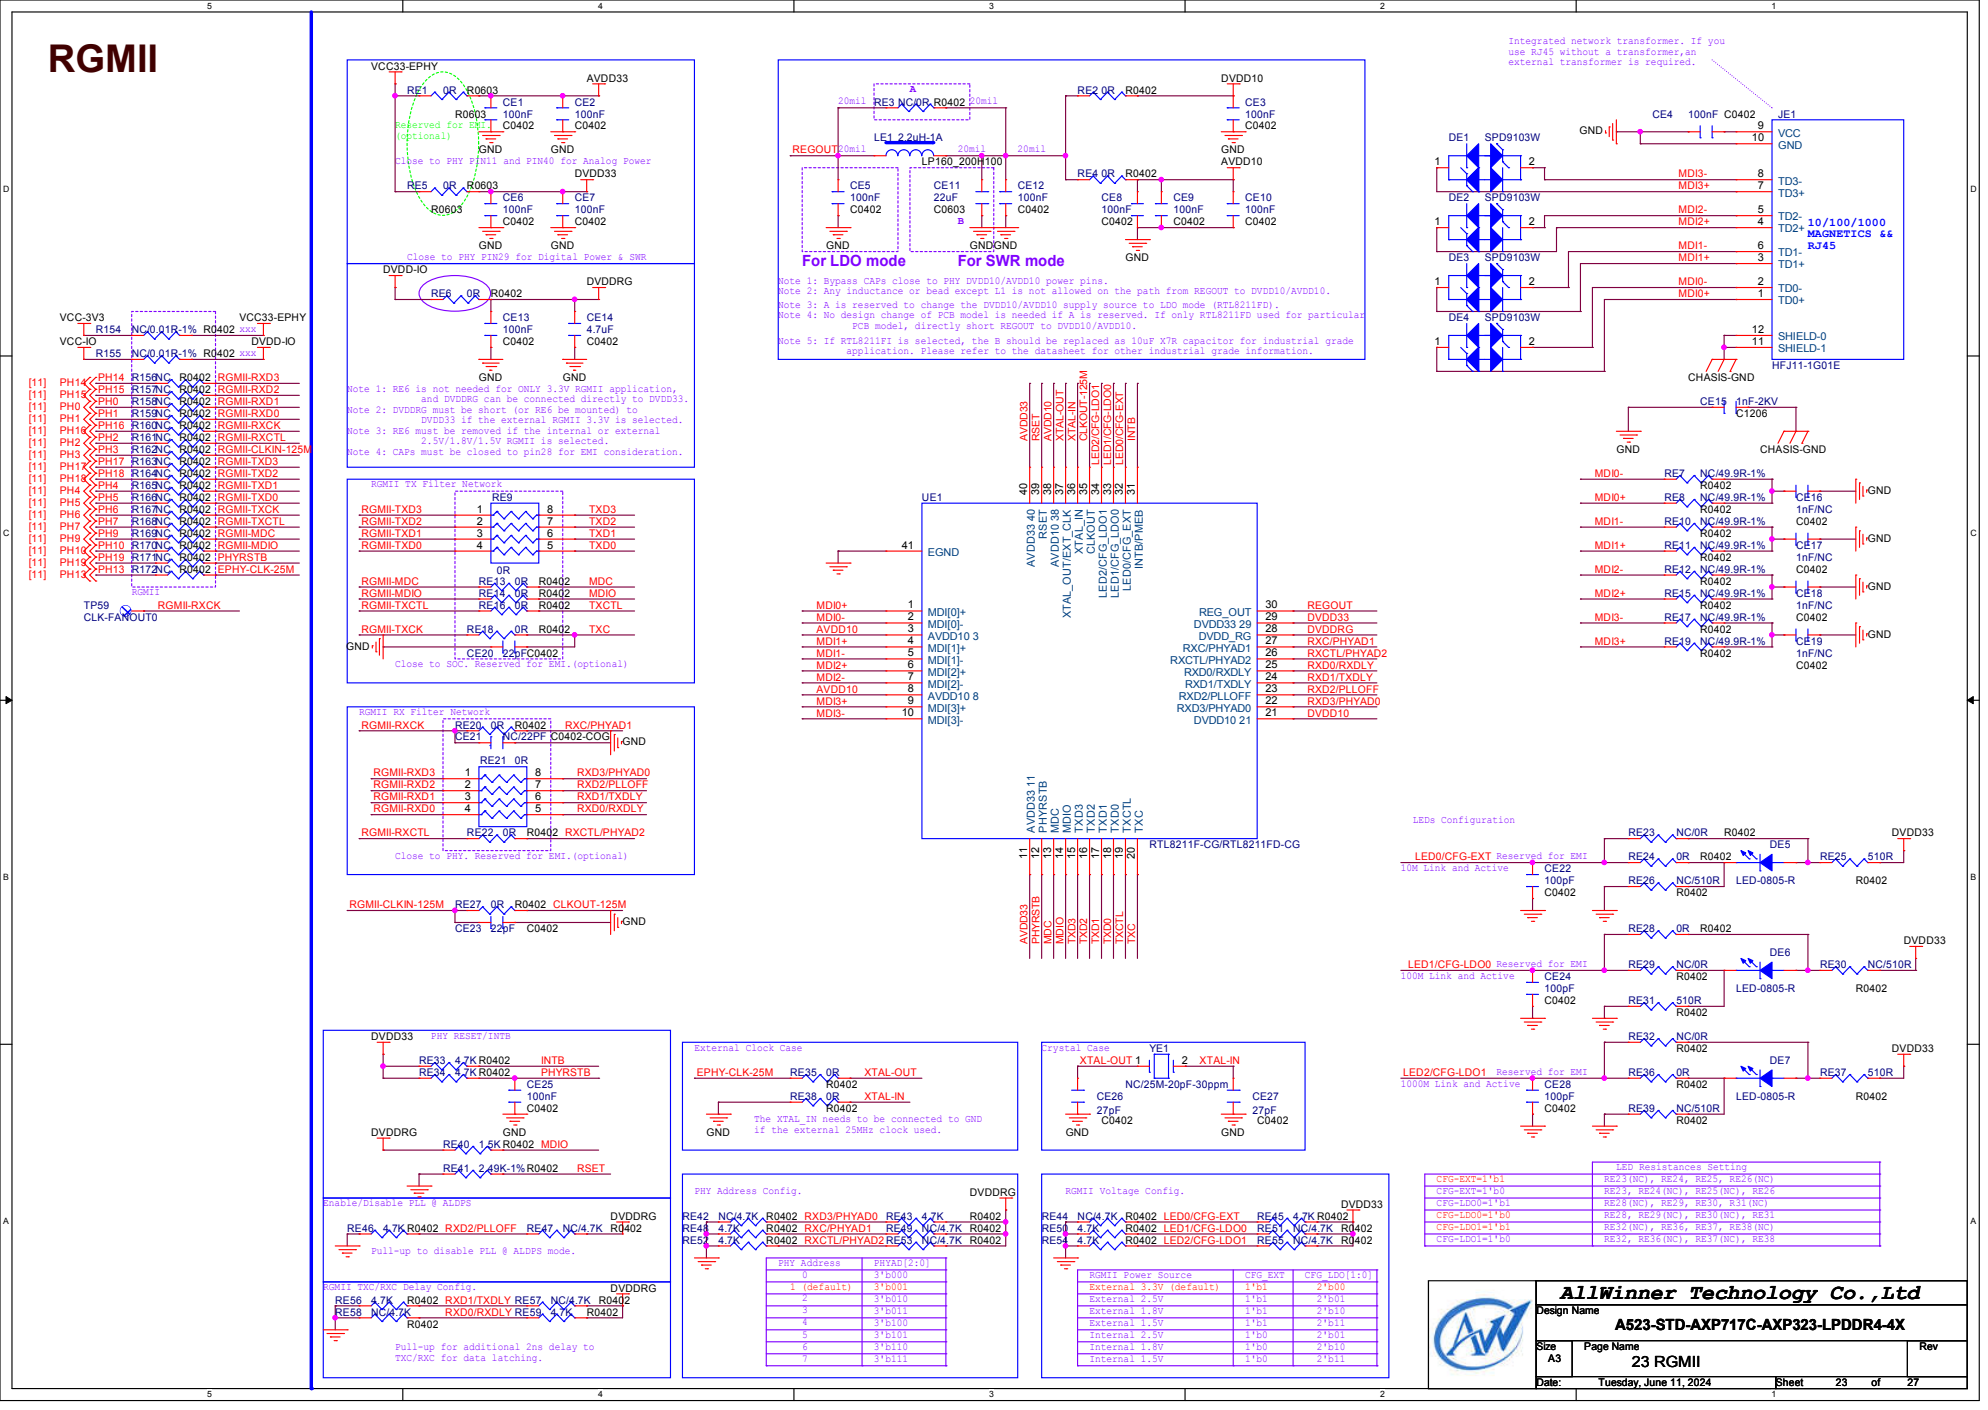
[picture p352: page 27]

Integrated network transformer. If you
use RJ45 without a transformer,an
external transformer is required.

Close to PHY PIN11 and PIN40 for Analog Power

Close to PHY PIN29 for Digital Power & SWR
DVDD-IO

Note 1: Bypass CAPs close to PHY DVDD10/AVDD10 power pins.
Note 2: Any inductance or bead except L1 is not allowed on the path from REGOUT to DVDD10/AVDD10.
Note 3: A is reserved to change the DVDD10/AVDD10 supply source to LDO mode (RTL8211FD).
Note 4: No design change of PCB model is needed if A is reserved. If only RTL8211FD used for particular

PCB model, directly short REGOUT to DVDD10/AVDD10.

Note 5: If RTL8211FI is selected, the B should be replaced as 10uF X7R capacitor for industrial grade

application. Please refer to the datasheet for other industrial grade information.

Note 1: RE6 is not needed for ONLY 3.3V RGMII application,

Note 2: DVDDRG must be short (or RE6 be mounted) to

and DVDDRG can be connected directly to DVDD33.

Note 3: RE6 must be removed if the internal or external

DVDD33 if the external RGMII 3.3V is selected.

Note 4: CAPs must be closed to pin28 for EMI consideration.

RGMII TX Filter Network

Close to SOC. Reserved for EMI.(optional)

RGMII RX Filter Network
RGMII-RXCK

Close to PHY. Reserved for EMI.(optional)

The XTAL_IN needs to be connected to GND
if the external 25MHz clock used.

CFG-EXT=1'b1 | RE23(NC), RE24, RE25, RE26(NC)
CFG-EXT=1'b0 | RE23, RE24(NC), RE25(NC), RE26
CFG-LDO0=1'b1 | RE28(NC), RE29, RE30, R31(NC)
CFG-LDO0=1'b0 | RE28, RE29(NC), RE30(NC), RE31
CFG-LDO1=1'b1 | RE32(NC), RE36, RE37, RE38(NC)
CFG-LDO1=1'b0 | RE32, RE36(NC), RE37(NC), RE38

Enable/Disable PLL @ ALDPS

Pull-up to disable PLL @ ALDPS mode.

RGMII TXC/RXC Delay Config.

AllWinner Technology Co.,Ltd

Pull-up for additional 2ns delay to
TXC/RXC for data latching.

# DMIC

# R0402 D¹² ESD⁵⁴⁵¹X⁻²⁻TR

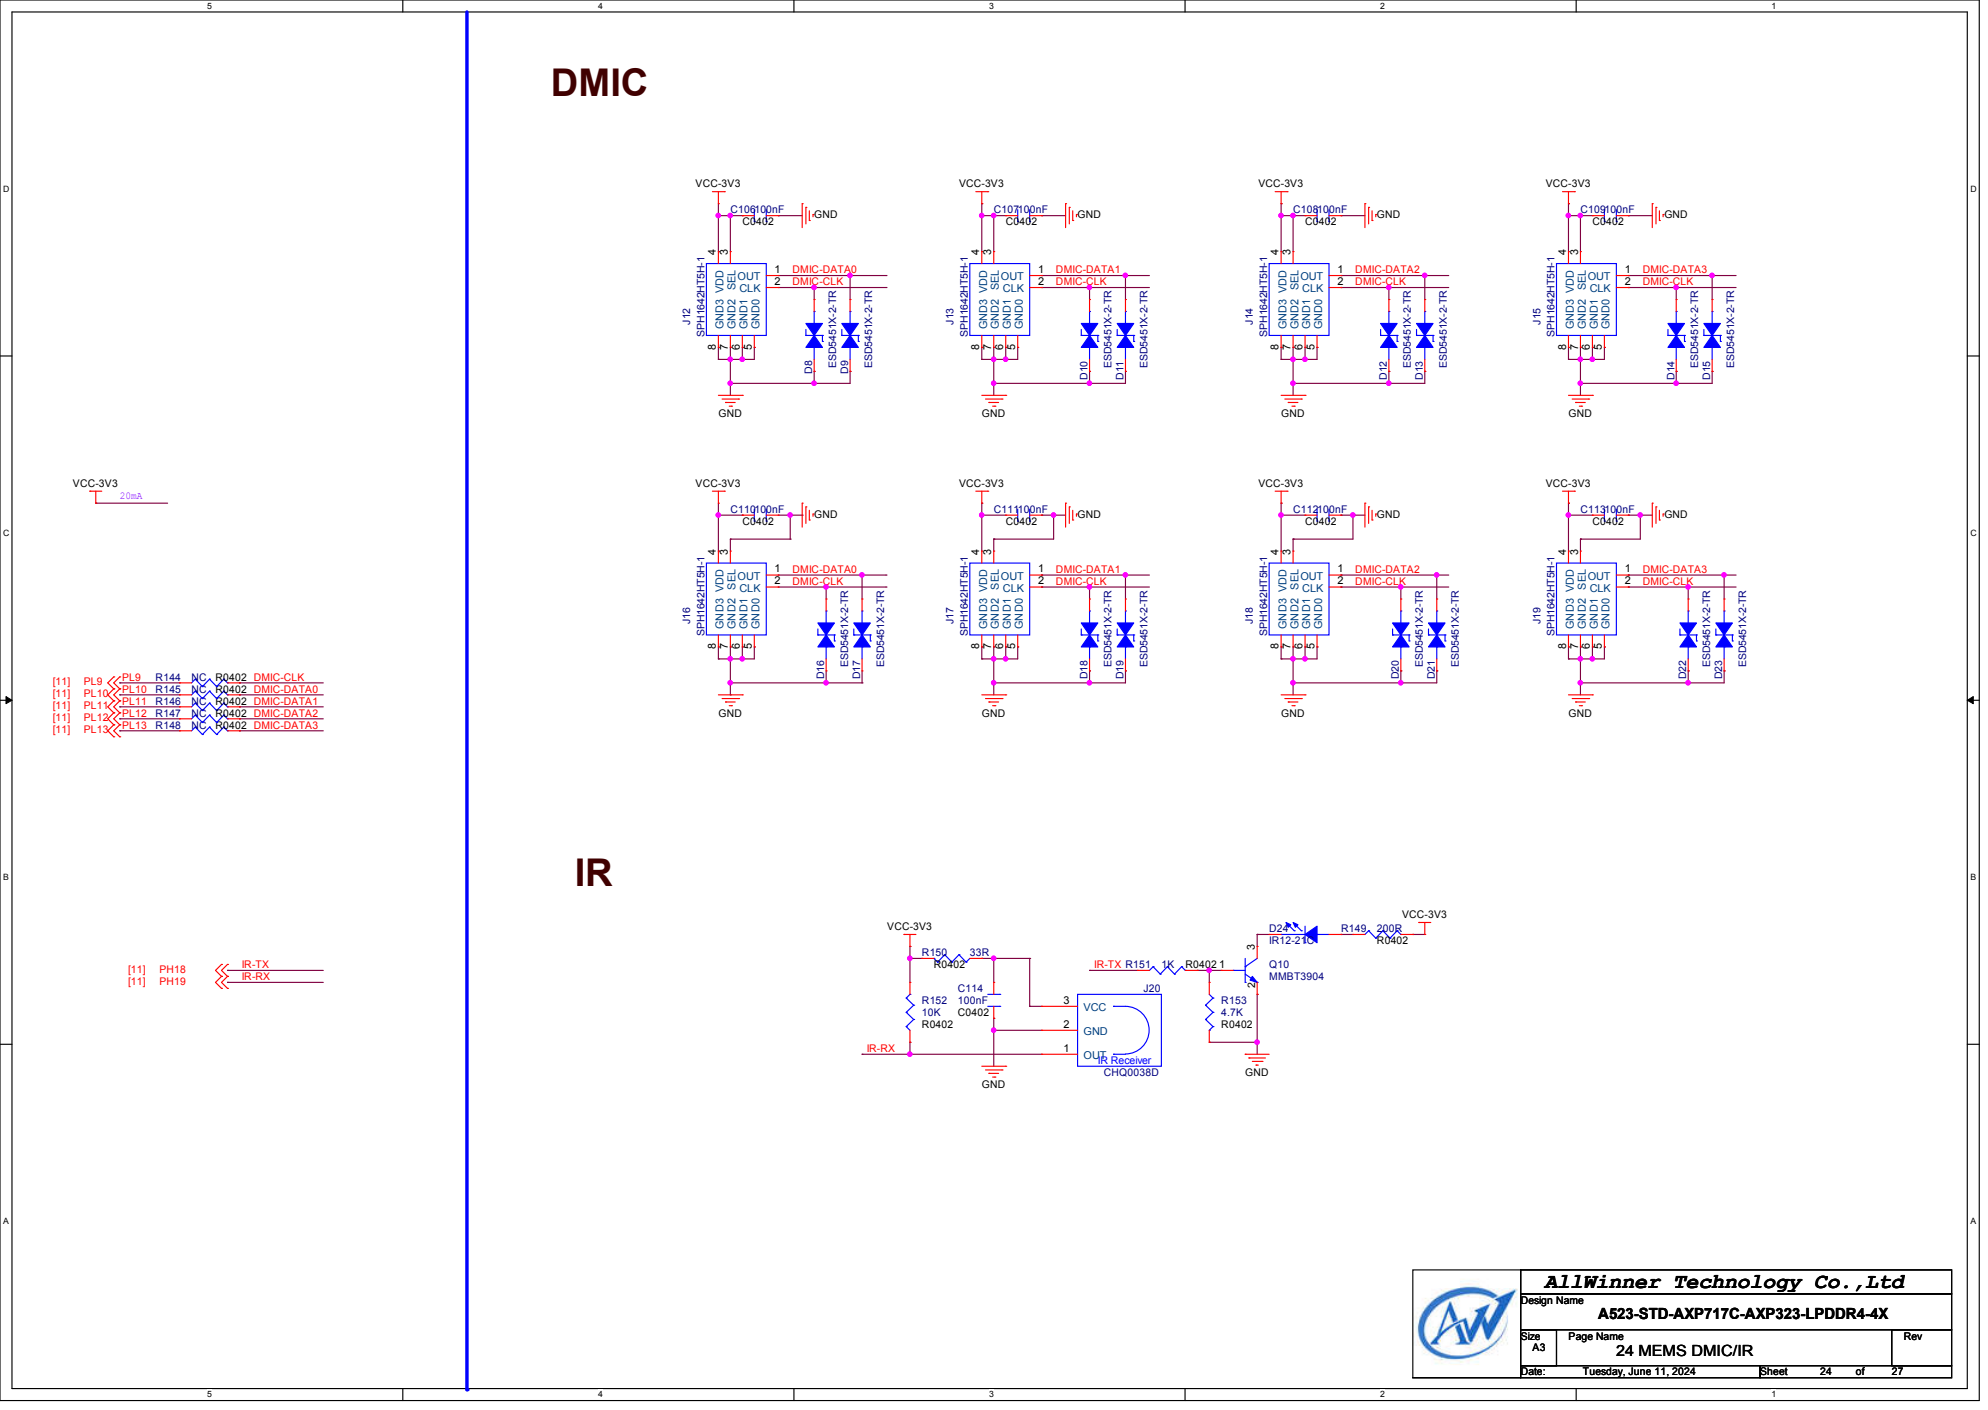
[picture p353: page 28]

AllWinner Technology Co.,Ltd

# QUICK CHARGER -1 CELL

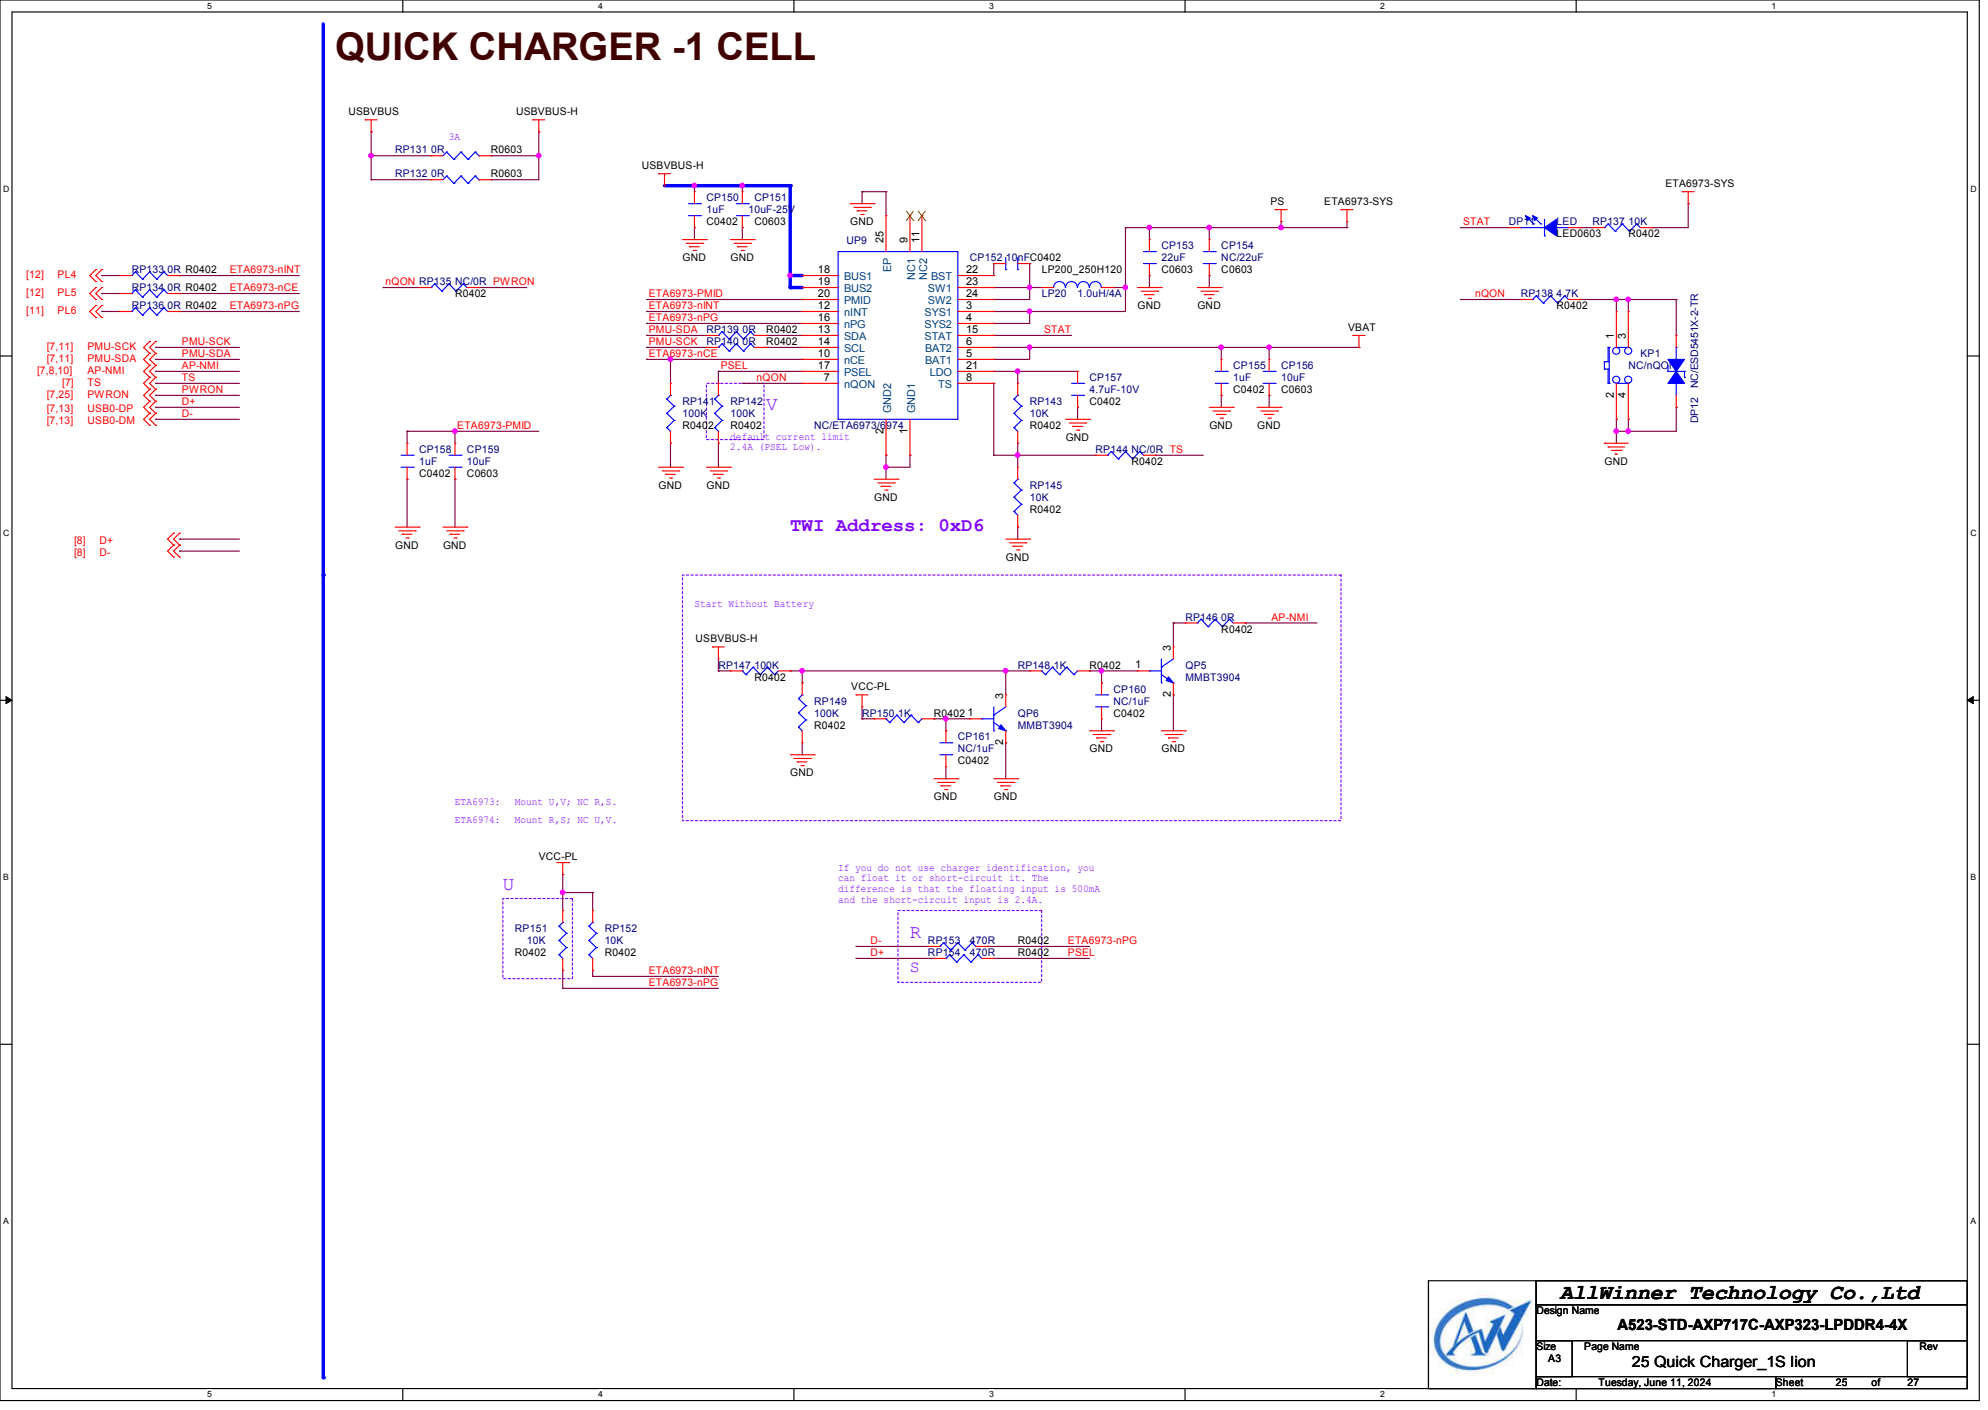
[picture p354: page 29]
default current limit 2.4A (PSEL Low).; TWI Address: 0xD6; ETA6973:; ETA6974:; Mount U,V; NC R,S.; Mount R,S; NC U,V.; STAT; nQON; PSEL; PMU-SCK PMU-SDA AP-NMI TS; ETA6973-PMID; PMU-SDA PMU-SCK; ETA6973-nINT ETA6973-nPG; AP-NMI; ETA6973-nPG; ETA6973-nINT; ETA6973-nCE; PWRON; GND; ETA6973-SYS; USBVBUS; USBVBUS-H; VCC-PL; VBAT; PMU-SCK; PMU-SDA; USB0-DM; USB0-DP; 25 Quick Charger_1S lion; Tuesday, June 11, 2024; KP1 NC/nQON; NC/ETA6973/6974; GND1 1; GND2 2; SYS1; SYS2; BAT1; 5 BAT2; nQON 7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

Start Without Battery

If you do not use charger identification, you
can float it or short-circuit it. The
difference is that the floating input is 500mA
and the short-circuit input is 2.4A.

AllWinner Technology Co.,Ltd

9V 2A

# QUICK CHARGER -nCELL

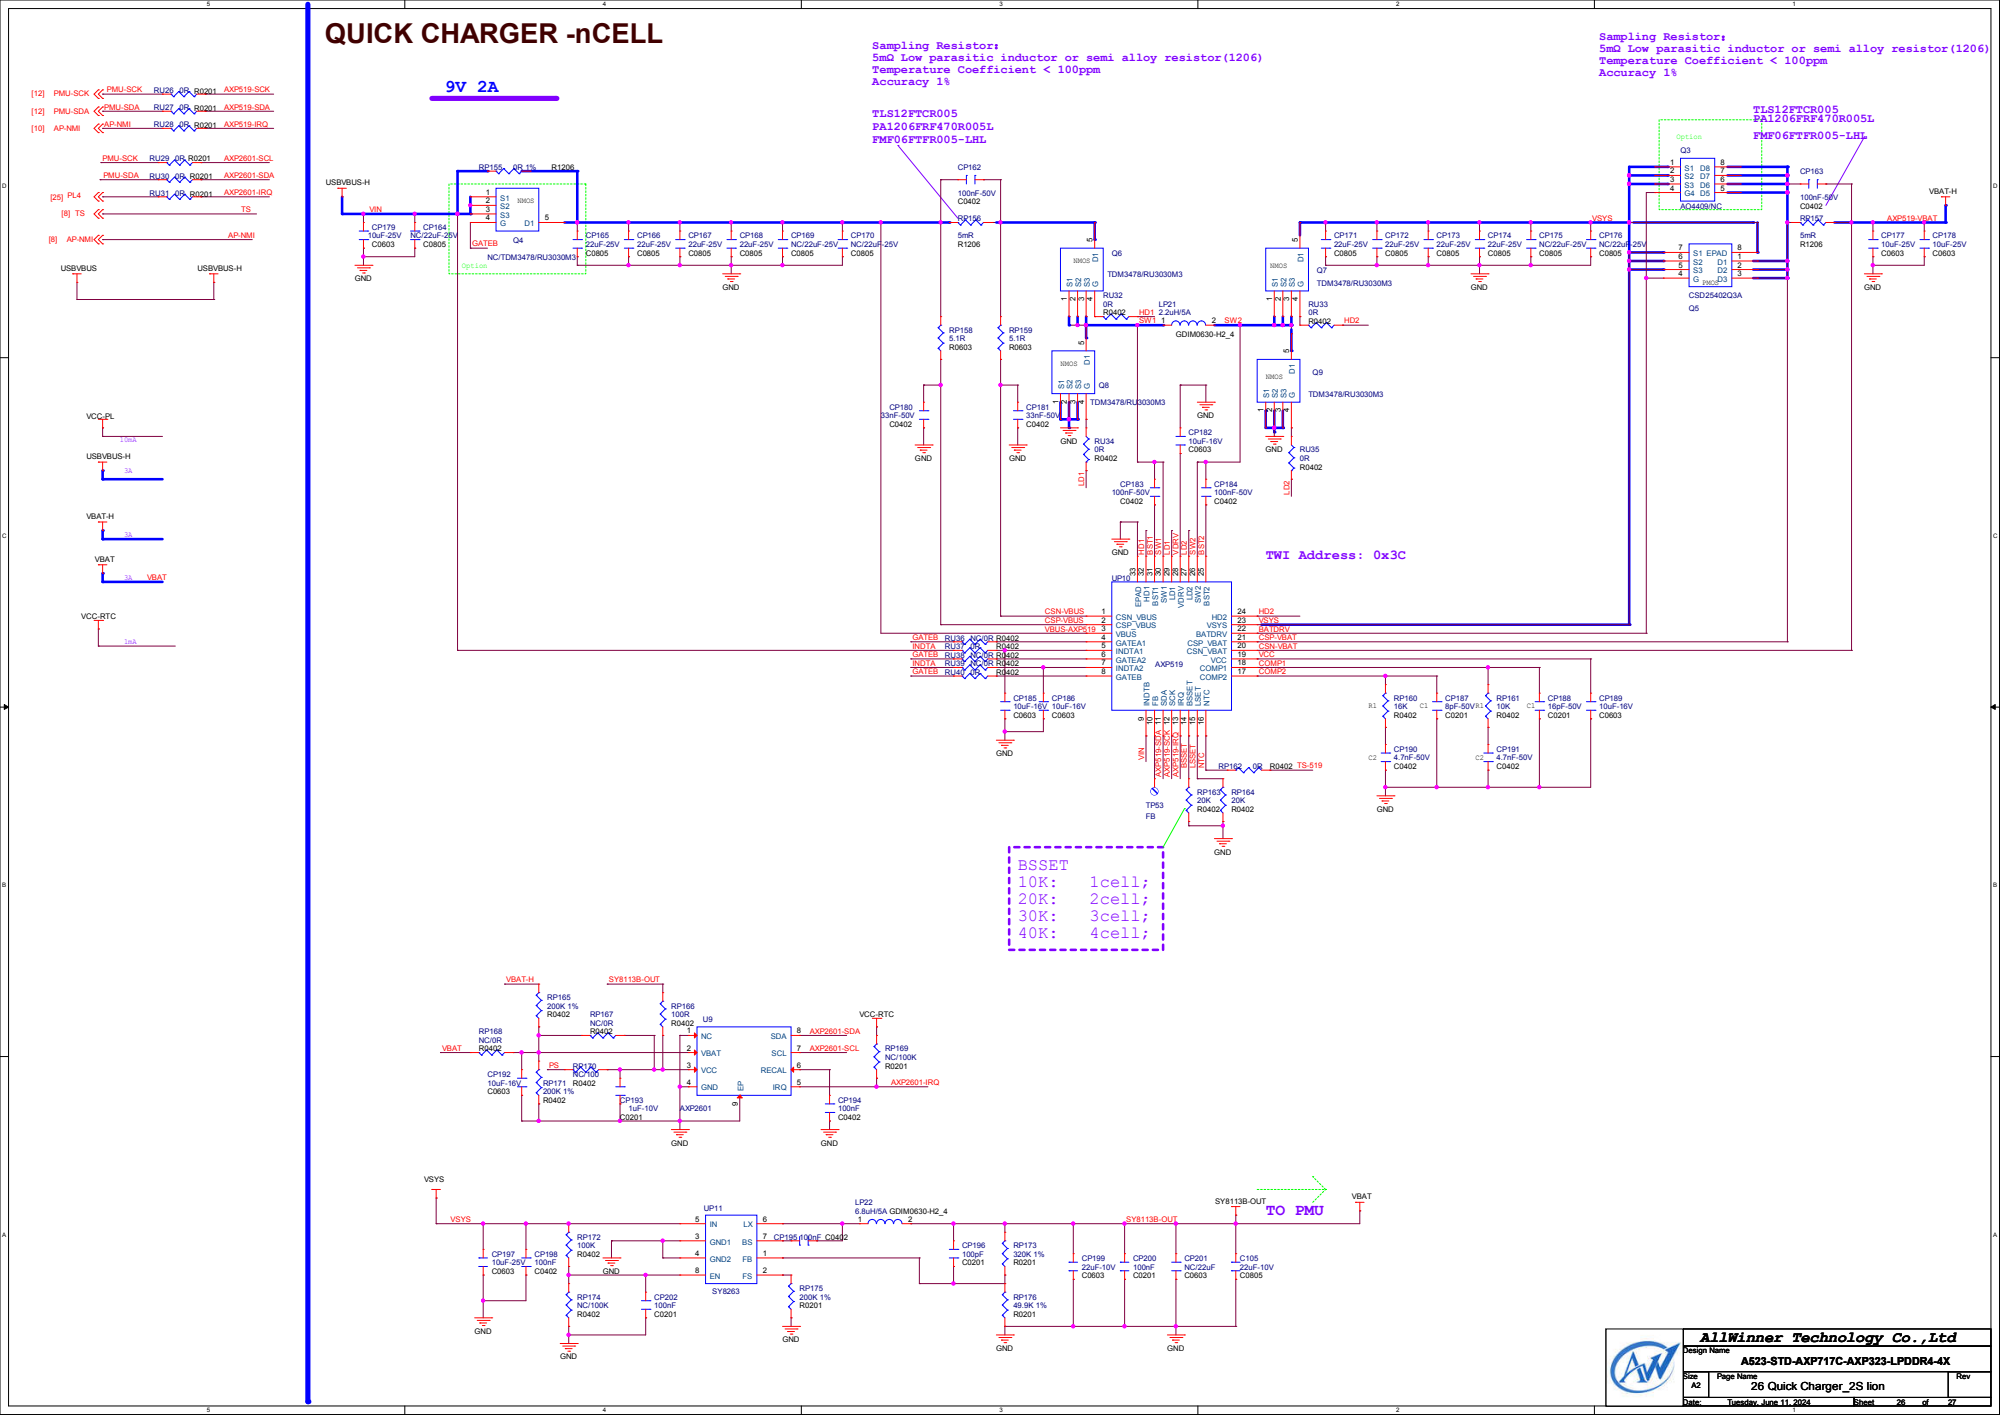
[picture p355: page 30]

Sampling Resistor：
5mΩ Low parasitic inductor or semi alloy resistor(1206)
Temperature Coefficient < 100ppm
Accuracy 1%

Sampling Resistor： 5mΩ Low parasitic inductor or semi alloy resistor(1206)

NTC 16 COMP2 17 COMP1 18 VCC 19 CSN_VBAT 20 CSP_VBAT 21 BATDRV 22 VSYS 23 HD2 24 BST2 25 SW2 26 LD2

AllWinner Technology Co.,Ltd

# GPS

### Differential pairs :

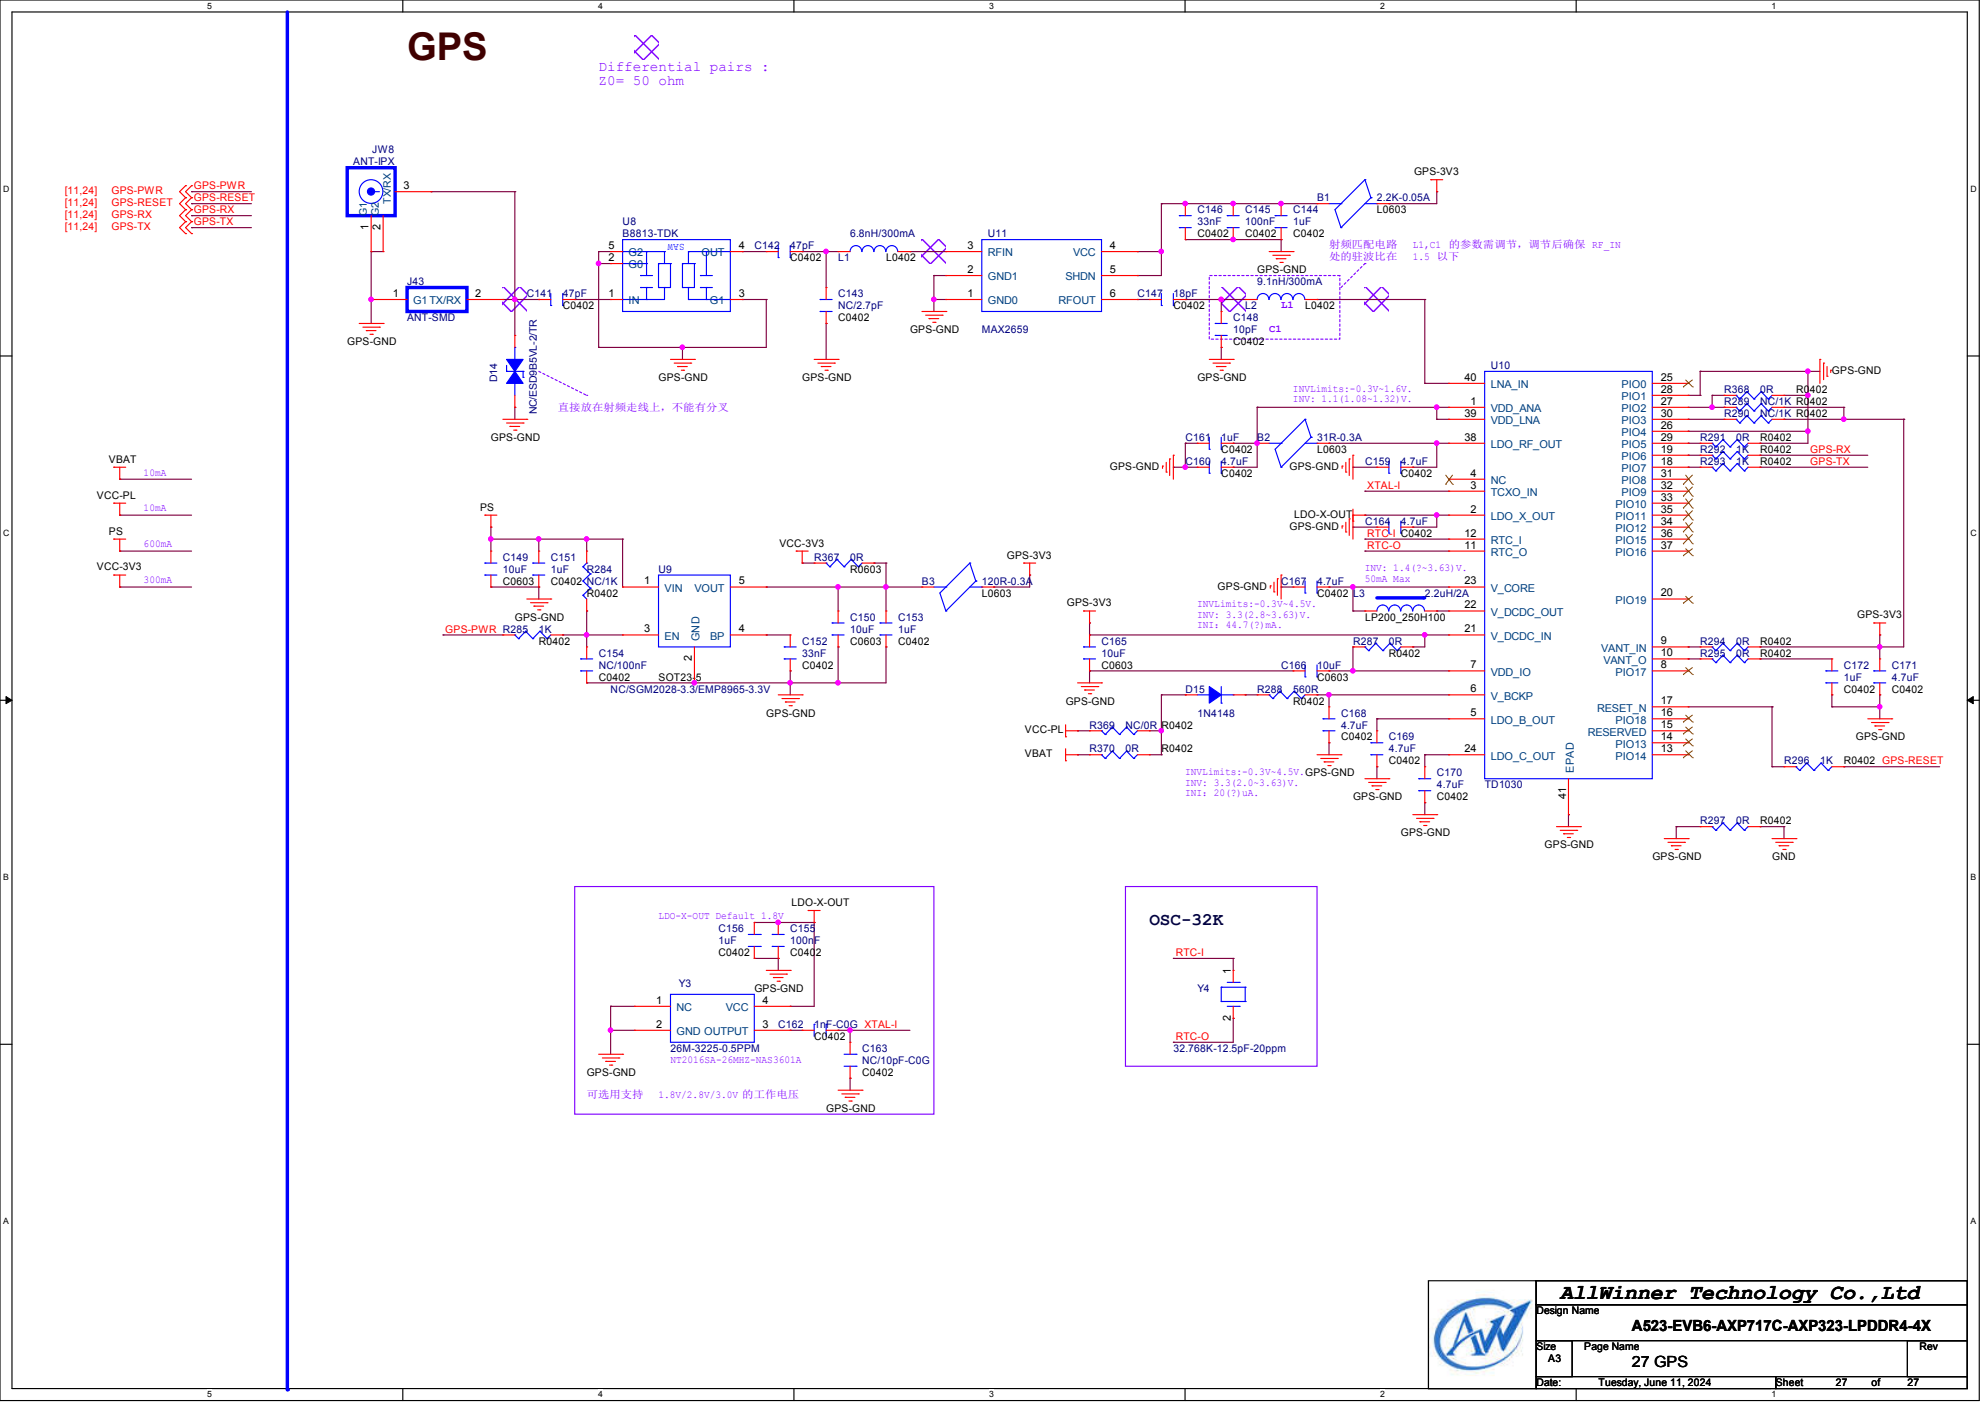
[picture p356: page 31]

AllWinner Technology Co.,Ltd
