o7-machinehum/Blackpants/docs/a523/A523_hwref/PCB参考/硬件DDR模板&叠层文件/A523-REF-DDR4-16X2-S4L-V2-0/A523-REF-DDR4-16X2-S4L-V2-0-20221107.pdf

5

4

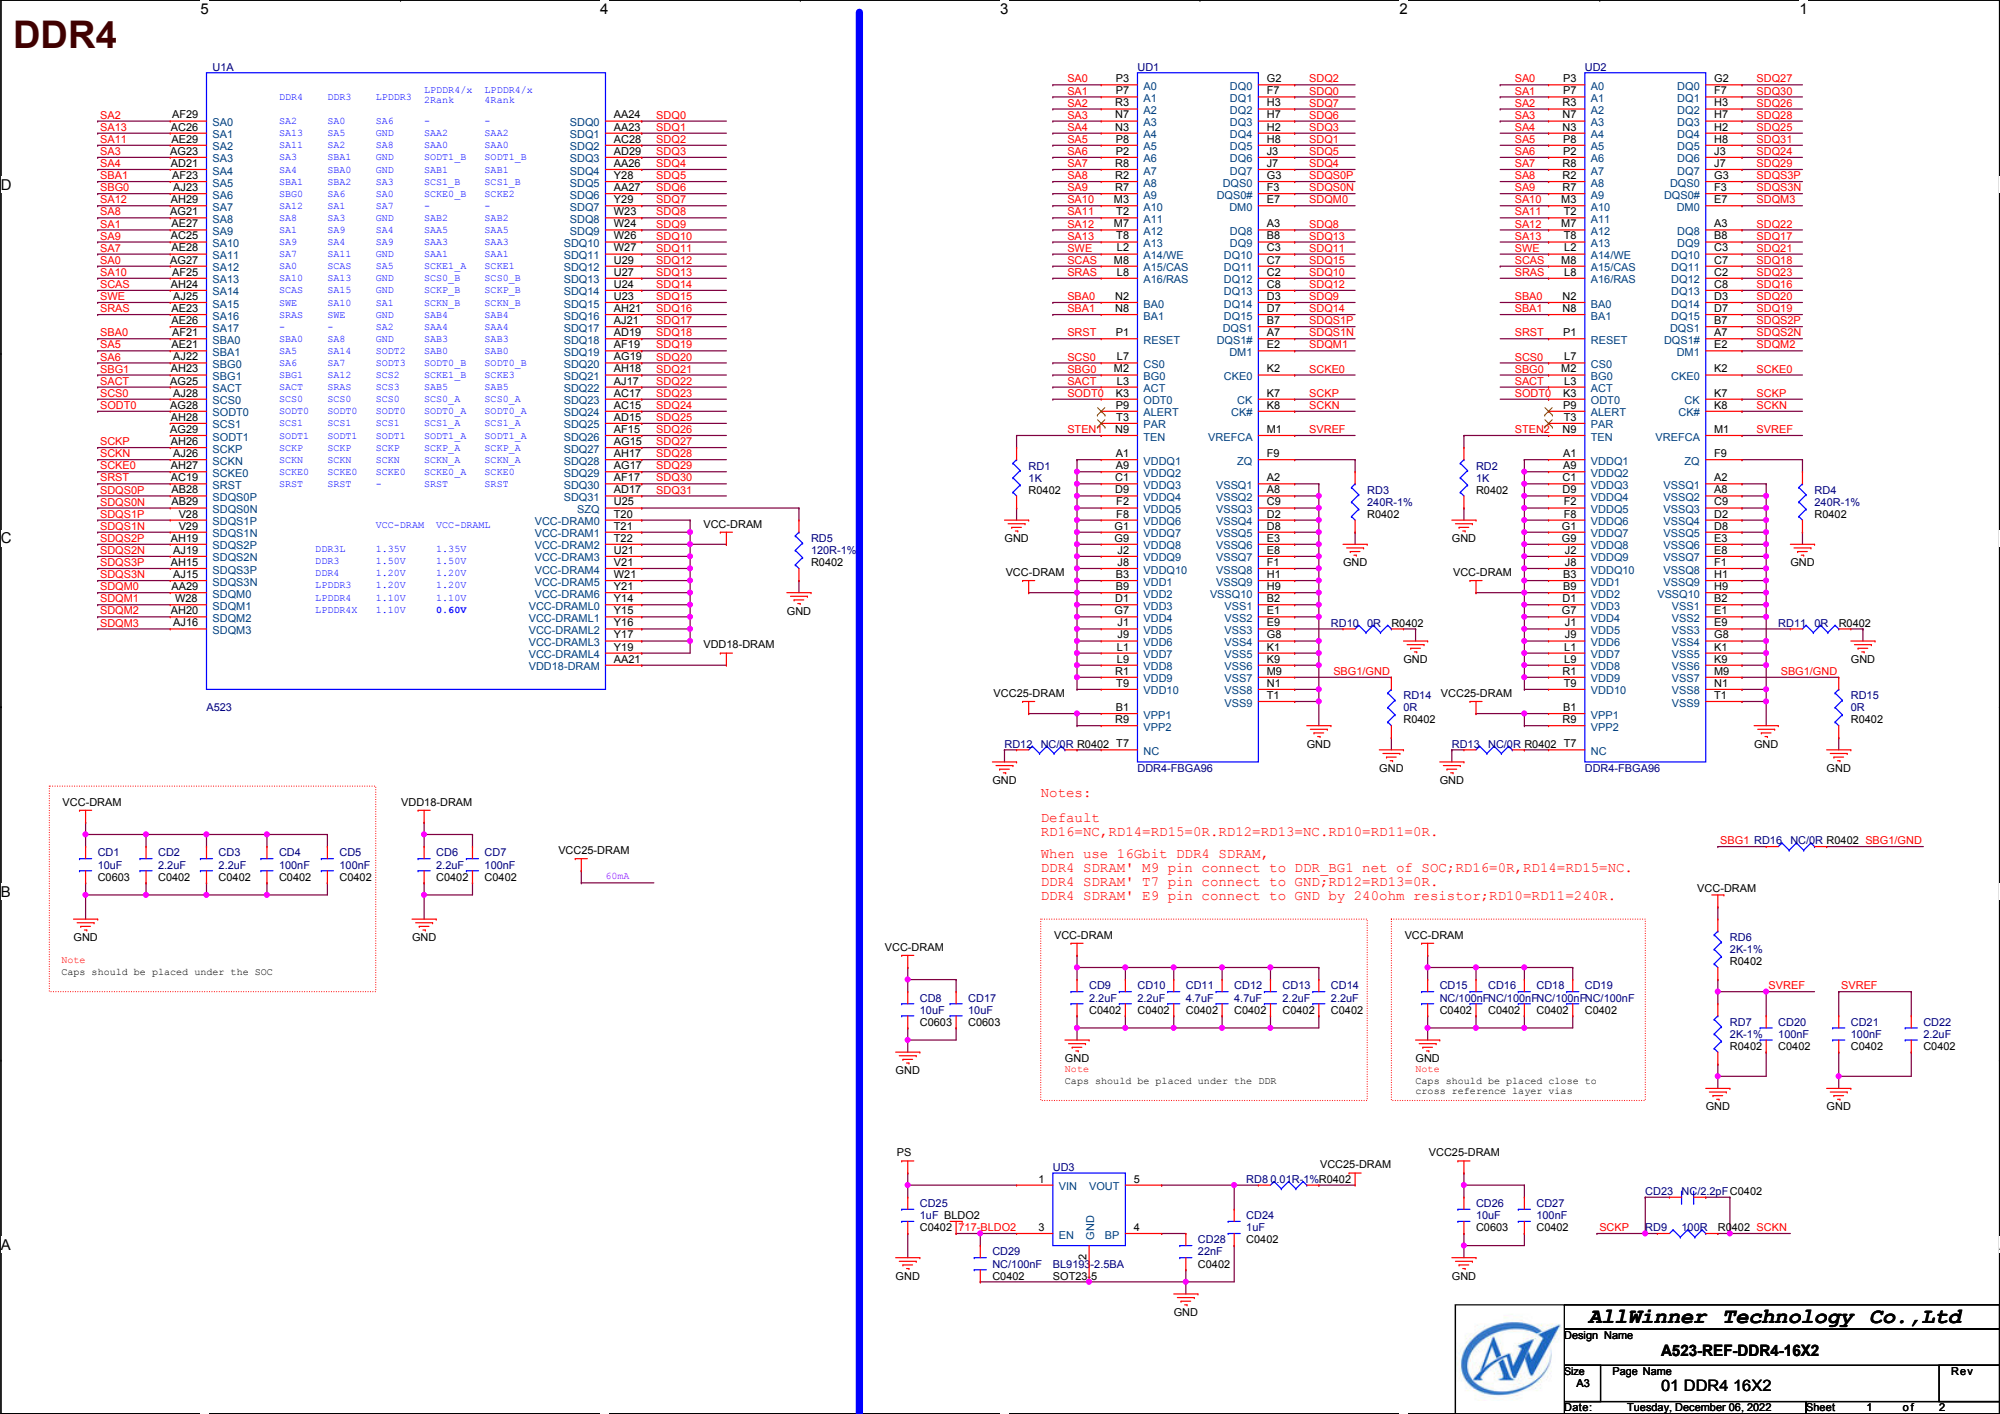
[picture p357: page 1]

Notes:
Default
When use 16Gbit DDR4 SDRAM,
DDR4 SDRAM' M9 pin connect to DDR_BG1 net of SOC;RD16=0R,RD14=RD15=NC.
DDR4 SDRAM' T7 pin connect to GND;RD12=RD13=0R.
DDR4 SDRAM' E9 pin connect to GND by 240ohm resistor;RD10=RD11=240R.

Note
Caps should be placed under the SOC

GND
Caps should be placed under the DDR

Caps should be placed close to
cross reference layer vias

AllWinner Technology Co.,Ltd

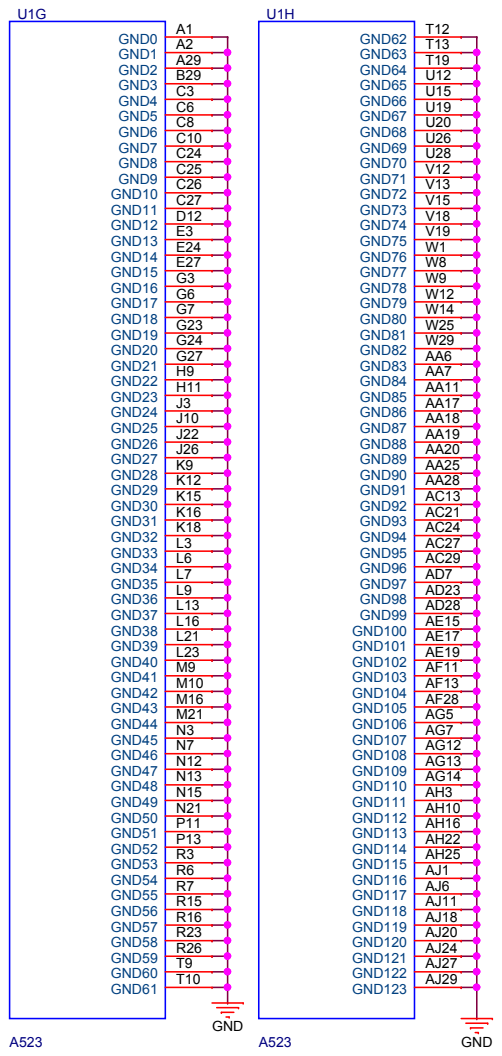
[picture p358: page 2]

AllWinner Technology Co.,Ltd
