o7-machinehum/Blackpants/docs/a523/A523_hwref/PCB参考/硬件DDR模板&叠层文件/A523-REF-LPDDR4-4X-32X1-S6L-V1-0(C0201)/A523-REF-LPDDR4-4X-32X1-S6L-V1-0-20221014.pdf

5

4

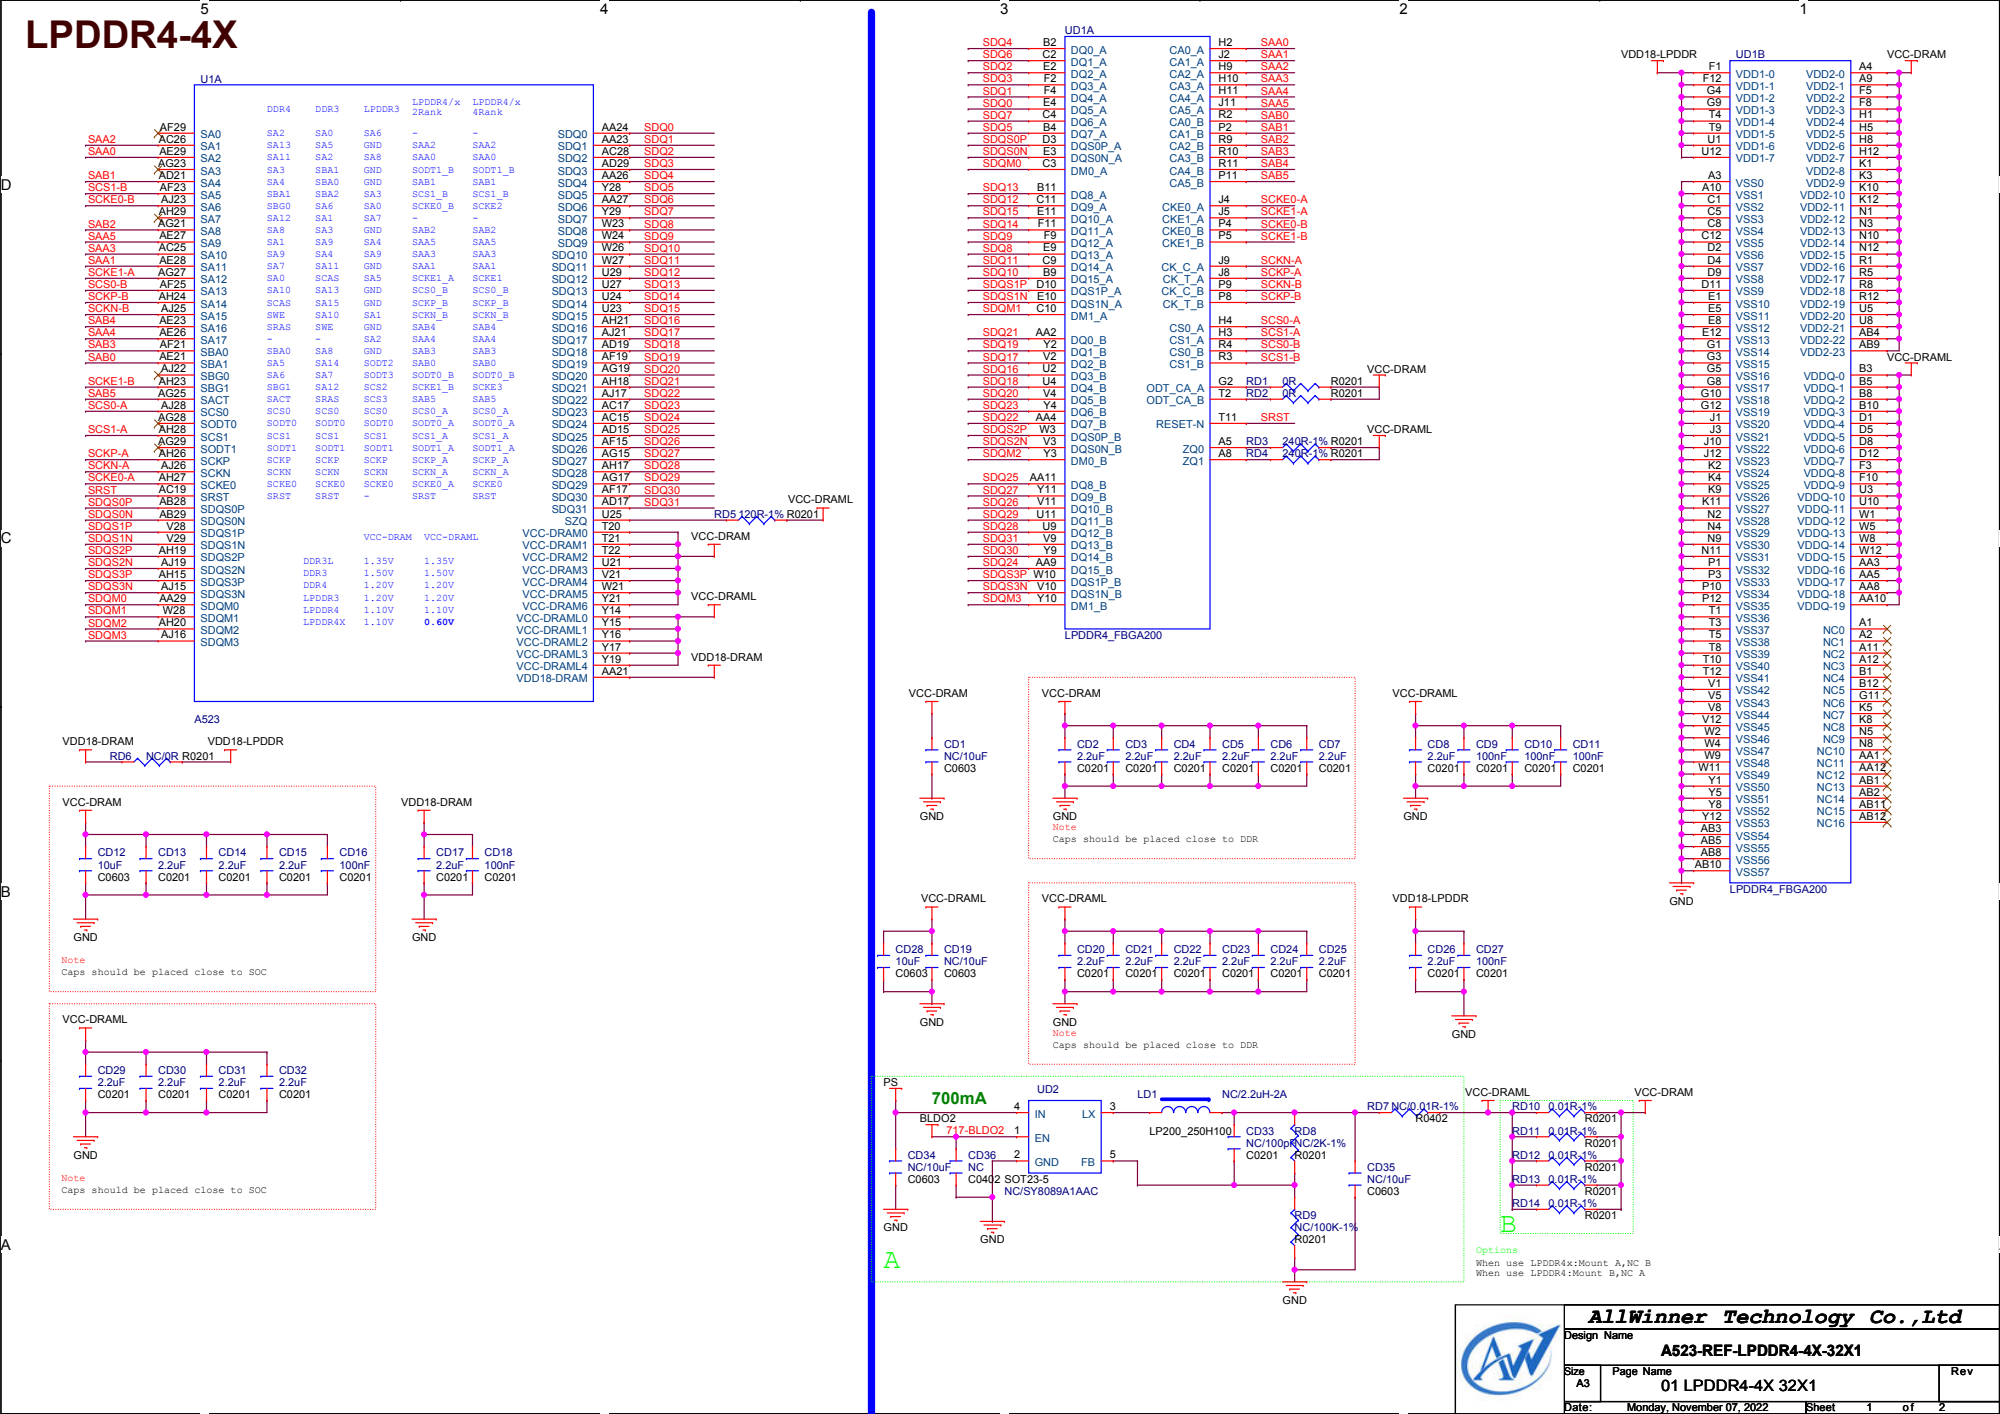
[picture p359: page 1]

GND
Note
Caps should be placed close to DDR

Caps should be placed close to SOC

When use LPDDR4:Mount B,NC A

AllWinner Technology Co.,Ltd

5

4

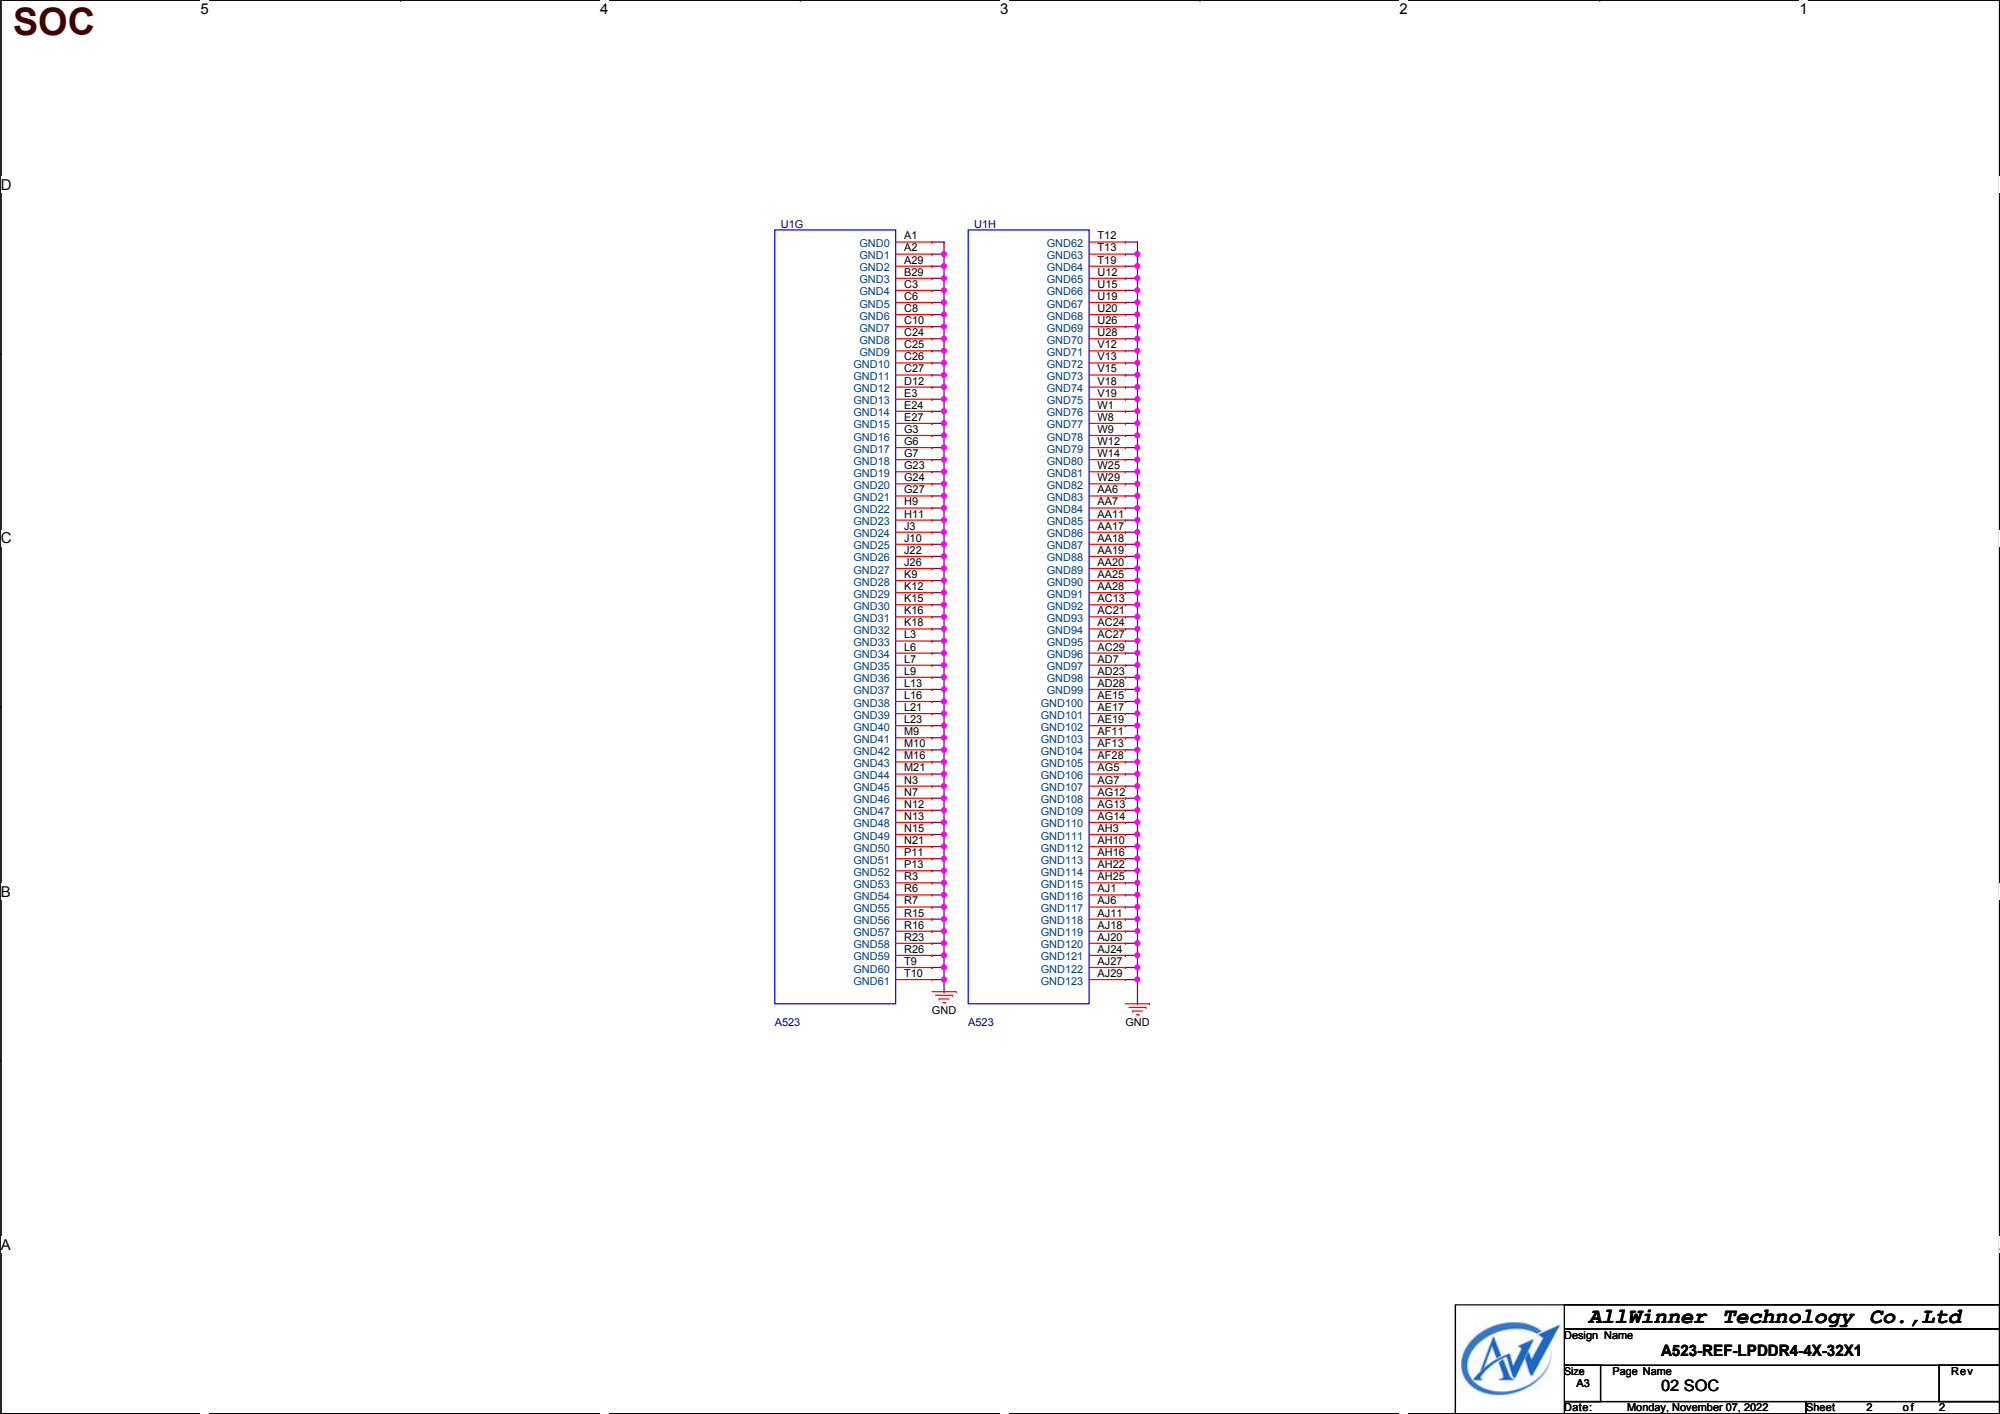
[picture p360: page 2]

AllWinner Technology Co.,Ltd
