o7-machinehum/Blackpants/docs/a523/A523_hwref/PCB参考/硬件DDR模板&叠层文件/A523-REF-LPDDR4-4X-32X1-S6L-V2-0(C0402)/A523-REF-LPDDR4-4X-32X1-S6L-V2-0-20221014.pdf

5

4

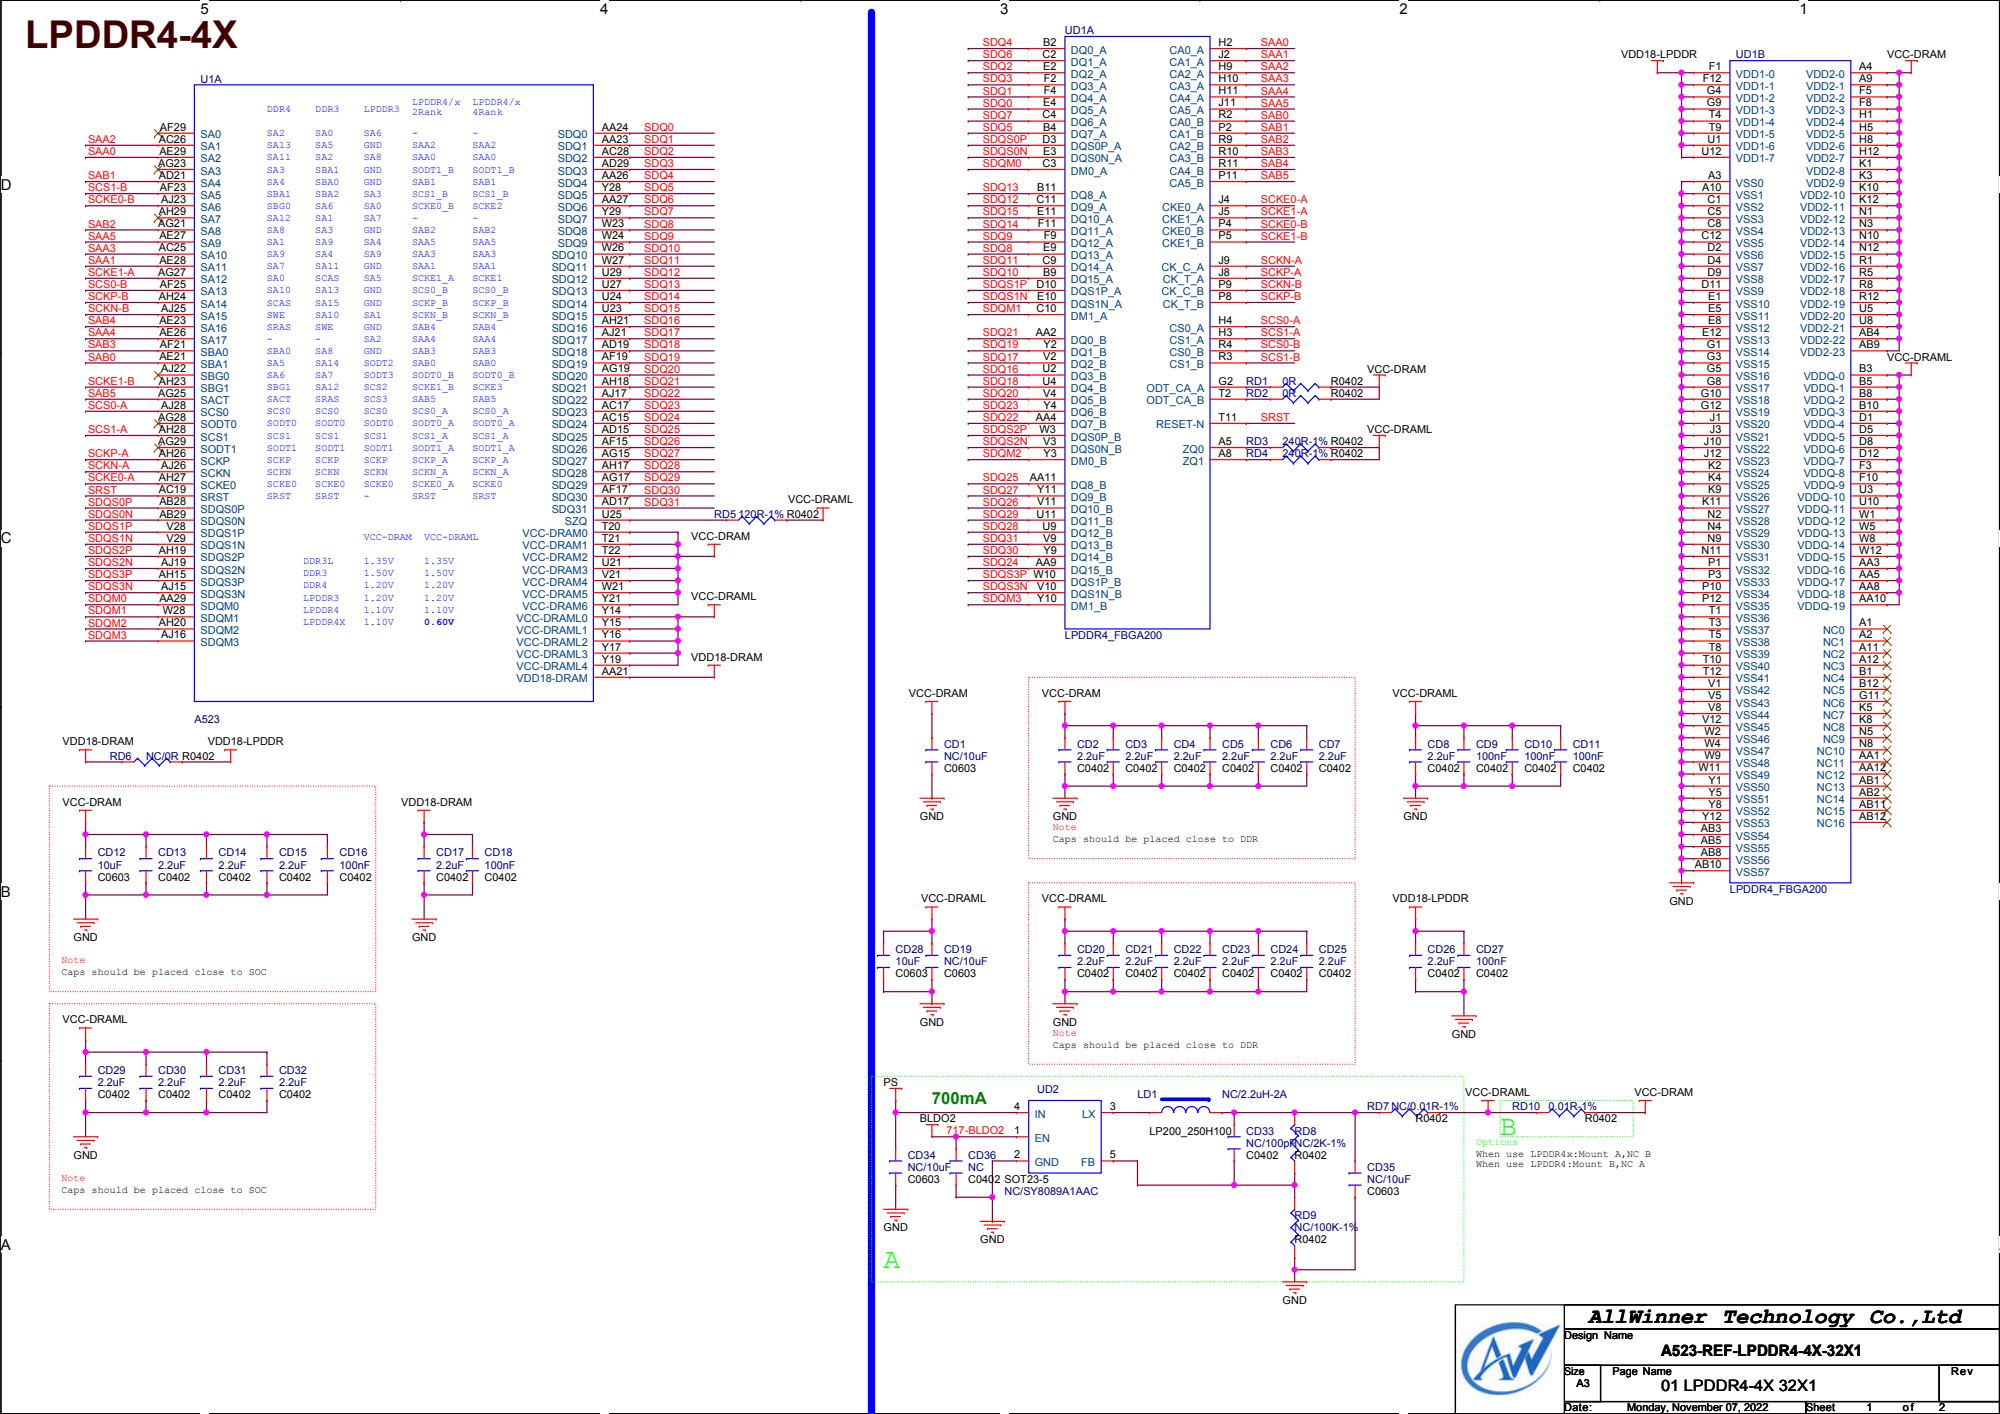
[picture p361: page 1]

GND
Note
Caps should be placed close to DDR

Caps should be placed close to SOC

Options
When use LPDDR4x:Mount A,NC B
When use LPDDR4:Mount B,NC A

AllWinner Technology Co.,Ltd

5

4

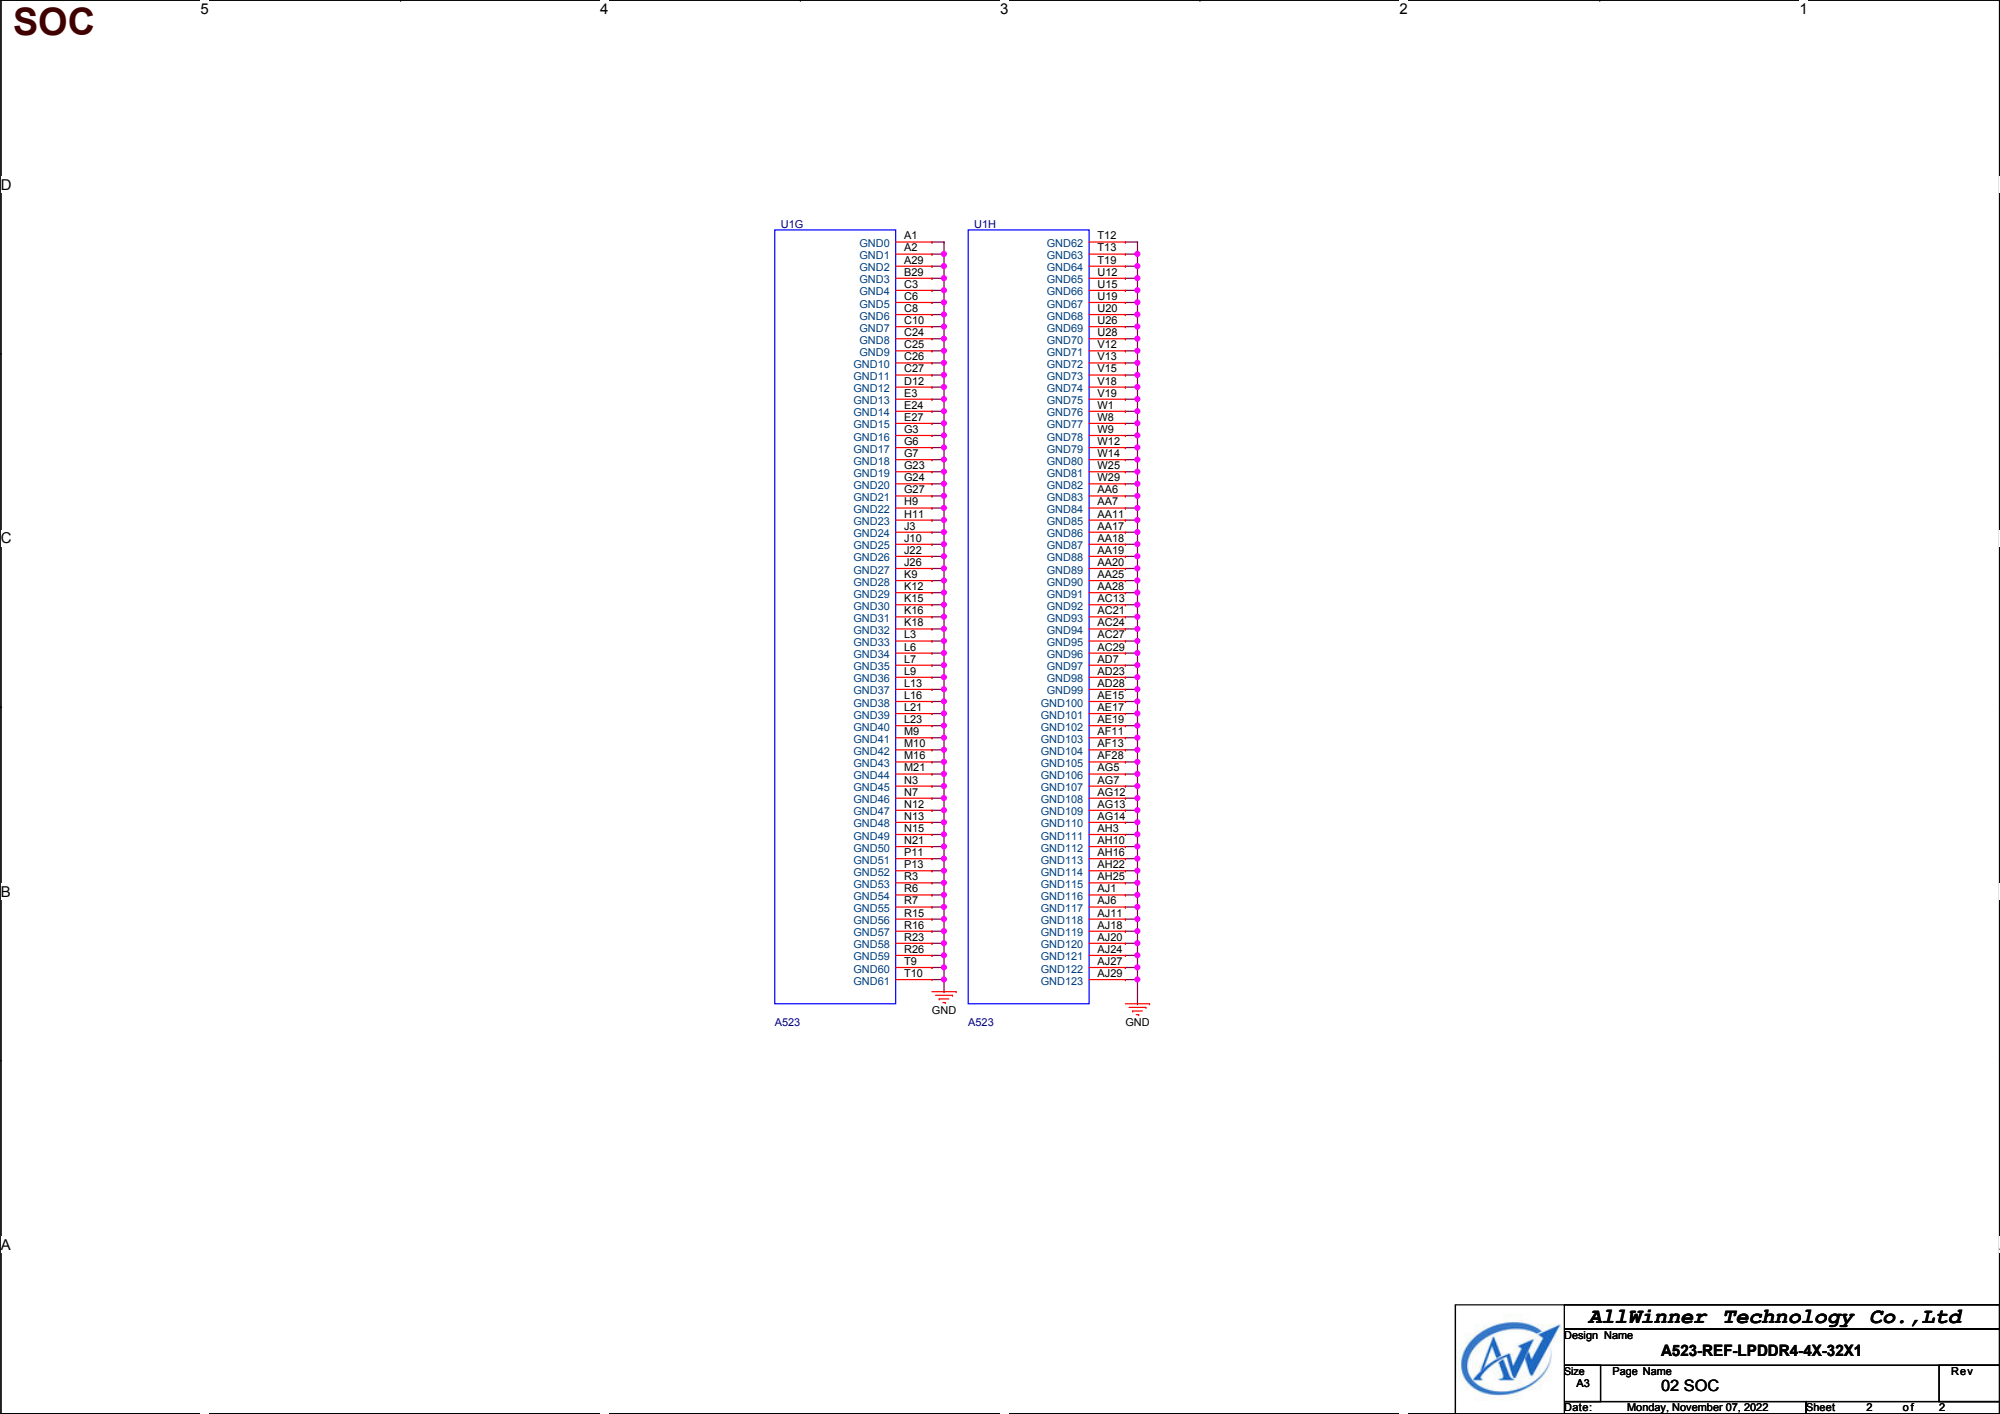
[picture p362: page 2]

AllWinner Technology Co.,Ltd
