o7-machinehum/Blackpants/docs/a523/A523_hwref/原理图/开发板资料/开发板原理图/A523-EVB-AXP717C-LPDDR4-4X-32X1-V1-0-20221115.pdf

# I n d e x ：

# Page1

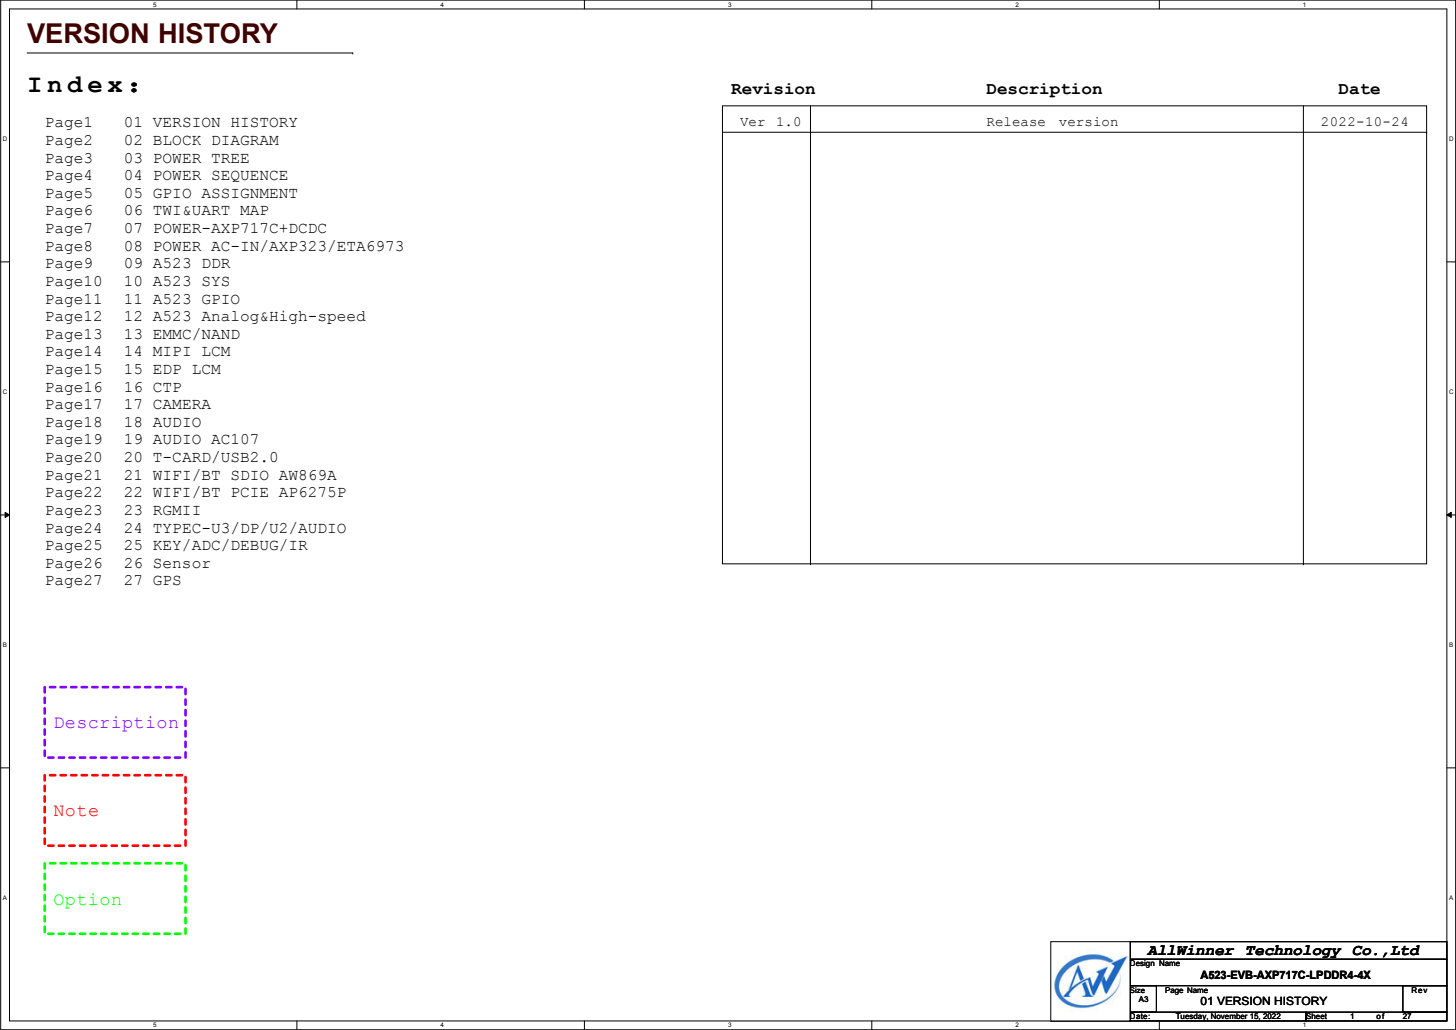
[picture p363: page 1]
VERSION HISTORY; Revision; Description; Date; 01 VERSION HISTORY; Ver 1.0; Release version; Page2 Page3 Page4 Page5 Page6 Page7 Page8 Page9 Page10; Page12; Page11; Page13 Page14 Page15; Page17; Page16; Page18 Page19 Page20; Note; Option; Page21; 21 WIFI/BT SDIO AW869A; Page22; 22 WIFI/BT PCIE AP6275P; Page23; 23 RGMII; Page24; 24 TYPEC-U3/DP/U2/AUDIO; Page25; 25 KEY/ADC/DEBUG/IR; Page26; 26 Sensor; Page27; 27 GPS; Design Name; Size; Page Name; Rev; Date:; Sheet; A523-EVB-AXP717C-LPDDR4-4X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

02 BLOCK DIAGRAM
03 POWER TREE
04 POWER SEQUENCE
05 GPIO ASSIGNMENT
06 TWI&UART MAP
07 POWER-AXP717C+DCDC
08 POWER AC-IN/AXP323/ETA6973
09 A523 DDR
10 A523 SYS
11 A523 GPIO
12 A523 Analog&High-speed
13 EMMC/NAND
14 MIPI LCM
15 EDP LCM
16 CTP
17 CAMERA
18 AUDIO
19 AUDIO AC107
20 T-CARD/USB2.0

AllWinner Technology Co.,Ltd

# BLOCK

# DDR

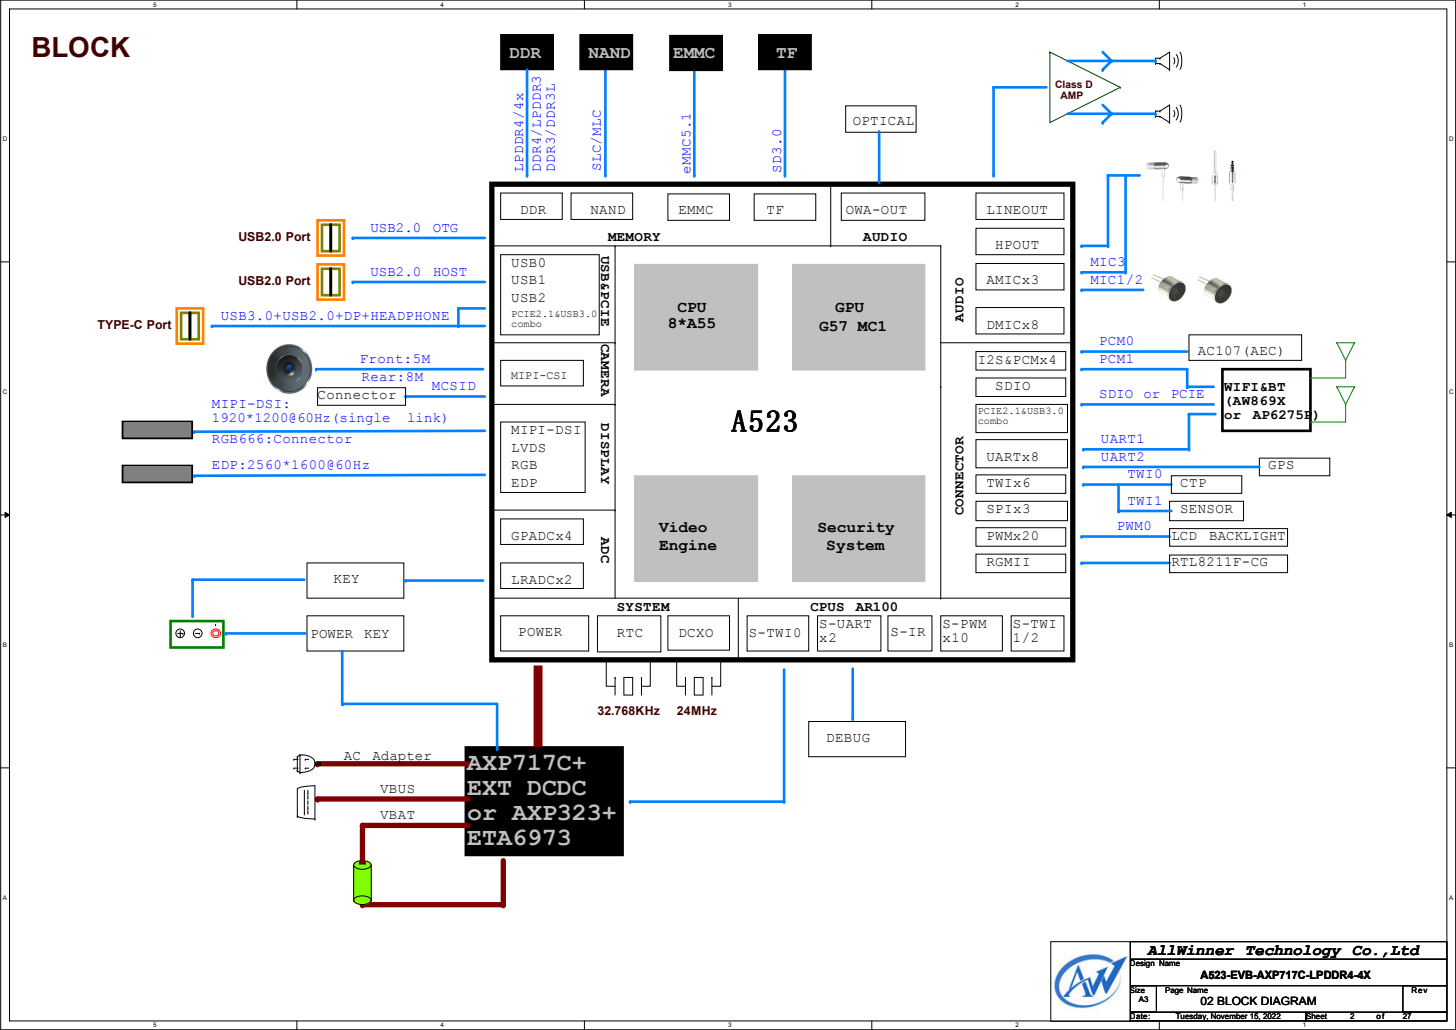
[picture p364: page 2]
CPU 8*A55; GPU G57 MC1; Video Engine; Security System; AXP717C+ EXT DCDC or AXP323+ ETA6973; NAND; EMMC; GPADCx4; LVDS; MIPI-CSI; POWER; RTC; DCXO; SDIO; USB0 USB1; TWIx6; UARTx8; SPIx3; LRADCx2; SENSOR; DMICx8; HPOUT; AMICx3; LINEOUT; S-UART x2; S-PWM x10; I2S&PCMx4; S-TWI 1/2 S-IR; DDR; Front:5M; MIPI-DSI:; 1920*1200@60Hz(single; link); RGB; MIPI-DSI; KEY; POWER KEY; VBAT; VBUS; 32.768KHz; 24MHz; MEMORY; AUDIO; CPUS AR100; CONNECTOR; DEBUG; Class D AMP; WIFI&BT (AW869X or AP6275P); LPDDR4/4x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

ADC DISPLAY CAMERA USB&PCIE A523 MIC3 EDP EDP:2560*1600@60Hz PCIE2.1&USB3.0 combo USB2 USB3.0+USB2.0+DP+HEADPHONE USB2.0 Port USB2.0 HOST PCM0 AC107(AEC)

SDIO or PCIE

# DEFAULT POWER ON

# DEFAULT POWER OFF

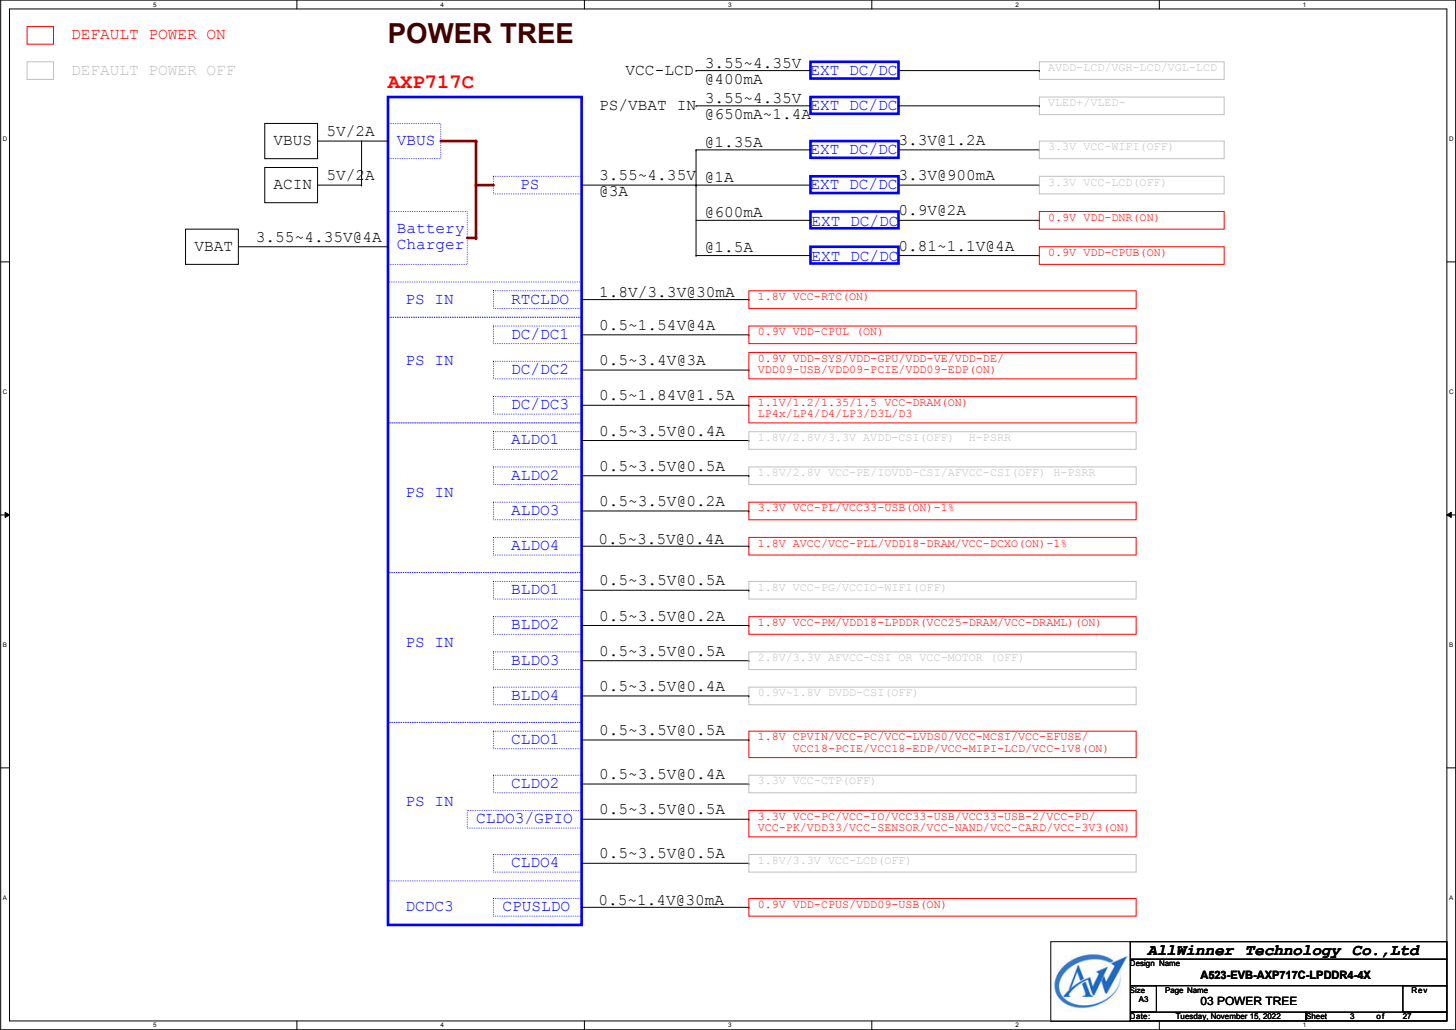
[picture p365: page 3]
VBUS; Battery Charger; ALDO1; ALDO3; ALDO2; BLDO2; BLDO3; CLDO1; BLDO4; CLDO2; CLDO3/GPIO; AXP717C; BLDO1; CPUSLDO; RTCLDO; 3.55~4.35V@4A VBAT; DCDC3; ALDO4; CLDO4; VBUS 5V/2A; POWER TREE; ACIN; VLED+/VLED-; 0.9V VDD-CPUL (ON); 1.8V VCC-RTC(ON); 1.8V/2.8V/3.3V AVDD-CSI(OFF); H-PSRR; 1.8V/2.8V VCC-PE/IOVDD-CSI/AFVCC-CSI(OFF) H-PSRR; 2.8V/3.3V AFVCC-CSI OR VCC-MOTOR (OFF); 3.3V VCC-WIFI(OFF); 0.9V VDD-CPUB(ON) EXT DC/DC; EXT DC/DC3.3V@900mA; 3.3V VCC-LCD(OFF); VCC-LCD; 03 POWER TREE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

AVDD-LCD/VGH-LCD/VGL-LCD

EXT DC/DC

PS/VBAT IN

0.9V VDD-DNR(ON) 0.9V@2A

0.9V VDD-SYS/VDD-GPU/VDD-VE/VDD-DE/
VDD09-USB/VDD09-PCIE/VDD09-EDP(ON)

1.1V/1.2/1.35/1.5 VCC-DRAM(ON)

3.3V VCC-PL/VCC33-USB(ON)-1%

1.8V AVCC/VCC-PLL/VDD18-DRAM/VCC-DCXO(ON)-1%

1.8V VCC-PG/VCCIO-WIFI(OFF)

1.8V VCC-PM/VDD18-LPDDR(VCC25-DRAM/VCC-DRAML)(ON)

0.9V~1.8V DVDD-CSI(OFF)

1.8V CPVIN/VCC-PC/VCC-LVDS0/VCC-MCSI/VCC-EFUSE/

VCC18-PCIE/VCC18-EDP/VCC-MIPI-LCD/VCC-1V8(ON)

3.3V VCC-CTP(OFF)

3.3V VCC-PC/VCC-IO/VCC33-USB/VCC33-USB-2/VCC-PD/
VCC-PK/VDD33/VCC-SENSOR/VCC-NAND/VCC-CARD/VCC-3V3(ON)

1.8V/3.3V VCC-LCD(OFF)

0.9V VDD-CPUS/VDD09-USB(ON)

# POWER SEQUENCE

## 1.8V VCC-RTC(ON)

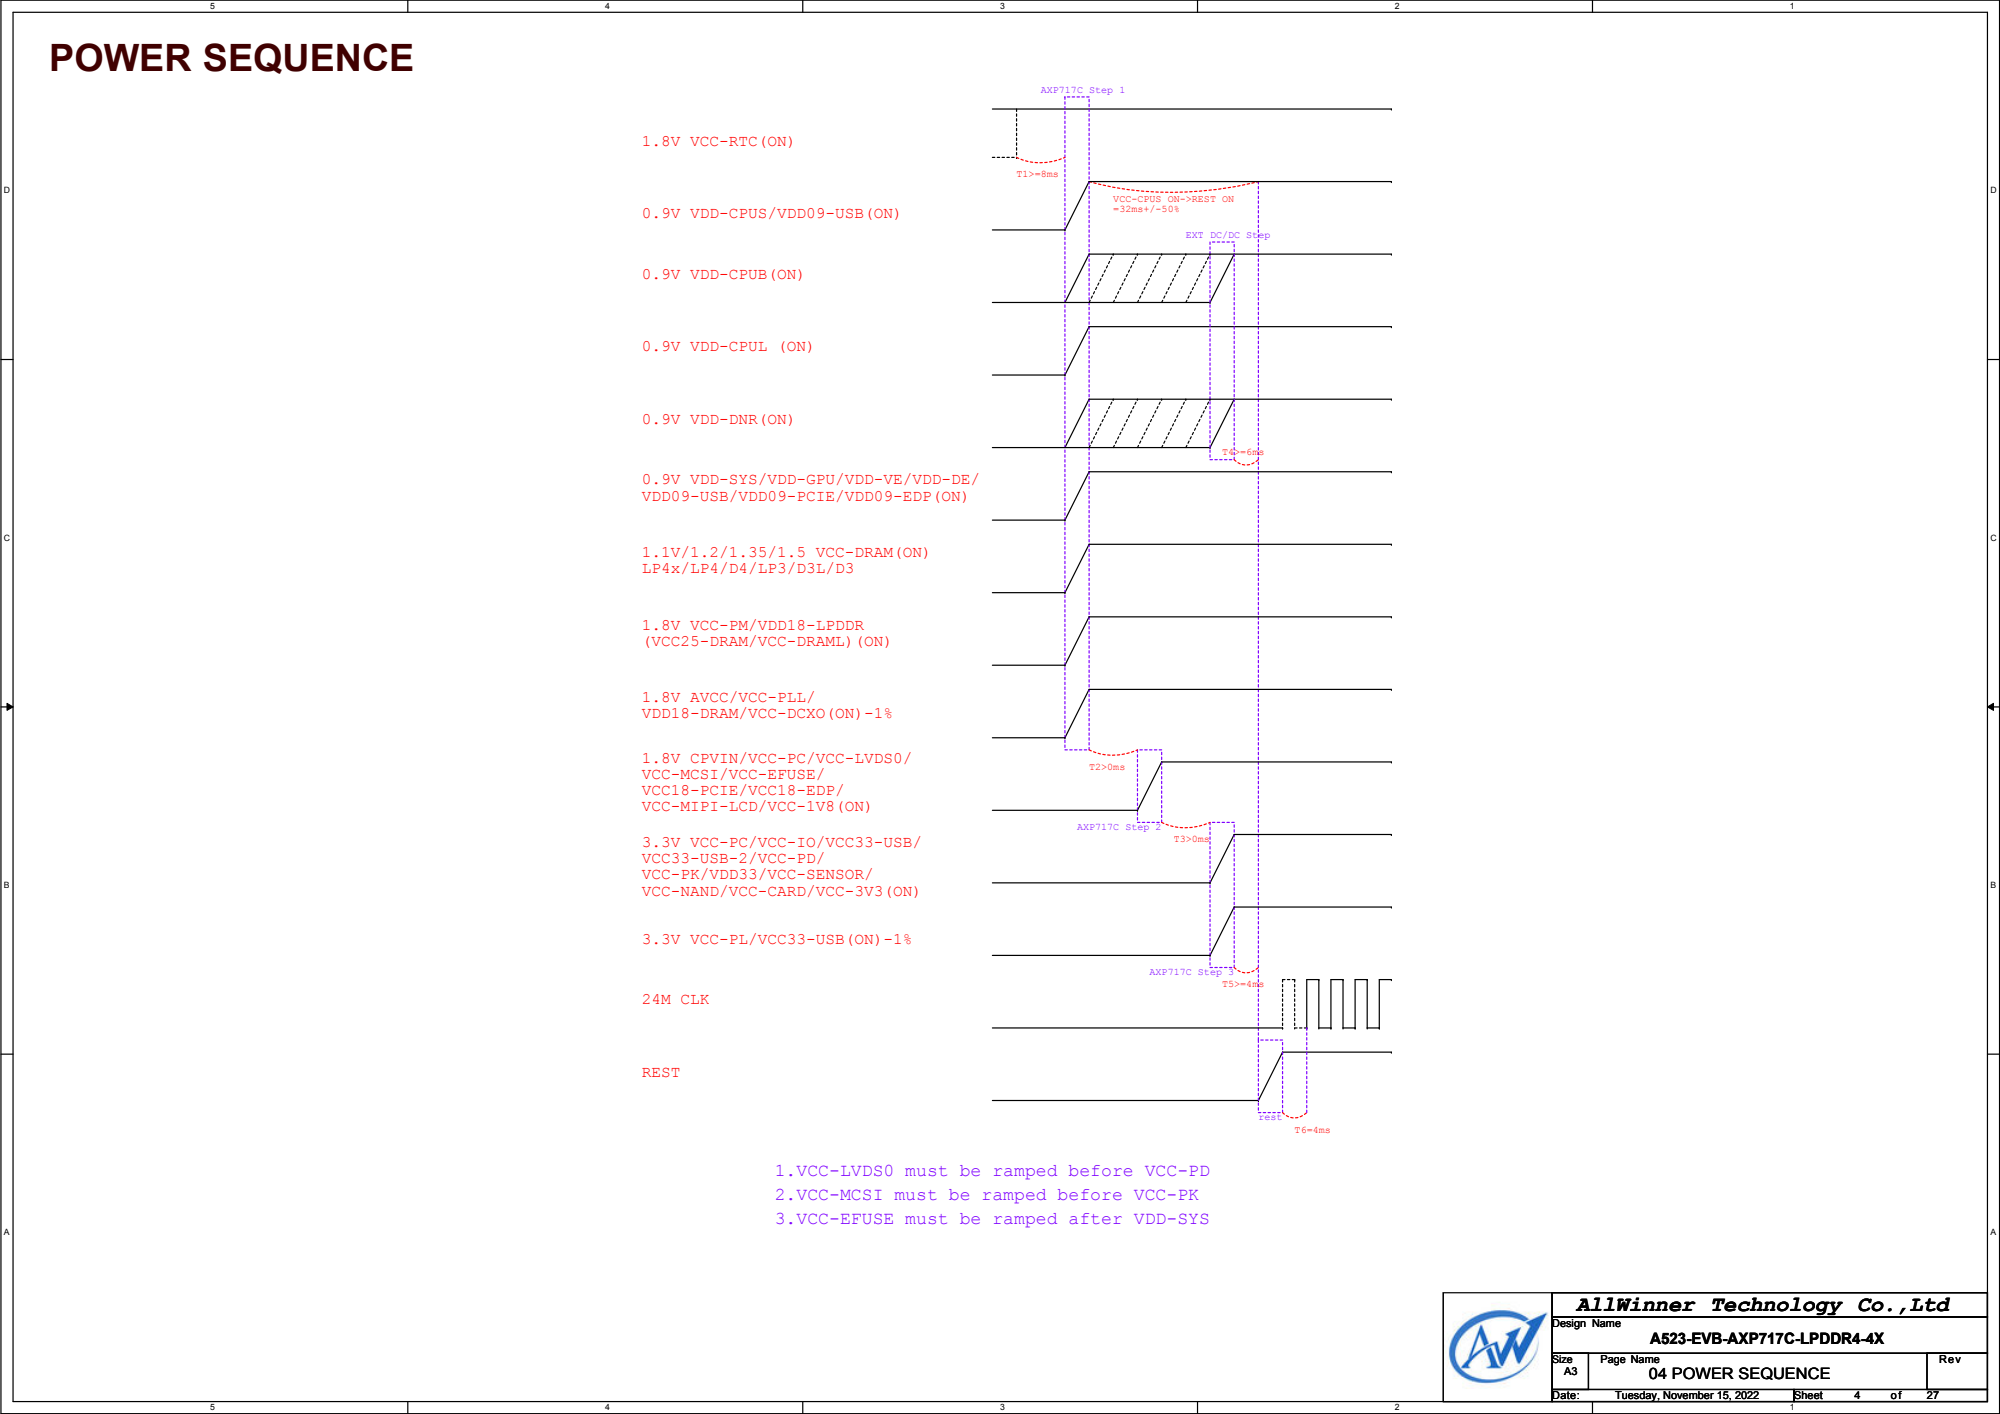
[picture p366: page 4]
REST; 24M CLK; AXP717C Step 1; AXP717C Step 2; AXP717C Step 3; rest; 04 POWER SEQUENCE; Tuesday, November 15, 2022

VCC-CPUS ON->REST ON

0.9V VDD-CPUS/VDD09-USB(ON)

EXT DC/DC Step

0.9V VDD-CPUB(ON)

0.9V VDD-CPUL (ON)

0.9V VDD-DNR(ON)

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

1.1V/1.2/1.35/1.5 VCC-DRAM(ON)

1.8V VCC-PM/VDD18-LPDDR
(VCC25-DRAM/VCC-DRAML)(ON)

1.8V AVCC/VCC-PLL/
VDD18-DRAM/VCC-DCXO(ON)-1%

1.8V CPVIN/VCC-PC/VCC-LVDS0/
VCC-MCSI/VCC-EFUSE/
VCC18-PCIE/VCC18-EDP/
VCC-MIPI-LCD/VCC-1V8(ON)

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

3.3V VCC-PL/VCC33-USB(ON)-1%

1.VCC-LVDS0 must be ramped before VCC-PD
2.VCC-MCSI must be ramped before VCC-PK
3.VCC-EFUSE must be ramped after VDD-SYS

# GPIO ASSIGNMENT

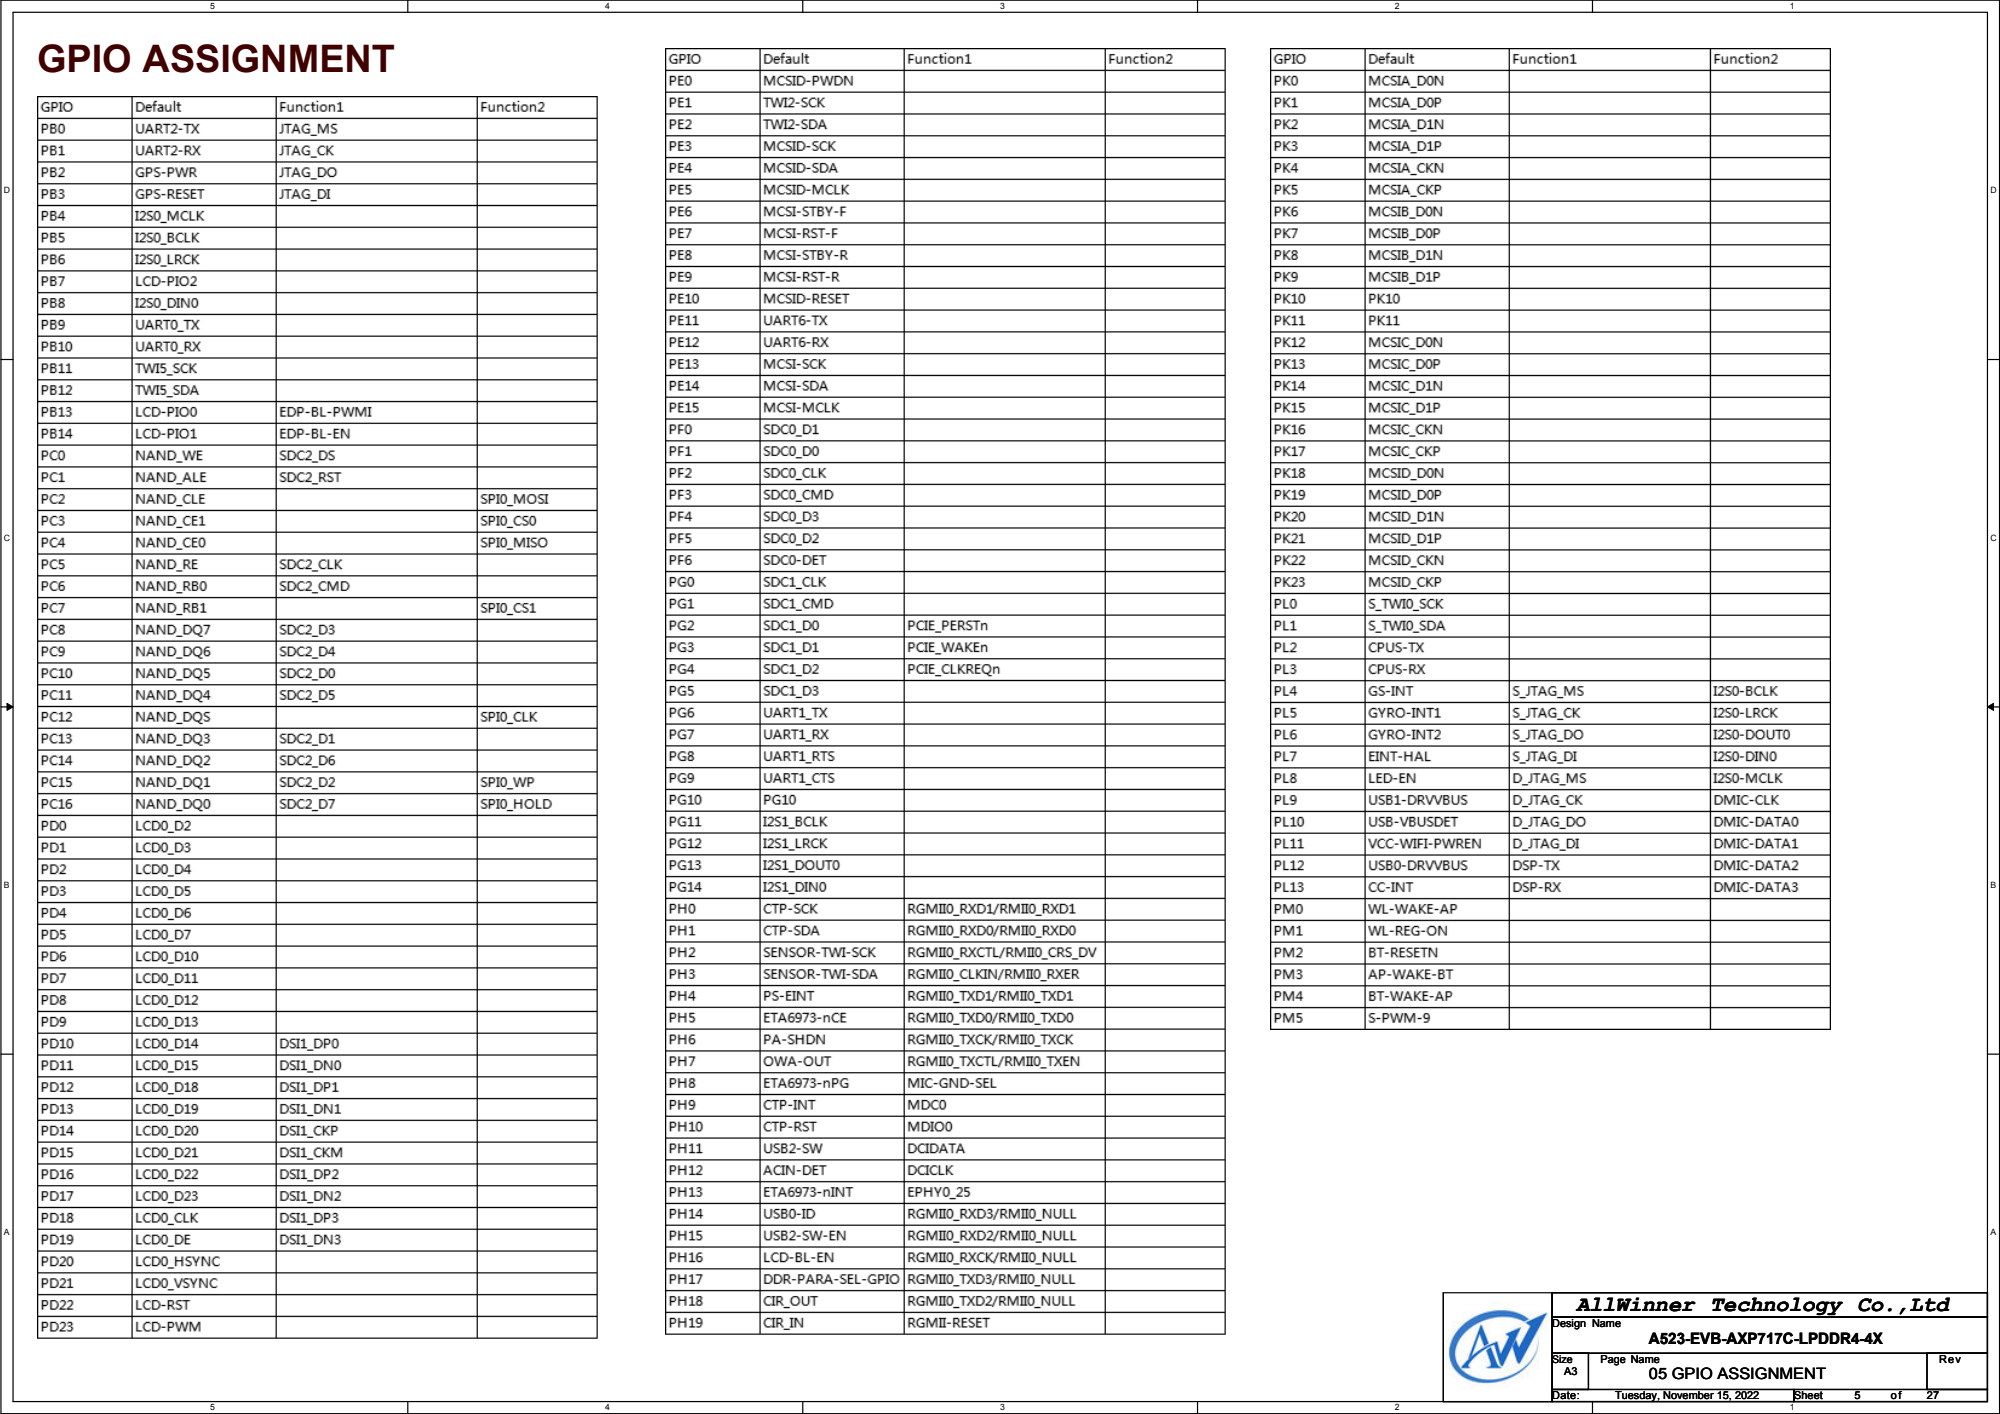
[picture p367: page 5]
05 GPIO ASSIGNMENT; Tuesday, November 15, 2022

# TWI1

PD

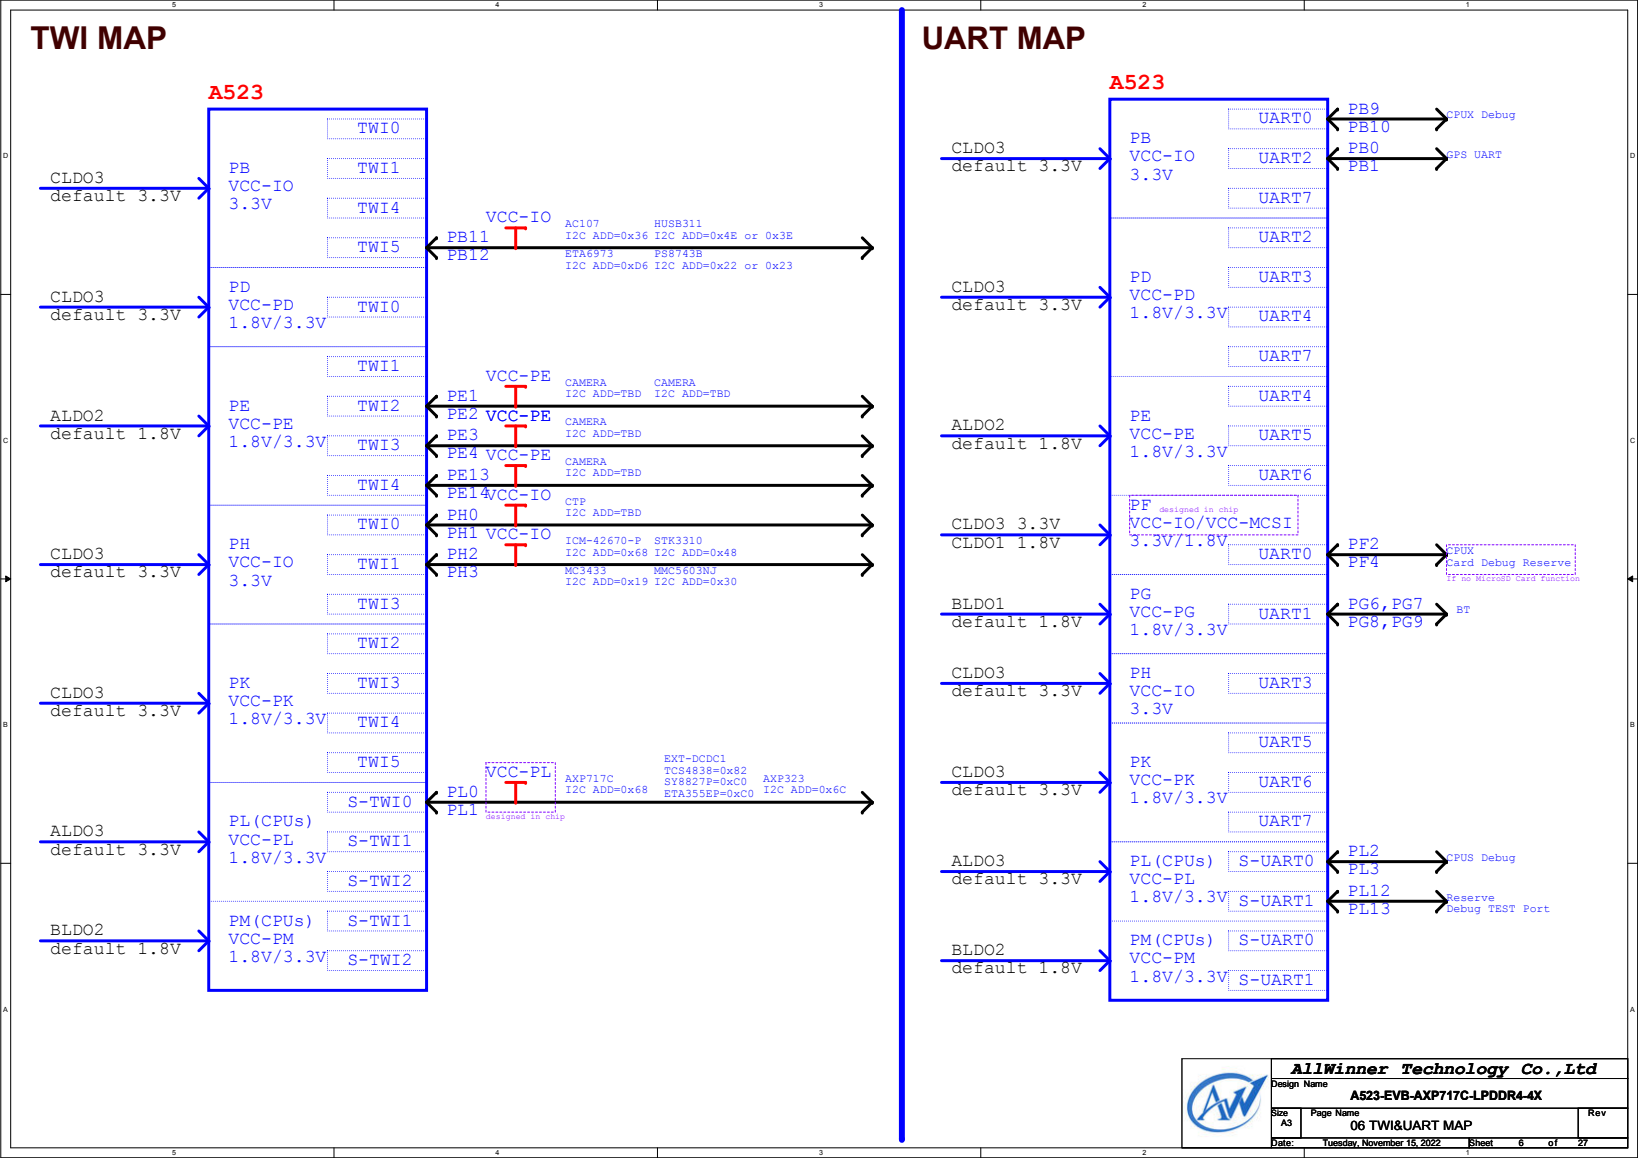
[picture p368: page 6]
VCC-PD 1.8V/3.3V; PH VCC-IO 3.3V; TWI1; TWI3; TWI2; TWI0; TWI4; TWI MAP; CLDO3 default 3.3V; TWI5; PB VCC-IO 3.3V; TWI0 CLDO3 default 3.3V; PE VCC-PE 1.8V/3.3V; ALDO2 default 1.8V; PK VCC-PK 1.8V/3.3V; S-TWI1; S-TWI2; S-TWI0; PL(CPUs) VCC-PL 1.8V/3.3V; PM(CPUs) VCC-PM 1.8V/3.3V; ALDO3 default 3.3V; BLDO2 default 1.8V; VCC-IO; CTP I2C ADD=TBD; VCC-PL; AXP717C I2C ADD=0x68; UART2; PD VCC-PD 1.8V/3.3V; UART7; UART5; UART4; UART0; UART6; S-UART0; S-UART1; UART3; CLDO3 3.3V CLDO1 1.8V; UART1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

VCC-IO/VCC-MCSI

designed in chip

CPUX
Card Debug Reserve

If no MicroSD Card function

Reserve
Debug TEST Port

06 TWI&UART MAP

# PMIC

# BAT

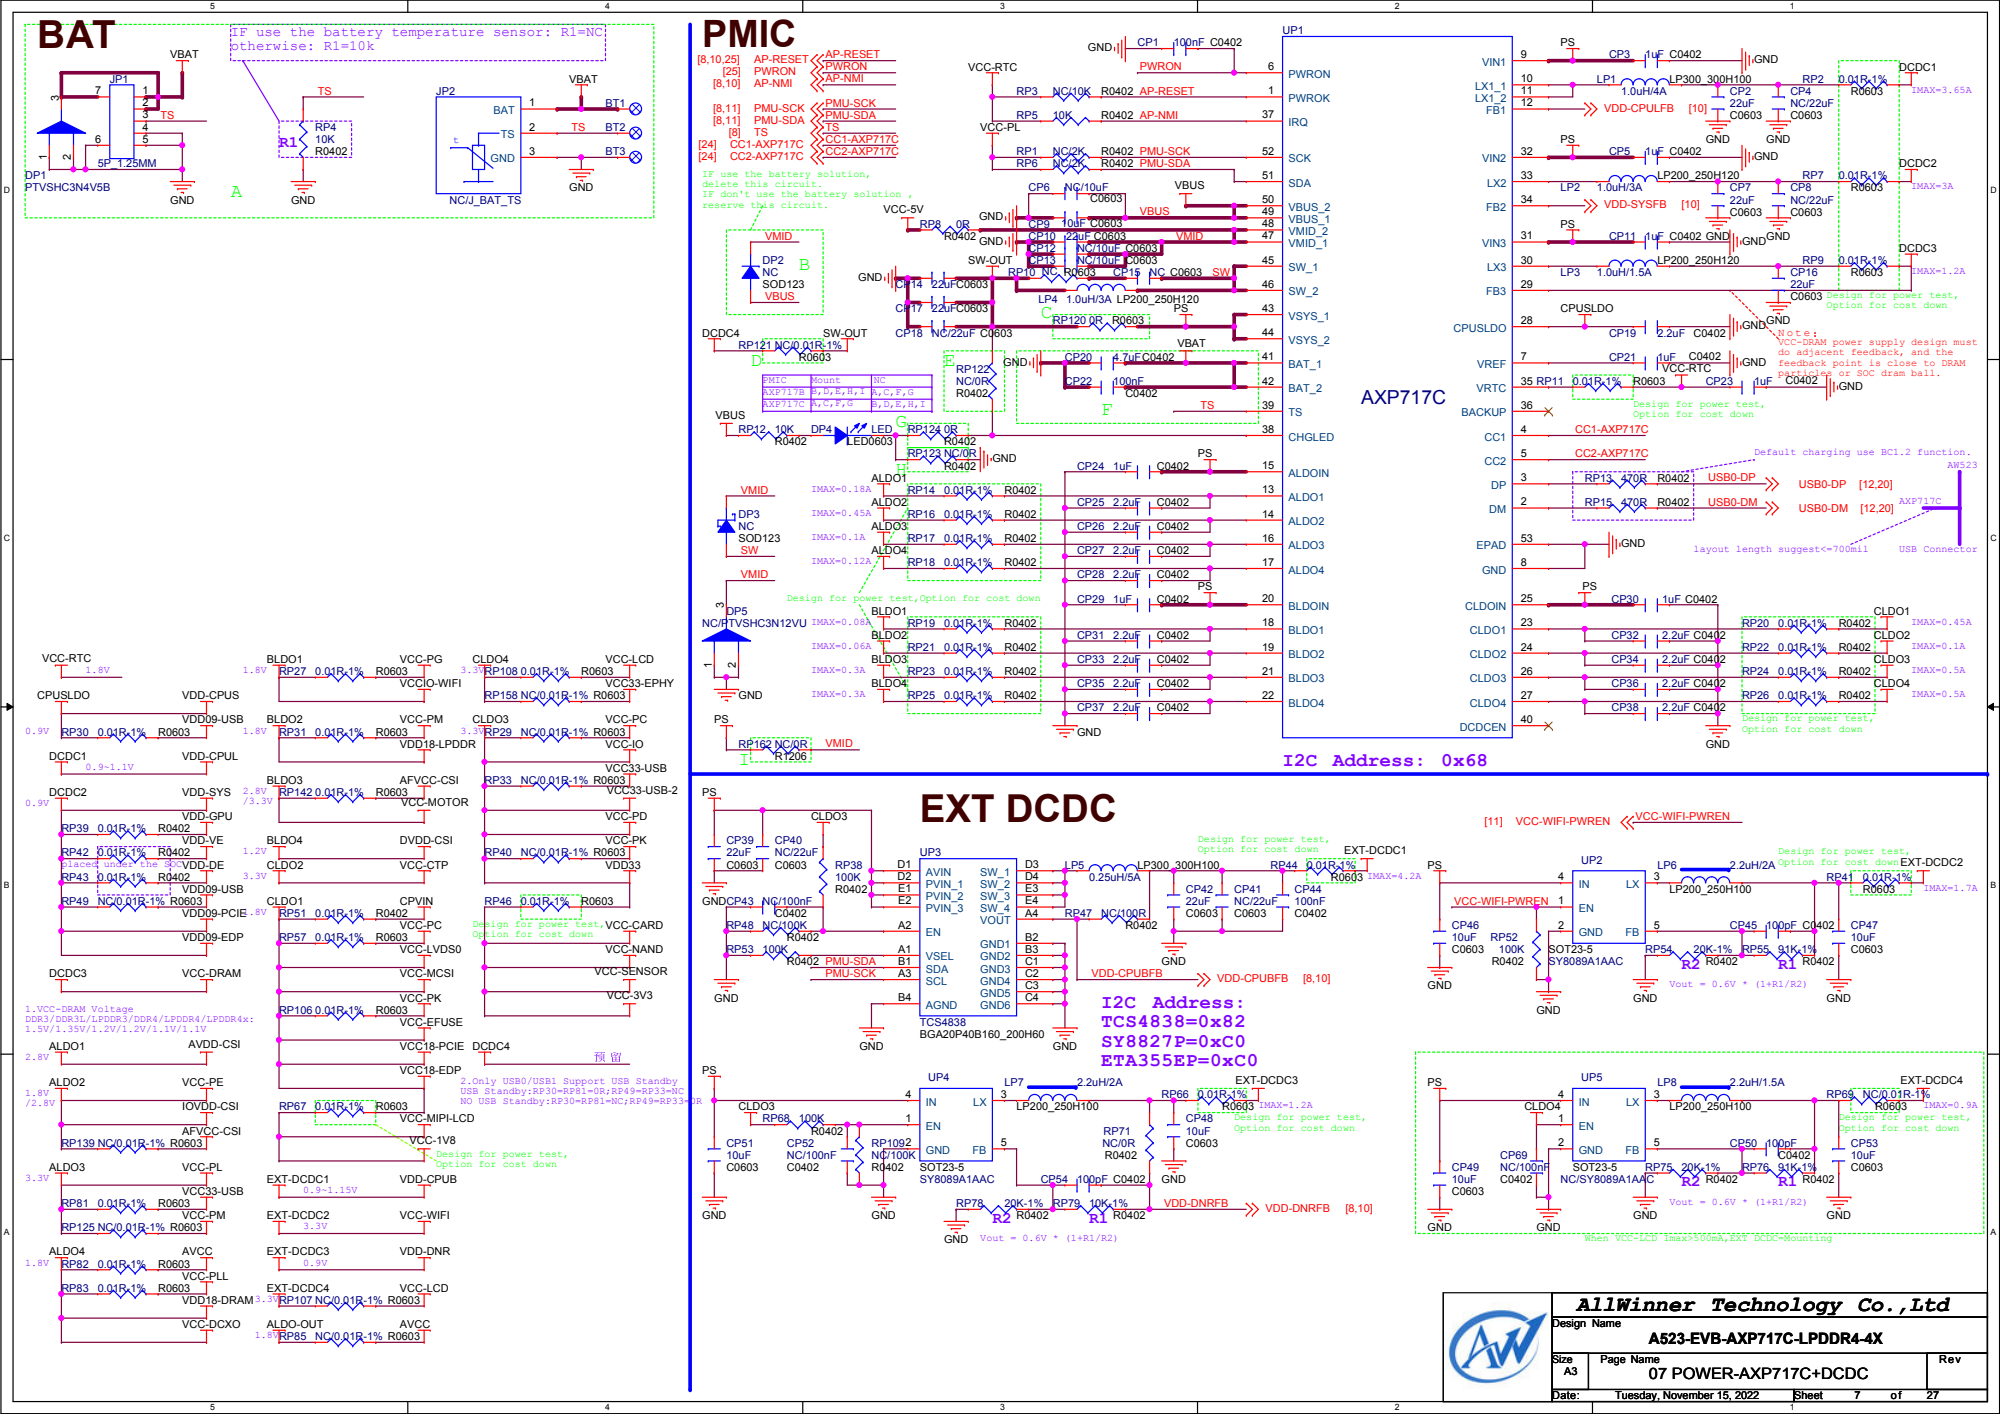
[picture p369: page 7]

IF use the battery temperature sensor: R1=NC
otherwise: R1=10k

IF use the battery solution,
delete this circuit.
IF don't use the battery solution ,
reserve this circuit.

Design for power test,
Option for cost down

VCC-DRAM power supply design must
do adjacent feedback, and the
feedback point is close to DRAM
particles or SOC dram ball.

PMIC | Mount | NC
AXP717B | B,D,E,H,I | A,C,F,G
AXP717C | A,C,F,G | B,D,E,H,I

Default charging use BC1.2 function.

Design for power test,Option for cost down

2.Only USB0/USB1 Support USB Standby
USB Standby:RP30=RP81=0R;RP49=RP33=NC
NO USB Standby:RP30=RP81=NC;RP49=RP33=0R

VCC-1V8

When VCC-LCD Imax>500mA,EXT DCDC=Mounting

# ACIN

5V@2A

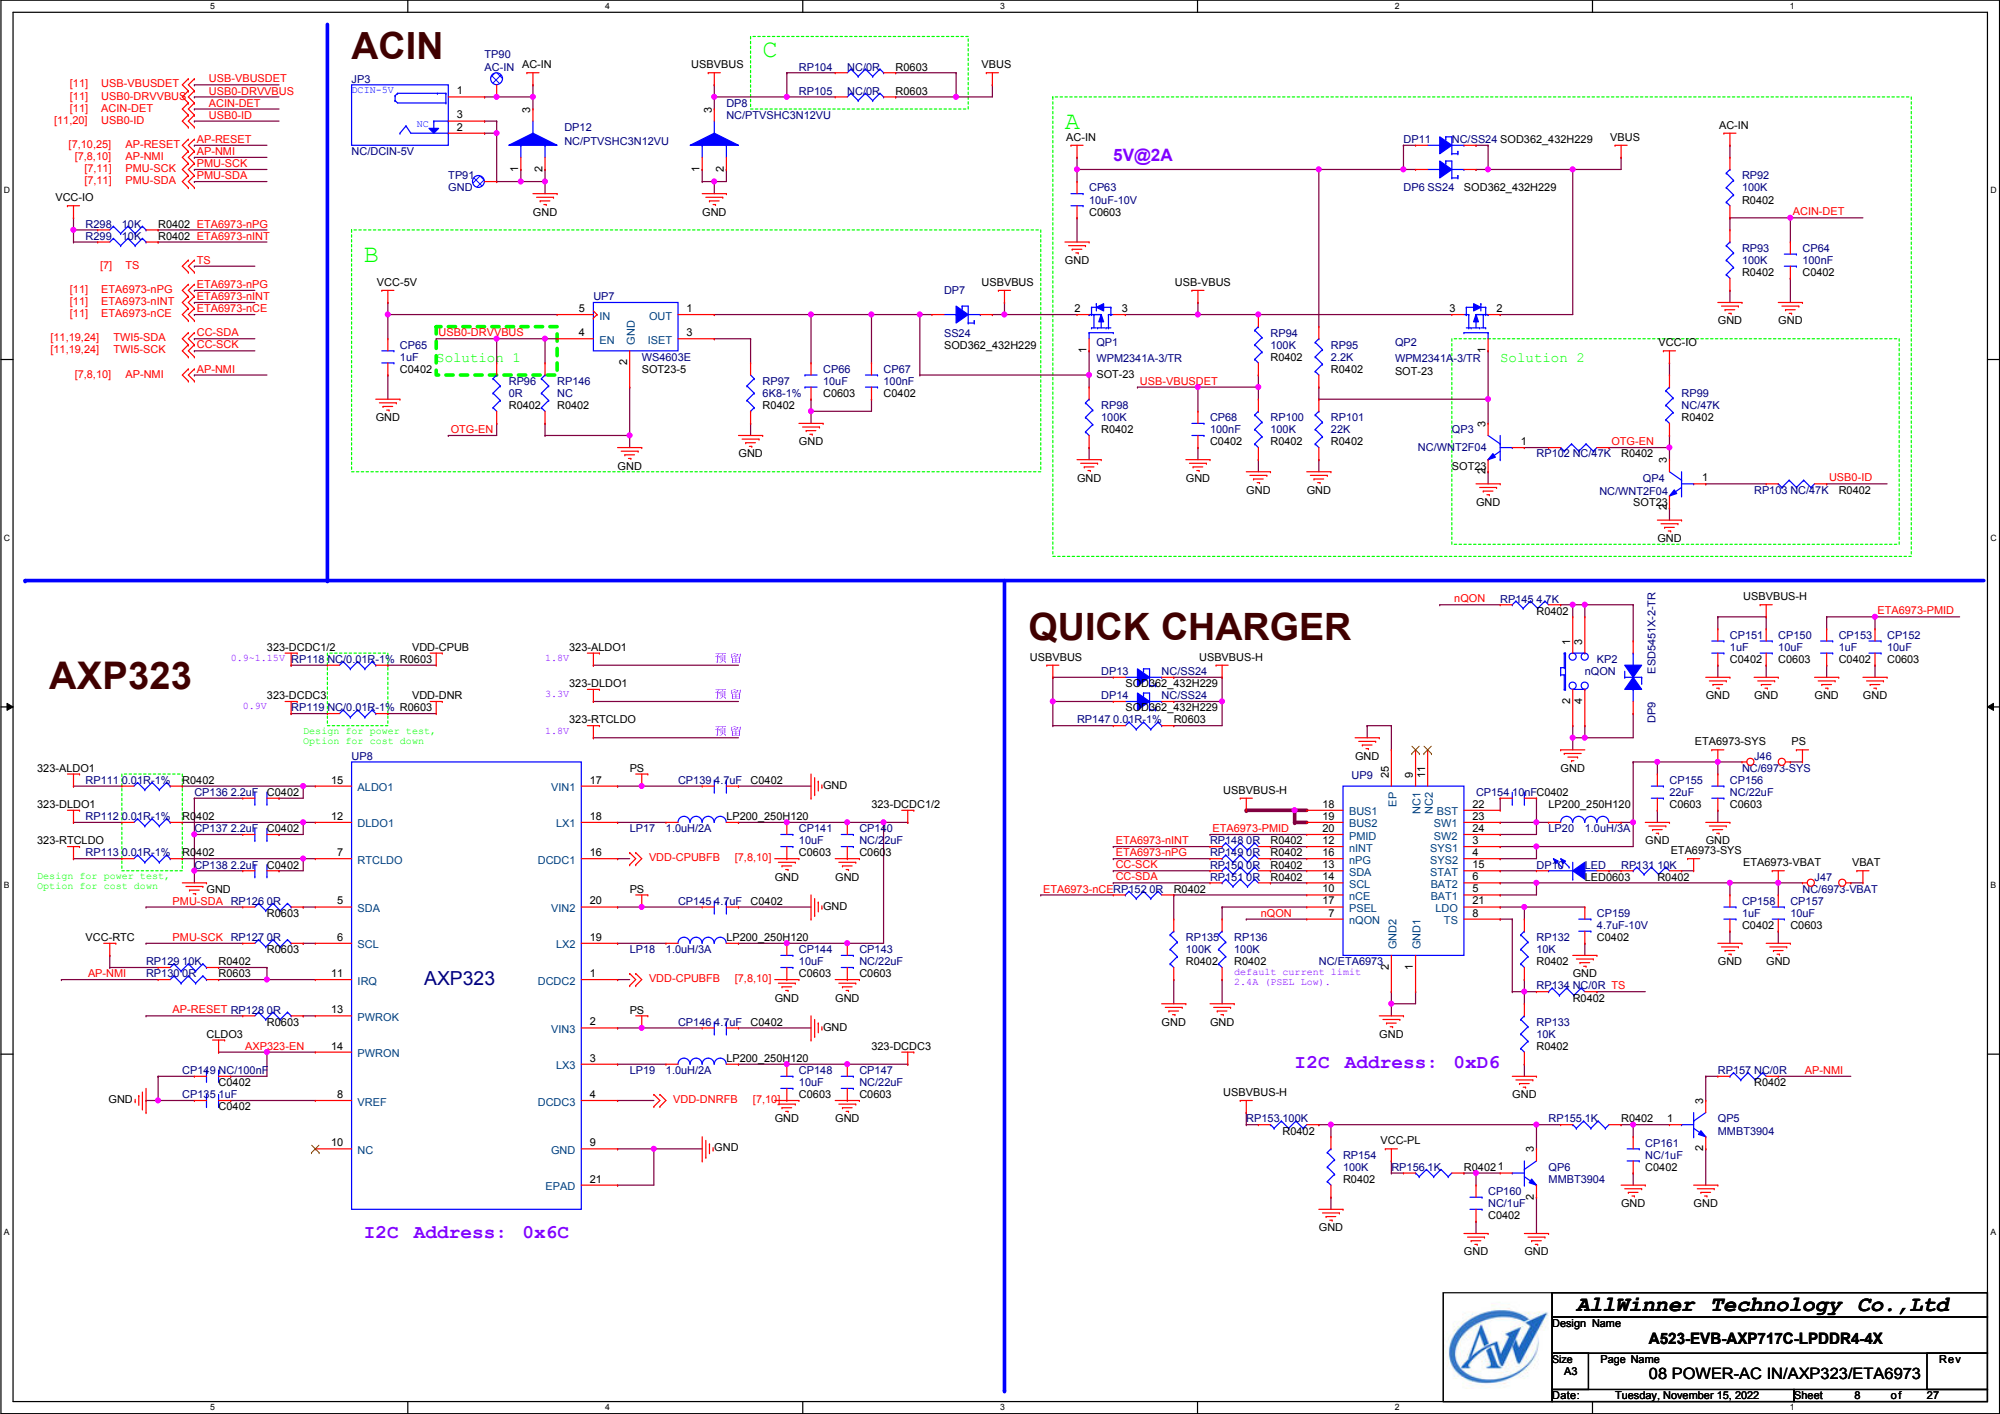
[picture p370: page 8]

Design for power test,
Option for cost down

# LPDDR4-4X

# SA9 -SA11 SA12

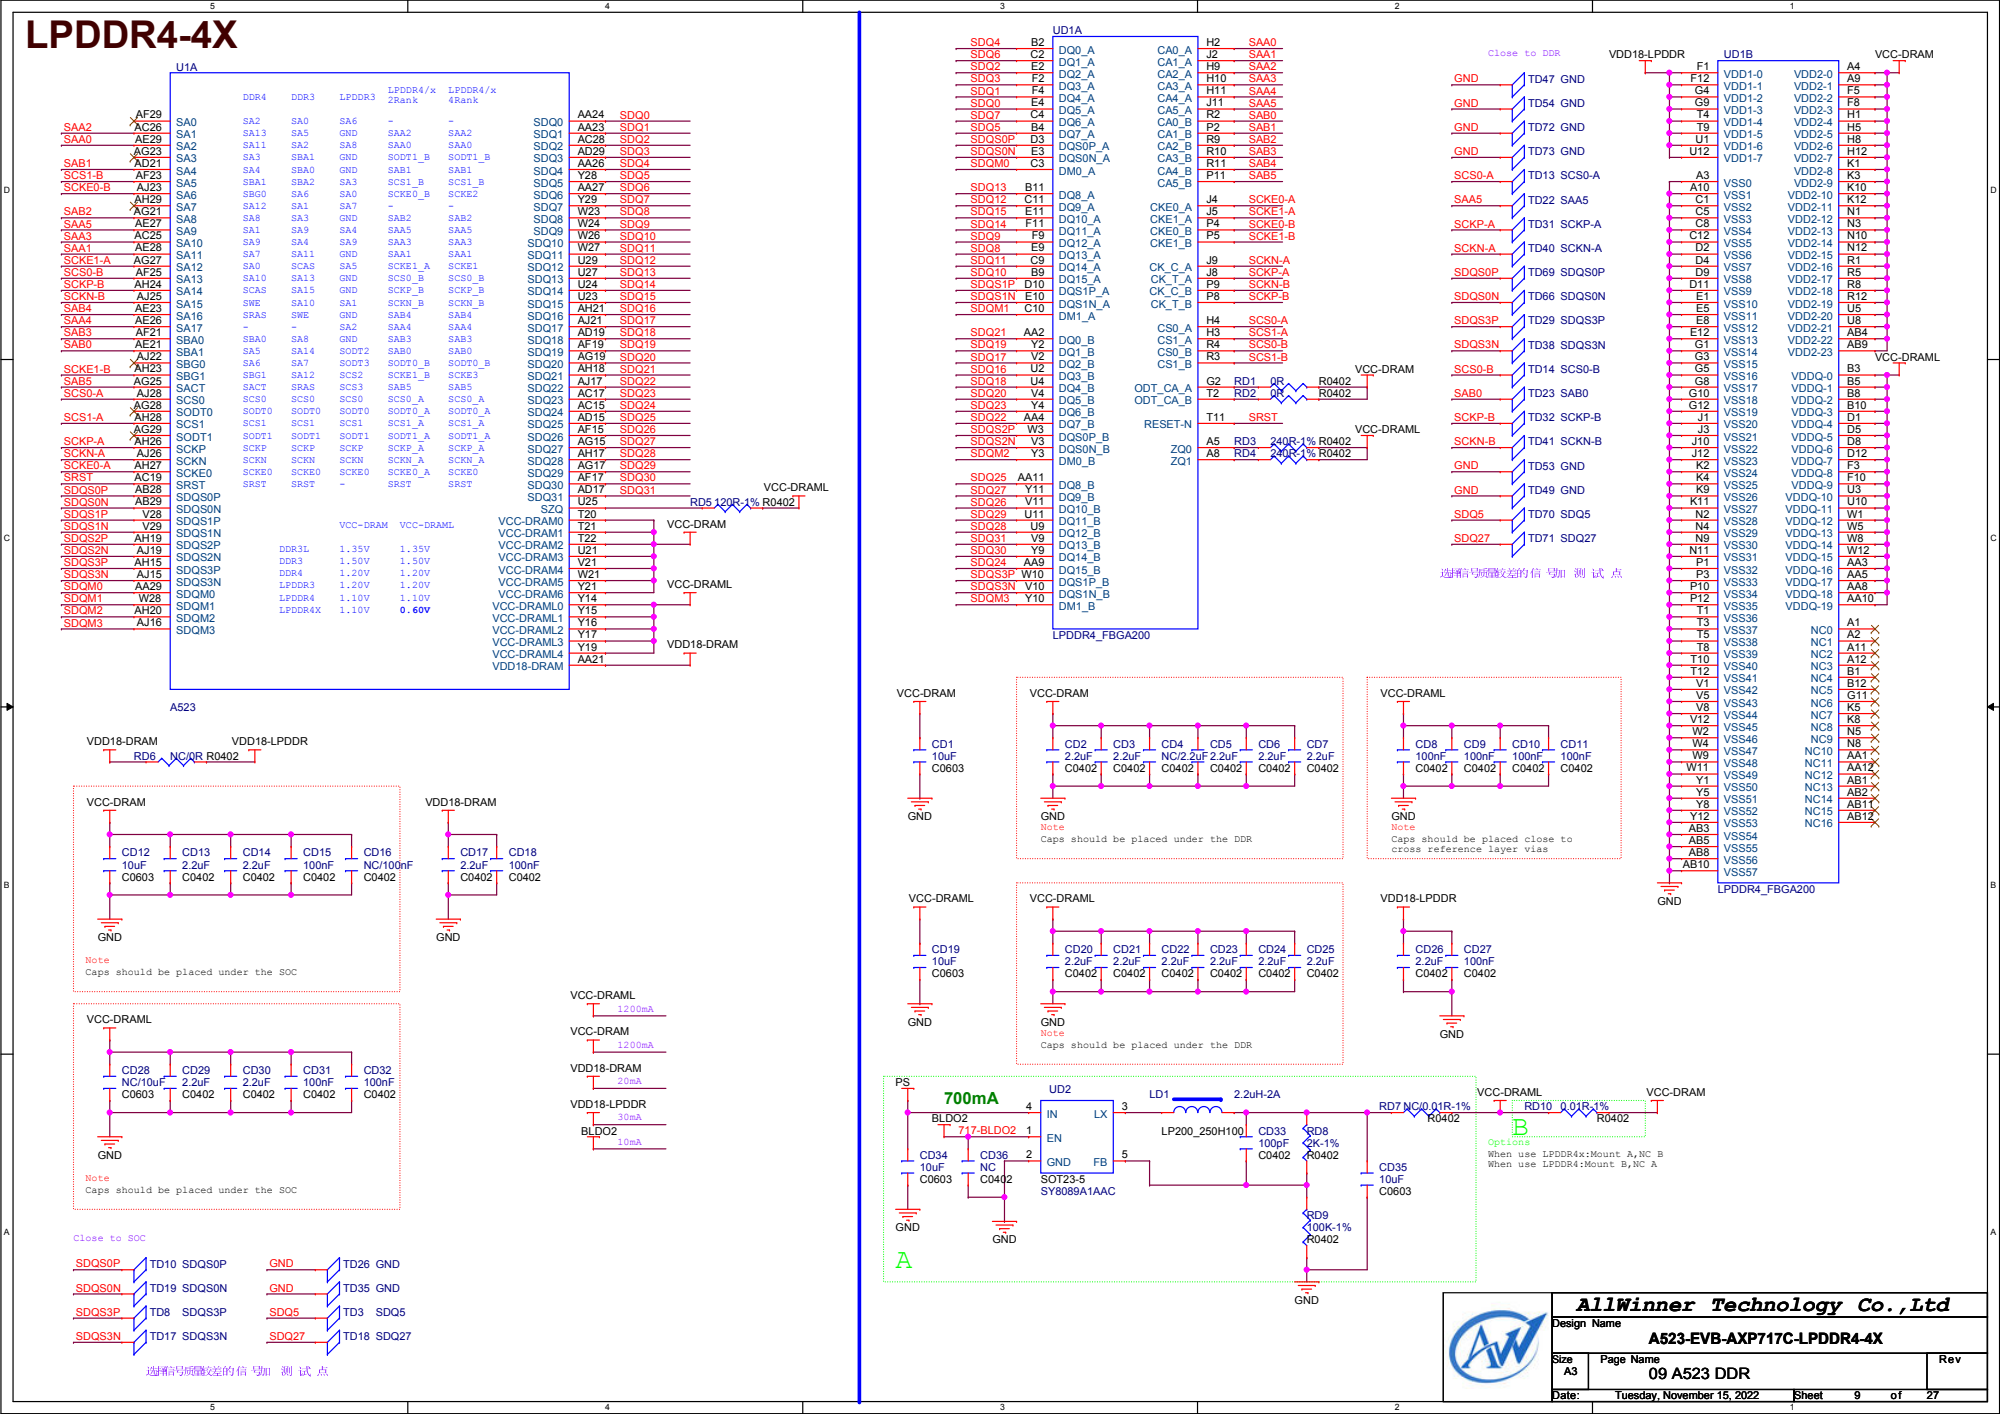
[picture p371: page 9]

GND
Note
Caps should be placed under the DDR

Caps should be placed close to
cross reference layer vias

Caps should be placed under the SOC

Options
When use LPDDR4x:Mount A,NC B
When use LPDDR4:Mount B,NC A

SYS | CORE POWER

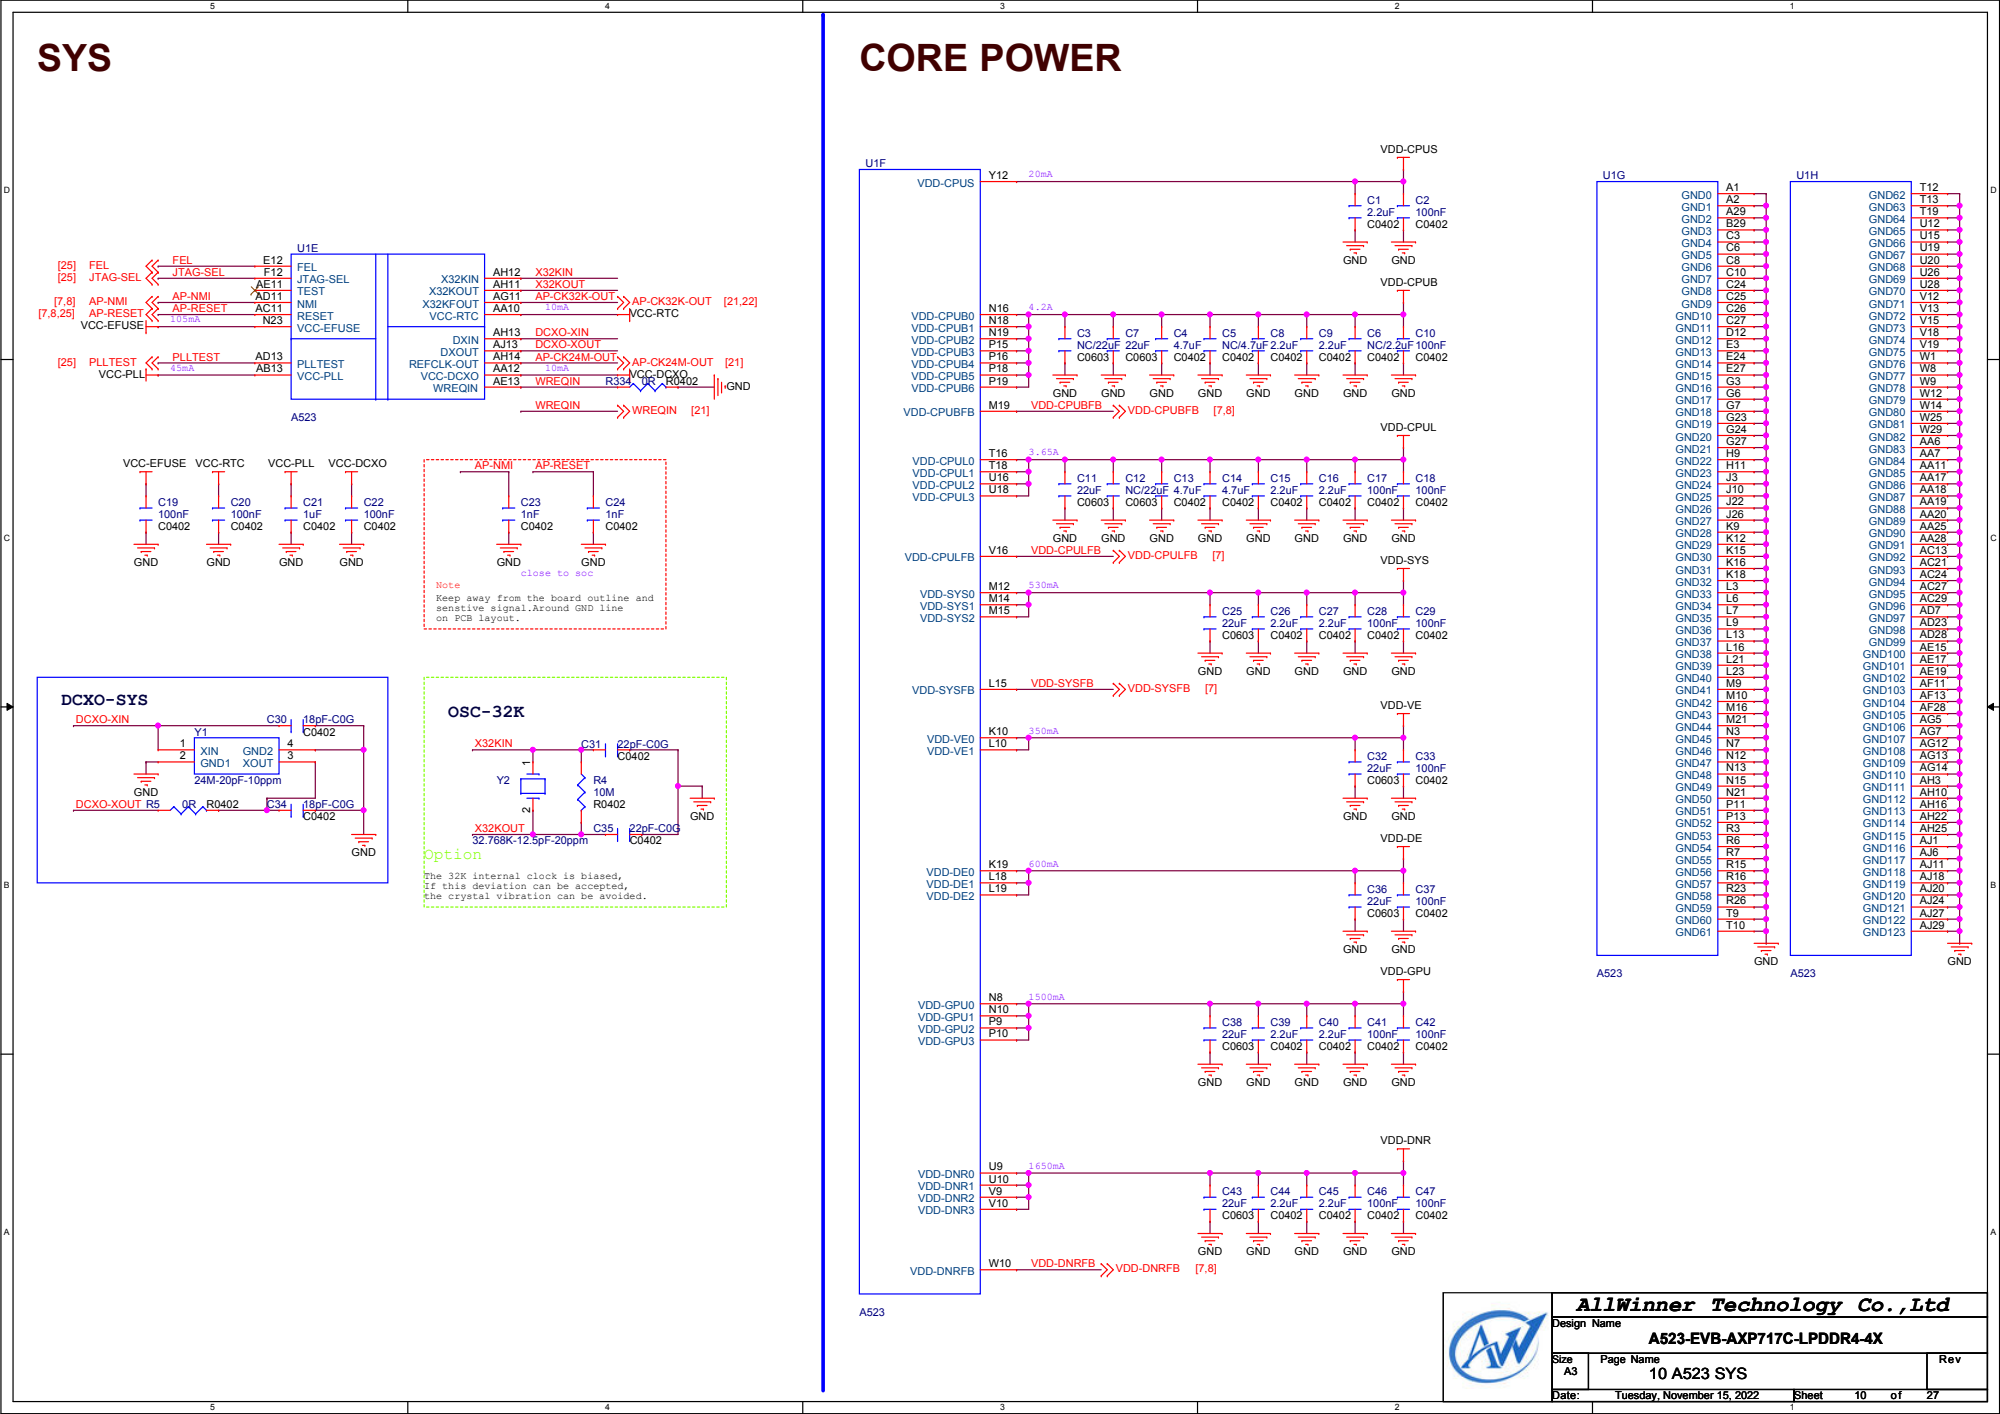
[picture p372: page 10]

Note
Keep away from the board outline and
senstive signal.Around GND line
on PCB layout.

The 32K internal clock is biased,
If this deviation can be accepted,
the crystal vibration can be avoided.

# GPIO

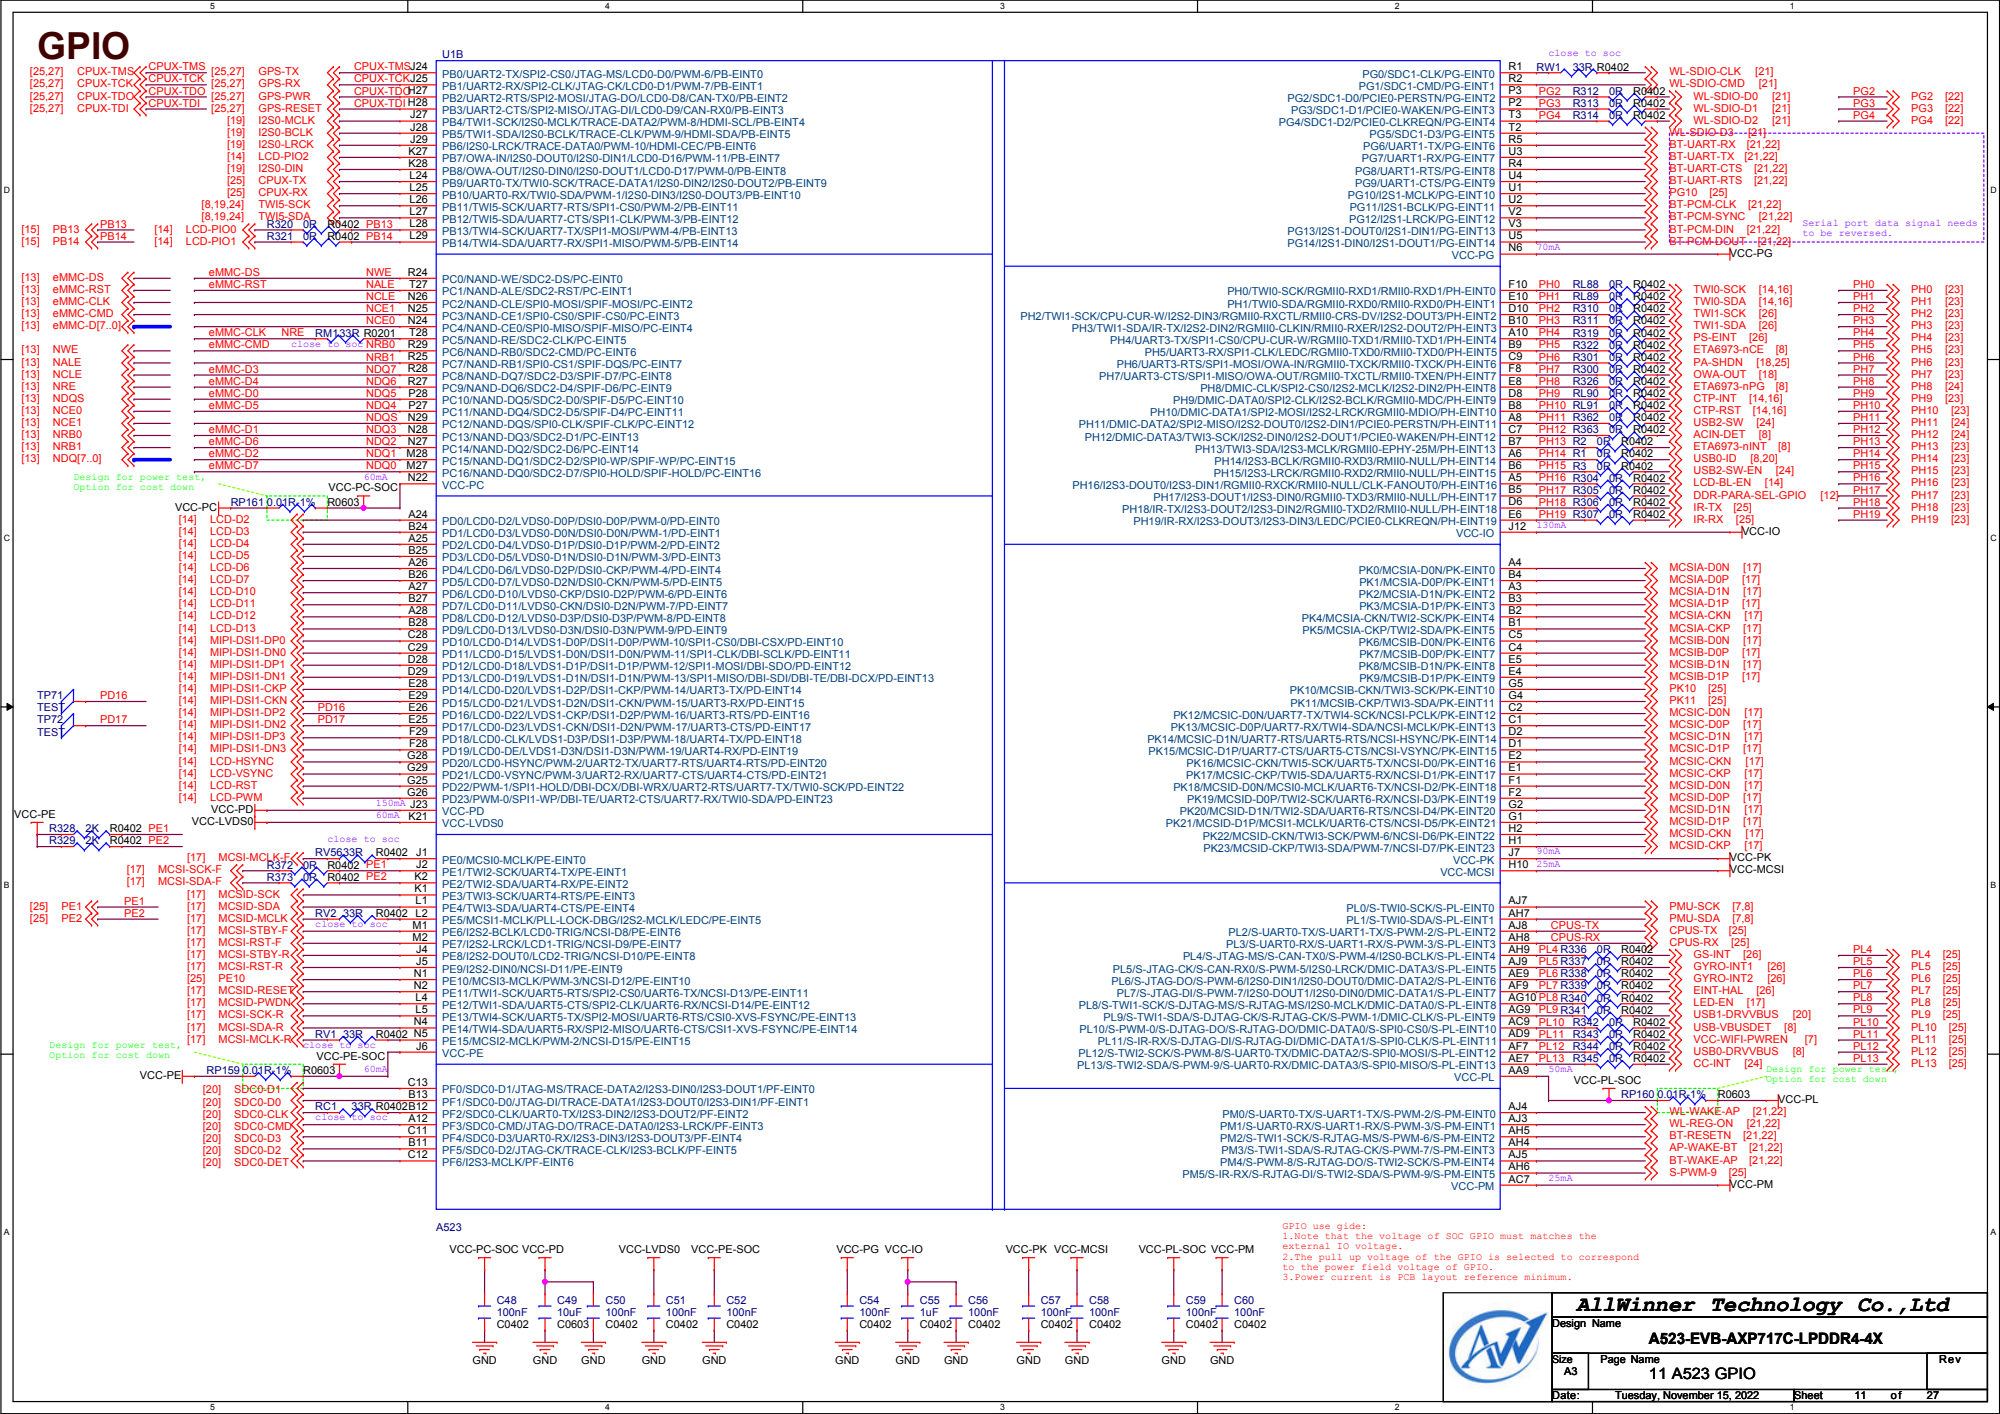
[picture p373: page 11]

PB0/UART2-TX/SPI2-CS0/JTAG-MS/LCD0-D0/PWM-6/PB-EINT0 J24
PB1/UART2-RX/SPI2-CLK/JTAG-CK/LCD0-D1/PWM-7/PB-EINT1 J25
PB2/UART2-RTS/SPI2-MOSI/JTAG-DO/LCD0-D8/CAN-TX0/PB-EINT2 H27
PB3/UART2-CTS/SPI2-MISO/JTAG-DI/LCD0-D9/CAN-RX0/PB-EINT3 H28
PB4/TWI1-SCK/I2S0-MCLK/TRACE-DATA2/PWM-8/HDMI-SCL/PB-EINT4 J27
PB5/TWI1-SDA/I2S0-BCLK/TRACE-CLK/PWM-9/HDMI-SDA/PB-EINT5 J28
PB6/I2S0-LRCK/TRACE-DATA0/PWM-10/HDMI-CEC/PB-EINT6 J29
PB7/OWA-IN/I2S0-DOUT0/I2S0-DIN1/LCD0-D16/PWM-11/PB-EINT7 K27
PB8/OWA-OUT/I2S0-DIN0/I2S0-DOUT1/LCD0-D17/PWM-0/PB-EINT8 K28
PB9/UART0-TX/TWI0-SCK/TRACE-DATA1/I2S0-DIN2/I2S0-DOUT2/PB-EINT9 L24
PB10/UART0-RX/TWI0-SDA/PWM-1/I2S0-DIN3/I2S0-DOUT3/PB-EINT10 L25
PB11/TWI5-SCK/UART7-RTS/SPI1-CS0/PWM-2/PB-EINT11 L26
PB12/TWI5-SDA/UART7-CTS/SPI1-CLK/PWM-3/PB-EINT12 L27
PB13/TWI4-SCK/UART7-TX/SPI1-MOSI/PWM-4/PB-EINT13 L28
PB14/TWI4-SDA/UART7-RX/SPI1-MISO/PWM-5/PB-EINT14 L29

Serial port data signal needs
to be reversed.

PC0/NAND-WE/SDC2-DS/PC-EINT0 R24
PC1/NAND-ALE/SDC2-RST/PC-EINT1 T27
PC2/NAND-CLE/SPI0-MOSI/SPIF-MOSI/PC-EINT2 N26
PC3/NAND-CE1/SPI0-CS0/SPIF-CS0/PC-EINT3 N25
PC4/NAND-CE0/SPI0-MISO/SPIF-MISO/PC-EINT4 N24
PC5/NAND-RE/SDC2-CLK/PC-EINT5 T28
PC6/NAND-RB0/SDC2-CMD/PC-EINT6 R29
PC7/NAND-RB1/SPI0-CS1/SPIF-DQS/PC-EINT7 R25
PC8/NAND-DQ7/SDC2-D3/SPIF-D7/PC-EINT8 R28
PC9/NAND-DQ6/SDC2-D4/SPIF-D6/PC-EINT9 R27
PC10/NAND-DQ5/SDC2-D0/SPIF-D5/PC-EINT10 P28
PC11/NAND-DQ4/SDC2-D5/SPIF-D4/PC-EINT11 P27
PC12/NAND-DQS/SPI0-CLK/SPIF-CLK/PC-EINT12 N29
PC13/NAND-DQ3/SDC2-D1/PC-EINT13 N28
PC14/NAND-DQ2/SDC2-D6/PC-EINT14 N27
PC15/NAND-DQ1/SDC2-D2/SPI0-WP/SPIF-WP/PC-EINT15 M28
PC16/NAND-DQ0/SDC2-D7/SPI0-HOLD/SPIF-HOLD/PC-EINT16 M27
VCC-PC N22

PH2/TWI1-SCK/CPU-CUR-W/I2S2-DIN3/RGMII0-RXCTL/RMII0-CRS-DV/I2S2-DOUT3/PH-EINT2 D10

PH3/TWI1-SDA/IR-TX/I2S2-DIN2/RGMII0-CLKIN/RMII0-RXER/I2S2-DOUT2/PH-EINT3 B10

PH4/UART3-TX/SPI1-CS0/CPU-CUR-W/RGMII0-TXD1/RMII0-TXD1/PH-EINT4 A10

PH5/UART3-RX/SPI1-CLK/LEDC/RGMII0-TXD0/RMII0-TXD0/PH-EINT5 B9
PH6/UART3-RTS/SPI1-MOSI/OWA-IN/RGMII0-TXCK/RMII0-TXCK/PH-EINT6 C9
PH7/UART3-CTS/SPI1-MISO/OWA-OUT/RGMII0-TXCTL/RMII0-TXEN/PH-EINT7 F8

PH10/DMIC-DATA1/SPI2-MOSI/I2S2-LRCK/RGMII0-MDIO/PH-EINT10 B8

PH11/DMIC-DATA2/SPI2-MISO/I2S2-DOUT0/I2S2-DIN1/PCIE0-PERSTN/PH-EINT11 A8

Design for power test,
Option for cost down

PH16/I2S3-DOUT0/I2S3-DIN1/RGMII0-RXCK/RMII0-NULL/CLK-FANOUT0/PH-EINT16 A5

PH18/IR-TX/I2S3-DOUT2/I2S3-DIN2/RGMII0-TXD2/RMII0-NULL/PH-EINT18 D6
PH19/IR-RX/I2S3-DOUT3/I2S3-DIN3/LEDC/PCIE0-CLKREQN/PH-EINT19 E6

PD0/LCD0-D2/LVDS0-D0P/DSI0-D0P/PWM-0/PD-EINT0 A24
PD1/LCD0-D3/LVDS0-D0N/DSI0-D0N/PWM-1/PD-EINT1 B24
PD2/LCD0-D4/LVDS0-D1P/DSI0-D1P/PWM-2/PD-EINT2 A25
PD3/LCD0-D5/LVDS0-D1N/DSI0-D1N/PWM-3/PD-EINT3 B25
PD4/LCD0-D6/LVDS0-D2P/DSI0-CKP/PWM-4/PD-EINT4 A26
PD5/LCD0-D7/LVDS0-D2N/DSI0-CKN/PWM-5/PD-EINT5 B26
PD6/LCD0-D10/LVDS0-CKP/DSI0-D2P/PWM-6/PD-EINT6 A27
PD7/LCD0-D11/LVDS0-CKN/DSI0-D2N/PWM-7/PD-EINT7 B27
PD8/LCD0-D12/LVDS0-D3P/DSI0-D3P/PWM-8/PD-EINT8 A28
PD9/LCD0-D13/LVDS0-D3N/DSI0-D3N/PWM-9/PD-EINT9 B28
PD10/LCD0-D14/LVDS1-D0P/DSI1-D0P/PWM-10/SPI1-CS0/DBI-CSX/PD-EINT10 C28
PD11/LCD0-D15/LVDS1-D0N/DSI1-D0N/PWM-11/SPI1-CLK/DBI-SCLK/PD-EINT11 C29
PD12/LCD0-D18/LVDS1-D1P/DSI1-D1P/PWM-12/SPI1-MOSI/DBI-SDO/PD-EINT12 D28
PD13/LCD0-D19/LVDS1-D1N/DSI1-D1N/PWM-13/SPI1-MISO/DBI-SDI/DBI-TE/DBI-DCX/PD-EINT13 D29
PD14/LCD0-D20/LVDS1-D2P/DSI1-CKP/PWM-14/UART3-TX/PD-EINT14 E28
PD15/LCD0-D21/LVDS1-D2N/DSI1-CKN/PWM-15/UART3-RX/PD-EINT15 E29
PD16/LCD0-D22/LVDS1-CKP/DSI1-D2P/PWM-16/UART3-RTS/PD-EINT16 E26
PD17/LCD0-D23/LVDS1-CKN/DSI1-D2N/PWM-17/UART3-CTS/PD-EINT17 E25
PD18/LCD0-CLK/LVDS1-D3P/DSI1-D3P/PWM-18/UART4-TX/PD-EINT18 F29
PD19/LCD0-DE/LVDS1-D3N/DSI1-D3N/PWM-19/UART4-RX/PD-EINT19 F28
PD20/LCD0-HSYNC/PWM-2/UART2-TX/UART7-RTS/UART4-RTS/PD-EINT20 G28
PD21/LCD0-VSYNC/PWM-3/UART2-RX/UART7-CTS/UART4-CTS/PD-EINT21 G29
PD22/PWM-1/SPI1-HOLD/DBI-DCX/DBI-WRX/UART2-RTS/UART7-TX/TWI0-SCK/PD-EINT22 G25
PD23/PWM-0/SPI1-WP/DBI-TE/UART2-CTS/UART7-RX/TWI0-SDA/PD-EINT23 G26
VCC-PD J23
VCC-LVDS0 K21

PK14/MCSIC-D1N/UART7-RTS/UART5-RTS/NCSI-HSYNC/PK-EINT14 D2
PK15/MCSIC-D1P/UART7-CTS/UART5-CTS/NCSI-VSYNC/PK-EINT15 D1

PK18/MCSID-D0N/MCSI0-MCLK/UART6-TX/NCSI-D2/PK-EINT18 F1
PK21/MCSID-D1P/MCSI1-MCLK/UART6-CTS/NCSI-D5/PK-EINT21 G1

PE0/MCSI0-MCLK/PE-EINT0 J1
PE1/TWI2-SCK/UART4-TX/PE-EINT1 J2
PE2/TWI2-SDA/UART4-RX/PE-EINT2 K2
PE3/TWI3-SCK/UART4-RTS/PE-EINT3 K1
PE4/TWI3-SDA/UART4-CTS/PE-EINT4 L1
PE5/MCSI1-MCLK/PLL-LOCK-DBG/I2S2-MCLK/LEDC/PE-EINT5 L2
PE6/I2S2-BCLK/LCD0-TRIG/NCSI-D8/PE-EINT6 M1
PE7/I2S2-LRCK/LCD1-TRIG/NCSI-D9/PE-EINT7 M2
PE8/I2S2-DOUT0/LCD2-TRIG/NCSI-D10/PE-EINT8 J4
PE9/I2S2-DIN0/NCSI-D11/PE-EINT9 J5
PE10/MCSI3-MCLK/PWM-3/NCSI-D12/PE-EINT10 N1
PE11/TWI1-SCK/UART5-RTS/SPI2-CS0/UART6-TX/NCSI-D13/PE-EINT11 N2
PE12/TWI1-SDA/UART5-CTS/SPI2-CLK/UART6-RX/NCSI-D14/PE-EINT12 L4
PE13/TWI4-SCK/UART5-TX/SPI2-MOSI/UART6-RTS/CSI0-XVS-FSYNC/PE-EINT13 L5
PE14/TWI4-SDA/UART5-RX/SPI2-MISO/UART6-CTS/CSI1-XVS-FSYNC/PE-EINT14 N4
PE15/MCSI2-MCLK/PWM-2/NCSI-D15/PE-EINT15 N5
VCC-PE J6

PL5/S-JTAG-CK/S-CAN-RX0/S-PWM-5/I2S0-LRCK/DMIC-DATA3/S-PL-EINT5 AJ9

PL8/S-TWI1-SCK/S-DJTAG-MS/S-RJTAG-MS/I2S0-MCLK/DMIC-DATA0/S-PL-EINT8 AG10
PL10/S-PWM-0/S-DJTAG-DO/S-RJTAG-DO/DMIC-DATA0/S-SPI0-CS0/S-PL-EINT10 AC9
PL11/S-IR-RX/S-DJTAG-DI/S-RJTAG-DI/DMIC-DATA1/S-SPI0-CLK/S-PL-EINT11 AD9

PF0/SDC0-D1/JTAG-MS/TRACE-DATA2/I2S3-DIN0/I2S3-DOUT1/PF-EINT0 C13
PF1/SDC0-D0/JTAG-DI/TRACE-DATA1/I2S3-DOUT0/I2S3-DIN1/PF-EINT1 B13
PF2/SDC0-CLK/UART0-TX/I2S3-DIN2/I2S3-DOUT2/PF-EINT2 B12
PF3/SDC0-CMD/JTAG-DO/TRACE-DATA0/I2S3-LRCK/PF-EINT3 A12
PF4/SDC0-D3/UART0-RX/I2S3-DIN3/I2S3-DOUT3/PF-EINT4 C11
PF5/SDC0-D2/JTAG-CK/TRACE-CLK/I2S3-BCLK/PF-EINT5 B11
PF6/I2S3-MCLK/PF-EINT6 C12

GPIO use gide:
1.Note that the voltage of SOC GPIO must matches the
external IO voltage.
2.The pull up voltage of the GPIO is selected to correspond
to the power field voltage of GPIO.
3.Power current is PCB layout reference minimum.

# Audio&ADC

## SMHC0->MLC NAND->SLC NAND->try

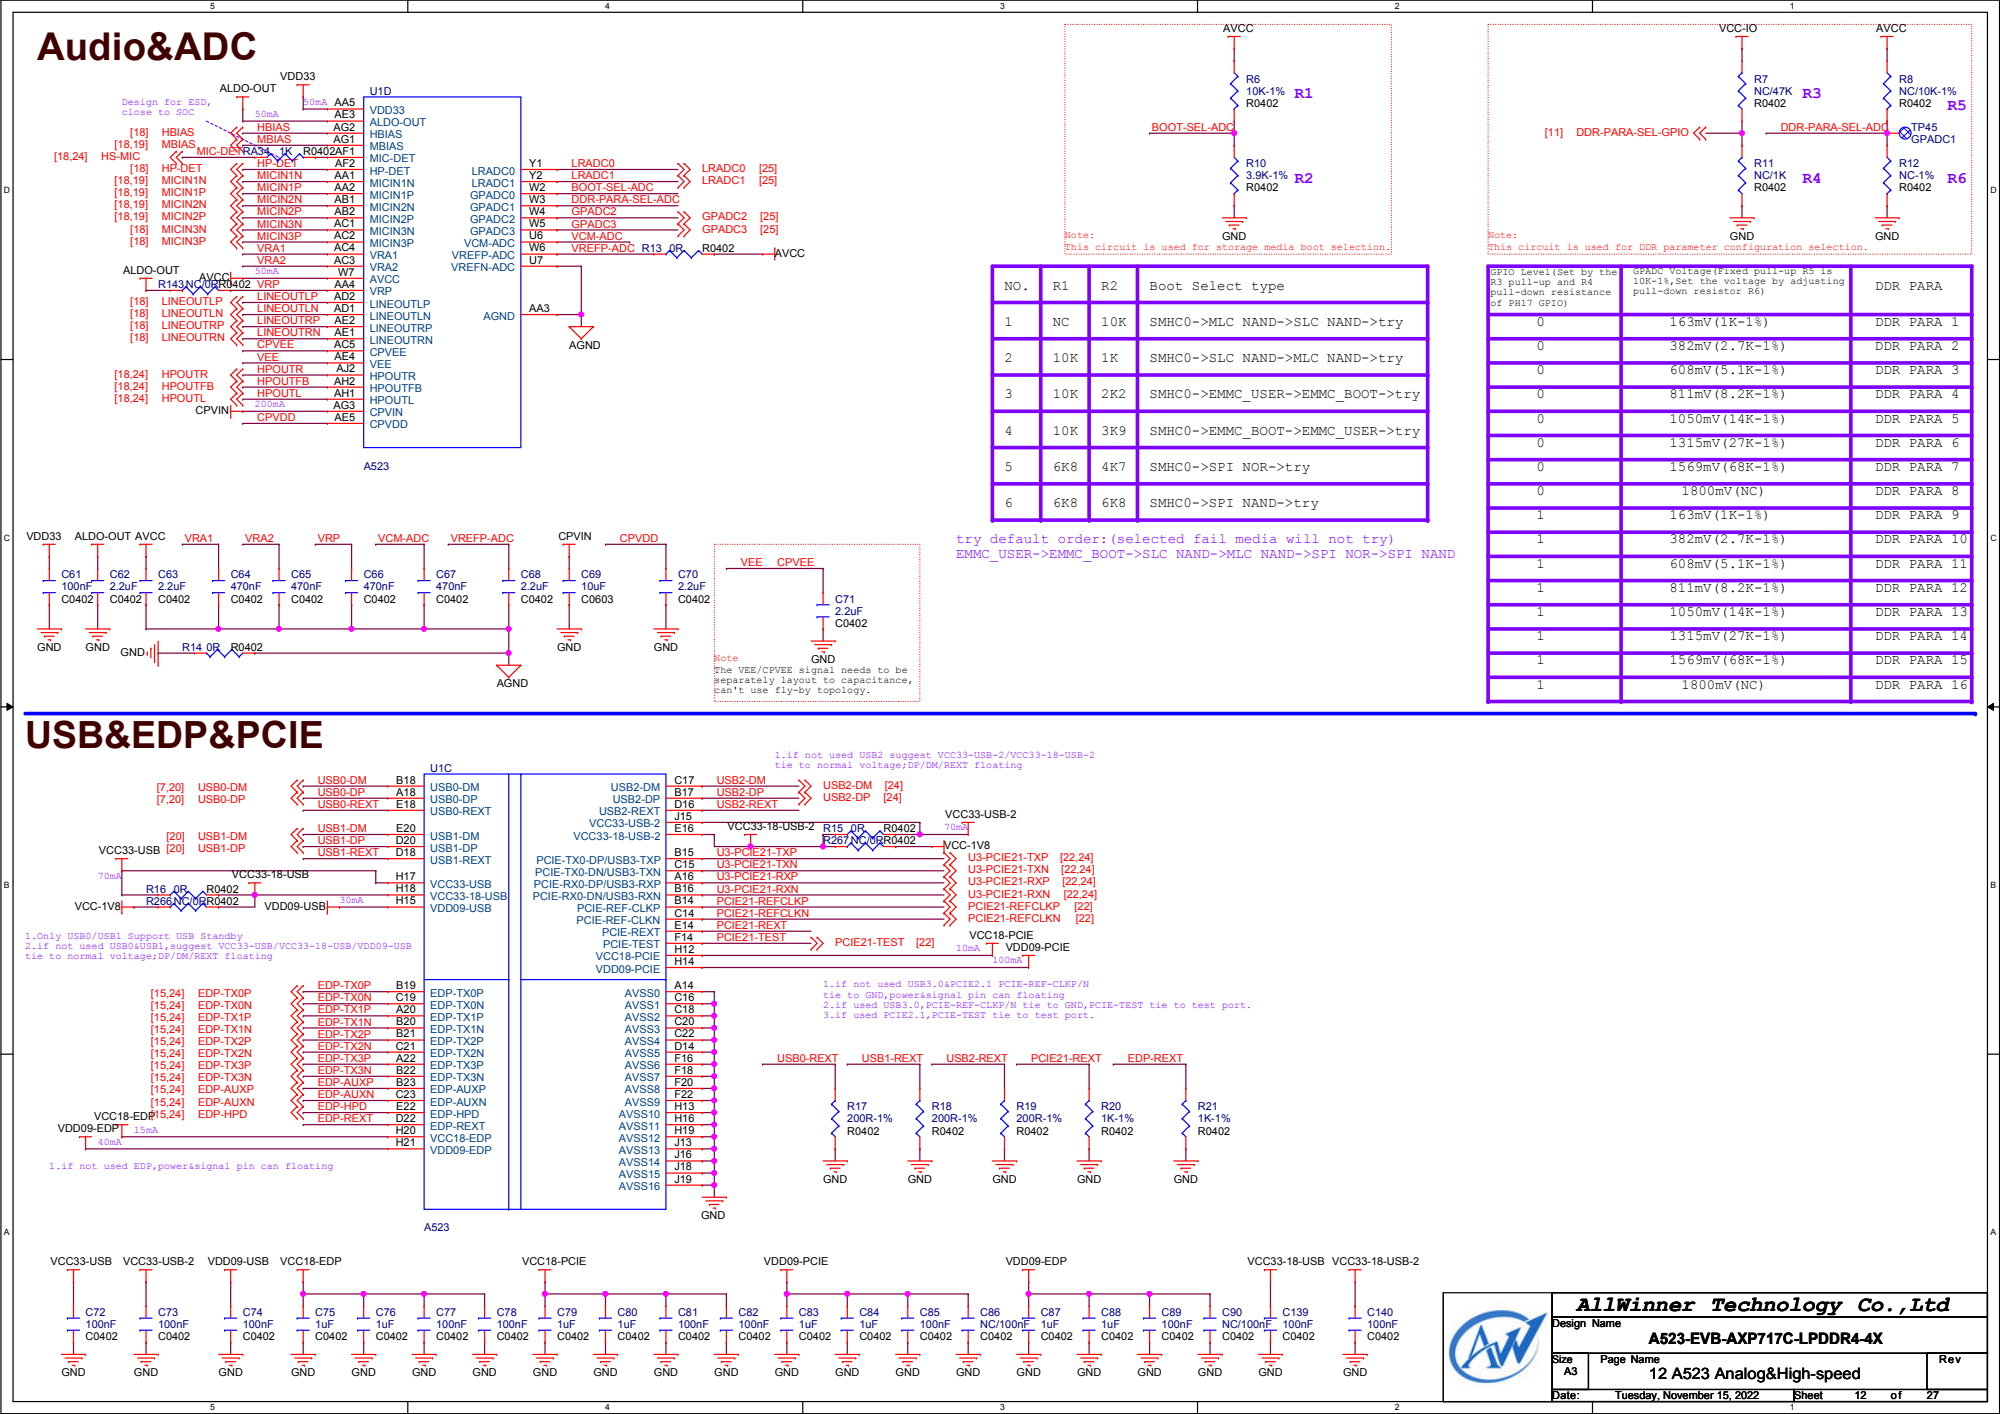
[picture p374: page 12]

DDR-PARA-SEL-ADC

[11] DDR-PARA-SEL-GPIO

Note:
This circuit is used for storage media boot selection.

This circuit is used for DDR parameter configuration selection.

GPIO Level(Set by the
R3 pull-up and R4
pull-down resistance
of PH17 GPIO)

GPADC Voltage(Fixed pull-up R5 is
10K-1%,Set the voltage by adjusting
pull-down resistor R6)

SMHC0->SLC NAND->MLC NAND->try

0 | 1315mV(27K-1%) | DDR PARA 6
0 | 1569mV(68K-1%) | DDR PARA 7

5 | 6K8 | 4K7 | SMHC0->SPI NOR->try

1 | 163mV(1K-1%) | DDR PARA 9
1 | 382mV(2.7K-1%) | DDR PARA 10
1 | 608mV(5.1K-1%) | DDR PARA 11
1 | 811mV(8.2K-1%) | DDR PARA 12
1 | 1050mV(14K-1%) | DDR PARA 13

try default order:(selected fail media will not try)
EMMC_USER->EMMC_BOOT->SLC NAND->MLC NAND->SPI NOR->SPI NAND

Note
The VEE/CPVEE signal needs to be
separately layout to capacitance,
can't use fly-by topology.

1.if not used USB2 suggest VCC33-USB-2/VCC33-18-USB-2
tie to normal voltage;DP/DM/REXT floating

1.Only USB0/USB1 Support USB Standby
2.if not used USB0&USB1,suggest VCC33-USB/VCC33-18-USB/VDD09-USB

1.if not used USB3.0&PCIE2.1 PCIE-REF-CLKP/N
tie to GND,power&signal pin can floating
2.if used USB3.0,PCIE-REF-CLKP/N tie to GND,PCIE-TEST tie to test port.
3.if used PCIE2.1,PCIE-TEST tie to test port.

1.if not used EDP,power&signal pin can floating

BGA NAND Option | Compatible BGA132

# EMMC Default:use EMMC

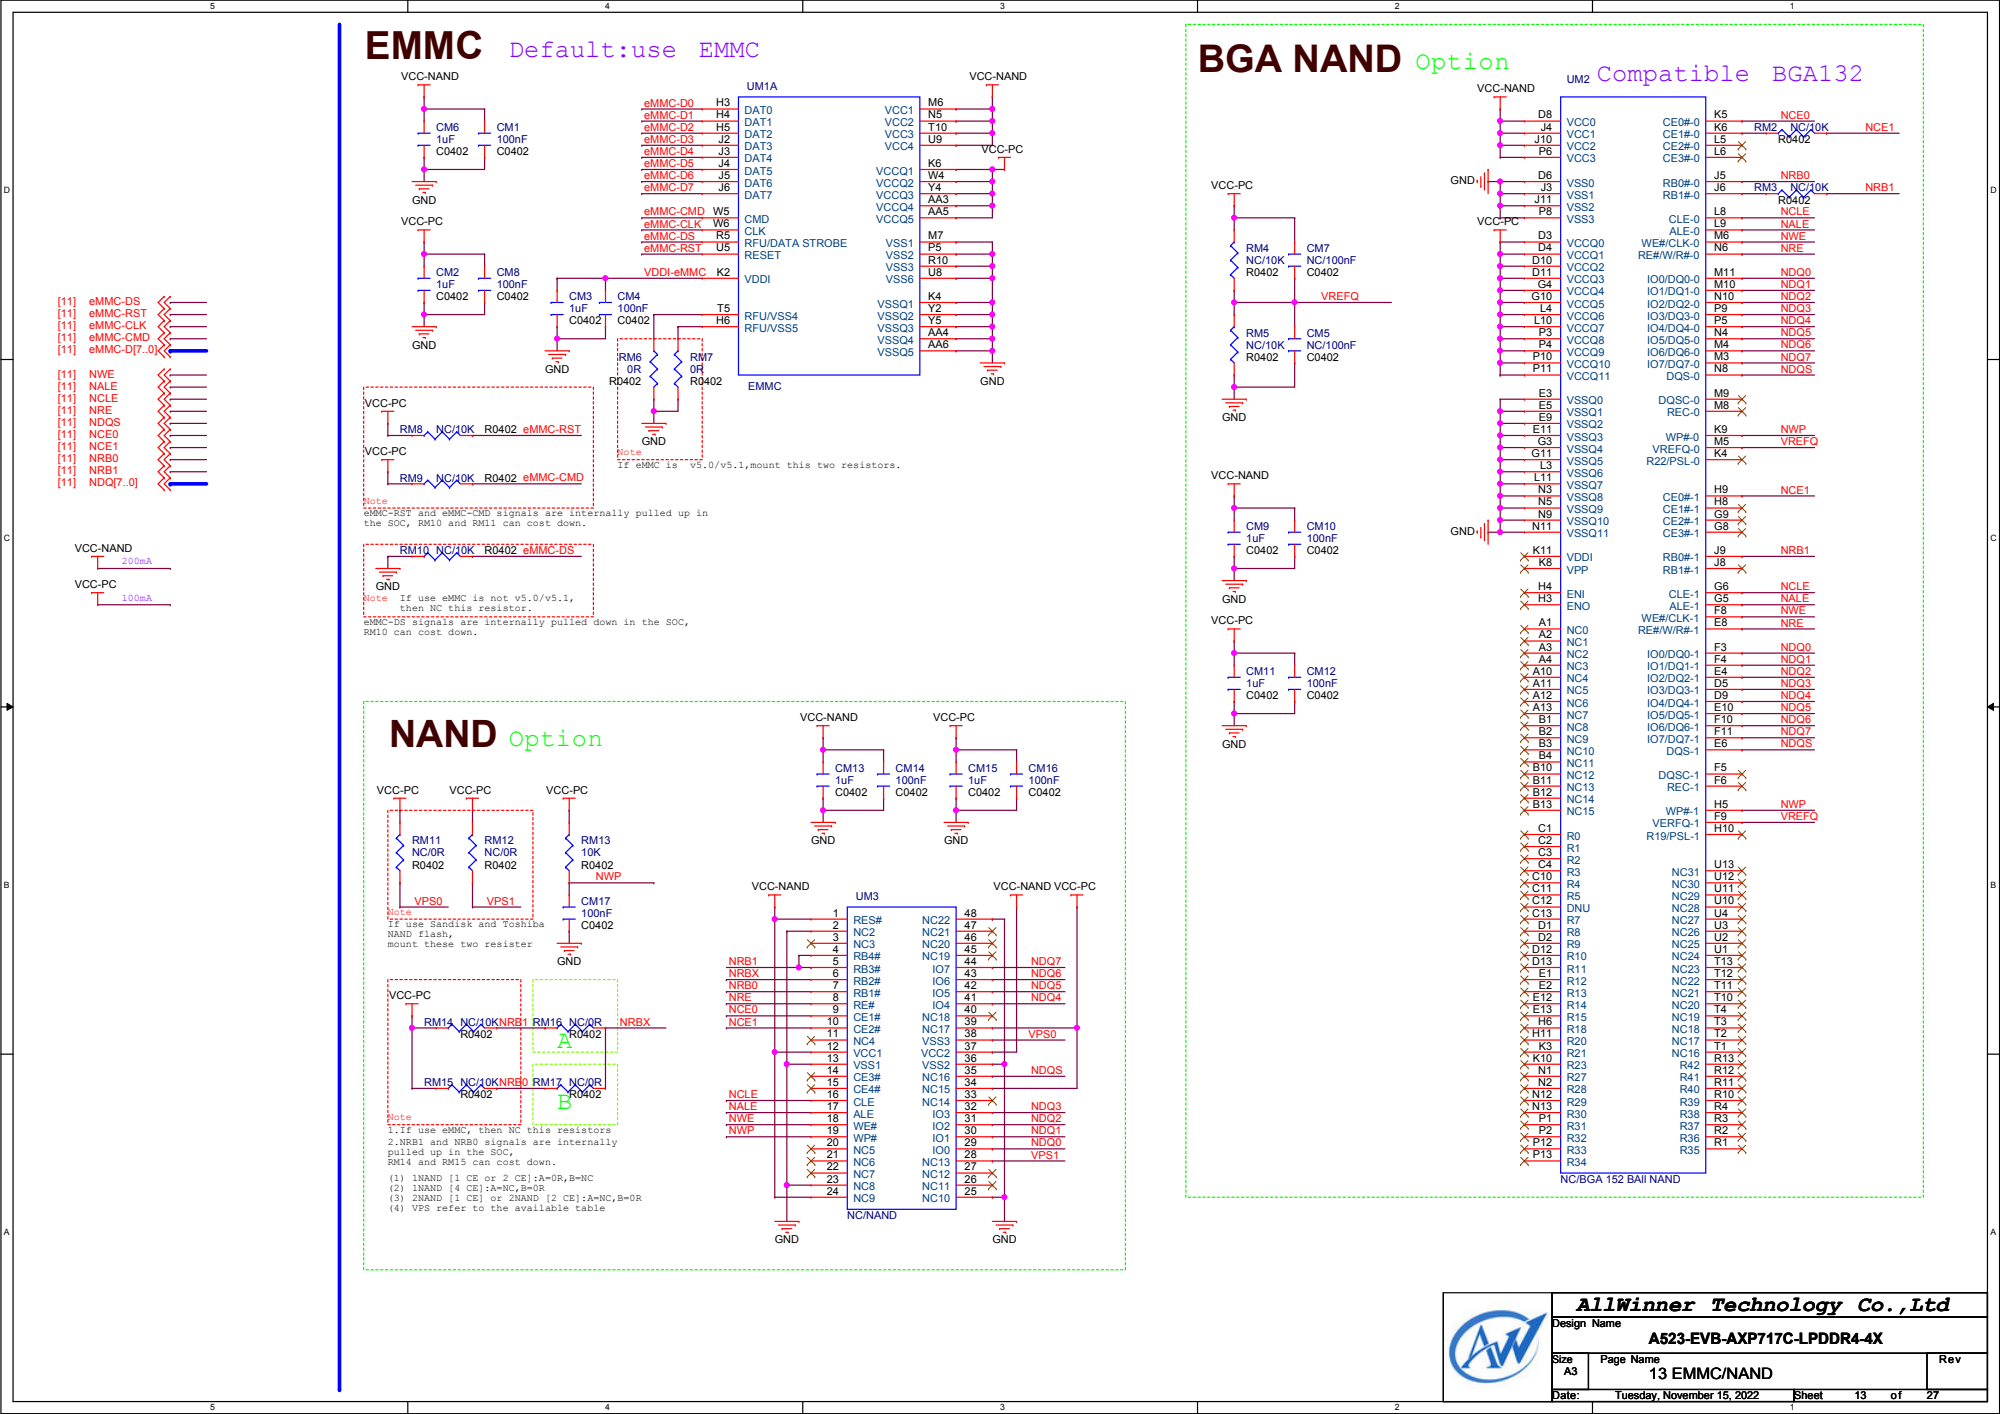
[picture p375: page 13]

Note
eMMC-RST and eMMC-CMD signals are internally pulled up in
the SOC, RM10 and RM11 can cost down.

then NC this resistor.

eMMC-DS signals are internally pulled down in the SOC,
RM10 can cost down.

VCC-NAND VCC-PC

If use Sandisk and Toshiba
NAND flash,
mount these two resister

1.If use eMMC, then NC this resistors
2.NRB1 and NRB0 signals are internally
pulled up in the SOC,
RM14 and RM15 can cost down.
(1) 1NAND [1 CE or 2 CE]:A=0R,B=NC
(2) 1NAND [4 CE]:A=NC,B=0R
(3) 2NAND [1 CE] or 2NAND [2 CE]:A=NC,B=0R
(4) VPS refer to the available table

NC/BGA 152 BAll NAND

## Differential pairs : Z0= 100 ohm

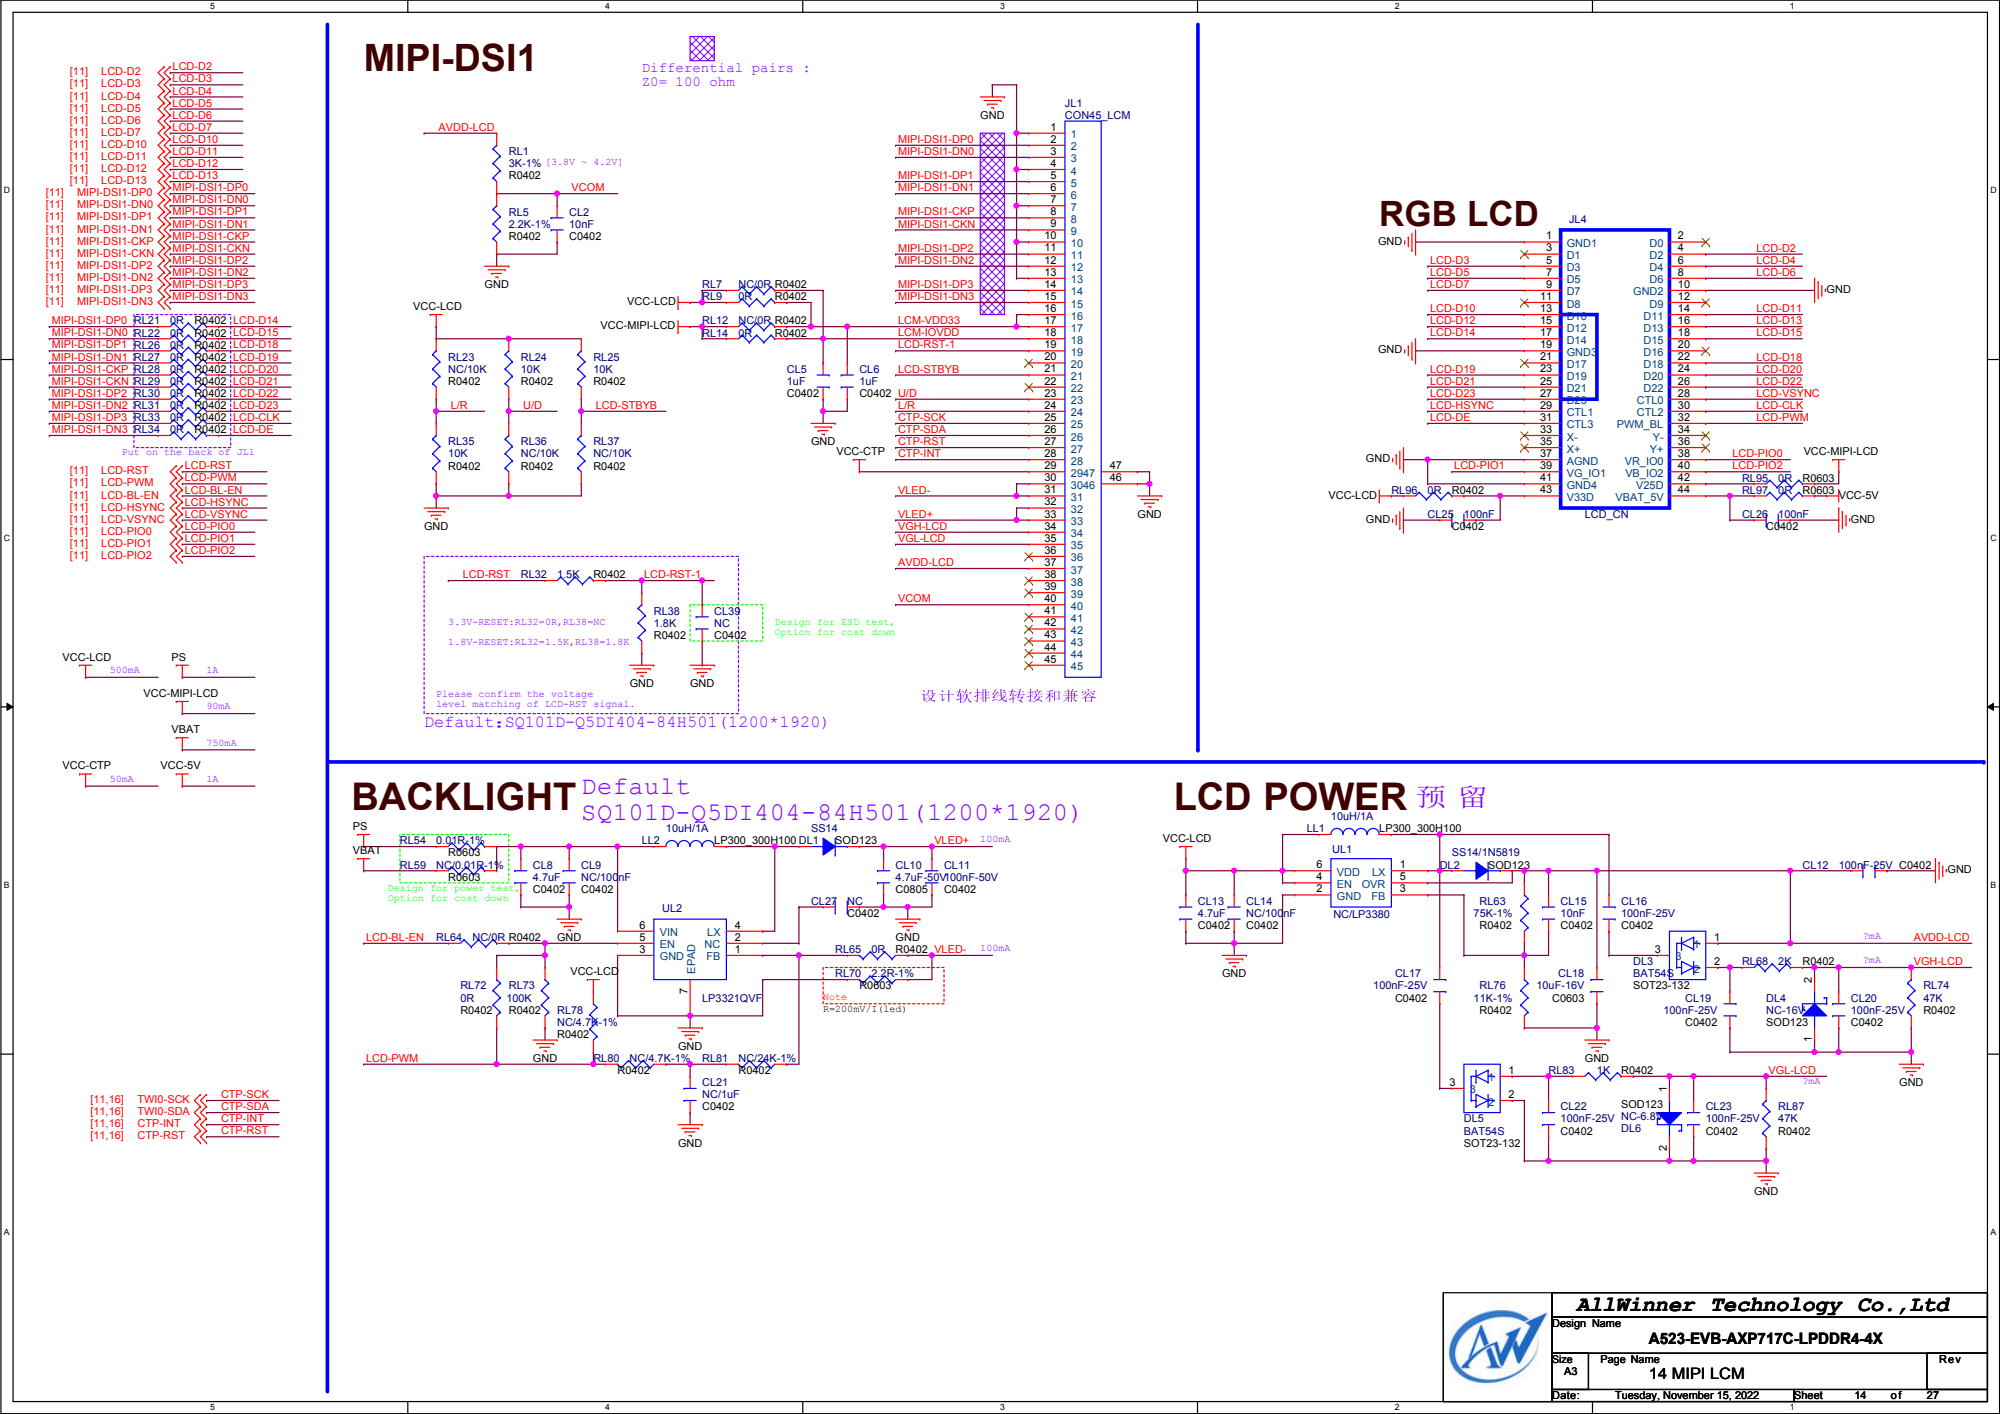
[picture p376: page 14]

Put on the back of JL1

AVDD-LCD VGL-LCD VGH-LCD VLED+

Design for ESD test,
Option for cost down

Please confirm the voltage
level matching of LCD-RST signal.
Default：SQ101D-Q5DI404-84H501(1200*1920)

Design for power test,

# EDP LCM

## Differential pairs :

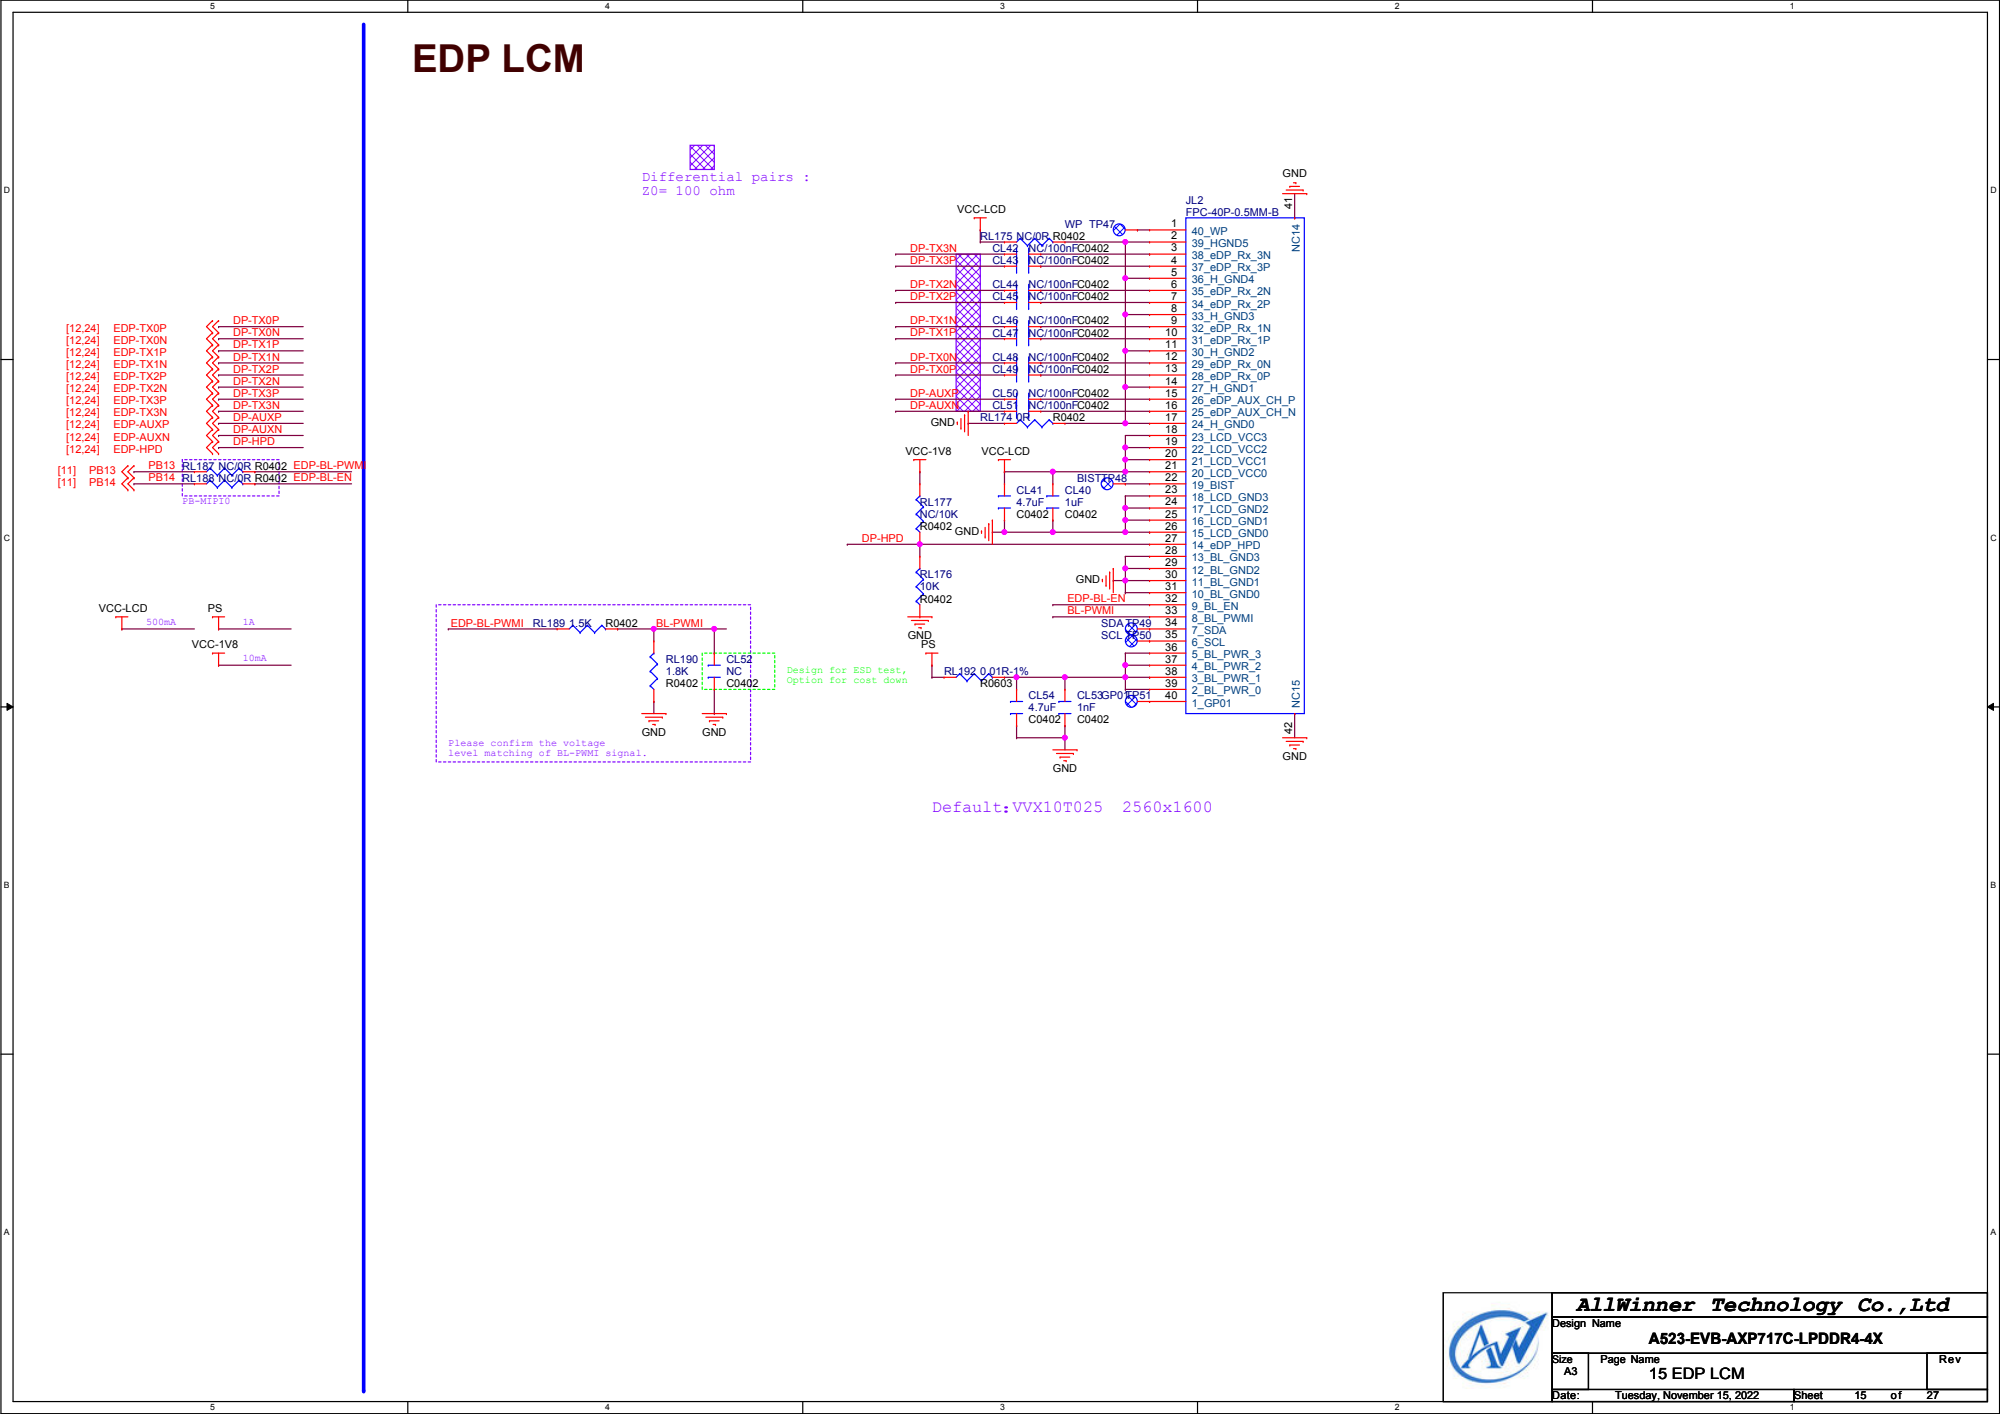
[picture p377: page 15]
PB-MIPI0; Default：VVX10T025 2560x1600; Z0= 100 ohm; DP-AUXP; DP-HPD; DP-AUXN; DP-AUXP DP-AUXN; EDP-BL-PWMI; BL-PWMI; VCC-LCD; VCC-1V8; GND; EDP-TX0P; EDP-TX0N; EDP-TX1P; EDP-TX1N; EDP-TX2P; EDP-TX2N; EDP-TX3P; EDP-TX3N; EDP-AUXP; EDP-AUXN; EDP-HPD; 15 EDP LCM; Tuesday, November 15, 2022; BISTTP48; NC/100nFC0402; SDATP49; JL2 FPC-40P-0.5MM-B; 2_BL_PWR_0 39; 3_BL_PWR_1 38; 4_BL_PWR_2 37; 5_BL_PWR_3 36; 6_SCL 35; 7_SDA 34; 8_BL_PWMI 33; 10_BL_GND0 31; 11_BL_GND1 30; 12_BL_GND2 29; 13_BL_GND3 28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

EDP-BL-PWMI
EDP-BL-EN

BL-PWMI

Design for ESD test,
Option for cost down

Please confirm the voltage
level matching of BL-PWMI signal.

# CTP

Circuit | GSL3676 | BL3676

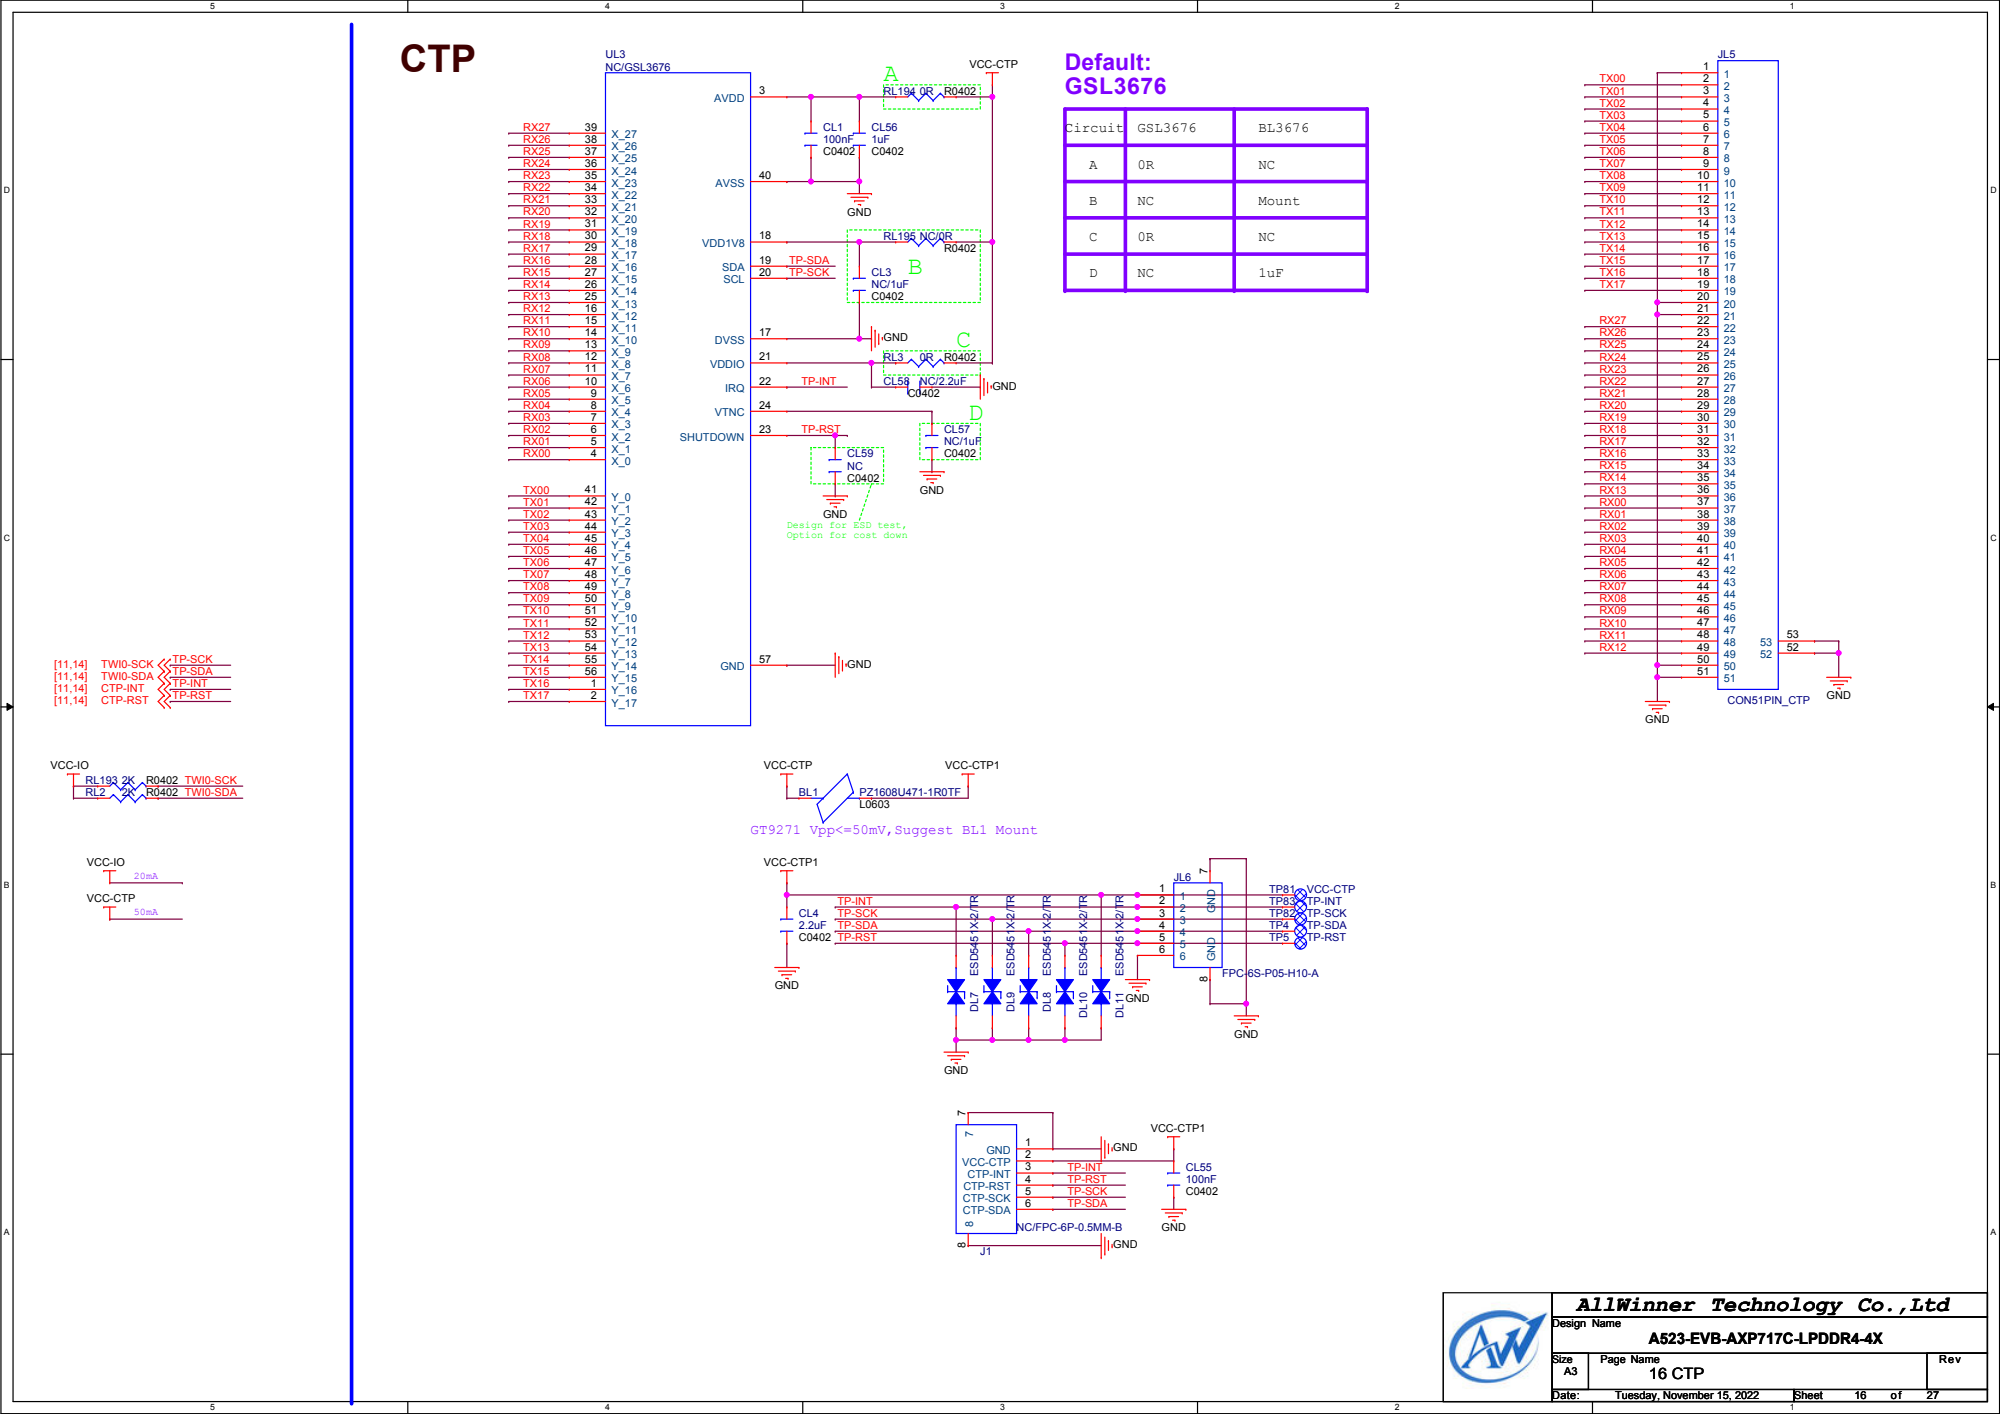
[picture p378: page 16]

B | NC | Mount

Design for ESD test,
Option for cost down

# CAMERA

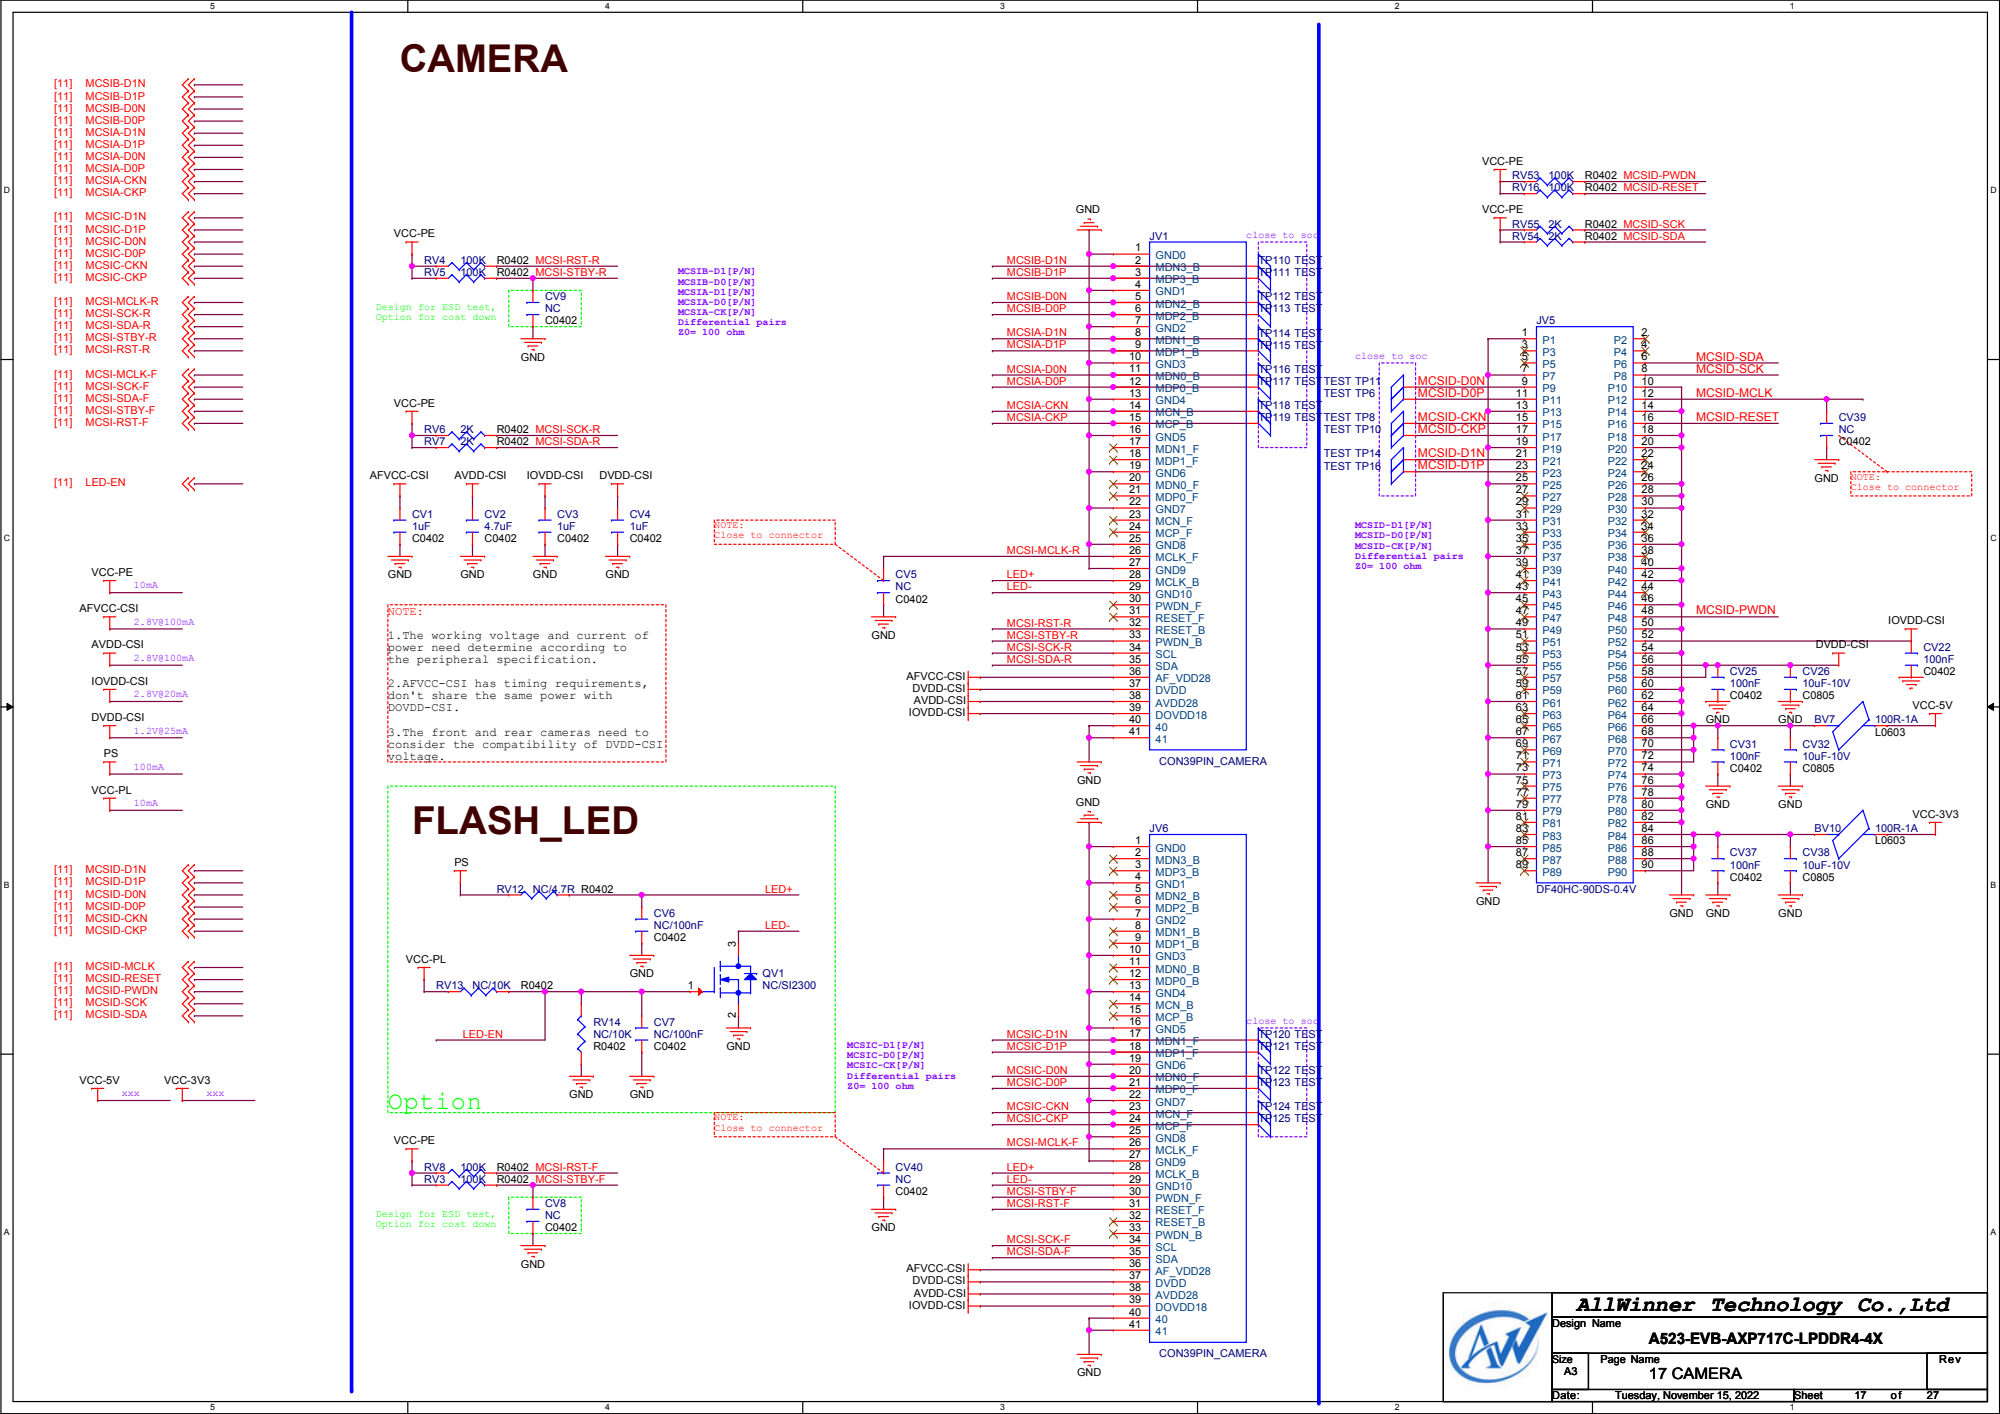
[picture p379: page 17]

MCSI-RST-R MCSI-STBY-R

Design for ESD test,
Option for cost down

MCSI-SCK-R MCSI-SDA-R

1.The working voltage and current of
power need determine according to
the peripheral specification.

2.AFVCC-CSI has timing requirements,
don't share the same power with
DOVDD-CSI.

3.The front and rear cameras need to
consider the compatibility of DVDD-CSI
voltage.
FLASH_LED

MCSI-RST-F MCSI-STBY-F

# HEADPHONE

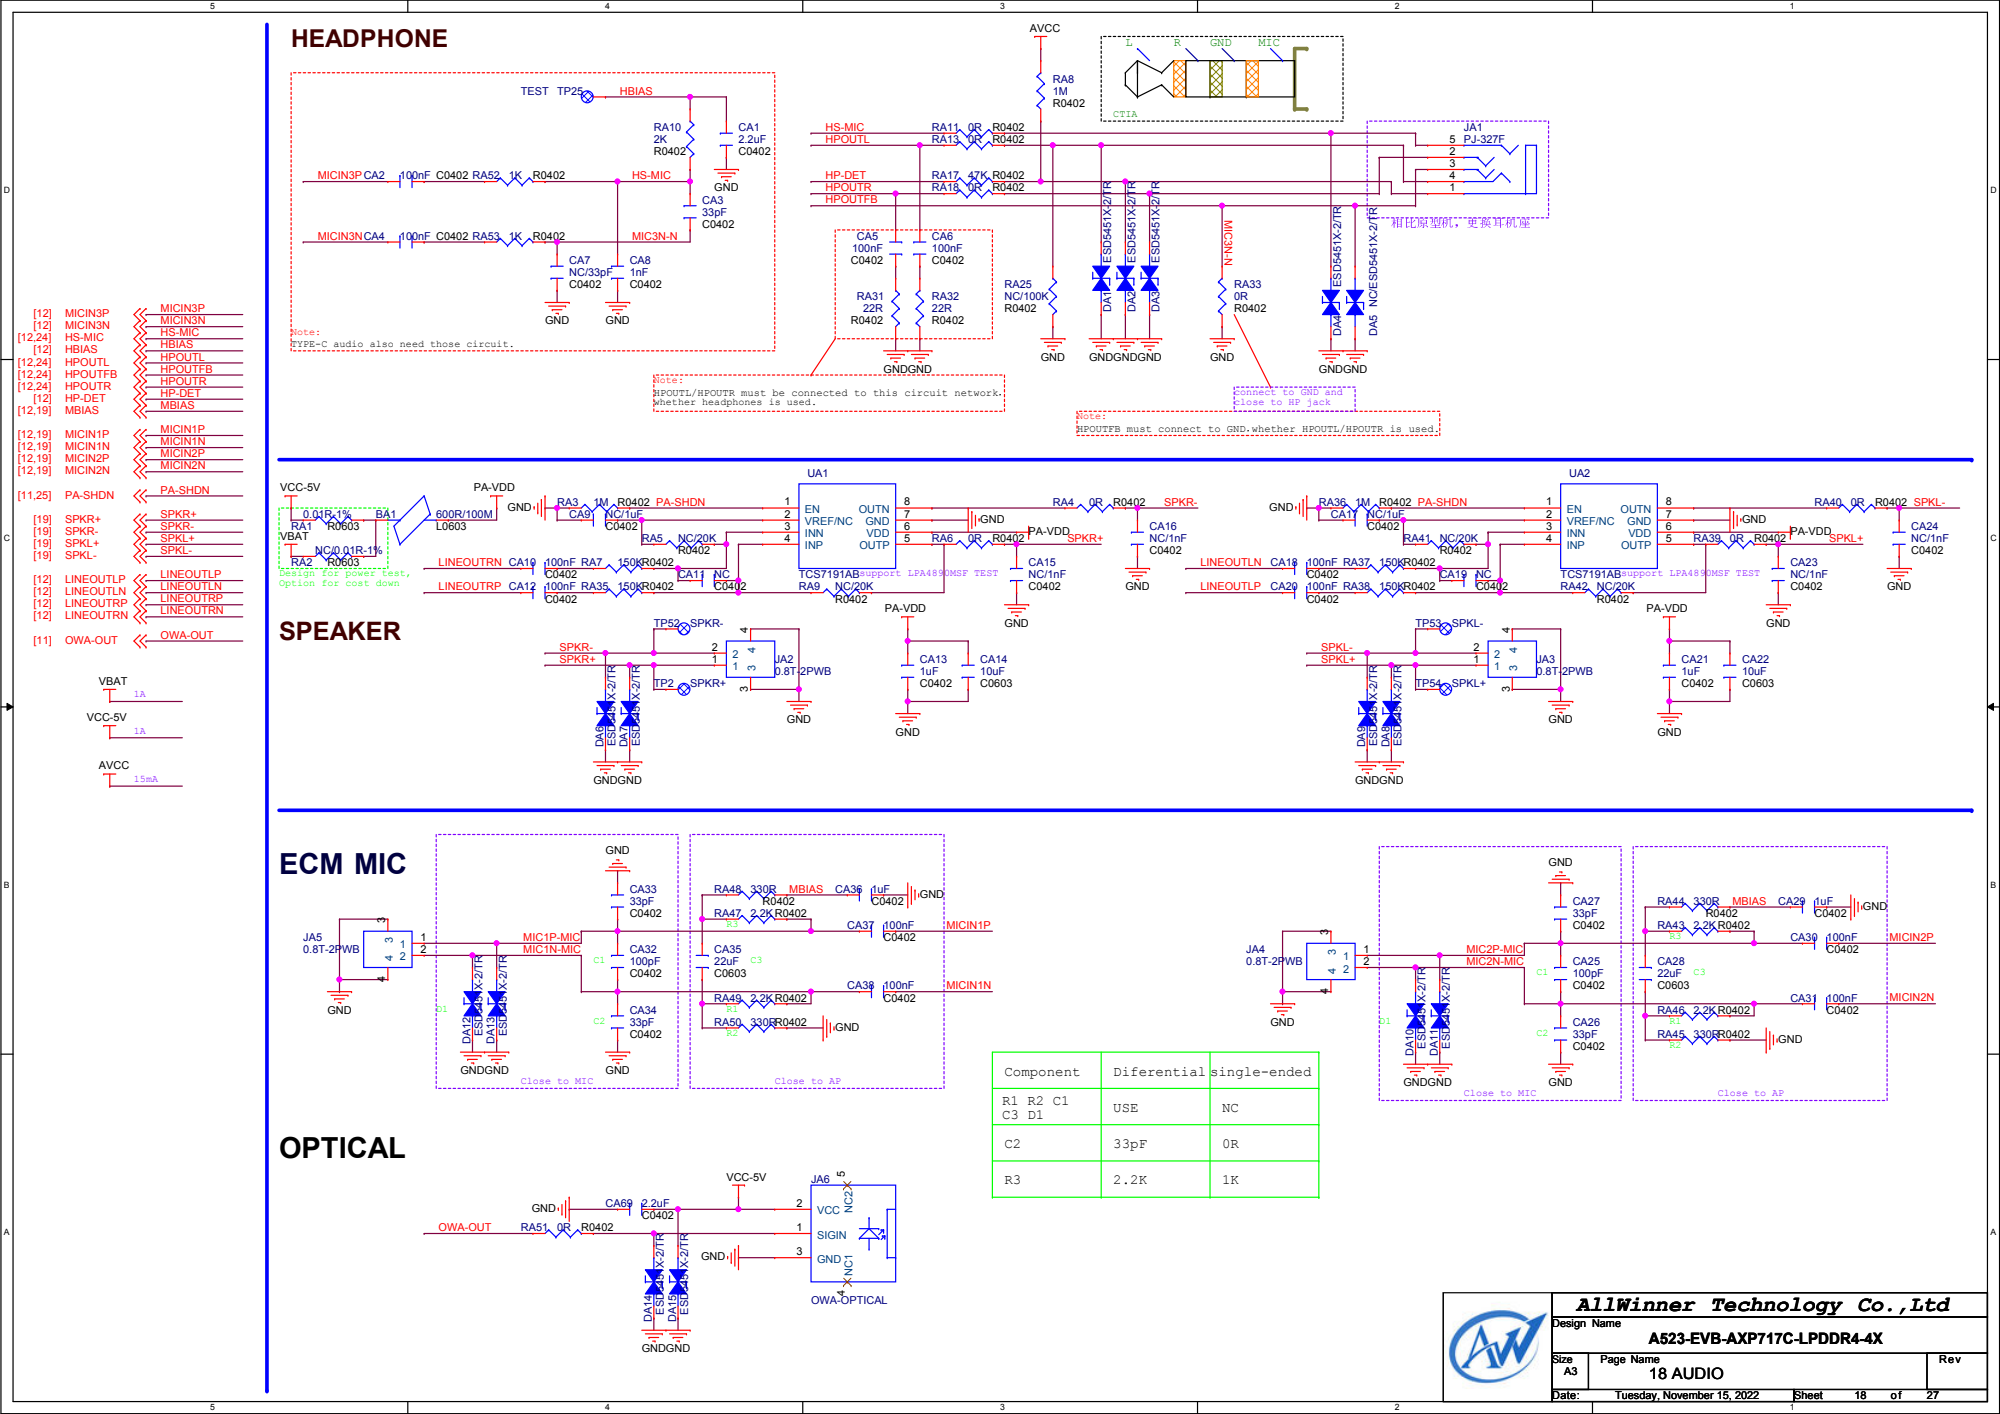
[picture p380: page 18]

Note:
TYPE-C audio also need those circuit.

HPOUTL/HPOUTR must be connected to this circuit network，
whether headphones is used.

connect to GND and
close to HP jack

HPOUTFB must connect to GND，whether HPOUTL/HPOUTR is used.

Design for power test,
Option for cost down

Component | Diferential single-ended

USE | NC R1 R2 C1 C3 D1

# AEC Default:Use AC107

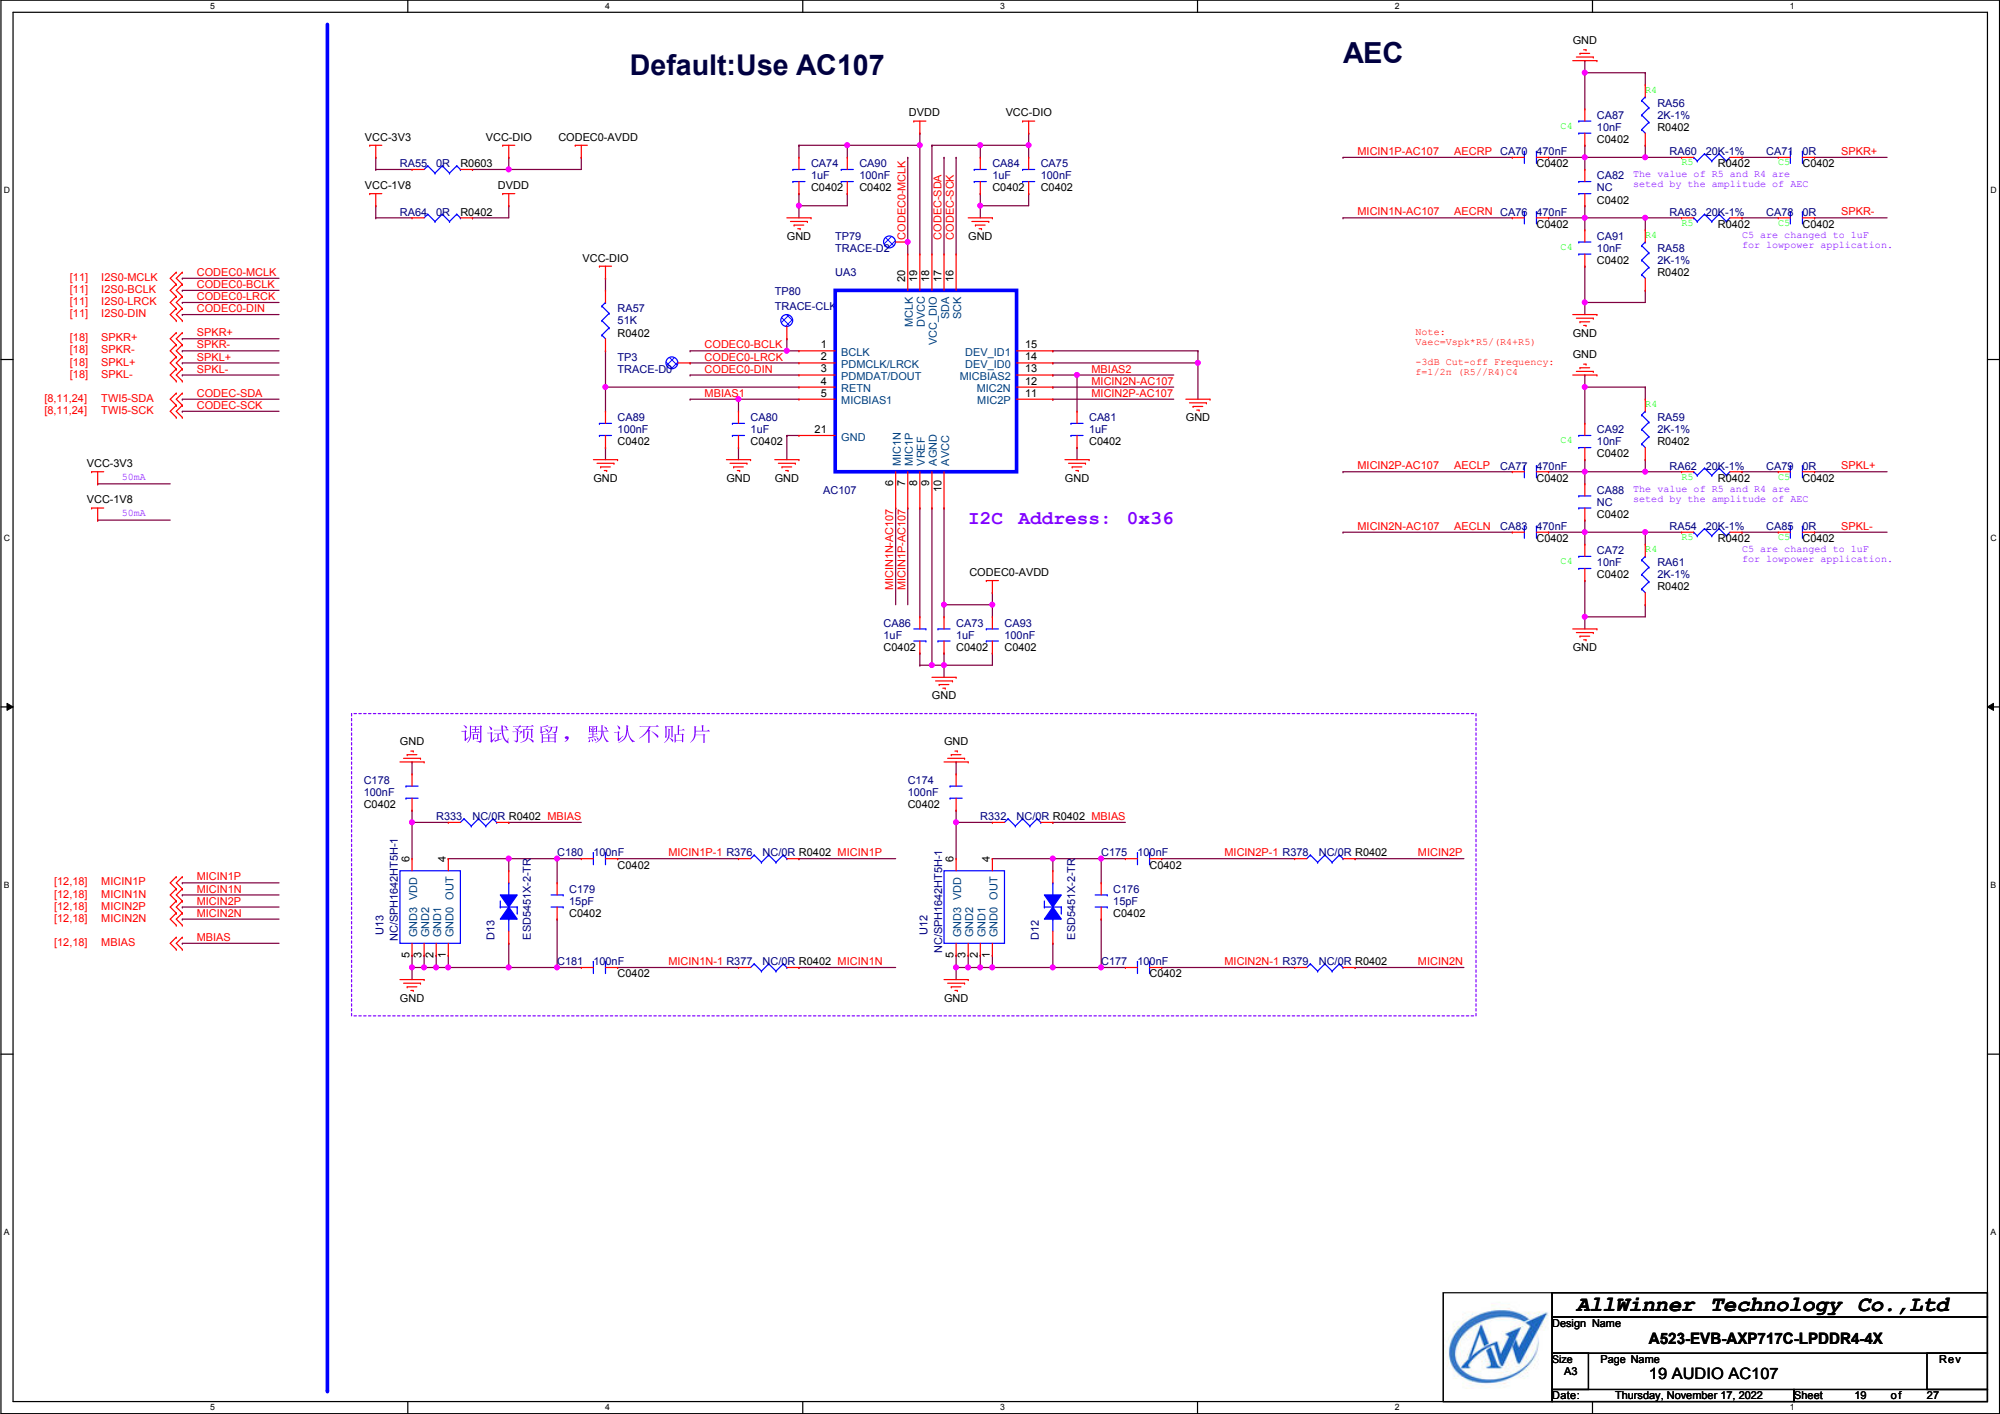
[picture p381: page 19]

The value of R5 and R4 are
seted by the amplitude of AEC

# SD CARD

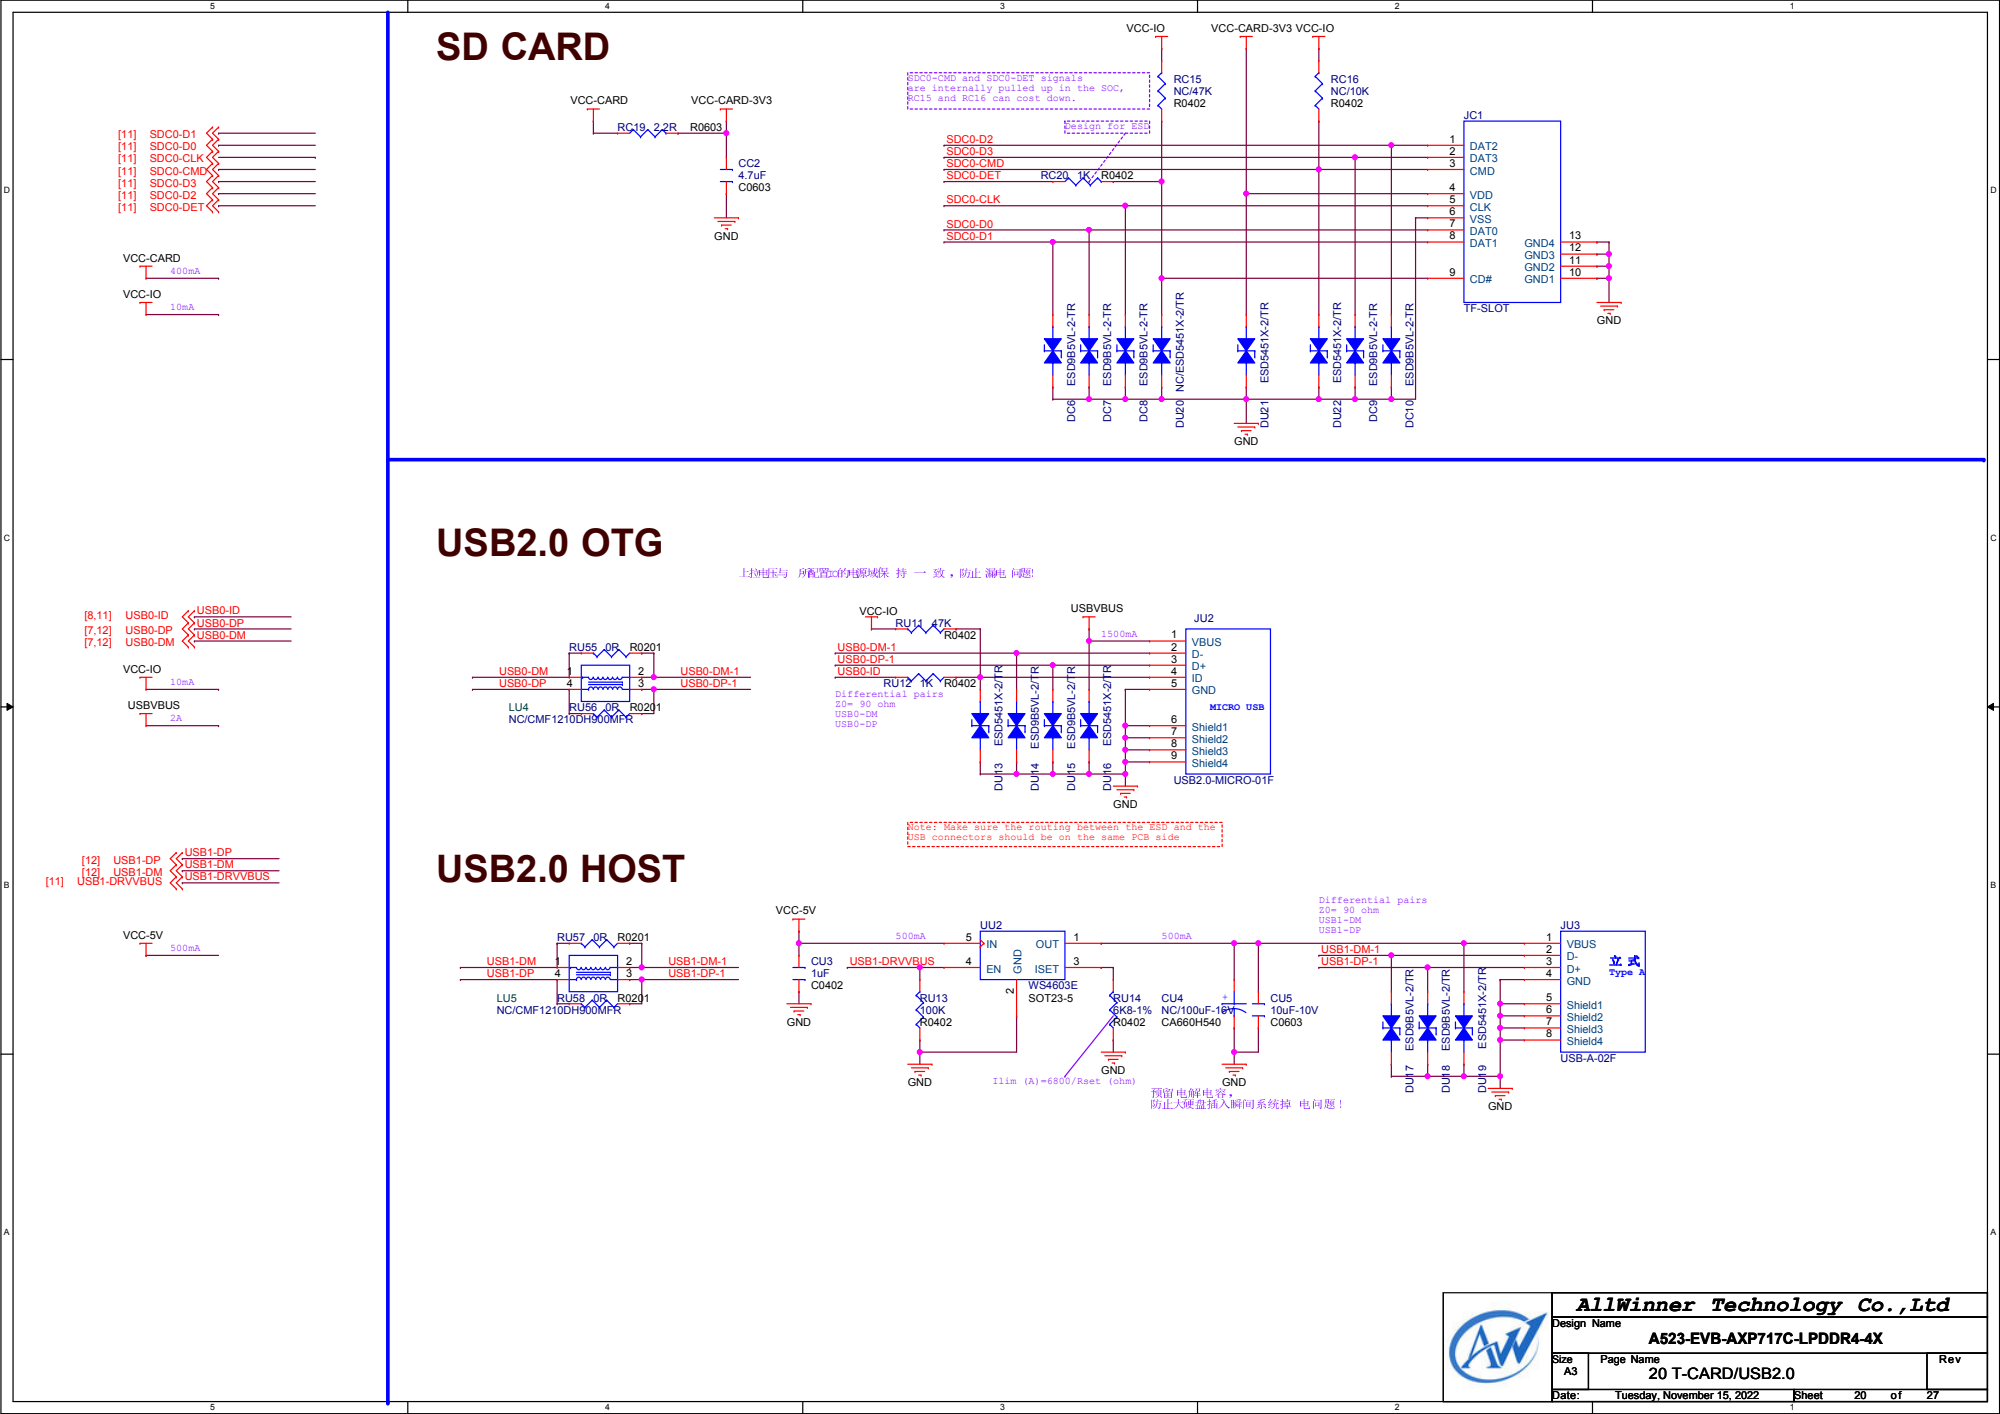
[picture p382: page 20]
预预预预预预， 防防防防防防防防防防防防 预防防！; Differential pairs Z0= 90 ohm USB0-DM USB0-DP; USB2.0 OTG; Differential pairs Z0= 90 ohm USB1-DM USB1-DP; USB2.0 HOST; USB0-DM; USB0-DP; USB0-ID; USB1-DM; USB1-DP; USB0-DM-1 USB0-DP-1 USB0-ID; USB1-DRVVBUS; USB1-DM-1 USB1-DP-1; SDC0-D3; SDC0-CLK; SDC0-CMD; SDC0-D1; SDC0-D0; SDC0-D2; SDC0-DET; USB0-DM USB0-DP; USB0-DM-1 USB0-DP-1; USB1-DM-1; USB1-DP-1; VCC-CARD; VCC-IO; GND; VCC-5V; USBVBUS; VCC-CARD-3V3; [11] SDC0-D1; [11] SDC0-DET; [11] SDC0-CLK [11] SDC0-CMD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

VCC-IO VCC-CARD-3V3 VCC-IO

SDC0-CMD and SDC0-DET signals
are internally pulled up in the SOC,
RC15 and RC16 can cost down.

Design for ESD

CLK 5

上上预上上 上上上IO选预的的的 的 的 的 ，防防 防预 防防！

Note: Make sure the routing between the ESD and the
USB connectors should be on the same PCB side

Ilim (A)=6800/Rset (ohm)

## 50 Ohm Impedance

# XR829 ON BOARD

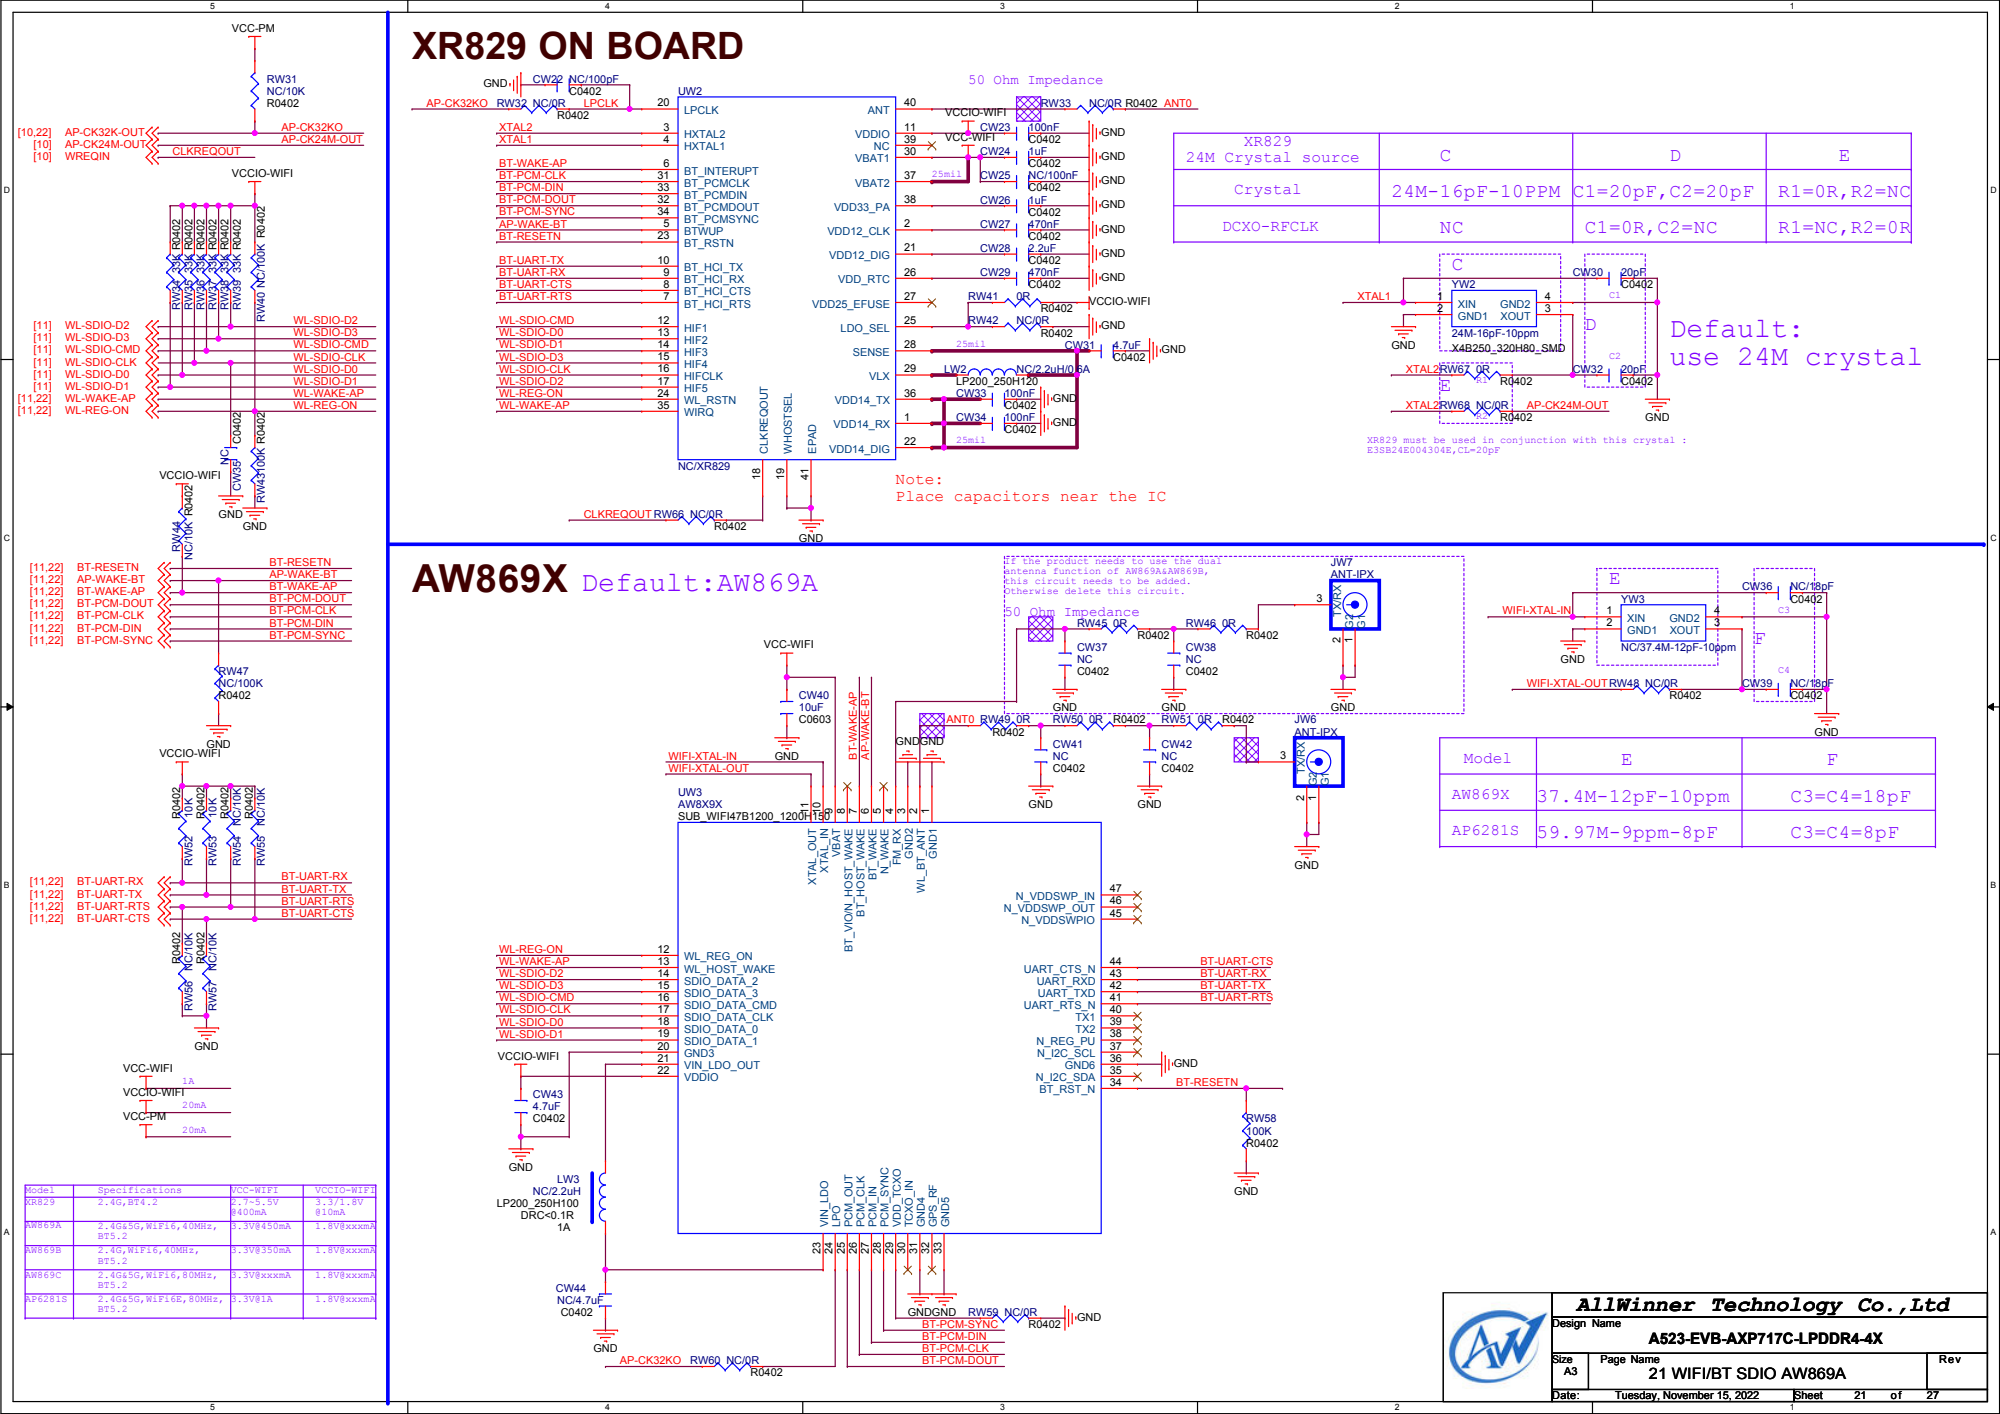
[picture p383: page 21]

XR829 24M Crystal source | C | D | E

Crystal | 24M-16pF-10PPM | C1=20pF,C2=20pF | R1=0R,R2=NC

DCXO-RFCLK | NC | C1=0R,C2=NC | R1=NC,R2=0R

XR829 must be used in conjunction with this crystal :

Note:
Place capacitors near the IC

If the product needs to use the dual
antenna function of AW869A&AW869B,

Model | E | F

AW869X | 37.4M-12pF-10ppm | C3=C4=18pF

AP6281S | 59.97M-9ppm-8pF | C3=C4=8pF

Model | Specifications | VCC-WIFI | VCCIO-WIFI
XR829 | 2.4G,BT4.2 | 2.7~5.5V @400mA | 3.3/1.8V @10mA

AW869A | 2.4G&5G,WiFi6,40MHz, BT5.2 | 3.3V@450mA | 1.8V@xxxmA

AW869B | 2.4G,WiFi6,40MHz, BT5.2 | 3.3V@350mA | 1.8V@xxxmA

## 50 Ohm Impedance 50 Ohm Impedance

# AP6275P

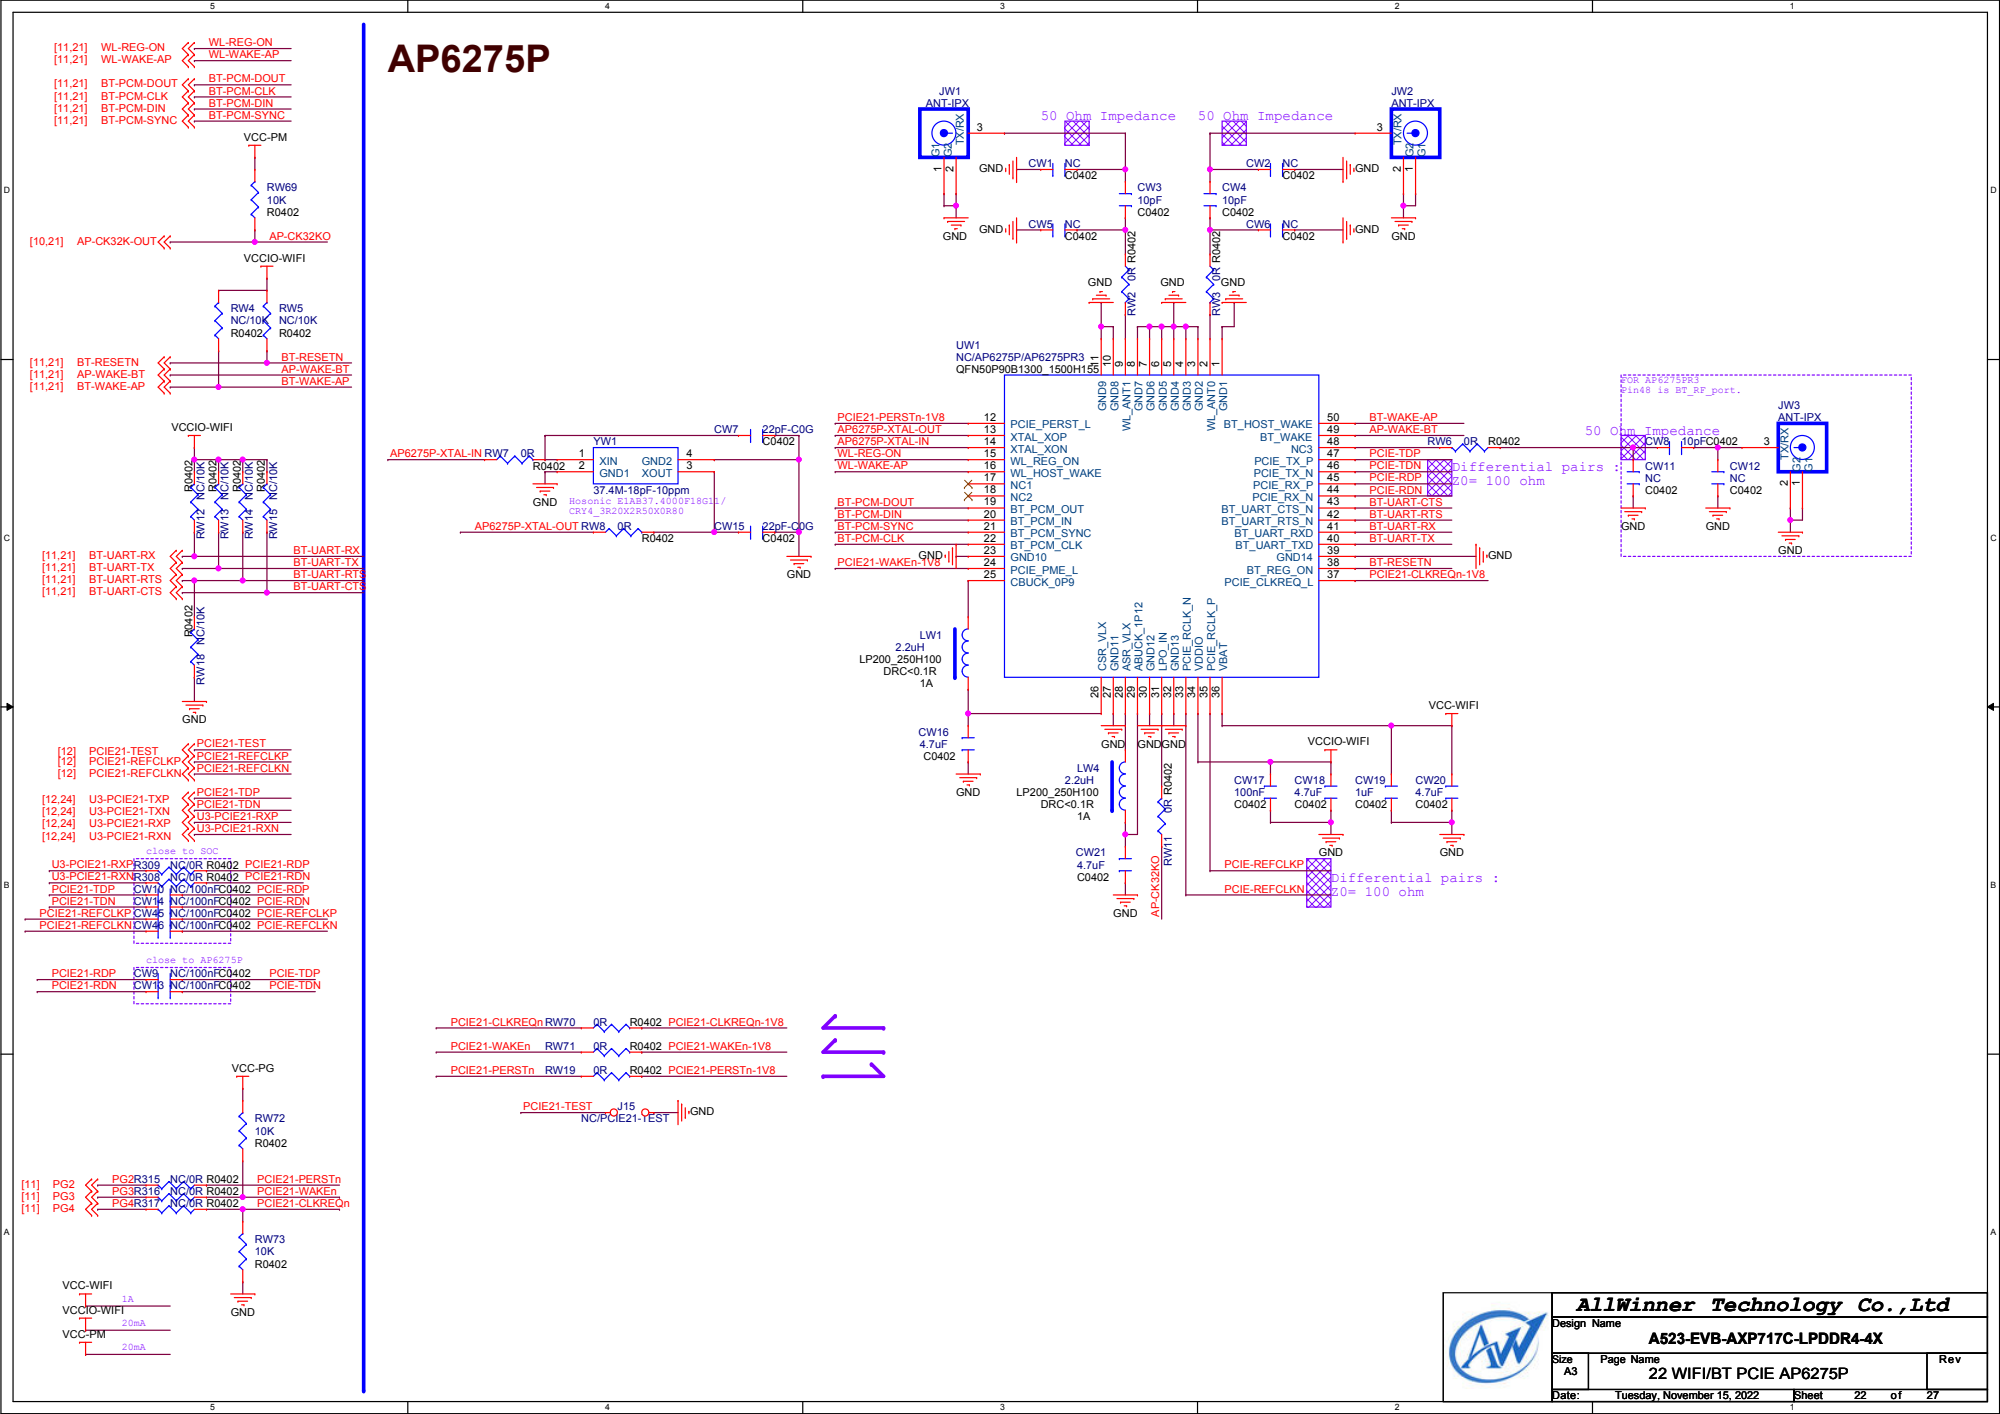
[picture p384: page 22]

AP-CK32KOPCIE-REFCLKP PCIE-REFCLKN

For LDO mode | For SWR mode

# RGMII

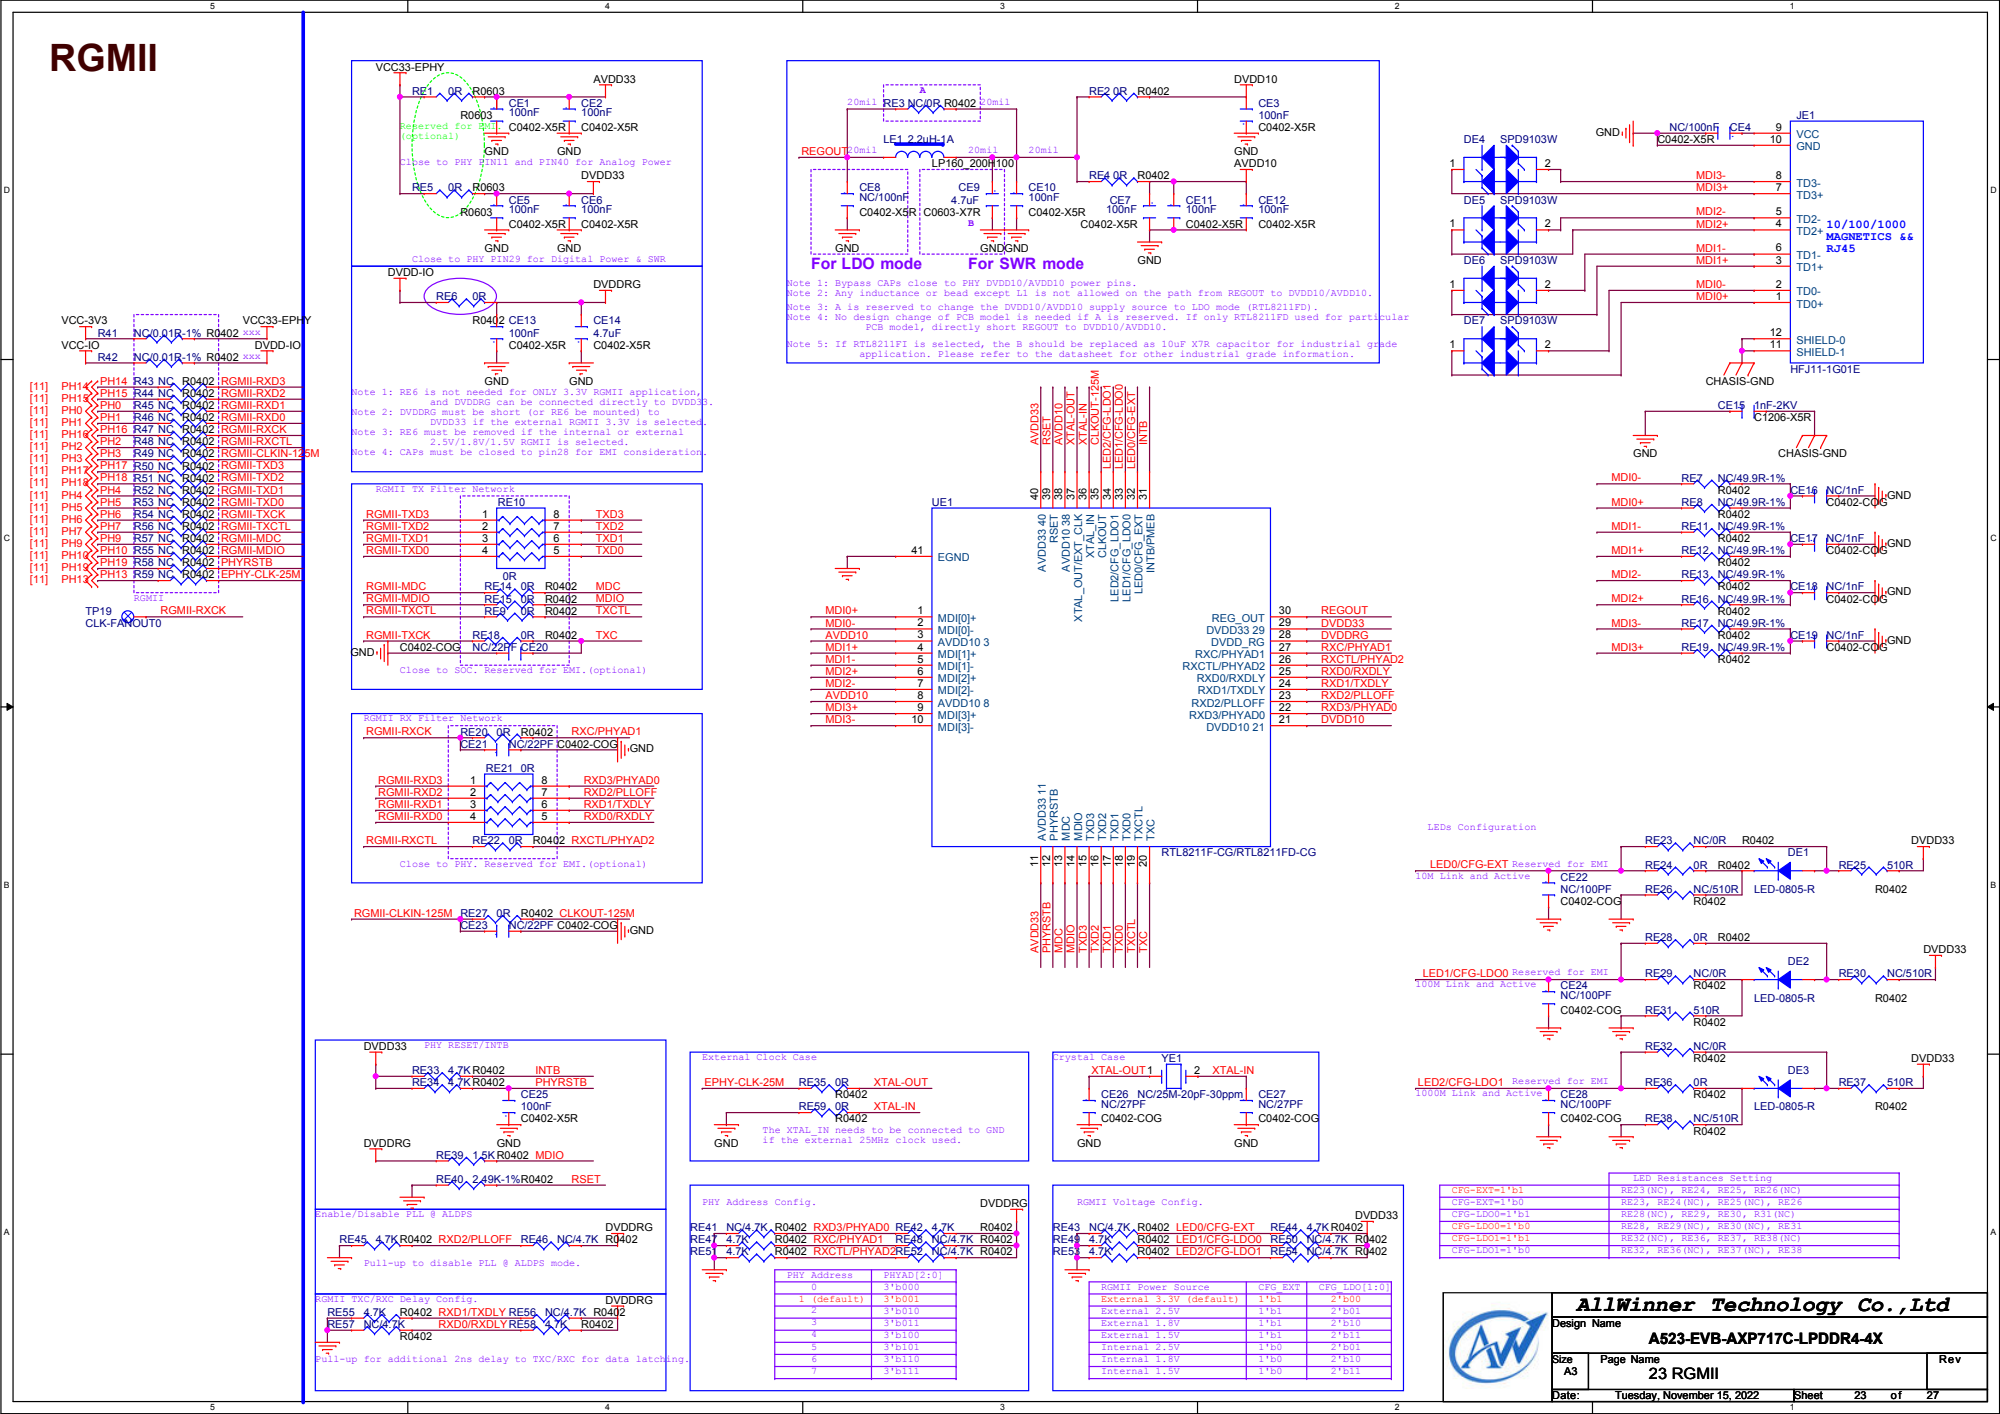
[picture p385: page 23]

Close to PHY PIN11 and PIN40 for Analog Power

Close to PHY PIN29 for Digital Power & SWR
DVDD-IO

Note 1: Bypass CAPs close to PHY DVDD10/AVDD10 power pins.
Note 2: Any inductance or bead except L1 is not allowed on the path from REGOUT to DVDD10/AVDD10.
Note 3: A is reserved to change the DVDD10/AVDD10 supply source to LDO mode (RTL8211FD).
Note 4: No design change of PCB model is needed if A is reserved. If only RTL8211FD used for particular

PCB model, directly short REGOUT to DVDD10/AVDD10.

Note 5: If RTL8211FI is selected, the B should be replaced as 10uF X7R capacitor for industrial grade

application. Please refer to the datasheet for other industrial grade information.

Note 1: RE6 is not needed for ONLY 3.3V RGMII application,

Note 2: DVDDRG must be short (or RE6 be mounted) to

and DVDDRG can be connected directly to DVDD33.

DVDD33 if the external RGMII 3.3V is selected.

Note 3: RE6 must be removed if the internal or external

Note 4: CAPs must be closed to pin28 for EMI consideration.

RGMII TX Filter Network

Close to SOC. Reserved for EMI.(optional)

RGMII RX Filter Network
RGMII-RXCK

Close to PHY. Reserved for EMI.(optional)

The XTAL_IN needs to be connected to GND
if the external 25MHz clock used.

CFG-EXT=1'b1 | RE23(NC), RE24, RE25, RE26(NC)
CFG-EXT=1'b0 | RE23, RE24(NC), RE25(NC), RE26
CFG-LDO0=1'b1 | RE28(NC), RE29, RE30, R31(NC)
CFG-LDO0=1'b0 | RE28, RE29(NC), RE30(NC), RE31
CFG-LDO1=1'b1 | RE32(NC), RE36, RE37, RE38(NC)
CFG-LDO1=1'b0 | RE32, RE36(NC), RE37(NC), RE38

Enable/Disable PLL @ ALDPS

Pull-up to disable PLL @ ALDPS mode.

RGMII TXC/RXC Delay Config.

Pull-up for additional 2ns delay to TXC/RXC for data latching.

# TYPEC

# EDP1.3&USB3 SWITCH

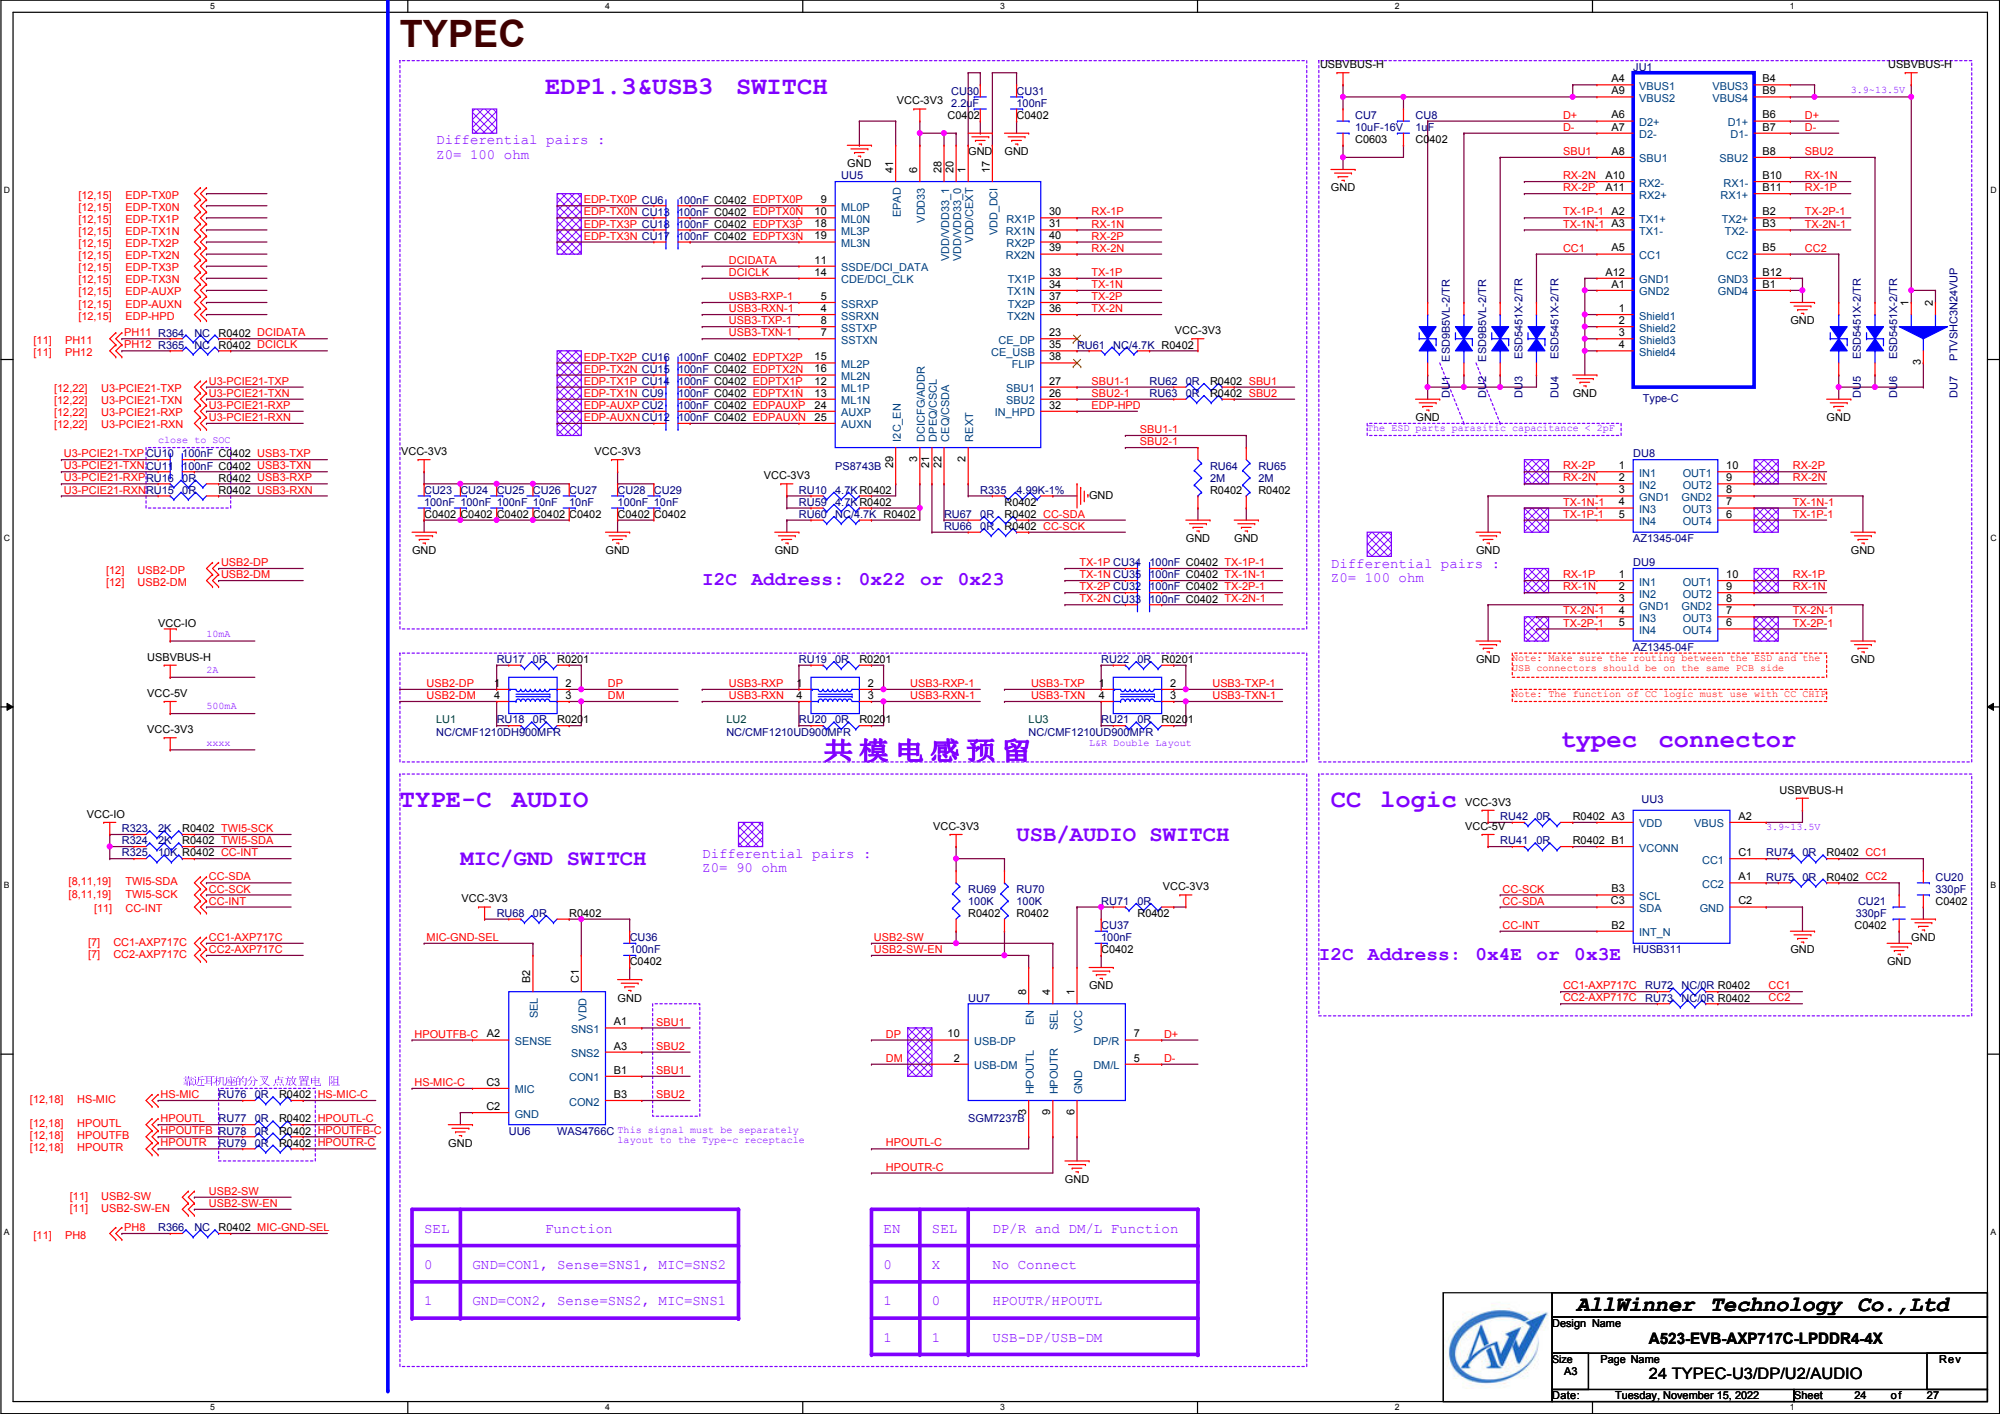
[picture p386: page 24]

The ESD parts parasitic capacitance < 2pF

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

Note: The function of CC logic must use with CC CHIP

This signal must be separately
layout to the Type-c receptacle

DP/R and DM/L Function

# KEY/ADC

# CPUX DEBUG

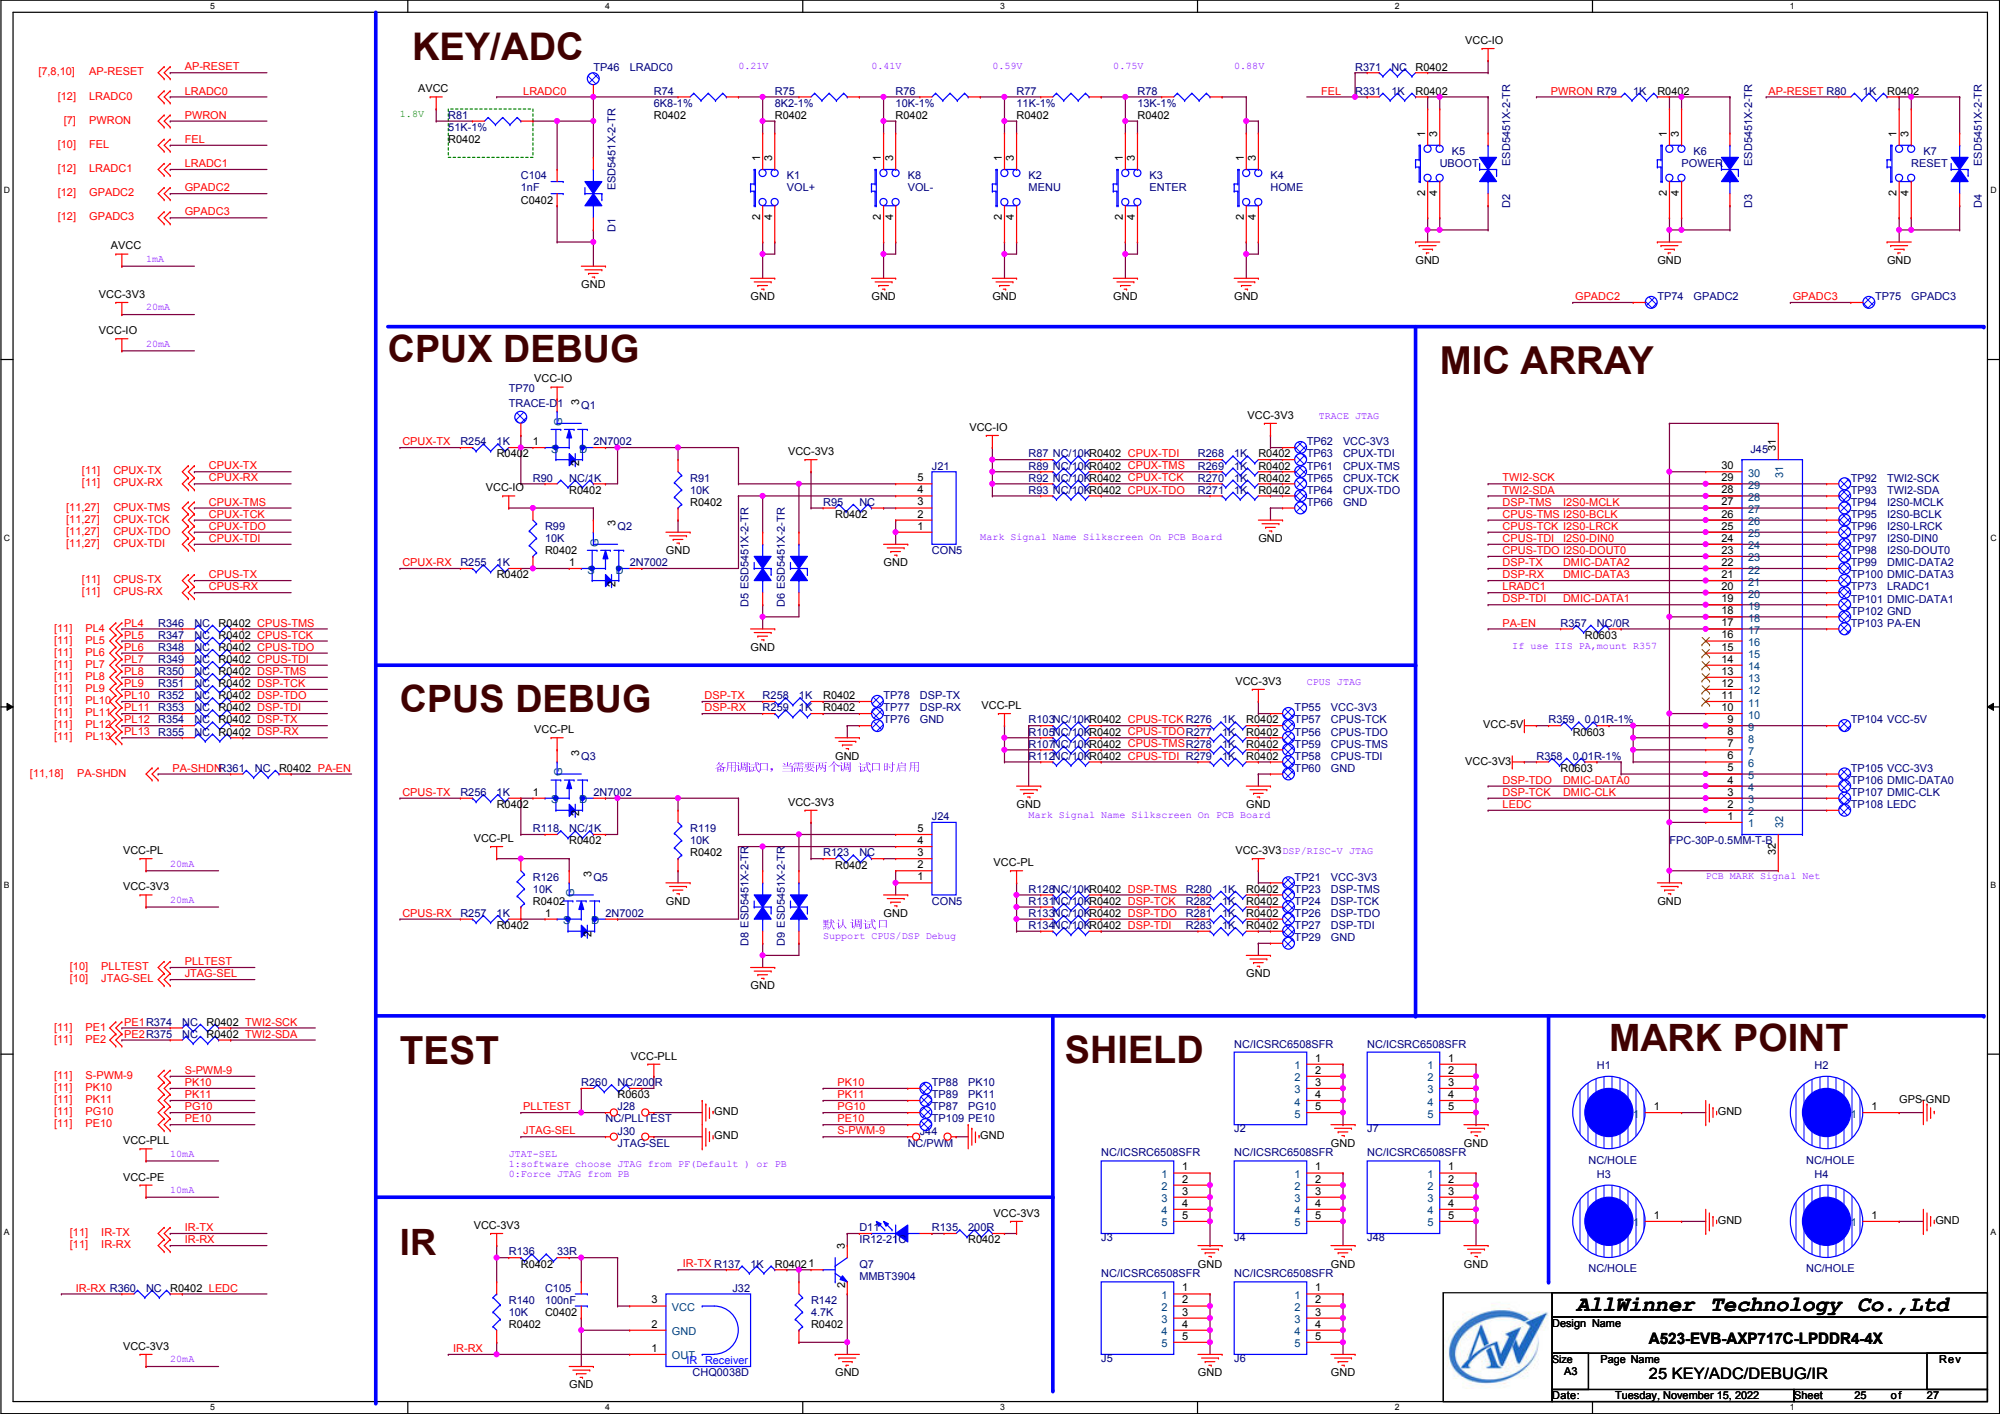
[picture p387: page 25]

Mark Signal Name Silkscreen On PCB Board

If use IIS PA,mount R357

GND

PCB MARK Signal Net

默默备选备
Support CPUS/DSP Debug

JTAT-SEL
1:software choose JTAG from PF(Default ) or PB
0:Force JTAG from PB

25 KEY/ADC/DEBUG/IR

# Gyroscope Hall switch

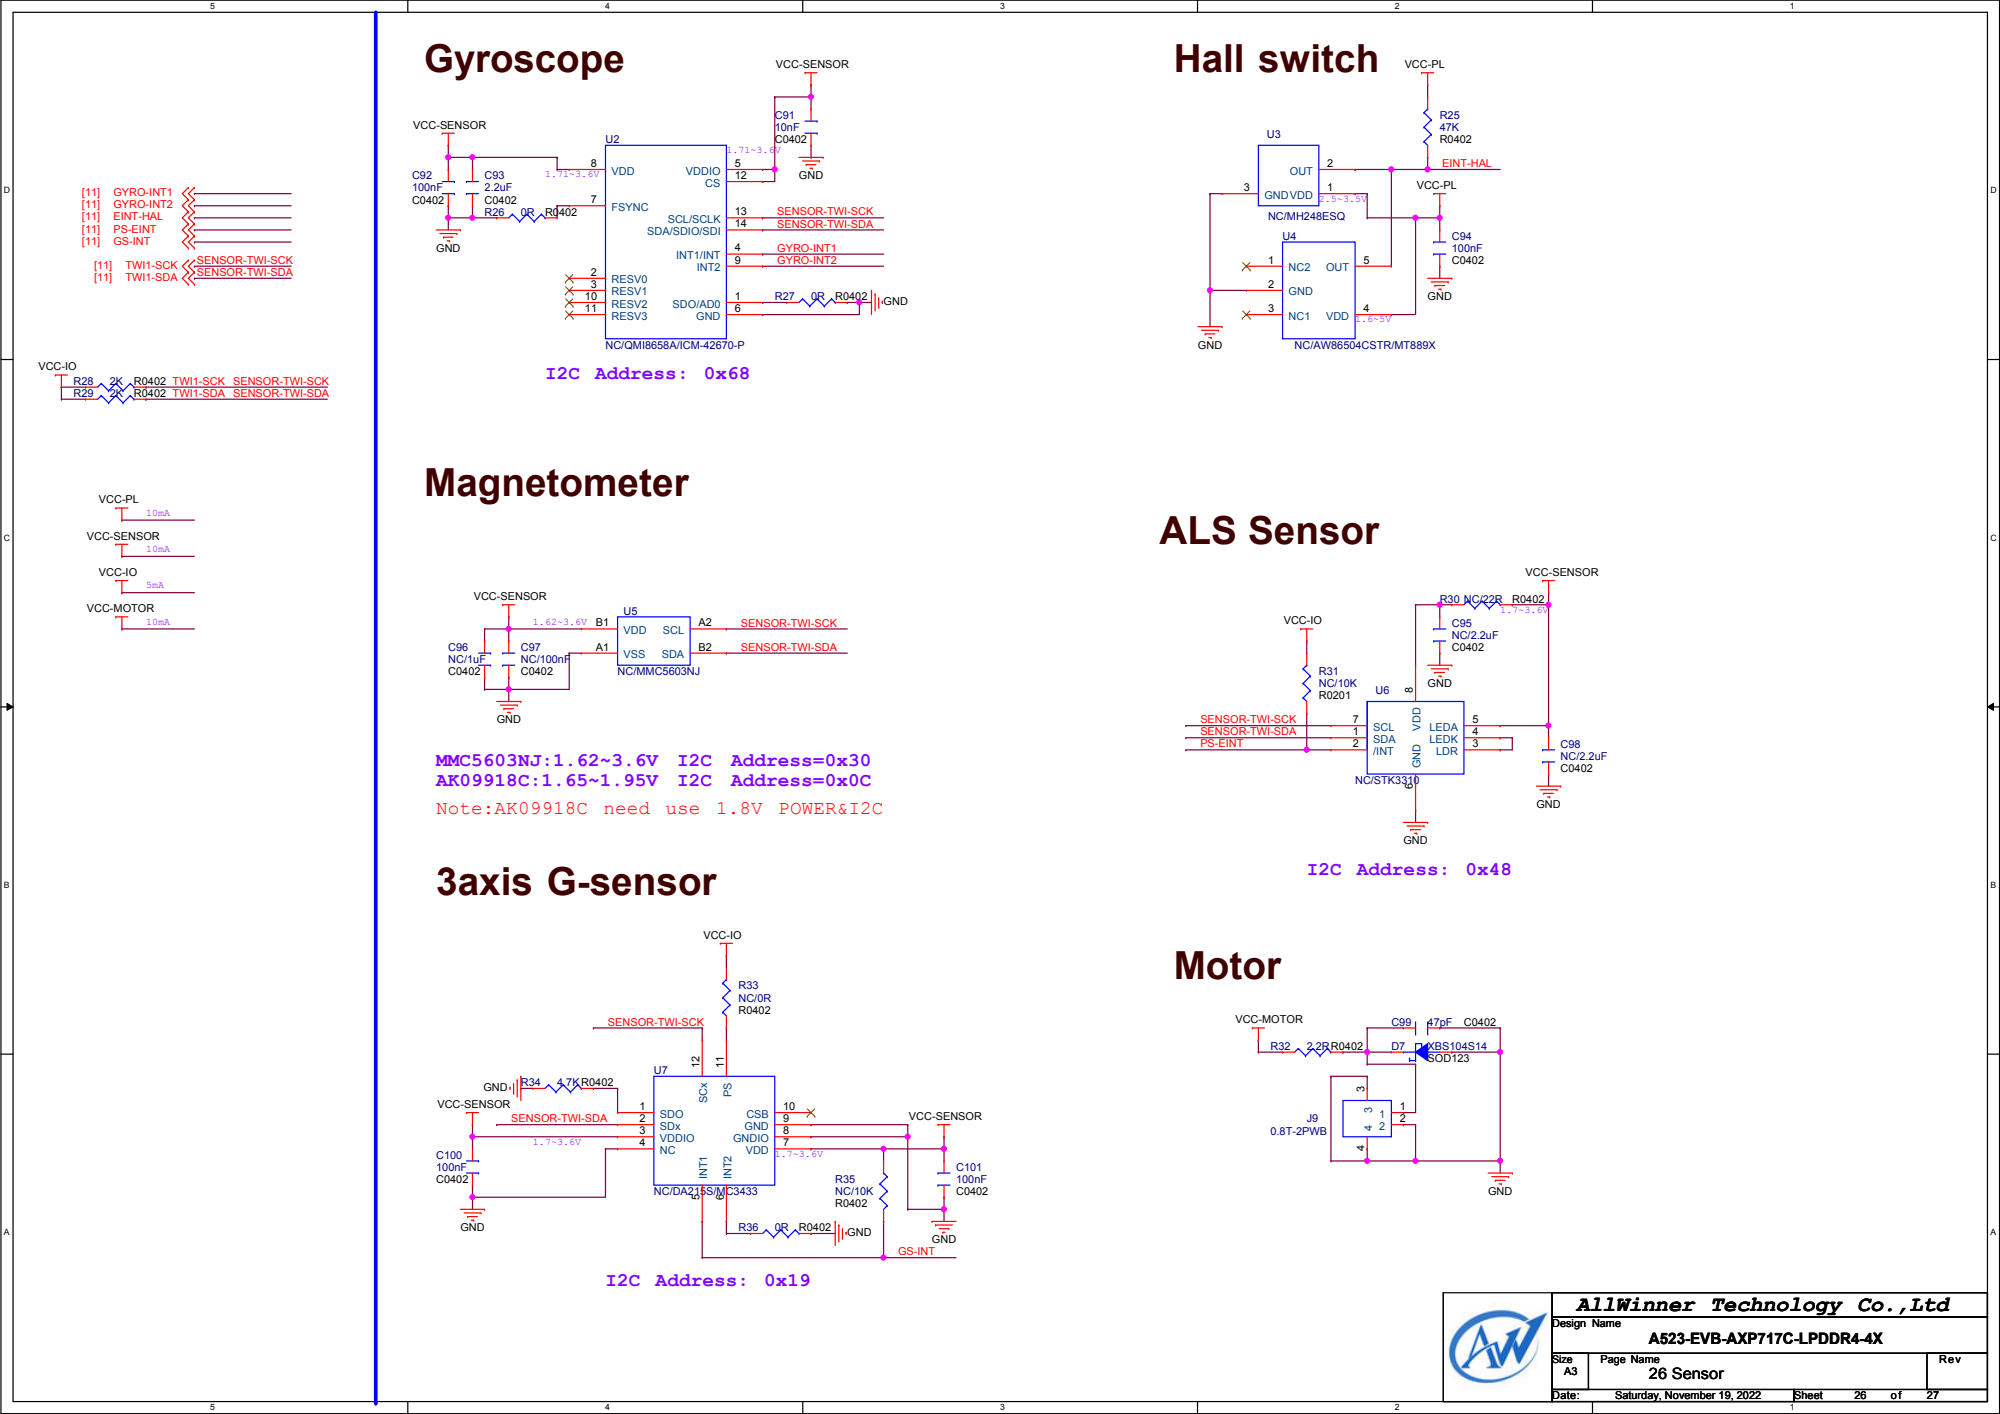
[picture p388: page 26]

TWI1-SCK SENSOR-TWI-SCK
TWI1-SDA SENSOR-TWI-SDA

# GPS

## Differential pairs :

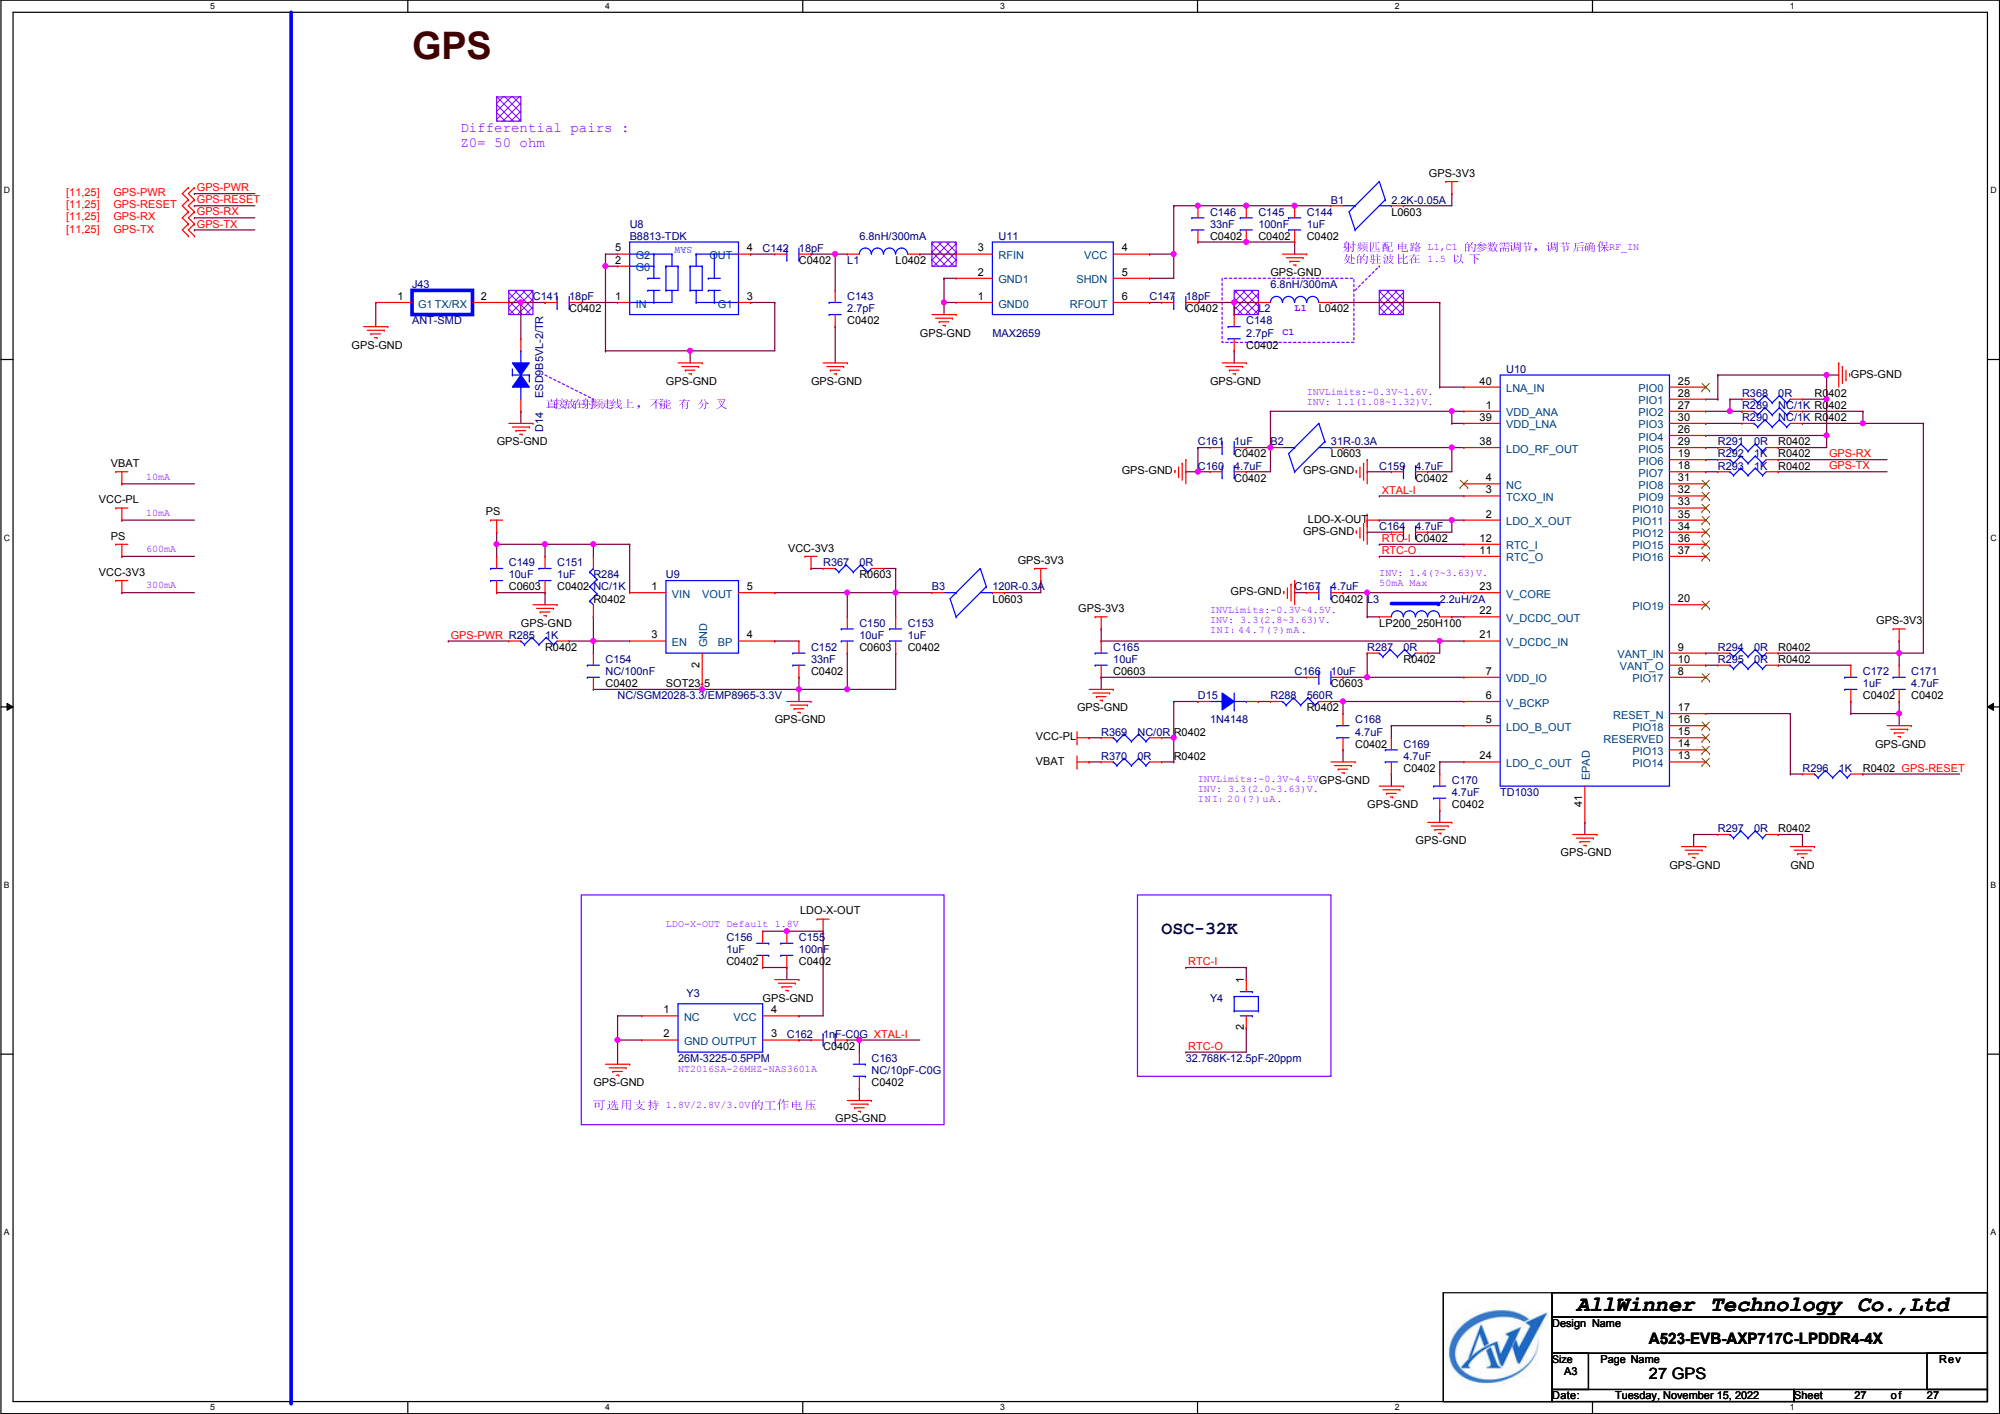
[picture p389: page 27]
