o7-machinehum/Blackpants/docs/a523/A523_hwref/原理图/开发板资料/开发板用户指南/A523-EVB-AXP717C-LPDDR4-4X-32X1-V1-0.pdf

## ART FILM - Silk_Top

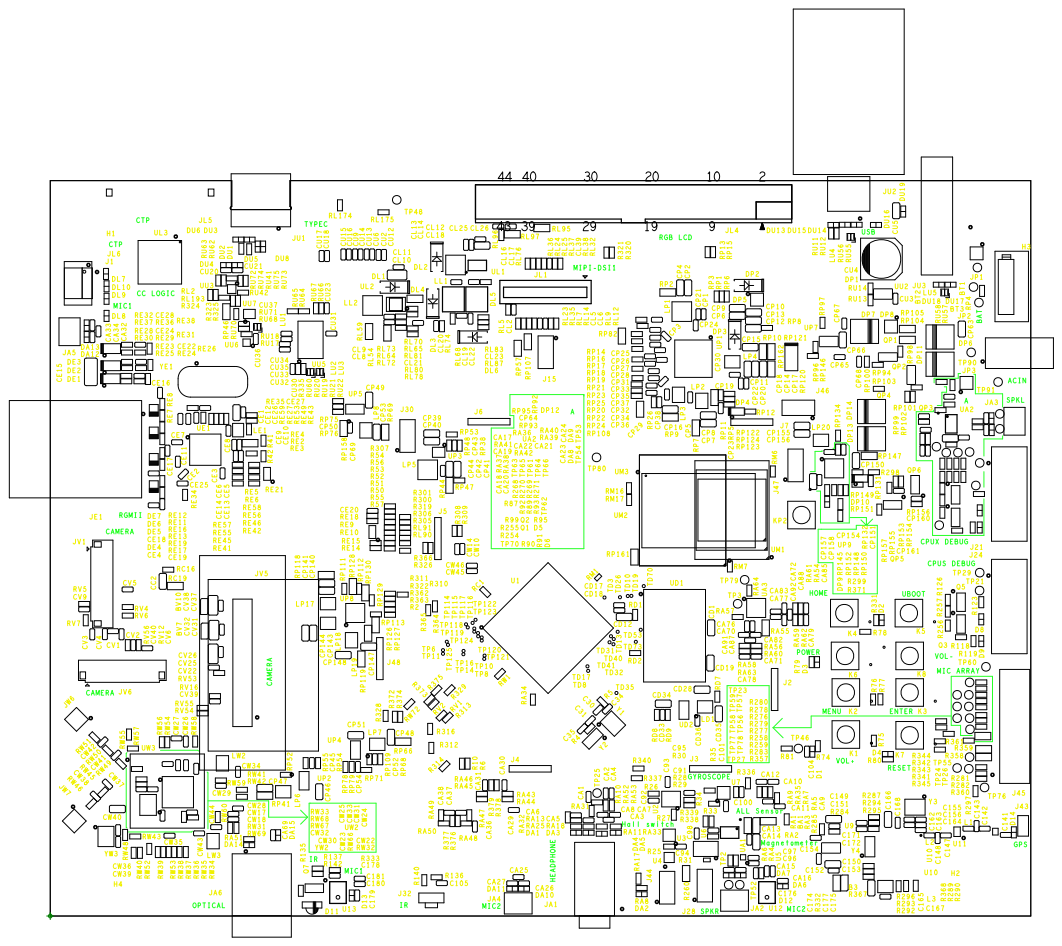
[picture p390: page 1]

ALLWinner Technology Co.,Ltd
PCB NAME:
A523-EVB-AXP717C-LPDDR4-4X-32X1-V1-0
20221116 DATE: weiwaisheji

## ART FILM - Silk_Bottom

# TP51RP81 CU10 CU11

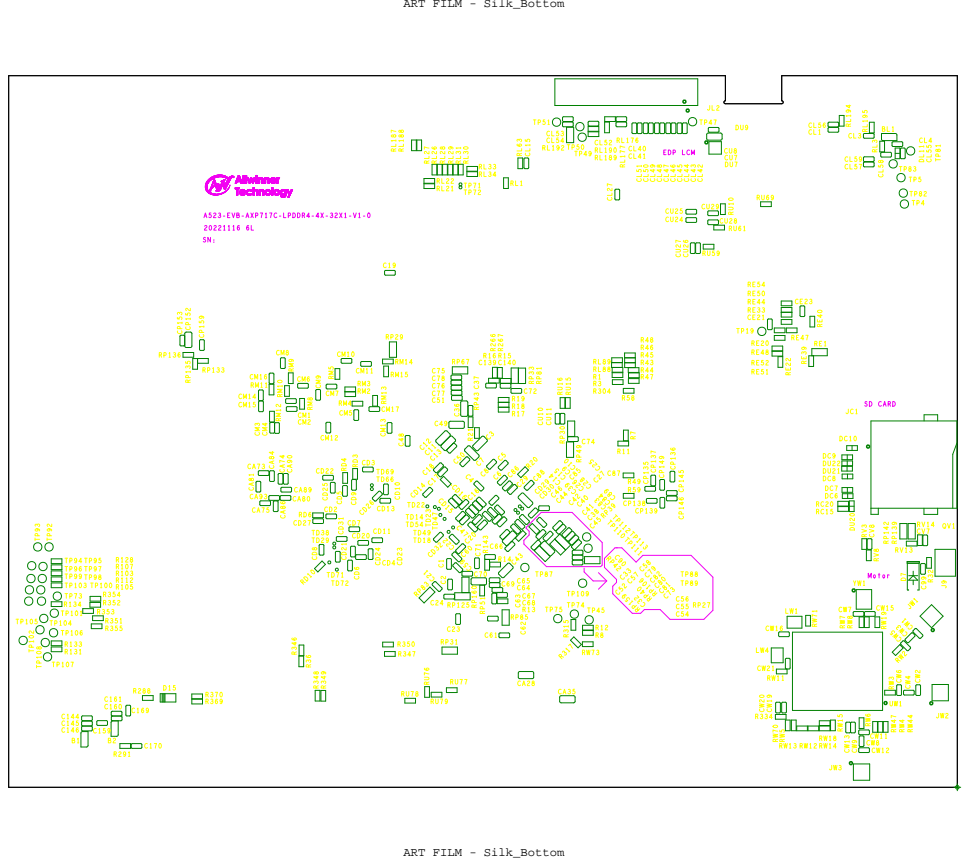
[picture p391: page 2]
