o7-machinehum/Blackpants/docs/a523/A523_Brief_V1.2.pdf

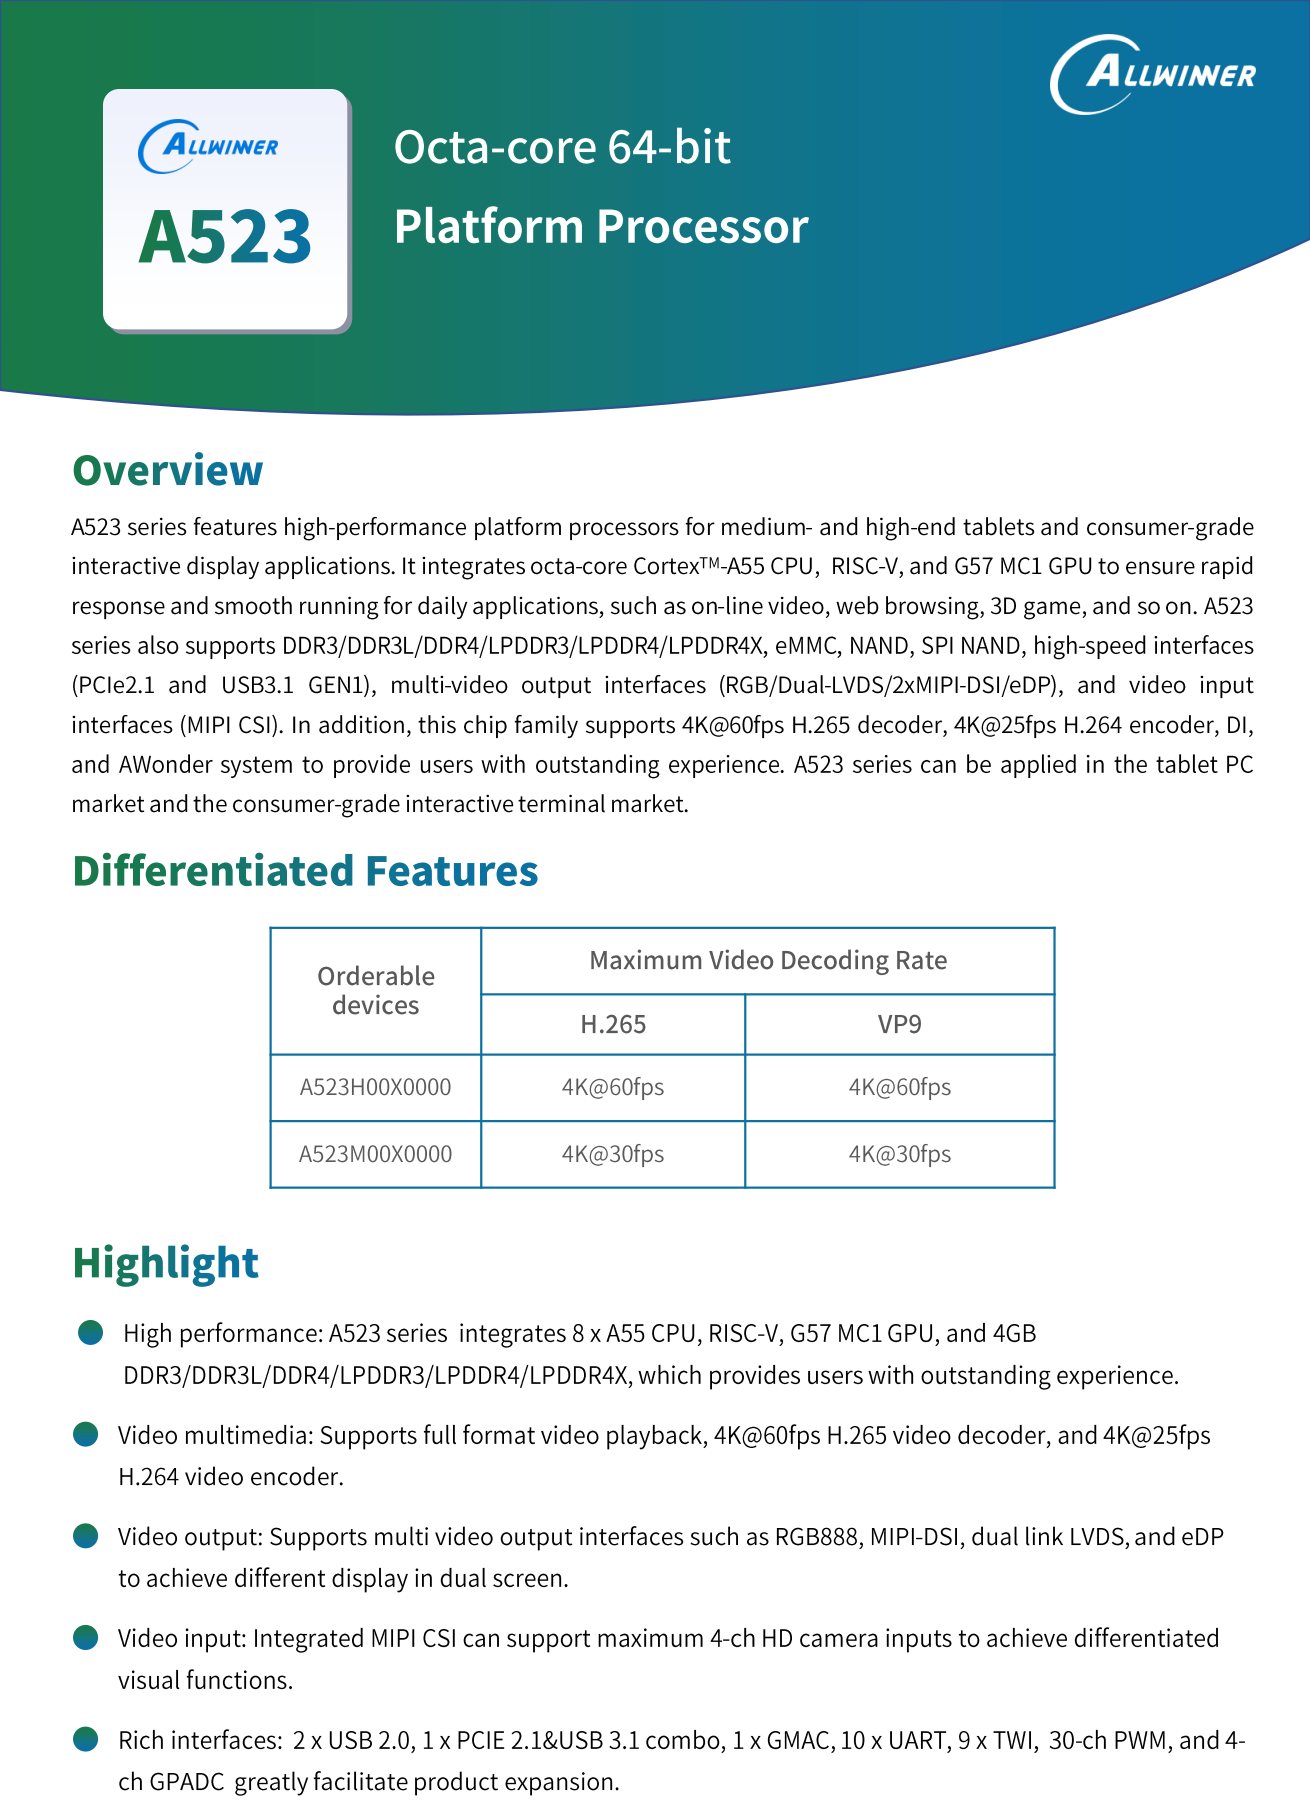
[picture p392: page 1]

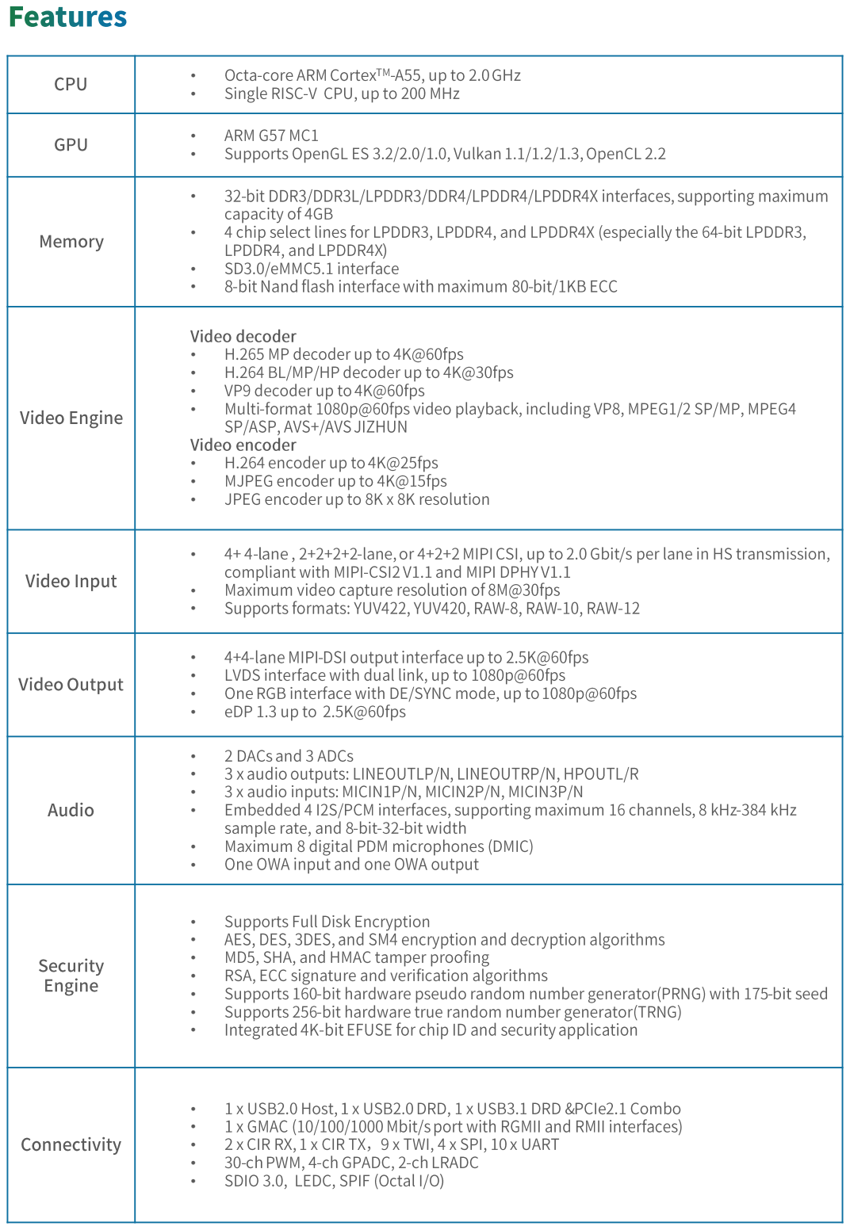
[picture p393: page 2]

••••••••••••••••••••••••••••••••••••••••

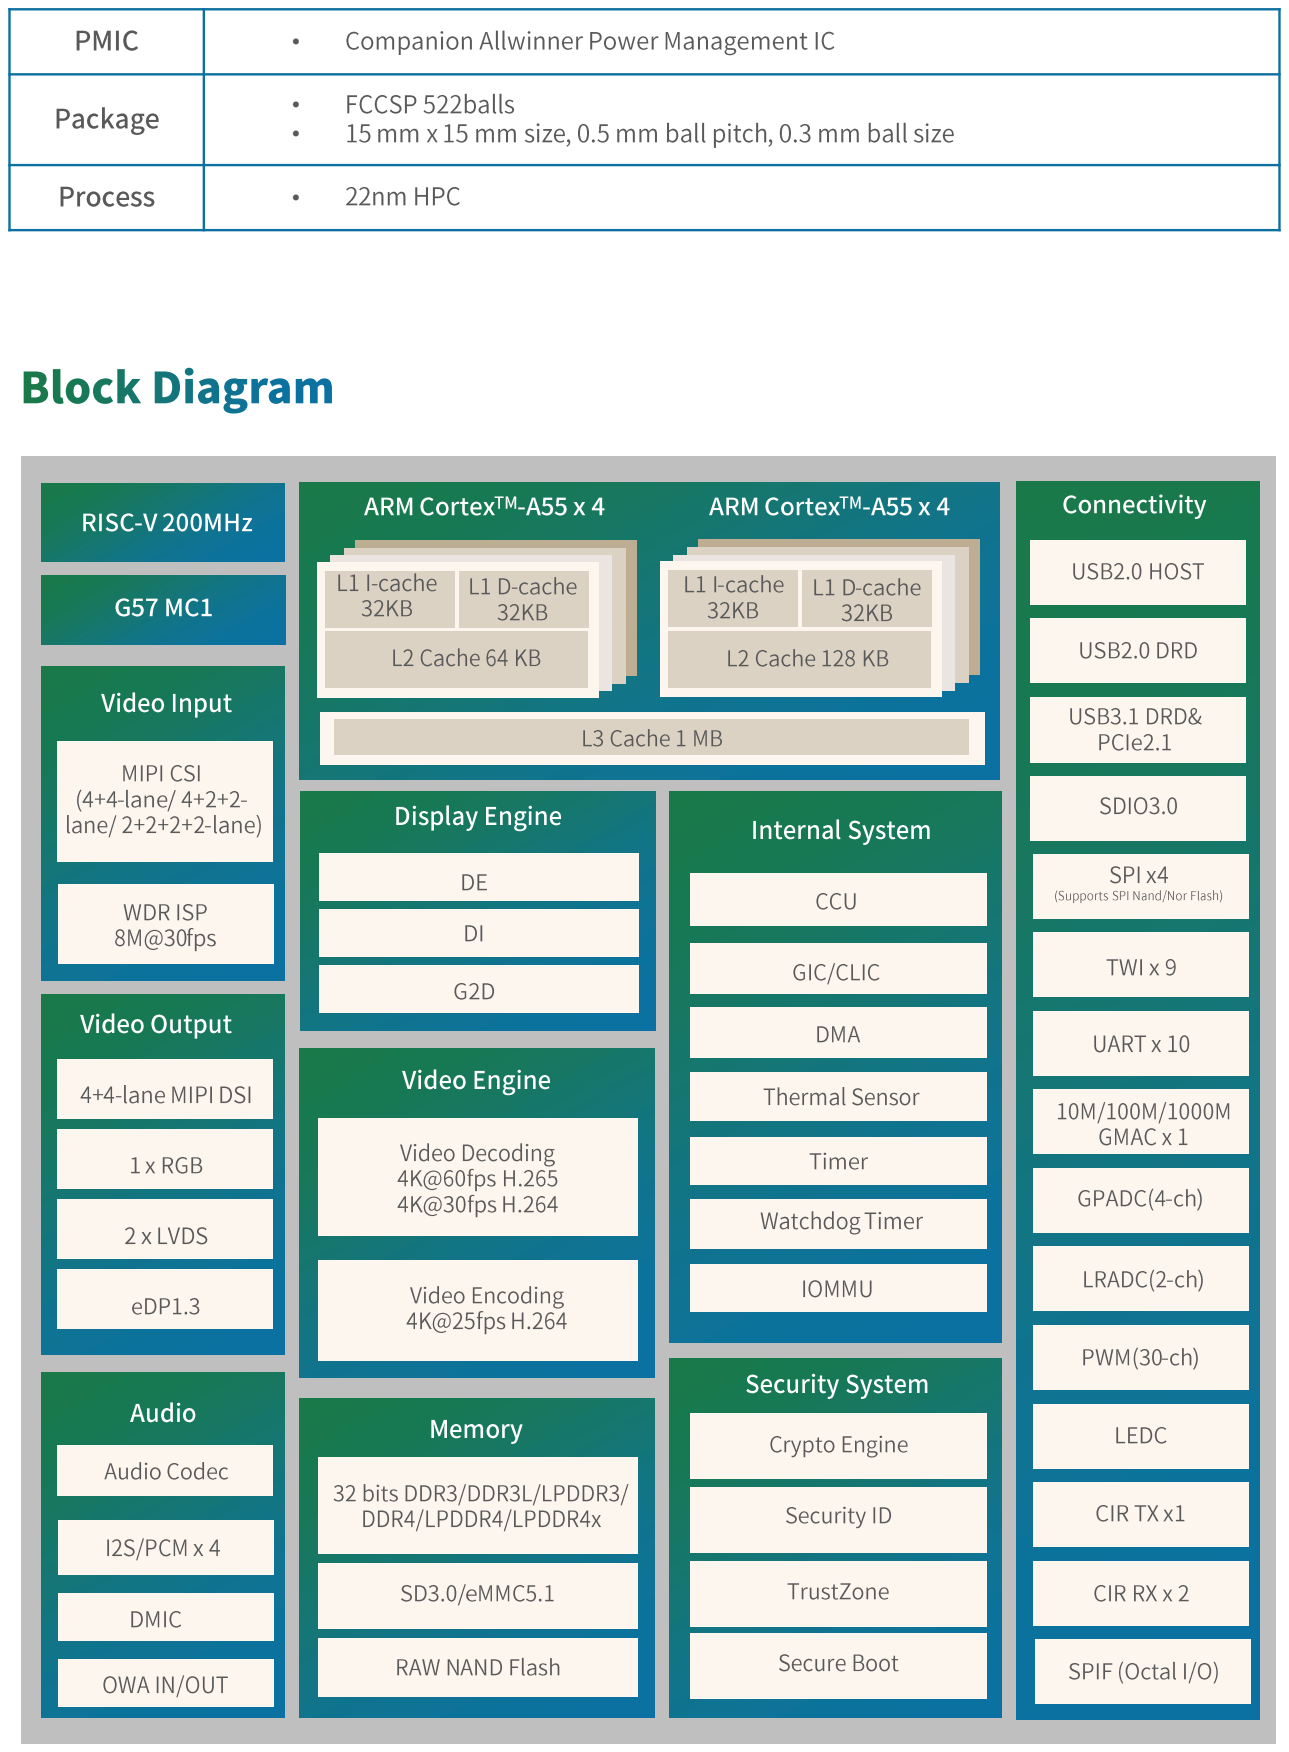
[picture p394: page 3]

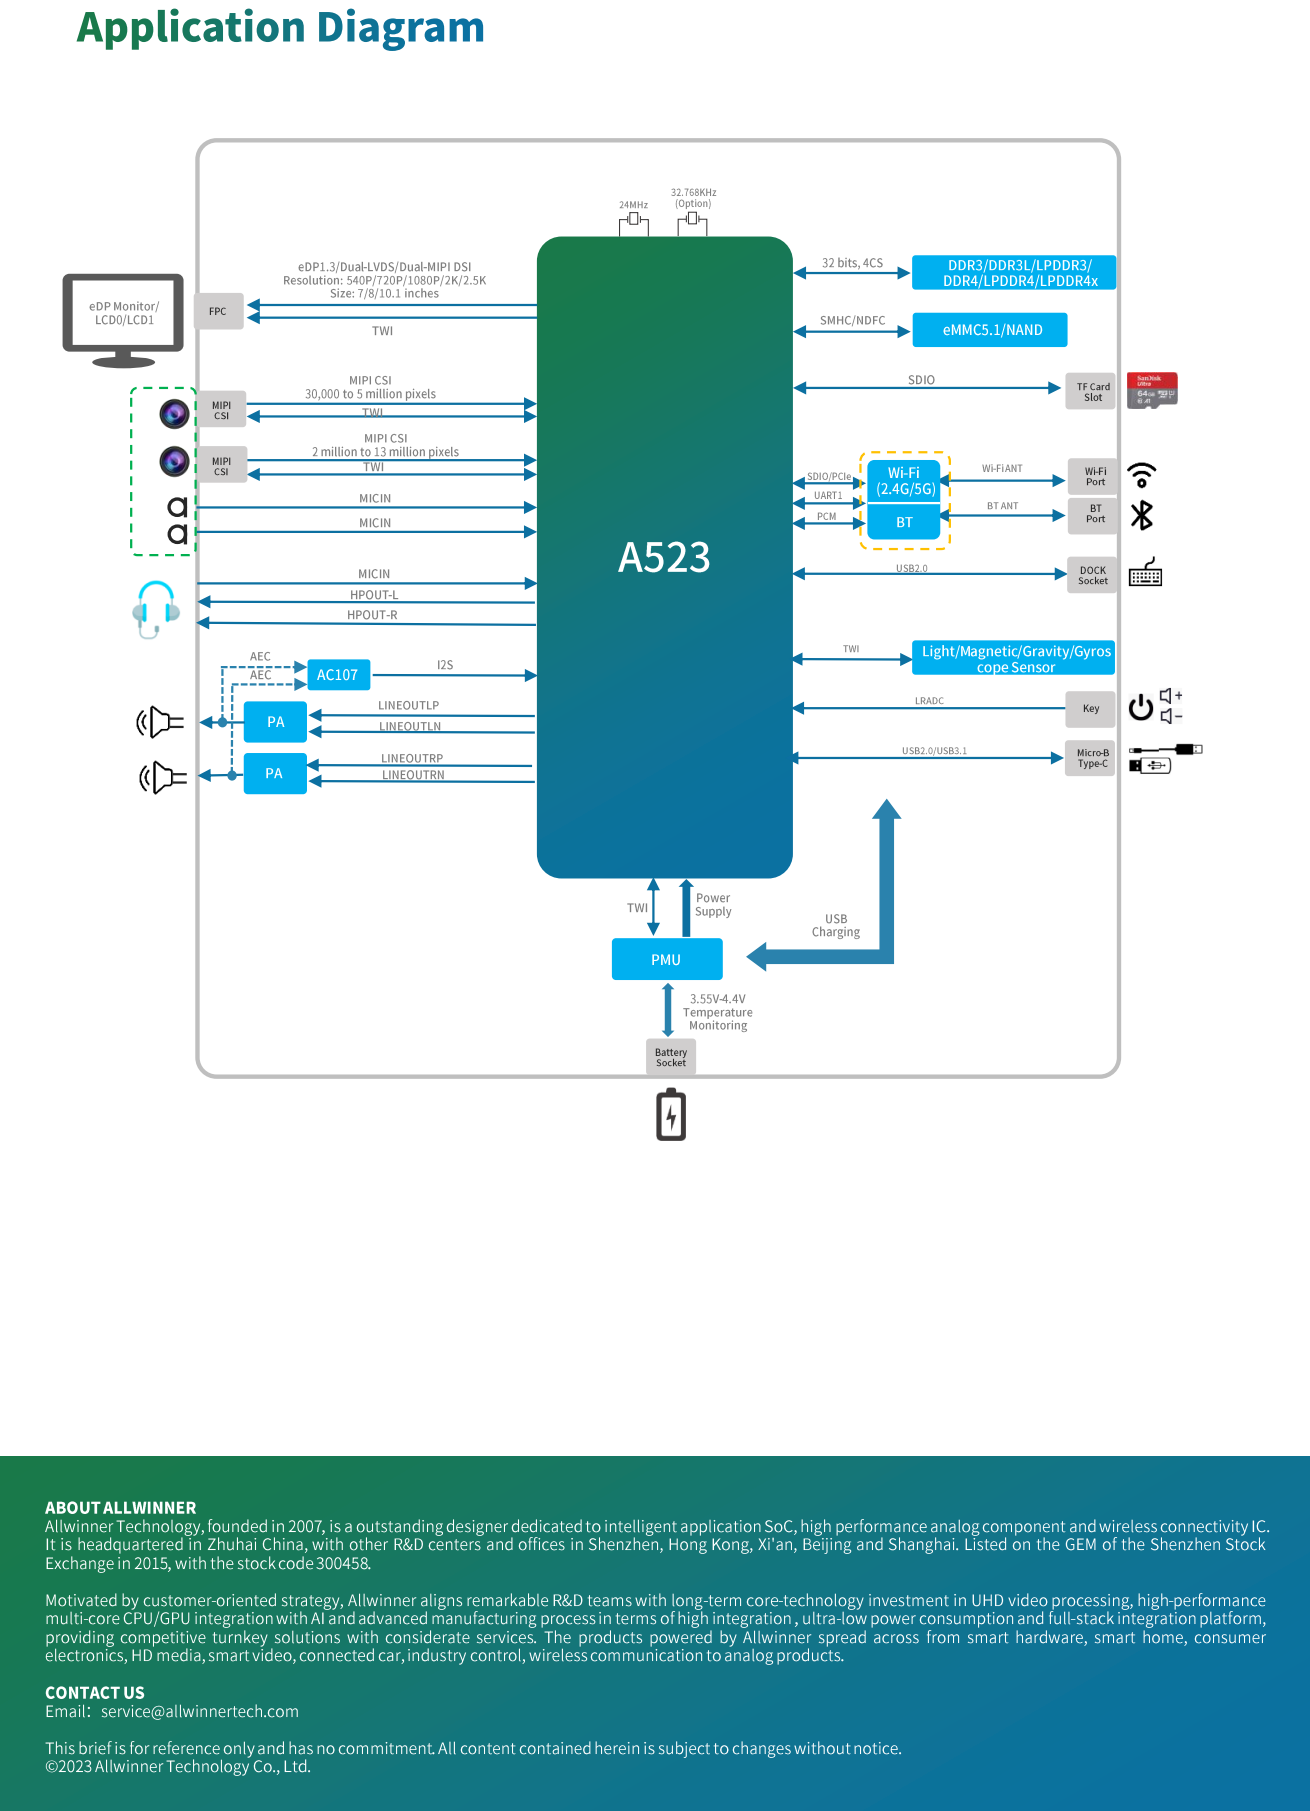
[picture p395: page 4]
