o7-machinehum/Blackpants/ee/integrated/A523/review.pdf

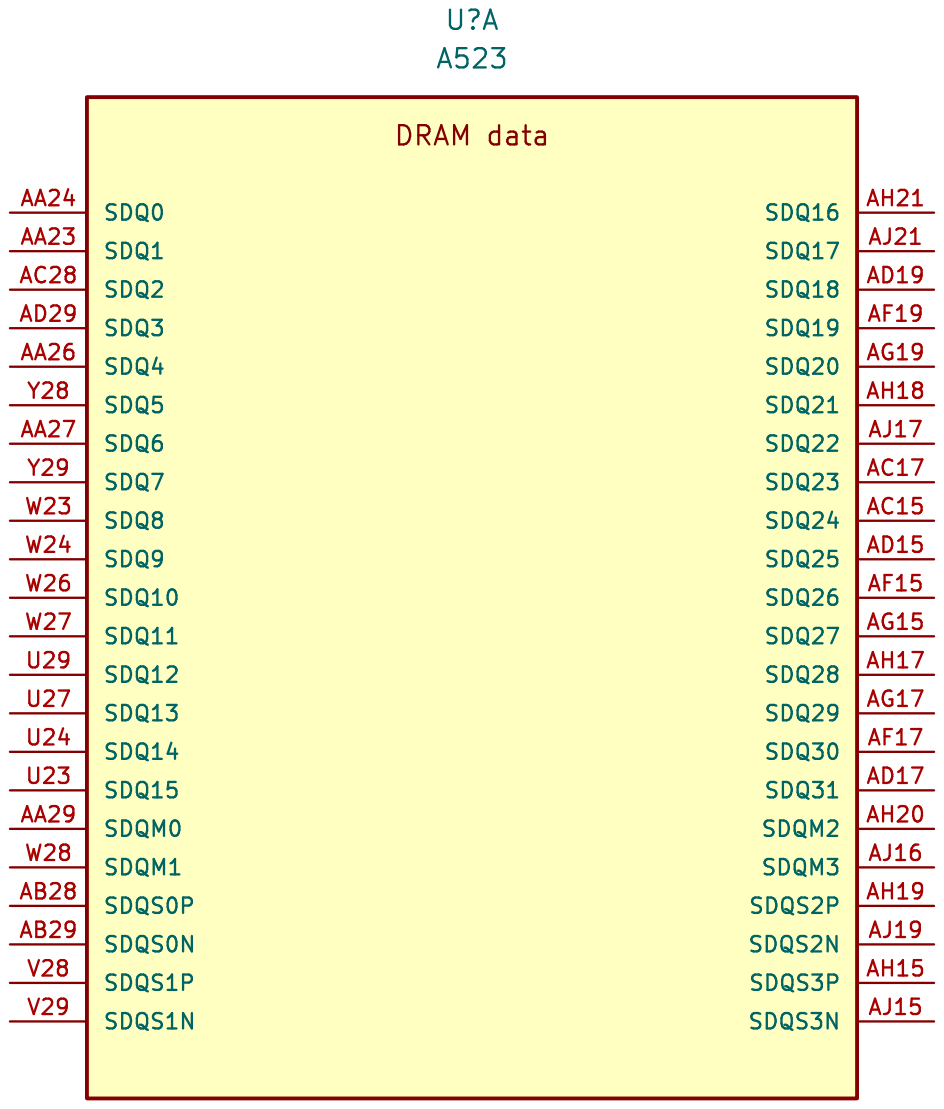
[picture p396: page 1]

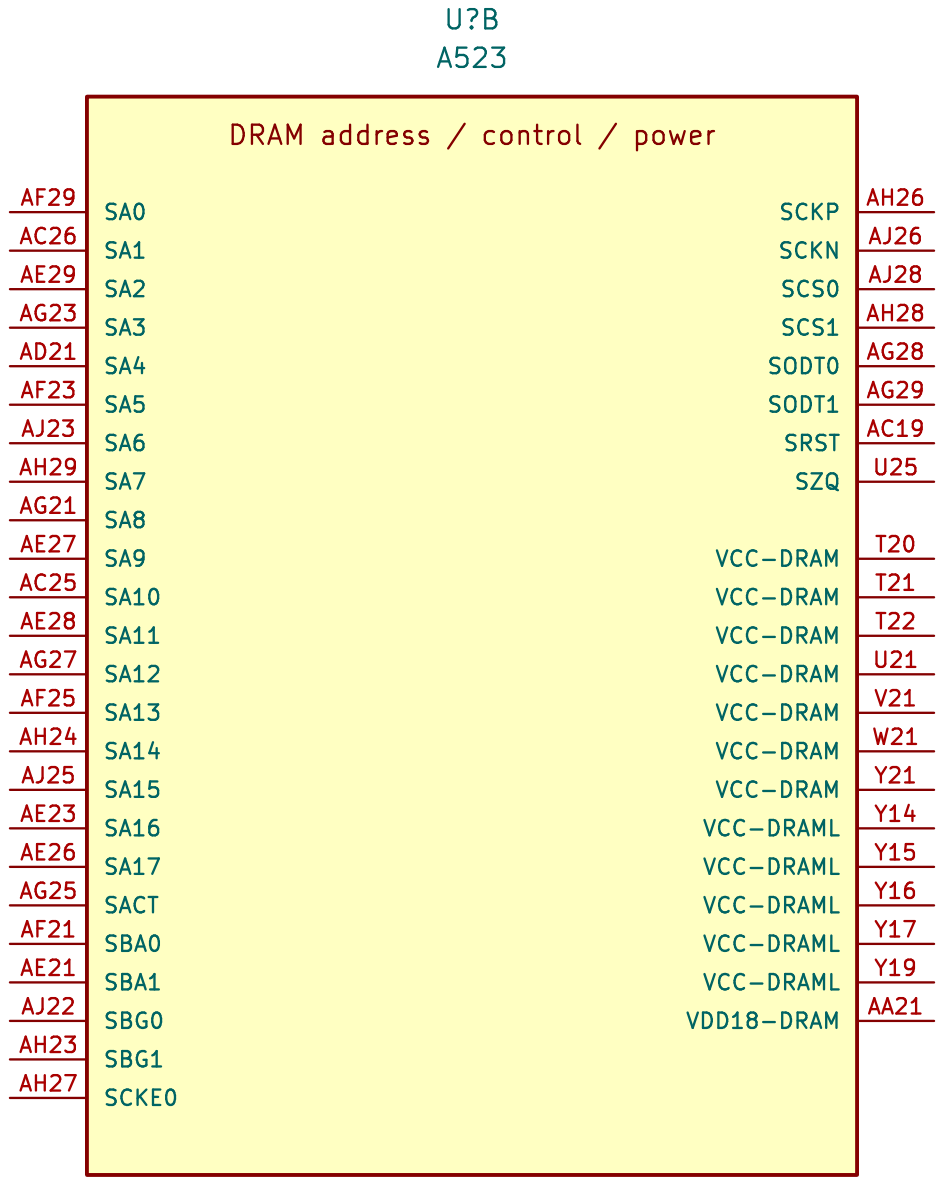
[picture p397: page 2]

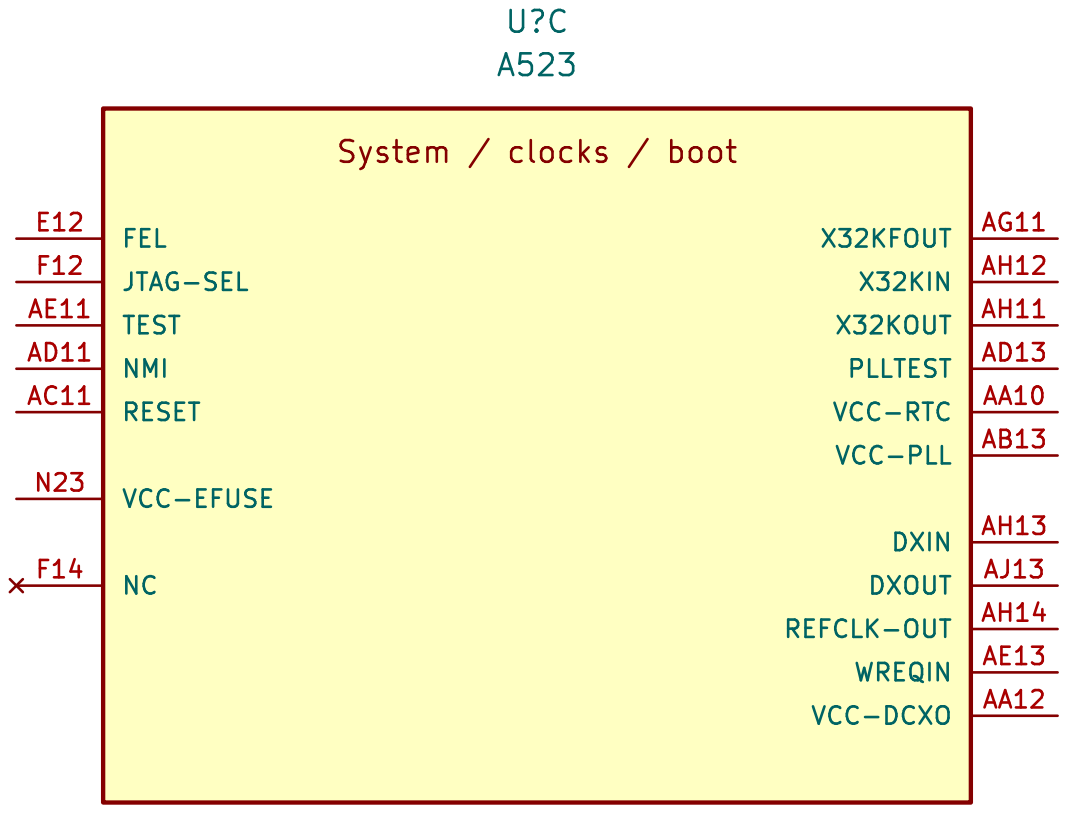
[picture p398: page 3]

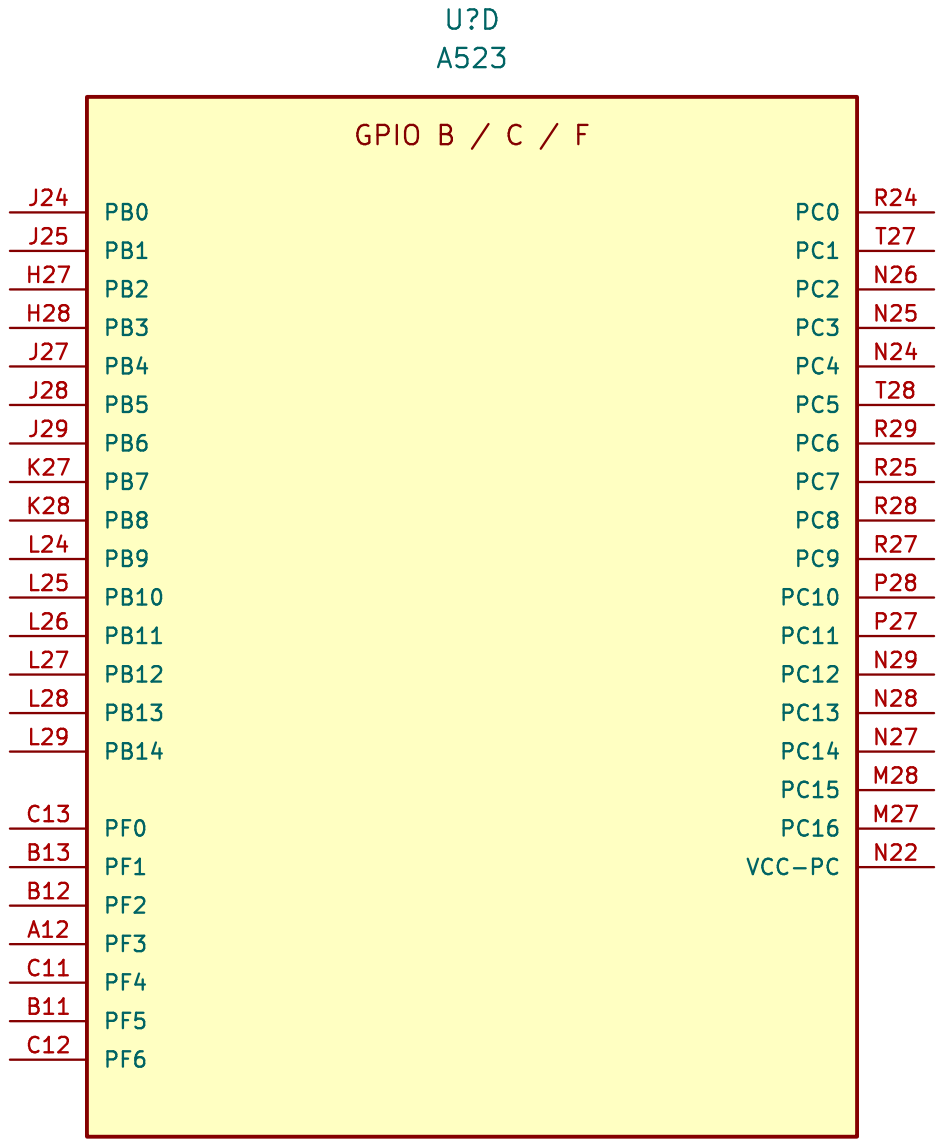
[picture p399: page 4]

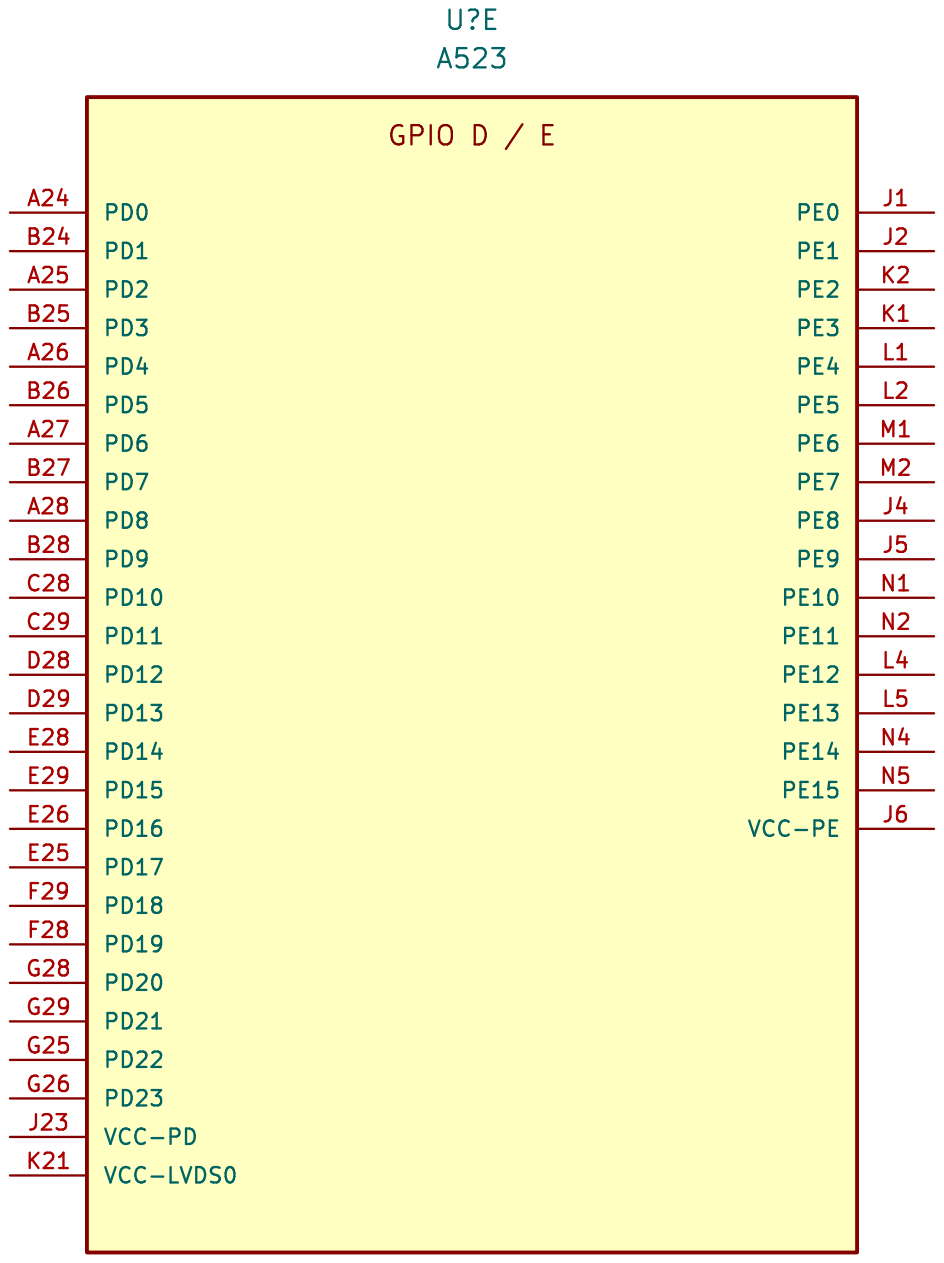
[picture p400: page 5]

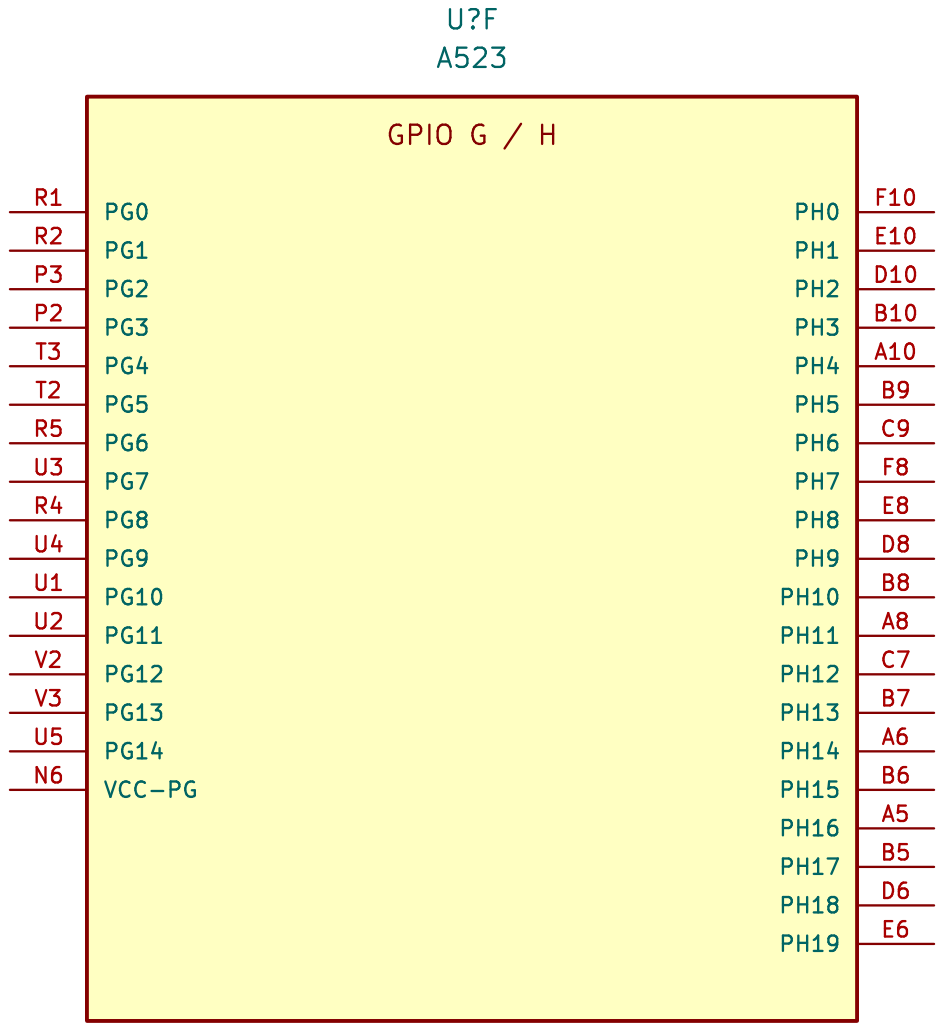
[picture p401: page 6]

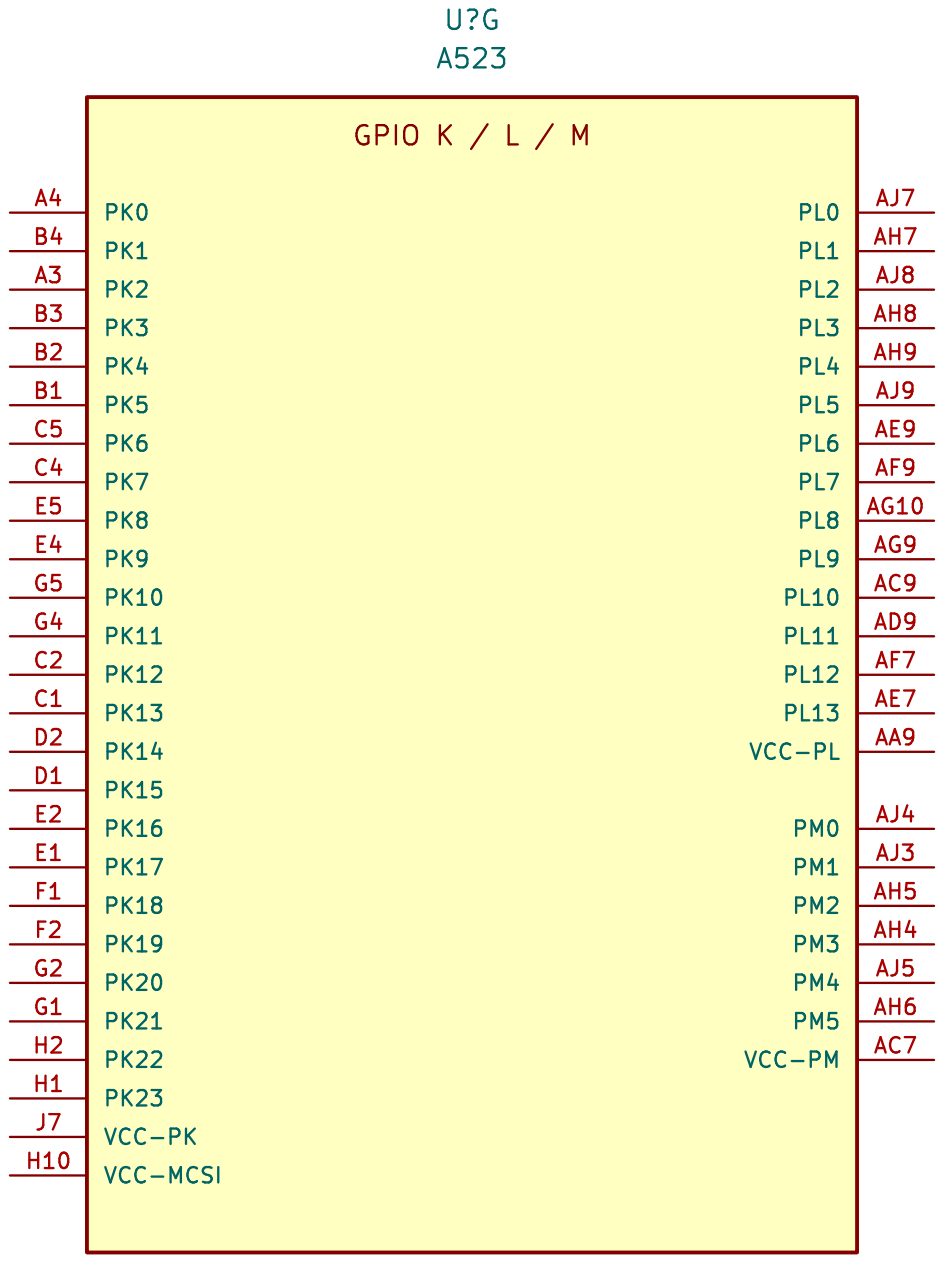
[picture p402: page 7]

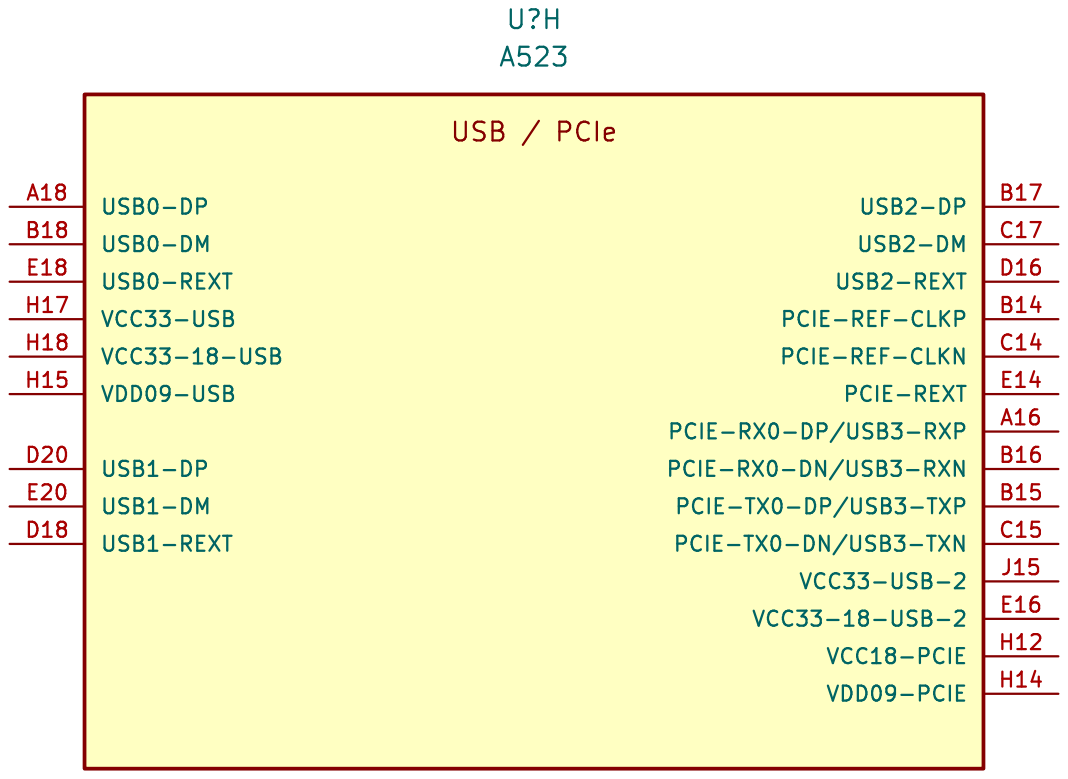
[picture p403: page 8]

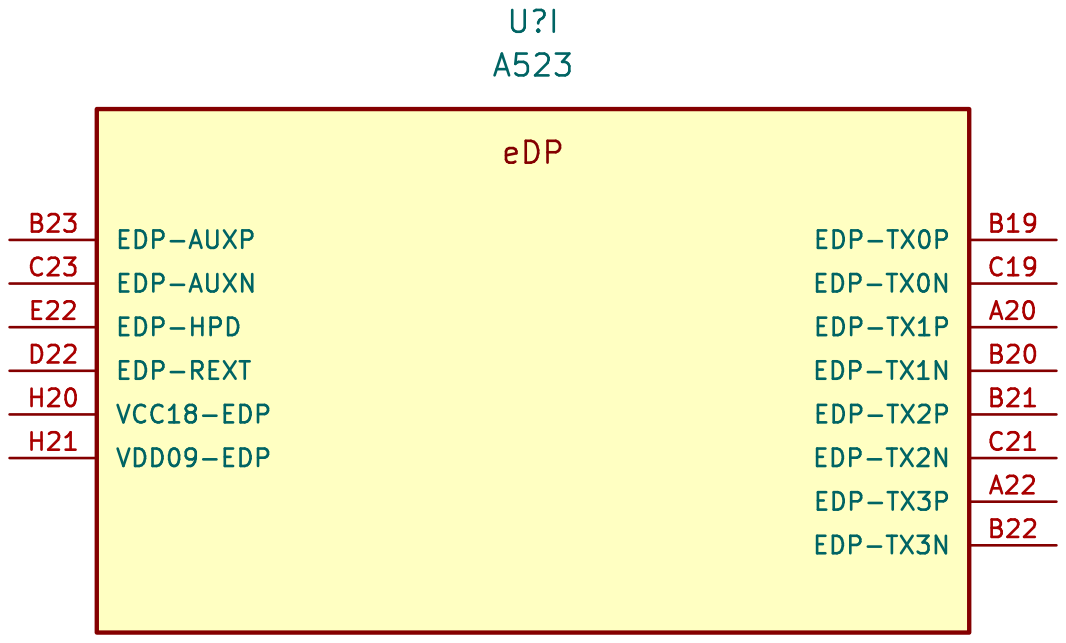
[picture p404: page 9]

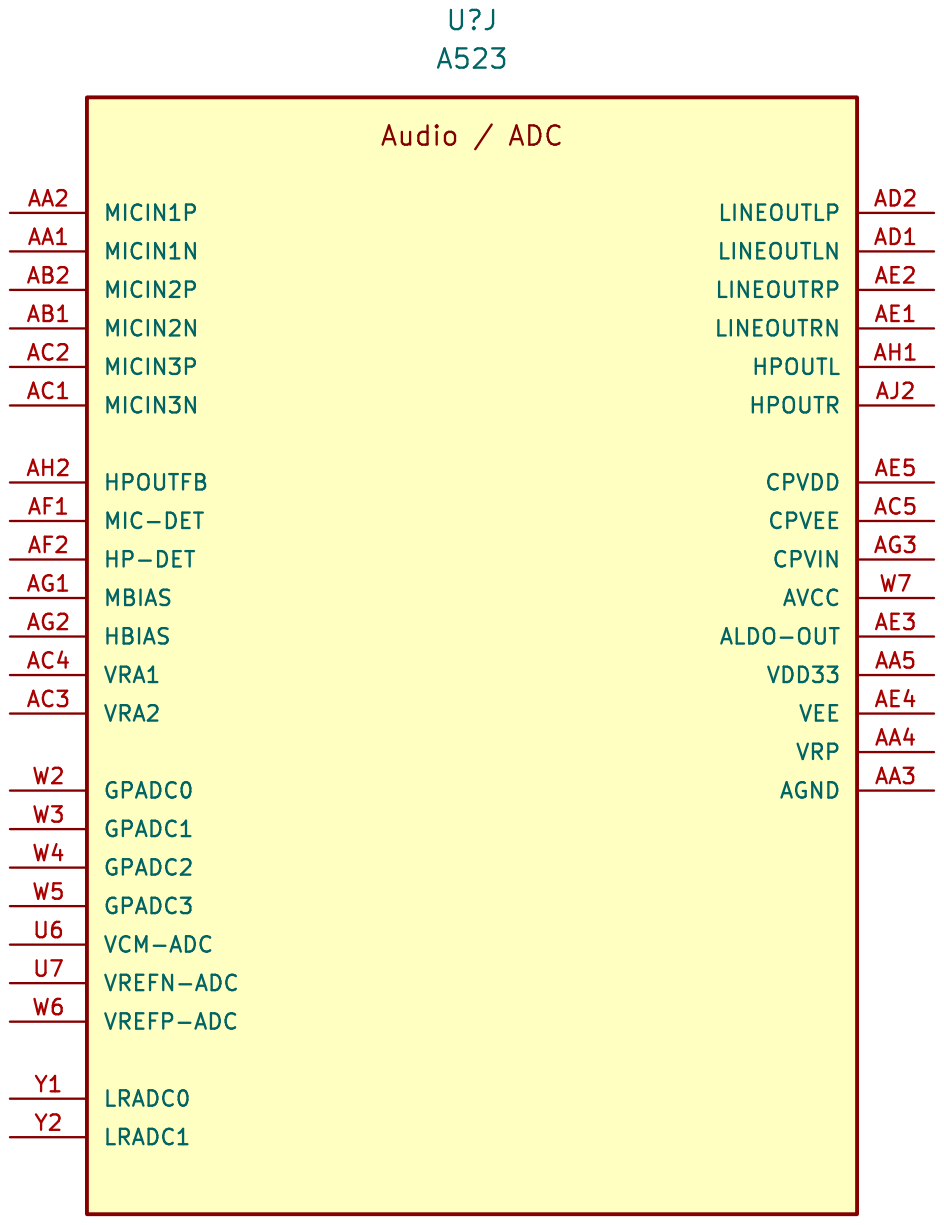
[picture p405: page 10]

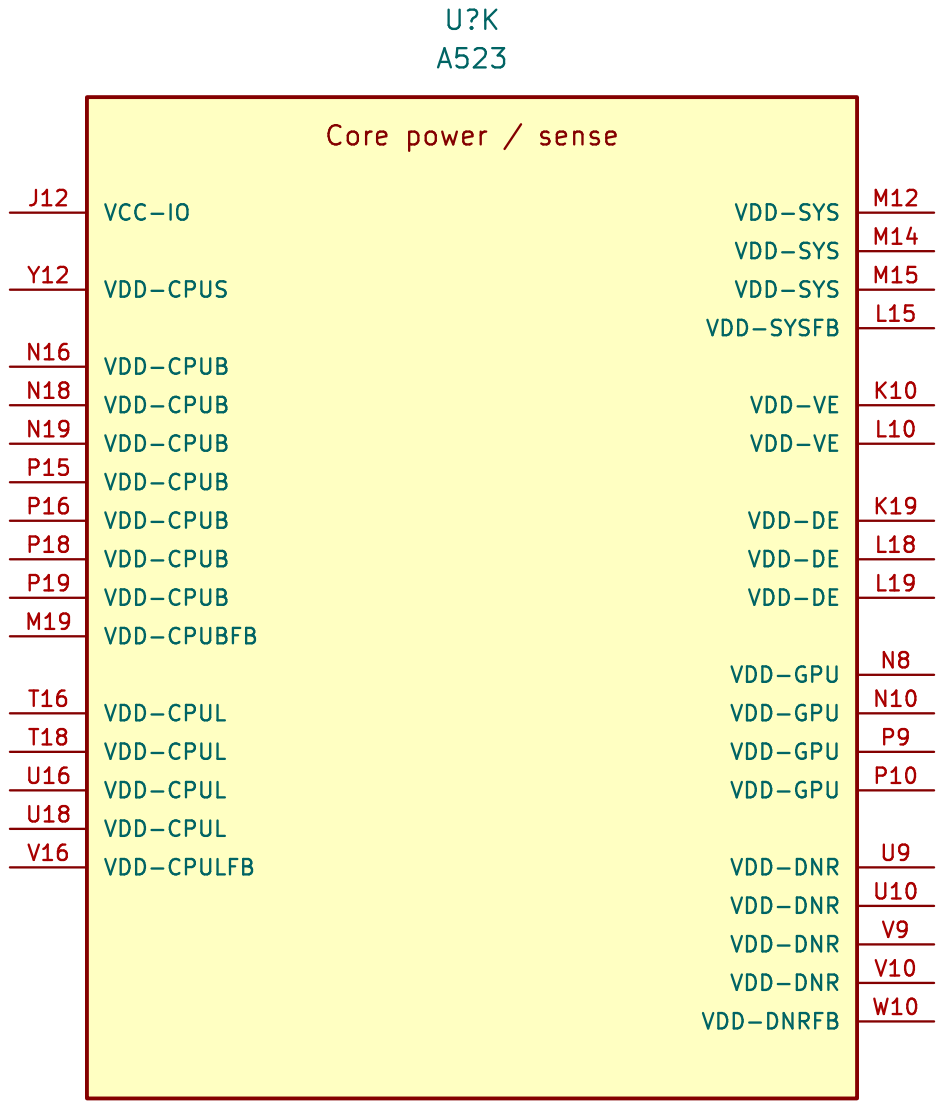
[picture p406: page 11]

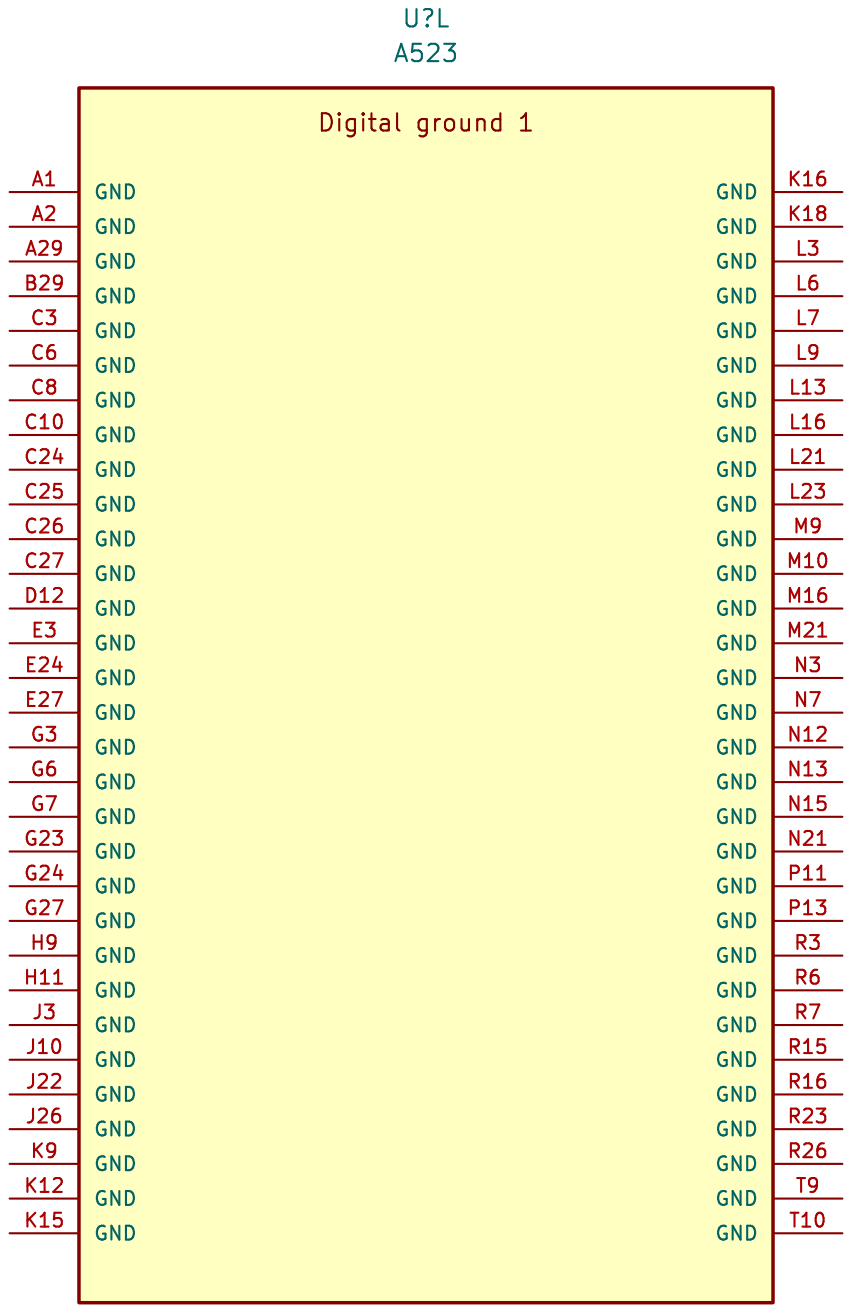
[picture p407: page 12]

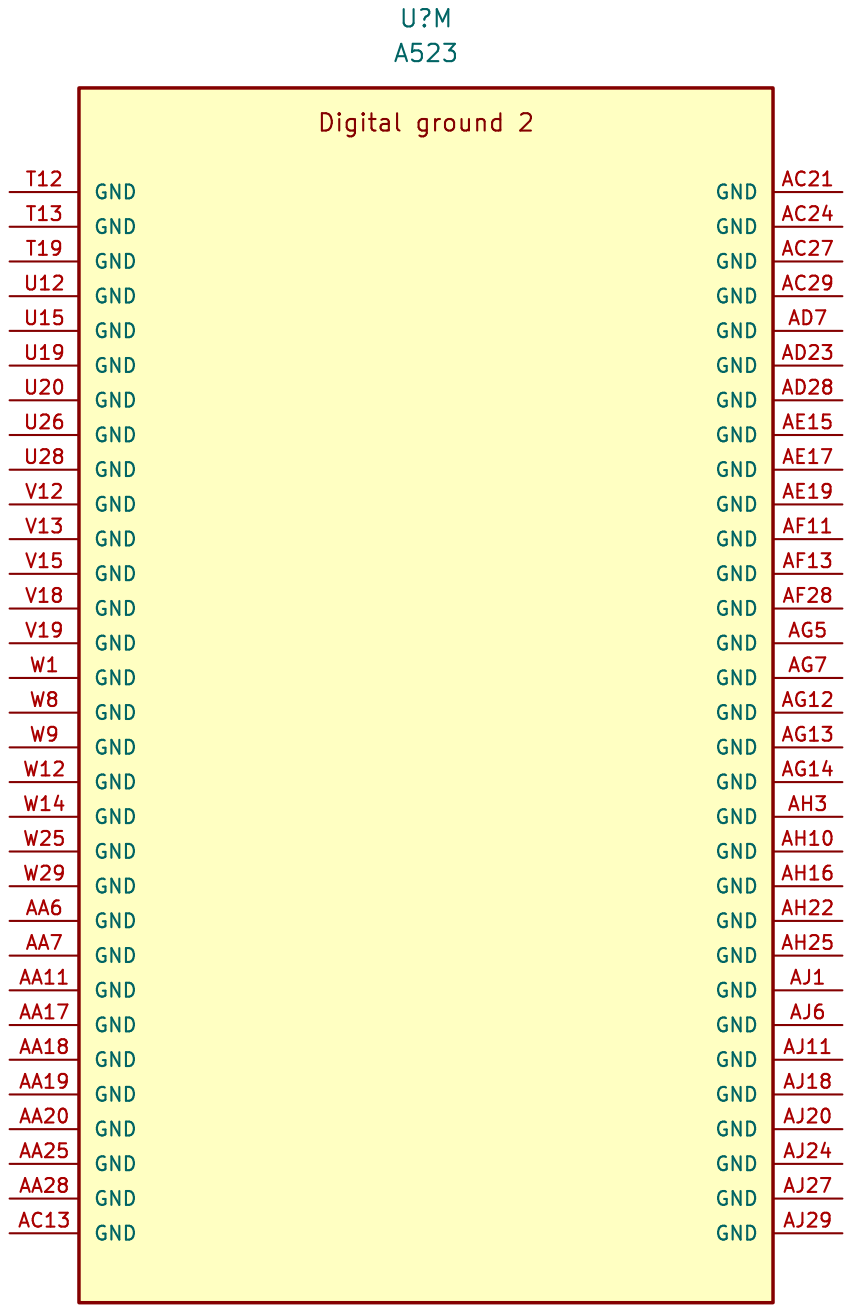
[picture p408: page 13]

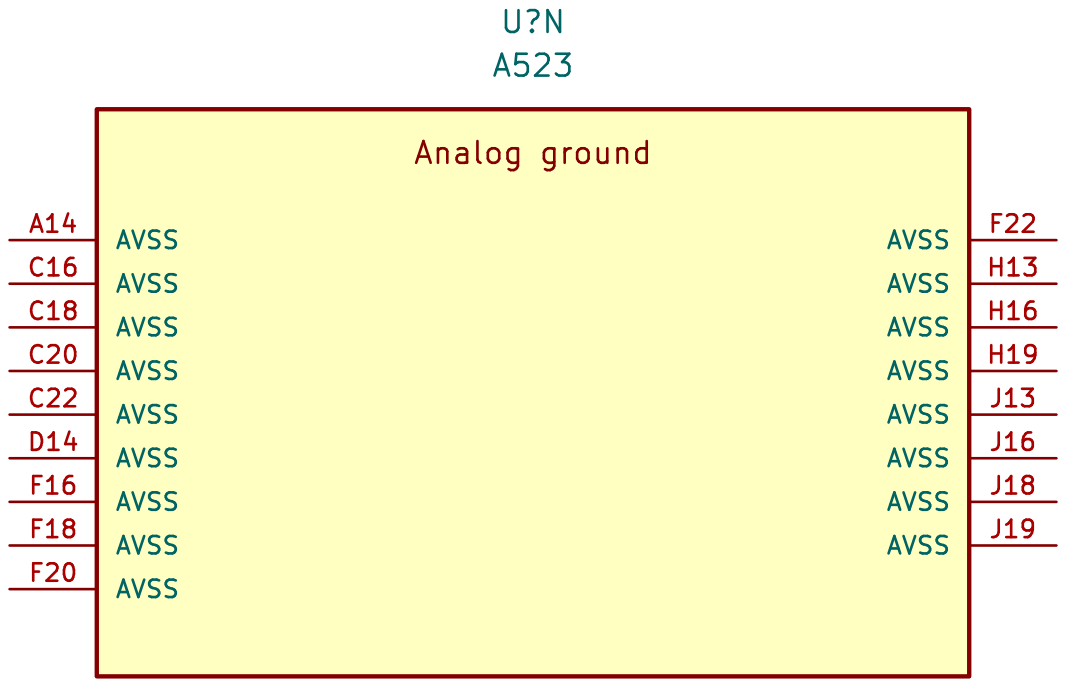
[picture p409: page 14]

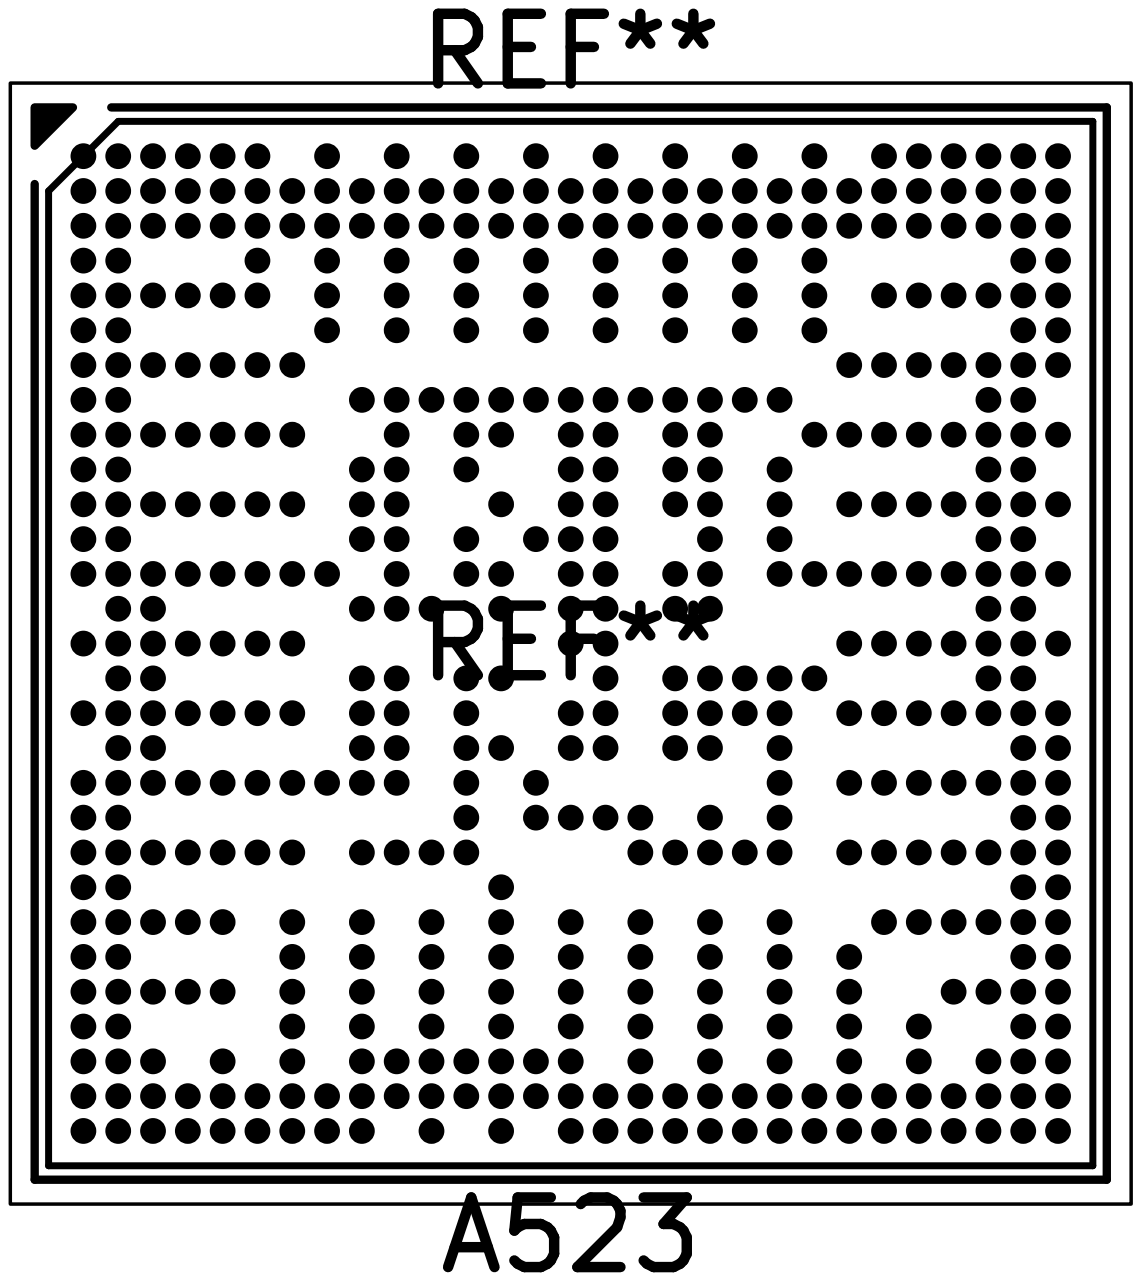
[picture p410: page 15]
