o7-machinehum/Blackpants/docs/a523/A523_hwref/PCB参考/硬件DDR模板&叠层文件/A523-REF-LPDDR4-342BALL-S6L-V2-0/A523_REF_LPDDR4_FBGA342BALL_64X1_S6L_V2_0.pdf

5

4

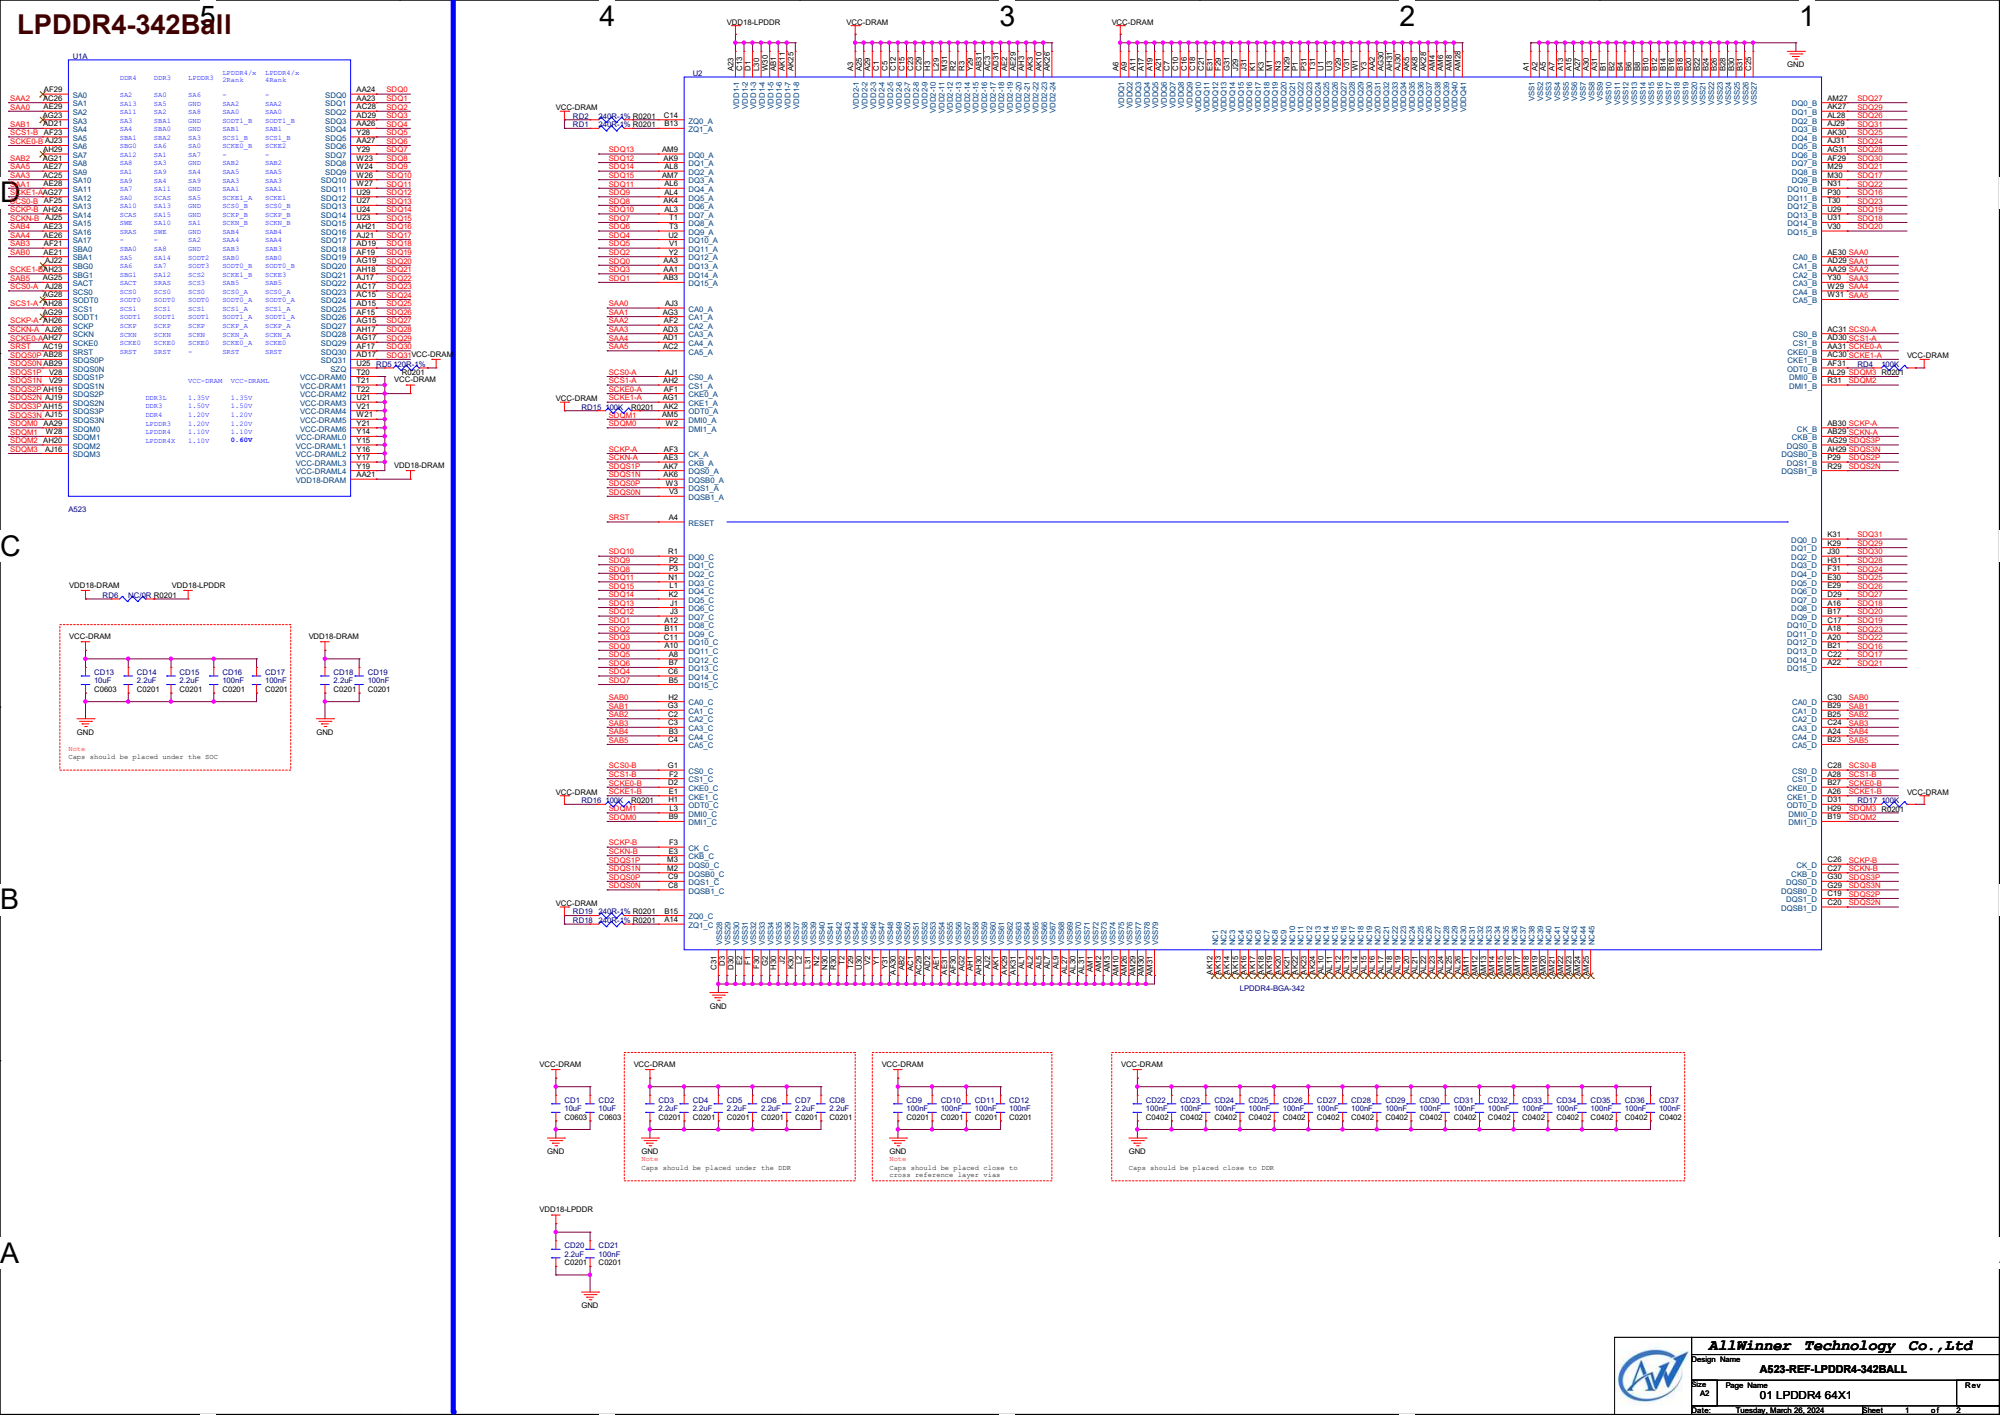
[picture p411: page 1]

U25 VCC-DRAM0 T20 VCC-DRAM1 T21 VCC-DRAM2 T22 VCC-DRAM3 U21 VCC-DRAM4 V21 VCC-DRAM5 W21 VCC-DRAM6 Y21 VCC-DRAML0 Y14 VCC-DRAML1 Y15 VCC-DRAML2 Y16 VCC-DRAML3 Y17 VCC-DRAML4 Y19 VDD18-DRAM

Note
Caps should be placed under the SOC

GND
Caps should be placed under the DDR

Caps should be placed close to
cross reference layer vias

Caps should be placed close to DDR

55

44

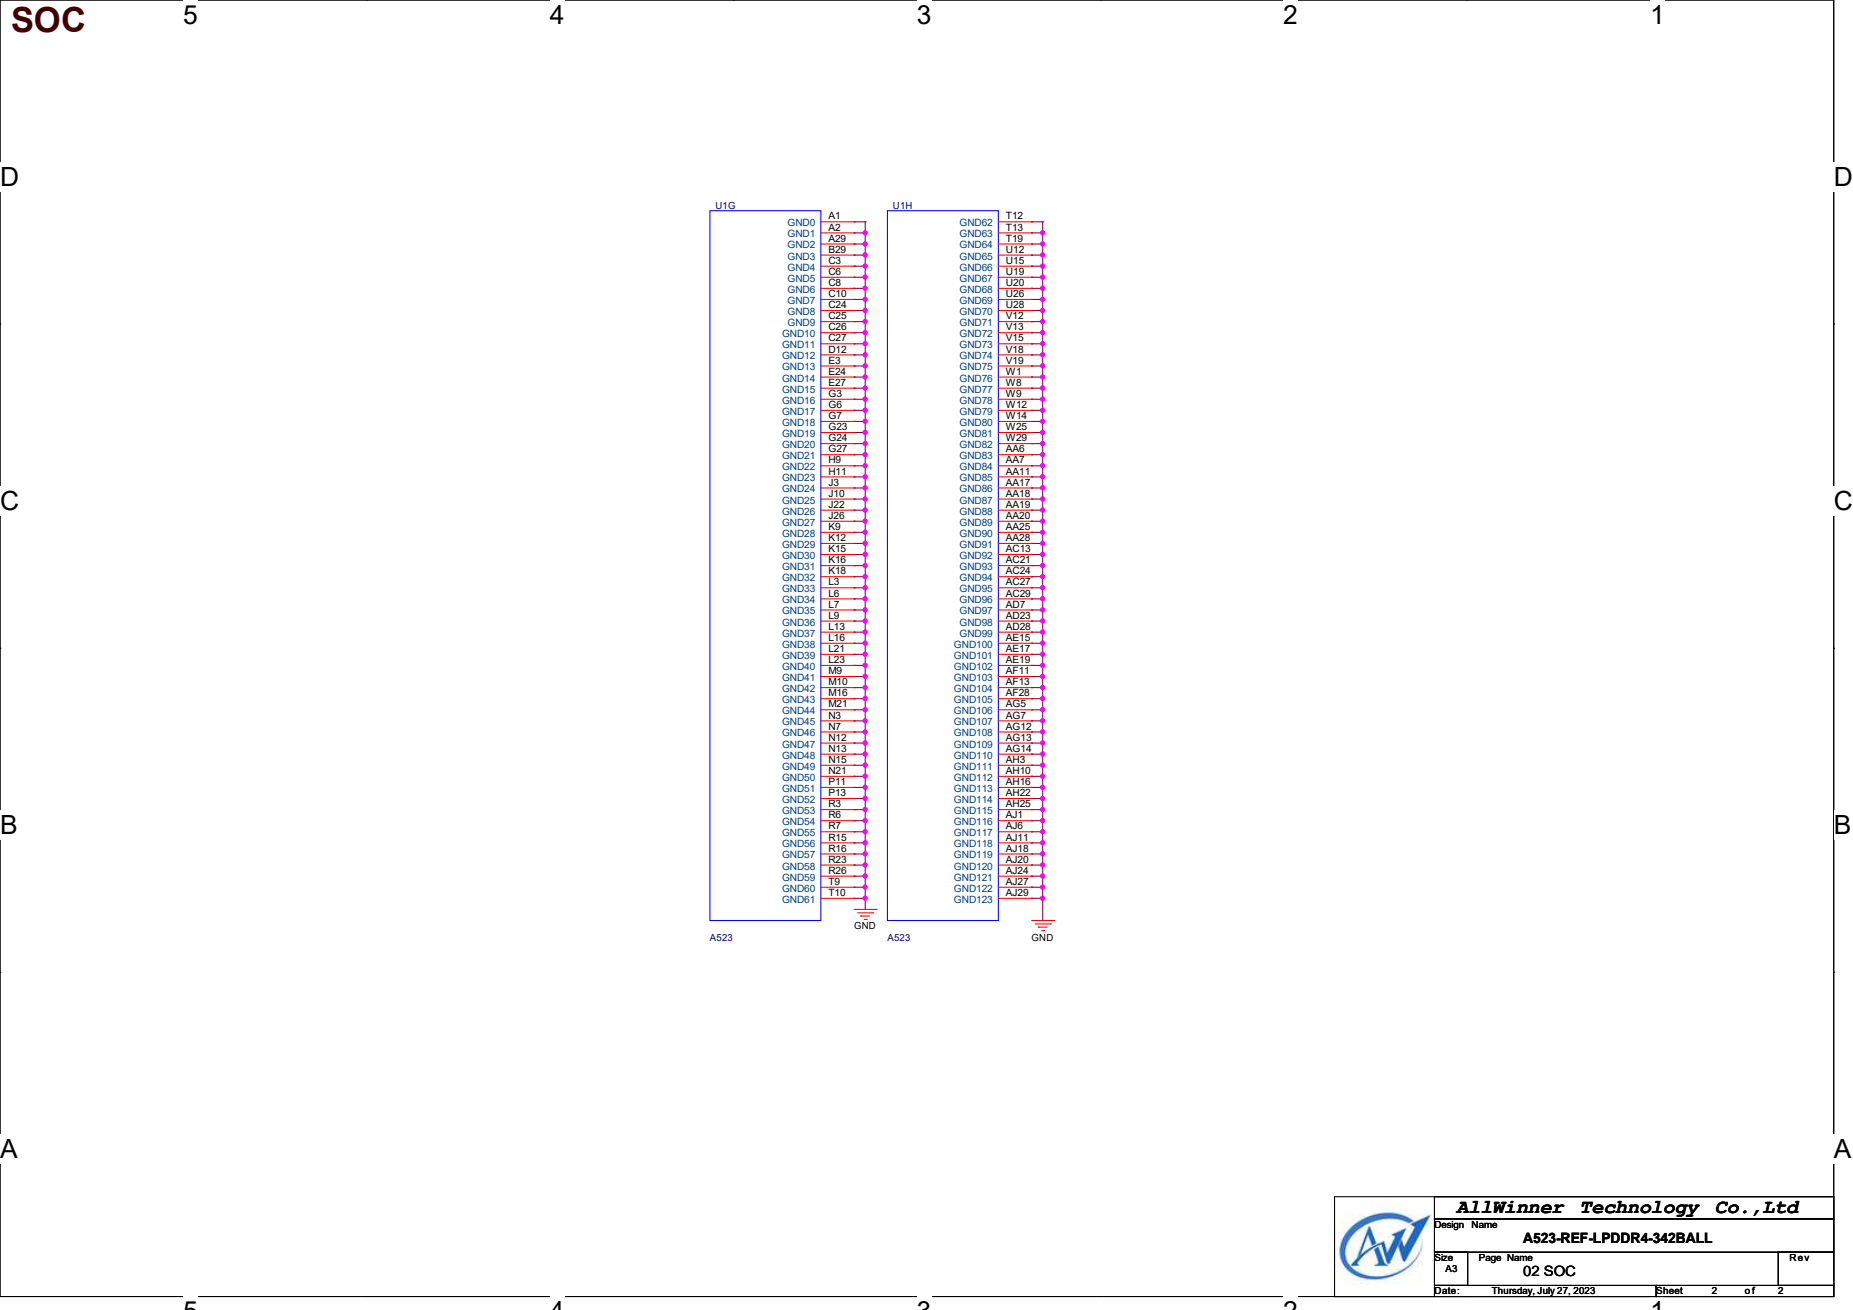
[picture p412: page 2]

AllWinner Technology Co.,Ltd
