o7-machinehum/Blackpants/docs/a523/A523_hwref/PCB参考/硬件DDR模板&叠层文件/A523-REF-LPDDR4-4X-32X1-S8L-V1-0/A523-REF-LPDDR4-4X-32X1-S8L-V1-0.pdf

5

4

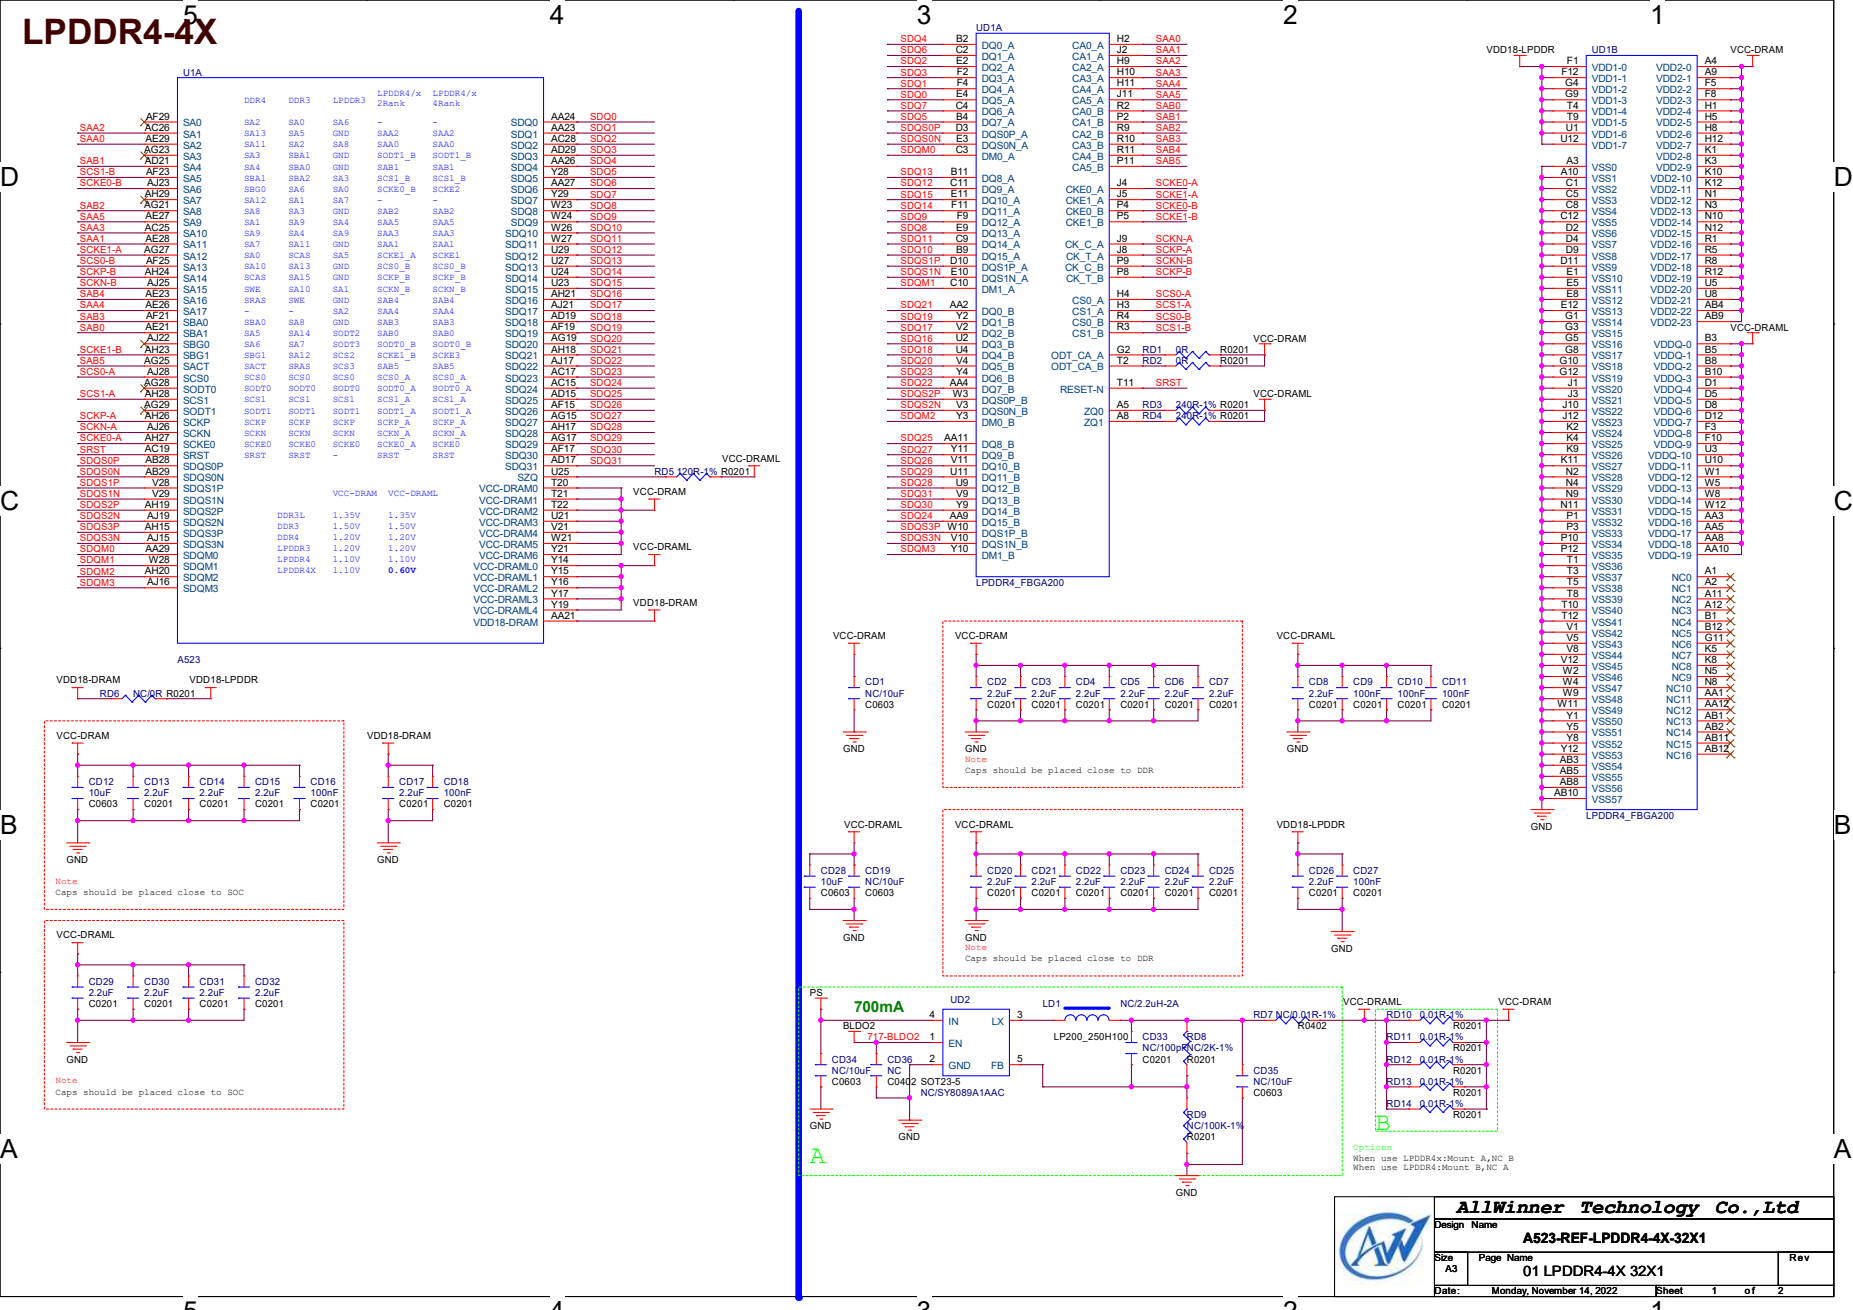
[picture p413: page 1]

SDQ0 AA24 SDQ1 AA23 SDQ2 AC28 SDQ3 AD29 SDQ4 AA26 SDQ5 Y28 SDQ6 AA27 SDQ7 Y29 SDQ8 W23 SDQ9 W24 SDQ10 W26 SDQ11 W27 SDQ12 U29 SDQ13 U27 SDQ14 U24 SDQ15 U23 SDQ16 AH21 SDQ17 AJ21 SDQ18 AD19 SDQ19 AF19 SDQ20 AG19 SDQ21 AH18 SDQ22 AJ17 SDQ23 AC17 SDQ24 AC15 SDQ25 AD15 SDQ26 AF15 SDQ27 AG15 SDQ28 AH17 SDQ29 AG17 SDQ30 AF17 SDQ31 AD17 SZQ U25 VCC-DRAM0 T20 VCC-DRAM1 T21 VCC-DRAM2 T22 VCC-DRAM3 U21 VCC-DRAM4 V21 VCC-DRAM5 W21 VCC-DRAM6 Y21 VCC-DRAML0 Y14 VCC-DRAML1 Y15 VCC-DRAML2 Y16 VCC-DRAML3 Y17 VCC-DRAML4 Y19 VDD18-DRAM AA21

VCC-DRAML VCC-DRAM

Note
Caps should be placed close to DDR

Caps should be placed close to SOC

A When use LPDDR4x:Mount A,NC B

Options
When use LPDDR4:Mount B,NC A

AllWinner Technology Co.,Ltd

55

44

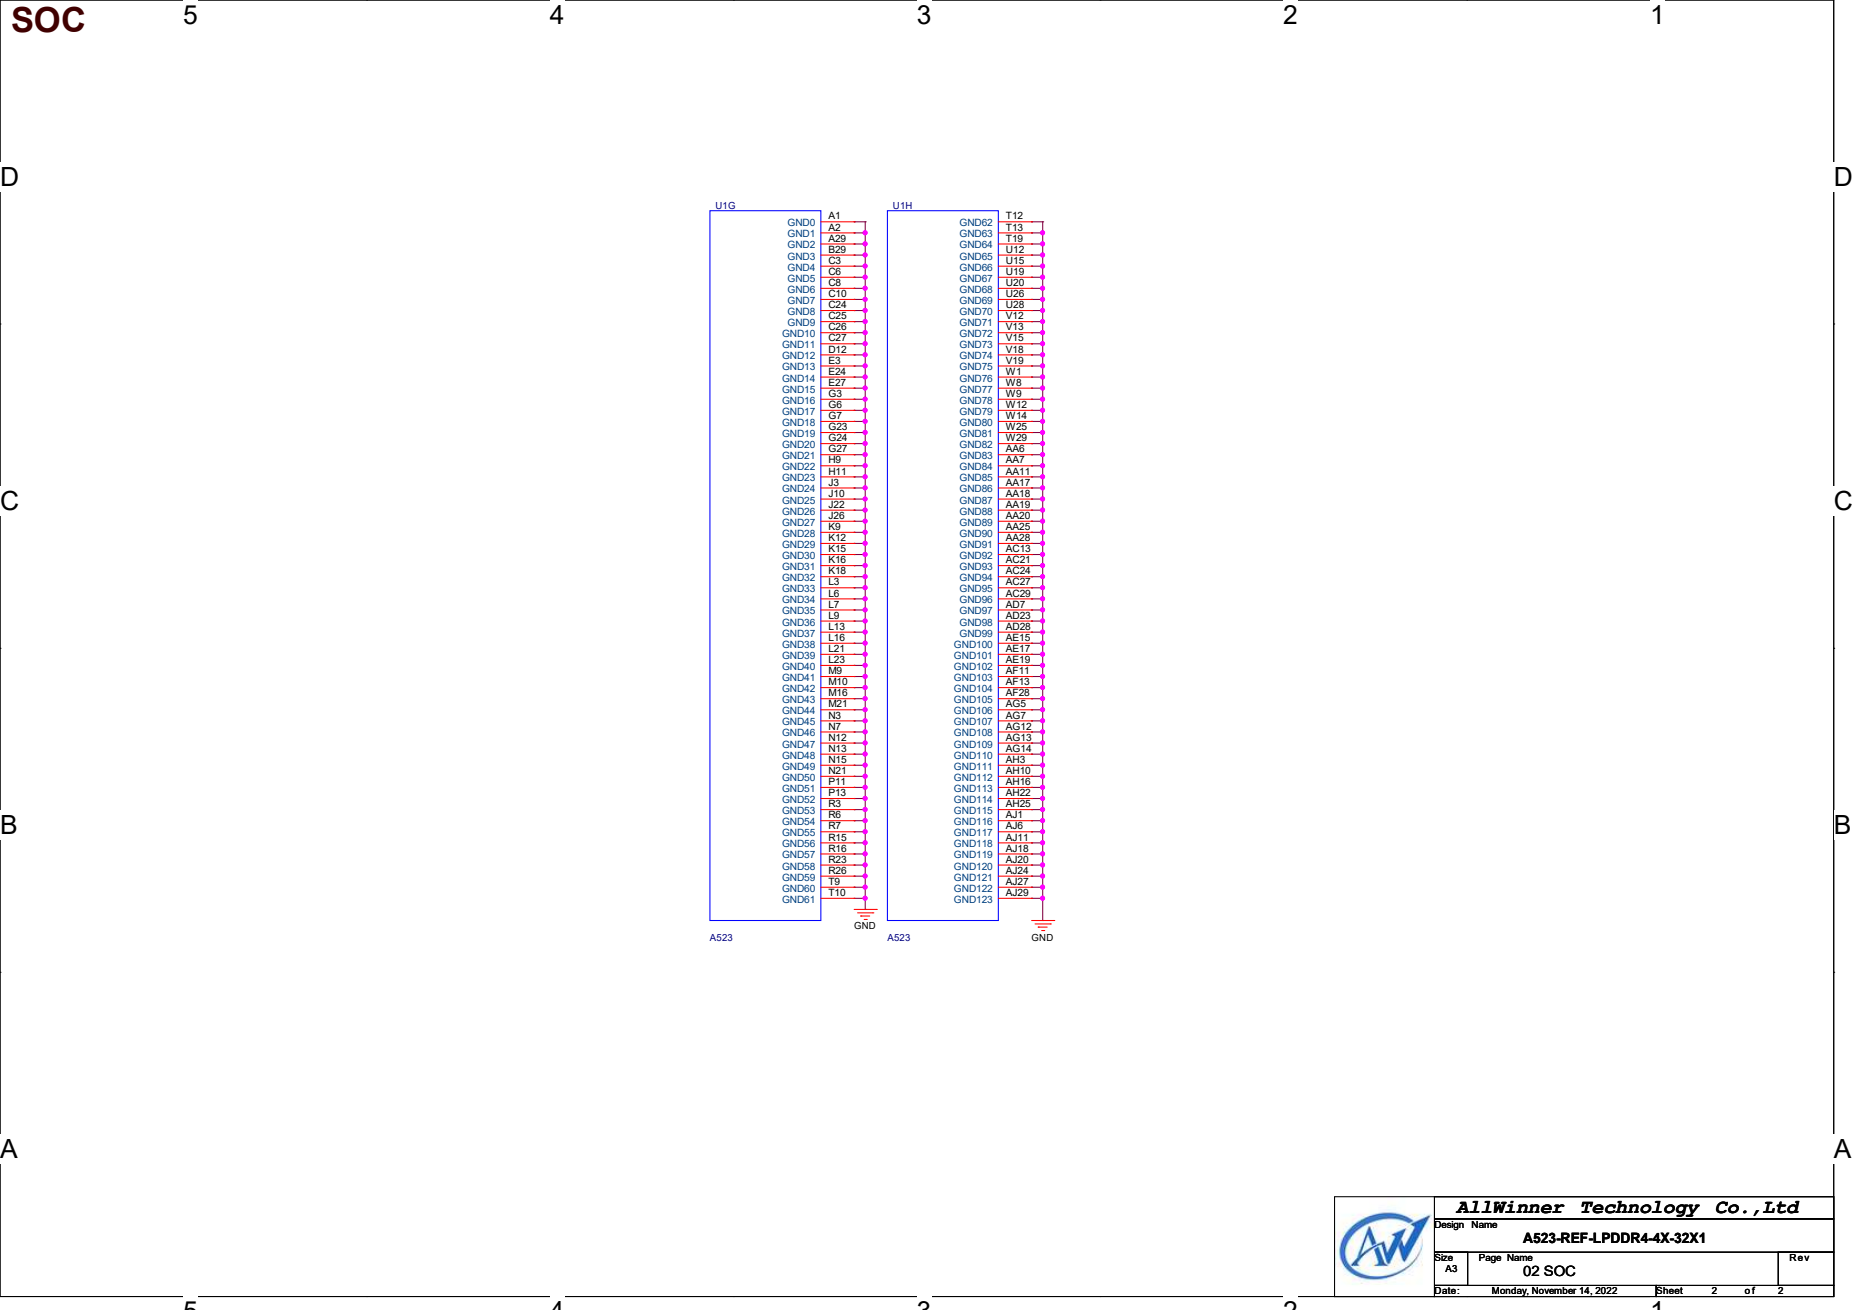
[picture p414: page 2]

AllWinner Technology Co.,Ltd
