o7-machinehum/Blackpants/docs/a523/A523_hwref/PCB参考/硬件DDR模板&叠层文件/A523_REF_LPDDR3_256ball_64X1_4L_V1_0(C0201)/A523_REF_LPDDR3_256ball_64X1_V1_0-C0201-DSN-20230222.pdf

5

4

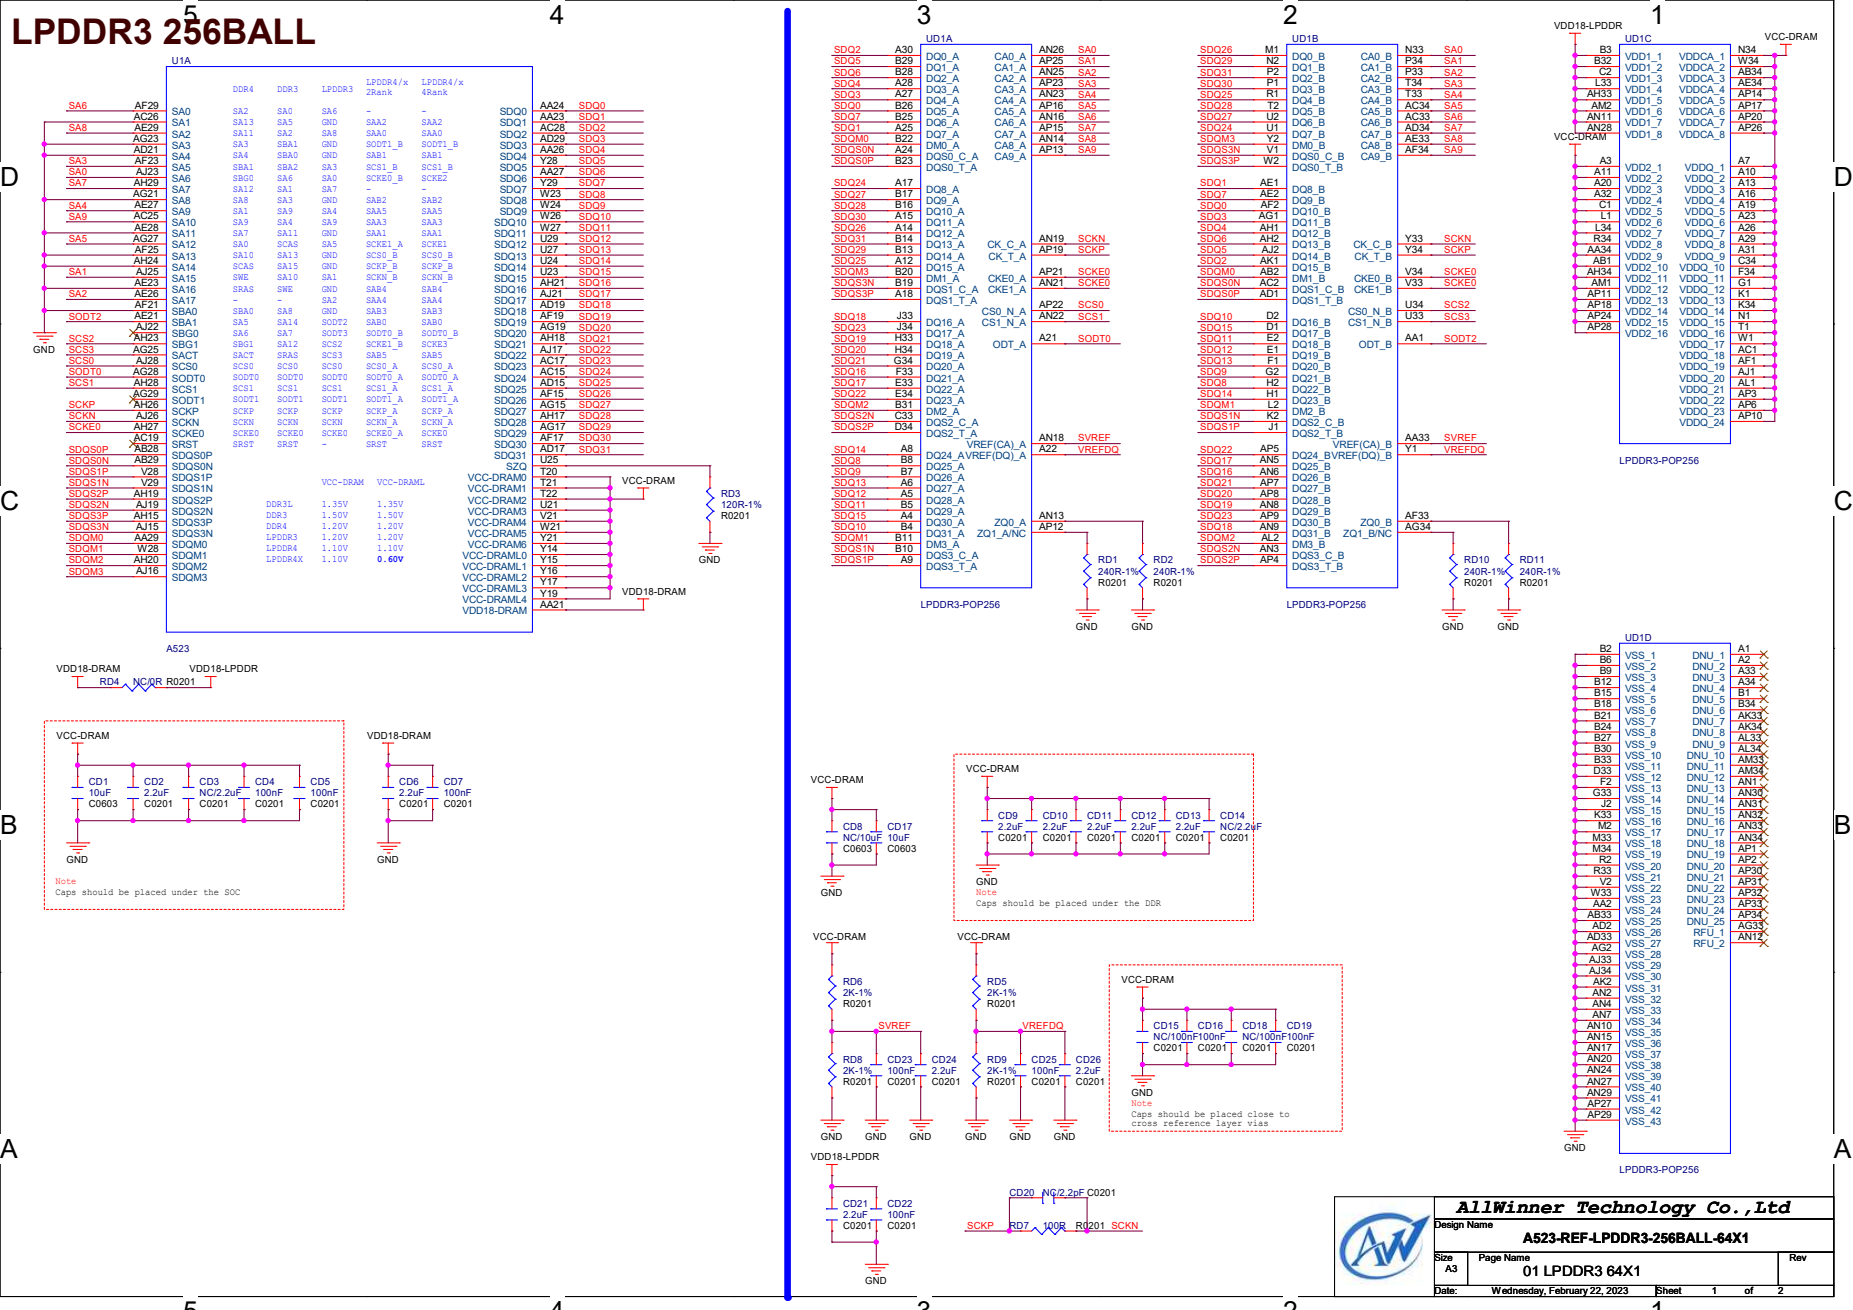
[picture p415: page 1]

LPDDR3 256BALL
SA0 AF29 SA1 AC26 SA2 AE29 SA3 AG23 SA4 AD21 SA5 AF23 SA6 AJ23 SA7 AH29 SA8 AG21 SA9 AE27 SA10 AC25 SA11 AE28 SA12 AG27 SA13 AF25 SA14 AH24 SA15 AJ25 SA16 AE23 SA17 AE26 SBA0 AF21 SBA1 AE21 SBG0 AJ22 SBG1 AH23 SACT AG25 SCS0 AJ28 SODT0 AG28 SCS1 AH28 SODT1 AG29 SCKP AH26 SCKN AJ26 SCKE0 AH27 SRST AC19 SDQS0P AB28 SDQS0N AB29 SDQS1P V28 SDQS1N V29 SDQS2P AH19 SDQS2N AJ19 SDQS3P AH15 SDQS3N AJ15 SDQM0 AA29 SDQM1 W28 SDQM2 AH20 SDQM3 AJ16

CA0_A AN26 CA1_A AP25 CA2_A AN25 CA3_A AP23 CA4_A AN23 CA5_A AP16 CA6_A AN16 CA7_A AP15 CA8_A AN14 CA9_A AP13 CK_C_A AN19 CK_T_A AP19 CKE0_A AP21 CKE1_A AN21 CS0_N_A AP22 CS1_N_A AN22 ODT_A A21 VREF(CA)_A AN18 VREF(DQ)_A A22 ZQ0_A AN13 ZQ1_A/NC AP12

CA0_B N33 CA1_B P34 CA2_B P33 CA3_B T34 CA4_B T33 CA5_B AC34 CA6_B AC33 CA7_B AD34 CA8_B AE33 CA9_B AF34 CK_C_B Y33 CK_T_B Y34 CKE0_B V34 CKE1_B V33 CS0_N_B U34 CS1_N_B U33 ODT_B AA1 VREF(CA)_B AA33 VREF(DQ)_B Y1 ZQ0_B AF33 ZQ1_B/NC AG34

SDQ0 AA24 SDQ1 AA23 SDQ2 AC28 SDQ3 AD29 SDQ4 AA26 SDQ5 Y28 SDQ6 AA27 SDQ7 Y29 SDQ8 W23 SDQ9 W24 SDQ10 W26 SDQ11 W27 SDQ12 U29 SDQ13 U27 SDQ14 U24 SDQ15 U23 SDQ16 AH21 SDQ17 AJ21 SDQ18 AD19 SDQ19 AF19 SDQ20 AG19 SDQ21 AH18 SDQ22 AJ17 SDQ23 AC17 SDQ24 AC15 SDQ25 AD15 SDQ26 AF15 SDQ27 AG15 SDQ28 AH17 SDQ29 AG17 SDQ30 AF17 SDQ31 AD17 SZQ U25 VCC-DRAM0 T20 VCC-DRAM1 T21 VCC-DRAM2 T22 VCC-DRAM3 U21 VCC-DRAM4 V21 VCC-DRAM5 W21 VCC-DRAM6 Y21 VCC-DRAML0 Y14 VCC-DRAML1 Y15 VCC-DRAML2 Y16 VCC-DRAML3 Y17 VCC-DRAML4 Y19 VDD18-DRAM AA21

Note
Caps should be placed under the SOC

Caps should be placed under the DDR

GND
Caps should be placed close to
cross reference layer vias

AllWinner Technology Co.,Ltd

55

44

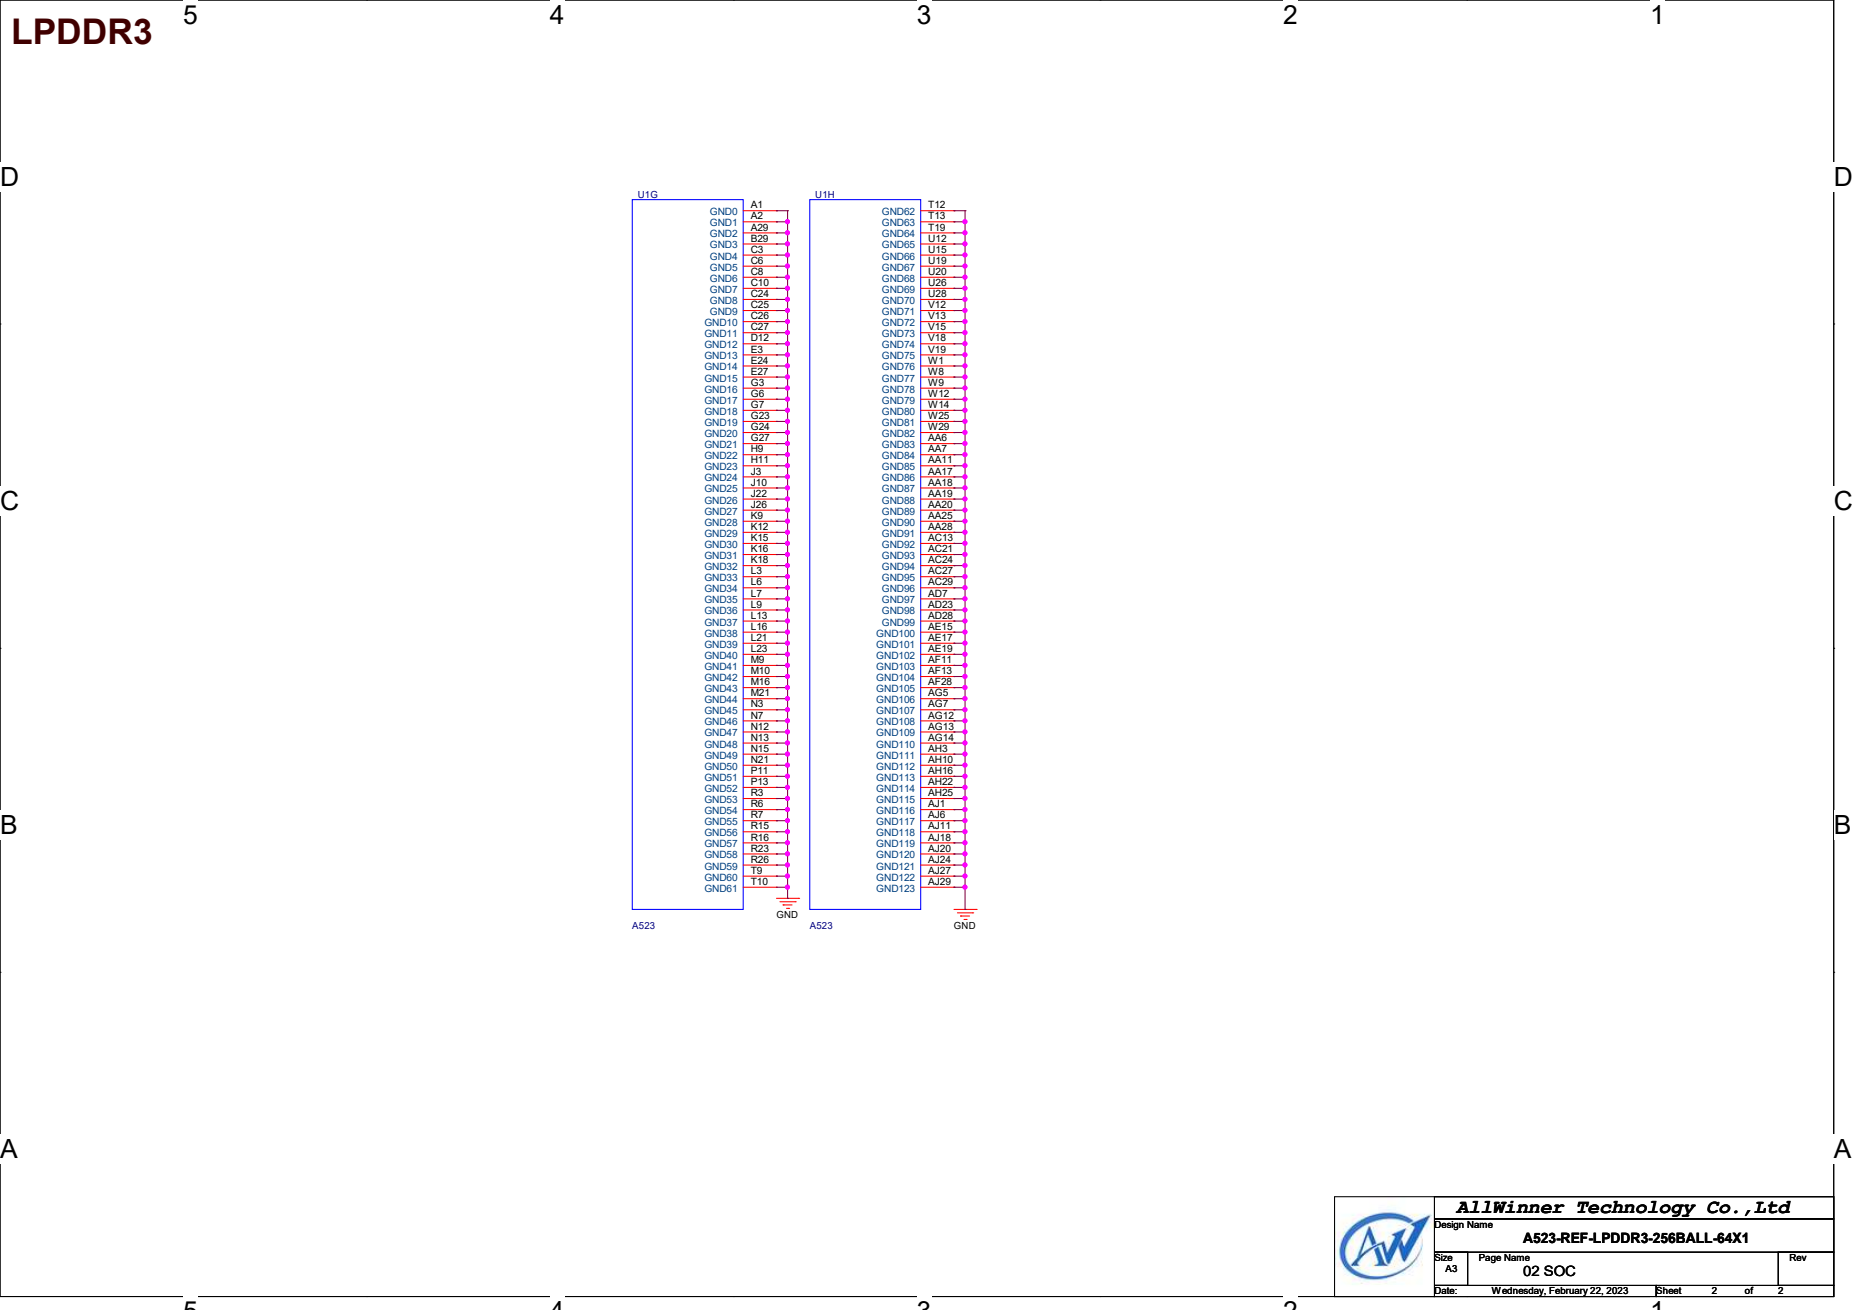
[picture p416: page 2]

AllWinner Technology Co.,Ltd
