o7-machinehum/Blackpants/docs/a523/A523_hwref/PCB参考/硬件DDR模板&叠层文件/A523-REF-DDR4-16X2-S4L-V1-0/A523-REF-DDR4-16X2-S4L-V1-0-20221107.pdf

5

4

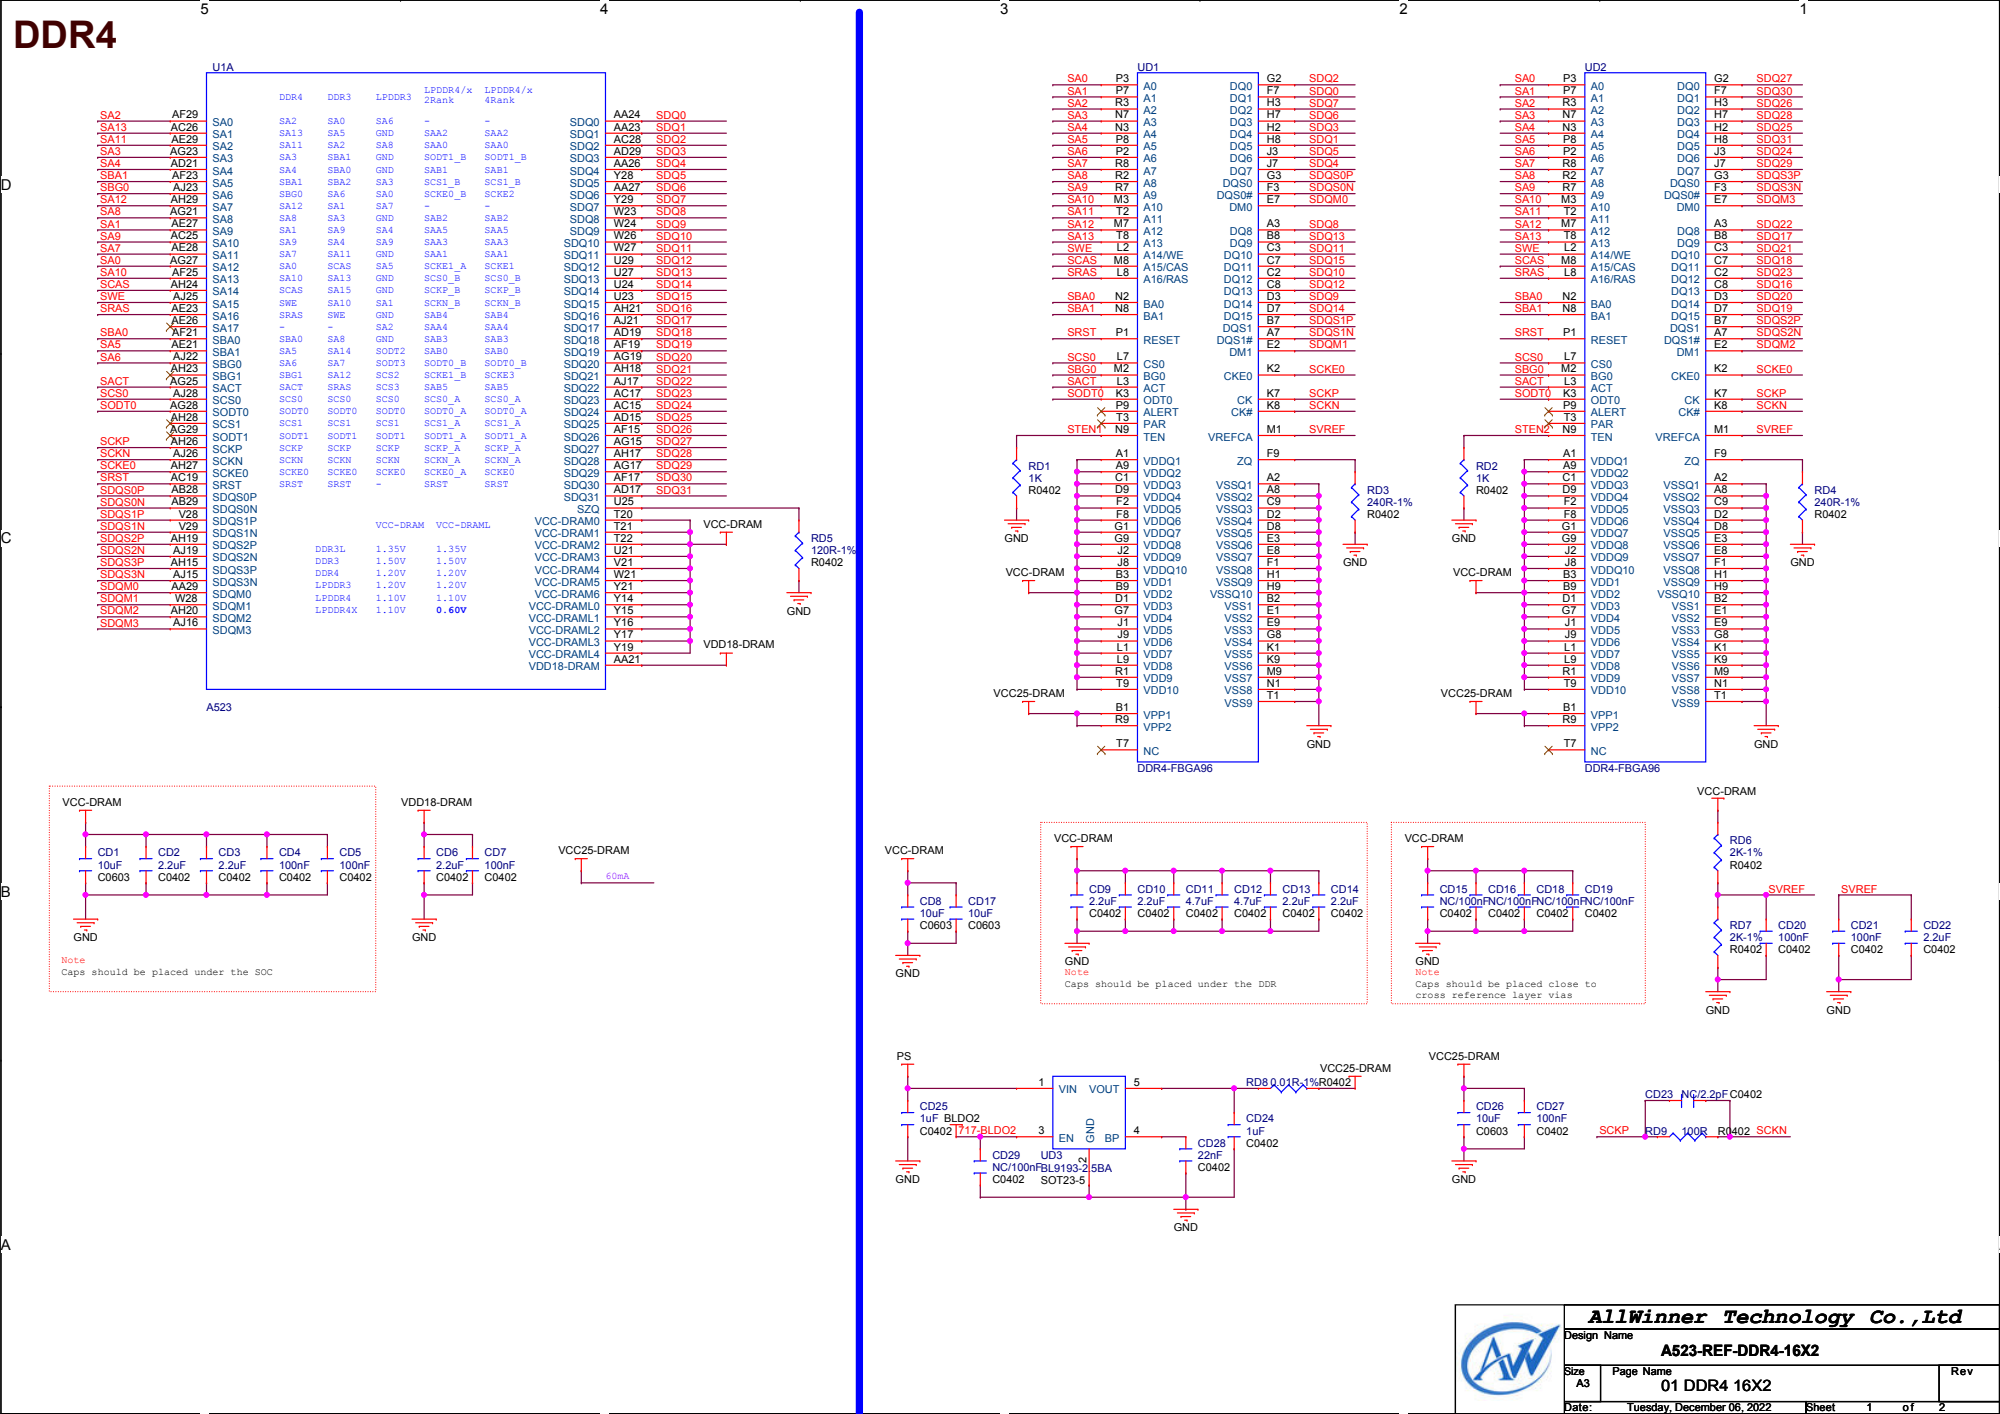
[picture p419: page 1]

GND
Note
Caps should be placed under the DDR

Caps should be placed close to
cross reference layer vias

AllWinner Technology Co.,Ltd

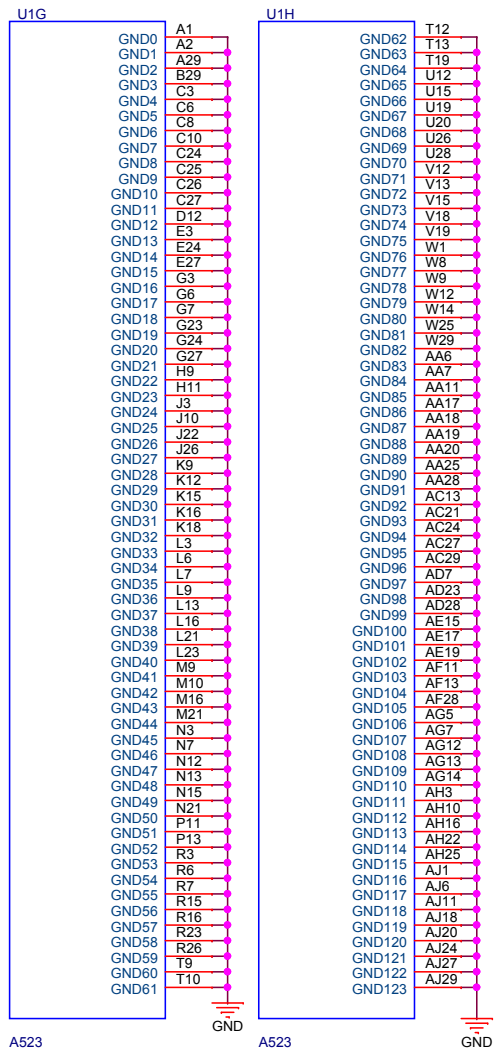
[picture p420: page 2]

AllWinner Technology Co.,Ltd
