o7-machinehum/Blackpants/(list of files, drawings)

Other design files:
docs/a523/A523_hwref/PCB参考/硬件DDR模板&叠层文件/A523-REF-DDR4-16X2-S4L-V1-0/A523-REF-DDR4-16X2-S4L-V1-0-20221107.DSN
docs/a523/A523_hwref/PCB参考/硬件DDR模板&叠层文件/A523-REF-DDR4-16X2-S4L-V1-0/A523-REF-DDR4-16X2-S4L-V1-0_pads.pcb
docs/a523/A523_hwref/PCB参考/硬件DDR模板&叠层文件/A523-REF-DDR4-16X2-S4L-V2-0/A523-REF-DDR4-16X2-S4L-V2-0-20221107.DSN
docs/a523/A523_hwref/PCB参考/硬件DDR模板&叠层文件/A523-REF-DDR4-16X2-S4L-V2-0/A523-REF-DDR4-16X2-S4L-V2-0_pads.pcb
docs/a523/A523_hwref/PCB参考/硬件DDR模板&叠层文件/A523-REF-LPDDR4-4X-32X1-S6L-V1-0(C0201)/A523-REF-LPDDR4-4X-32X1-S6L-V1-0-20221014.DSN
docs/a523/A523_hwref/PCB参考/硬件DDR模板&叠层文件/A523-REF-LPDDR4-4X-32X1-S6L-V1-0(C0201)/A523-REF-LPDDR4-4X-32X1-S6L-V1-0.pcb
docs/a523/A523_hwref/PCB参考/硬件DDR模板&叠层文件/A523-REF-LPDDR4-4X-32X1-S6L-V2-0(C0402)/A523-REF-LPDDR4-4X-32X1-S6L-V2-0-20221014.DSN
docs/a523/A523_hwref/PCB参考/硬件DDR模板&叠层文件/A523-REF-LPDDR4-4X-32X1-S6L-V2-0(C0402)/A523-REF-LPDDR4-4X-32X1-S6L-V2-0_pads.pcb
docs/a523/A523_hwref/PCB参考/硬件DDR模板&叠层文件/A523-REF-LPDDR4-4X-32X1-S8L-V1-0/A523-REF-LPDDR4-4X-32X1-S8L-V1-0-20221014.DSN
docs/a523/A523_hwref/PCB参考/硬件DDR模板&叠层文件/A523-REF-LPDDR4-342BALL-S6L-V2-0/A523_REF_LPDDR4_FBGA342BALL_64X1_S6L_V2_0.DSN
docs/a523/A523_hwref/PCB参考/硬件DDR模板&叠层文件/A523_REF_LPDDR3_256ball_64X1_4L_V1_0(C0201)/A523_REF_LPDDR3_256ball_64X1_V1_0-C0201_20230222.DSN
docs/a523/A523_hwref/PCB参考/硬件DDR模板&叠层文件/A523_REF_LPDDR3_256BALL_64X1_4L_V1_0(C0402)/A523_REF_LPDDR3_256BALL_64X1_V1_0_20230217.DSN
docs/a523/A523_hwref/PCB参考/硬件DDR模板&叠层文件/A523_REF_LPDDR3_256ball_64X1_6L_V3_1-C0201/A523_REF_LPDDR3_256BALL_64X1_V3_1_0201-20230717.DSN
docs/a523/A523_hwref/PCB参考/硬件DDR模板&叠层文件/A523_REF_LPDDR3_256ball_64X1_8L_V1_0-C0201/A523_REF_LPDDR3_256ball_64X1_8L_V1_0-C0201_0616_1632_pads.pcb
docs/a523/A523_hwref/PCB参考/硬件DDR模板&叠层文件/A523_REF_LPDDR3_256ball_64X1_8L_V1_0-C0201/A523_REF_LPDDR3_256BALL_64X1_8L_V1_0_0201-20230426.DSN
docs/a523/A523_hwref/PCB参考/硬件DDR模板&叠层文件/A523_REF_LPDDR3_256BALL_64X1_V3_0_0201/A523_REF_LPDDR3_256BALL_64X1_V3_0_0201-20230717.DSN
docs/a523/A523_hwref/原理图/开发板资料/开发板原理图/A523-EVB-AXP717C-LPDDR4-4X-32X1-V1-0-20221115.DSN
docs/a523/A523_hwref/原理图/标案原理图/A523_STD_AXP717C_AXP323_LPDDR4_4X_32X1_V2-4_240712.DSN
