o7-machinehum/Blackpants/ee/integrated/blackpants.kicad_pcb

## KiCad design ee/integrated/blackpants.kicad_pcb (2026-09-17)

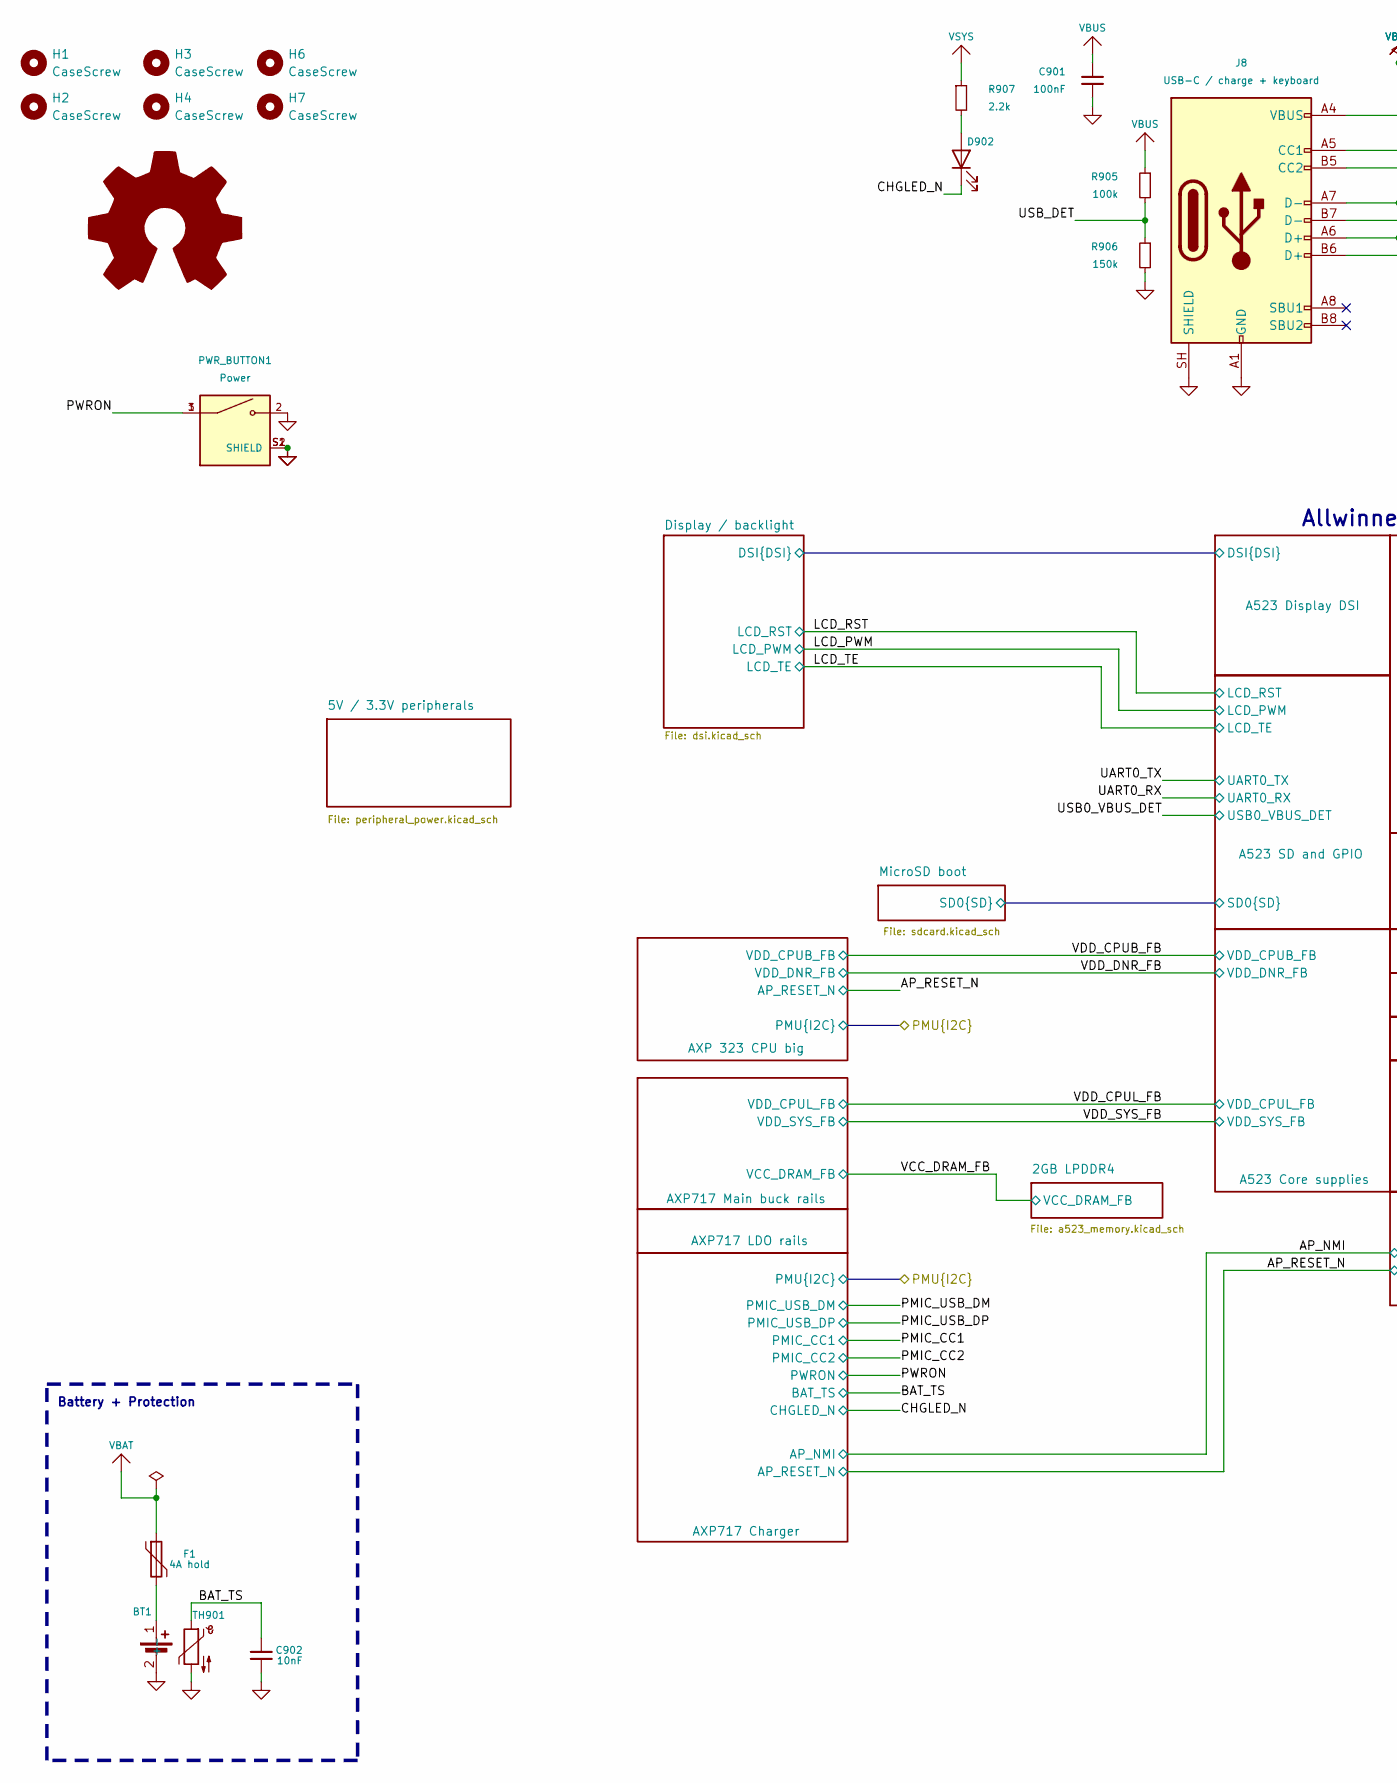
[picture p421: schematic blackpants.kicad_sch, part in row 1, column 1]

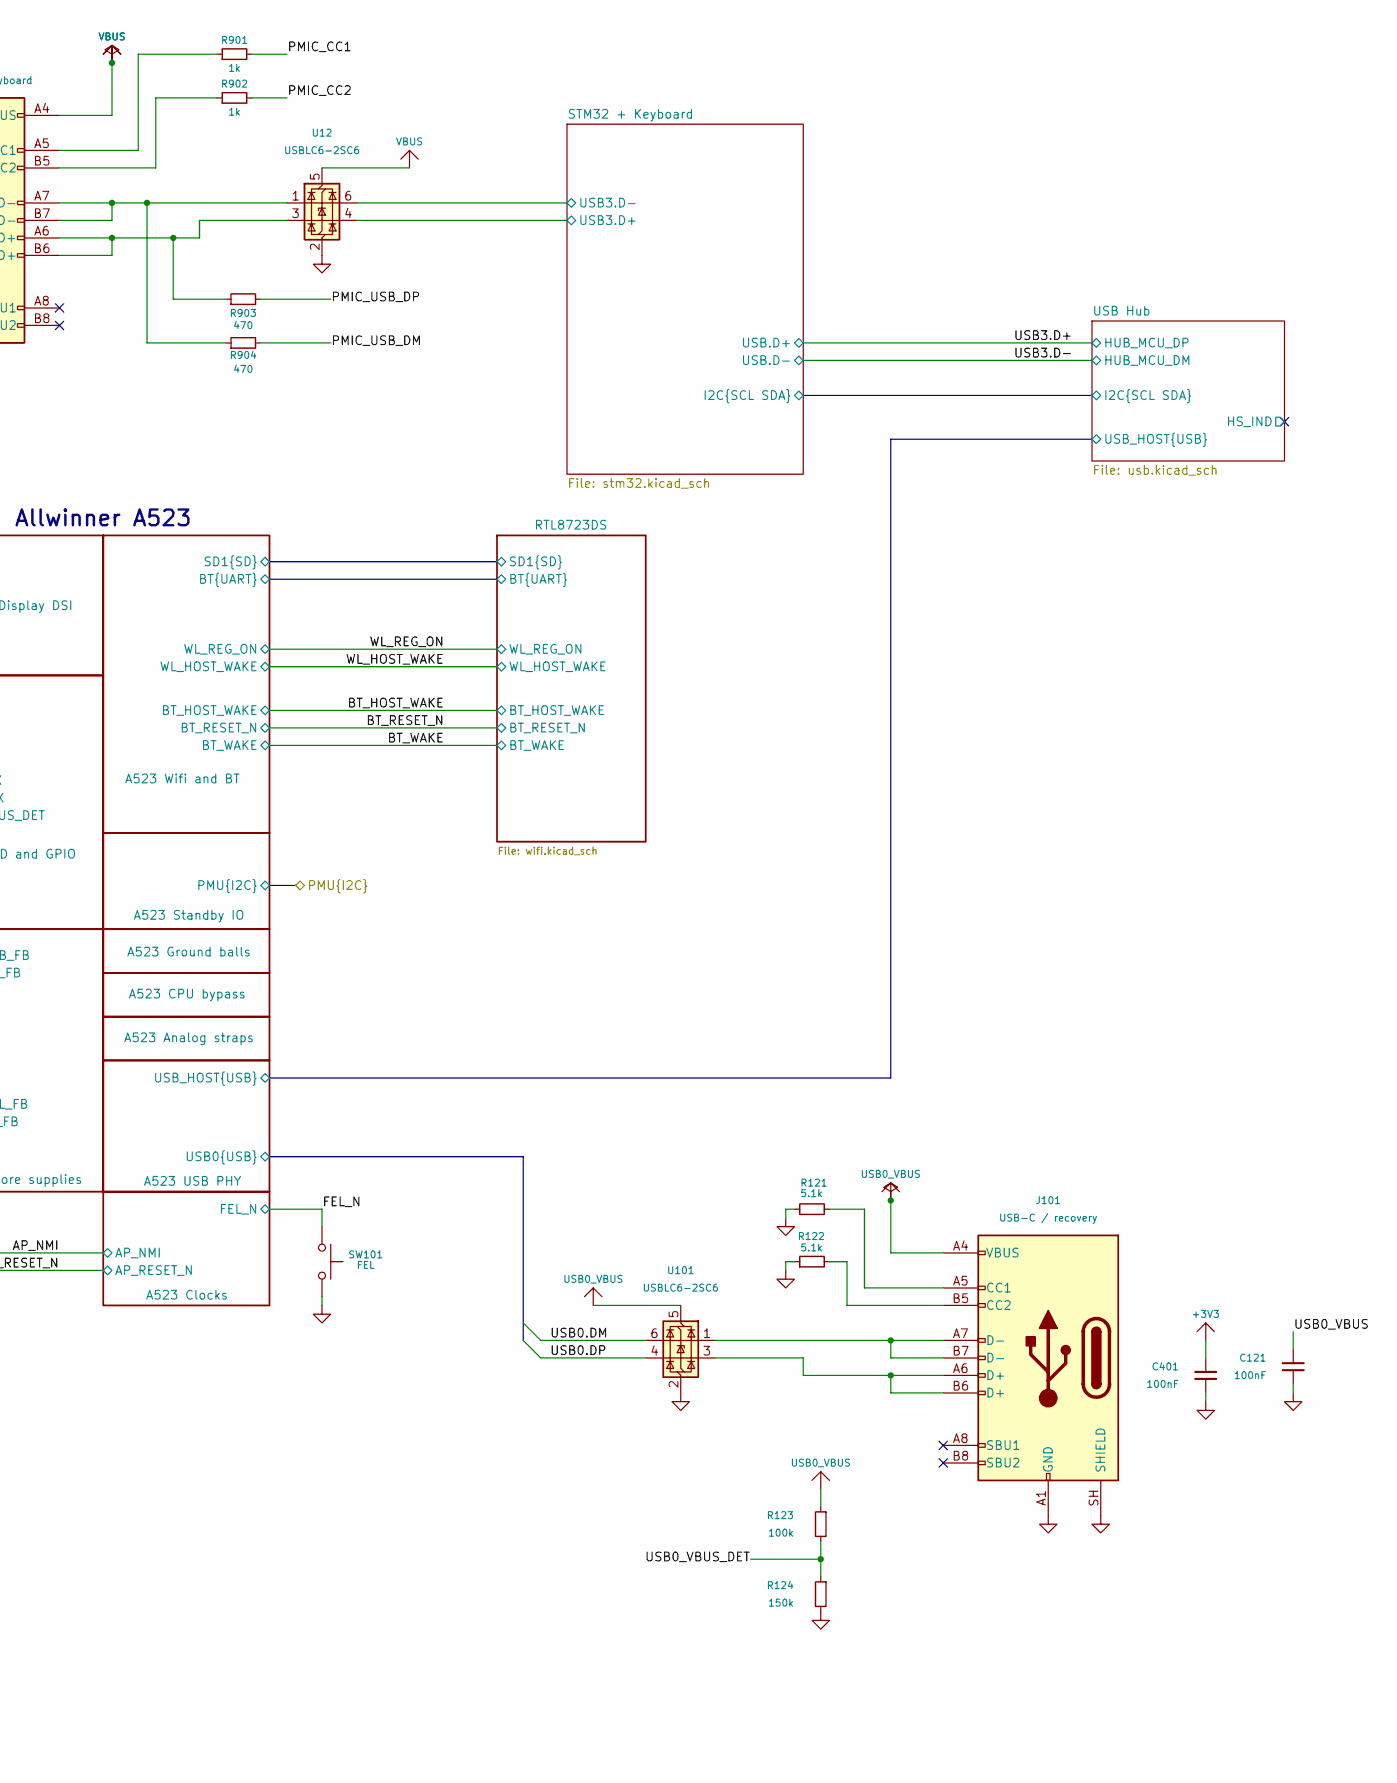
[picture p422: schematic blackpants.kicad_sch, part in row 1, column 2]

Parts:
BT1: Protected 18650 / 1S Li-ion; BH-18650-B1BA002
C121, C401, C901: 100nF; C_0402_1005Metric; Voltage 10V
C902: 10nF; C_0402_1005Metric; Voltage 10V
D902: Charge status; LED_0603_1608Metric
F1: 4A hold; Fuse_1812_4532Metric
H1, H2, H3, H4, H6, H7: CaseScrew; MountingHole_2.7mm_Pad
J8: USB-C / charge + keyboard; USB_C_Receptacle_HRO_TYPE-C-31-M-12
J101: USB-C / recovery; USB_C_Receptacle_GCT_USB4105-xx-A_16P_TopMnt_Horizontal
PWR_BUTTON1: Power; SW_PTS847MM160LSMTR2_LFS; PARTREV B
R121, R122: 5.1k; R_0402_1005Metric
R123, R905: 100k; R_0402_1005Metric
R124, R906: 150k; R_0402_1005Metric
R901, R902: 1k; R_0402_1005Metric
R903, R904: 470; R_0402_1005Metric
R907: 2.2k; R_0402_1005Metric
S1: Logo_Open_Hardware_Large; OSHW-Logo2_24.3x20mm_SilkScreen
SW101: FEL; SW_SPST_TL3342
TH901: 10k @25C / cell-attached NTC; SolderWire-0.5sqmm_1x02_P4.6mm_D0.9mm_OD2.1mm
U12, U101: USBLC6-2SC6; SOT-23-6

Connections:
+3V3: C401.1; also elsewhere on the board
/A523 USB PHY/USB0.DM: U101.6 (I/O1); also elsewhere on the board
/A523 USB PHY/USB0.DP: U101.4 (I/O2); also elsewhere on the board
/BAT_TS: C902.1, TH901.1; also elsewhere on the board
/CHGLED_N: D902.1 (K); also elsewhere on the board
/FEL_N: SW101.1; also elsewhere on the board
/PMIC_CC1: R901.2; also elsewhere on the board
/PMIC_CC2: R902.2; also elsewhere on the board
/PMIC_USB_DM: R904.2; also elsewhere on the board
/PMIC_USB_DP: R903.2; also elsewhere on the board
/PWRON: PWR_BUTTON1.1, PWR_BUTTON1.3; also elsewhere on the board
/STM32 + Keyboard/USB3.D+: U12.4 (I/O2); also elsewhere on the board
/STM32 + Keyboard/USB3.D-: U12.6 (I/O1); also elsewhere on the board
/USB0_VBUS_DET: R123.2, R124.1; also elsewhere on the board
/USB_DET: R905.2, R906.1
GND: BT1.2 (-), C121.2, C401.2, C901.2, C902.2, J8.A1 (GND), J8.A12 (GND), J8.B1 (GND), J8.B12 (GND), J8.SH (SHIELD), J101.A1 (GND), J101.A12 (GND), J101.B1 (GND), J101.B12 (GND), J101.SH (SHIELD), PWR_BUTTON1.2, PWR_BUTTON1.S1 (SHIELD), PWR_BUTTON1.S2 (SHIELD), R121.1, R122.1, R124.2, R906.2, SW101.2, TH901.2, U12.2 (GND), U101.2 (GND); also elsewhere on the board
unnamed: BT1.1 (+), F1.2
unnamed: D902.2 (A), R907.2
unnamed: J8.A5 (CC1), R901.1
unnamed: J8.B5 (CC2), R902.1
unnamed: J8.A6 (D+), J8.B6 (D+), R903.1, U12.3 (I/O2)
unnamed: J8.A7 (D-), J8.B7 (D-), R904.1, U12.1 (I/O1)
unnamed: J101.A5 (CC1), R121.2
unnamed: J101.B5 (CC2), R122.2
unnamed: J101.A6 (D+), J101.B6 (D+), U101.3 (I/O2)
unnamed: J101.A7 (D-), J101.B7 (D-), U101.1 (I/O1)
USB0_VBUS: C121.1, J101.A4 (VBUS), J101.A9 (VBUS), J101.B4 (VBUS), J101.B9 (VBUS), R123.1, U101.5 (VBUS)
VBAT: F1.1; also elsewhere on the board
VBUS: C901.1, J8.A4 (VBUS), J8.A9 (VBUS), J8.B4 (VBUS), J8.B9 (VBUS), R905.1, U12.5 (VBUS); also elsewhere on the board
VSYS: R907.1; also elsewhere on the board

Notes on the sheet:
Battery + Protection
Allwinner A523

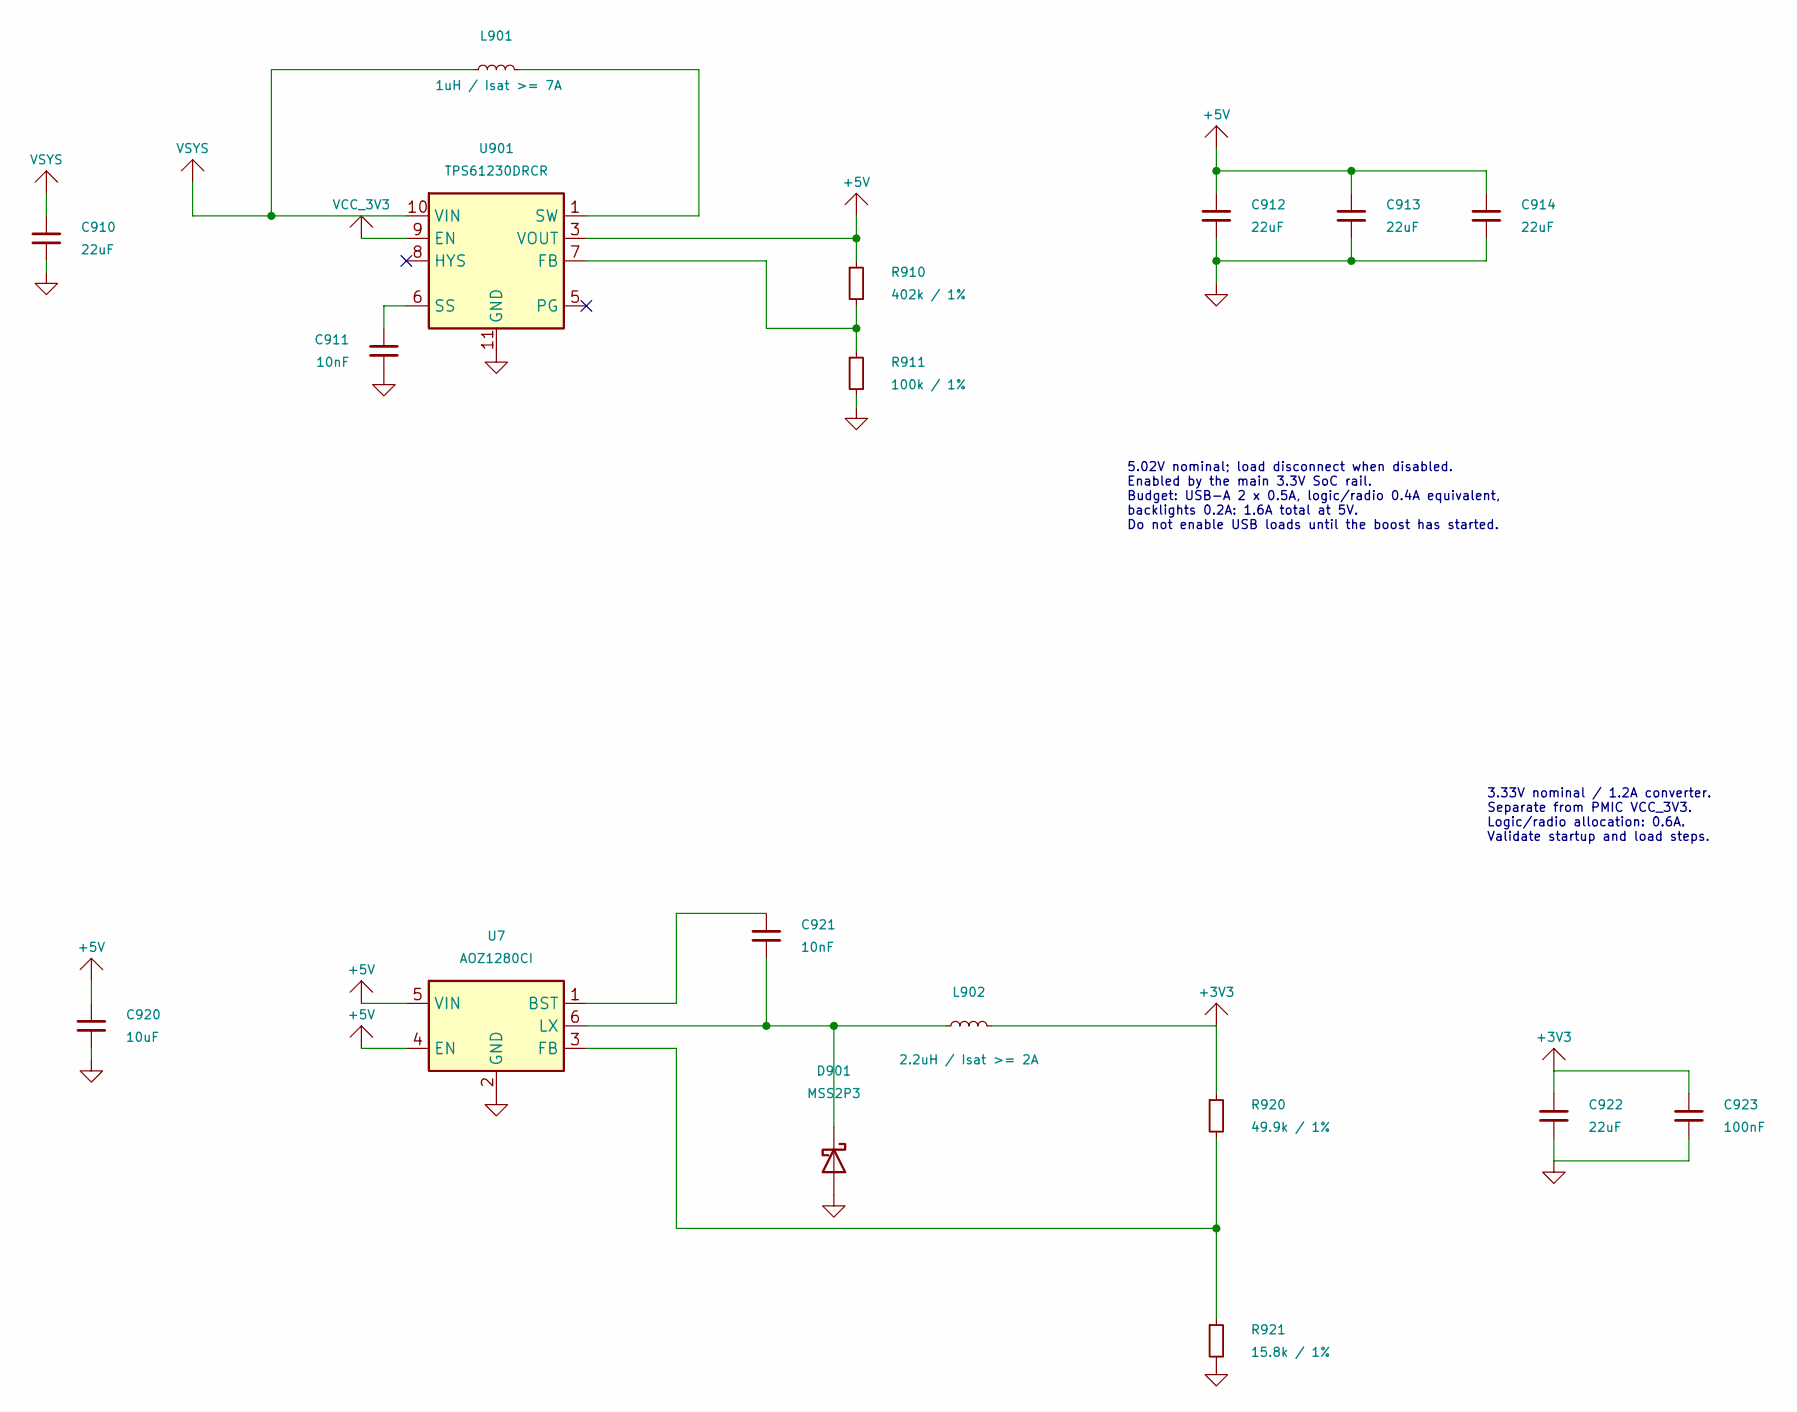
[picture p423: schematic peripheral_power.kicad_sch, Peripheral 5V boost and 3.3V regulator]

Parts:
C910, C912, C913, C914: 22uF; C_0805_2012Metric; Voltage 10V
C911, C921: 10nF; C_0402_1005Metric; Voltage 10V
C920: 10uF; C_0603_1608Metric; Voltage 10V
C922: 22uF; C_0603_1608Metric; Voltage 10V
C923: 100nF; C_0402_1005Metric; Voltage 10V
D901: MSS2P3; D_MicroSMP_LargeCathode
L901: 1uH / Isat >= 7A; L_Coilcraft_XAL4020-XXX; MPN XAL4020-102MEB
L902: 2.2uH / Isat >= 2A; L_Coilcraft_XAL4020-XXX
R910: 402k / 1%; R_0402_1005Metric
R911: 100k / 1%; R_0402_1005Metric
R920: 49.9k / 1%; R_0402_1005Metric
R921: 15.8k / 1%; R_0402_1005Metric
U7: AOZ1280CI; SOT-23-6
U901: TPS61230DRCR; Texas_S-PVSON-N10_ThermalVias

Connections:
+3V3: C922.1, C923.1, L902.2, R920.1; also elsewhere on the board
+5V: C912.1, C913.1, C914.1, C920.1, R910.1, U7.4 (EN), U7.5 (VIN), U901.3 (VOUT), U901.4 (VOUT); also elsewhere on the board
GND: C910.2, C911.2, C912.2, C913.2, C914.2, C920.2, C922.2, C923.2, D901.2 (A), R911.2, R921.2, U7.2 (GND), U901.11 (GND); also elsewhere on the board
unnamed: C921.2, D901.1 (K), L902.1, U7.6 (LX)
unnamed: L901.2, U901.1 (SW), U901.2 (SW)
unnamed: C921.1, U7.1 (BST)
unnamed: R920.2, R921.1, U7.3 (FB)
unnamed: R910.2, R911.1, U901.7 (FB)
unnamed: C911.1, U901.6 (SS)
VCC_3V3: U901.9 (EN); also elsewhere on the board
VSYS: C910.1, L901.1, U901.10 (VIN); also elsewhere on the board

Notes on the sheet:
3.33V nominal / 1.2A converter. Separate from PMIC VCC_3V3. Logic/radio allocation: 0.6A. Validate startup and load steps.
5.02V nominal; load disconnect when disabled. Enabled by the main 3.3V SoC rail. Budget: USB-A 2 x 0.5A, logic/radio 0.4A equivalent, backlights 0.2A: 1.6A total at 5V. Do not enable USB loads until the boost has started.

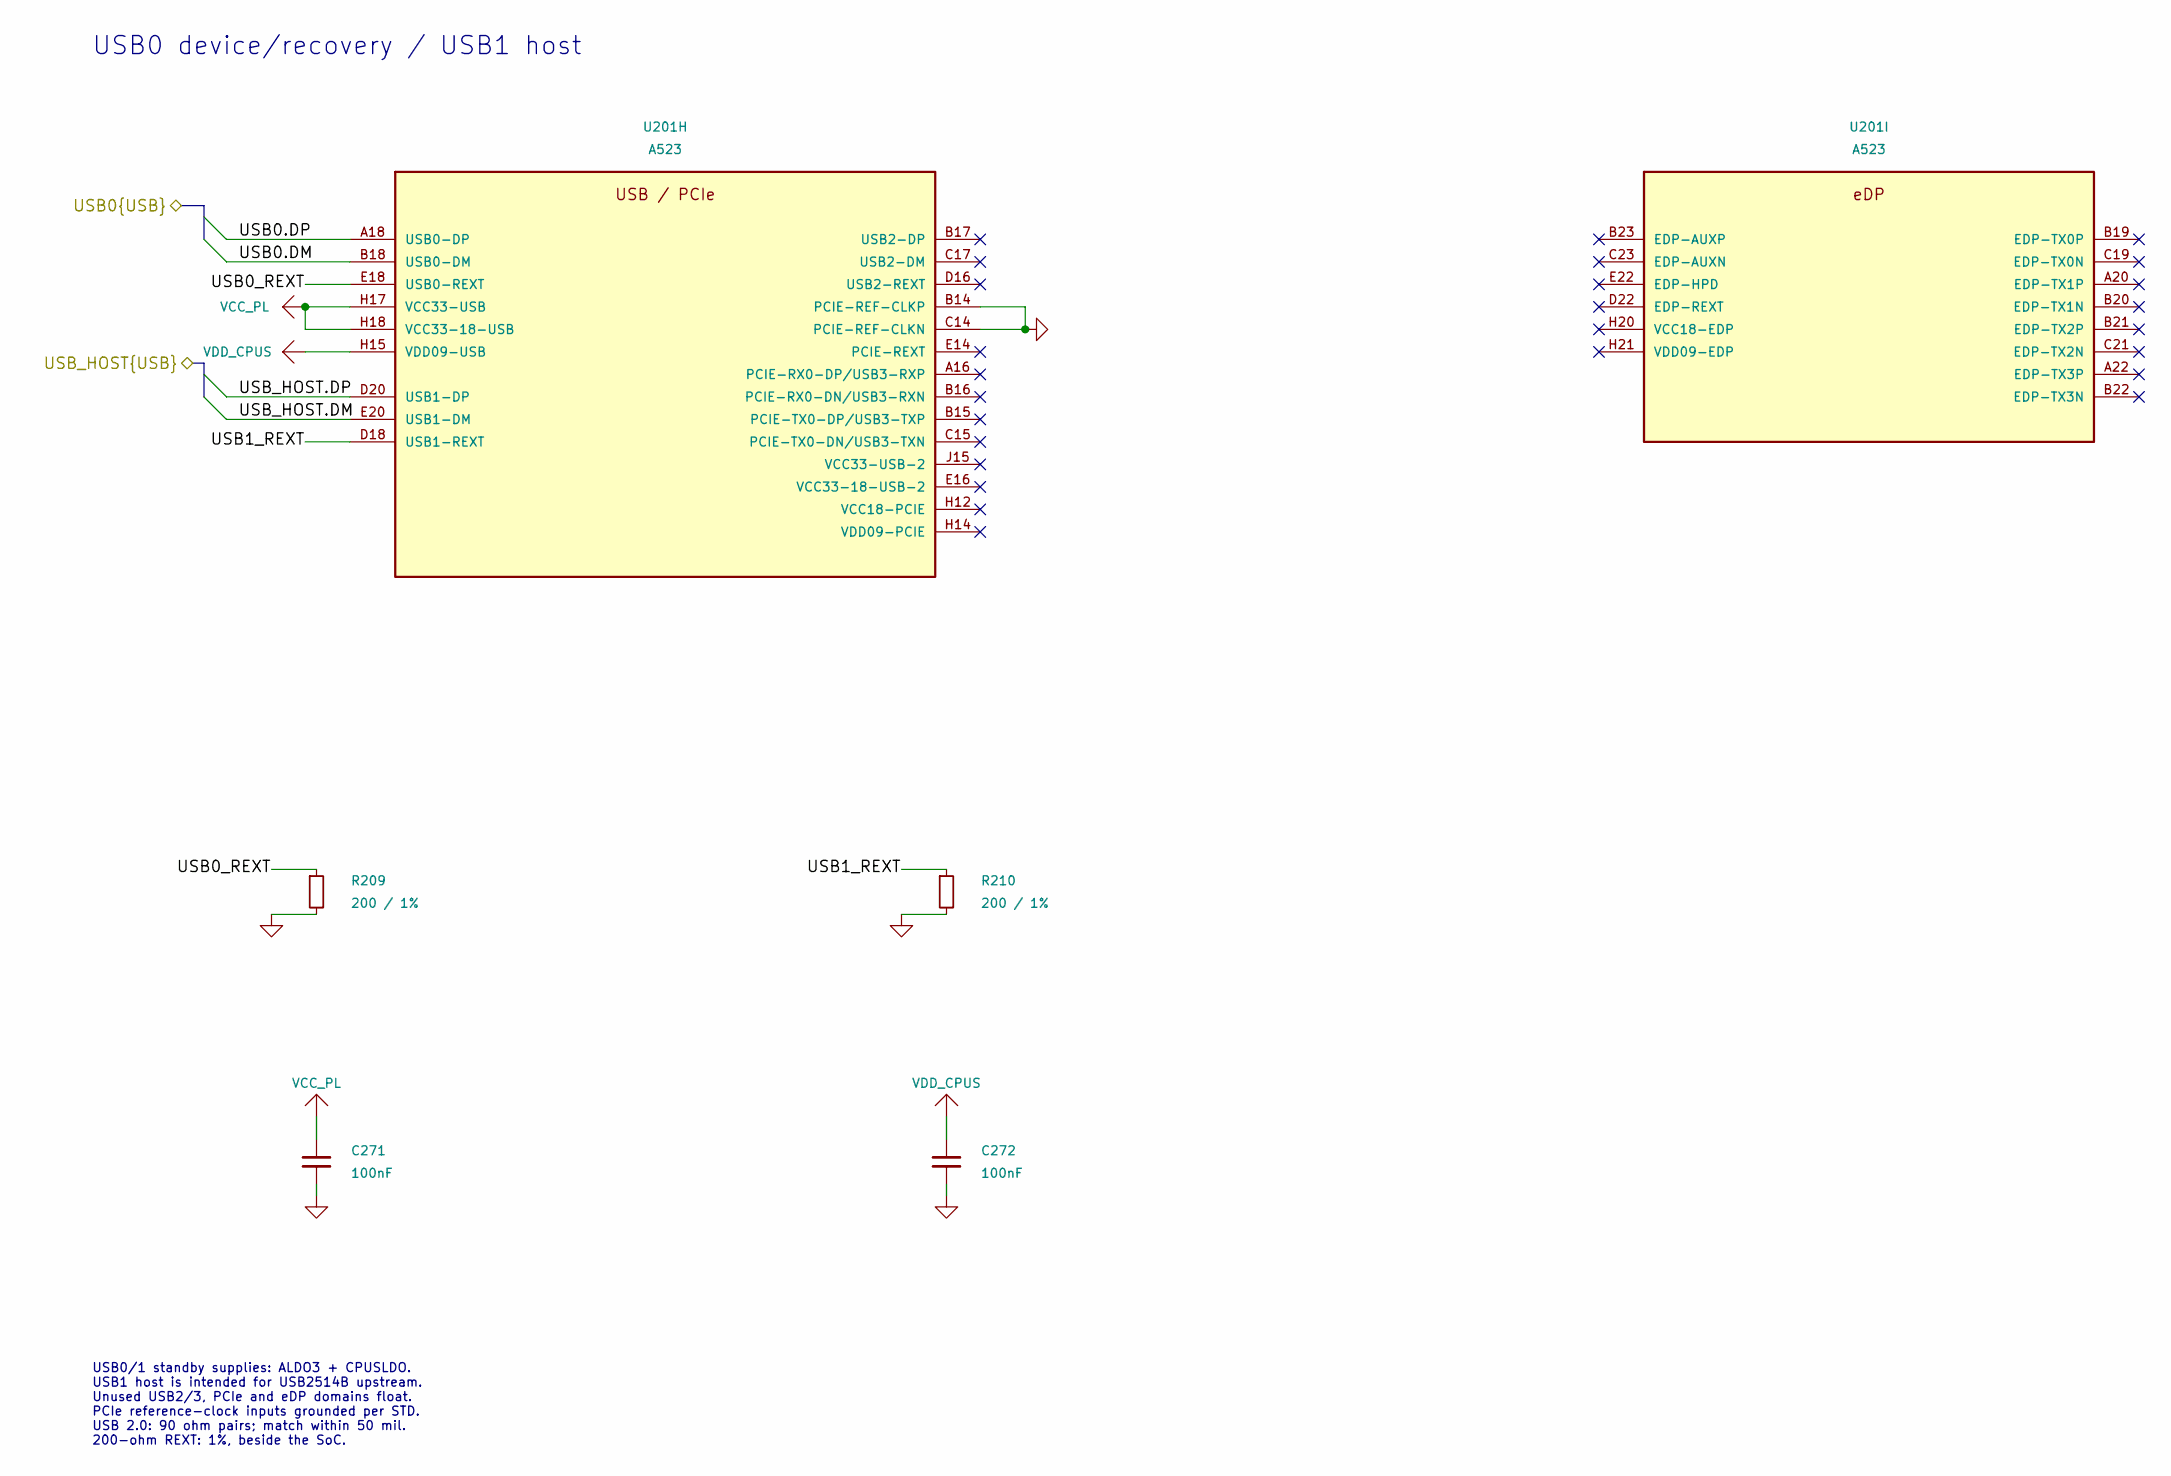
[picture p424: schematic a523_usb.kicad_sch, A523 - USB PHY and unused PCIe / eDP]

Parts:
C271, C272: 100nF; C_0201_0603Metric; Voltage 10V
R209, R210: 200 / 1%; R_0402_1005Metric
U201: A523; Allwinner_A523_FCCSP-522_15x15mm_P0.5mm

Connections:
/A523 USB PHY/USB0.DM: U201.B18 (USB0-DM); also elsewhere on the board
/A523 USB PHY/USB0.DP: U201.A18 (USB0-DP); also elsewhere on the board
/A523 USB PHY/USB0_REXT: R209.1, U201.E18 (USB0-REXT)
/A523 USB PHY/USB1_REXT: R210.1, U201.D18 (USB1-REXT)
/A523 USB PHY/USB_HOST.DM: U201.E20 (USB1-DM); also elsewhere on the board
/A523 USB PHY/USB_HOST.DP: U201.D20 (USB1-DP); also elsewhere on the board
GND: C271.2, C272.2, R209.2, R210.2, U201.B14 (PCIE-REF-CLKP), U201.C14 (PCIE-REF-CLKN); also elsewhere on the board
VCC_PL: C271.1, U201.H17 (VCC33-USB), U201.H18 (VCC33-18-USB); also elsewhere on the board
VDD_CPUS: C272.1, U201.H15 (VDD09-USB); also elsewhere on the board

Notes on the sheet:
USB0 device/recovery / USB1 host
USB0/1 standby supplies: ALDO3 + CPUSLDO. USB1 host is intended for USB2514B upstream. Unused USB2/3, PCIe and eDP domains float. PCIe reference-clock inputs grounded per STD. USB 2.0: 90 ohm pairs; match within 50 mil. 200-ohm REXT: 1%, beside the SoC.

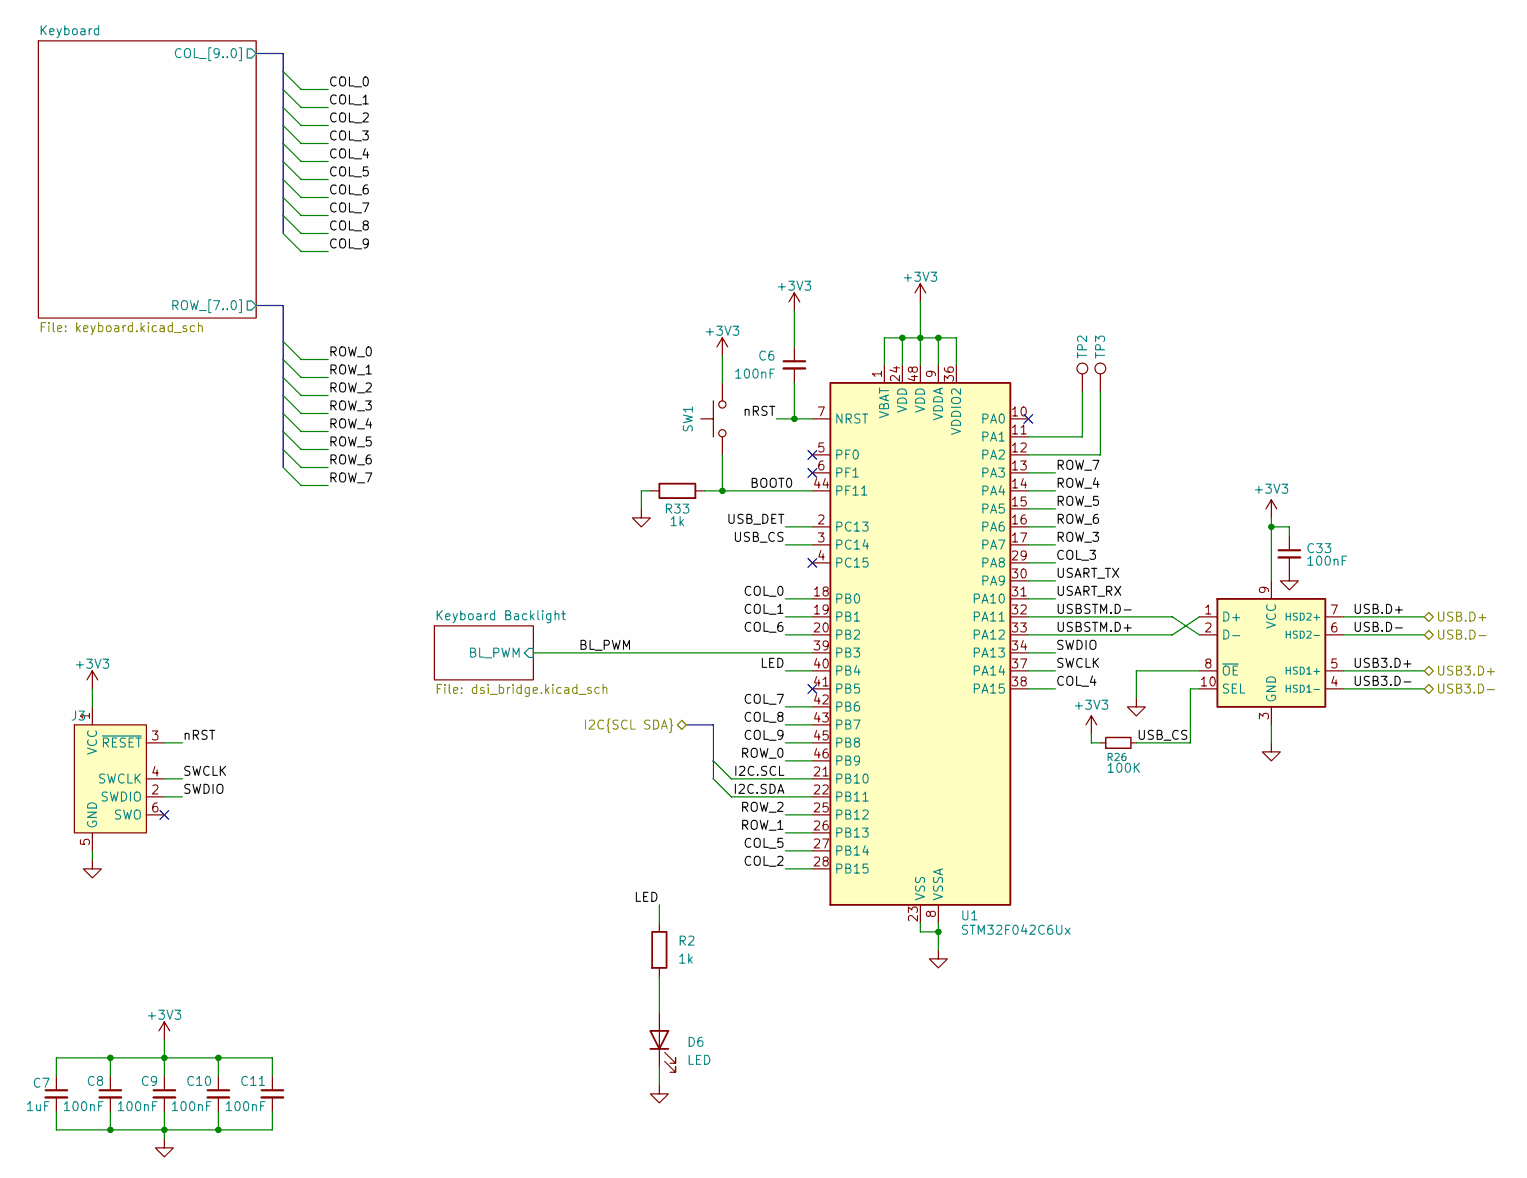
[picture p425: schematic stm32.kicad_sch]

Parts:
C6, C8, C9, C10, C11, C33: 100nF; C_0402_1005Metric; MPN CL05B104KB54PNC
C7: 1uF; C_0402_1005Metric; MPN CL05B105KQ5NQNC
D6: LED; LED_0603_1608Metric; MPN KT-0603R
J3: Conn_ARM_SWD_TagConnect_TC2030-NL; Tag-Connect_TC2030-IDC-NL_2x03_P1.27mm_Vertical
R2, R33: 1k; R_0402_1005Metric; MPN 0402WGF1001TCE
R26: 100K; R_0402_1005Metric; MPN RC0402FR-13100KL
SW1: SW_Push; SW_Push_1P1T_NO_CK_KSC7xxJ; MPN KSC741JLFS
TP2, TP3: TestPoint; TestPoint_Pad_1.0x1.0mm
U1: STM32F042C6Ux; QFN-48-1EP_7x7mm_P0.5mm_EP5.6x5.6mm; MPN STM32F042C6U6
U11: TPSGM7227YUWQ10G; UQFN-10_1.4x1.8mm_P0.4mm; MPN TPSGM7227YUWQ10G

Connections:
+3V3: C6.1, C7.1, C8.1, C9.1, C10.1, C11.1, C33.1, J3.1 (VCC), R26.1, SW1.2, U1.1 (VBAT), U1.9 (VDDA), U1.24 (VDD), U1.36 (VDDIO2), U1.48 (VDD), U11.9 (VCC); also elsewhere on the board
/STM32 + Keyboard/BL_PWM: U1.39 (PB3); also elsewhere on the board
/STM32 + Keyboard/BOOT0: R33.2, SW1.1, U1.44 (PF11)
/STM32 + Keyboard/I2C.SCL: U1.21 (PB10); also elsewhere on the board
/STM32 + Keyboard/I2C.SDA: U1.22 (PB11); also elsewhere on the board
/STM32 + Keyboard/Keyboard/COL_0: U1.18 (PB0); also elsewhere on the board
/STM32 + Keyboard/Keyboard/COL_1: U1.19 (PB1); also elsewhere on the board
/STM32 + Keyboard/Keyboard/COL_2: U1.28 (PB15); also elsewhere on the board
/STM32 + Keyboard/Keyboard/COL_3: U1.29 (PA8); also elsewhere on the board
/STM32 + Keyboard/Keyboard/COL_4: U1.38 (PA15); also elsewhere on the board
/STM32 + Keyboard/Keyboard/COL_5: U1.27 (PB14); also elsewhere on the board
/STM32 + Keyboard/Keyboard/COL_6: U1.20 (PB2); also elsewhere on the board
/STM32 + Keyboard/Keyboard/COL_7: U1.42 (PB6); also elsewhere on the board
/STM32 + Keyboard/Keyboard/COL_8: U1.43 (PB7); also elsewhere on the board
/STM32 + Keyboard/Keyboard/COL_9: U1.45 (PB8); also elsewhere on the board
/STM32 + Keyboard/Keyboard/ROW_0: U1.46 (PB9); also elsewhere on the board
/STM32 + Keyboard/Keyboard/ROW_1: U1.26 (PB13); also elsewhere on the board
/STM32 + Keyboard/Keyboard/ROW_2: U1.25 (PB12); also elsewhere on the board
/STM32 + Keyboard/Keyboard/ROW_3: U1.17 (PA7); also elsewhere on the board
/STM32 + Keyboard/Keyboard/ROW_4: U1.14 (PA4); also elsewhere on the board
/STM32 + Keyboard/Keyboard/ROW_5: U1.15 (PA5); also elsewhere on the board
/STM32 + Keyboard/Keyboard/ROW_6: U1.16 (PA6); also elsewhere on the board
/STM32 + Keyboard/Keyboard/ROW_7: U1.13 (PA3); also elsewhere on the board
/STM32 + Keyboard/LED: R2.1, U1.40 (PB4)
/STM32 + Keyboard/SWCLK: J3.4 (SWCLK), U1.37 (PA14)
/STM32 + Keyboard/SWDIO: J3.2 (SWDIO), U1.34 (PA13)
/STM32 + Keyboard/USART_RX: U1.31 (PA10)
/STM32 + Keyboard/USART_TX: U1.30 (PA9)
/STM32 + Keyboard/USB3.D+: U11.5 (HSD1+); also elsewhere on the board
/STM32 + Keyboard/USB3.D-: U11.4 (HSD1-); also elsewhere on the board
/STM32 + Keyboard/USBSTM.D+: U1.33 (PA12), U11.1 (D+)
/STM32 + Keyboard/USBSTM.D-: U1.32 (PA11), U11.2 (D-)
/STM32 + Keyboard/USB_CS: R26.2, U1.3 (PC14), U11.10 (SEL)
/STM32 + Keyboard/USB_DET: U1.2 (PC13)
/STM32 + Keyboard/nRST: C6.2, J3.3 (~RESET), U1.7 (NRST)
/USB3.D+: U11.7 (HSD2+); also elsewhere on the board
/USB3.D-: U11.6 (HSD2-); also elsewhere on the board
GND: C7.2, C8.2, C9.2, C10.2, C11.2, C33.2, D6.1 (K), J3.5 (GND), R33.1, U1.8 (VSSA), U1.23 (VSS), U1.35 (VSS), U1.47 (VSS), U1.49 (VSS), U11.3 (GND), U11.8 (~OE); also elsewhere on the board
unnamed: D6.2 (A), R2.2
unnamed: TP2.1 (1_1), U1.11 (PA1)
unnamed: TP3.1 (1_1), U1.12 (PA2)

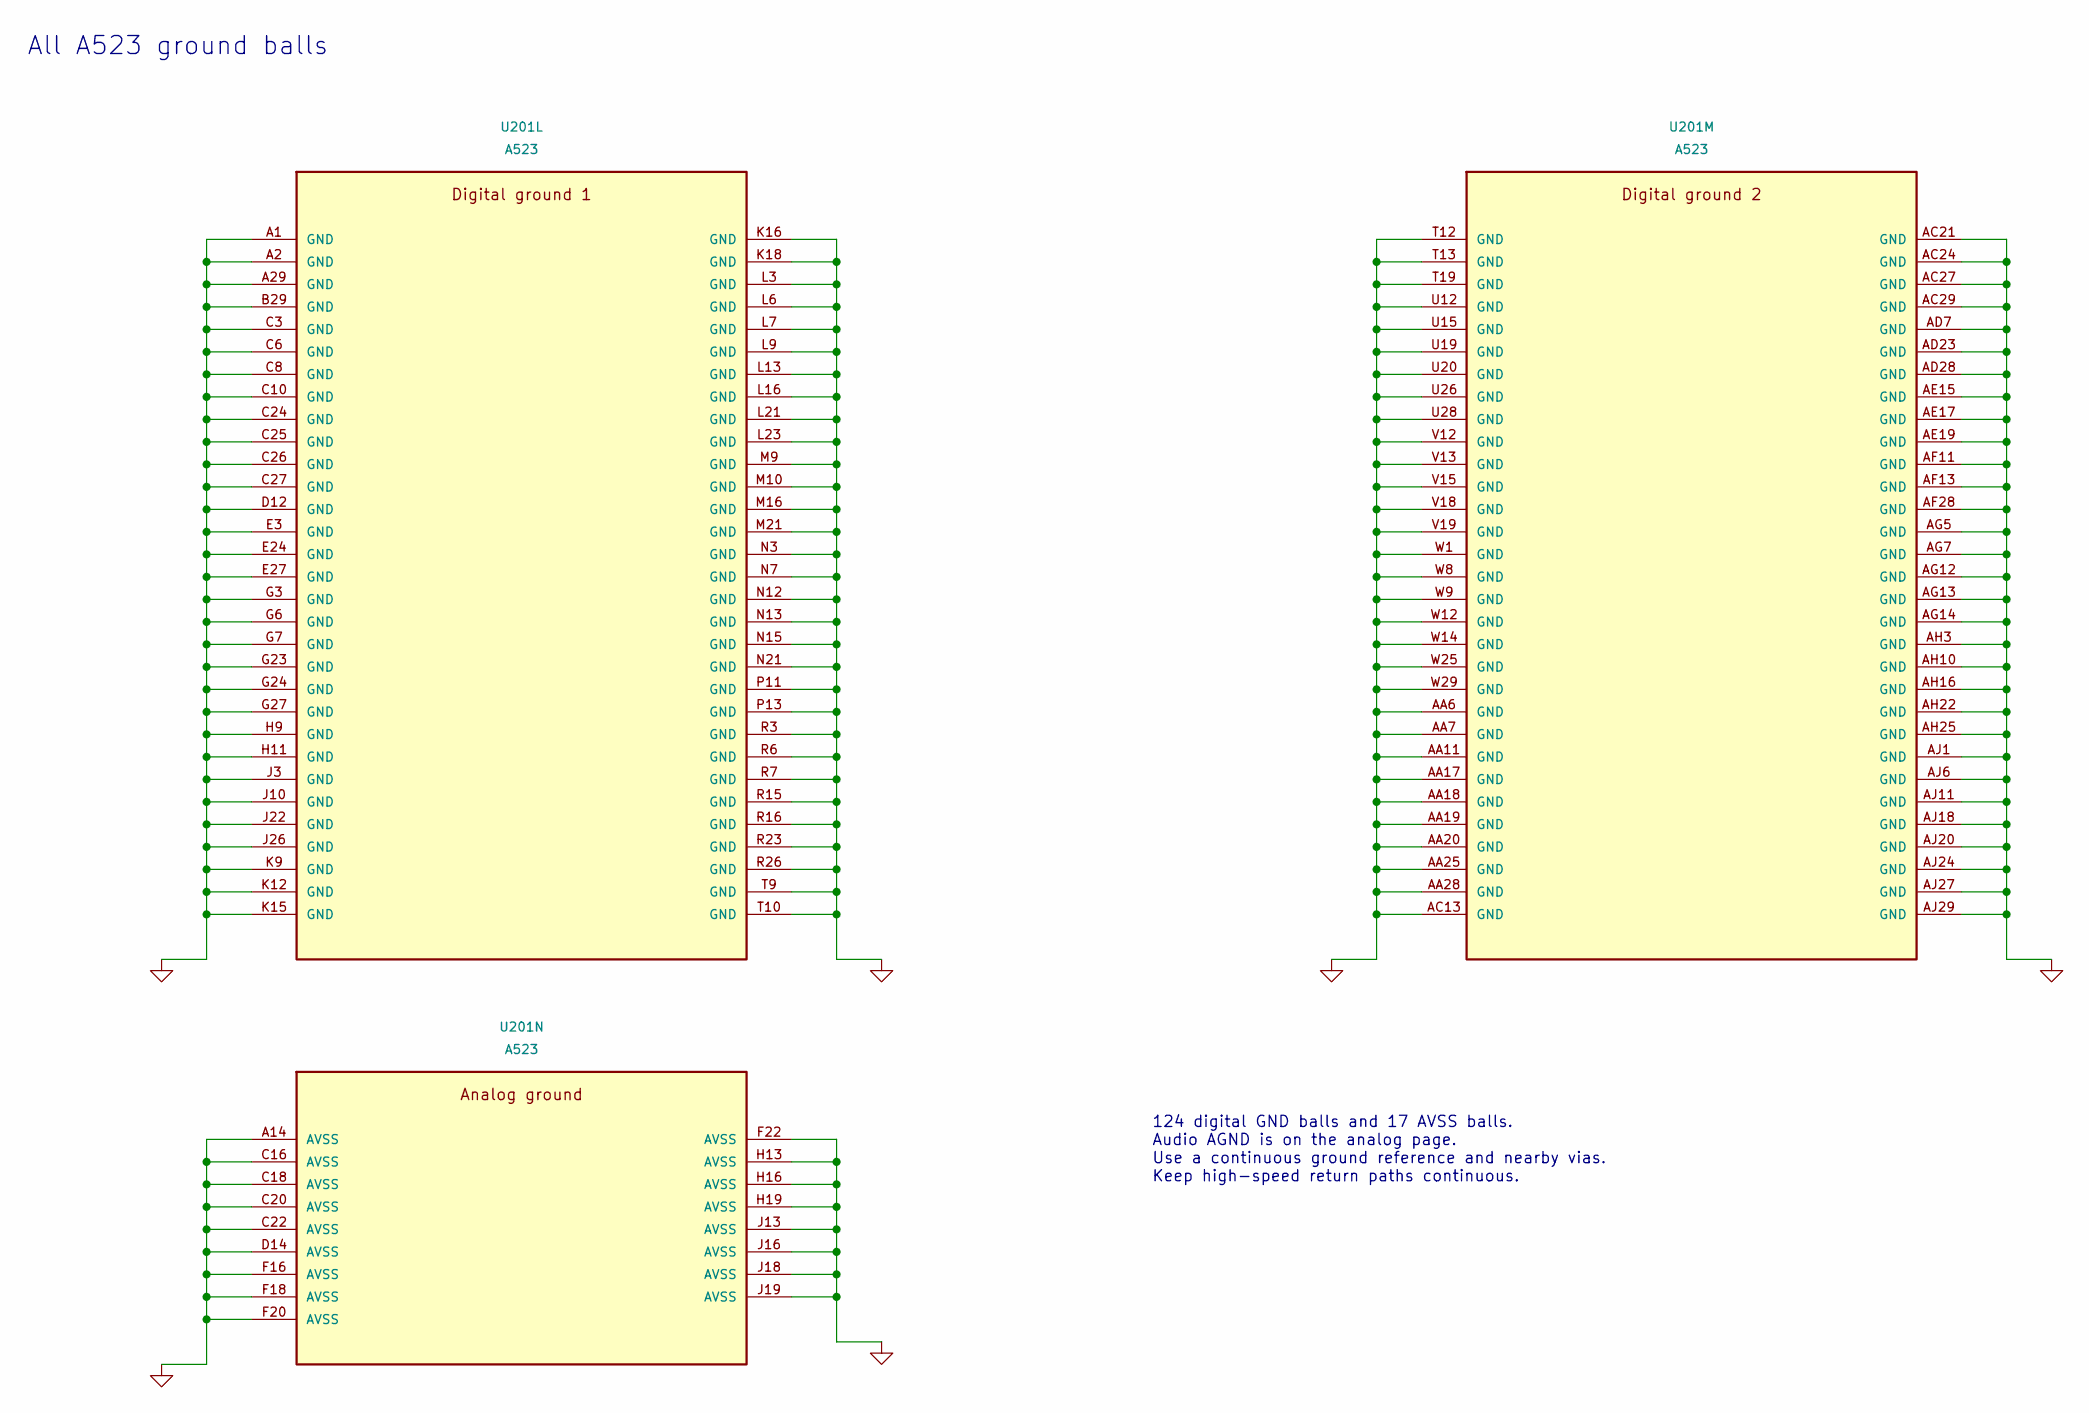
[picture p426: schematic a523_ground.kicad_sch, A523 - digital and analog ground balls]

Parts:
U201: A523; Allwinner_A523_FCCSP-522_15x15mm_P0.5mm

Connections:
GND: U201.A1 (GND), U201.A2 (GND), U201.A14 (AVSS), U201.A29 (GND), U201.AA6 (GND), U201.AA7 (GND), U201.AA11 (GND), U201.AA17 (GND), U201.AA18 (GND), U201.AA19 (GND), U201.AA20 (GND), U201.AA25 (GND), U201.AA28 (GND), U201.AC13 (GND), U201.AC21 (GND), U201.AC24 (GND), U201.AC27 (GND), U201.AC29 (GND), U201.AD7 (GND), U201.AD23 (GND), U201.AD28 (GND), U201.AE15 (GND), U201.AE17 (GND), U201.AE19 (GND), U201.AF11 (GND), U201.AF13 (GND), U201.AF28 (GND), U201.AG5 (GND), U201.AG7 (GND), U201.AG12 (GND), U201.AG13 (GND), U201.AG14 (GND), U201.AH3 (GND), U201.AH10 (GND), U201.AH16 (GND), U201.AH22 (GND), U201.AH25 (GND), U201.AJ1 (GND), U201.AJ6 (GND), U201.AJ11 (GND), U201.AJ18 (GND), U201.AJ20 (GND), U201.AJ24 (GND), U201.AJ27 (GND), U201.AJ29 (GND), U201.B29 (GND), U201.C3 (GND), U201.C6 (GND), U201.C8 (GND), U201.C10 (GND), U201.C16 (AVSS), U201.C18 (AVSS), U201.C20 (AVSS), U201.C22 (AVSS), U201.C24 (GND), U201.C25 (GND), U201.C26 (GND), U201.C27 (GND), U201.D12 (GND), U201.D14 (AVSS), U201.E3 (GND), U201.E24 (GND), U201.E27 (GND), U201.F16 (AVSS), U201.F18 (AVSS), U201.F20 (AVSS), U201.F22 (AVSS), U201.G3 (GND), U201.G6 (GND), U201.G7 (GND), U201.G23 (GND), U201.G24 (GND), U201.G27 (GND), U201.H9 (GND), U201.H11 (GND), U201.H13 (AVSS), U201.H16 (AVSS), U201.H19 (AVSS), U201.J3 (GND), U201.J10 (GND), U201.J13 (AVSS), U201.J16 (AVSS), U201.J18 (AVSS), U201.J19 (AVSS), U201.J22 (GND), U201.J26 (GND), U201.K9 (GND), U201.K12 (GND), U201.K15 (GND), U201.K16 (GND), U201.K18 (GND), U201.L3 (GND), U201.L6 (GND), U201.L7 (GND), U201.L9 (GND), U201.L13 (GND), U201.L16 (GND), U201.L21 (GND), U201.L23 (GND), U201.M9 (GND), U201.M10 (GND), U201.M16 (GND), U201.M21 (GND), U201.N3 (GND), U201.N7 (GND), U201.N12 (GND), U201.N13 (GND), U201.N15 (GND), U201.N21 (GND), U201.P11 (GND), U201.P13 (GND), U201.R3 (GND), U201.R6 (GND), U201.R7 (GND), U201.R15 (GND), U201.R16 (GND), U201.R23 (GND), U201.R26 (GND), U201.T9 (GND), U201.T10 (GND), U201.T12 (GND), U201.T13 (GND), U201.T19 (GND), U201.U12 (GND), U201.U15 (GND), U201.U19 (GND), U201.U20 (GND), U201.U26 (GND), U201.U28 (GND), U201.V12 (GND), U201.V13 (GND), U201.V15 (GND), U201.V18 (GND), U201.V19 (GND), U201.W1 (GND), U201.W8 (GND), U201.W9 (GND), U201.W12 (GND), U201.W14 (GND), U201.W25 (GND), U201.W29 (GND); also elsewhere on the board

Notes on the sheet:
124 digital GND balls and 17 AVSS balls. Audio AGND is on the analog page. Use a continuous ground reference and nearby vias. Keep high-speed return paths continuous.
All A523 ground balls
