o7-machinehum/Blackpants/ee/integrated/blackpants.kicad_pcb

## KiCad design ee/integrated/blackpants.kicad_pcb (continued)

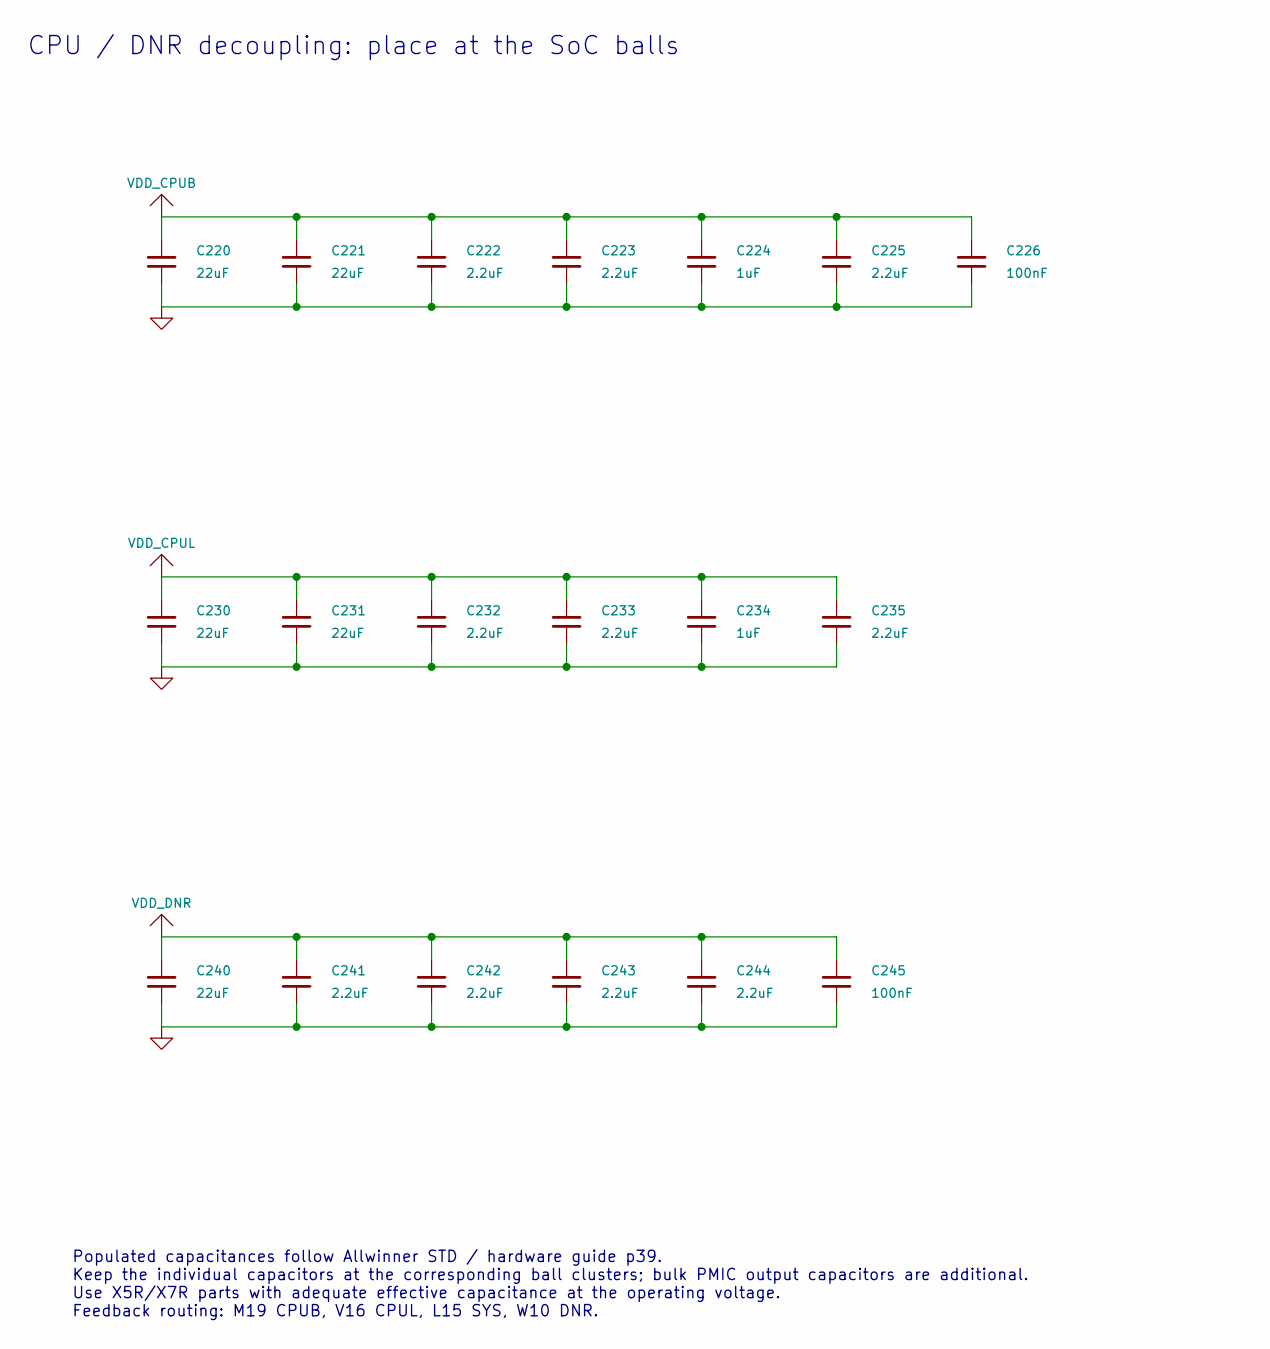
[picture p427: schematic a523_cpu_bypass.kicad_sch, A523 - CPU and DNR bypass capacitors]

Parts:
C220, C221, C230, C231, C240: 22uF; C_0402_1005Metric; Voltage 10V
C222, C223, C225, C232, C233, C235, C241, C242, C243, C244: 2.2uF; C_0402_1005Metric; Voltage 10V
C224, C234: 1uF; C_0402_1005Metric; Voltage 10V
C226, C245: 100nF; C_0201_0603Metric; Voltage 10V

Connections:
GND: C220.2, C221.2, C222.2, C223.2, C224.2, C225.2, C226.2, C230.2, C231.2, C232.2, C233.2, C234.2, C235.2, C240.2, C241.2, C242.2, C243.2, C244.2, C245.2; also elsewhere on the board
VDD_CPUB: C220.1, C221.1, C222.1, C223.1, C224.1, C225.1, C226.1; also elsewhere on the board
VDD_CPUL: C230.1, C231.1, C232.1, C233.1, C234.1, C235.1; also elsewhere on the board
VDD_DNR: C240.1, C241.1, C242.1, C243.1, C244.1, C245.1; also elsewhere on the board

Notes on the sheet:
CPU / DNR decoupling: place at the SoC balls
Populated capacitances follow Allwinner STD / hardware guide p39. Keep the individual capacitors at the corresponding ball clusters; bulk PMIC output capacitors are additional. Use X5R/X7R parts with adequate effective capacitance at the operating voltage. Feedback routing: M19 CPUB, V16 CPUL, L15 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

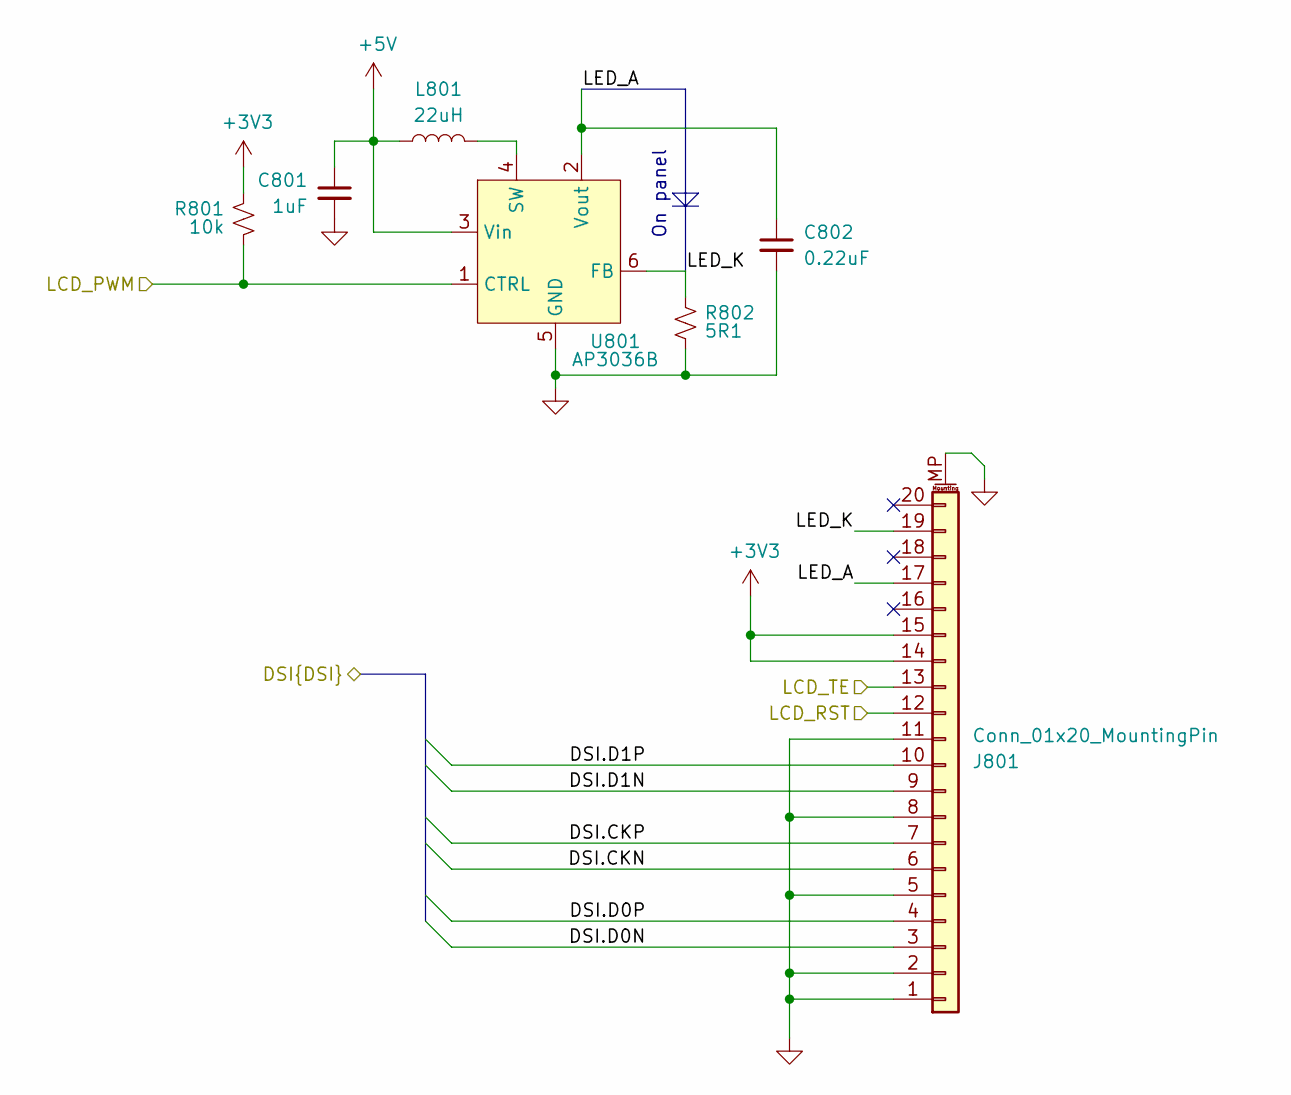
[picture p428: schematic dsi.kicad_sch]

Parts:
C801: 1uF; C_0402_1005Metric; MPN CL05A105KO5NNNC
C802: 0.22uF; C_0603_1608Metric; MPN CC0603KRX7R7BB224
J801: Conn_01x20_MountingPin; Hirose_FH12-20S-0.5SH_1x20-1MP_P0.50mm_Horizontal; MPN FH12-20S-0.5SH(55)
L801: 22uH; L_1210_3225Metric; MPN CBC3225T220MR
R801: 10k; R_0402_1005Metric; MPN RC0402JR-0710KL
R802: 5R1; R_0402_1005Metric; MPN RC0402JR-075R1L
U801: AP3036B; SOT-23-6; MPN AP3036BKTR-G1

Connections:
+3V3: J801.14, J801.15, R801.1; also elsewhere on the board
+5V: C801.1, L801.1, U801.3 (Vin); also elsewhere on the board
/A523 Display DSI/DSI.CKN: J801.6; also elsewhere on the board
/A523 Display DSI/DSI.CKP: J801.7; also elsewhere on the board
/A523 Display DSI/DSI.D0N: J801.3; also elsewhere on the board
/A523 Display DSI/DSI.D0P: J801.4; also elsewhere on the board
/A523 Display DSI/DSI.D1N: J801.9; also elsewhere on the board
/A523 Display DSI/DSI.D1P: J801.10; also elsewhere on the board
/Display / backlight/LED_A: C802.1, J801.17, U801.2 (Vout)
/Display / backlight/LED_K: J801.19, R802.1, U801.6 (FB)
/LCD_PWM: R801.2, U801.1 (CTRL); also elsewhere on the board
/LCD_RST: J801.12; also elsewhere on the board
/LCD_TE: J801.13; also elsewhere on the board
GND: C801.2, C802.2, J801.1, J801.2, J801.5, J801.8, J801.11, J801.MP (MountPin), R802.2, U801.5 (GND); also elsewhere on the board
unnamed: L801.2, U801.4 (SW)

Notes on the sheet:
On panel

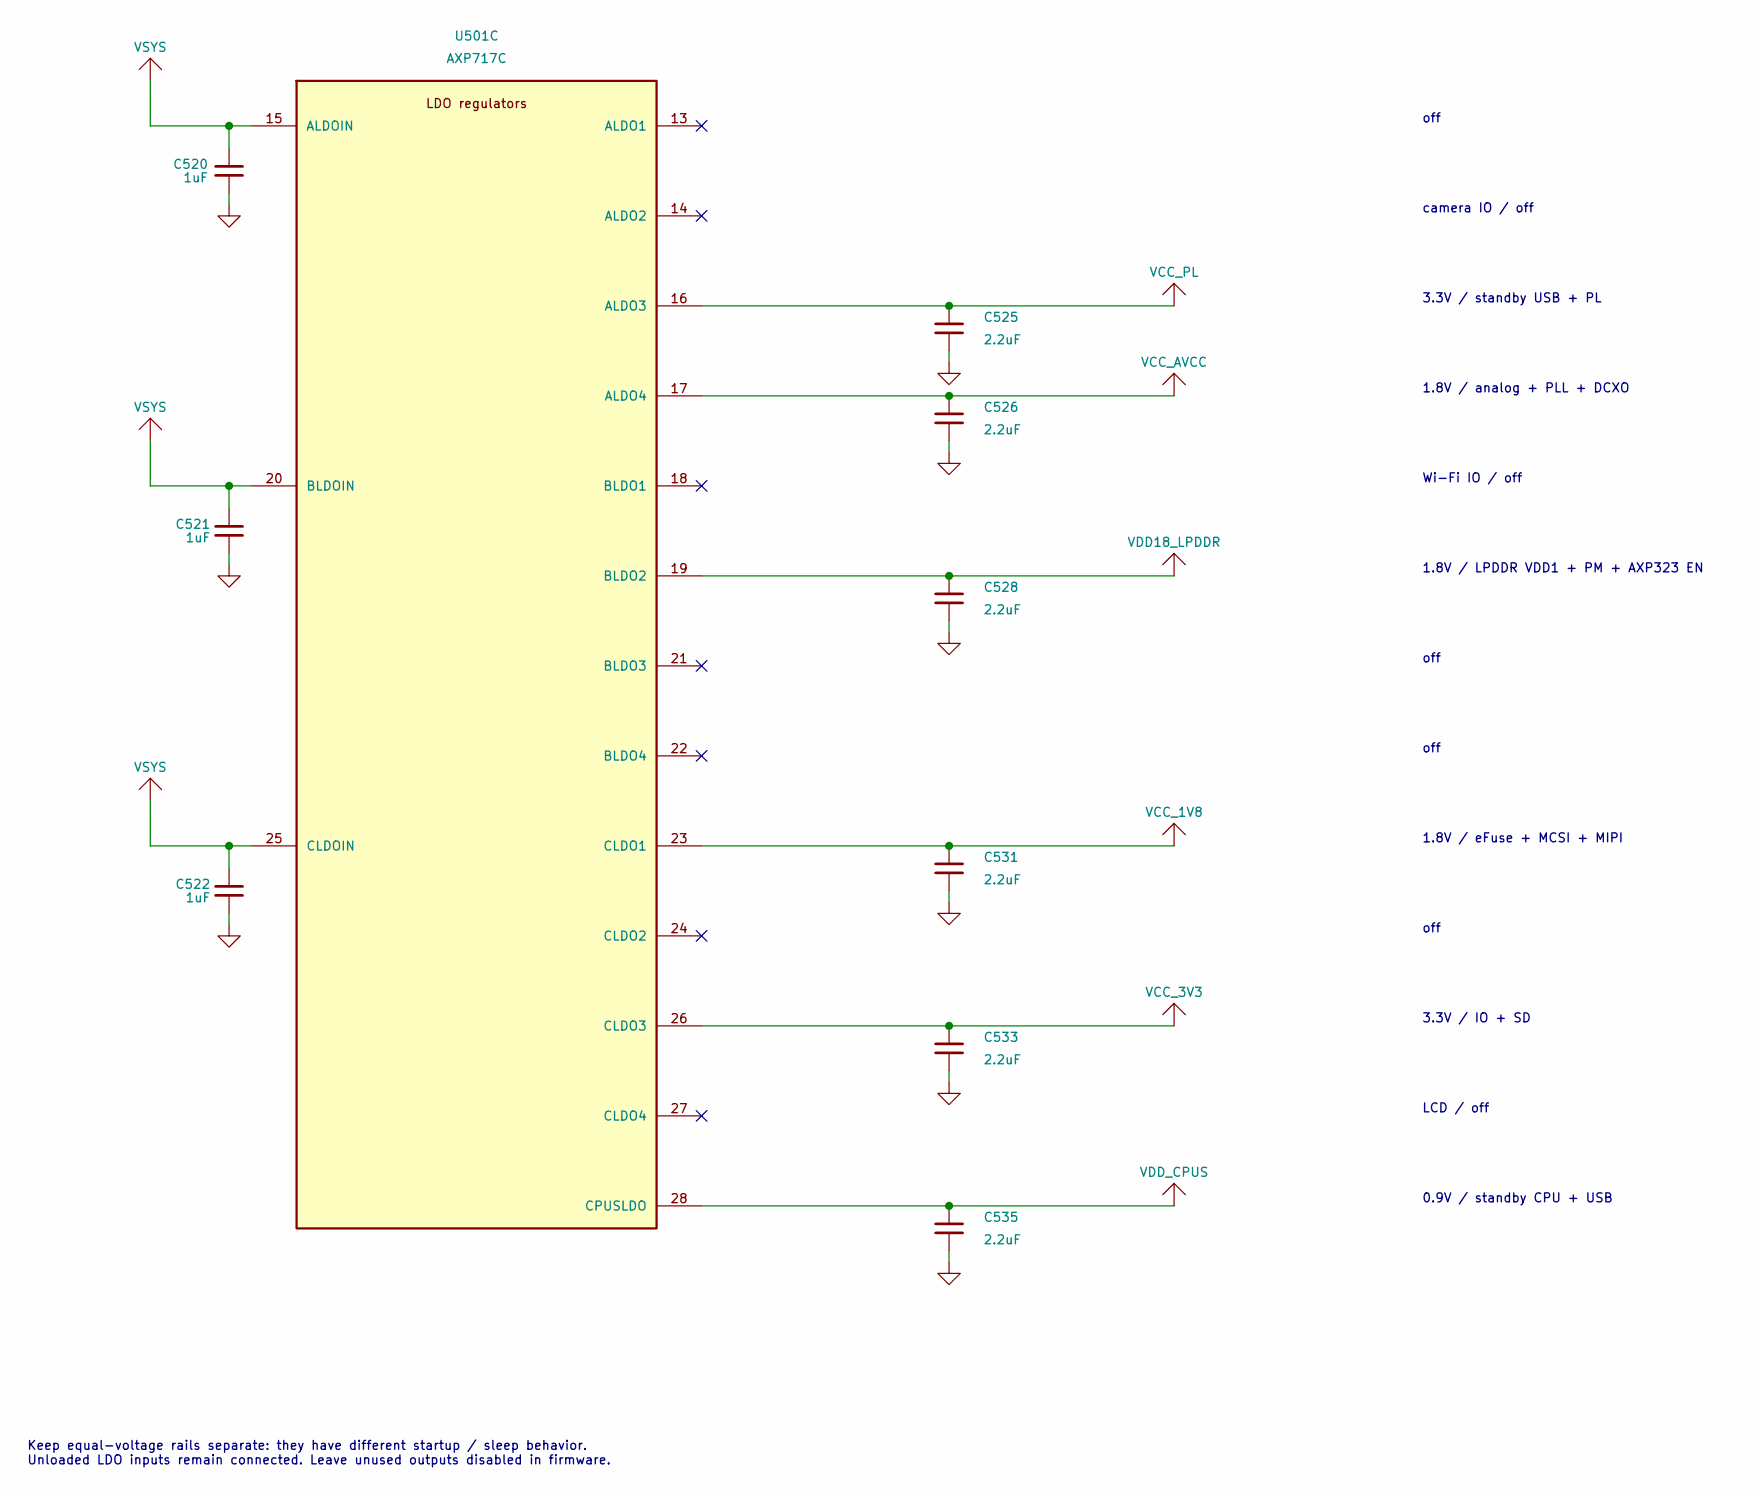
[picture p429: schematic a523_ldos.kicad_sch, A523 - LDO and standby rails]

Parts:
C520, C521, C522: 1uF; C_0402_1005Metric; Voltage 10V
C525, C526, C528, C531, C533, C535: 2.2uF; C_0402_1005Metric; Voltage 10V
U501: AXP717C; QFN-52-1EP_6x6mm_P0.4mm_EP4.6x4.6mm

Connections:
GND: C520.2, C521.2, C522.2, C525.2, C526.2, C528.2, C531.2, C533.2, C535.2; also elsewhere on the board
VCC_1V8: C531.1, U501.23 (CLDO1); also elsewhere on the board
VCC_3V3: C533.1, U501.26 (CLDO3); also elsewhere on the board
VCC_AVCC: C526.1, U501.17 (ALDO4); also elsewhere on the board
VCC_PL: C525.1, U501.16 (ALDO3); also elsewhere on the board
VDD18_LPDDR: C528.1, U501.19 (BLDO2); also elsewhere on the board
VDD_CPUS: C535.1, U501.28 (CPUSLDO); also elsewhere on the board
VSYS: C520.1, C521.1, C522.1, U501.15 (ALDOIN), U501.20 (BLDOIN), U501.25 (CLDOIN); also elsewhere on the board

Notes on the sheet:
3.3V / IO + SD
1.8V / eFuse + MCSI + MIPI
off
Keep equal-voltage rails separate: they have different startup / sleep behavior. Unloaded LDO inputs remain connected. Leave unused outputs disabled in firmware.
camera IO / off
1.8V / analog + PLL + DCXO
0.9V / standby CPU + USB
LCD / off
3.3V / standby USB + PL
Wi-Fi IO / off
1.8V / LPDDR VDD1 + PM + AXP323 EN

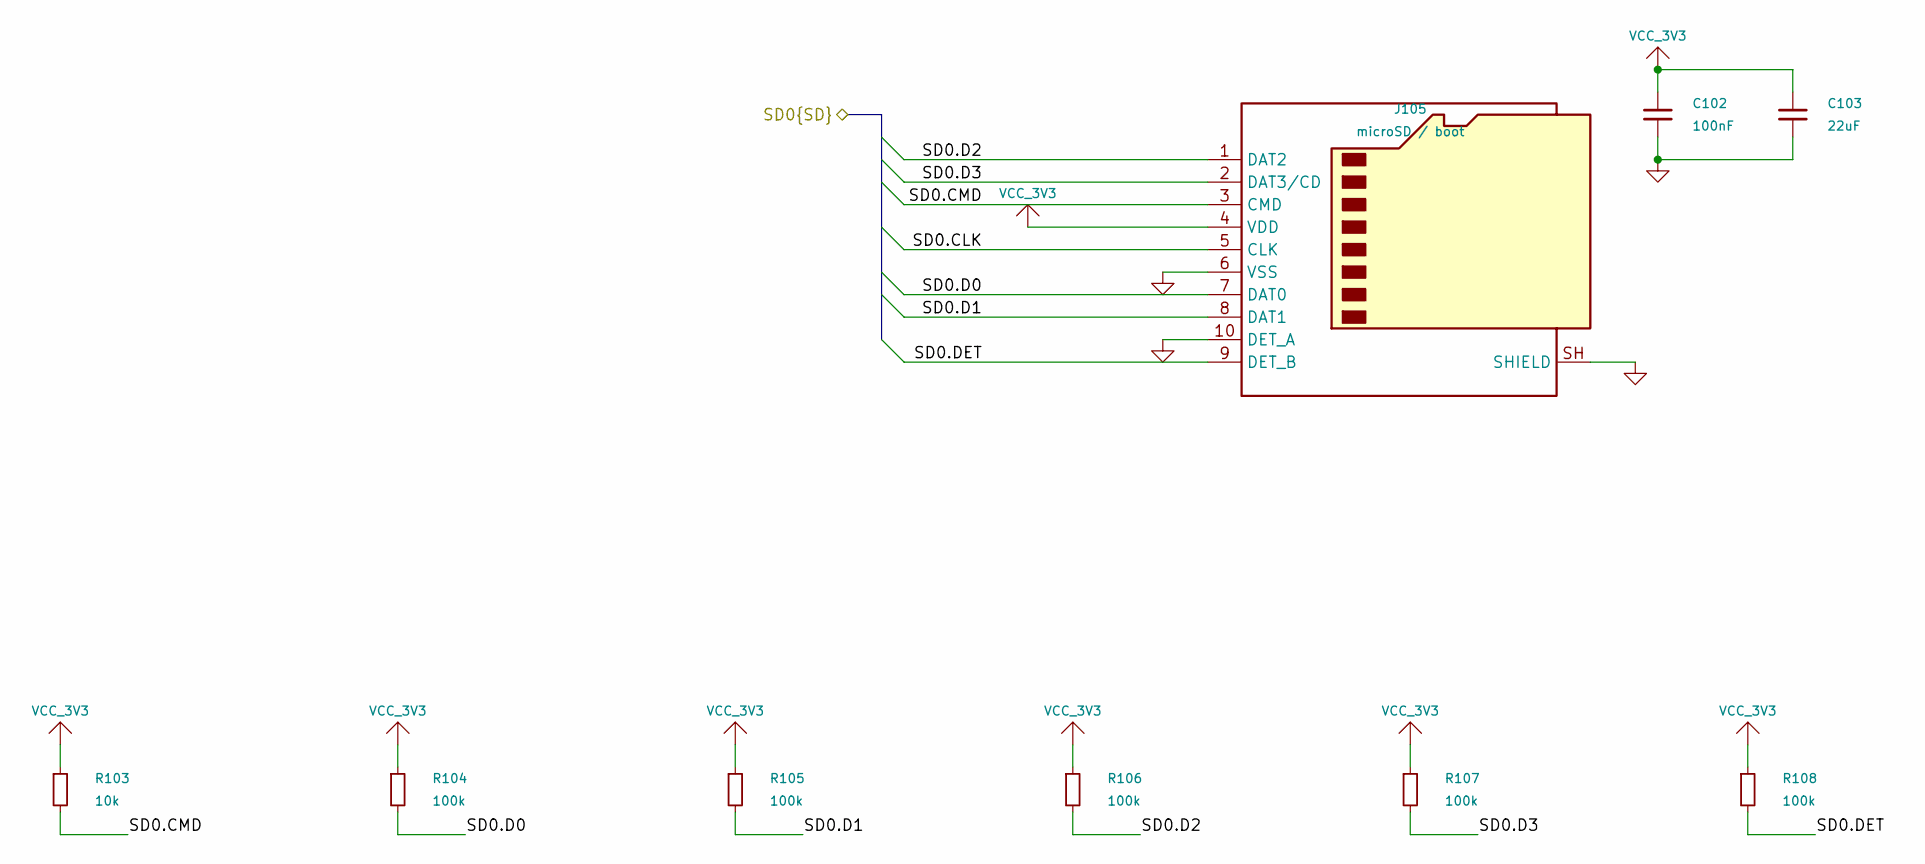
[picture p430: schematic sdcard.kicad_sch, MicroSD boot socket]

Parts:
C102: 100nF; C_0402_1005Metric; Voltage 10V
C103: 22uF; C_0603_1608Metric; Voltage 10V
J105: microSD / boot; microSD_HC_Hirose_DM3AT-SF-PEJM5
R103: 10k; R_0402_1005Metric
R104, R105, R106, R107, R108: 100k; R_0402_1005Metric

Connections:
/A523 SD and GPIO/SD0.CLK: J105.5 (CLK); also elsewhere on the board
/A523 SD and GPIO/SD0.CMD: J105.3 (CMD), R103.2; also elsewhere on the board
/A523 SD and GPIO/SD0.D0: J105.7 (DAT0), R104.2; also elsewhere on the board
/A523 SD and GPIO/SD0.D1: J105.8 (DAT1), R105.2; also elsewhere on the board
/A523 SD and GPIO/SD0.D2: J105.1 (DAT2), R106.2; also elsewhere on the board
/A523 SD and GPIO/SD0.D3: J105.2 (DAT3/CD), R107.2; also elsewhere on the board
/A523 SD and GPIO/SD0.DET: J105.9 (DET_B), R108.2; also elsewhere on the board
GND: C102.2, C103.2, J105.6 (VSS), J105.10 (DET_A), J105.SH (SHIELD); also elsewhere on the board
VCC_3V3: C102.1, C103.1, J105.4 (VDD), R103.1, R104.1, R105.1, R106.1, R107.1, R108.1; also elsewhere on the board

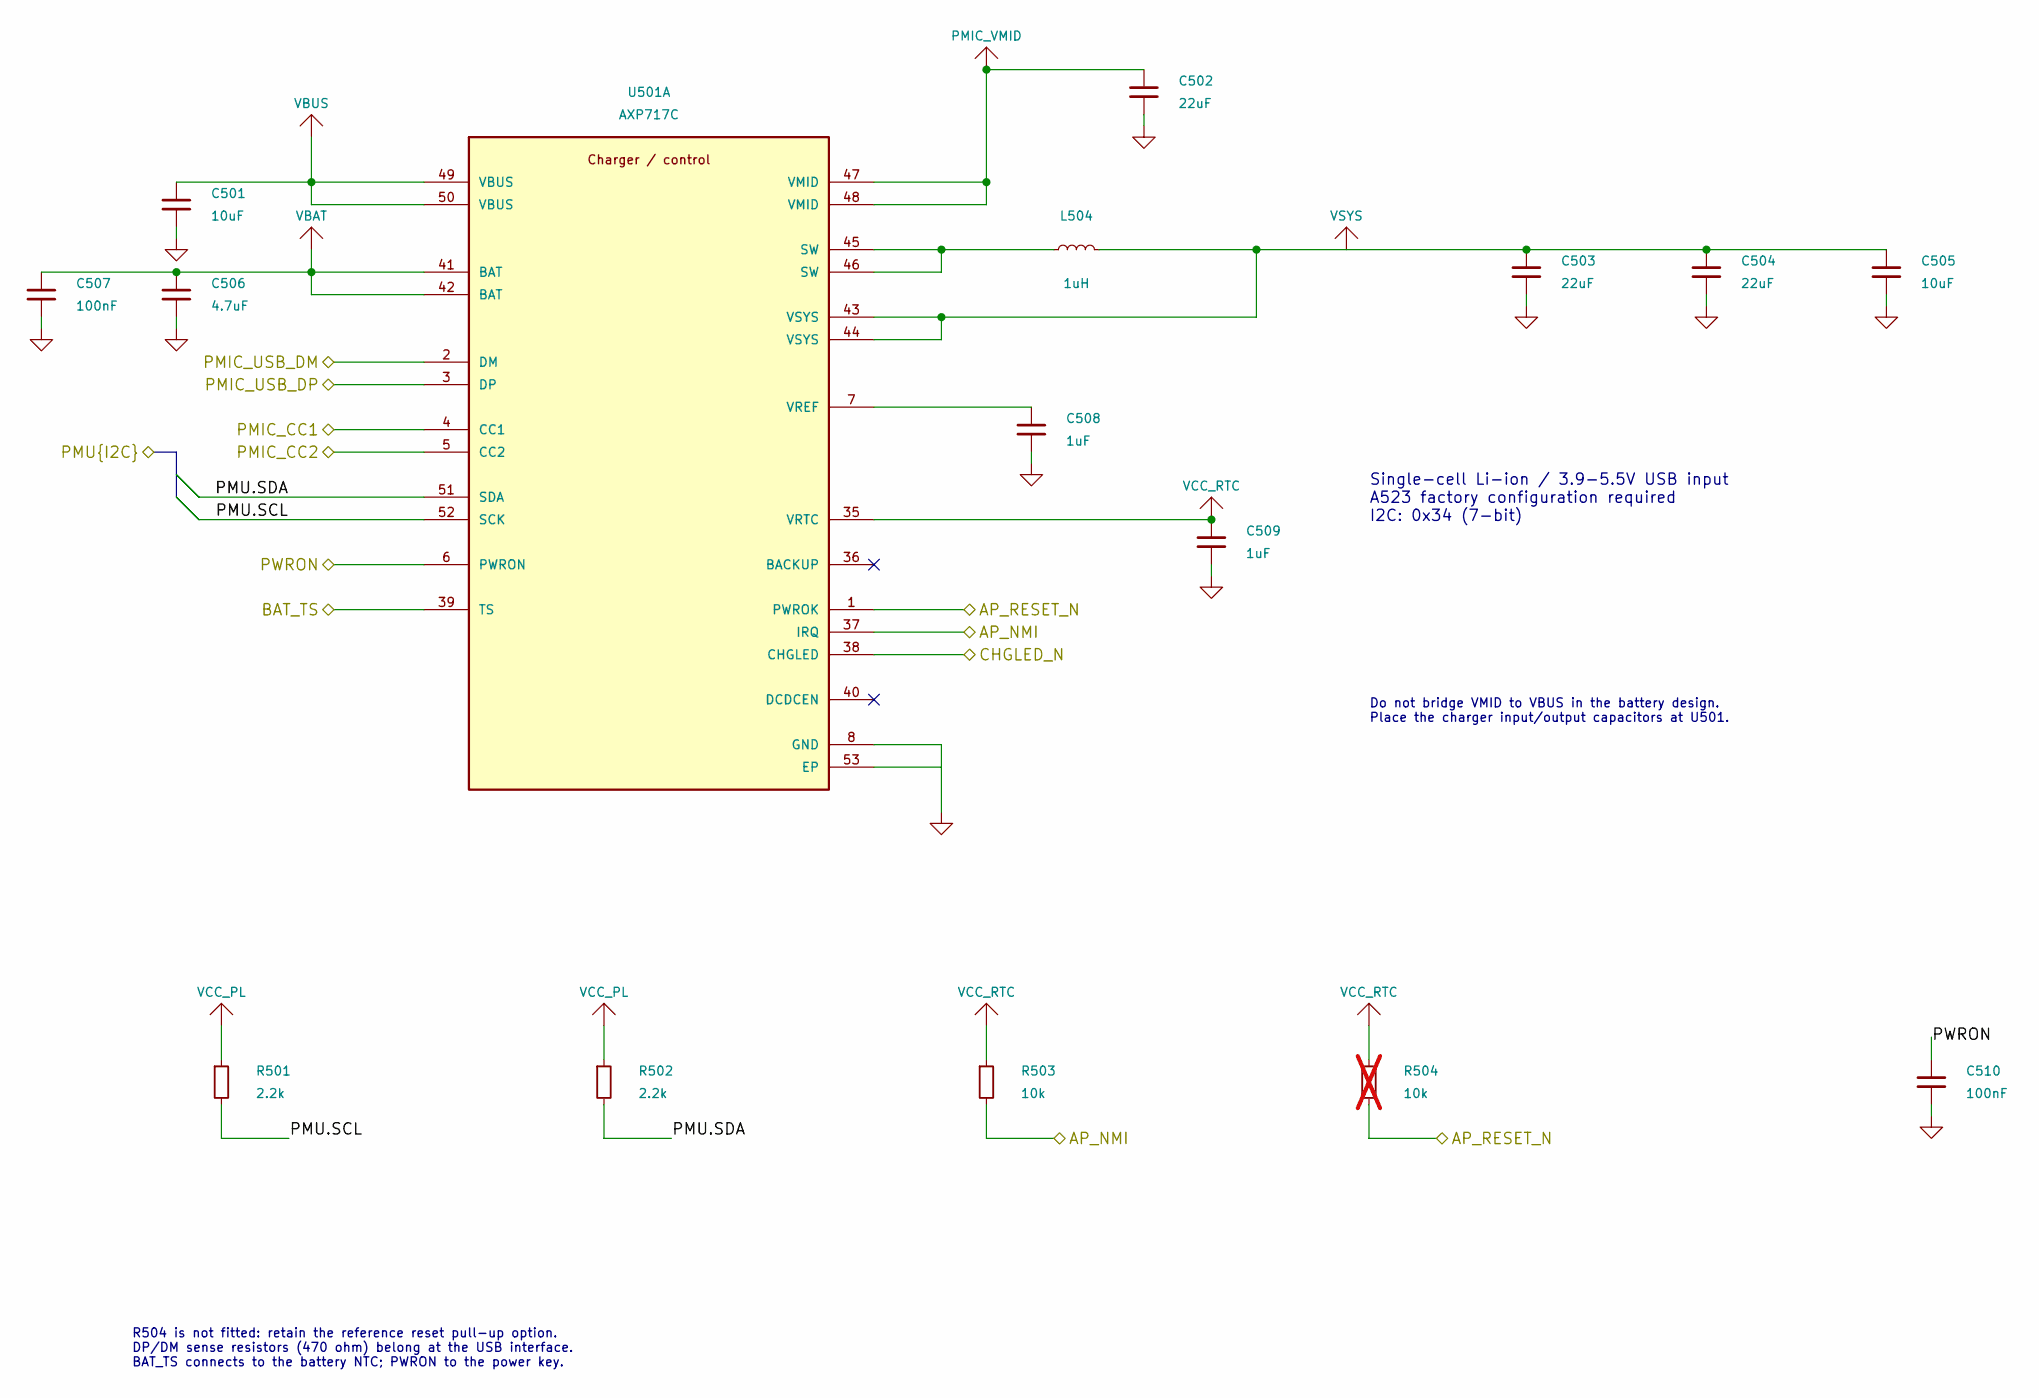
[picture p431: schematic a523_charger.kicad_sch, A523 - charger and PMIC control]

Parts:
C501, C505: 10uF; C_0603_1608Metric; Voltage 10V
C502, C503, C504: 22uF; C_0603_1608Metric; Voltage 10V
C506: 4.7uF; C_0402_1005Metric; Voltage 10V
C507, C510: 100nF; C_0402_1005Metric; Voltage 10V
C508, C509: 1uF; C_0402_1005Metric; Voltage 10V
L504: 1uH; L_Coilcraft_XAL4020-XXX; MPN XAL4020-102MEB
R501, R502: 2.2k; R_0402_1005Metric
R503: 10k; R_0402_1005Metric
R504: 10k; R_0402_1005Metric; not fitted
U501: AXP717C; QFN-52-1EP_6x6mm_P0.4mm_EP4.6x4.6mm

Connections:
/AP_NMI: R503.2, U501.37 (IRQ); also elsewhere on the board
/AP_RESET_N: R504.2, U501.1 (PWROK); also elsewhere on the board
/BAT_TS: U501.39 (TS); also elsewhere on the board
/CHGLED_N: U501.38 (CHGLED); also elsewhere on the board
/PMIC_CC1: U501.4 (CC1); also elsewhere on the board
/PMIC_CC2: U501.5 (CC2); also elsewhere on the board
/PMIC_USB_DM: U501.2 (DM); also elsewhere on the board
/PMIC_USB_DP: U501.3 (DP); also elsewhere on the board
/PMU.SCL: R501.2, U501.52 (SCK); also elsewhere on the board
/PMU.SDA: R502.2, U501.51 (SDA); also elsewhere on the board
/PWRON: C510.1, U501.6 (PWRON); also elsewhere on the board
GND: C501.2, C502.2, C503.2, C504.2, C505.2, C506.2, C507.2, C508.2, C509.2, C510.2, U501.8 (GND), U501.53 (EP); also elsewhere on the board
unnamed: L504.1, U501.45 (SW), U501.46 (SW)
unnamed: C508.1, U501.7 (VREF)
PMIC_VMID: C502.1, U501.47 (VMID), U501.48 (VMID)
VBAT: C506.1, C507.1, U501.41 (BAT), U501.42 (BAT); also elsewhere on the board
VBUS: C501.1, U501.49 (VBUS), U501.50 (VBUS); also elsewhere on the board
VCC_PL: R501.1, R502.1; also elsewhere on the board
VCC_RTC: C509.1, R503.1, R504.1, U501.35 (VRTC); also elsewhere on the board
VSYS: C503.1, C504.1, C505.1, L504.2, U501.43 (VSYS), U501.44 (VSYS); also elsewhere on the board

Notes on the sheet:
Single-cell Li-ion / 3.9-5.5V USB input A523 factory configuration required I2C: 0x34 (7-bit)
R504 is not fitted: retain the reference reset pull-up option. DP/DM sense resistors (470 ohm) belong at the USB interface. BAT_TS connects to the battery NTC; PWRON to the power key.
Do not bridge VMID to VBUS in the battery design. Place the charger input/output capacitors at U501.

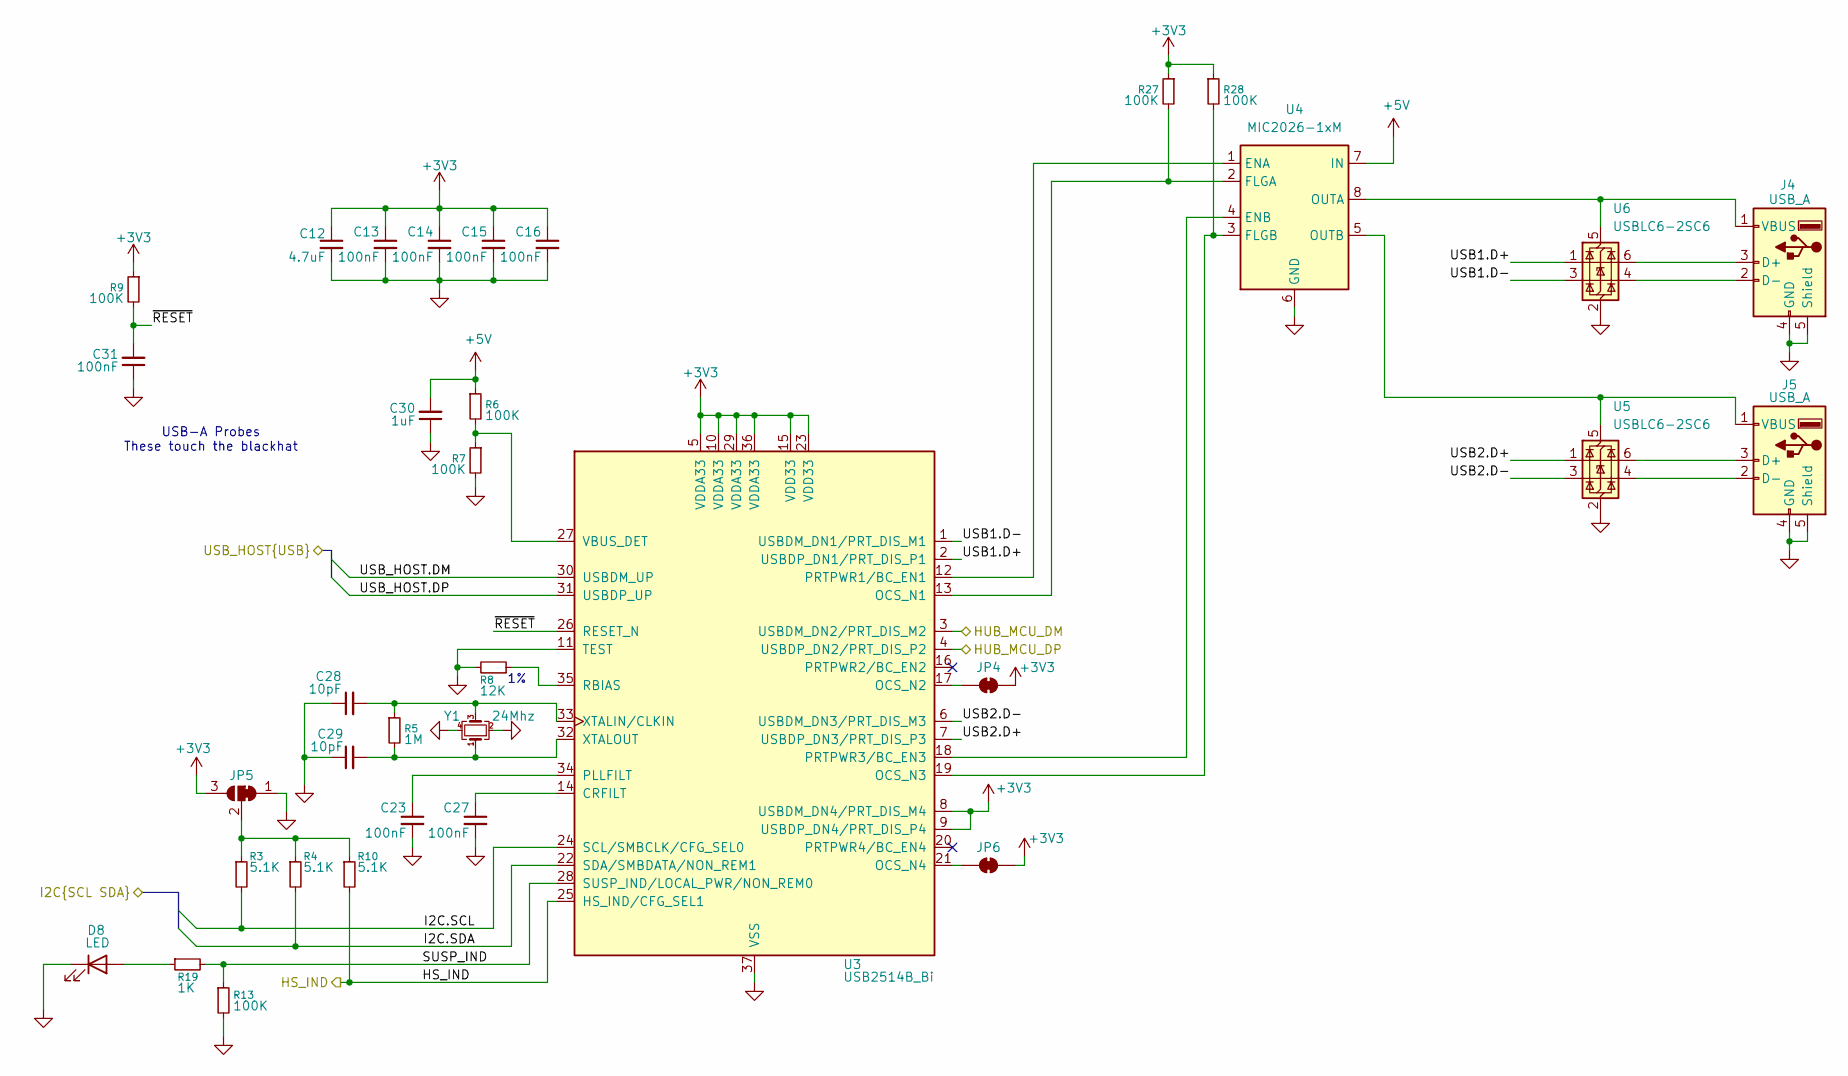
[picture p432: schematic usb.kicad_sch, Blackpants]

Parts:
C12: 4.7uF; C_0402_1005Metric; MPN CC0402MRX5R5BB475
C13, C14, C15, C16, C23, C27, C31: 100nF; C_0402_1005Metric; MPN CL05B104KB54PNC
C28, C29: 10pF; C_0402_1005Metric; MPN GRM1555C1H100FA01D
C30: 1uF; C_0402_1005Metric; MPN CL05B105KQ5NQNC
D8: LED; LED_0603_1608Metric; MPN KT-0603R
J4, J5: USB_A; USB_A_Receptacle_GCT_1; MPN USB1046-GF-0190-L-B-A
JP4, JP6: SolderJumper_2_Bridged; SolderJumper-2_P1.3mm_Bridged_Pad1.0x1.5mm
JP5: SolderJumper_3_Bridged12; SolderJumper-3_P1.3mm_Bridged2Bar12_RoundedPad1.0x1.5mm
R3, R4, R10: 5.1K; R_0402_1005Metric; MPN RC0402FR-135K1L
R5: 1M; R_0402_1005Metric; MPN RC0402FR-131ML
R6, R7, R9, R13, R27, R28: 100K; R_0402_1005Metric; MPN RC0402FR-13100KL
R8: 12K; R_0402_1005Metric; MPN RC0402FR-1312KL
R19: 1K; R_0402_1005Metric; MPN 0402WGF1001TCE
U3: USB2514B_Bi; QFN-36-1EP_6x6mm_P0.5mm_EP3.7x3.7mm; MPN USB2514BI-AEZG-TR
U4: MIC2026-1xM; SOIC-8_3.9x4.9mm_P1.27mm; MPN MIC2026-1YM-TR
U5, U6: USBLC6-2SC6; SOT-23-6; MPN USBLC6-2SC6
Y1: 24Mhz; Crystal_SMD_Citizen_CS325S-4Pin_3.2x2.5mm; MPN CS325S24000000ABJT

Connections:
+3V3: C12.1, C13.1, C14.1, C15.1, C16.1, JP4.2 (B), JP5.3 (B), JP6.2 (B), R9.1, R27.1, R28.1, U3.5 (VDDA33), U3.8 (USBDM_DN4/PRT_DIS_M4), U3.9 (USBDP_DN4/PRT_DIS_P4), U3.10 (VDDA33), U3.15 (VDD33), U3.23 (VDD33), U3.29 (VDDA33), U3.36 (VDDA33); also elsewhere on the board
+5V: C30.2, R6.1, U4.7 (IN); also elsewhere on the board
/A523 USB PHY/USB_HOST.DM: U3.30 (USBDM_UP); also elsewhere on the board
/A523 USB PHY/USB_HOST.DP: U3.31 (USBDP_UP); also elsewhere on the board
/STM32 + Keyboard/I2C.SCL: R3.2, U3.24 (SCL/SMBCLK/CFG_SEL0); also elsewhere on the board
/STM32 + Keyboard/I2C.SDA: R4.2, U3.22 (SDA/SMBDATA/NON_REM1); also elsewhere on the board
/USB3.D+: U3.4 (USBDP_DN2/PRT_DIS_P2); also elsewhere on the board
/USB3.D-: U3.3 (USBDM_DN2/PRT_DIS_M2); also elsewhere on the board
/USB Hub/HS_IND: R10.2, U3.25 (HS_IND/CFG_SEL1)
/USB Hub/SUSP_IND: R13.1, R19.2, U3.28 (SUSP_IND/LOCAL_PWR/NON_REM0)
/USB Hub/USB1.D+: U3.2 (USBDP_DN1/PRT_DIS_P1), U6.1 (I/O1)
/USB Hub/USB1.D-: U3.1 (USBDM_DN1/PRT_DIS_M1), U6.3 (I/O2)
/USB Hub/USB2.D+: U3.7 (USBDP_DN3/PRT_DIS_P3), U5.1 (I/O1)
/USB Hub/USB2.D-: U3.6 (USBDM_DN3/PRT_DIS_M3), U5.3 (I/O2)
/USB Hub/~RESET: C31.2, R9.2, U3.26 (RESET_N)
GND: C12.2, C13.2, C14.2, C15.2, C16.2, C23.2, C27.2, C28.1, C29.1, C30.1, C31.1, D8.1 (K), J4.4 (GND), J4.5 (Shield), J5.4 (GND), J5.5 (Shield), JP5.1 (A), R7.2, R8.2, R13.2, U3.11 (TEST), U3.37 (VSS), U4.6 (GND), U5.2 (GND), U6.2 (GND), Y1.2, Y1.4; also elsewhere on the board
unnamed: D8.2 (A), R19.1
unnamed: J4.3 (D+), U6.6 (I/O1)
unnamed: J4.2 (D-), U6.4 (I/O2)
unnamed: J4.1 (VBUS), U4.8 (OUTA), U6.5 (VBUS)
unnamed: J5.3 (D+), U5.6 (I/O1)
unnamed: J5.2 (D-), U5.4 (I/O2)
unnamed: J5.1 (VBUS), U4.5 (OUTB), U5.5 (VBUS)
unnamed: JP4.1 (A), U3.17 (OCS_N2)
unnamed: JP5.2 (C), R3.1, R4.1, R10.1
unnamed: JP6.1 (A), U3.21 (OCS_N4)
unnamed: C27.1, U3.14 (CRFILT)
unnamed: R27.2, U3.13 (OCS_N1), U4.2 (FLGA)
unnamed: R28.2, U3.19 (OCS_N3), U4.3 (FLGB)
unnamed: C23.1, U3.34 (PLLFILT)
unnamed: U3.12 (PRTPWR1/BC_EN1), U4.1 (ENA)
unnamed: U3.18 (PRTPWR3/BC_EN3), U4.4 (ENB)
unnamed: R8.1, U3.35 (RBIAS)
unnamed: R6.2, R7.1, U3.27 (VBUS_DET)
unnamed: C28.2, R5.1, U3.33 (XTALIN/CLKIN), Y1.3
unnamed: C29.2, R5.2, U3.32 (XTALOUT), Y1.1

Notes on the sheet:
USB-A Probes These touch the blackhat

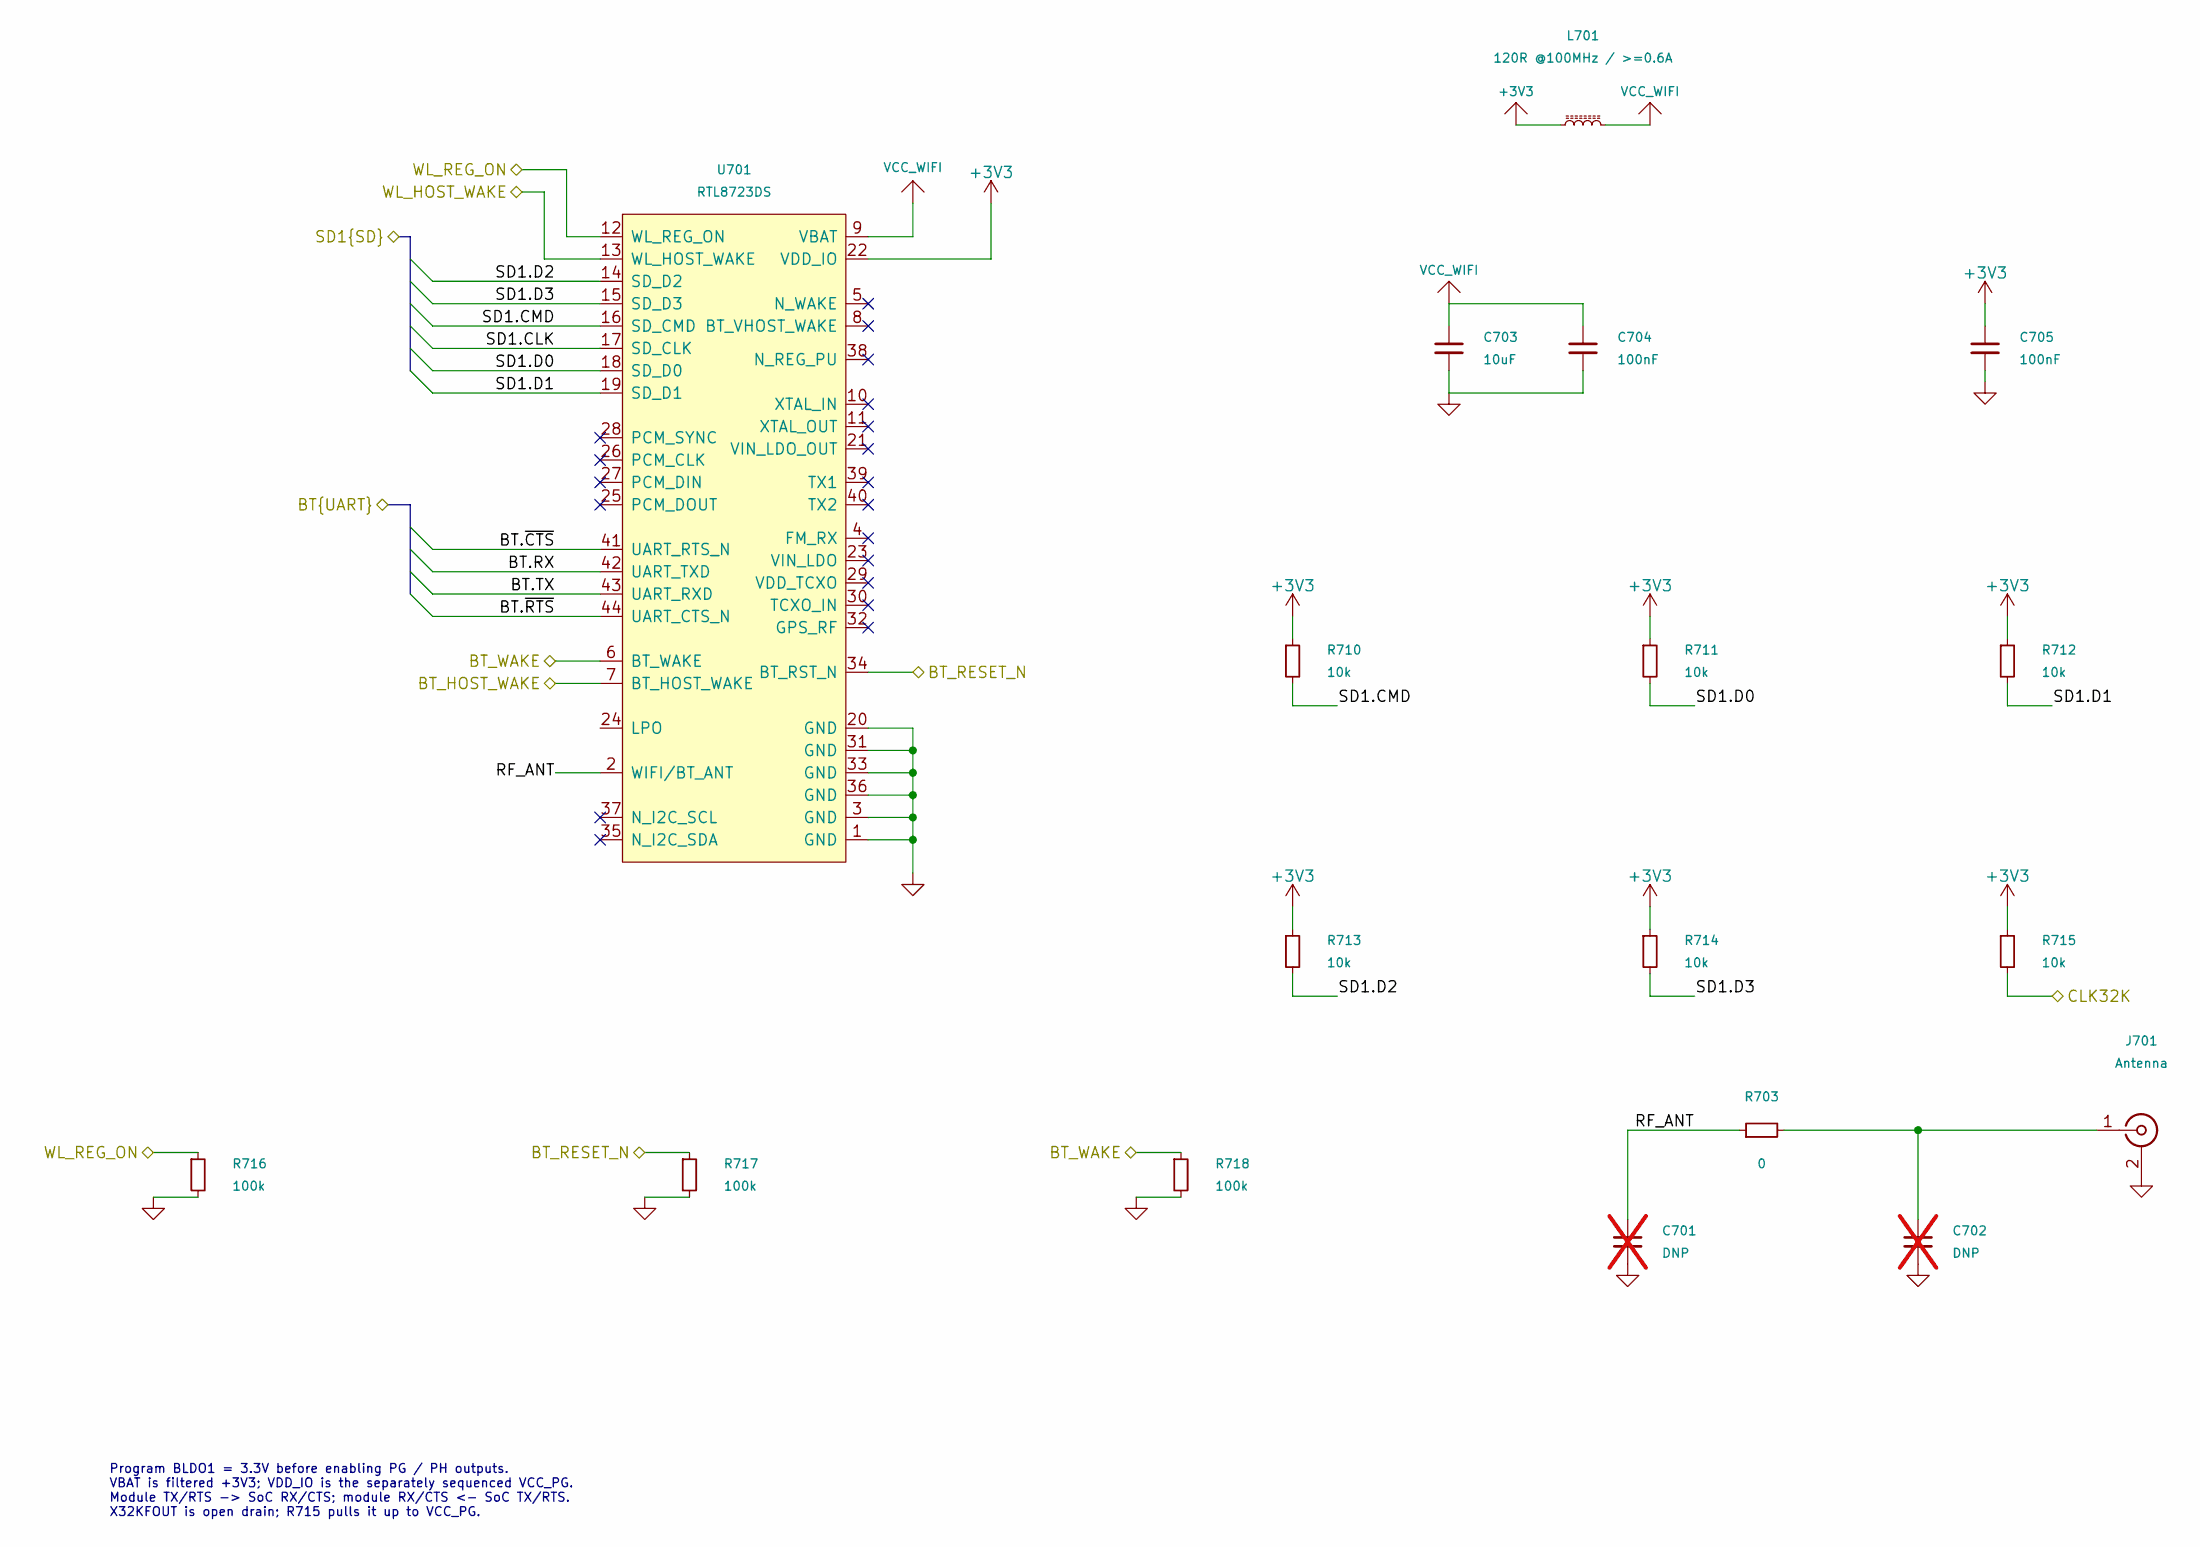
[picture p433: schematic wifi.kicad_sch, RTL8723DS Wi-Fi and Bluetooth]

Parts:
C701, C702: DNP; C_0402_1005Metric; Voltage 10V; not fitted
C703: 10uF; C_0603_1608Metric; Voltage 10V
C704, C705: 100nF; C_0402_1005Metric; Voltage 10V
J701: Antenna; SMA_Amphenol_901-143_Horizontal
L701: 120R @100MHz / >=0.6A; L_0603_1608Metric
R703: 0; R_0402_1005Metric
R710, R711, R712, R713, R714: 10k; R_0201_0603Metric
R715: 10k; R_0402_1005Metric
R716, R717, R718: 100k; R_0402_1005Metric
U701: RTL8723DS; RTL8723

Connections:
+3V3: C705.1, L701.1, R710.1, R711.1, R712.1, R713.1, R714.1, R715.1, U701.22 (VDD_IO); also elsewhere on the board
/A523 Wifi and BT/BT.RX: U701.42 (UART_TXD); also elsewhere on the board
/A523 Wifi and BT/BT.TX: U701.43 (UART_RXD); also elsewhere on the board
/A523 Wifi and BT/BT.~CTS: U701.41 (UART_RTS_N); also elsewhere on the board
/A523 Wifi and BT/BT.~RTS: U701.44 (UART_CTS_N); also elsewhere on the board
/A523 Wifi and BT/SD1.CLK: U701.17 (SD_CLK); also elsewhere on the board
/A523 Wifi and BT/SD1.CMD: R710.2, U701.16 (SD_CMD); also elsewhere on the board
/A523 Wifi and BT/SD1.D0: R711.2, U701.18 (SD_D0); also elsewhere on the board
/A523 Wifi and BT/SD1.D1: R712.2, U701.19 (SD_D1); also elsewhere on the board
/A523 Wifi and BT/SD1.D2: R713.2, U701.14 (SD_D2); also elsewhere on the board
/A523 Wifi and BT/SD1.D3: R714.2, U701.15 (SD_D3); also elsewhere on the board
/BT_HOST_WAKE: U701.7 (BT_HOST_WAKE); also elsewhere on the board
/BT_RESET_N: R717.1, U701.34 (BT_RST_N); also elsewhere on the board
/BT_WAKE: R718.1, U701.6 (BT_WAKE); also elsewhere on the board
/RTL8723DS/CLK32K: R715.2
/RTL8723DS/RF_ANT: C701.1, R703.1, U701.2 (WIFI/BT_ANT)
/WL_HOST_WAKE: U701.13 (WL_HOST_WAKE); also elsewhere on the board
/WL_REG_ON: R716.1, U701.12 (WL_REG_ON); also elsewhere on the board
GND: C701.2, C702.2, C703.2, C704.2, C705.2, J701.2 (Ext), R716.2, R717.2, R718.2, U701.1 (GND), U701.3 (GND), U701.20 (GND), U701.31 (GND), U701.33 (GND), U701.36 (GND); also elsewhere on the board
unnamed: C702.1, J701.1 (In), R703.2
VCC_WIFI: C703.1, C704.1, L701.2, U701.9 (VBAT)

Notes on the sheet:
Program BLDO1 = 3.3V before enabling PG / PH outputs. VBAT is filtered +3V3; VDD_IO is the separately sequenced VCC_PG. Module TX/RTS -> SoC RX/CTS; module RX/CTS <- SoC TX/RTS. X32KFOUT is open drain; R715 pulls it up to VCC_PG.
