o7-machinehum/Blackpants/ee/integrated/blackpants.kicad_pcb

## KiCad design ee/integrated/blackpants.kicad_pcb (continued)

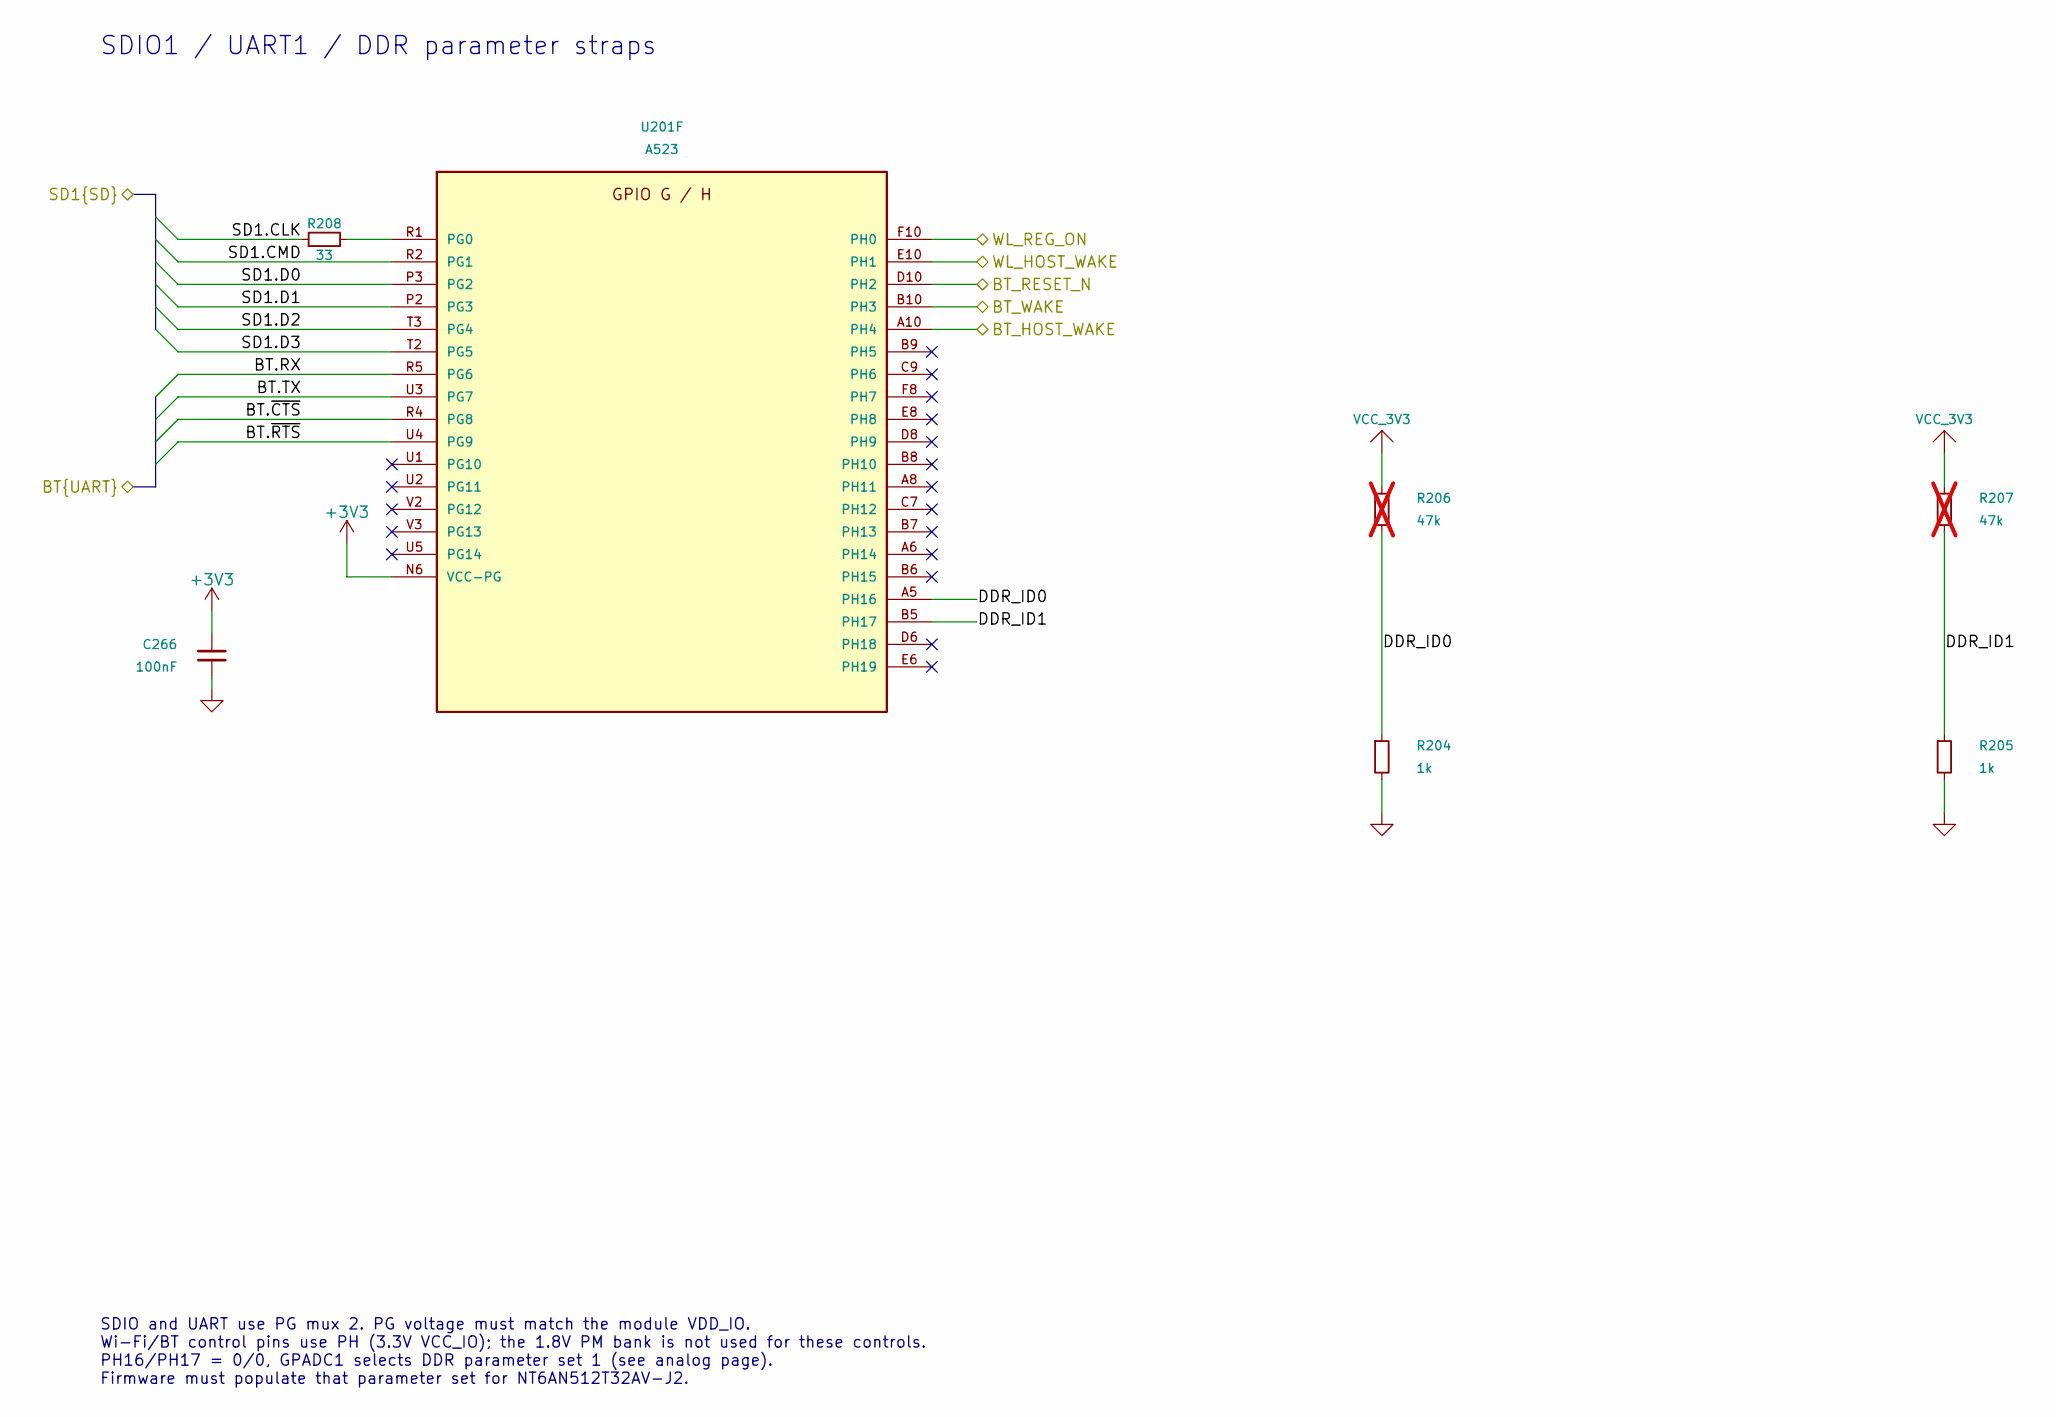
[picture p434: schematic a523_wifi_io.kicad_sch, A523 - Wi-Fi, Bluetooth and DDR strap GPIO]

Parts:
C266: 100nF; C_0201_0603Metric; Voltage 10V
R204, R205: 1k; R_0402_1005Metric
R206, R207: 47k; R_0402_1005Metric; not fitted
R208: 33; R_0402_1005Metric
U201: A523; Allwinner_A523_FCCSP-522_15x15mm_P0.5mm

Connections:
+3V3: C266.1, U201.N6 (VCC-PG); also elsewhere on the board
/A523 Wifi and BT/BT.RX: U201.R5 (PG6); also elsewhere on the board
/A523 Wifi and BT/BT.TX: U201.U3 (PG7); also elsewhere on the board
/A523 Wifi and BT/BT.~CTS: U201.R4 (PG8); also elsewhere on the board
/A523 Wifi and BT/BT.~RTS: U201.U4 (PG9); also elsewhere on the board
/A523 Wifi and BT/DDR_ID0: R204.1, R206.2, U201.A5 (PH16)
/A523 Wifi and BT/DDR_ID1: R205.1, R207.2, U201.B5 (PH17)
/A523 Wifi and BT/SD1.CLK: R208.1; also elsewhere on the board
/A523 Wifi and BT/SD1.CMD: U201.R2 (PG1); also elsewhere on the board
/A523 Wifi and BT/SD1.D0: U201.P3 (PG2); also elsewhere on the board
/A523 Wifi and BT/SD1.D1: U201.P2 (PG3); also elsewhere on the board
/A523 Wifi and BT/SD1.D2: U201.T3 (PG4); also elsewhere on the board
/A523 Wifi and BT/SD1.D3: U201.T2 (PG5); also elsewhere on the board
/BT_HOST_WAKE: U201.A10 (PH4); also elsewhere on the board
/BT_RESET_N: U201.D10 (PH2); also elsewhere on the board
/BT_WAKE: U201.B10 (PH3); also elsewhere on the board
/WL_HOST_WAKE: U201.E10 (PH1); also elsewhere on the board
/WL_REG_ON: U201.F10 (PH0); also elsewhere on the board
GND: C266.2, R204.2, R205.2; also elsewhere on the board
unnamed: R208.2, U201.R1 (PG0)
VCC_3V3: R206.1, R207.1; also elsewhere on the board

Notes on the sheet:
SDIO1 / UART1 / DDR parameter straps
SDIO and UART use PG mux 2. PG voltage must match the module VDD_IO. Wi-Fi/BT control pins use PH (3.3V VCC_IO); the 1.8V PM bank is not used for these controls. PH16/PH17 = 0/0, GPADC1 selects DDR parameter set 1 (see analog page). Firmware must populate that parameter set for NT6AN512T32AV-J2.

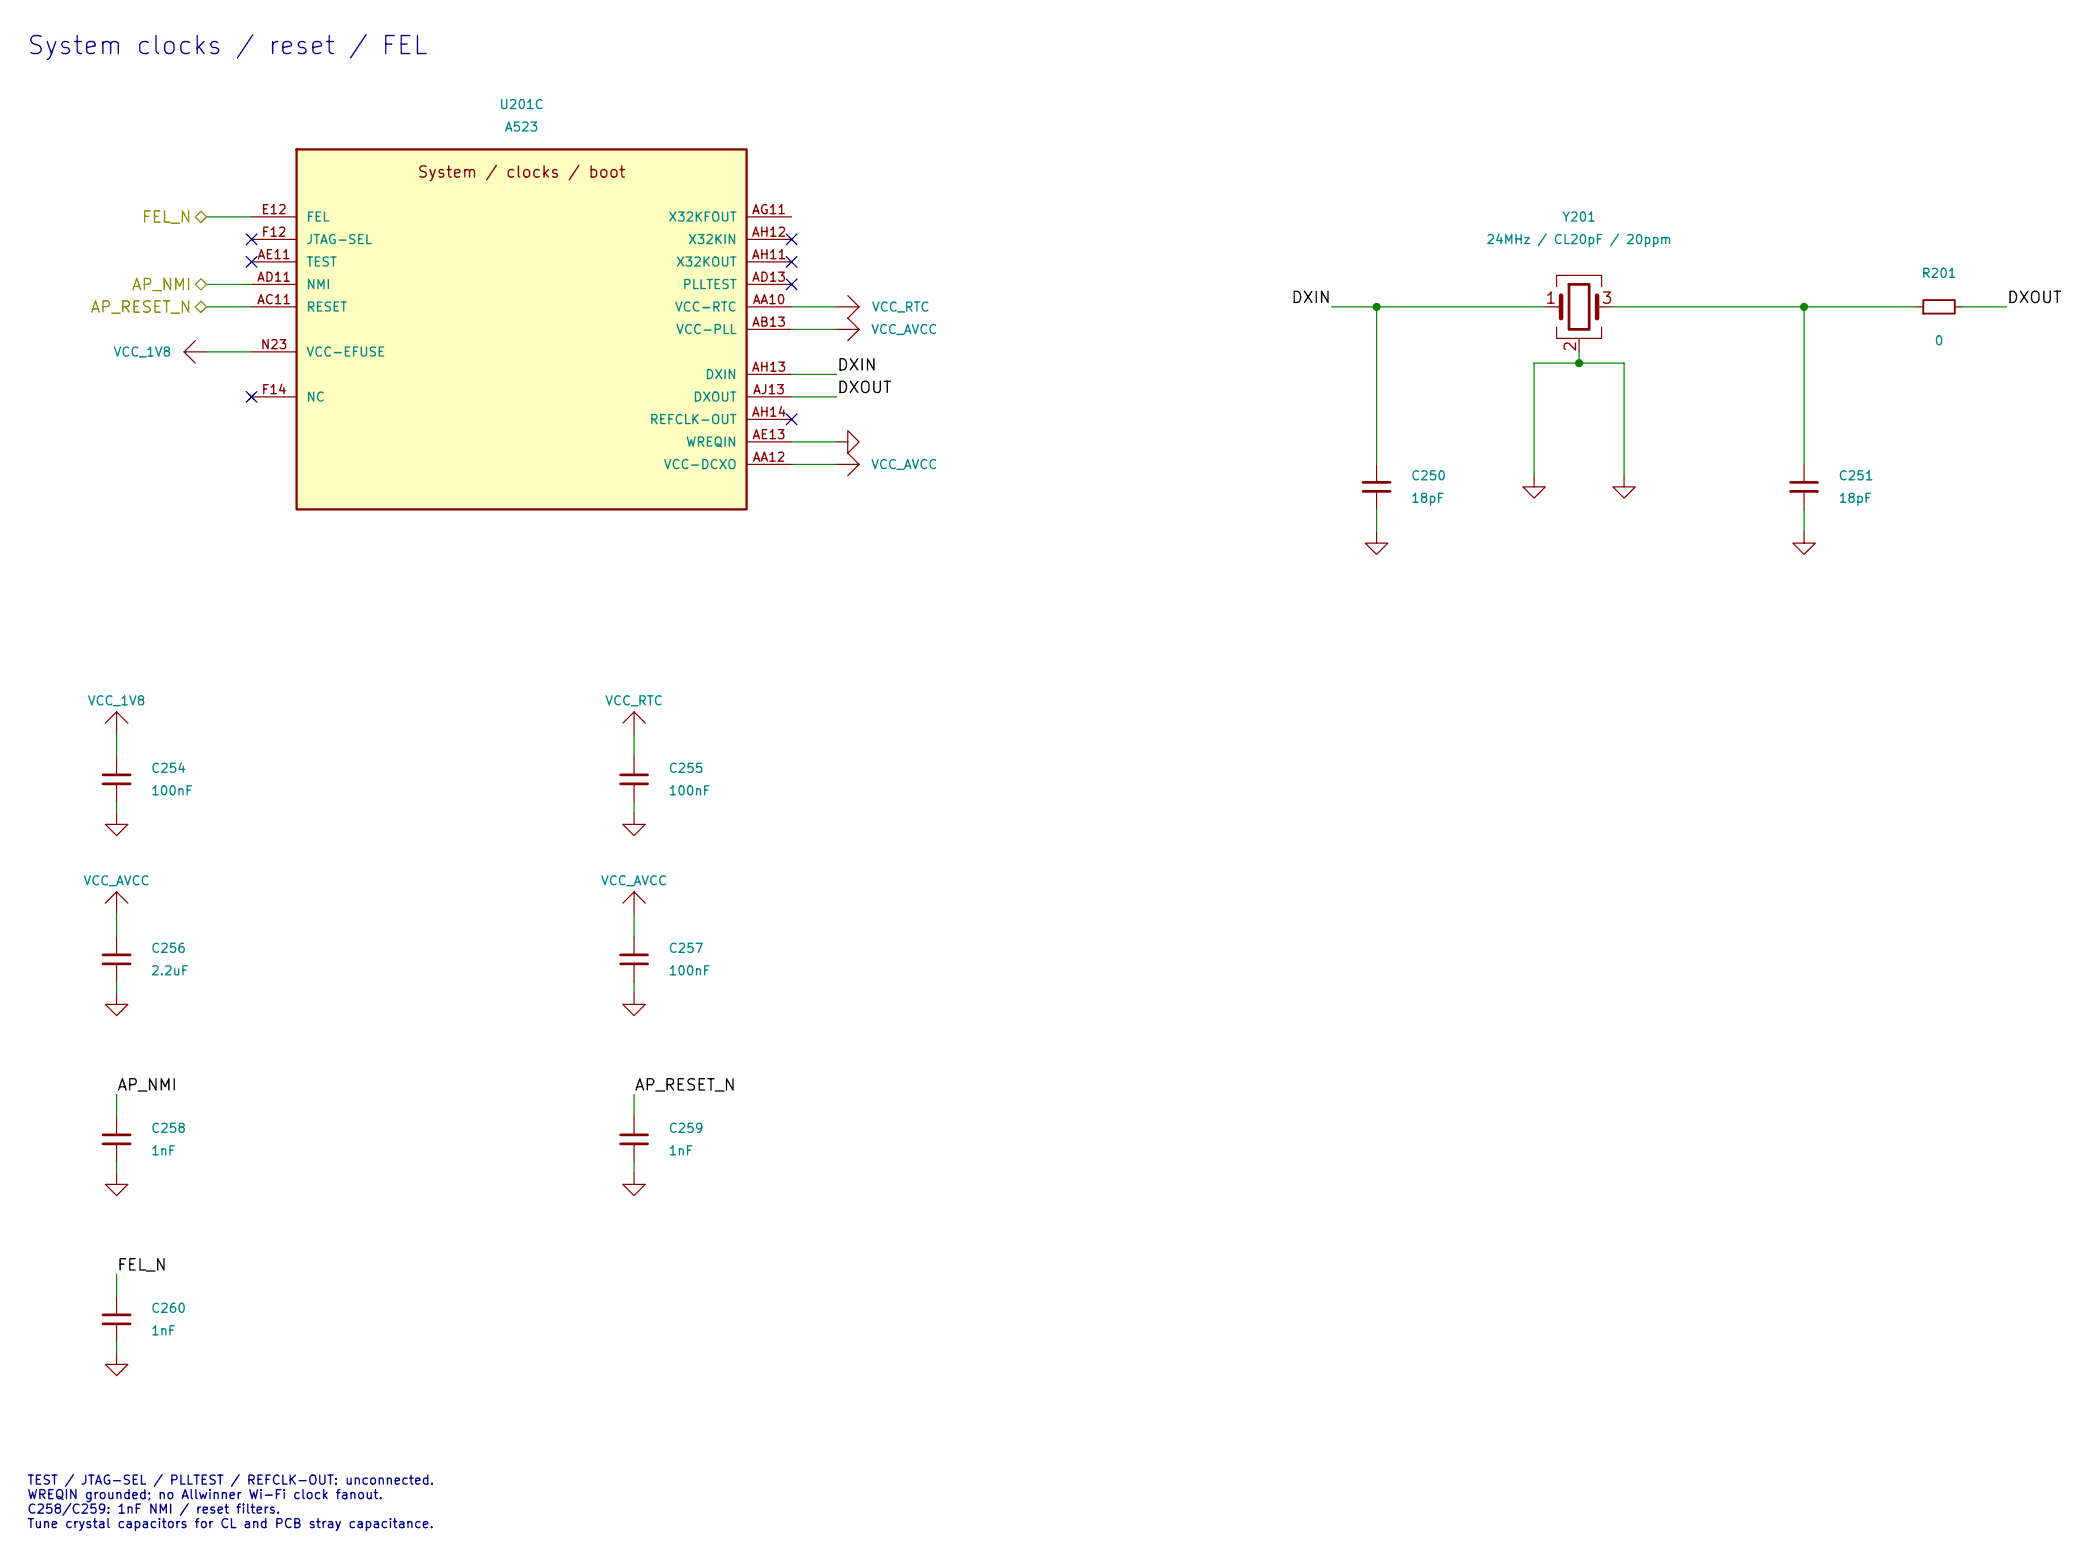
[picture p435: schematic a523_system.kicad_sch, A523 - clocks, reset and boot controls]

Parts:
C250, C251: 18pF; C_0402_1005Metric; Voltage 10V
C254, C255, C257: 100nF; C_0201_0603Metric; Voltage 10V
C256: 2.2uF; C_0402_1005Metric; Voltage 10V
C258, C259, C260: 1nF; C_0402_1005Metric; Voltage 10V
R201: 0; R_0402_1005Metric
U201: A523; Allwinner_A523_FCCSP-522_15x15mm_P0.5mm
Y201: 24MHz / CL20pF / 20ppm; Crystal_SMD_3225-4Pin_3.2x2.5mm

Connections:
/A523 Clocks/DXIN: C250.1, U201.AH13 (DXIN), Y201.1
/A523 Clocks/DXOUT: R201.2, U201.AJ13 (DXOUT)
/AP_NMI: C258.1, U201.AD11 (NMI); also elsewhere on the board
/AP_RESET_N: C259.1, U201.AC11 (RESET); also elsewhere on the board
/FEL_N: C260.1, U201.E12 (FEL); also elsewhere on the board
GND: C250.2, C251.2, C254.2, C255.2, C256.2, C257.2, C258.2, C259.2, C260.2, U201.AE13 (WREQIN), Y201.2 (G), Y201.4 (G); also elsewhere on the board
unnamed: C251.1, R201.1, Y201.3
VCC_1V8: C254.1, U201.N23 (VCC-EFUSE); also elsewhere on the board
VCC_AVCC: C256.1, C257.1, U201.AA12 (VCC-DCXO), U201.AB13 (VCC-PLL); also elsewhere on the board
VCC_RTC: C255.1, U201.AA10 (VCC-RTC); also elsewhere on the board

Notes on the sheet:
TEST / JTAG-SEL / PLLTEST / REFCLK-OUT: unconnected. WREQIN grounded; no Allwinner Wi-Fi clock fanout. C258/C259: 1nF NMI / reset filters. Tune crystal capacitors for CL and PCB stray capacitance.
System clocks / reset / FEL

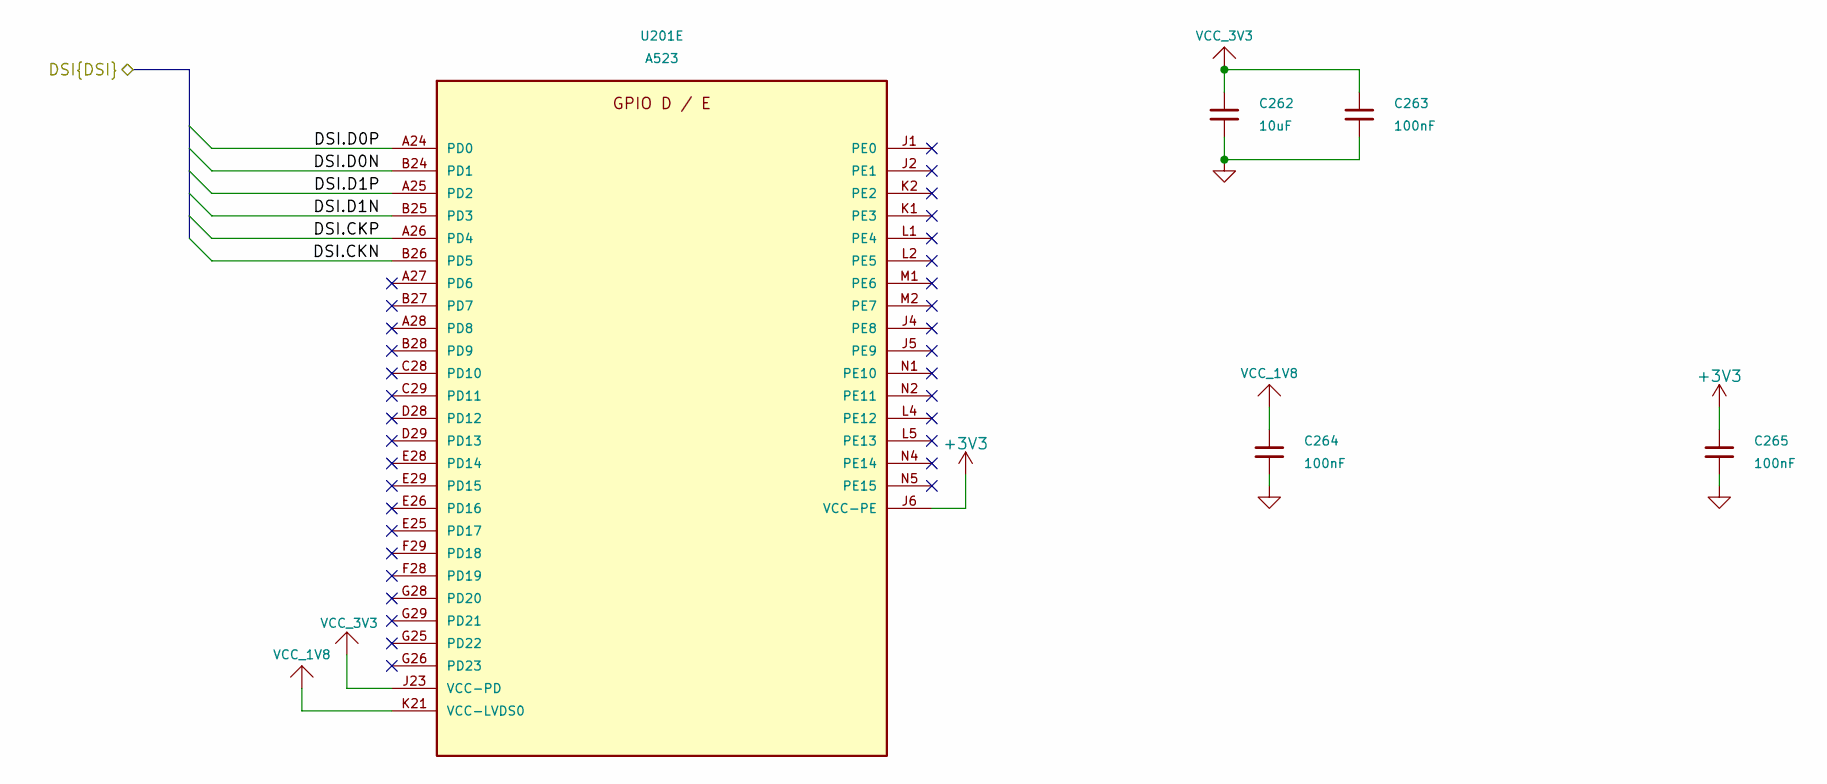
[picture p436: schematic a523_display_io.kicad_sch, A523 - DSI display IO]

Parts:
C262: 10uF; C_0402_1005Metric; Voltage 10V
C263, C264, C265: 100nF; C_0201_0603Metric; Voltage 10V
U201: A523; Allwinner_A523_FCCSP-522_15x15mm_P0.5mm

Connections:
+3V3: C265.1, U201.J6 (VCC-PE); also elsewhere on the board
/A523 Display DSI/DSI.CKN: U201.B26 (PD5); also elsewhere on the board
/A523 Display DSI/DSI.CKP: U201.A26 (PD4); also elsewhere on the board
/A523 Display DSI/DSI.D0N: U201.B24 (PD1); also elsewhere on the board
/A523 Display DSI/DSI.D0P: U201.A24 (PD0); also elsewhere on the board
/A523 Display DSI/DSI.D1N: U201.B25 (PD3); also elsewhere on the board
/A523 Display DSI/DSI.D1P: U201.A25 (PD2); also elsewhere on the board
GND: C262.2, C263.2, C264.2, C265.2; also elsewhere on the board
VCC_1V8: C264.1, U201.K21 (VCC-LVDS0); also elsewhere on the board
VCC_3V3: C262.1, C263.1, U201.J23 (VCC-PD); also elsewhere on the board

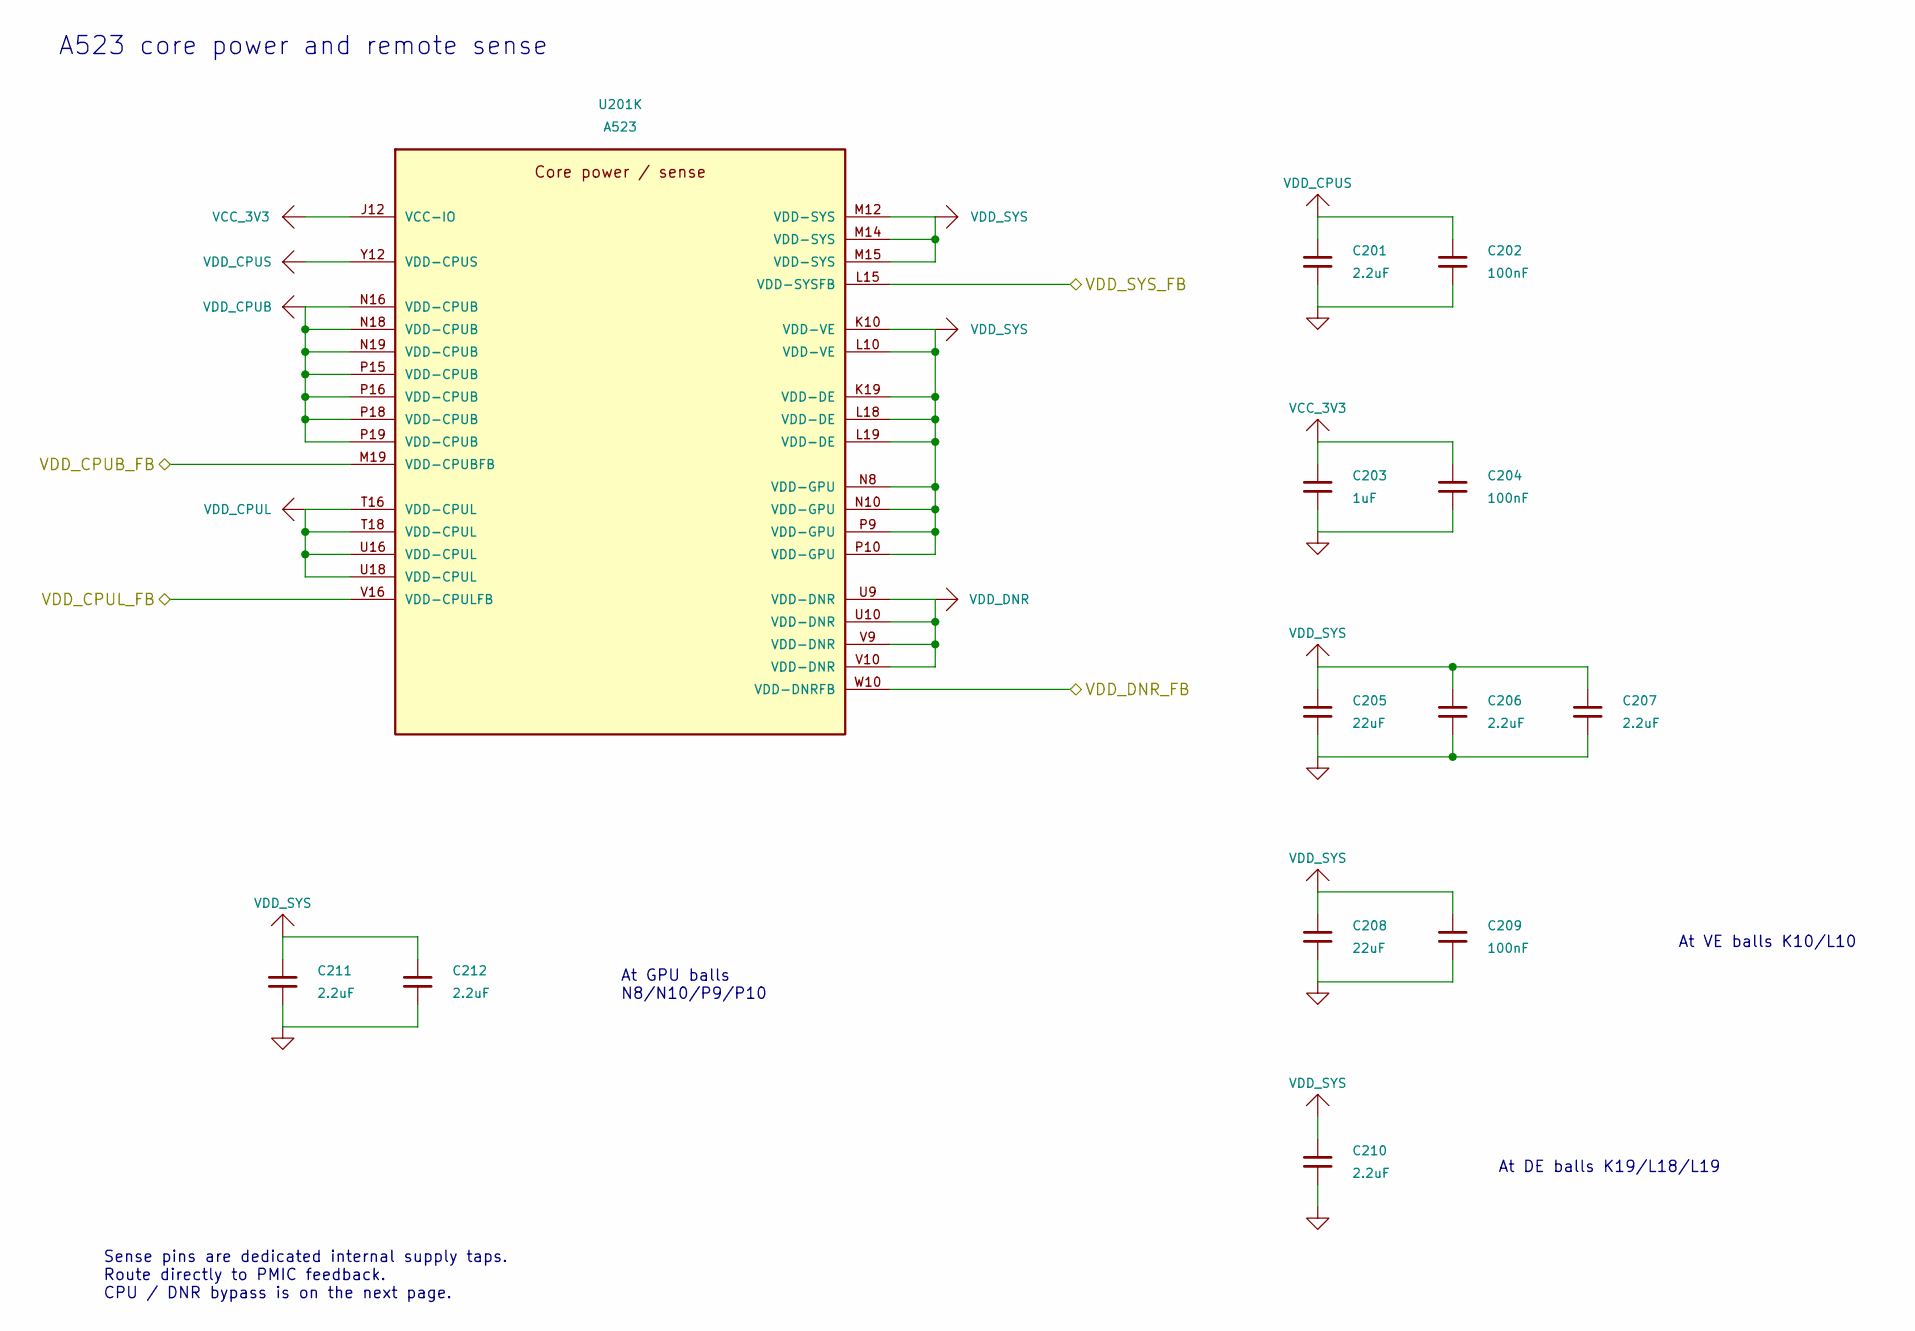
[picture p437: schematic a523_core.kicad_sch, A523 - core supplies and sense]

Parts:
C201, C206, C207, C210, C211, C212: 2.2uF; C_0402_1005Metric; Voltage 10V
C202, C204, C209: 100nF; C_0201_0603Metric; Voltage 10V
C203: 1uF; C_0402_1005Metric; Voltage 10V
C205, C208: 22uF; C_0402_1005Metric; Voltage 10V
U201: A523; Allwinner_A523_FCCSP-522_15x15mm_P0.5mm

Connections:
/VDD_CPUB_FB: U201.M19 (VDD-CPUBFB); also elsewhere on the board
/VDD_CPUL_FB: U201.V16 (VDD-CPULFB); also elsewhere on the board
/VDD_DNR_FB: U201.W10 (VDD-DNRFB); also elsewhere on the board
/VDD_SYS_FB: U201.L15 (VDD-SYSFB); also elsewhere on the board
GND: C201.2, C202.2, C203.2, C204.2, C205.2, C206.2, C207.2, C208.2, C209.2, C210.2, C211.2, C212.2; also elsewhere on the board
VCC_3V3: C203.1, C204.1, U201.J12 (VCC-IO); also elsewhere on the board
VDD_CPUB: U201.N16 (VDD-CPUB), U201.N18 (VDD-CPUB), U201.N19 (VDD-CPUB), U201.P15 (VDD-CPUB), U201.P16 (VDD-CPUB), U201.P18 (VDD-CPUB), U201.P19 (VDD-CPUB); also elsewhere on the board
VDD_CPUL: U201.T16 (VDD-CPUL), U201.T18 (VDD-CPUL), U201.U16 (VDD-CPUL), U201.U18 (VDD-CPUL); also elsewhere on the board
VDD_CPUS: C201.1, C202.1, U201.Y12 (VDD-CPUS); also elsewhere on the board
VDD_DNR: U201.U9 (VDD-DNR), U201.U10 (VDD-DNR), U201.V9 (VDD-DNR), U201.V10 (VDD-DNR); also elsewhere on the board
VDD_SYS: C205.1, C206.1, C207.1, C208.1, C209.1, C210.1, C211.1, C212.1, U201.K10 (VDD-VE), U201.K19 (VDD-DE), U201.L10 (VDD-VE), U201.L18 (VDD-DE), U201.L19 (VDD-DE), U201.M12 (VDD-SYS), U201.M14 (VDD-SYS), U201.M15 (VDD-SYS), U201.N8 (VDD-GPU), U201.N10 (VDD-GPU), U201.P9 (VDD-GPU), U201.P10 (VDD-GPU); also elsewhere on the board

Notes on the sheet:
At GPU balls N8/N10/P9/P10
A523 core power and remote sense
Sense pins are dedicated internal supply taps. Route directly to PMIC feedback. CPU / DNR bypass is on the next page.
At DE balls K19/L18/L19
At VE balls K10/L10

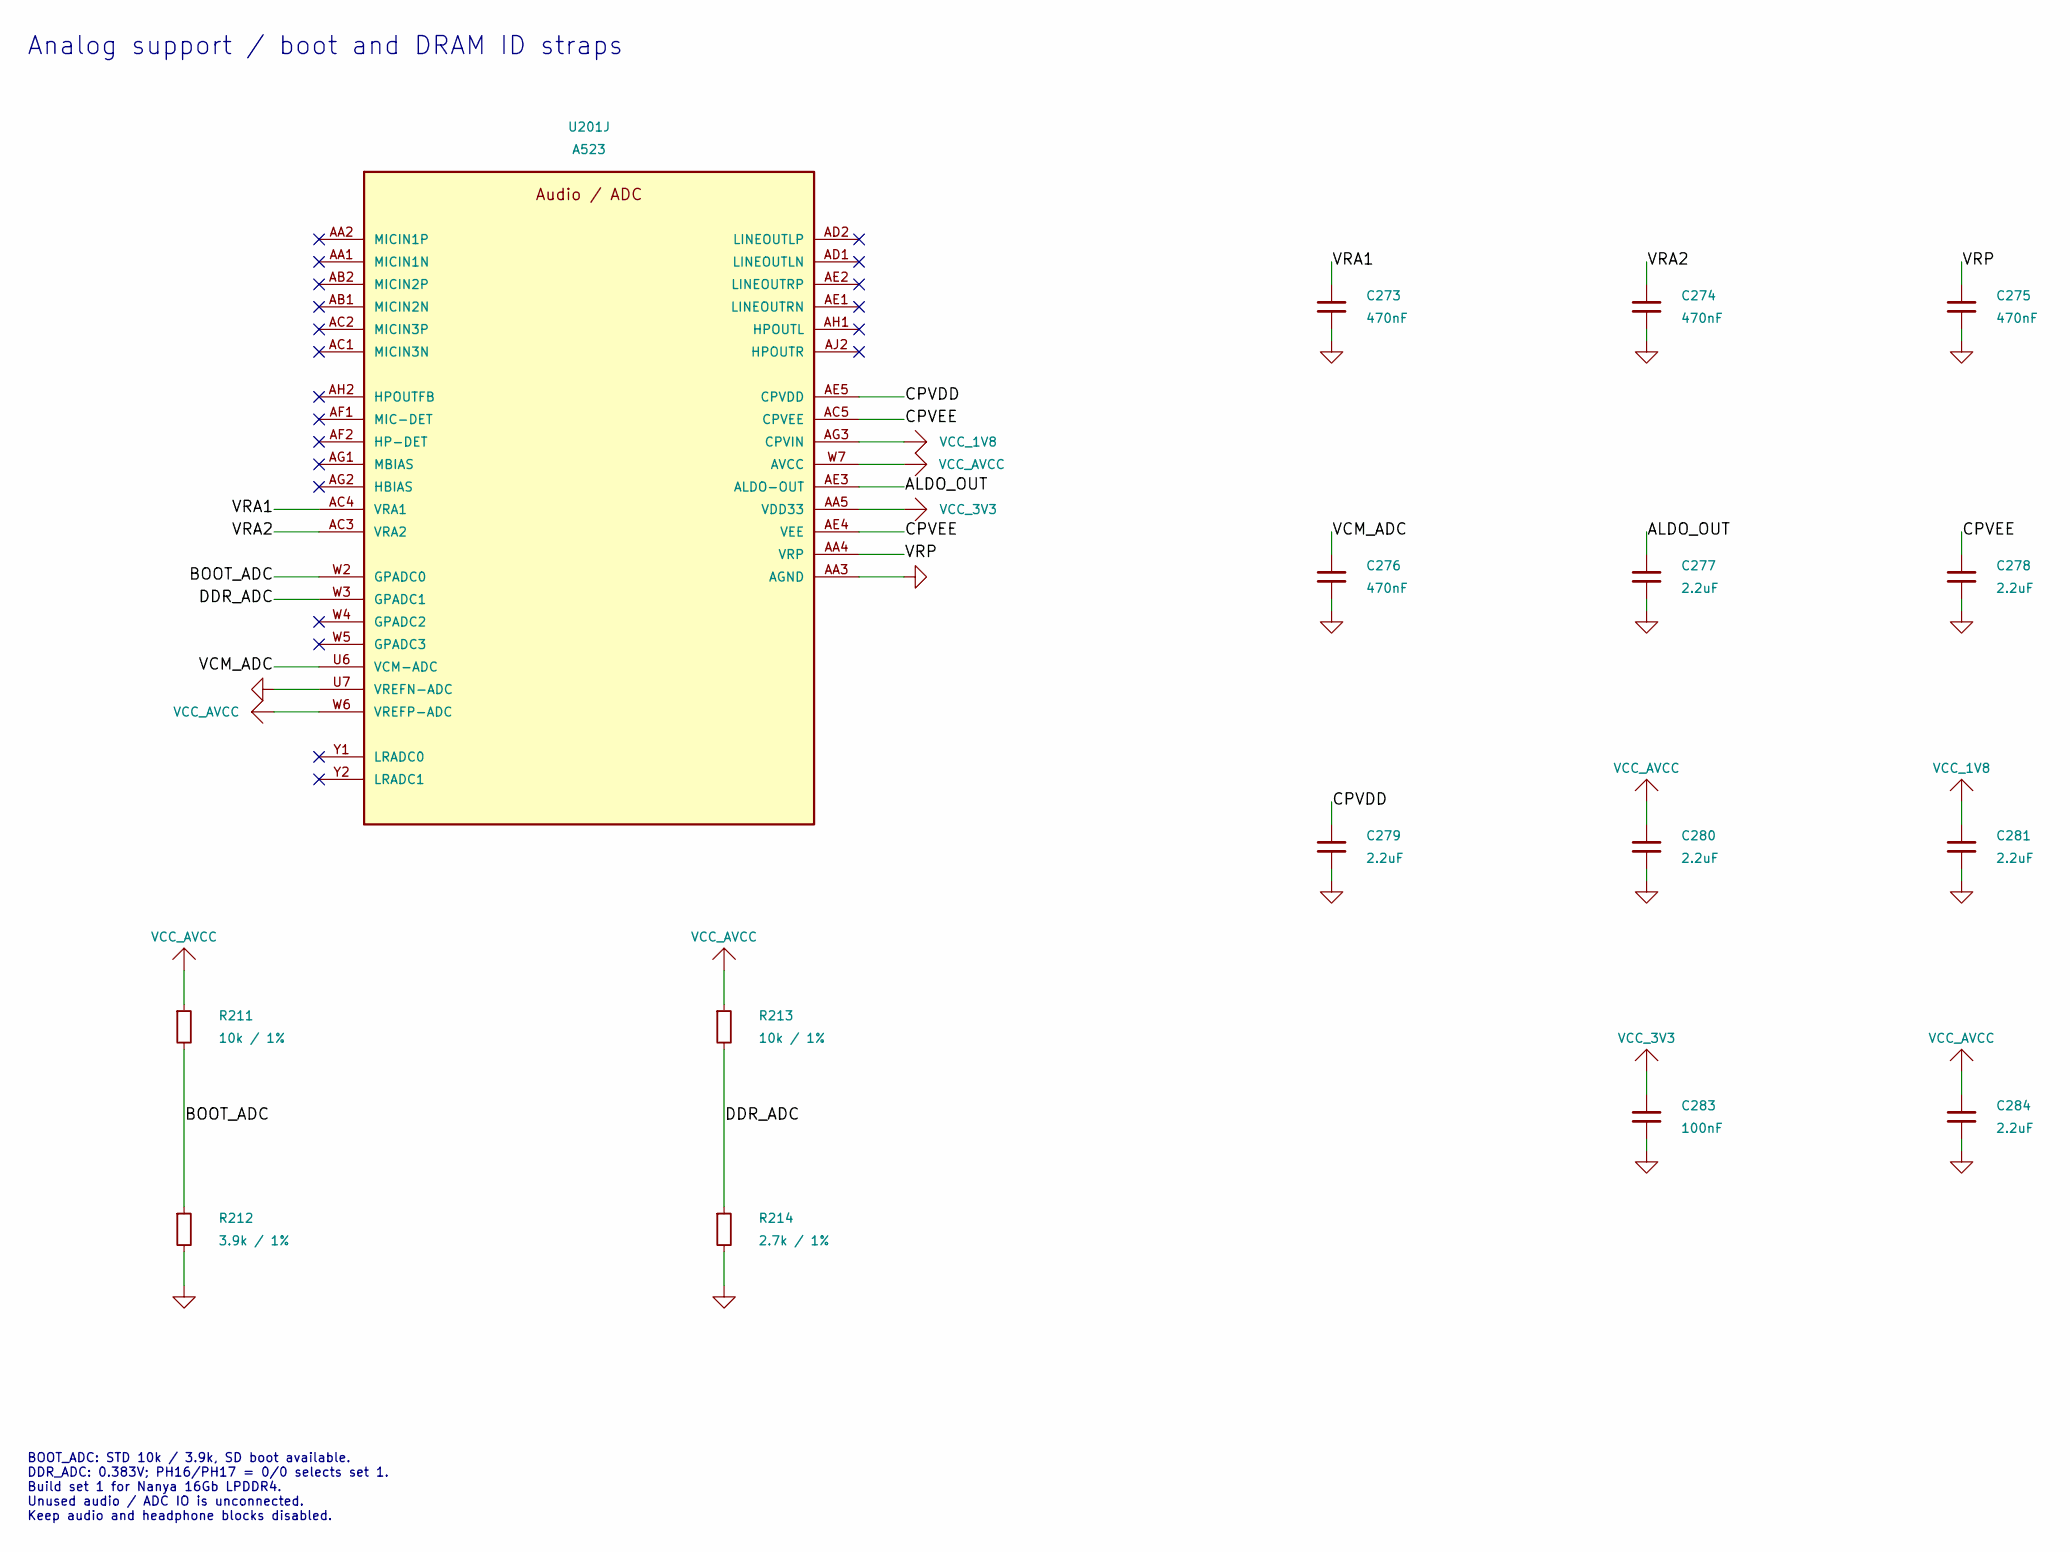
[picture p438: schematic a523_analog.kicad_sch, A523 - analog rails and boot selection]

Parts:
C273, C274, C275, C276: 470nF; C_0402_1005Metric; Voltage 10V
C277, C278, C279, C280, C281, C284: 2.2uF; C_0402_1005Metric; Voltage 10V
C283: 100nF; C_0201_0603Metric; Voltage 10V
R211, R213: 10k / 1%; R_0402_1005Metric
R212: 3.9k / 1%; R_0402_1005Metric
R214: 2.7k / 1%; R_0402_1005Metric
U201: A523; Allwinner_A523_FCCSP-522_15x15mm_P0.5mm

Connections:
/A523 Analog straps/ALDO_OUT: C277.1, U201.AE3 (ALDO-OUT)
/A523 Analog straps/BOOT_ADC: R211.2, R212.1, U201.W2 (GPADC0)
/A523 Analog straps/CPVDD: C279.1, U201.AE5 (CPVDD)
/A523 Analog straps/CPVEE: C278.1, U201.AC5 (CPVEE), U201.AE4 (VEE)
/A523 Analog straps/DDR_ADC: R213.2, R214.1, U201.W3 (GPADC1)
/A523 Analog straps/VCM_ADC: C276.1, U201.U6 (VCM-ADC)
/A523 Analog straps/VRA1: C273.1, U201.AC4 (VRA1)
/A523 Analog straps/VRA2: C274.1, U201.AC3 (VRA2)
/A523 Analog straps/VRP: C275.1, U201.AA4 (VRP)
GND: C273.2, C274.2, C275.2, C276.2, C277.2, C278.2, C279.2, C280.2, C281.2, C283.2, C284.2, R212.2, R214.2, U201.AA3 (AGND), U201.U7 (VREFN-ADC); also elsewhere on the board
VCC_1V8: C281.1, U201.AG3 (CPVIN); also elsewhere on the board
VCC_3V3: C283.1, U201.AA5 (VDD33); also elsewhere on the board
VCC_AVCC: C280.1, C284.1, R211.1, R213.1, U201.W6 (VREFP-ADC), U201.W7 (AVCC); also elsewhere on the board

Notes on the sheet:
Analog support / boot and DRAM ID straps
BOOT_ADC: STD 10k / 3.9k, SD boot available. DDR_ADC: 0.383V; PH16/PH17 = 0/0 selects set 1. Build set 1 for Nanya 16Gb LPDDR4. Unused audio / ADC IO is unconnected. Keep audio and headphone blocks disabled.

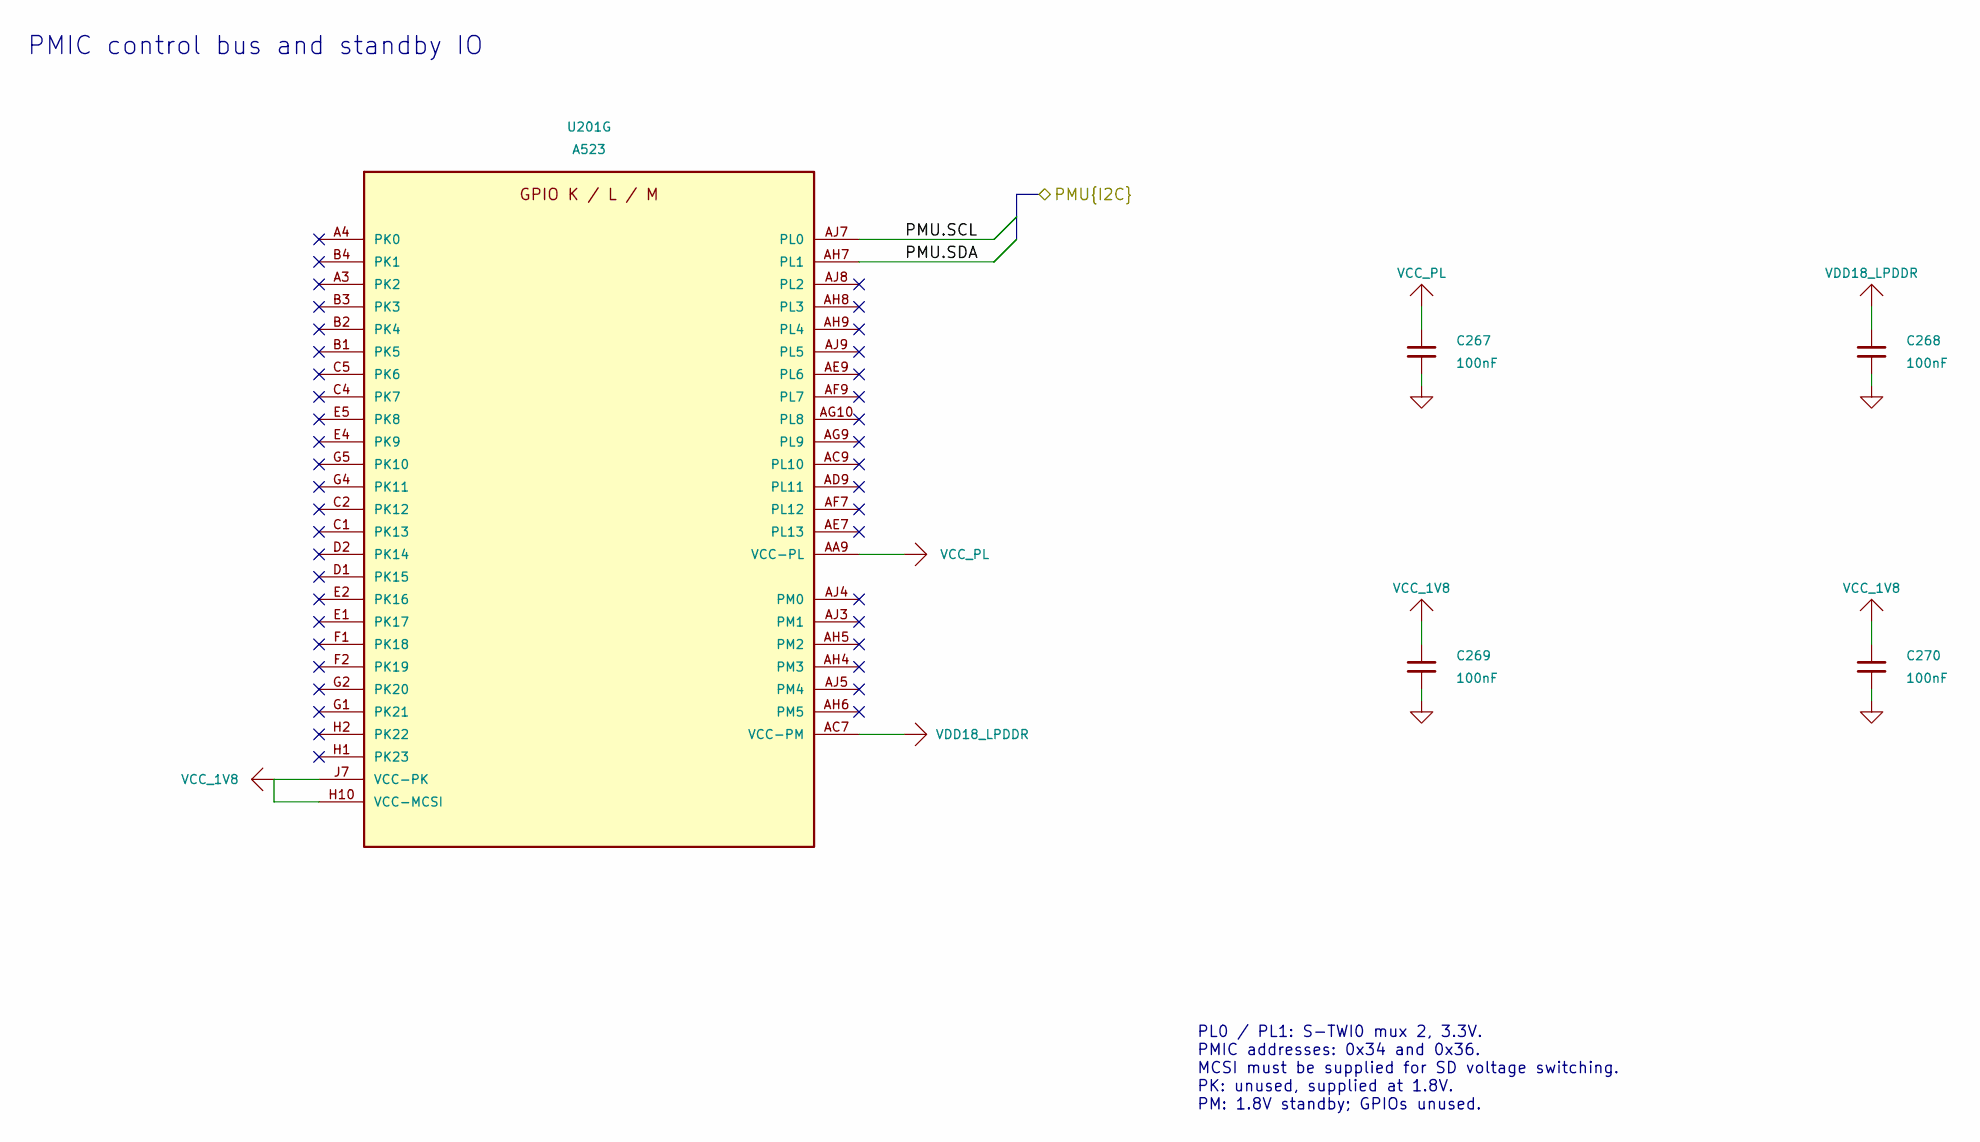
[picture p439: schematic a523_always_on_io.kicad_sch, A523 - always-on IO and PMIC bus]

Parts:
C267, C268, C269, C270: 100nF; C_0201_0603Metric; Voltage 10V
U201: A523; Allwinner_A523_FCCSP-522_15x15mm_P0.5mm

Connections:
/PMU.SCL: U201.AJ7 (PL0); also elsewhere on the board
/PMU.SDA: U201.AH7 (PL1); also elsewhere on the board
GND: C267.2, C268.2, C269.2, C270.2; also elsewhere on the board
VCC_1V8: C269.1, C270.1, U201.H10 (VCC-MCSI), U201.J7 (VCC-PK); also elsewhere on the board
VCC_PL: C267.1, U201.AA9 (VCC-PL); also elsewhere on the board
VDD18_LPDDR: C268.1, U201.AC7 (VCC-PM); also elsewhere on the board

Notes on the sheet:
PMIC control bus and standby IO
PL0 / PL1: S-TWI0 mux 2, 3.3V. PMIC addresses: 0x34 and 0x36. MCSI must be supplied for SD voltage switching. PK: unused, supplied at 1.8V. PM: 1.8V standby; GPIOs unused.

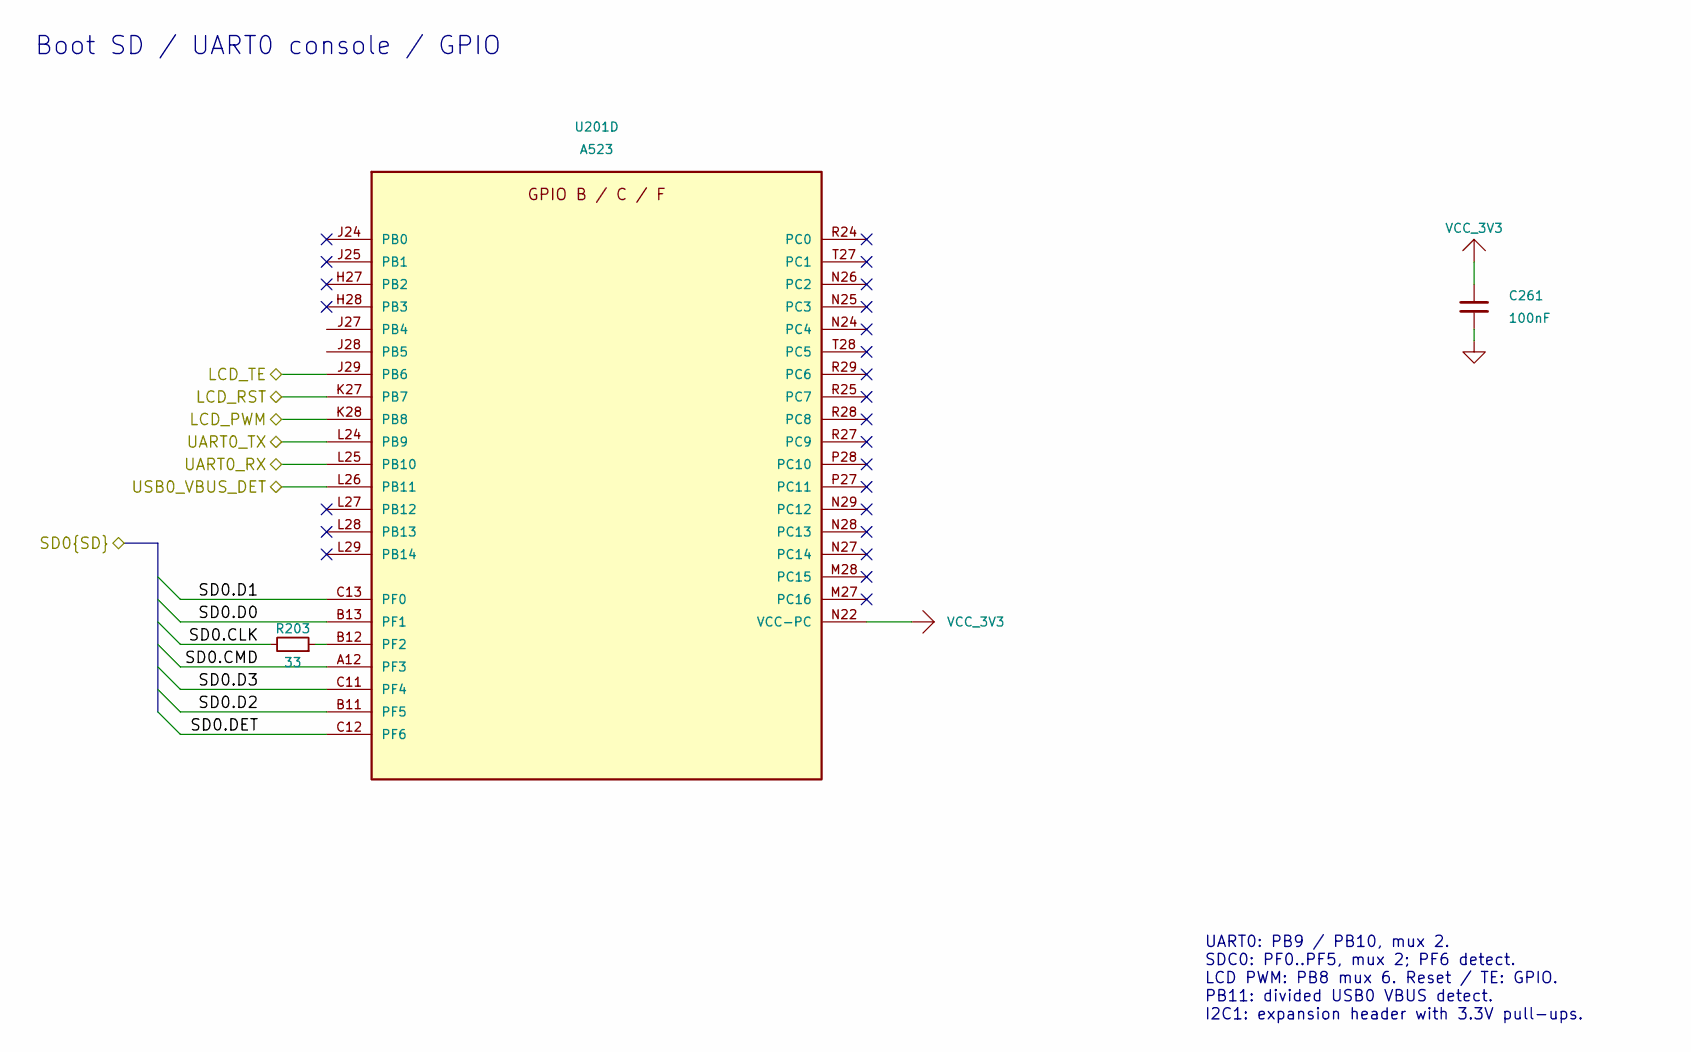
[picture p440: schematic a523_gpio.kicad_sch, A523 - SD card, console and unused storage IO]

Parts:
C261: 100nF; C_0201_0603Metric; Voltage 10V
R203: 33; R_0402_1005Metric
U201: A523; Allwinner_A523_FCCSP-522_15x15mm_P0.5mm

Connections:
/A523 SD and GPIO/SD0.CLK: R203.2; also elsewhere on the board
/A523 SD and GPIO/SD0.CMD: U201.A12 (PF3); also elsewhere on the board
/A523 SD and GPIO/SD0.D0: U201.B13 (PF1); also elsewhere on the board
/A523 SD and GPIO/SD0.D1: U201.C13 (PF0); also elsewhere on the board
/A523 SD and GPIO/SD0.D2: U201.B11 (PF5); also elsewhere on the board
/A523 SD and GPIO/SD0.D3: U201.C11 (PF4); also elsewhere on the board
/A523 SD and GPIO/SD0.DET: U201.C12 (PF6); also elsewhere on the board
/LCD_PWM: U201.K28 (PB8); also elsewhere on the board
/LCD_RST: U201.K27 (PB7); also elsewhere on the board
/LCD_TE: U201.J29 (PB6); also elsewhere on the board
/UART0_RX: U201.L25 (PB10)
/UART0_TX: U201.L24 (PB9)
/USB0_VBUS_DET: U201.L26 (PB11); also elsewhere on the board
GND: C261.2; also elsewhere on the board
unnamed: R203.1, U201.B12 (PF2)
VCC_3V3: C261.1, U201.N22 (VCC-PC); also elsewhere on the board

Notes on the sheet:
Boot SD / UART0 console / GPIO
UART0: PB9 / PB10, mux 2. SDC0: PF0..PF5, mux 2; PF6 detect. LCD PWM: PB8 mux 6. Reset / TE: GPIO. PB11: divided USB0 VBUS detect. I2C1: expansion header with 3.3V pull-ups.
