o7-machinehum/Blackpants/ee/integrated/blackpants.kicad_pcb

## KiCad design ee/integrated/blackpants.kicad_pcb (continued)

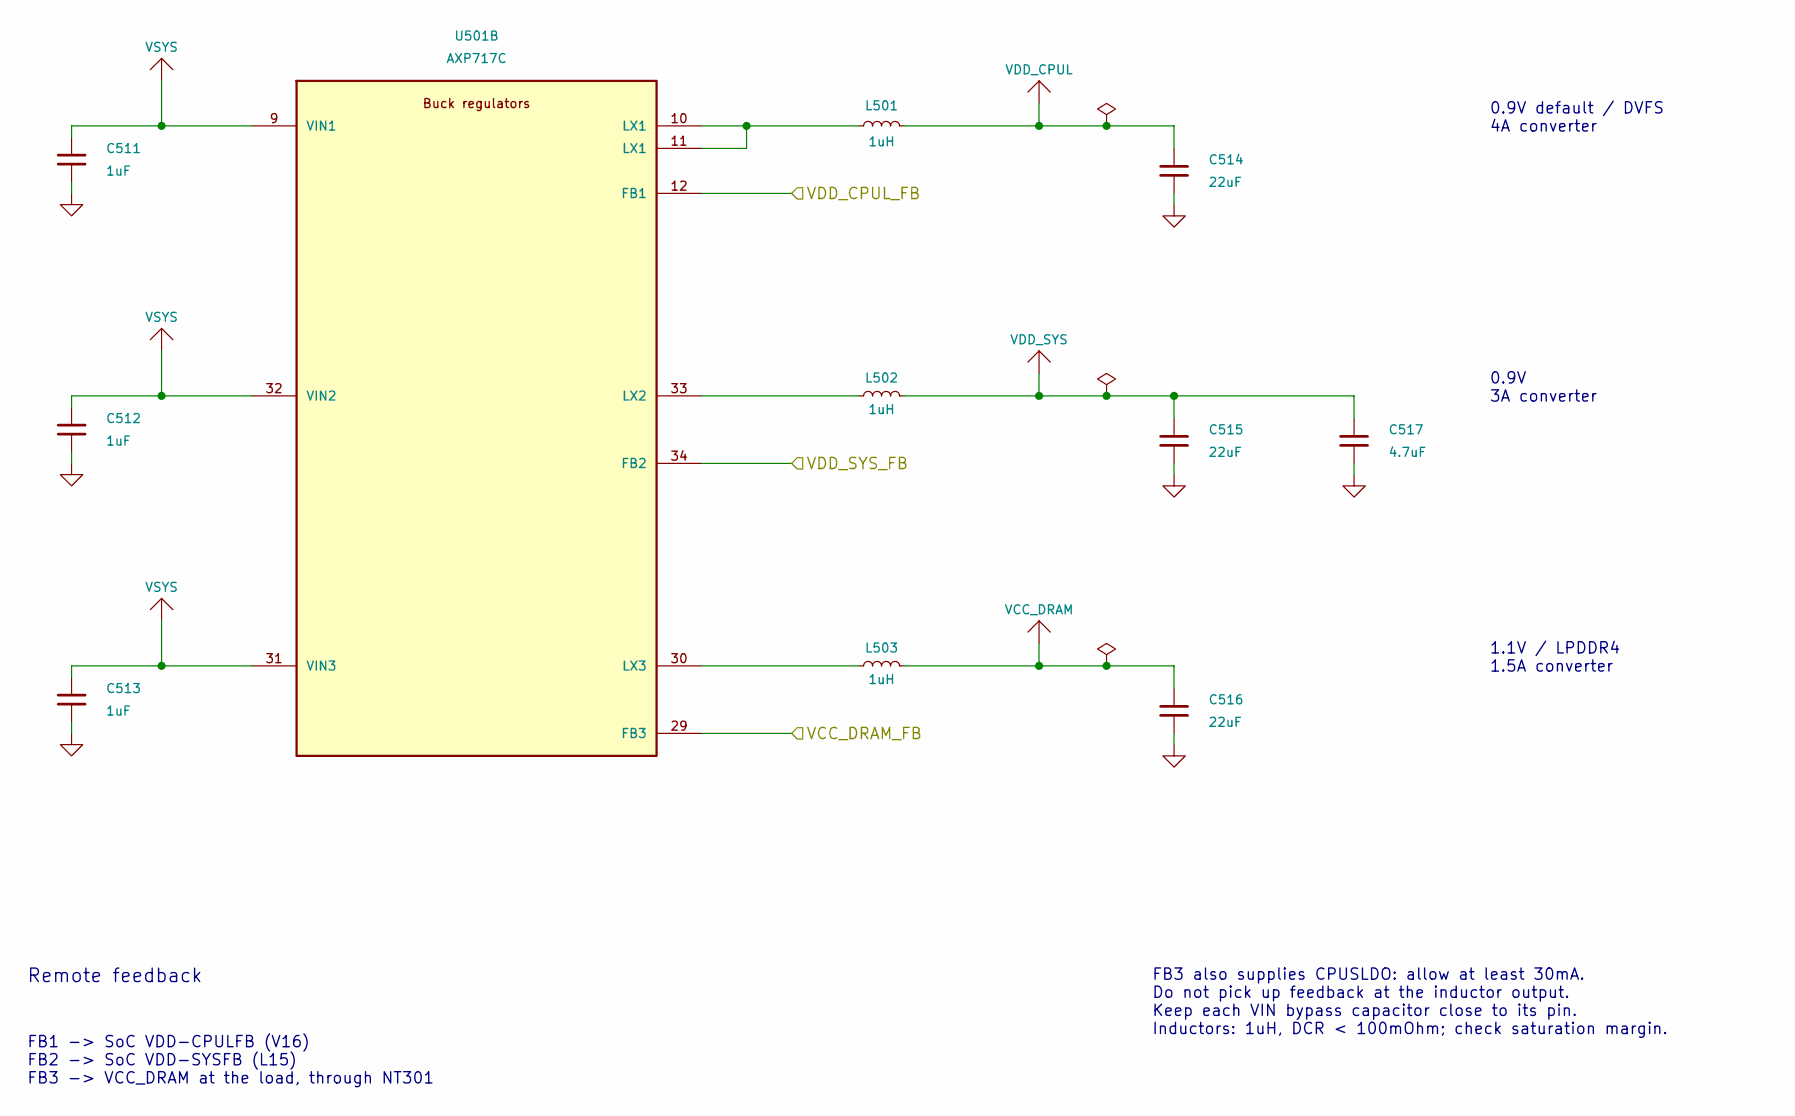
[picture p441: schematic a523_bucks.kicad_sch, A523 - main buck regulators]

Parts:
C511, C512, C513: 1uF; C_0402_1005Metric; Voltage 10V
C514, C515, C516: 22uF; C_0603_1608Metric; Voltage 10V
C517: 4.7uF; C_0402_1005Metric; Voltage 10V
L501, L502, L503: 1uH; L_Coilcraft_XAL4020-XXX; Rating Check peak/RMS current and DC bias at s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; MPN XAL4020-102MEB
U501: AXP717C; QFN-52-1EP_6x6mm_P0.4mm_EP4.6x4.6mm

Connections:
/VCC_DRAM_FB: U501.29 (FB3); also elsewhere on the board
/VDD_CPUL_FB: U501.12 (FB1); also elsewhere on the board
/VDD_SYS_FB: U501.34 (FB2); also elsewhere on the board
GND: C511.2, C512.2, C513.2, C514.2, C515.2, C516.2, C517.2; also elsewhere on the board
unnamed: L501.1, U501.10 (LX1), U501.11 (LX1)
unnamed: L502.1, U501.33 (LX2)
unnamed: L503.1, U501.30 (LX3)
VCC_DRAM: C516.1, L503.2; also elsewhere on the board
VDD_CPUL: C514.1, L501.2; also elsewhere on the board
VDD_SYS: C515.1, C517.1, L502.2; also elsewhere on the board
VSYS: C511.1, C512.1, C513.1, U501.9 (VIN1), U501.31 (VIN3), U501.32 (VIN2); also elsewhere on the board

Notes on the sheet:
FB3 also supplies CPUSLDO: allow at least 30mA. Do not pick up feedback at the inductor output. Keep each VIN bypass capacitor close to its pin. Inductors: 1uH, DCR < 100mOhm; check saturation margin.
Remote feedback
FB1 -> SoC VDD-CPULFB (V16) FB2 -> SoC VDD-SYSFB (L15) FB3 -> VCC_DRAM at the load, through NT301
1.1V / LPDDR4 1.5A converter
0.9V 3A converter
0.9V default / DVFS 4A converter

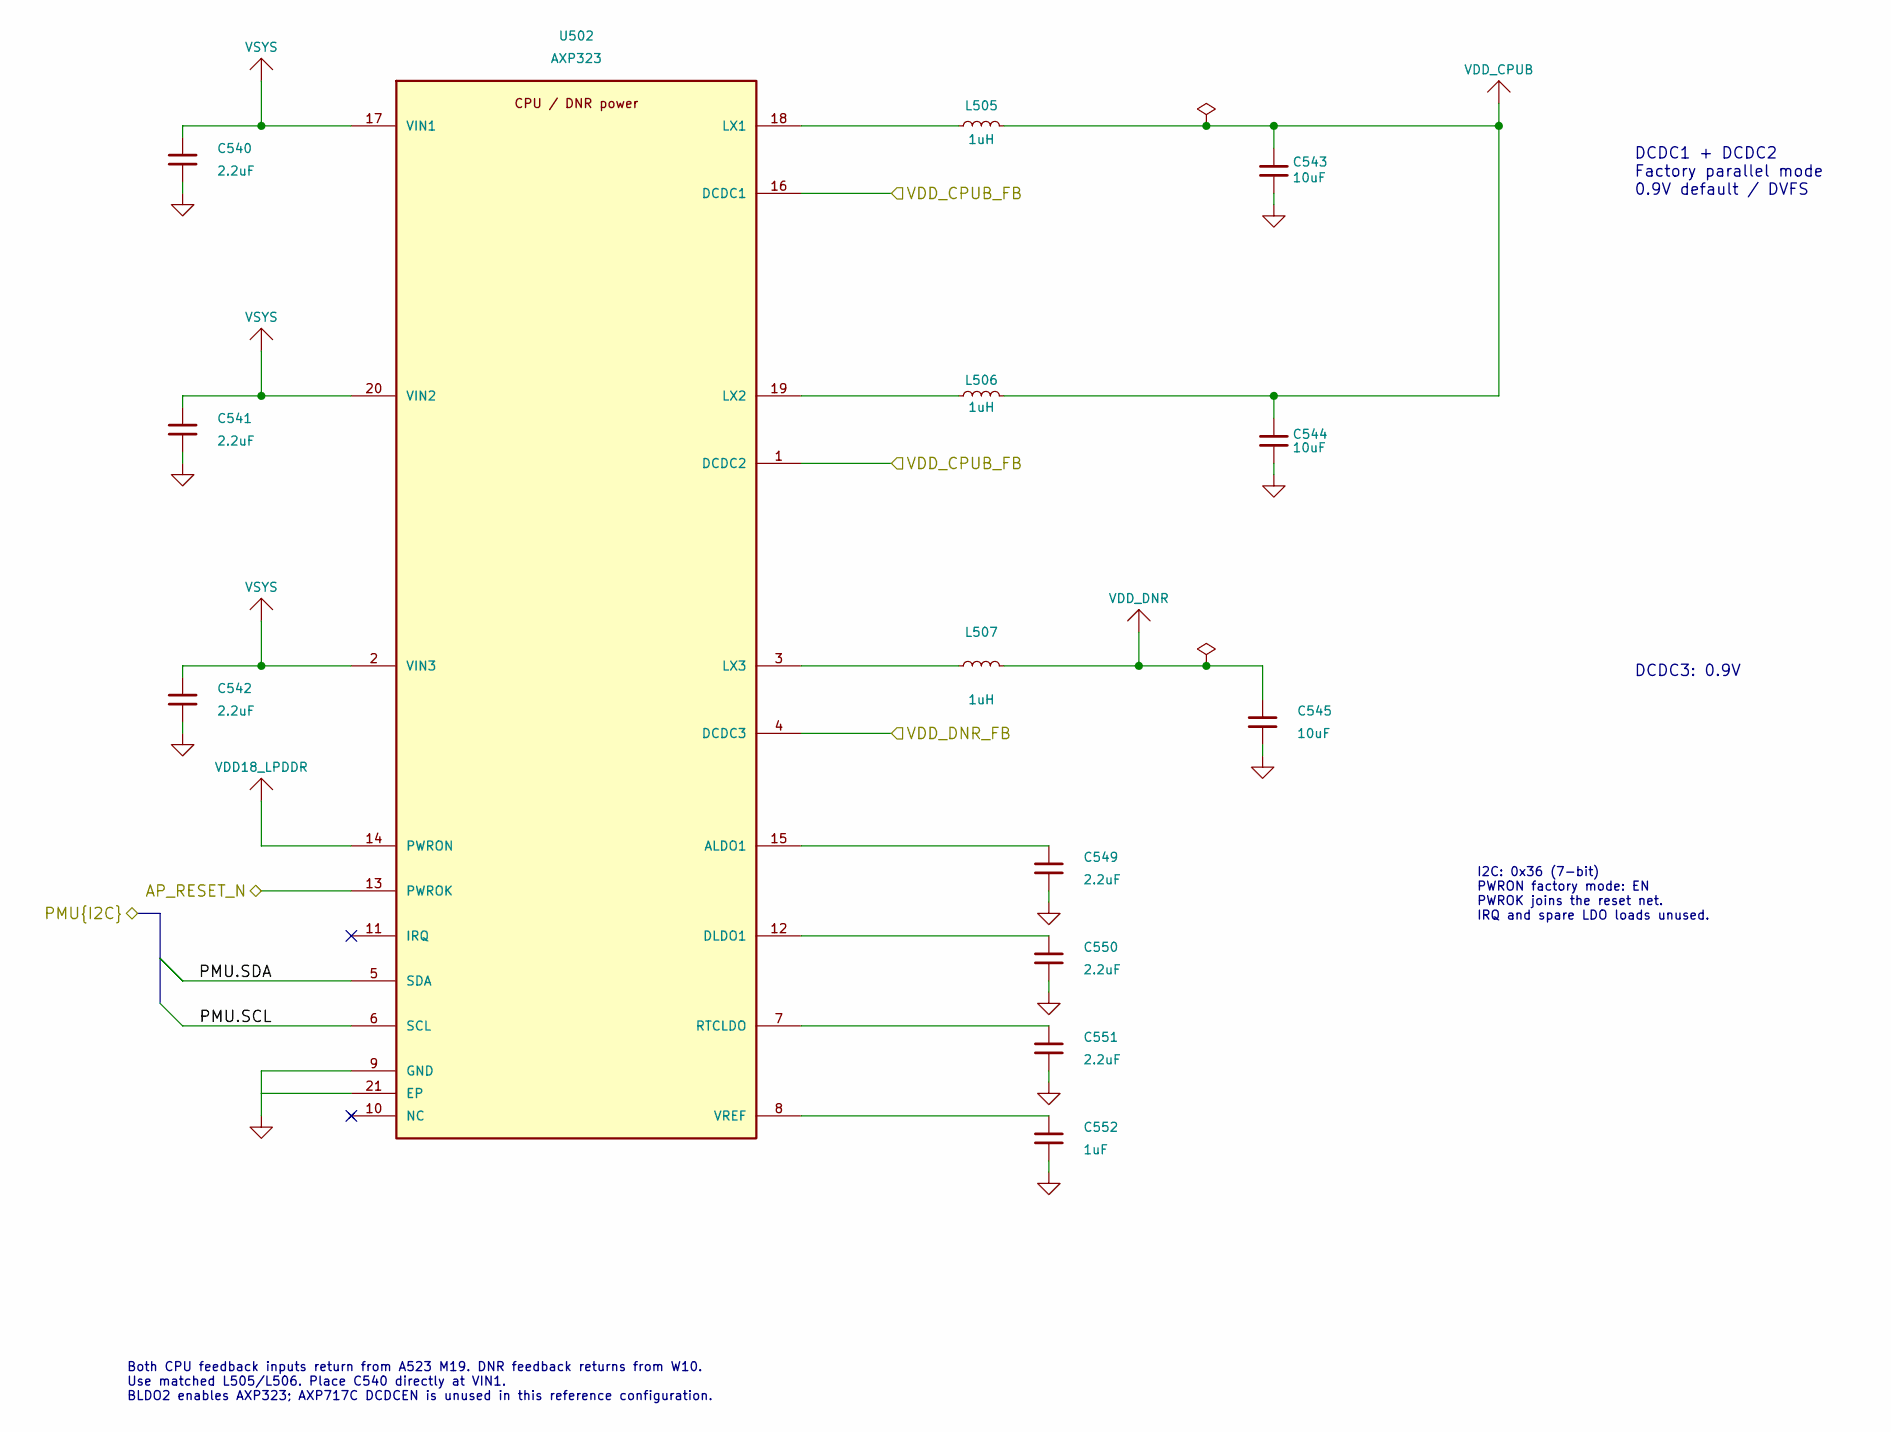
[picture p442: schematic a523_axp323.kicad_sch, A523 - CPU big and DNR supply]

Parts:
C540, C541, C542, C549, C550, C551: 2.2uF; C_0402_1005Metric; Voltage 10V
C543, C544, C545: 10uF; C_0603_1608Metric; Voltage 10V
C552: 1uF; C_0402_1005Metric; Voltage 10V
L505, L506, L507: 1uH; L_Coilcraft_XAL4020-XXX; Rating Check peak/RMS current and DC bias at s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; MPN XAL4020-102MEB
U502: AXP323; QFN-20-1EP_3x3mm_P0.4mm_EP1.65x1.65mm

Connections:
/AP_RESET_N: U502.13 (PWROK); also elsewhere on the board
/PMU.SCL: U502.6 (SCL); also elsewhere on the board
/PMU.SDA: U502.5 (SDA); also elsewhere on the board
/VDD_CPUB_FB: U502.1 (DCDC2), U502.16 (DCDC1); also elsewhere on the board
/VDD_DNR_FB: U502.4 (DCDC3); also elsewhere on the board
GND: C540.2, C541.2, C542.2, C543.2, C544.2, C545.2, C549.2, C550.2, C551.2, C552.2, U502.9 (GND), U502.21 (EP); also elsewhere on the board
unnamed: C549.1, U502.15 (ALDO1)
unnamed: C550.1, U502.12 (DLDO1)
unnamed: L505.1, U502.18 (LX1)
unnamed: L506.1, U502.19 (LX2)
unnamed: L507.1, U502.3 (LX3)
unnamed: C551.1, U502.7 (RTCLDO)
unnamed: C552.1, U502.8 (VREF)
VDD18_LPDDR: U502.14 (PWRON); also elsewhere on the board
VDD_CPUB: C543.1, C544.1, L505.2, L506.2; also elsewhere on the board
VDD_DNR: C545.1, L507.2; also elsewhere on the board
VSYS: C540.1, C541.1, C542.1, U502.2 (VIN3), U502.17 (VIN1), U502.20 (VIN2); also elsewhere on the board

Notes on the sheet:
DCDC1 + DCDC2 Factory parallel mode 0.9V default / DVFS
DCDC3: 0.9V
I2C: 0x36 (7-bit) PWRON factory mode: EN PWROK joins the reset net. IRQ and spare LDO loads unused.
Both CPU feedback inputs return from A523 M19. DNR feedback returns from W10. Use matched L505/L506. Place C540 directly at VIN1. BLDO2 enables AXP323; AXP717C DCDCEN is unused in this reference configuration.

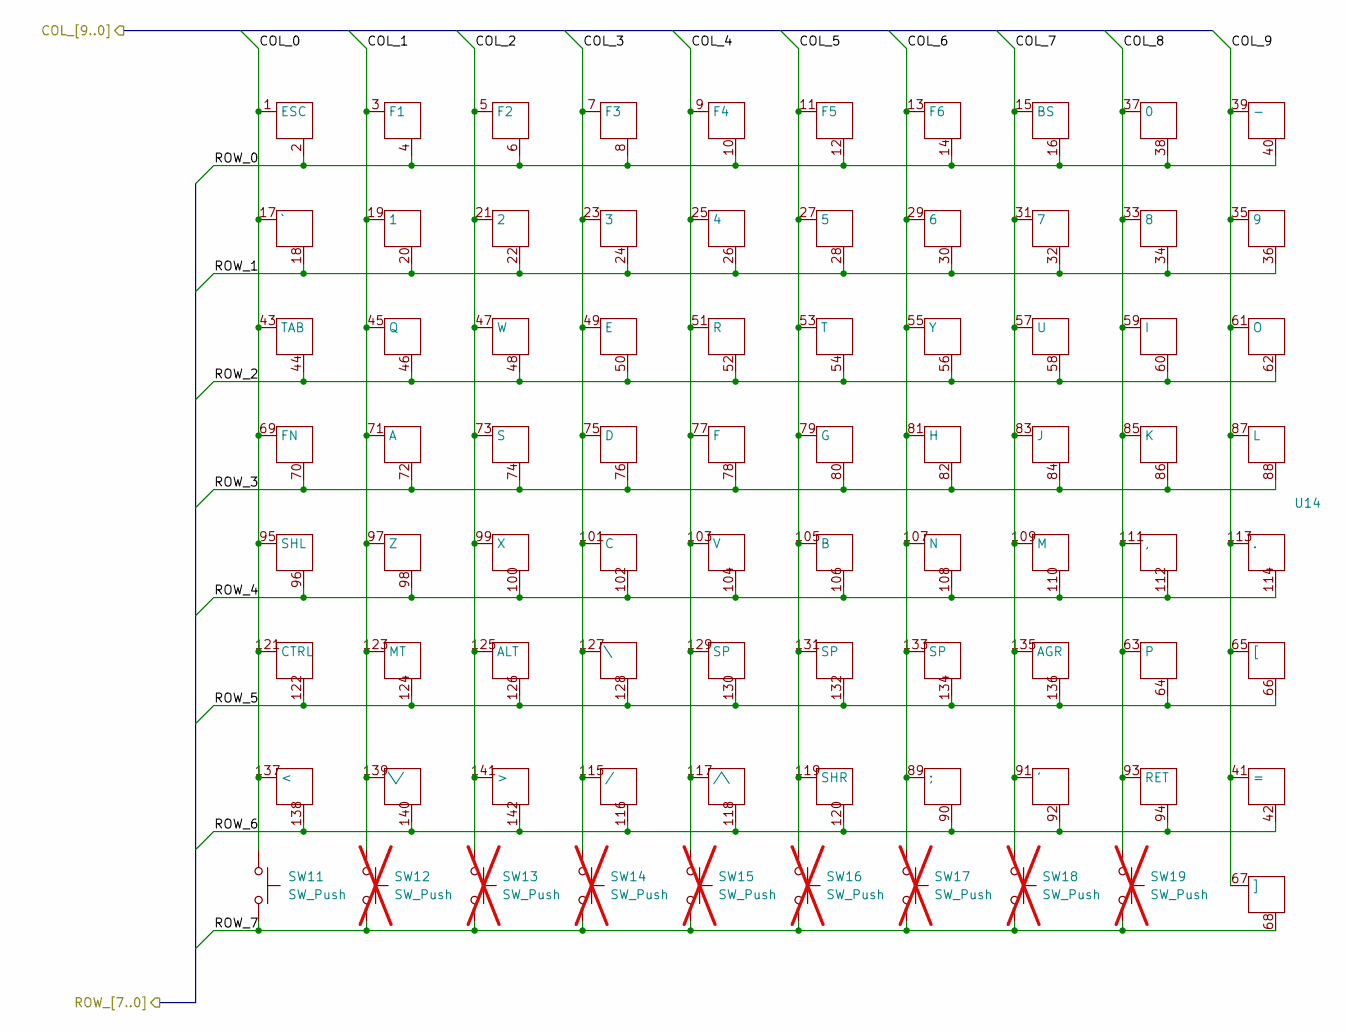
[picture p443: schematic keyboard.kicad_sch, Blackpants]

Parts:
SW11: SW_Push; SW_Push_1P1T_NO_CK_KSC7xxJ
SW12, SW13, SW14, SW15, SW16, SW17, SW18, SW19: SW_Push; SW_Push_1P1T_NO_CK_KSC7xxJ; not fitted
U14: keyboard_arturo182

Connections:
/STM32 + Keyboard/Keyboard/COL_0: SW11.1, U14.1 (ESC), U14.17 (`), U14.43 (TAB), U14.69 (FN), U14.95 (SHL), U14.121 (CTRL), U14.137 (<); also elsewhere on the board
/STM32 + Keyboard/Keyboard/COL_1: SW12.1, U14.3 (F1), U14.19 (1), U14.45 (Q), U14.71 (A), U14.97 (Z), U14.123 (MT), U14.139 (\/); also elsewhere on the board
/STM32 + Keyboard/Keyboard/COL_2: SW13.1, U14.5 (F2), U14.21 (2), U14.47 (W), U14.73 (S), U14.99 (X), U14.125 (ALT), U14.141 (>); also elsewhere on the board
/STM32 + Keyboard/Keyboard/COL_3: SW14.1, U14.7 (F3), U14.23 (3), U14.49 (E), U14.75 (D), U14.101 (C), U14.115 (/), U14.127 (\); also elsewhere on the board
/STM32 + Keyboard/Keyboard/COL_4: SW15.1, U14.9 (F4), U14.25 (4), U14.51 (R), U14.77 (F), U14.103 (V), U14.117 (/\), U14.129 (SP); also elsewhere on the board
/STM32 + Keyboard/Keyboard/COL_5: SW16.1, U14.11 (F5), U14.27 (5), U14.53 (T), U14.79 (G), U14.105 (B), U14.119 (SHR), U14.131 (SP); also elsewhere on the board
/STM32 + Keyboard/Keyboard/COL_6: SW17.1, U14.13 (F6), U14.29 (6), U14.55 (Y), U14.81 (H), U14.89 (;), U14.107 (N), U14.133 (SP); also elsewhere on the board
/STM32 + Keyboard/Keyboard/COL_7: SW18.1, U14.15 (BS), U14.31 (7), U14.57 (U), U14.83 (J), U14.91 ('), U14.109 (M), U14.135 (AGR); also elsewhere on the board
/STM32 + Keyboard/Keyboard/COL_8: SW19.1, U14.33 (8), U14.37 (0), U14.59 (I), U14.63, U14.85 (K), U14.93 (RET), U14.111 (,); also elsewhere on the board
/STM32 + Keyboard/Keyboard/COL_9: U14.35 (9), U14.39 (-), U14.41 (=), U14.61 (O), U14.65 ([), U14.67 (]), U14.87 (L), U14.113 (.); also elsewhere on the board
/STM32 + Keyboard/Keyboard/ROW_0: U14.2, U14.4, U14.6, U14.8, U14.10, U14.12, U14.14, U14.16, U14.38, U14.40; also elsewhere on the board
/STM32 + Keyboard/Keyboard/ROW_1: U14.18, U14.20, U14.22, U14.24, U14.26, U14.28, U14.30, U14.32, U14.34, U14.36; also elsewhere on the board
/STM32 + Keyboard/Keyboard/ROW_2: U14.44, U14.46, U14.48, U14.50, U14.52, U14.54, U14.56, U14.58, U14.60, U14.62; also elsewhere on the board
/STM32 + Keyboard/Keyboard/ROW_3: U14.70, U14.72, U14.74, U14.76, U14.78, U14.80, U14.82, U14.84, U14.86, U14.88; also elsewhere on the board
/STM32 + Keyboard/Keyboard/ROW_4: U14.96, U14.98, U14.100, U14.102, U14.104, U14.106, U14.108, U14.110, U14.112, U14.114; also elsewhere on the board
/STM32 + Keyboard/Keyboard/ROW_5: U14.64, U14.66, U14.122, U14.124, U14.126, U14.128, U14.130, U14.132, U14.134, U14.136; also elsewhere on the board
/STM32 + Keyboard/Keyboard/ROW_6: U14.42, U14.90, U14.92, U14.94, U14.116, U14.118, U14.120, U14.138, U14.140, U14.142; also elsewhere on the board
/STM32 + Keyboard/Keyboard/ROW_7: SW11.2, SW12.2, SW13.2, SW14.2, SW15.2, SW16.2, SW17.2, SW18.2, SW19.2, U14.68; also elsewhere on the board

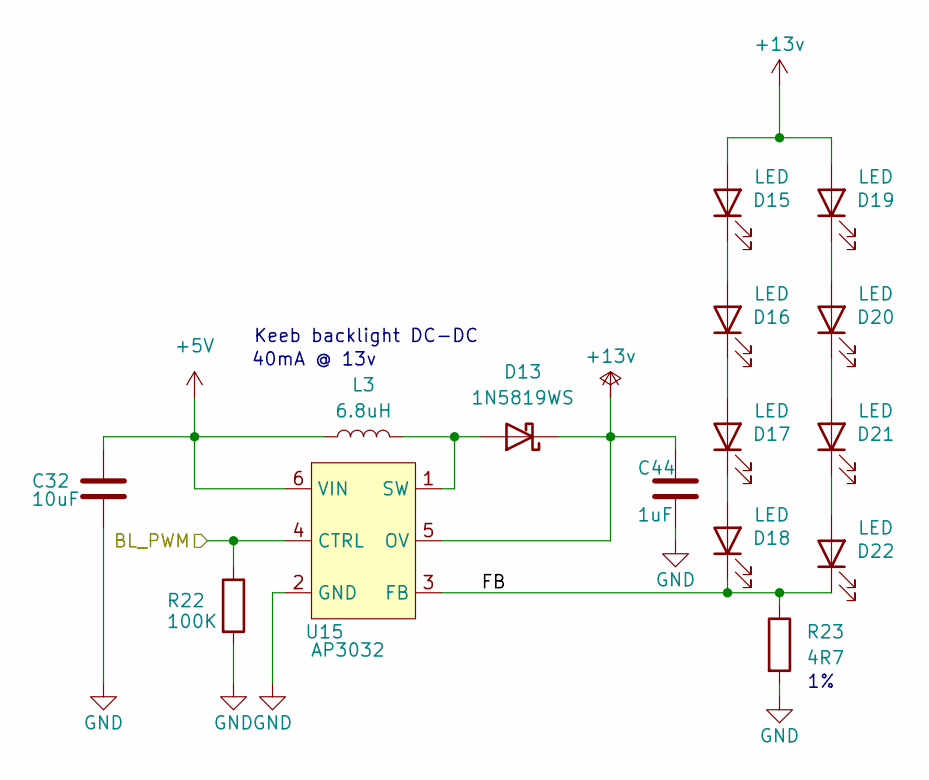
[picture p444: schematic dsi_bridge.kicad_sch, Blackpants]

Parts:
C32: 10uF; C_0603_1608Metric; MPN CL10A106MA8NRNC
C44: 1uF; C_0402_1005Metric; MPN CL05B105KQ5NQNC
D13: 1N5819WS; D_SOD-323; MPN 1N5819WS
D15, D16, D17, D18, D19, D20, D21, D22: LED; LTW-010DCG; MPN LTW-010DCG
L3: 6.8uH; L_Vishay_IFSC-1515AH_4x4x1.8mm; MPN IFSC1515AHER6R8M01
R22: 100K; R_0402_1005Metric; MPN RC0402FR-13100KL
R23: 4R7; R_0402_1005Metric; MPN 0402WGF470KTCE
U15: AP3032; SOT-23-6_Handsoldering; MPN AP3032KTR-G1

Connections:
+5V: C32.1, L3.1, U15.6 (VIN); also elsewhere on the board
+13v: C44.1, D13.1 (K), D15.2 (A), D19.2 (A), U15.5 (OV)
/STM32 + Keyboard/BL_PWM: R22.1, U15.4 (CTRL); also elsewhere on the board
/STM32 + Keyboard/Keyboard Backlight/FB: D18.1 (K), D22.1 (K), R23.1, U15.3 (FB)
GND: C32.2, C44.2, R22.2, R23.2, U15.2 (GND); also elsewhere on the board
unnamed: D13.2 (A), L3.2, U15.1 (SW)
unnamed: D15.1 (K), D16.2 (A)
unnamed: D16.1 (K), D17.2 (A)
unnamed: D17.1 (K), D18.2 (A)
unnamed: D19.1 (K), D20.2 (A)
unnamed: D20.1 (K), D21.2 (A)
unnamed: D21.1 (K), D22.2 (A)

Notes on the sheet:
40mA @ 13v
Keeb backlight DC-DC

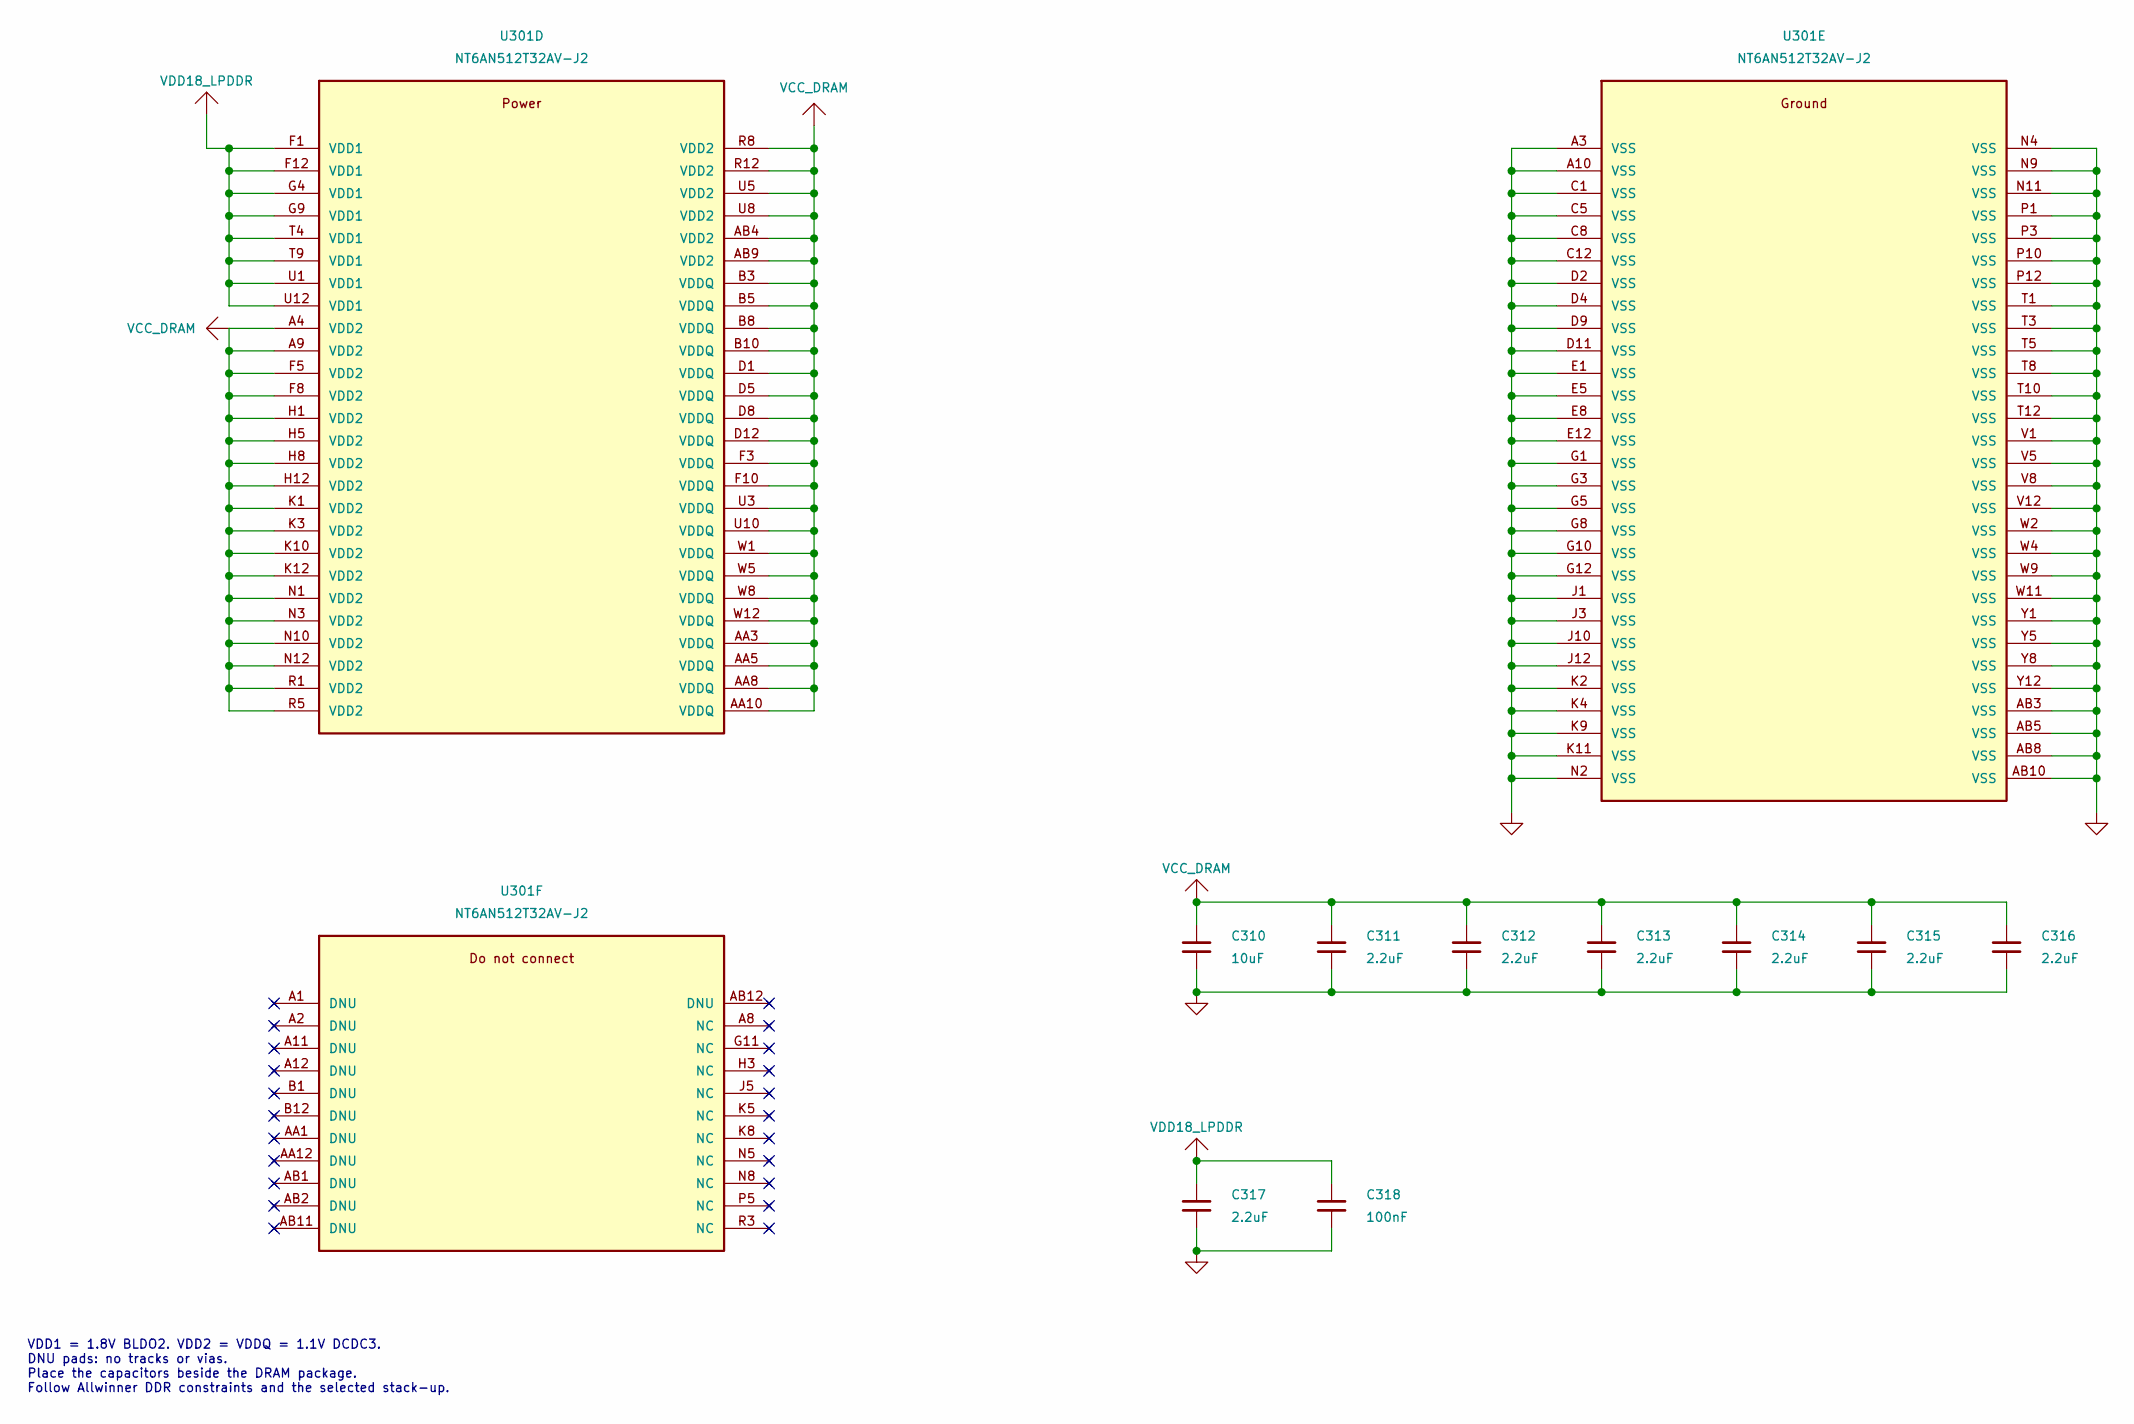
[picture p445: schematic a523_dram_power.kicad_sch, A523 - Nanya LPDDR4 power and ground]

Parts:
C310: 10uF; C_0603_1608Metric; Voltage 10V
C311, C312, C313, C314, C315, C316, C317: 2.2uF; C_0402_1005Metric; Voltage 10V
C318: 100nF; C_0402_1005Metric; Voltage 10V
U301: NT6AN512T32AV-J2; FBGA-200_10x15mm_P0.8x0.65mm

Connections:
GND: C310.2, C311.2, C312.2, C313.2, C314.2, C315.2, C316.2, C317.2, C318.2, U301.A3 (VSS), U301.A10 (VSS), U301.AB3 (VSS), U301.AB5 (VSS), U301.AB8 (VSS), U301.AB10 (VSS), U301.C1 (VSS), U301.C5 (VSS), U301.C8 (VSS), U301.C12 (VSS), U301.D2 (VSS), U301.D4 (VSS), U301.D9 (VSS), U301.D11 (VSS), U301.E1 (VSS), U301.E5 (VSS), U301.E8 (VSS), U301.E12 (VSS), U301.G1 (VSS), U301.G3 (VSS), U301.G5 (VSS), U301.G8 (VSS), U301.G10 (VSS), U301.G12 (VSS), U301.J1 (VSS), U301.J3 (VSS), U301.J10 (VSS), U301.J12 (VSS), U301.K2 (VSS), U301.K4 (VSS), U301.K9 (VSS), U301.K11 (VSS), U301.N2 (VSS), U301.N4 (VSS), U301.N9 (VSS), U301.N11 (VSS), U301.P1 (VSS), U301.P3 (VSS), U301.P10 (VSS), U301.P12 (VSS), U301.T1 (VSS), U301.T3 (VSS), U301.T5 (VSS), U301.T8 (VSS), U301.T10 (VSS), U301.T12 (VSS), U301.V1 (VSS), U301.V5 (VSS), U301.V8 (VSS), U301.V12 (VSS), U301.W2 (VSS), U301.W4 (VSS), U301.W9 (VSS), U301.W11 (VSS), U301.Y1 (VSS), U301.Y5 (VSS), U301.Y8 (VSS), U301.Y12 (VSS); also elsewhere on the board
VCC_DRAM: C310.1, C311.1, C312.1, C313.1, C314.1, C315.1, C316.1, U301.A4 (VDD2), U301.A9 (VDD2), U301.AA3 (VDDQ), U301.AA5 (VDDQ), U301.AA8 (VDDQ), U301.AA10 (VDDQ), U301.AB4 (VDD2), U301.AB9 (VDD2), U301.B3 (VDDQ), U301.B5 (VDDQ), U301.B8 (VDDQ), U301.B10 (VDDQ), U301.D1 (VDDQ), U301.D5 (VDDQ), U301.D8 (VDDQ), U301.D12 (VDDQ), U301.F3 (VDDQ), U301.F5 (VDD2), U301.F8 (VDD2), U301.F10 (VDDQ), U301.H1 (VDD2), U301.H5 (VDD2), U301.H8 (VDD2), U301.H12 (VDD2), U301.K1 (VDD2), U301.K3 (VDD2), U301.K10 (VDD2), U301.K12 (VDD2), U301.N1 (VDD2), U301.N3 (VDD2), U301.N10 (VDD2), U301.N12 (VDD2), U301.R1 (VDD2), U301.R5 (VDD2), U301.R8 (VDD2), U301.R12 (VDD2), U301.U3 (VDDQ), U301.U5 (VDD2), U301.U8 (VDD2), U301.U10 (VDDQ), U301.W1 (VDDQ), U301.W5 (VDDQ), U301.W8 (VDDQ), U301.W12 (VDDQ); also elsewhere on the board
VDD18_LPDDR: C317.1, C318.1, U301.F1 (VDD1), U301.F12 (VDD1), U301.G4 (VDD1), U301.G9 (VDD1), U301.T4 (VDD1), U301.T9 (VDD1), U301.U1 (VDD1), U301.U12 (VDD1); also elsewhere on the board

Notes on the sheet:
VDD1 = 1.8V BLDO2. VDD2 = VDDQ = 1.1V DCDC3. DNU pads: no tracks or vias. Place the capacitors beside the DRAM package. Follow Allwinner DDR constraints and the selected stack-up.

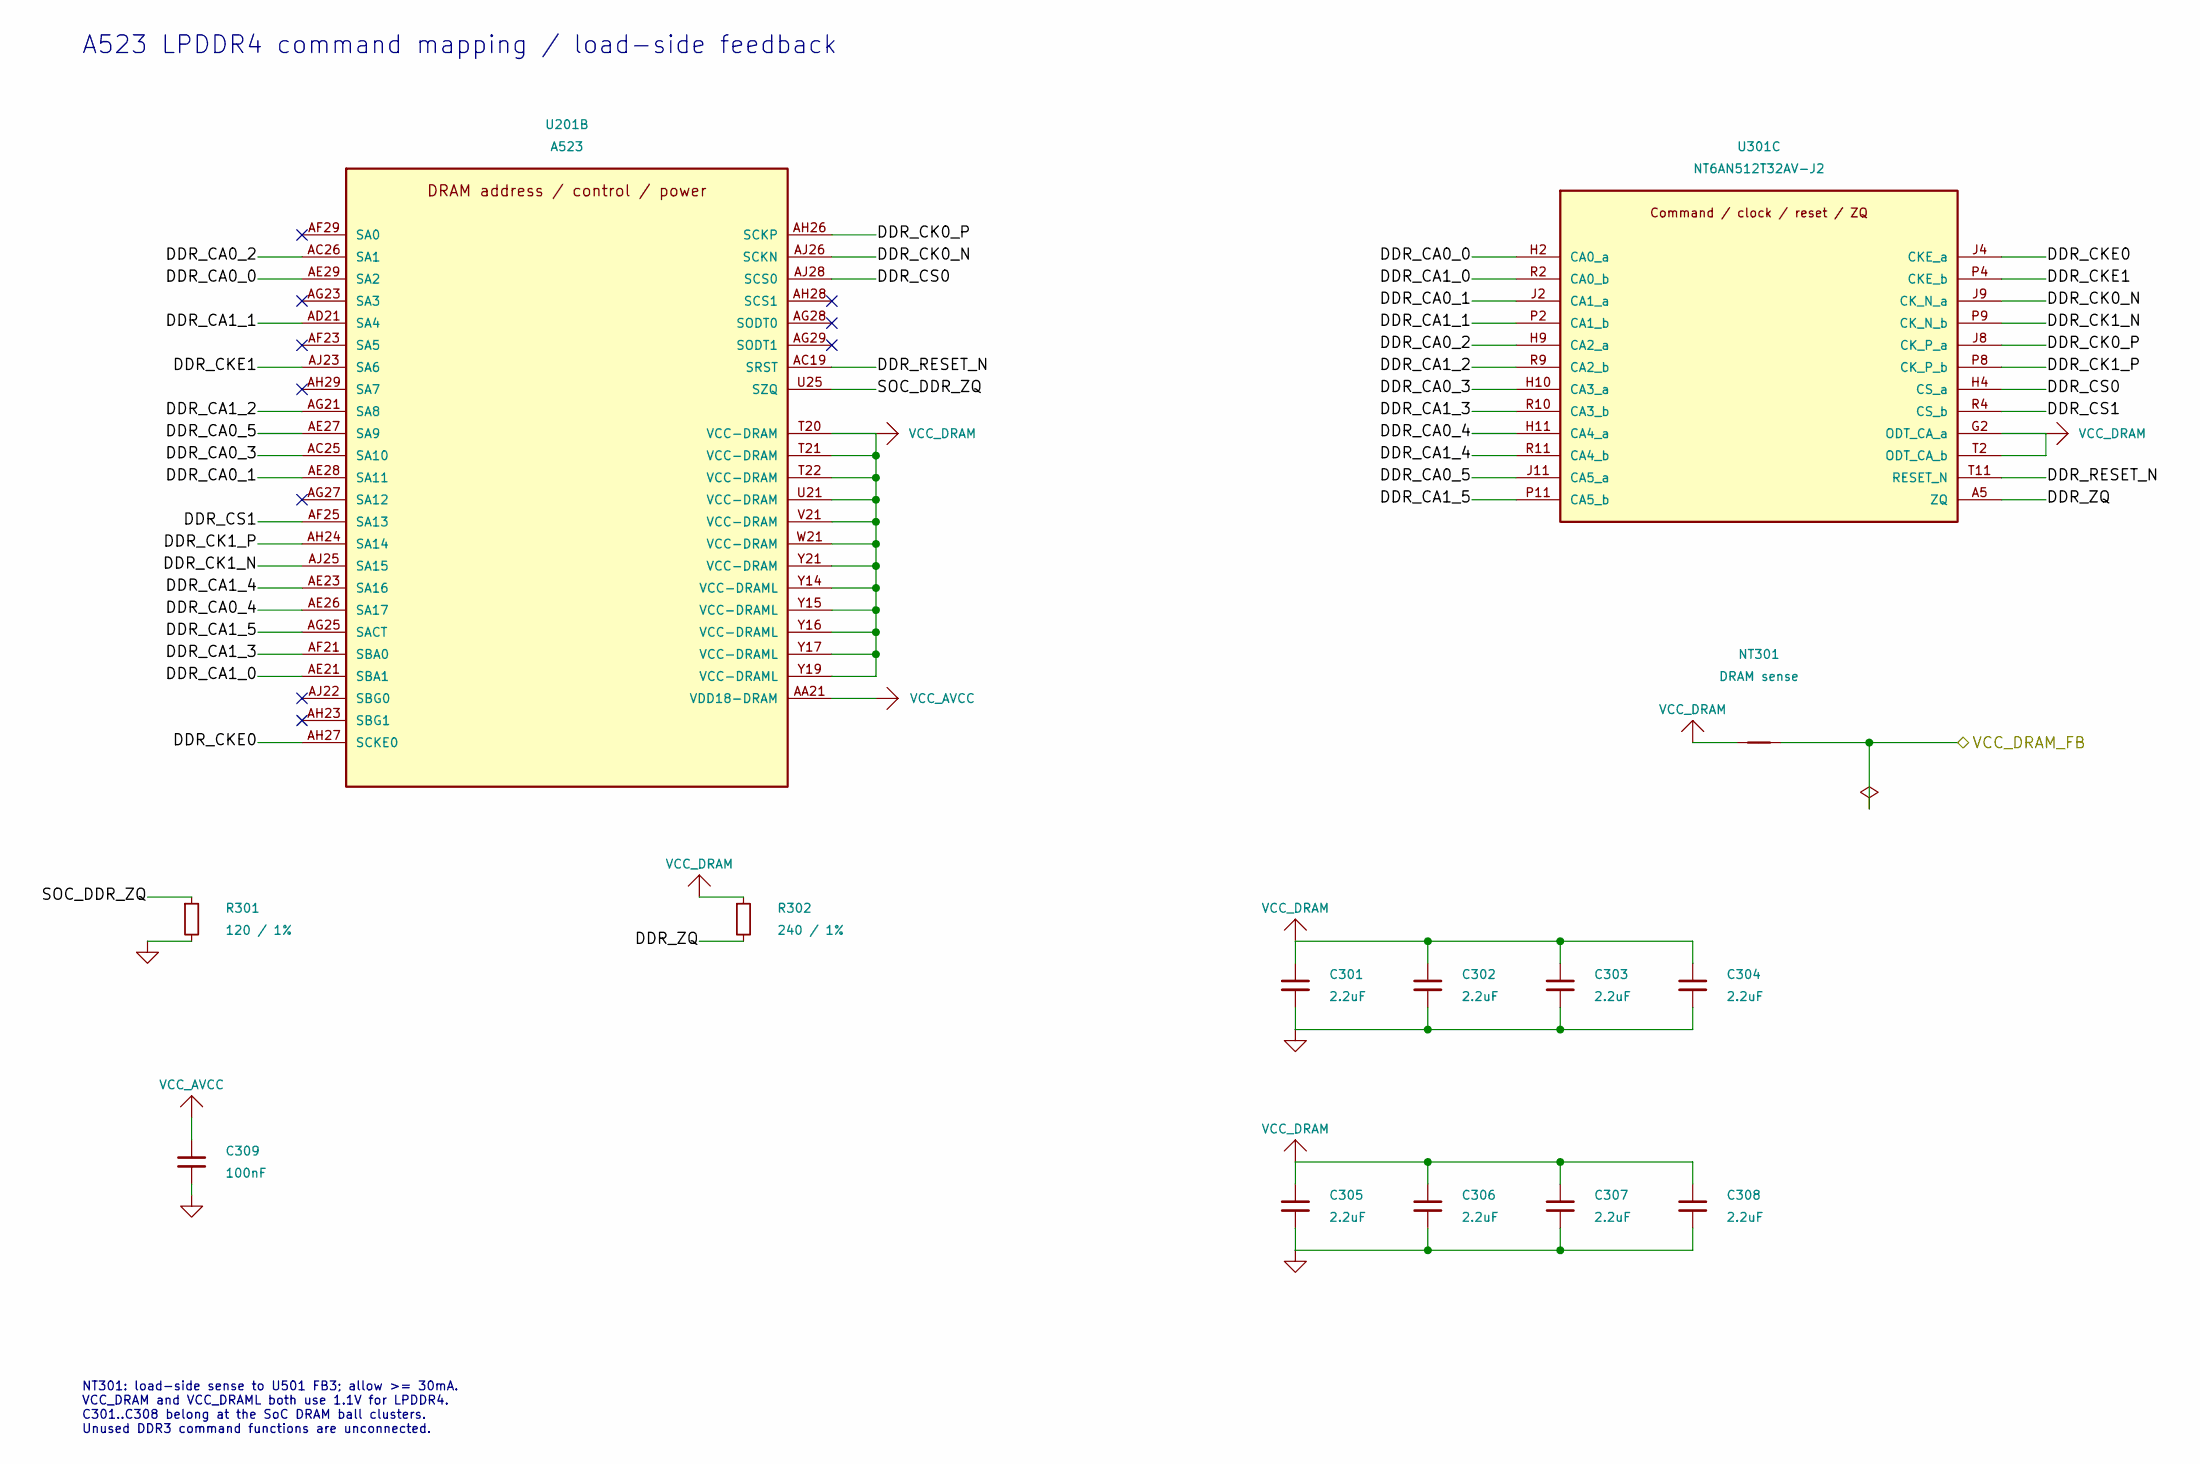
[picture p446: schematic a523_dram_control.kicad_sch, A523 - LPDDR4 command mux and SoC DRAM power]

Parts:
C301, C302, C303, C304, C305, C306, C307, C308: 2.2uF; C_0402_1005Metric; Voltage 10V
C309: 100nF; C_0402_1005Metric; Voltage 10V
NT301: DRAM sense; NetTie-2_SMD_Pad0.5mm
R301: 120 / 1%; R_0402_1005Metric
R302: 240 / 1%; R_0402_1005Metric
U201: A523; Allwinner_A523_FCCSP-522_15x15mm_P0.5mm
U301: NT6AN512T32AV-J2; FBGA-200_10x15mm_P0.8x0.65mm

Connections:
/2GB LPDDR4/Command / DRAM supply/DDR_CA0_0: U201.AE29 (SA2), U301.H2 (CA0_a)
/2GB LPDDR4/Command / DRAM supply/DDR_CA0_1: U201.AE28 (SA11), U301.J2 (CA1_a)
/2GB LPDDR4/Command / DRAM supply/DDR_CA0_2: U201.AC26 (SA1), U301.H9 (CA2_a)
/2GB LPDDR4/Command / DRAM supply/DDR_CA0_3: U201.AC25 (SA10), U301.H10 (CA3_a)
/2GB LPDDR4/Command / DRAM supply/DDR_CA0_4: U201.AE26 (SA17), U301.H11 (CA4_a)
/2GB LPDDR4/Command / DRAM supply/DDR_CA0_5: U201.AE27 (SA9), U301.J11 (CA5_a)
/2GB LPDDR4/Command / DRAM supply/DDR_CA1_0: U201.AE21 (SBA1), U301.R2 (CA0_b)
/2GB LPDDR4/Command / DRAM supply/DDR_CA1_1: U201.AD21 (SA4), U301.P2 (CA1_b)
/2GB LPDDR4/Command / DRAM supply/DDR_CA1_2: U201.AG21 (SA8), U301.R9 (CA2_b)
/2GB LPDDR4/Command / DRAM supply/DDR_CA1_3: U201.AF21 (SBA0), U301.R10 (CA3_b)
/2GB LPDDR4/Command / DRAM supply/DDR_CA1_4: U201.AE23 (SA16), U301.R11 (CA4_b)
/2GB LPDDR4/Command / DRAM supply/DDR_CA1_5: U201.AG25 (SACT), U301.P11 (CA5_b)
/2GB LPDDR4/Command / DRAM supply/DDR_CK0_N: U201.AJ26 (SCKN), U301.J9 (CK_N_a)
/2GB LPDDR4/Command / DRAM supply/DDR_CK0_P: U201.AH26 (SCKP), U301.J8 (CK_P_a)
/2GB LPDDR4/Command / DRAM supply/DDR_CK1_N: U201.AJ25 (SA15), U301.P9 (CK_N_b)
/2GB LPDDR4/Command / DRAM supply/DDR_CK1_P: U201.AH24 (SA14), U301.P8 (CK_P_b)
/2GB LPDDR4/Command / DRAM supply/DDR_CKE0: U201.AH27 (SCKE0), U301.J4 (CKE_a)
/2GB LPDDR4/Command / DRAM supply/DDR_CKE1: U201.AJ23 (SA6), U301.P4 (CKE_b)
/2GB LPDDR4/Command / DRAM supply/DDR_CS0: U201.AJ28 (SCS0), U301.H4 (CS_a)
/2GB LPDDR4/Command / DRAM supply/DDR_CS1: U201.AF25 (SA13), U301.R4 (CS_b)
/2GB LPDDR4/Command / DRAM supply/DDR_RESET_N: U201.AC19 (SRST), U301.T11 (RESET_N)
/2GB LPDDR4/Command / DRAM supply/DDR_ZQ: R302.2, U301.A5 (ZQ)
/2GB LPDDR4/Command / DRAM supply/SOC_DDR_ZQ: R301.1, U201.U25 (SZQ)
/VCC_DRAM_FB: NT301.2; also elsewhere on the board
GND: C301.2, C302.2, C303.2, C304.2, C305.2, C306.2, C307.2, C308.2, C309.2, R301.2; also elsewhere on the board
VCC_AVCC: C309.1, U201.AA21 (VDD18-DRAM); also elsewhere on the board
VCC_DRAM: C301.1, C302.1, C303.1, C304.1, C305.1, C306.1, C307.1, C308.1, NT301.1, R302.1, U201.T20 (VCC-DRAM), U201.T21 (VCC-DRAM), U201.T22 (VCC-DRAM), U201.U21 (VCC-DRAM), U201.V21 (VCC-DRAM), U201.W21 (VCC-DRAM), U201.Y14 (VCC-DRAML), U201.Y15 (VCC-DRAML), U201.Y16 (VCC-DRAML), U201.Y17 (VCC-DRAML), U201.Y19 (VCC-DRAML), U201.Y21 (VCC-DRAM), U301.G2 (ODT_CA_a), U301.T2 (ODT_CA_b); also elsewhere on the board

Notes on the sheet:
A523 LPDDR4 command mapping / load-side feedback
NT301: load-side sense to U501 FB3; allow >= 30mA. VCC_DRAM and VCC_DRAML both use 1.1V for LPDDR4. C301..C308 belong at the SoC DRAM ball clusters. Unused DDR3 command functions are unconnected.
