o7-machinehum/Blackpants/ee/integrated/blackpants.kicad_pcb

## KiCad design ee/integrated/blackpants.kicad_pcb (continued)

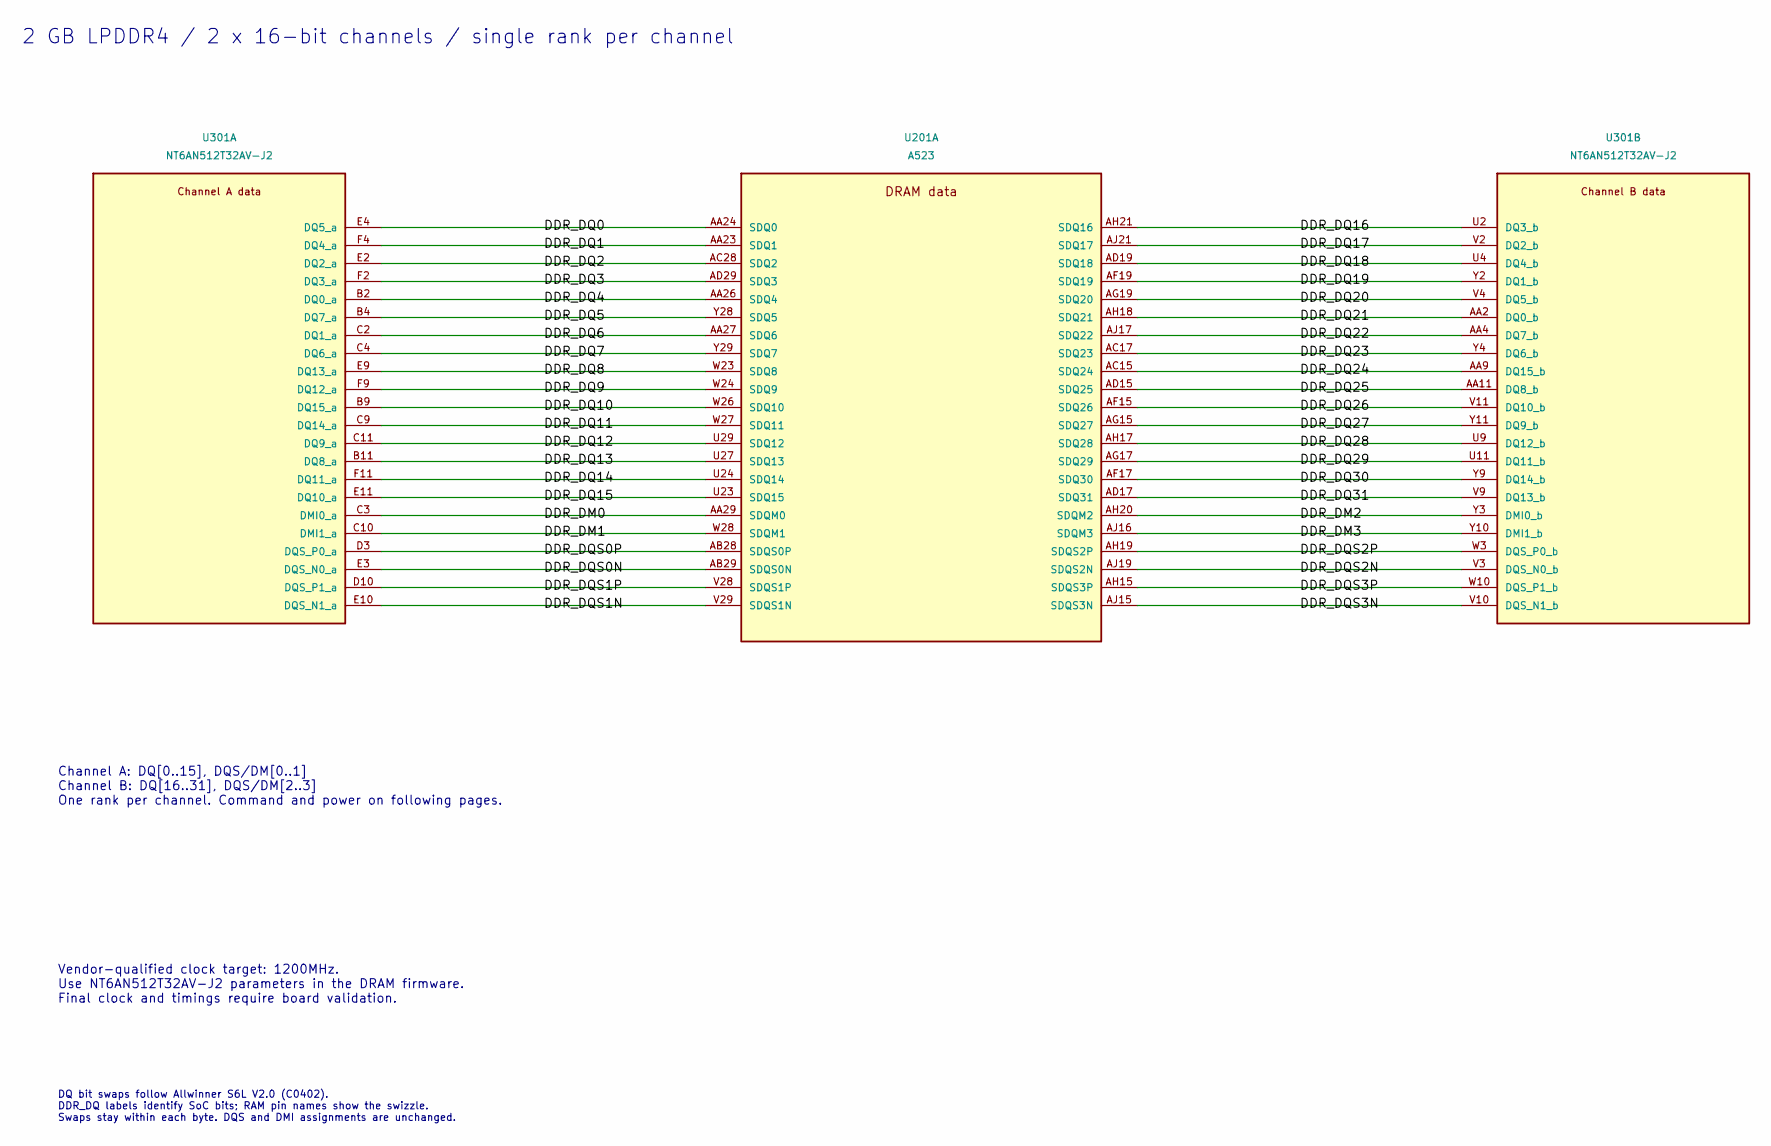
[picture p447: schematic a523_dram_data.kicad_sch, A523 - LPDDR4 data and channel pins]

Parts:
U201: A523; Allwinner_A523_FCCSP-522_15x15mm_P0.5mm
U301: NT6AN512T32AV-J2; FBGA-200_10x15mm_P0.8x0.65mm

Connections:
/2GB LPDDR4/Data channels/DDR_DM0: U201.AA29 (SDQM0), U301.C3 (DMI0_a)
/2GB LPDDR4/Data channels/DDR_DM1: U201.W28 (SDQM1), U301.C10 (DMI1_a)
/2GB LPDDR4/Data channels/DDR_DM2: U201.AH20 (SDQM2), U301.Y3 (DMI0_b)
/2GB LPDDR4/Data channels/DDR_DM3: U201.AJ16 (SDQM3), U301.Y10 (DMI1_b)
/2GB LPDDR4/Data channels/DDR_DQ0: U201.AA24 (SDQ0), U301.E4 (DQ5_a)
/2GB LPDDR4/Data channels/DDR_DQ1: U201.AA23 (SDQ1), U301.F4 (DQ4_a)
/2GB LPDDR4/Data channels/DDR_DQ2: U201.AC28 (SDQ2), U301.E2 (DQ2_a)
/2GB LPDDR4/Data channels/DDR_DQ3: U201.AD29 (SDQ3), U301.F2 (DQ3_a)
/2GB LPDDR4/Data channels/DDR_DQ4: U201.AA26 (SDQ4), U301.B2 (DQ0_a)
/2GB LPDDR4/Data channels/DDR_DQ5: U201.Y28 (SDQ5), U301.B4 (DQ7_a)
/2GB LPDDR4/Data channels/DDR_DQ6: U201.AA27 (SDQ6), U301.C2 (DQ1_a)
/2GB LPDDR4/Data channels/DDR_DQ7: U201.Y29 (SDQ7), U301.C4 (DQ6_a)
/2GB LPDDR4/Data channels/DDR_DQ8: U201.W23 (SDQ8), U301.E9 (DQ13_a)
/2GB LPDDR4/Data channels/DDR_DQ9: U201.W24 (SDQ9), U301.F9 (DQ12_a)
/2GB LPDDR4/Data channels/DDR_DQ10: U201.W26 (SDQ10), U301.B9 (DQ15_a)
/2GB LPDDR4/Data channels/DDR_DQ11: U201.W27 (SDQ11), U301.C9 (DQ14_a)
/2GB LPDDR4/Data channels/DDR_DQ12: U201.U29 (SDQ12), U301.C11 (DQ9_a)
/2GB LPDDR4/Data channels/DDR_DQ13: U201.U27 (SDQ13), U301.B11 (DQ8_a)
/2GB LPDDR4/Data channels/DDR_DQ14: U201.U24 (SDQ14), U301.F11 (DQ11_a)
/2GB LPDDR4/Data channels/DDR_DQ15: U201.U23 (SDQ15), U301.E11 (DQ10_a)
/2GB LPDDR4/Data channels/DDR_DQ16: U201.AH21 (SDQ16), U301.U2 (DQ3_b)
/2GB LPDDR4/Data channels/DDR_DQ17: U201.AJ21 (SDQ17), U301.V2 (DQ2_b)
/2GB LPDDR4/Data channels/DDR_DQ18: U201.AD19 (SDQ18), U301.U4 (DQ4_b)
/2GB LPDDR4/Data channels/DDR_DQ19: U201.AF19 (SDQ19), U301.Y2 (DQ1_b)
/2GB LPDDR4/Data channels/DDR_DQ20: U201.AG19 (SDQ20), U301.V4 (DQ5_b)
/2GB LPDDR4/Data channels/DDR_DQ21: U201.AH18 (SDQ21), U301.AA2 (DQ0_b)
/2GB LPDDR4/Data channels/DDR_DQ22: U201.AJ17 (SDQ22), U301.AA4 (DQ7_b)
/2GB LPDDR4/Data channels/DDR_DQ23: U201.AC17 (SDQ23), U301.Y4 (DQ6_b)
/2GB LPDDR4/Data channels/DDR_DQ24: U201.AC15 (SDQ24), U301.AA9 (DQ15_b)
/2GB LPDDR4/Data channels/DDR_DQ25: U201.AD15 (SDQ25), U301.AA11 (DQ8_b)
/2GB LPDDR4/Data channels/DDR_DQ26: U201.AF15 (SDQ26), U301.V11 (DQ10_b)
/2GB LPDDR4/Data channels/DDR_DQ27: U201.AG15 (SDQ27), U301.Y11 (DQ9_b)
/2GB LPDDR4/Data channels/DDR_DQ28: U201.AH17 (SDQ28), U301.U9 (DQ12_b)
/2GB LPDDR4/Data channels/DDR_DQ29: U201.AG17 (SDQ29), U301.U11 (DQ11_b)
/2GB LPDDR4/Data channels/DDR_DQ30: U201.AF17 (SDQ30), U301.Y9 (DQ14_b)
/2GB LPDDR4/Data channels/DDR_DQ31: U201.AD17 (SDQ31), U301.V9 (DQ13_b)
/2GB LPDDR4/Data channels/DDR_DQS0N: U201.AB29 (SDQS0N), U301.E3 (DQS_N0_a)
/2GB LPDDR4/Data channels/DDR_DQS0P: U201.AB28 (SDQS0P), U301.D3 (DQS_P0_a)
/2GB LPDDR4/Data channels/DDR_DQS1N: U201.V29 (SDQS1N), U301.E10 (DQS_N1_a)
/2GB LPDDR4/Data channels/DDR_DQS1P: U201.V28 (SDQS1P), U301.D10 (DQS_P1_a)
/2GB LPDDR4/Data channels/DDR_DQS2N: U201.AJ19 (SDQS2N), U301.V3 (DQS_N0_b)
/2GB LPDDR4/Data channels/DDR_DQS2P: U201.AH19 (SDQS2P), U301.W3 (DQS_P0_b)
/2GB LPDDR4/Data channels/DDR_DQS3N: U201.AJ15 (SDQS3N), U301.V10 (DQS_N1_b)
/2GB LPDDR4/Data channels/DDR_DQS3P: U201.AH15 (SDQS3P), U301.W10 (DQS_P1_b)

Notes on the sheet:
Vendor-qualified clock target: 1200MHz. Use NT6AN512T32AV-J2 parameters in the DRAM firmware. Final clock and timings require board validation.
Channel A: DQ[0..15], DQS/DM[0..1] Channel B: DQ[16..31], DQS/DM[2..3] One rank per channel. Command and power on following pages.
2 GB LPDDR4 / 2 x 16-bit channels / single rank per channel
DQ bit swaps follow Allwinner S6L V2.0 (C0402). DDR_DQ labels identify SoC bits; RAM pin names show the swizzle. Swaps stay within each byte. DQS and DMI assignments are unchanged.

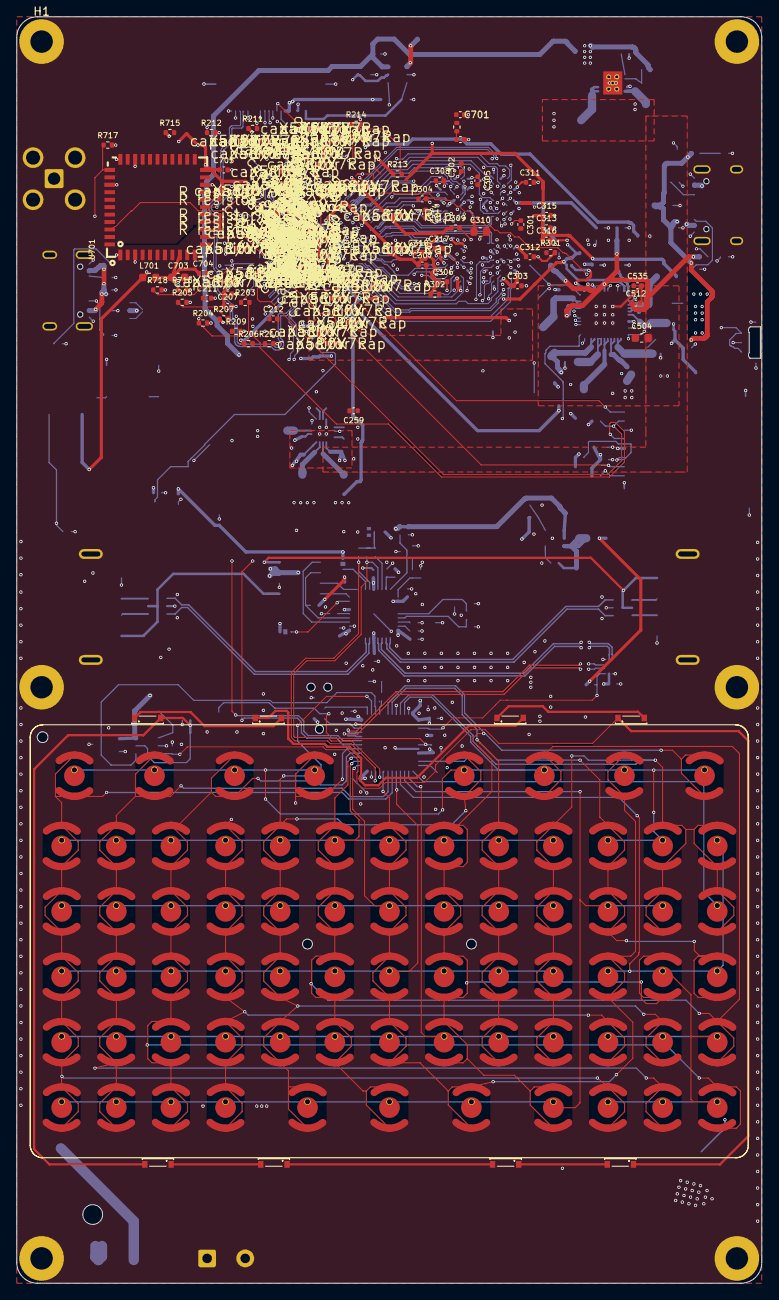
[picture p448: board blackpants.kicad_pcb from above]

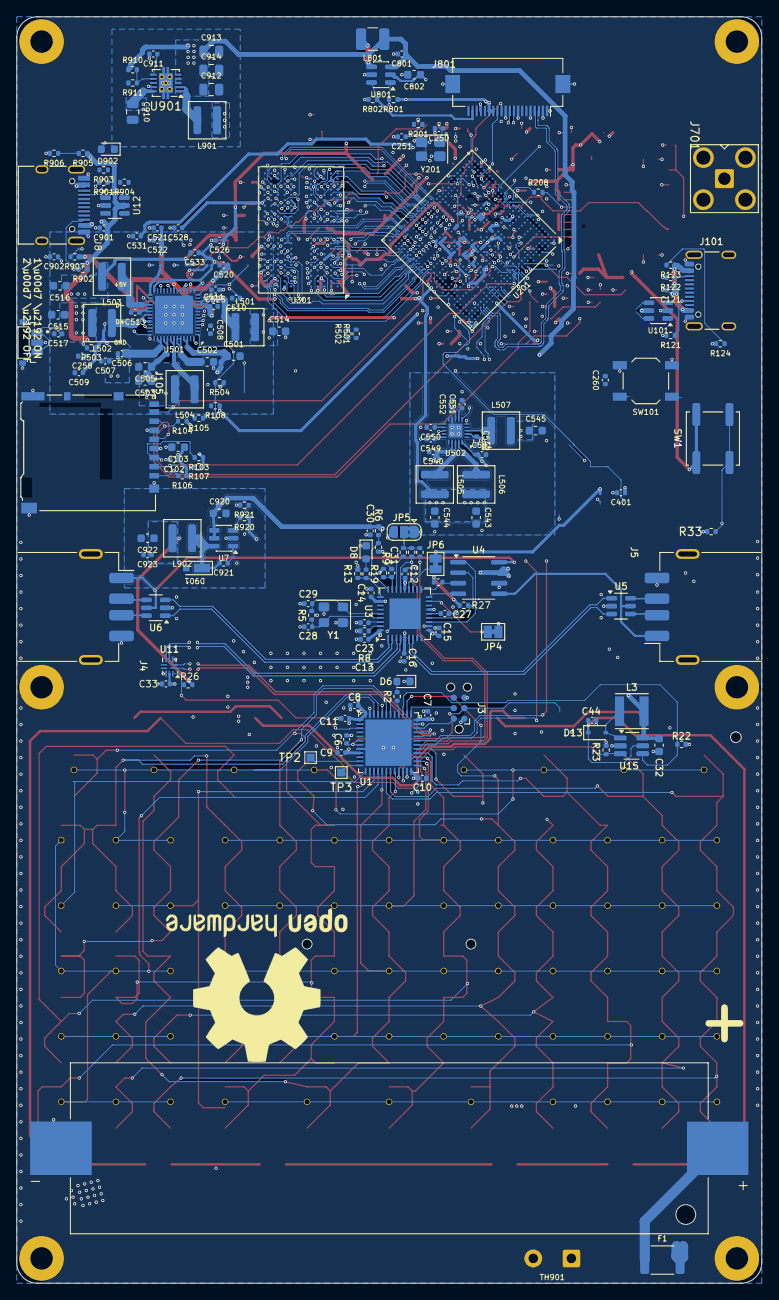
[picture p449: board blackpants.kicad_pcb from below]

Board: 6 copper layers, 90.0 x 153.0 mm, 300 parts (174 on the bottom side), 265 nets.
