o7-machinehum/Blackpants/Carrier/badgeCarrierCard.kicad_pcb

## KiCad design Carrier/badgeCarrierCard.kicad_pcb (2025-06-08)

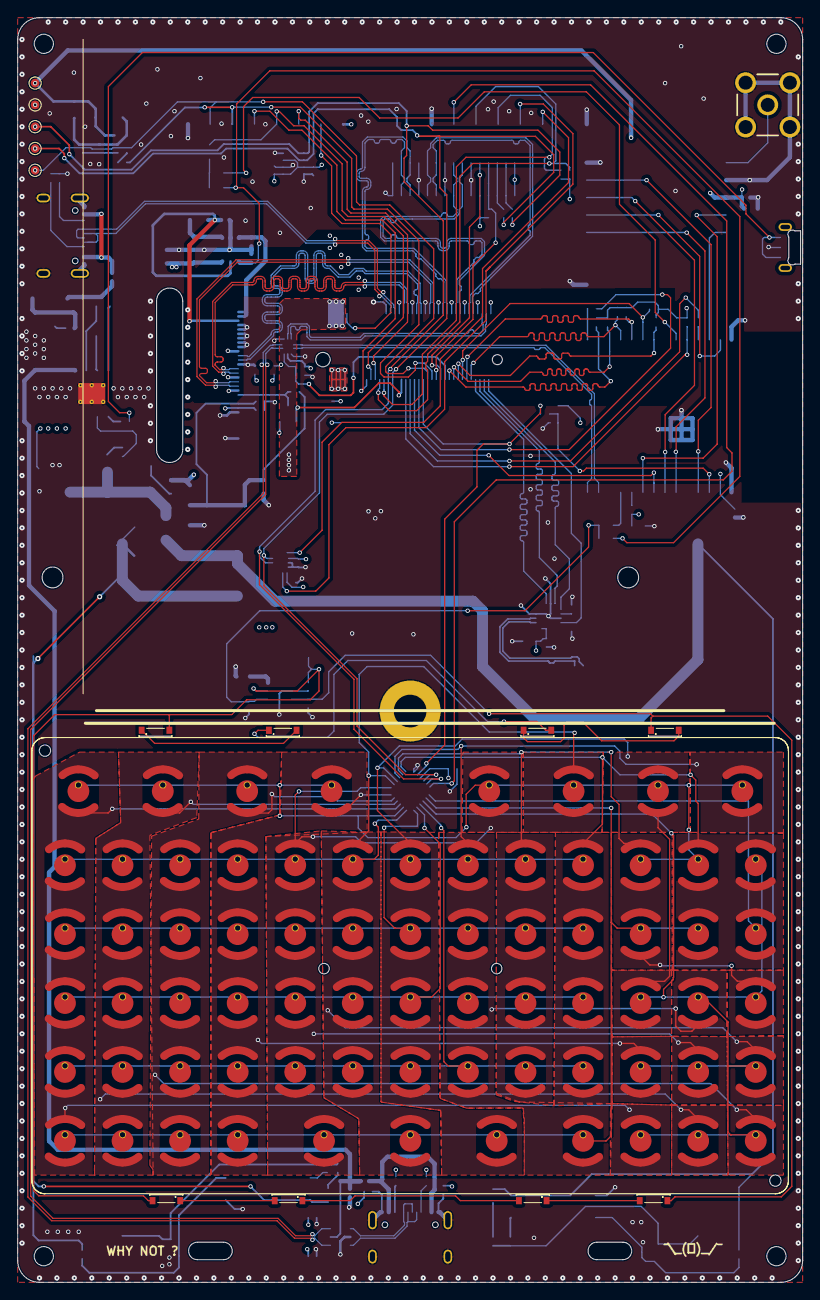
[picture p450: board badgeCarrierCard.kicad_pcb from above]

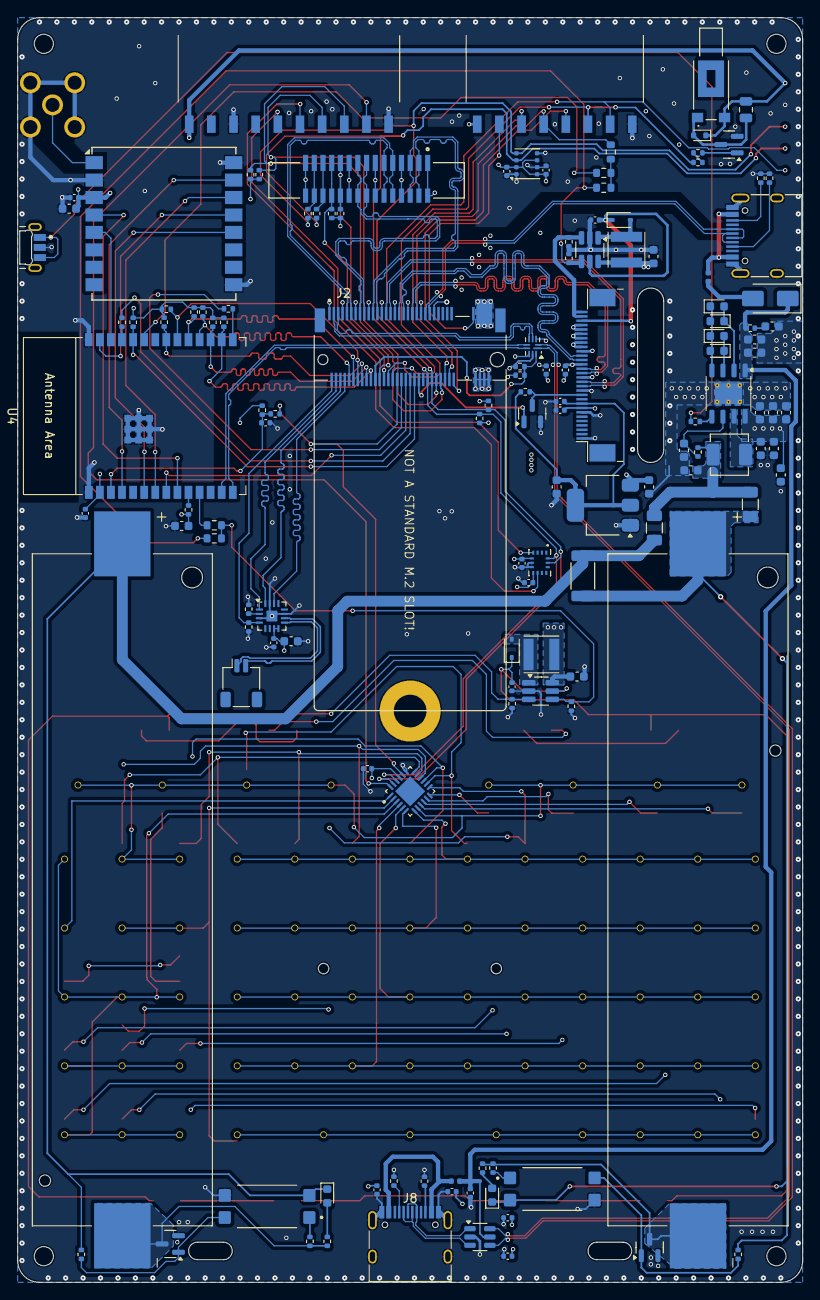
[picture p451: board badgeCarrierCard.kicad_pcb from below]

Board: 4 copper layers, 90.0 x 145.0 mm, 156 parts (137 on the bottom side), 140 nets.

Parts:
BT1, BT2: 18650 Cell; BH-18650-B1BA002
C1, C7, C10, C11, C12, C13, C14, C15, C16, C45, C47, C48, C49, C50, C51, C52: 100nF; C_0402_1005Metric
C2, C3, C5, C8, C9, C17, C29, C30, C31, C32: 10uF; C_0603_1608Metric
C4, C6, C44, C46: 1uF; C_0402_1005Metric
C18, C19, C20, C21, C22, C24, C25, C26: 22uF; C_0603_1608Metric
C23: 100nF; C_0805_2012Metric
D1: SS54; D_SMA
D2, D3, D4, D5: LED; D_0603_1608Metric
D6: 1N4148WT; D_SOD-523
D7, D8: LED; LED_0603_1608Metric
D13, D14: 1N5819WS; D_SOD-323
D15, D16, D17, D18, D19, D20, D21, D22: LED; LTW-010DCG
F1, F2: Polyfuse; Fuse_1206_3216Metric
FB1, FB2: 120Ω@100MHz; L_0402_1005Metric
H1, H2, H3, H4: CaseScrew; MountingHole_2.2mm_M2
H5: MountingHole_Pad; Standoff
J1, J8: USB_C_Receptacle_USB2.0_16P; USB_C_Receptacle_HRO_TYPE-C-31-M-12
J2: MDT420M02003; AMPHENOL_MDT420M02003
J3: Conn_01x08; SMD_8
J5: SMA-J-P-X-RA-TH1; SAMTEC_SMA-J-P-X-RA-TH1
J6: 1-1734248-5; TE_1-1734248-5
J7: Conn_01x10; SMD_10
J9: Conn_01x30; AFC30
L1: 1uH; L_Changjiang_FXL0420
L3, L4: 6.8uH; L_Vishay_IFSC-1515AH_4x4x1.8mm
LS1: Speaker; JST_SH_SM02B-SRSS-TB_1x02-1MP_P1.00mm_Horizontal
M1: Z30C1T8460001; XDCR_Z30C1T8460001
PWR_BUTTON1: PTS847MM160LSMTR2_LFS; SW_PTS847MM160LSMTR2_LFS
Q1, Q2, Q3: AO3400A; SOT-23
Q4: BC847; SOT-23
R1, R3, R11, R12: 5.1K; R_0402_1005Metric
R2, R35: 4R7; R_0402_1005Metric
R4, R33, R34: 100K; R_0402_1005Metric
R5, R6, R7, R8: 4.7K; R_0402_1005Metric
R9, R10, R15, R18, R20, R25, R32, R36, R39, R40: 10K; R_0402_1005Metric
R13: 200; R_2010_5025Metric
R14: 2; R_0402_1005Metric
R16, R22, R23, R44, R45: 0R; R_0603_1608Metric
R17: 0.5; R_0402_1005Metric
R19, R21, R41, R42, R49: 0R; R_0402_1005Metric
R24: 33R; R_0402_1005Metric
R26, R27, R28, R29, R30, R31: 51K; R_0402_1005Metric
R37, R43, R48: 1K; R_0402_1005Metric
R38, R47: 150; R_0402_1005Metric
R46, R50: 470; R_0402_1005Metric
TP1, TP2, TP3, TP4: TestPoint; TestPoint_Pad_D1.0mm
TP5: DIN; TestPoint_Pad_D1.0mm
U1: TCA8418; QFN50P400X400X80-25N
U2: IP5306; HSOP-8-1EP_3.9x4.9mm_P1.27mm_EP2.41x3.1mm_ThermalVias
U3: AMS1117-1.8; SOT-223-3_TabPin2
U4: ESP32-C6-WROOM-1
U5: Ai-Thinker-Ra-01H; Ai-Thinker-Ra-01-LoRa
U6: MAX98357A; TQFN-16-1EP_3x3mm_P0.5mm_EP1.23x1.23mm
U7: BME680; Bosch_LGA-8_3x3mm_P0.8mm_ClockwisePinNumbering
U8: BMI270; XDCR_BMI270
U9, U10: EL817S1C; SOIC254P1030X390-4N
U11: TPSGM7227YUWQ10G; UQFN-10_1.4x1.8mm_P0.4mm
U12: USBLC6-2SC6; SOT-23-6
U14: keyboard_arturo182
U15, U16: AP3032; SOT-23-6_Handsoldering

Connections:
+1V8: C11.1, C32.1, J9.9, R36.1, U3.2 (VO)
+3V3: C1.1, C5.1, C6.1, C7.1, C8.1, C9.1, C10.1, C12.1, C13.1, C14.1, C15.1, C16.1, C23.1, C47.1, C48.1, C49.1, C50.1, C51.1, C52.1, D6.1 (K), J2.68, J2.70, J2.72, J2.74, J6.15, J6.15_1 (15), J7.1, J9.8, M1.2 (+), R5.2, R6.2, R7.2, R8.2, R9.1, R18.2, R20.1, R25.2, R26.2, R27.2, R28.2, R29.2, R30.2, R31.2, R39.1, R40.1, TP1.1, U1.21, U4.2 (3V3), U5.3 (VDD), U6.7 (VDD), U6.8 (VDD), U7.2 (CSB), U7.6 (VDDIO), U7.8 (VDD), U8.5 (VDDIO), U8.8 (VDD), U11.9 (VCC)
+5V: C18.1, C19.1, C20.1, C24.1, C25.1, C26.1, C29.1, C30.1, C31.1, J2.69, J2.71, J2.73, J2.75, J3.1, L3.1, L4.1, U2.8 (VOUT), U3.3 (VI), U15.6 (VIN), U16.6 (VIN)
+13v: C44.1, D13.1 (K), D15.2 (A), D19.2 (A), U15.5 (OV)
+BATT: C21.1, F1.1, F2.1, L1.2, R17.1
/Audio/I2S_DATA: J2.4, U6.1 (DIN)
/Audio/I2S_LRCK: J2.8, U6.14 (LRCLK)
/Audio/I2S_SCLK: J2.6, U6.16 (BCLK)
/Audio/OUTN: LS1.2, U6.10 (OUTN)
/Audio/OUTP: LS1.1, U6.9 (OUTP)
/Audio/~I2S_MODE: J2.2, R32.2, U6.4 (~SD_MODE)
/C6_BOOT: J2.34, R21.1
/C6_CHIP_PU: J2.32, R19.1, U1.20 (RESET)
/C6_INT: J2.36, U4.8 (GPIO0/ADC1_CH0/XTAL_32K_P)
/C6_RX: J2.40, R25.1, U4.24 (U0RXD/GPIO17)
/C6_TX: J2.38, R24.2
/CSI.CLK+: J2.17, J6.8, J6.8_1 (8)
/CSI.CLK-: J2.15, J6.9, J6.9_1 (9)
/CSI.DATA0+: J2.21, J6.2, J6.2_1 (2)
/CSI.DATA0-: J2.23, J6.3, J6.3_1 (3)
/CSI.DATA1+: J2.9, J6.5, J6.5_1 (5)
/CSI.DATA1-: J2.11, J6.6, J6.6_1 (6)
/CSI.RESET: J2.24, J6.11, J6.11_1 (11), R39.2
/CSI.STROBE: J2.26, J6.12, J6.12_1 (12), R40.2
/Connectivity (C6 + LoRa)/LoRa/ANTENNA: J5.1, U5.1 (ANT)
/Connectivity (C6 + LoRa)/LoRa/LORA_DIO0: U4.26 (GPIO3/ADC1_CH3), U5.5 (DIO0)
/Connectivity (C6 + LoRa)/LoRa/LORA_MISO: U4.27 (GPIO2/ADC1_CH2), U5.13 (MISO)
/Connectivity (C6 + LoRa)/LoRa/LORA_MOSI: U4.7 (MTDO/GPIO7), U5.14 (MOSI)
/Connectivity (C6 + LoRa)/LoRa/LORA_SCK: U4.6 (MTCK/GPIO6/ADC1_CH6), U5.12 (SCK)
/Connectivity (C6 + LoRa)/LoRa/~LORA_NSS: U4.4 (MTMS/GPIO4/ADC1_CH4), U5.15 (~NSS)
/Connectivity (C6 + LoRa)/LoRa/~LORA_RESET: U4.9 (GPIO1/ADC1_CH1/XTAL_32K_N), U5.4 (~RESET)
/Connectivity (C6 + LoRa)/SD2.CLK: J2.18, R27.1, U4.17 (GPIO19)
/Connectivity (C6 + LoRa)/SD2.CMD: J2.20, R26.1, U4.16 (GPIO18)
/Connectivity (C6 + LoRa)/SD2.DATA0: J2.10, R28.1, U4.18 (GPIO20)
/Connectivity (C6 + LoRa)/SD2.DATA1: J2.12, R29.1, U4.19 (GPIO21)
/Connectivity (C6 + LoRa)/SD2.DATA2: J2.14, R30.1, U4.20 (GPIO22)
/Connectivity (C6 + LoRa)/SD2.DATA3: J2.16, R31.1, U4.21 (GPIO23)
/Connectivity (C6 + LoRa)/USB_C6.D+: U4.14 (GPIO13/USB_D+), U11.7 (HSD2+)
/Connectivity (C6 + LoRa)/USB_C6.D-: U4.13 (GPIO12/USB_D-), U11.6 (HSD2-)
/DISPLAY_BL: R16.2, R23.2, R45.2
/DSI.CLK+: J2.33, J9.20
/DSI.CLK-: J2.35, J9.19
/DSI.DATA0+: J2.29, J9.14
/DSI.DATA0-: J2.27, J9.13
/DSI.DATA1+: J2.41, J9.17
/DSI.DATA1-: J2.39, J9.16
/DSI.RESET: J2.42, Q2.1 (G)
/Display/ADJ_BL_KEYBOARD_DISPLAY: R34.1, R44.2, R45.1, U16.4 (CTRL)
/Display/FB: J9.29, J9.30, R35.1, U16.3 (FB)
/GPIO0: J2.54, J3.3
/GPIO1: J2.56, J3.4, R16.1
/GPIO2: J2.58, J3.5
/GPIO3: J2.28, J3.6, R49.1
/GPIO4: J2.30, J3.7, TP5.1
/I2C2.SCL: J2.52, J7.8, R8.1
/I2C2.SDA: J2.50, J7.7, R7.1
/I2C.SCL: J2.48, R6.1, R42.1, TP3.1, U1.23 (SCL), U7.4 (SCK), U8.13 (SCX)
/I2C.SDA: J2.46, R5.1, R41.1, TP4.1, U1.22 (SDA), U7.3 (SDI), U8.14 (SDX)
/INT1: J7.5, U8.4 (INT1)
/INT2: J7.6, U8.9 (INT2)
/KEYBOARD_BL: R4.1, R22.1, R44.1, U15.4 (CTRL)
/Keyboard/COL_0: U1.9 (COL0), U14.1 (ESC), U14.17 (`), U14.43 (TAB), U14.69 (FN), U14.95 (SHL), U14.121 (CTRL), U14.137 (<)
/Keyboard/COL_1: U1.10 (COL1), U14.3 (F1), U14.19 (1), U14.45 (Q), U14.71 (A), U14.97 (Z), U14.123 (MT), U14.139 (\/)
/Keyboard/COL_2: U1.11 (COL2), U14.5 (F2), U14.21 (2), U14.47 (W), U14.73 (S), U14.99 (X), U14.125 (ALT), U14.141 (>)
/Keyboard/COL_3: U1.12 (COL3), U14.7 (F3), U14.23 (3), U14.49 (E), U14.75 (D), U14.101 (C), U14.115 (/), U14.127 (\)
/Keyboard/COL_4: U1.13 (COL4), U14.9 (F4), U14.25 (4), U14.51 (R), U14.77 (F), U14.103 (V), U14.117 (/\), U14.129 (SP)
/Keyboard/COL_5: U1.14 (COL5), U14.11 (F5), U14.27 (5), U14.53 (T), U14.79 (G), U14.105 (B), U14.119 (SHR), U14.131 (SP)
/Keyboard/COL_6: U1.15 (COL6), U14.13 (F6), U14.29 (6), U14.55 (Y), U14.81 (H), U14.89 (;), U14.107 (N), U14.133 (SP)
/Keyboard/COL_7: U1.16 (COL7), U14.15 (BS), U14.31 (7), U14.57 (U), U14.83 (J), U14.91 ('), U14.109 (M), U14.135 (AGR)
/Keyboard/COL_8: U1.17 (COL8), U14.33 (8), U14.37 (0), U14.59 (I), U14.63, U14.85 (K), U14.93 (RET), U14.111 (,)
/Keyboard/COL_9: U1.18 (COL9), U14.35 (9), U14.39 (-), U14.41 (=), U14.61 (O), U14.65 ([), U14.67 (]), U14.87 (L), U14.113 (.)
/Keyboard/FB: D18.1 (K), D22.1 (K), R2.1, U15.3 (FB)
/Keyboard/ROW_0: U1.8 (ROW0), U14.2, U14.4, U14.6, U14.8, U14.10, U14.12, U14.14, U14.16, U14.38, U14.40
/Keyboard/ROW_1: U1.7 (ROW1), U14.18, U14.20, U14.22, U14.24, U14.26, U14.28, U14.30, U14.32, U14.34, U14.36
/Keyboard/ROW_2: U1.6 (ROW2), U14.44, U14.46, U14.48, U14.50, U14.52, U14.54, U14.56, U14.58, U14.60, U14.62
/Keyboard/ROW_3: U1.5 (ROW3), U14.70, U14.72, U14.74, U14.76, U14.78, U14.80, U14.82, U14.84, U14.86, U14.88
/Keyboard/ROW_4: U1.4 (ROW4), U14.96, U14.98, U14.100, U14.102, U14.104, U14.106, U14.108, U14.110, U14.112, U14.114
/Keyboard/ROW_5: U1.2 (ROW5), U14.64, U14.66, U14.122, U14.124, U14.126, U14.128, U14.130, U14.132, U14.134, U14.136
/Keyboard/ROW_6: U1.3 (ROW6), U14.42, U14.90, U14.92, U14.94, U14.116, U14.118, U14.120, U14.138, U14.140, U14.142
/Keyboard/ROW_7: U1.1 (ROW7), U14.68
/Keyboard/~INT_KEYBOARD: J7.9, U1.24 (INT)
/Power & USB/D+: J8.A6 (D+), J8.B6 (D+), U12.1 (I/O1)
/Power & USB/D-: J8.A7 (D-), J8.B7 (D-), U12.3 (I/O2)
/Power & USB/UF: FB2.1, J8.A4 (VBUS), J8.A9 (VBUS), J8.B4 (VBUS), J8.B9 (VBUS)
/Power & USB/USB.D+: U11.1 (D+), U12.6 (I/O1)
/Power & USB/USB.D-: U11.2 (D-), U12.4 (I/O2)
/RTC: J2.67, J3.2
/USB_CS: J2.22, R9.2, R10.1, U11.10 (SEL)
/USB_HS.D+: J2.3, U11.5 (HSD1+)
/USB_HS.D-: J2.5, U11.4 (HSD1-)
/USB_JTAG.D+: J1.A6 (D+), J1.B6 (D+), J2.45
/USB_JTAG.D-: J1.A7 (D-), J1.B7 (D-), J2.47
/Vibrator/PWM_VIB: R37.1, R49.2
GND: C1.2, C2.2, C3.2, C4.2, C5.2, C6.2, C7.2, C8.2, C9.2, C10.2, C11.2, C12.2, C13.2, C14.2, C15.2, C16.2, C17.2, C18.2, C19.2, C20.2, C21.2, C22.2, C24.2, C25.2, C26.2, C29.2, C30.2, C31.2, C32.2, C44.2, C45.2, C46.2, C47.2, C48.2, C49.2, C50.2, C51.2, C52.2, H5.1, J1.A1 (GND), J1.A12 (GND), J1.B1 (GND), J1.B12 (GND), J1.S1 (SHIELD), J2.1, J2.7, J2.13, J2.19, J2.25, J2.31, J2.37, J2.43, J2.49, J3.8, J5.2, J5.3, J5.4, J5.5, J6.1, J6.1_1 (1), J6.4, J6.4_1 (4), J6.7, J6.7_1 (7), J6.10, J6.10_1 (10), J7.3, J7.10, J8.A1 (GND), J8.A12 (GND), J8.B1 (GND), J8.B12 (GND), J8.S1 (SHIELD), J9.1, J9.7, J9.12, J9.15, J9.18, J9.21, J9.22, J9.23, J9.24, J9.25, J9.26, J9.27, PWR_BUTTON1.2, Q1.2 (S), Q2.2 (S), Q3.2 (S), Q4.2 (E), R1.1, R2.2, R3.2, R4.2, R10.2, R11.2, R12.2, R32.1, R33.1, R34.2, R35.2, TP2.1, U1.19, U2.9 (EP), U3.1 (GND), U4.1 (GND), U4.28 (GND), U4.29 (GND), U5.2 (GND), U5.9 (GND), U5.16 (GND), U6.3 (GND), U6.11 (GND), U6.15 (GND), U6.17 (PAD), U7.1 (GND), U7.5 (SDO), U7.7 (GND), U8.6 (GNDIO), U8.7 (GND), U9.3, U10.3, U11.3 (GND), U11.8 (~OE), U12.2 (GND), U15.2 (GND), U16.2 (GND)
unnamed: BT1.1 (+), D7.1 (K), F1.2, R13.1, R43.2, U10.2
unnamed: BT1.2 (-), Q1.3 (D), R38.2, R50.2
unnamed: BT2.1 (+), D8.1 (K), F2.2, R13.2, R48.2, U9.2
unnamed: BT2.2 (-), Q3.3 (D), R46.2, R47.2
unnamed: C17.1, R14.2
unnamed: D2.2 (A), D3.1 (K), U2.2 (LED1)
unnamed: D2.1 (K), D3.2 (A), D4.1 (K), D5.2 (A), U2.4 (LED3)
unnamed: D4.2 (A), D5.1 (K), U2.3 (LED2)
unnamed: C23.2, D6.2 (A), M1.1 (-), Q4.3 (C)
unnamed: D7.2 (A), R50.1
unnamed: D8.2 (A), R46.1
unnamed: D13.2 (A), L3.2, U15.1 (SW)
unnamed: D14.2 (A), L4.2, U16.1 (SW)
unnamed: C46.1, D14.1 (K), J9.28, U16.5 (OV)
unnamed: D15.1 (K), D16.2 (A)
unnamed: D16.1 (K), D17.2 (A)
unnamed: D17.1 (K), D18.2 (A)
unnamed: D19.1 (K), D20.2 (A)
unnamed: D20.1 (K), D21.2 (A)
unnamed: D21.1 (K), D22.2 (A)
unnamed: FB1.1, J1.A4 (VBUS), J1.A9 (VBUS), J1.B4 (VBUS), J1.B9 (VBUS)
unnamed: J1.A5 (CC1), R3.1
unnamed: J1.B5 (CC2), R1.2
unnamed: J6.13, J6.13_1 (13), R41.2
unnamed: J6.14, J6.14_1 (14), R42.2
unnamed: J8.A5 (CC1), R12.1
unnamed: J8.B5 (CC2), R11.1
unnamed: J9.11, Q2.3 (D), R36.2
unnamed: PWR_BUTTON1.1, PWR_BUTTON1.3, R15.2
unnamed: Q1.1 (G), R43.1, U10.4
unnamed: Q3.1 (G), R48.1, U9.4
unnamed: Q4.1 (B), R37.2
unnamed: R38.1, U10.1
unnamed: R47.1, U9.1
unnamed: C22.1, R17.2, U2.6 (BAT)
unnamed: R15.1, U2.5 (KEY)
unnamed: L1.1, U2.7 (SW)
unnamed: C4.1, R18.1, R19.2, U4.3 (EN/CHIP_PU)
unnamed: R20.2, U4.10 (GPIO8)
unnamed: R21.2, U4.15 (GPIO9)
unnamed: R22.2, U4.11 (GPIO10)
unnamed: R23.1, U4.23 (GPIO15)
unnamed: R24.1, U4.25 (U0TXD/GPIO16)
unnamed: R33.2, U6.2 (GAIN_SLOT)
VBUS: C2.1, C3.1, C45.1, D1.1 (K), FB2.2, R14.1, U2.1 (VIN), U12.5 (VBUS)
VBUS_NPD: D1.2 (A), FB1.2
