o7-machinehum/Blackpants/(commit log)

2025-06-08 Updated module, now with uSD
    [P4_M.2_B+M-key-CmtUser.gbr, P4_M.2_B+M-key-CuBottom.gbl, P4_M.2_B+M-key-CuTop.gtl, P4_M.2_B+M-key-EdgeCuts.gm1, P4_M.2_B+M-key-MaskBottom.gbs, P4_M.2_B+M-key-MaskTop.gts, P4_M.2_B+M-key-NPTH-drl_map.gbr, P4_M.2_B+M-key-NPTH.drl]
2025-06-08 Fixed mistakes from prototype 1
    [P4_M.2_B+M-key.kicad_pcb, P4_M.2_B+M-key.kicad_sch]
2025-06-08 Prototype 2 files
    [P4_M.2_B+M-key-CmtUser.gbr, P4_M.2_B+M-key-CuBottom.gbl, P4_M.2_B+M-key-CuTop.gtl, P4_M.2_B+M-key-EdgeCuts.gm1, P4_M.2_B+M-key-MaskBottom.gbs, P4_M.2_B+M-key-MaskTop.gts, P4_M.2_B+M-key-NPTH-drl_map.gbr, P4_M.2_B+M-key-NPTH.drl]
2025-06-08 Push change, allready fix usb mux
    [P4_M.2_B+M-key.csv, P4_M.2_B+M-key.kicad_pcb, P4_M.2_B+M-key.kicad_sch, Vibrator.kicad_sch, audio.kicad_sch, badgeCarrierCard.kicad_pcb, badgeCarrierCard.kicad_sch, balancer.kicad_sch]
2025-06-08 fix: sync schematic prot3 and v2.5
    [Vibrator.kicad_sch, badgeCarrierCard.kicad_pcb, badgeCarrierCard.kicad_sch, connectivity.kicad_sch, display.kicad_sch, power.kicad_sch]
2025-06-08 fix annotation
    [badgeCarrierCard.kicad_pcb, keyboard.kicad_sch, power.kicad_sch]
2025-06-08 push back to adam:DDD
    [badgeCarrierCard.kicad_pcb]
2025-06-08 push resistor name
    [keyboard.kicad_sch, power.kicad_sch]
2025-06-08 fix: implement balancer changes
    [badgeCarrierCard.kicad_pcb]
2025-06-08 push final
    [badgeCarrierCard.kicad_pcb, badgeCarrierCard.kicad_sch, keyboard.kicad_sch]
2025-06-08 schematic update names
    [Vibrator.kicad_sch, keyboard.kicad_sch]
2025-06-08 Resistor value update c6
    [connectivity.kicad_sch, keyboard.kicad_sch]
2025-06-08 adjust footprint W395HDC001-A
2025-06-08 EMF Lora and Jays LCD footprint added:-)
2025-06-08 chore: DRC fixes
    [Vibrator.kicad_sch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]
2025-06-08 fix: add ordercodes for production files
    [Vibrator.kicad_sch, audio.kicad_sch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]
2025-06-08 fix: component positions & 3dmodels
    [P4_M.2_B+M-key.kicad_pcb, P4_M.2_B+M-key.kicad_sch]
2025-06-08 Funny silkscreen and clearing up for protuction
2025-06-08 fix: cleanup silkscreen labels
    [badgeCarrierCard.kicad_sch]
2025-06-08 feat: add leds and 3dmodels
    [badgeCarrierCard.kicad_sch]
2025-06-08 fix: revert m2 changes
    [P4_M.2_B+M-key.kicad_pcb, P4_M.2_B+M-key.kicad_sch]
2025-06-08 chore: repo cleanup
    [badgeCarrierCard.kicad_sch, display.kicad_sch]
2025-06-08 chore: generate production files
    [badgeCarrierCard-CmtUser.gbr, badgeCarrierCard-CuBottom.gbl, badgeCarrierCard-CuTop.gtl, badgeCarrierCard-EdgeCuts.gm1, badgeCarrierCard-MaskBottom.gbs, badgeCarrierCard-MaskTop.gts, badgeCarrierCard-NPTH-drl_map.gbr, badgeCarrierCard-NPTH.drl]
2025-06-08 chore: lib cleanup
    [Vibrator.kicad_sch, badgeCarrierCard.kicad_sch, display.kicad_sch, power.kicad_sch]
2025-06-08 fix: last minute resistor changes
    [badgeCarrierCard-CmtUser.gbr, badgeCarrierCard-CuBottom.gbl, badgeCarrierCard-CuTop.gtl, badgeCarrierCard-EdgeCuts.gm1, badgeCarrierCard-MaskBottom.gbs, badgeCarrierCard-MaskTop.gts, badgeCarrierCard-NPTH-drl_map.gbr, badgeCarrierCard-NPTH.drl]
2025-06-08 STOCK LCSC vibr, and silkscreen changes
    [Vibrator.kicad_sch, keyboard.kicad_sch]
2025-06-08 front panel pads update push to jay,
    [badgeCarrierCard.kicad_sch, keyboard.kicad_sch]
2025-06-08 update PCB from schematics
2025-06-08 testpads footprints
    [badgeCarrierCard.kicad_sch]
2025-06-08 fix: standoff part number
2025-06-08 fix: new smd footprint for button
    [power.kicad_sch]
2025-06-08 fix: change button part number
2025-06-08 fix: drc errors & prod files
    [Vibrator.kicad_sch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]
2025-06-09 Final Push M.2
    [P4_M.2_B+M-key.kicad_pcb]
2025-06-09 fix: add warning + prod files
    [badgeCarrierCard-CmtUser.gbr, badgeCarrierCard-CuBottom.gbl, badgeCarrierCard-CuTop.gtl, badgeCarrierCard-EdgeCuts.gm1, badgeCarrierCard-MaskBottom.gbs, badgeCarrierCard-MaskTop.gts, badgeCarrierCard-NPTH-drl_map.gbr, badgeCarrierCard-NPTH.drl]
2025-06-10 fix: speaker connector from SH-1.0 to PH-2.0
    [audio.kicad_sch]
2025-06-10 chore: generate prod files
    [badgeCarrierCard-CmtUser.gbr, badgeCarrierCard-CuBottom.gbl, badgeCarrierCard-CuTop.gtl, badgeCarrierCard-EdgeCuts.gm1, badgeCarrierCard-MaskBottom.gbs, badgeCarrierCard-MaskTop.gts, badgeCarrierCard-NPTH-drl_map.gbr, badgeCarrierCard-NPTH.drl]
2025-06-10 chore: regenerate prod files to include bom
    [badgeCarrierCard-CmtUser.gbr, badgeCarrierCard-CuBottom.gbl, badgeCarrierCard-CuTop.gtl, badgeCarrierCard-EdgeCuts.gm1, badgeCarrierCard-MaskBottom.gbs, badgeCarrierCard-MaskTop.gts, badgeCarrierCard-NPTH-drl_map.gbr, badgeCarrierCard-NPTH.drl]
2025-06-11 Fixed esp_en issue
    [P4_M.2_B+M-key.kicad_pcb, P4_M.2_B+M-key.kicad_sch, bom.csv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]
2025-06-11 traces with changes
2025-06-13 chore: cleanup repository & add build system
    [P4_M.2_B+M-key.csv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]
2025-06-15 fix: cleanup m2 project structure and schematic
    [P4_M.2_B+M-key.kicad_pcb, P4_M.2_B+M-key.kicad_sch, badgeM2Card.kicad_pcb, flashing.kicad_sch, mcu.kicad_sch, power.kicad_sch, storage.kicad_sch]
2025-06-15 norun: fix: change disp. backlight feedback resistance
    [display.kicad_sch]
2025-06-16 Moved lcd screen connector for new screen, corrected LCSC partnumbers
    [Vibrator.kicad_sch, audio.kicad_sch, bme.kicad_sch, flashing.kicad_sch, power.kicad_sch]
2025-06-19 minor silkscreen adjustment and pogo pins
    [badgeCarrierCard.kicad_sch]
2025-06-19 fix: set pogo pins to DNP
    [badgeCarrierCard.kicad_sch]
2025-06-24 Impedance matching new stackup
    [badgeM2Card.kicad_pcb]
2025-07-17 Add spacer
    [spacer.stl]
2025-07-23 ADD all schematic pdf files and ADD lasercut spacer files
    [frontpanel.kicad_sch, lasercut_full.dxf, lasercut_small_p1.dxf, lasercut_small_p2.dxf]
2025-07-23 ADD README.md for Spacer folder
2025-07-25 Pushing Addons to Gitlab
    Four addons to inspire fun and hacking.
    [BOM-LED_MATRIX.csv, BOM-Oscilli.csv, BOM-SAO.csv, BOM-SAO_V2.csv, BOM-VGA_PS2.csv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]
2025-07-25 Middle part spacer
    [lasercut_small_p1.dxf, lasercut_small_p2.dxf, spacer middle part.dxf]
2025-07-26 Flipped SAO connectors, to match v1.69bis spec
    Also
    - Re-routed connections to the SAO connectors
    - Teaked clearance for fill and moved a few traces for better GND and VCC coverage
    - Changed 3v to 3v3 silkscreen on connector to badge
    - Changed 3D model to be badge side keyed SAO connector
    [SAO_V2.kicad_pcb]
2025-07-26 Add twopart spacer design, restore stucture of the Spacer folder
    [lasercut_small_p1.dxf, lasercut_small_p2.dxf, spacer middle part.dxf, spacer.stl, twopart_minimal_p1.stl, twopart_minimal_p2.stl]
2025-07-26 Add case and README.
    [case.stl]
2025-07-30 Production spacer OD5 ID3 H3
    This is the spacers we use for assembly of the WHY badge.
    [SPACER _OD5_ID3_H3.stl]
2025-07-30 Adding the full spacer design with LoRa antenna cutout for WHY2025 badge
    This is the full spacer with a cutout for the LoRa antanna.
    [Full_Spacer_with_LoRa_Antenna_WHY2025.stl]
2025-07-30 Fixed SD det line reconnected to P4
    There was an error in the production release. This fixes the problem found after pcb went to production. In case you want to reuse this, with this change the SD card change detection works as intented.
    [badgeM2Card.kicad_pcb]
2025-07-30 Fix typo in schematic for FLASH
    Correction on schematic from FALSH to FLASH. Simple typo correction, nothing more.
    [badgeM2Card.kicad_pcb, mcu.kicad_sch, storage.kicad_sch]
2025-08-01 Update readme file, with discord en telegram hub
    A hub for WHY2025 badge activities: mods, hacks, 3D prints, and new ideas to customize your badge experience.
2025-08-02 Case design improvements for 3D printing
    [WHY Badge case.f3d]
2025-08-08 Added alternative slim case
    [case-slim.3mf, case-slim.scad]
2025-08-10 Updated readme for slim case
2025-08-12 update pogopin height to match spacer thickness
    (cherry picked from commit 37a83f917e718d9e4aeca91f363322eda9a9839c)
    [badgeCarrierCard.kicad_sch]
2025-08-21 Started ripping parts out
    [badgeCarrierCard.kicad_sch, frontpanel.kicad_pcb, frontpanel.kicad_sch, keyboard.kicad_sch]
2025-08-21 Rotated the 18650 cell / Wired it in. Wired out circuitry, placed flipper zero headers down.
    [M20-7910842R.STEP, M20-7911042R.STEP, badgeCarrierCard.kicad_sch, power.kicad_sch]
2025-09-02 Pulled out some stuff I don't need.
    [BOM-LED_MATRIX.csv, BOM-Oscilli.csv, BOM-SAO.csv, BOM-SAO_V2.csv, BOM-VGA_PS2.csv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]
2025-09-15 Working away on the board.
    [Full_Spacer_with_LoRa_Antenna_WHY2025.stl, SPACER _OD5_ID3_H3.stl, WHY Badge case.f3d, badgeCarrierCard.kicad_sch, case-slim.3mf, case-slim.scad, case.stl, dsi_bridge.kicad_sch]
2025-09-15 Added step files back
    [M20-7910842R.STEP, M20-7911042R.STEP, usb1046-xx-0190-l-b-x_revb1.step]
2025-09-16 Passing DRC
    [blackpants.kicad_sch, dsi_bridge.kicad_sch, keyboard.kicad_sch, power.kicad_sch, usb.kicad_sch]
2025-09-18 R0.1 candidate
    [blackpants-B_Cu.gbr, blackpants-B_Fab.gbr, blackpants-B_Mask.gbr, blackpants-B_Paste.gbr, blackpants-B_Silkscreen.gbr, blackpants-Edge_Cuts.gbr, blackpants-F_Cu.gbr, blackpants-F_Fab.gbr]
2026-09-08 Added integrated parts.
    [blackpants.kicad_pcb, pmic.kicad_sch]
2026-09-11 Added a523 components.
    [6L_1.0mm叠层阻抗图.xlsx, A523&A527&T527产品方案之AXP电源方案(AXP717B&AXP717C)选型参考.xlsx, A523-EVB-AXP717C-LPDDR4-4X-32X1-V1-0-20221115.DSN, A523-EVB-AXP717C-LPDDR4-4X-BOM-20221117.xlsx, A523-REF-DDR4-16X2-S4L-V1-0-20221107.DSN, A523-REF-DDR4-16X2-S4L-V1-0.brd, A523-REF-DDR4-16X2-S4L-V1-0_pads.pcb, A523-REF-DDR4-16X2-S4L-V2-0-20221107.DSN]
2026-09-11 Working on the schematic.
    [a523_always_on_io.kicad_sch, a523_analog.kicad_sch, a523_axp323.kicad_sch, a523_bucks.kicad_sch, a523_charger.kicad_sch, a523_core.kicad_sch, a523_cpu_bypass.kicad_sch, a523_display_io.kicad_sch]
2026-09-15 Removed old sheets not needed anymore.
    [a523_axp323.kicad_sch, a523_interfaces.kicad_sch, a523_peripherals.kicad_sch, hardware.kicad_sch]
2026-09-17 Removed USB sheets and moved the parts to the main sheets.
    [a523_display_io.kicad_sch, a523_system.kicad_sch, blackpants.kicad_pcb, blackpants.kicad_sch, console.kicad_sch, power.kicad_sch, usb.kicad_sch, wifi.kicad_sch]
2026-09-17 Cleaned up routing.
    [a523_charger.kicad_sch, blackpants.kicad_pcb, blackpants.kicad_sch, stm32.kicad_sch, usb.kicad_sch]
2026-09-17 Worked on the layout.
    [a523_analog.kicad_sch, a523_axp323.kicad_sch, a523_display_io.kicad_sch, a523_ldos.kicad_sch, a523_system.kicad_sch, a523_wifi_io.kicad_sch, blackpants.kicad_pcb, blackpants.kicad_sch]
